Konstantin-Dudersky/plc-modules/PM-DI16-front-DC24/doc/PM-DI16-front-DC24_view_x90.png

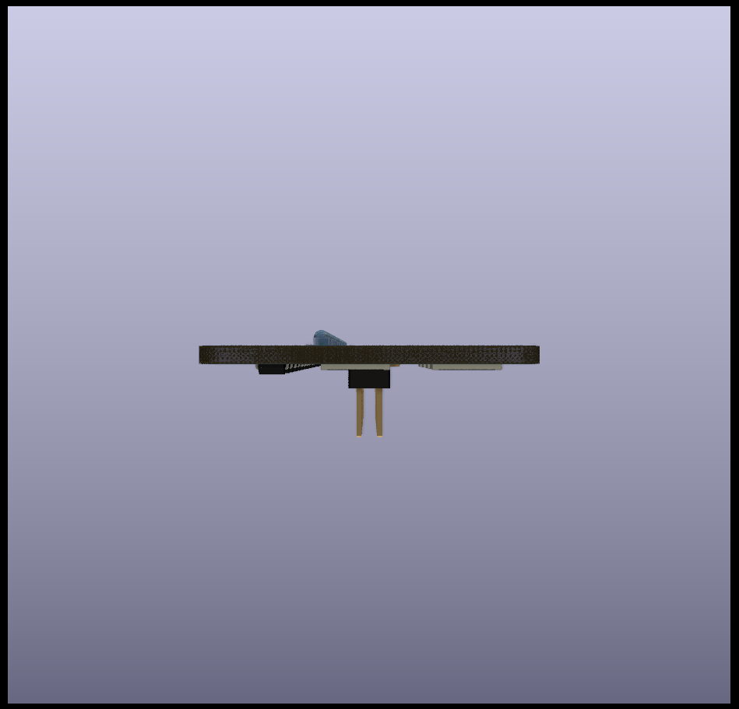
PM-DI16-front-DC24/doc/PM-DI16-front-DC24_view_x90.png
