Konstantin-Dudersky/plc-modules/pcb/PMCNV-AI8T-v0.1.0/doc/CN0209 - Fully Programmable Universal Analog Front End for Process Control Applications/CN0209-hw-1024.jpg

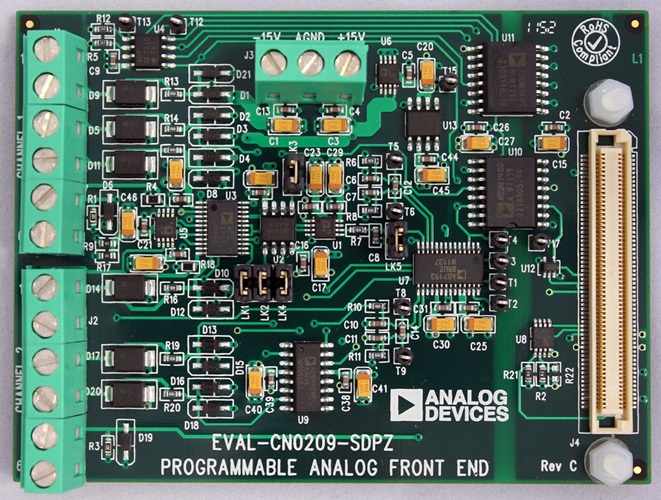
pcb/PMCNV-AI8T-v0.1.0/doc/CN0209 - Fully Programmable Universal Analog Front End for Process Control Applications/CN0209-hw-1024.jpg
