Konstantin-Dudersky/plc-modules/README.md

Схемы простейших модулей для подключения к контроллеру по шине I2C.

Схемы разработаны в KiCad.

Документация - см. [docs/plc-modules.pdf]
