Konstantin-Dudersky/plc-modules/docs/output/plc-modules.pdf

## Описание системы управления

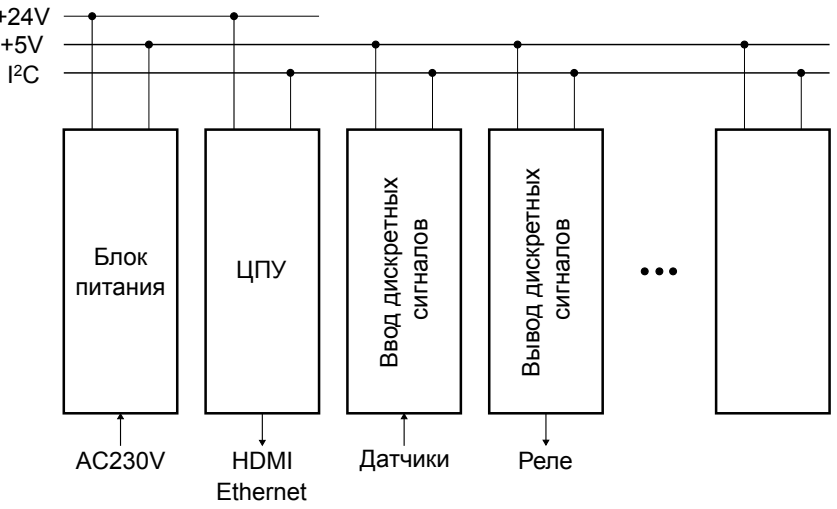
[picture p3: figure]
HDM; Реле; Бло а; ЦПУ; Ввод дискретных; сигналов; Вывод дискретных

Рис. 1. Концепция модульной системы Система управления состоит из набора совместимых по подключению и внешним га# баритам модулей.
Отдельные модули связаны между собой общей шиной. Шина выполнена в виде стандратного кабеля с двумя витыми парами, обжатого двумя разъемами RJ11. Модули необходимо располагать так, чтобы суммарная длина шины была минимальной. По шине передаётся питание (GND, +5V) и сигналы интерфейса I²C (SDA, SCL).
Каждый модуль на шине имеет свой адрес, который задается DIP#переключателями на каждом модуле. Возможно использование до 8 модулей одного типа.
На данный момент реализованы модули:
Можно дополнительно реализовать:
- Модули аналоговых входов:
- Тензодатчики
- Ток 4#20мА
- Напряжение 0#10В
- Термосопротивление
- Термопары
- Модули аналоговых выходов:
- Ток 4#20мА
- Напряжение 0#10В
- Модуль с аккумуляторными батареями
- Модуль управления RGB светодиодными лентами

## Функциональная схема модуля ввода / вывода

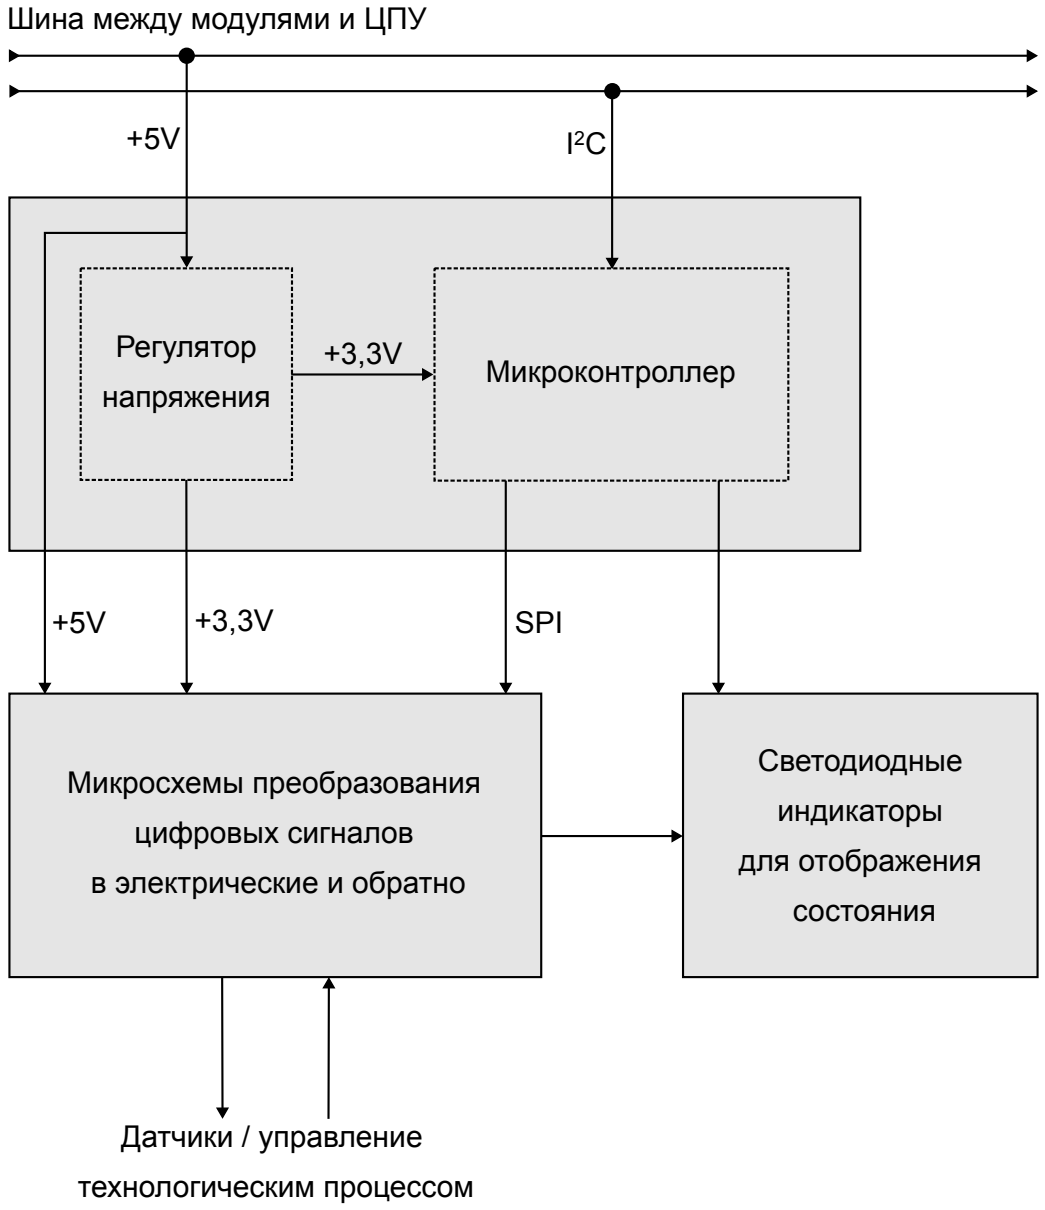
[picture p4: figure]
Микроконтроллер; Микросхемы преобразования; цифровых си налов; в электрические и обратно; Светодиодные; индикаторы; для отображения; состояния; Ре улятор; напряжения; Шина между модулями и ЦПУ; Датчики управление; техноло ическим процессом

Рис. 2. Функциональная cхема модуля ввода / вывода Модуль состоит из трех функциональных частей, выполненных на отдельных платах. Основная плата
Основная плата с микросхемами преобразования цифровых сигналов в электрические и обратно. Для разных модулей ввода / вывода данная плата отличается.
Плата с микроконтроллером

Вспомогательная плата с микроконтроллером и регулятором напряжения. Данная пла# та унифицирована для всех модулей. Микроконтроллер по интерфейсу I²C подключа# ется к ЦПУ и по интерфейсу SPI управляет вспомогательными микросхемами. Поскольку у каждого устройства на шине I²C должен быть уникальный адрес, на плате есть трехпозиционный DIP#переключатель для задания адреса конкретного модуля. Таким образом, можно использовать до 8 модулей одного типа.
В качестве микроконтроллера используется чип ESP32#C3. На чипе есть разъем для подключения внешней антенны, что дает возможность использовать беспроводное подключение.
Микроконтроллер программируется с помощью обычного кабеля Micro#USB. На плате выведены кнопки BOOT и EN, для перевода микроконтроллера в режим загрузки.
На плате есть LDO регулятор напряжения с выходом 3,3В.
Подключение к шине выполняется через разъемы RJ11 и кабель с двумя витыми пара# ми.
Подключение к основной плате модуля и плате светодиодов выполняется через 10#пи# новые кабели FFC.
Плата со светодиодами
Вспомогательная плата со светодиодами для отображения состояния микроконтролле# ра и электрических сигналов. В модуле может использоваться одна или две таких пла# ты. Есть версии на 8 и на 16 светодиодов.

## Описание модулей и вспомогательных плат

### PM_CNV-AI4_W - плата аналогового ввода сигналов тензодатчиков

Плата аналогового ввода для опроса сигналов тензодатчиков. Можно подключить до 4 тензодатчиков.
Опрос датчиков построен на базе АЦП AD7193 компании Analog Devices. Основные ха# рактеристики АЦП:
- Тип АЦП # 24#разрядный сигма#дельта (Σ # Δ).
- Встроенный усилитель с программируемым коэффициентом усиления 1 .. 128. Поз# воляет измерять напряжения в диапазоне 40 мВ .. 5 В.
- Низкий уровень шумов. До 22 разрядов при низкой частоте дискретизации.
- 4 дифференциальных канала измерения. Автоматический мультиплексор.
- Подключается к микроконтроллеру по интерфейсу SPI.

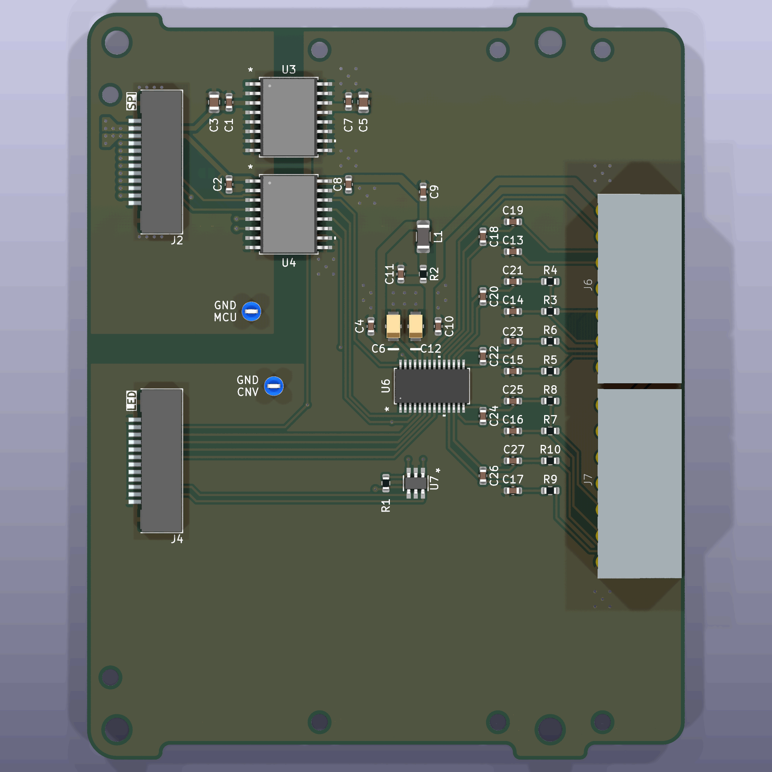
[picture p5: figure]

Рис. 3. Внешний вид платы PM_CNV#AI4_W

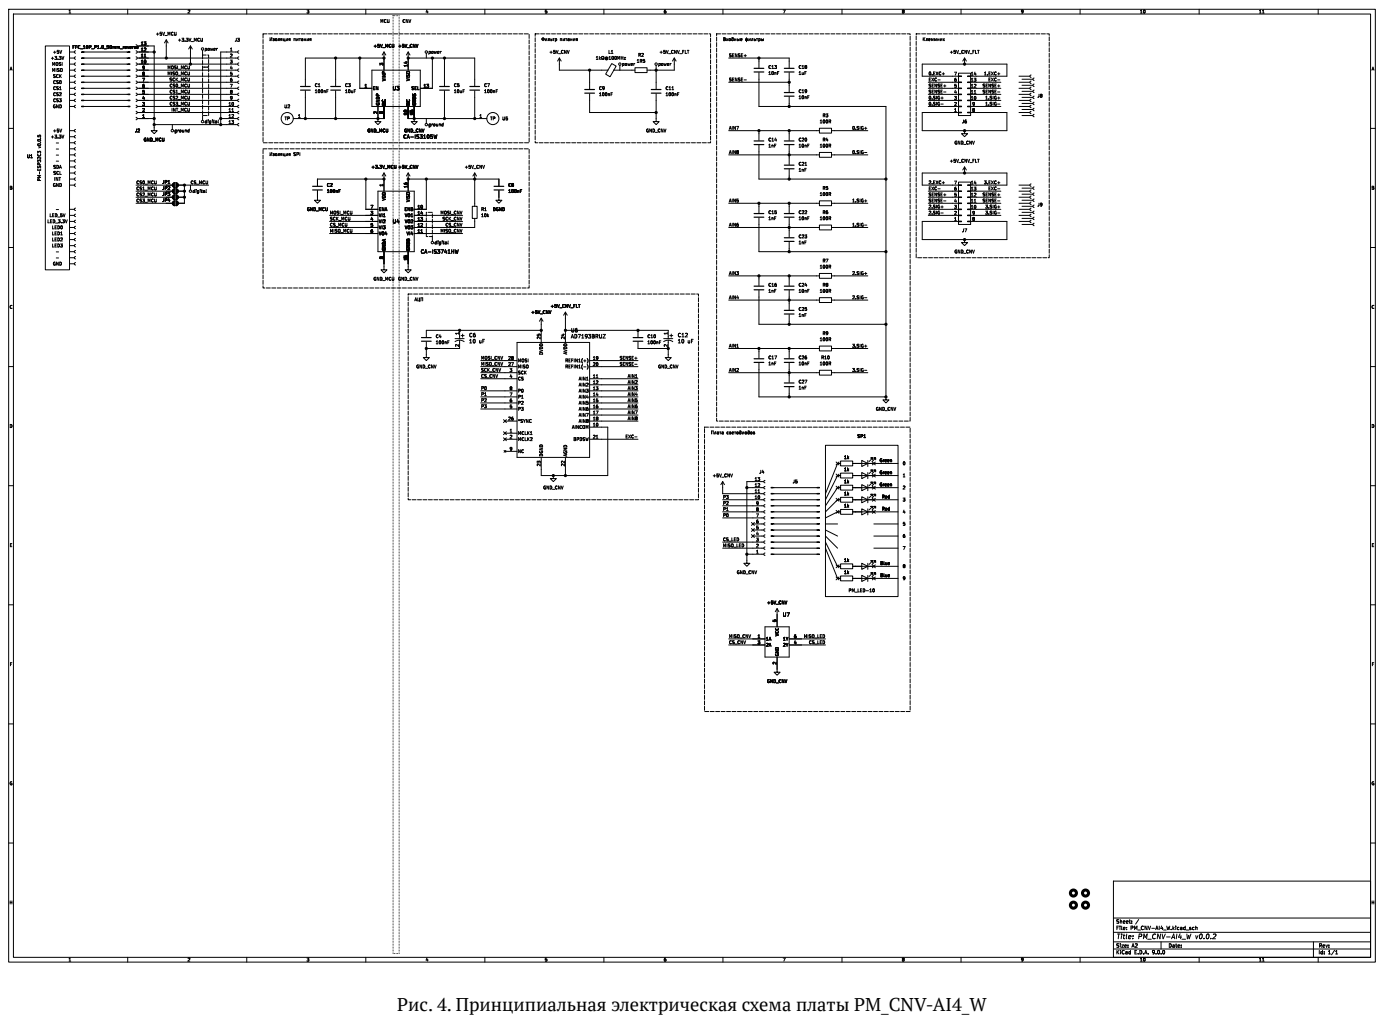
[picture p6: page 6]

GNDS 15 GNDS 16 GNDS 9 SEL 13 U3

GNDS 15 GNDS 16 GNDS 9 SEL 13

VISO 16 GNDB 15 GNDB 9 ENB 10

Рис. 4. Принципиальная электрическая схема платы PM_CNV#AI4_W

Обозначение | Количество | part_ipn | Комментарий | Опционально
reference | quantity | part_ipn | note | optional
C1,C2,C4,C7,C8,C9,C10,C11 | 8 | C_100nF_16V_0603_MLCC#X7R | Unpolarized capacitor
C3,C5 | 2 | C_10uF_16V_0805_MLCC#X7R | Unpolarized capacitor
C6,C12 | 2 | TAJA106M016RNJ | 10uF 16V 3Ω@100kHz ±20% CASE#A#3216#18(mm) Tantalum Capacitors
C13,C19,C20,C22,C24,C26 | 6 | C_10nF_16V_0603_MLCC#X7R | Unpolarized capacitor
C14,C15,C16,C17,C21,C23,C25,C27 | 8 | C_1nF_16V_0603_MLCC#X7R | Unpolarized capacitor
C18 | 1 | C_1uF_16V_0603_MLCC#X7R | Unpolarized capacitor
D1,D2,D3 | 3 | XL#1606SYGC | Green
D4,D5 | 2 | XL#1606SURC | Red
D6,D7 | 2 | XL#1606UBC | Blue
J1 | 1 | FFC_10P_P1.0_50mm_reverse
J2,J3,J4 | 3 | AFA07#S12FCC#00 | Generic connector, single row, 01x10, script generated
J5 | 1 | FFC_12P_P1.0_100mm_straight | FFC 12pin 100mm
J6,J7 | 2 | 15EDGRHC#THR#3.5#14P | Generic connector, double row, 02x05, odd/even pin numbering scheme (row 1 odd numbers, row 2 even numbers), script generated (kicad#library#utils/schlib/autogen/connector/)
J8,J9 | 2 | 15EDGKNH#3.5#14P | Generic connector, single row, 01x05, script generated
L1 | 1 | FB_300mΩ_1kΩ@100MHz_1206 | Ferrite bead
R1 | 1 | R_10k_0603_1% | Resistor
R2 | 1 | R_1R5_0603_1% | Resistor
R3,R4,R5,R6,R7,R8,R9,R10 | 8 | R_100R_0603_1% | Resistor
R11,R12,R13,R14,R15,R16,R17 | 7 | R_1k_0603_1% | Resistor
SP1 | 1 | PM_LED#10#v0.0.1
U2,U5 | 2 | Keystone_5117 | KEYSTONE # 5117 # TEST POINT, PCB, BLUE, THROUGH HOLE
U3 | 1 | CA#IS3105W
U4 | 1 | CA#IS3741HW
U6 | 1 | AD7193BRUZ
U7 | 1 | SN74LVC2G14DBVR
Таблица 1. Перечень элементов платы PM_CNV#AI4_W
