Konstantin-Dudersky/plc-modules/pcb/PMCNV-AI8T-v0.1.0/README.md

Создать файл с габаритными разделами:

- Файл -> Чертить
- Формат чертения - SVG
- Включить слои: User 2
- Чертить на всех слоях: Edge.Cuts

После открыть файл в Inkscape и изменить размер страницы
