Konstantin-Dudersky/plc-modules/docs/pcb/PMCNV-AI8T/render_x0y180z0.png

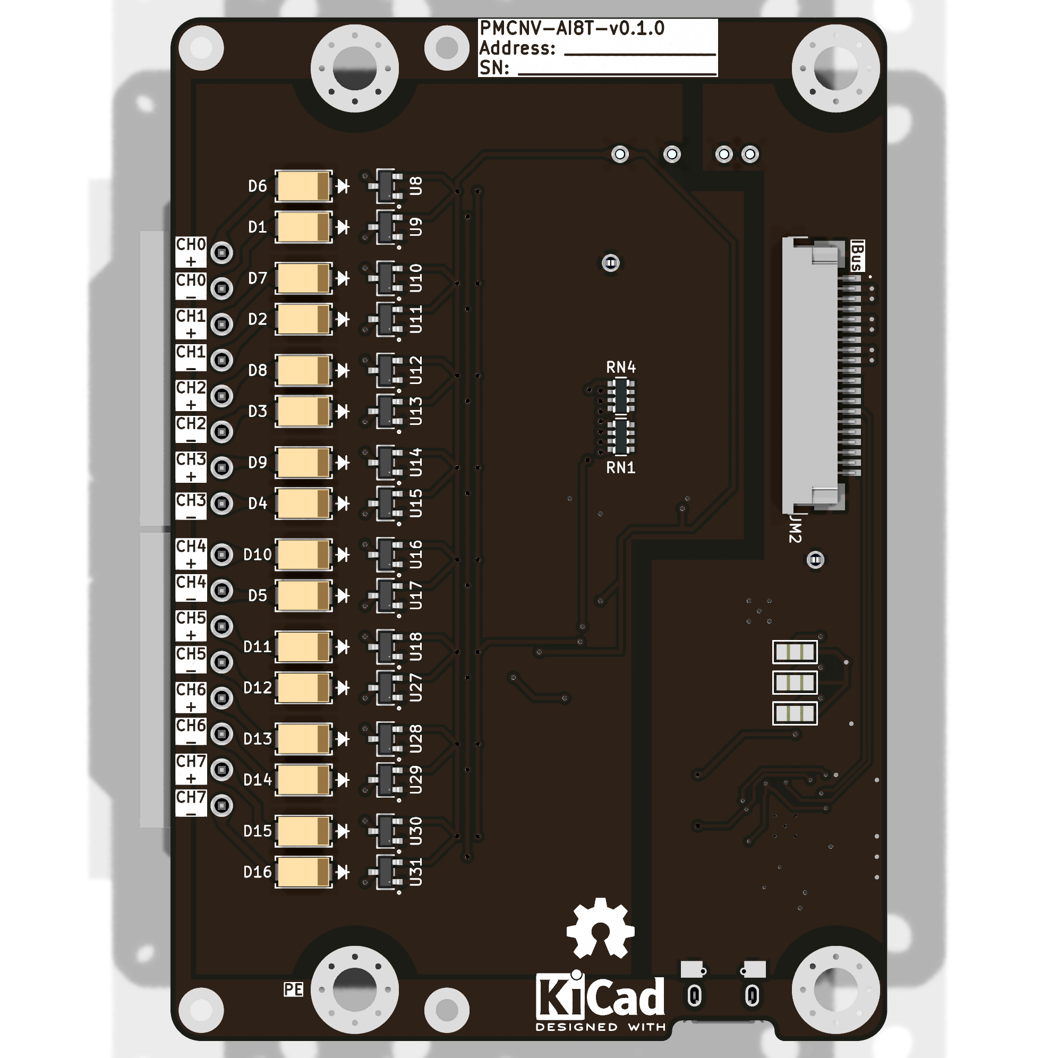
docs/pcb/PMCNV-AI8T/render_x0y180z0.png
