Konstantin-Dudersky/plc-modules/docs/pcb/PMCPU-ESP32C3/render_x0y180z0.png

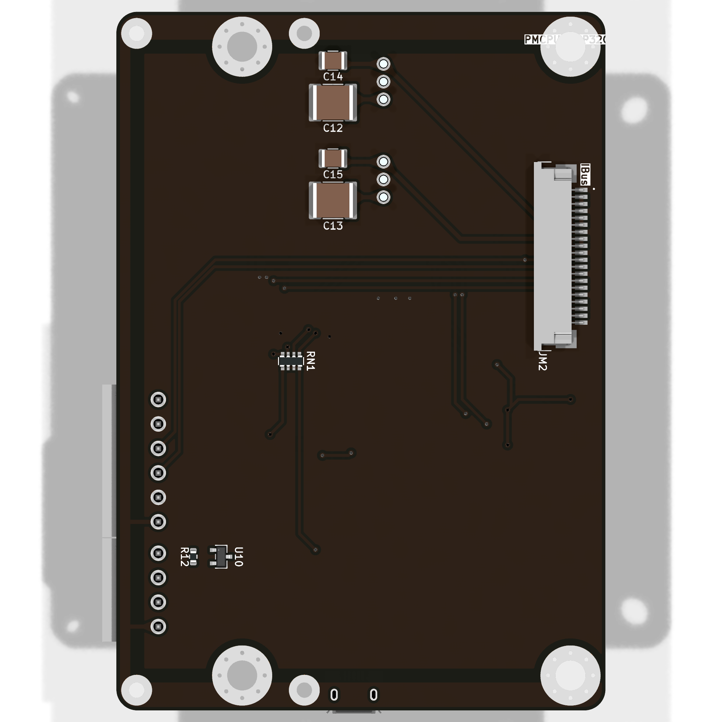
docs/pcb/PMCPU-ESP32C3/render_x0y180z0.png
