Konstantin-Dudersky/plc-modules/pcb/doc/images/AD7193.png

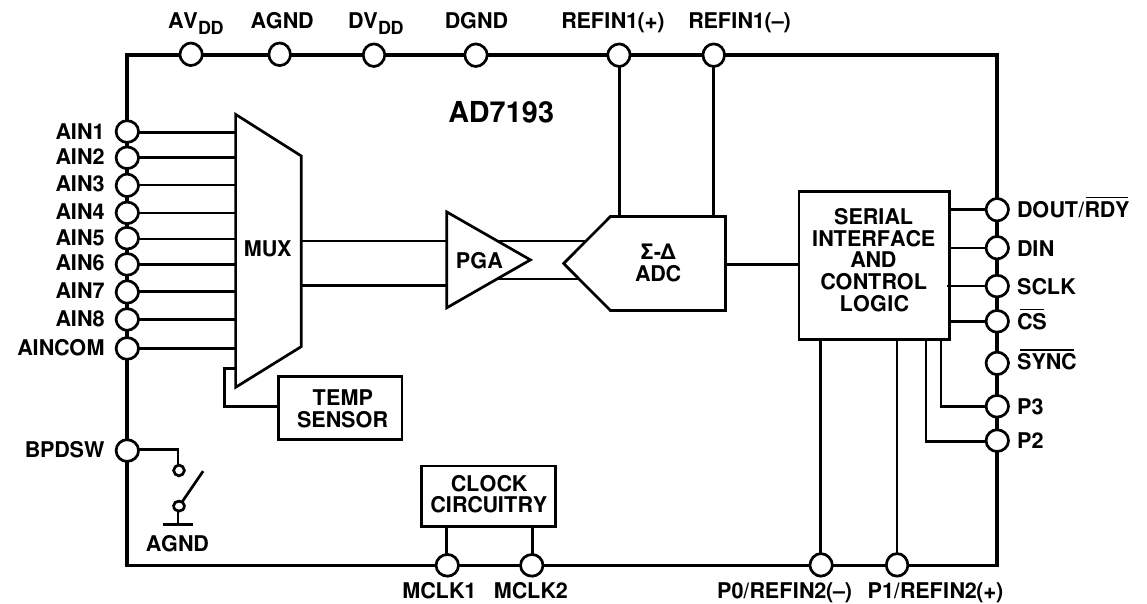
pcb/doc/images/AD7193.png
