Konstantin-Dudersky/plc-modules/pcb/doc/images/CA-IS3098W.png

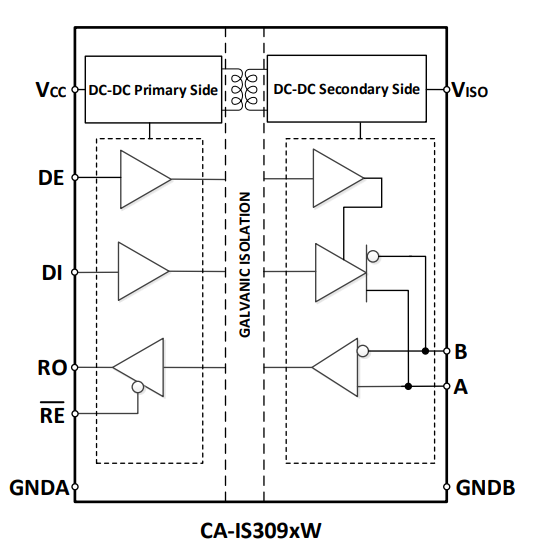
pcb/doc/images/CA-IS3098W.png
