Konstantin-Dudersky/plc-modules/pcb/doc/images/CA-IS3980P.png

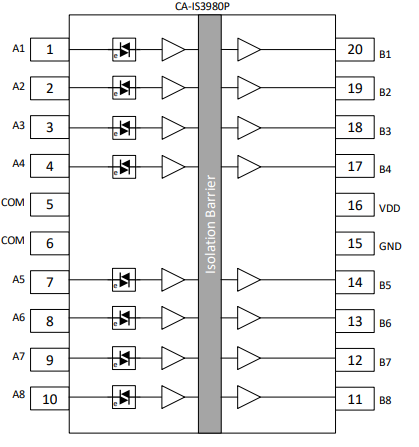
pcb/doc/images/CA-IS3980P.png
