Konstantin-Dudersky/plc-modules/pcb/doc/images/CA-IS3980P_channel.png

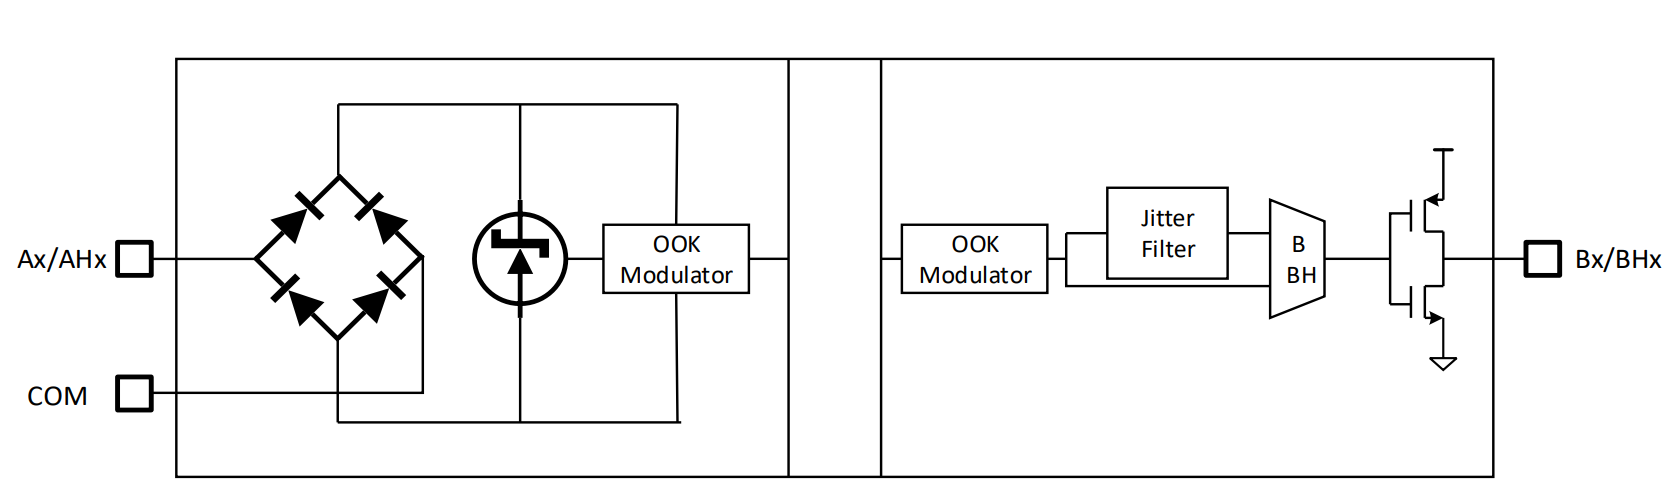
pcb/doc/images/CA-IS3980P_channel.png
