Konstantin-Dudersky/plc-modules/pcb/doc/images/CA-IS3980P_channel_circuit.png

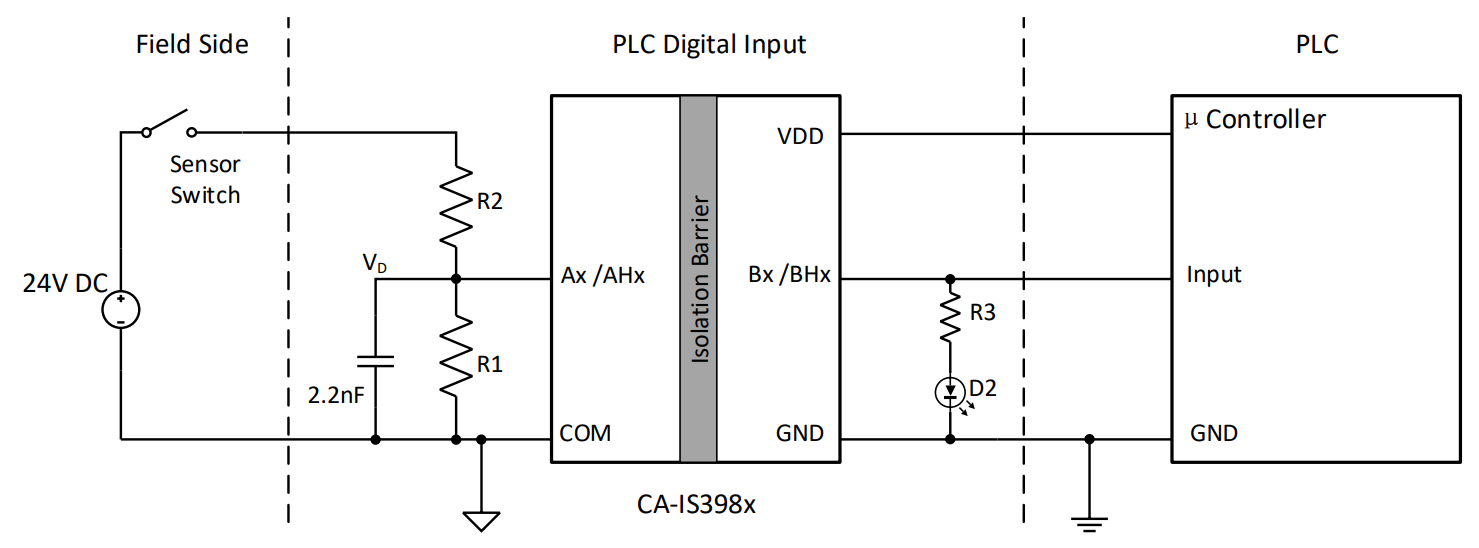
pcb/doc/images/CA-IS3980P_channel_circuit.png
