Konstantin-Dudersky/plc-modules/pcb/doc/images/cold_junction.png

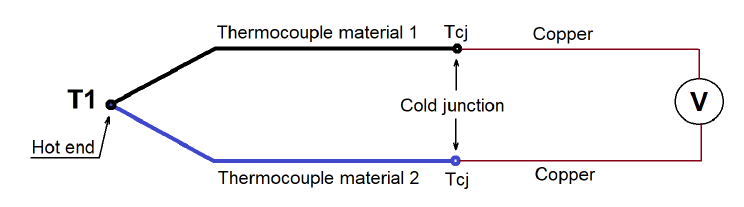
pcb/doc/images/cold_junction.png
