Konstantin-Dudersky/plc-modules/pcb/doc/images/MCP23S17.png

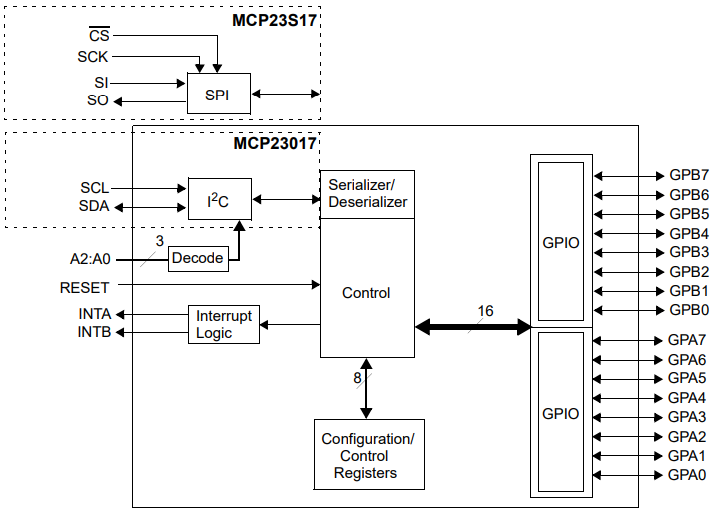
pcb/doc/images/MCP23S17.png
