Konstantin-Dudersky/plc-modules/pcb/doc/images/PMCNV-AI4T_bias_generator.png

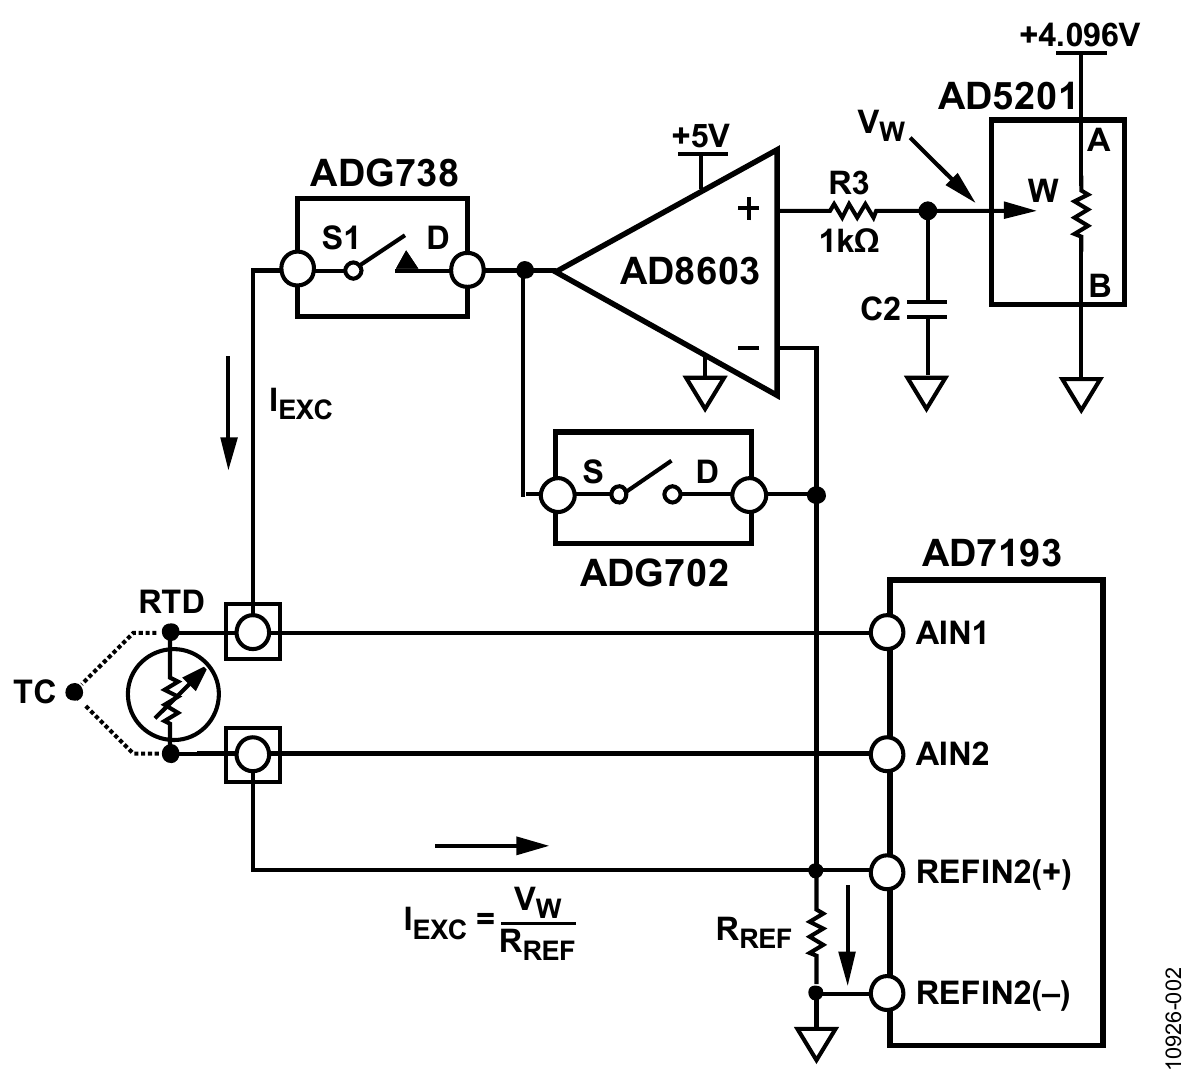
pcb/doc/images/PMCNV-AI4T_bias_generator.png
