Konstantin-Dudersky/plc-modules/pcb/doc/images/PMCNV-AI4T_protection_circuit.png

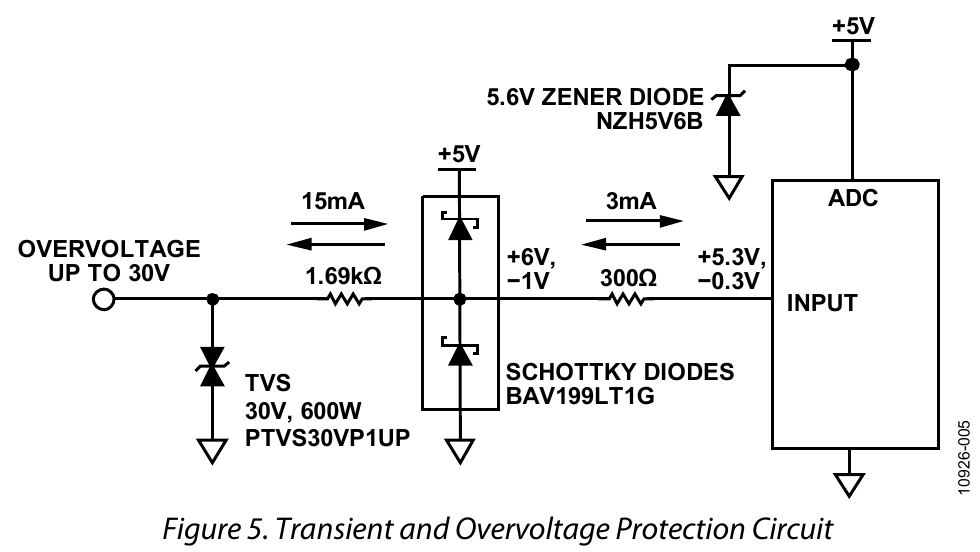
pcb/doc/images/PMCNV-AI4T_protection_circuit.png
