Konstantin-Dudersky/plc-modules/pcb/doc/images/rpi_uart_rts_long.png

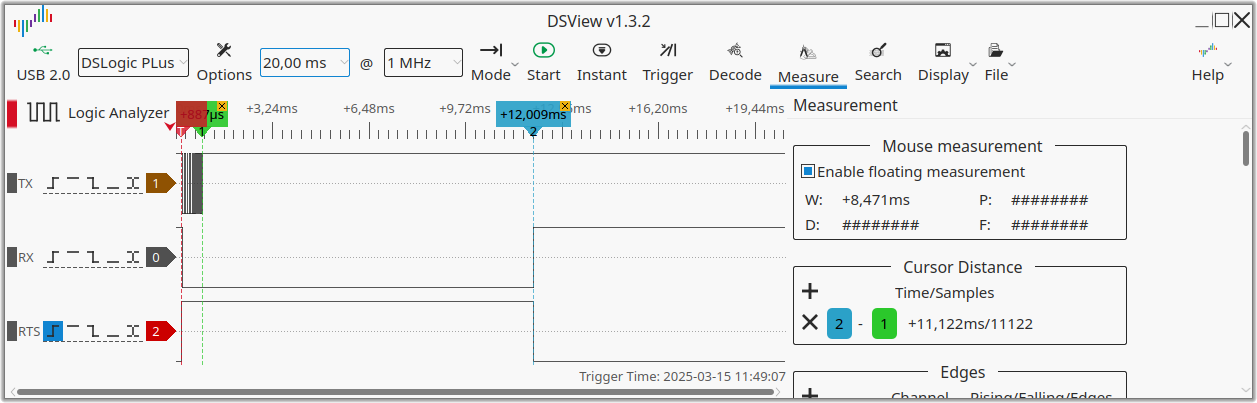
pcb/doc/images/rpi_uart_rts_long.png
