Konstantin-Dudersky/plc-modules/pcb/doc/images/rpi_uart_rts_short.png

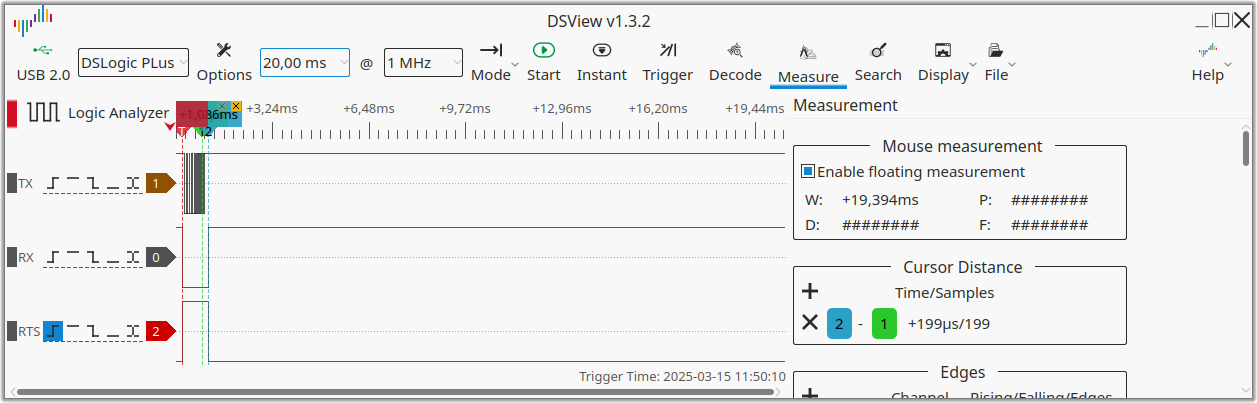
pcb/doc/images/rpi_uart_rts_short.png
