Konstantin-Dudersky/plc-modules/pcb/doc/images/speed_115200.png

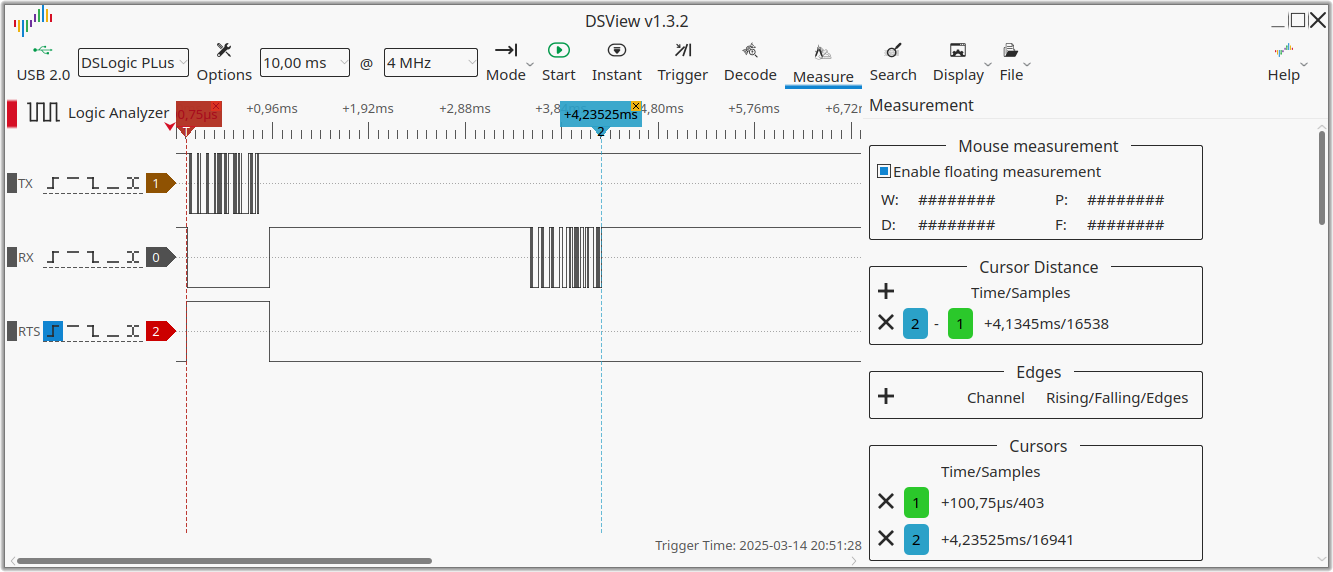
pcb/doc/images/speed_115200.png
