Konstantin-Dudersky/plc-modules/pcb/doc/images/speed_1200000.png

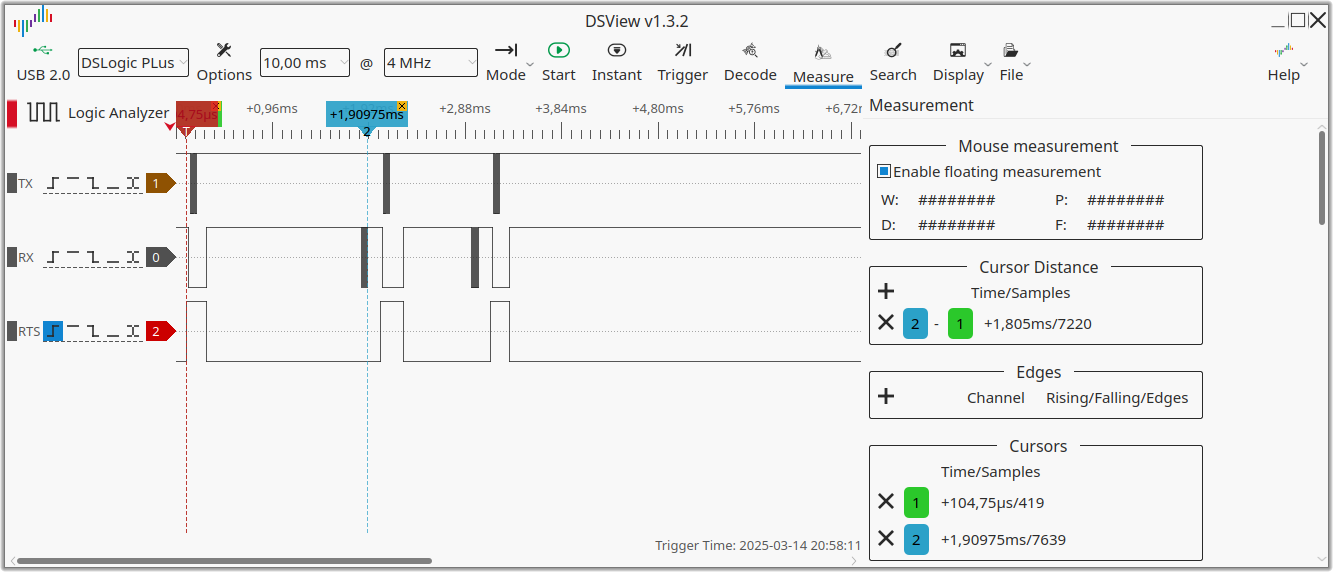
pcb/doc/images/speed_1200000.png
