Konstantin-Dudersky/plc-modules/pcb/doc/images/TBD62783AFG.png

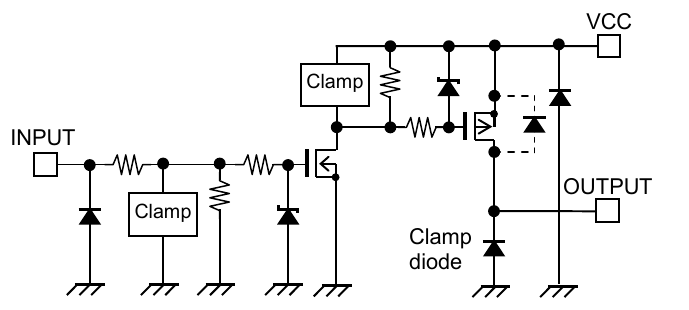
pcb/doc/images/TBD62783AFG.png
