Konstantin-Dudersky/plc-modules/pcb/doc/pcb/PM_CPU-RP/render_x0y180z0.png

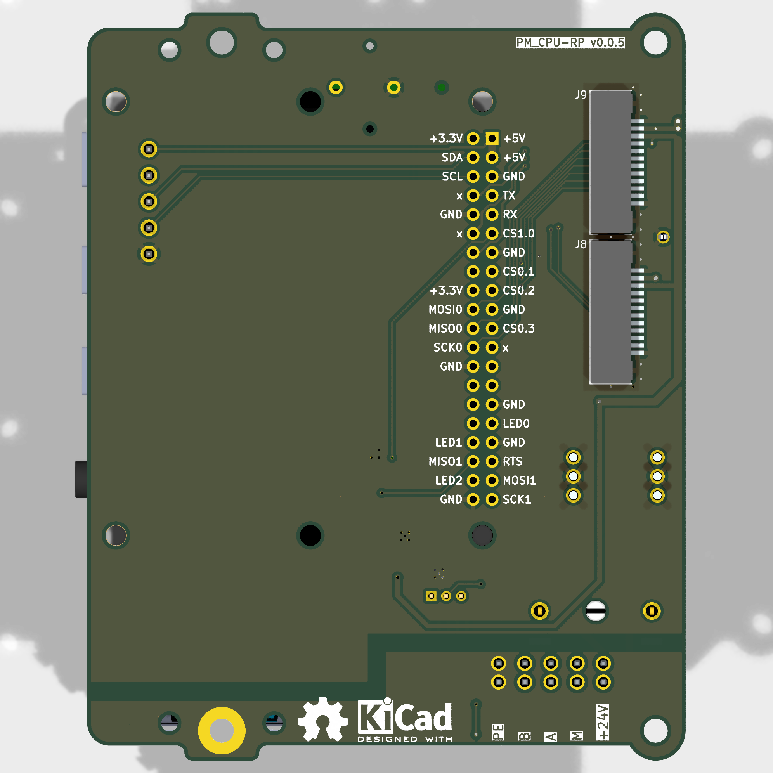
pcb/doc/pcb/PM_CPU-RP/render_x0y180z0.png
