Konstantin-Dudersky/plc-modules/pcb/doc/pcb/PM_HMI-Keyboard/render_x0y0z0.png

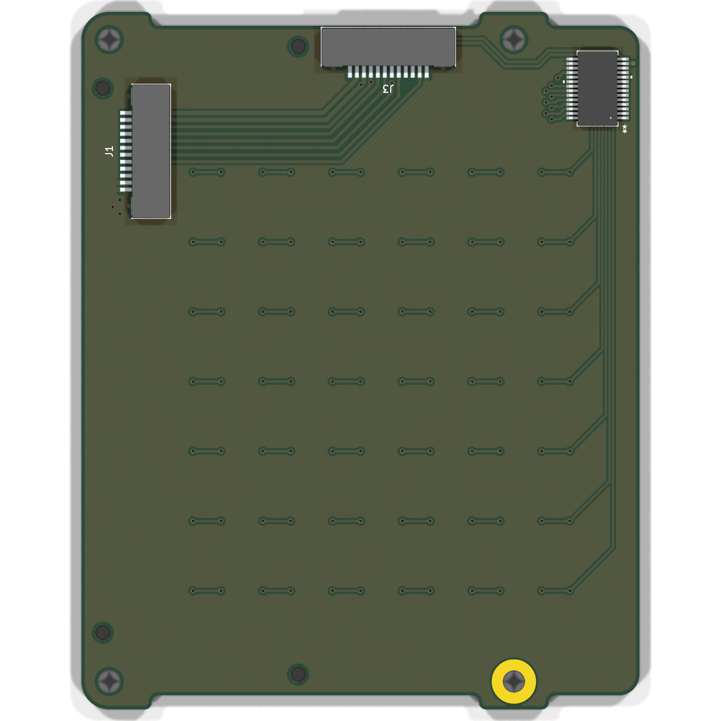
pcb/doc/pcb/PM_HMI-Keyboard/render_x0y0z0.png
