Konstantin-Dudersky/plc-modules/pcb/doc/pcb/PM_HMI-Touch/render_x0y0z0.png

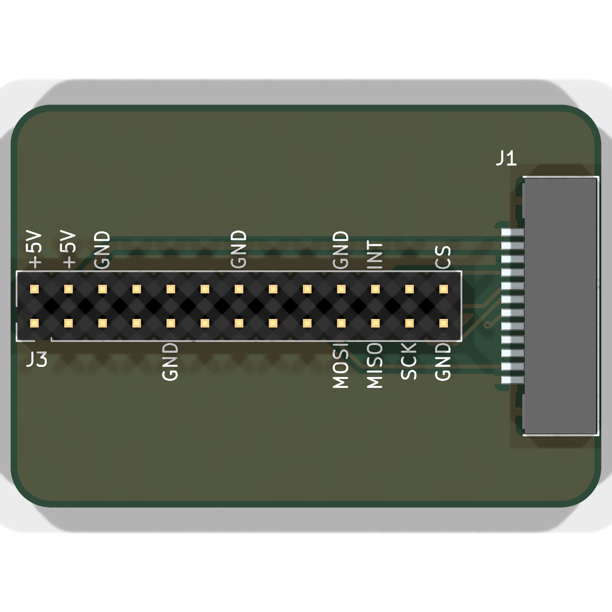
pcb/doc/pcb/PM_HMI-Touch/render_x0y0z0.png
