Konstantin-Dudersky/plc-modules/pcb/doc/pcb/PMCNV-AI4W/render_x0y0z0.png

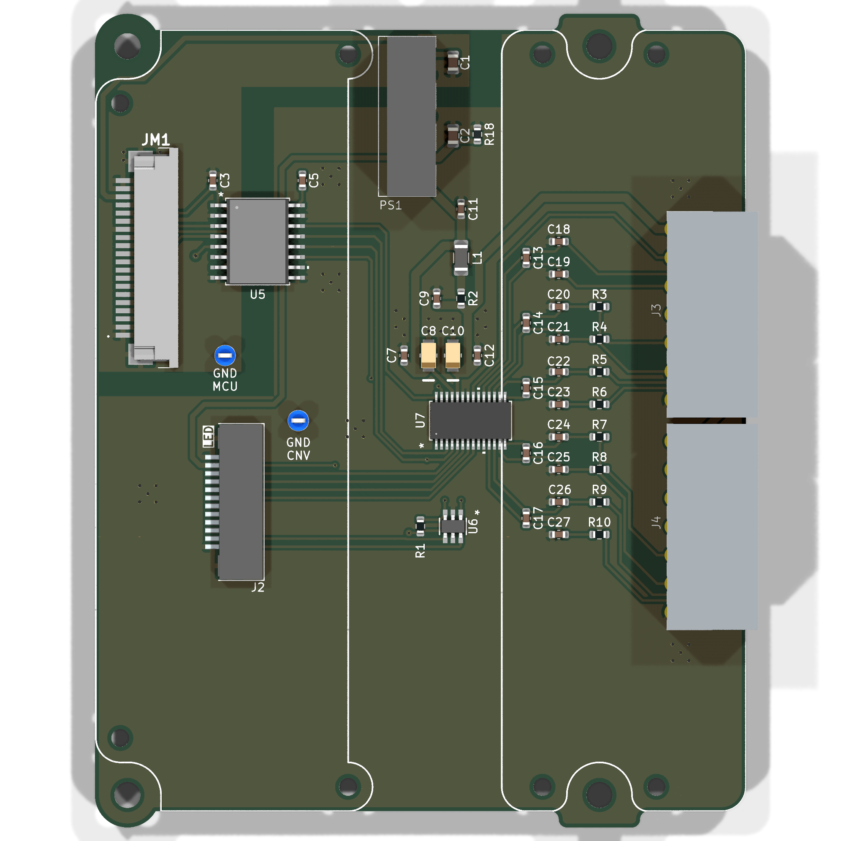
pcb/doc/pcb/PMCNV-AI4W/render_x0y0z0.png
