Konstantin-Dudersky/plc-modules/pcb/doc/pcb/PMCNV-AI4W/render_x0y180z0.png

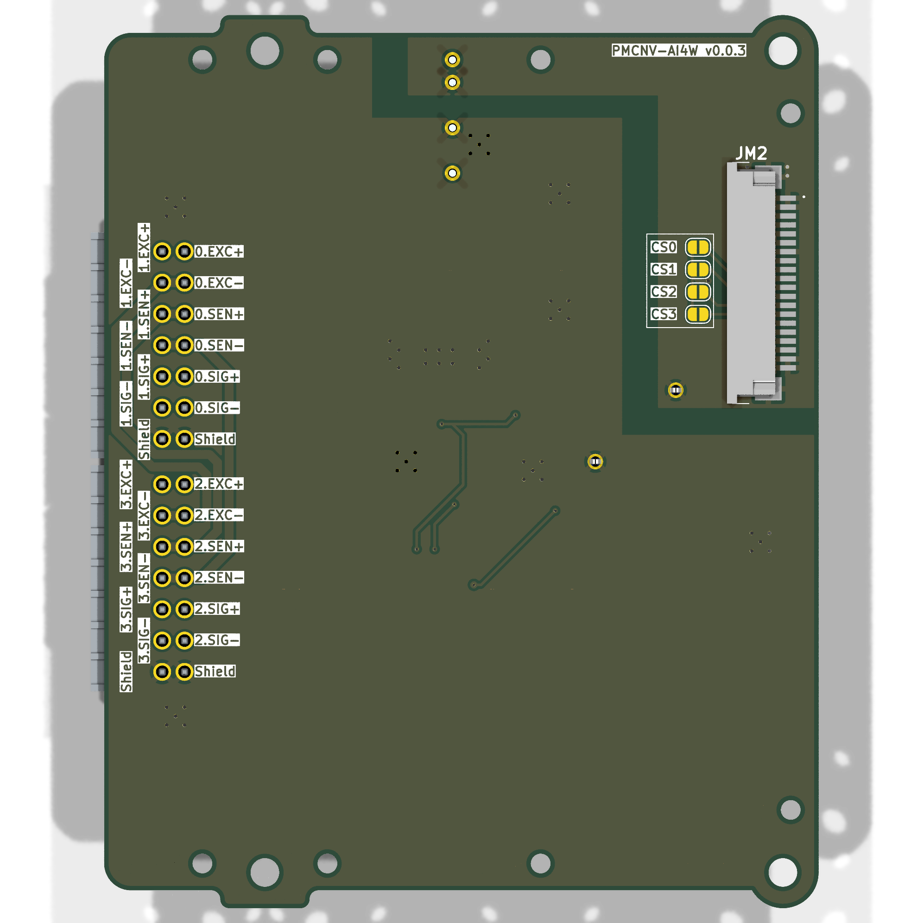
pcb/doc/pcb/PMCNV-AI4W/render_x0y180z0.png
