Konstantin-Dudersky/plc-modules/pcb/doc/pcb/PMCNV-AI8IU/render_x0y0z0.png

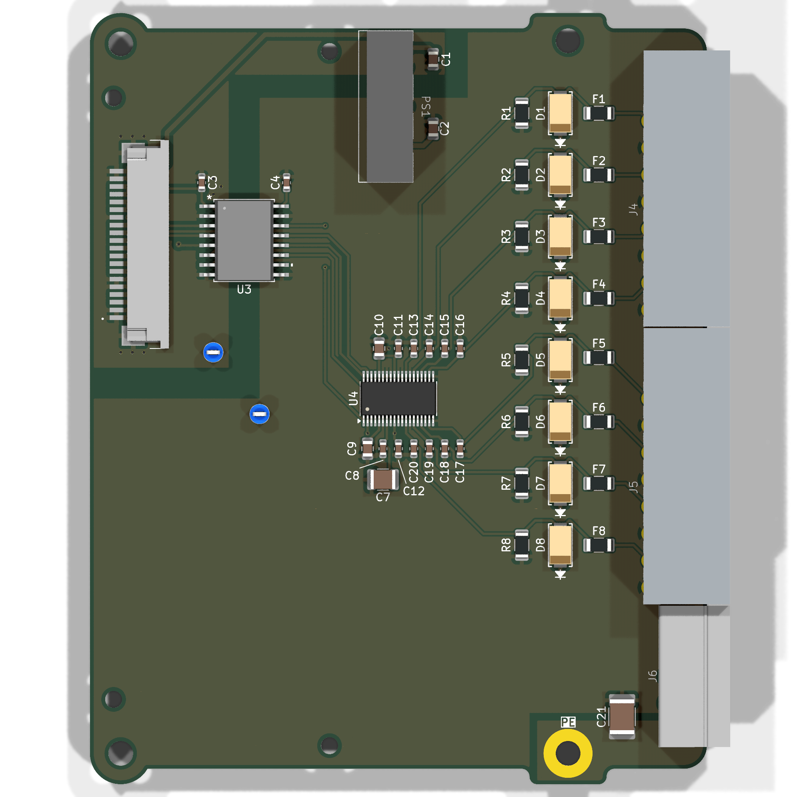
pcb/doc/pcb/PMCNV-AI8IU/render_x0y0z0.png
