Konstantin-Dudersky/plc-modules/pcb/doc/pcb/PMCNV-AI8IU/render_x0y180z0.png

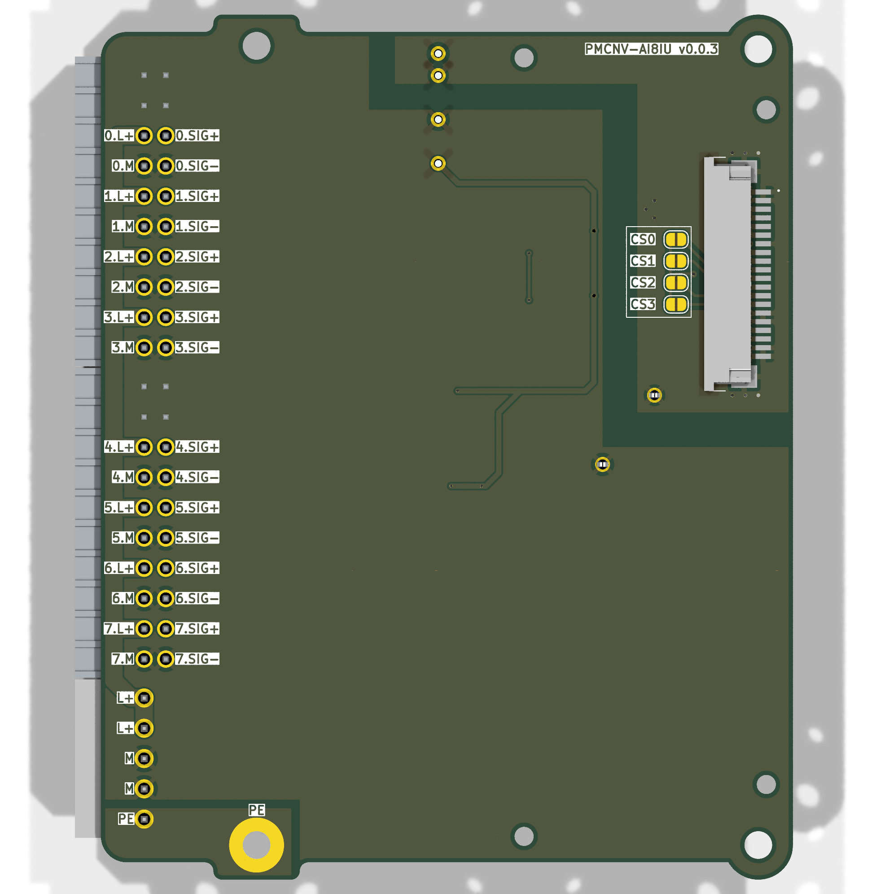
pcb/doc/pcb/PMCNV-AI8IU/render_x0y180z0.png
