Konstantin-Dudersky/plc-modules/pcb/doc/pcb/PMCNV-AIWx4/render_x0y180z0.png

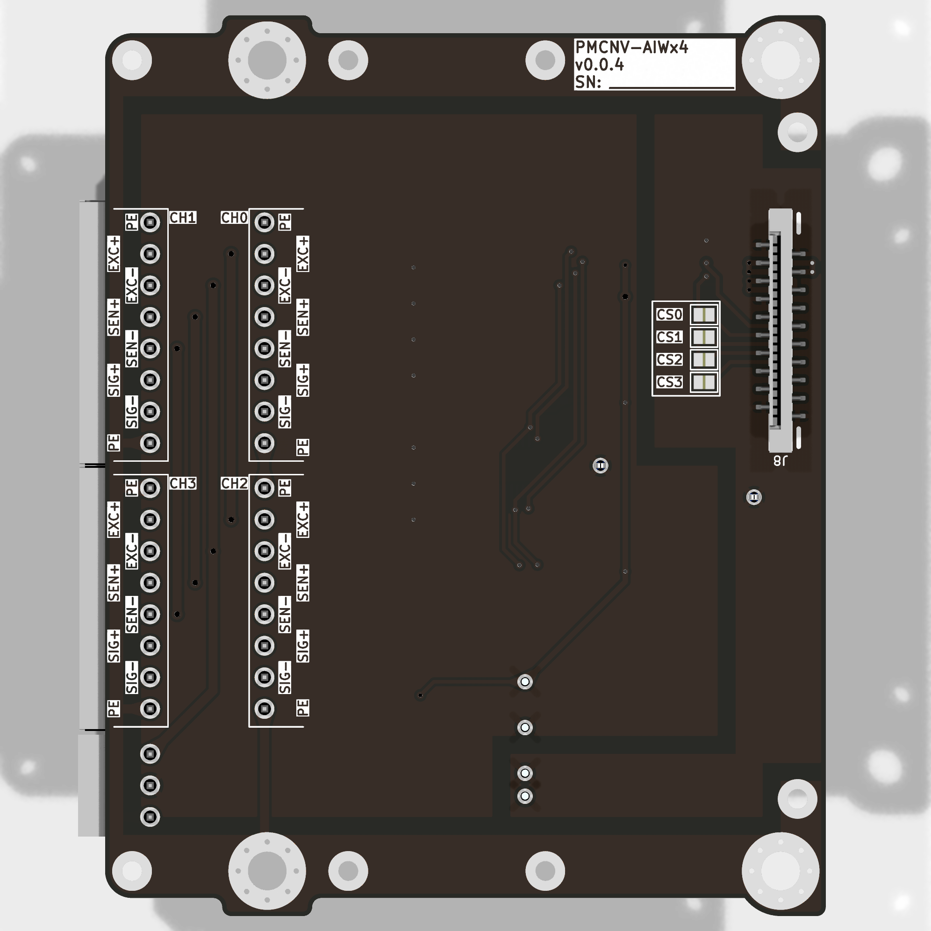
pcb/doc/pcb/PMCNV-AIWx4/render_x0y180z0.png
