Konstantin-Dudersky/plc-modules/pcb/doc/pcb/PMCNV-Count6/render_x0y0z0.png

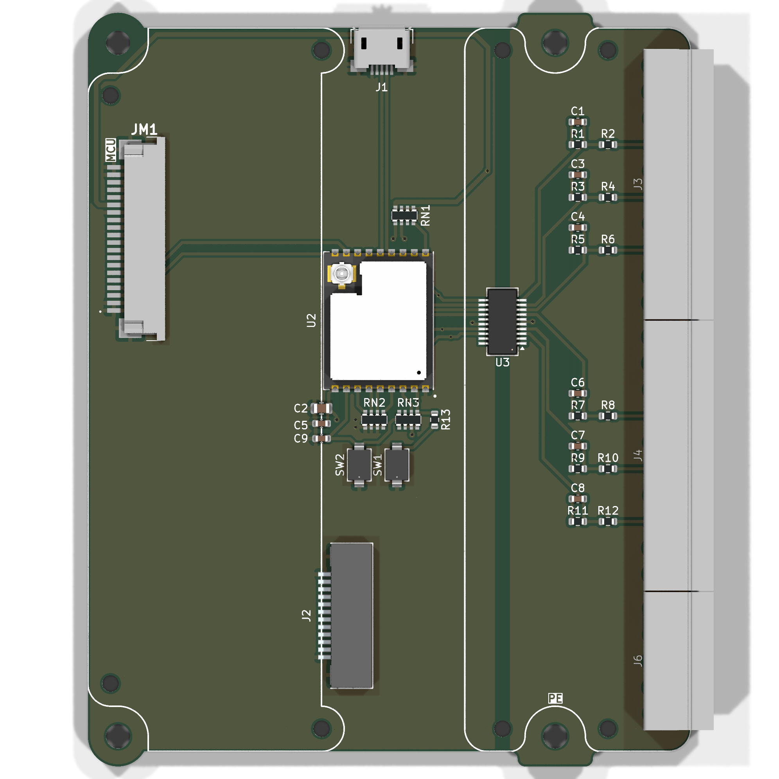
pcb/doc/pcb/PMCNV-Count6/render_x0y0z0.png
