Konstantin-Dudersky/plc-modules/pcb/doc/pcb/PMCNV-PWMx16/render_x0y0z0.png

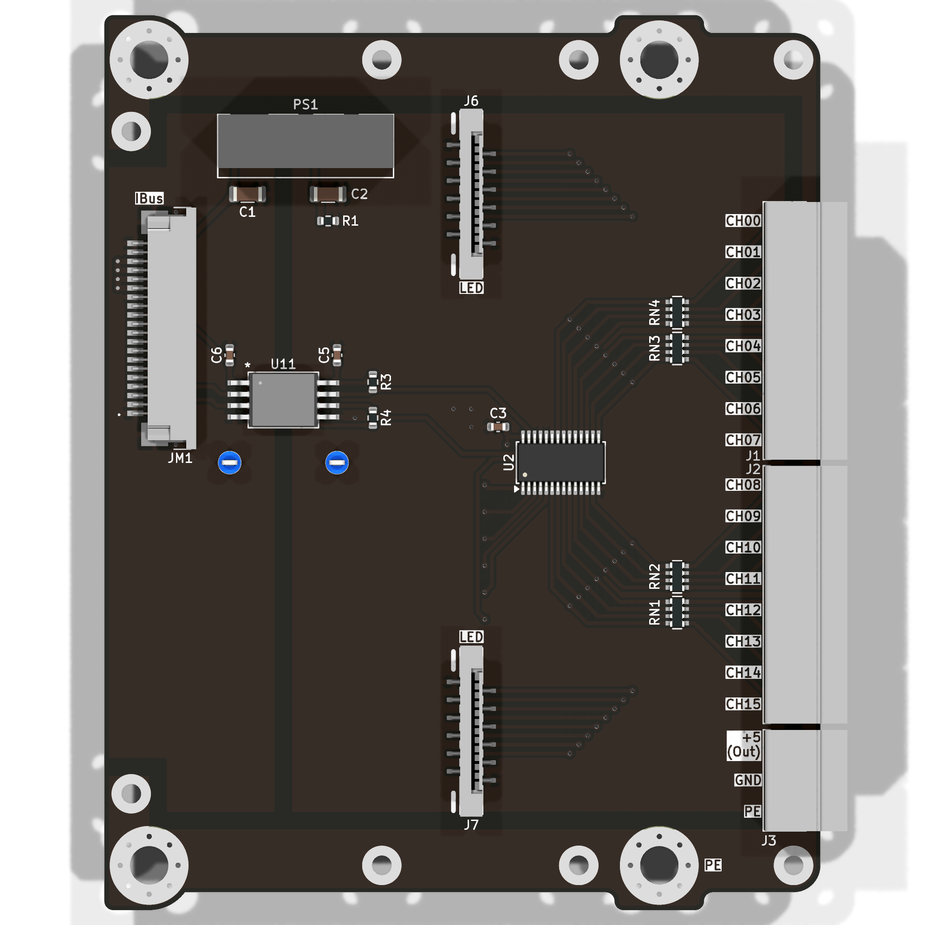
pcb/doc/pcb/PMCNV-PWMx16/render_x0y0z0.png
