Konstantin-Dudersky/plc-modules/pcb/doc/pcb/PMCPU-LLU/render_x0y180z0.png

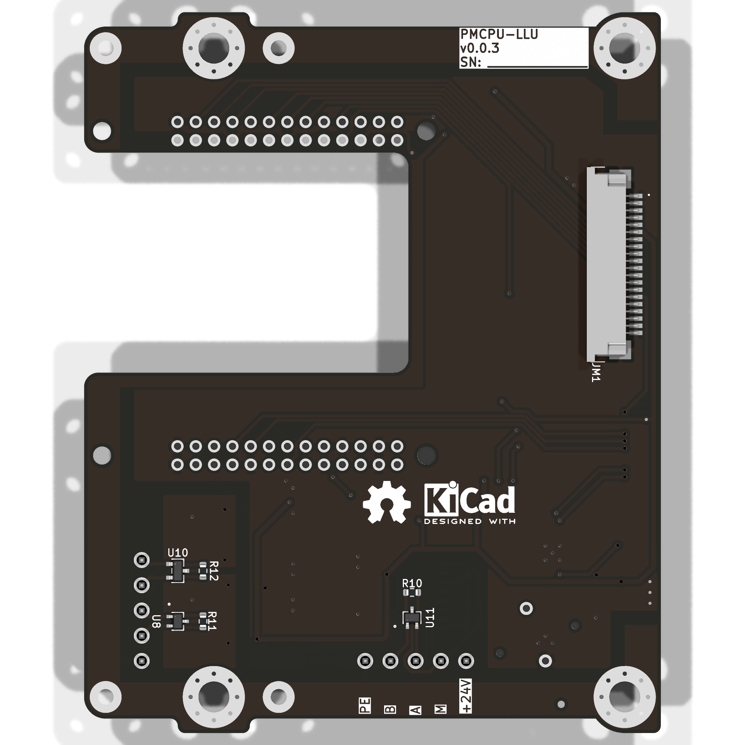
pcb/doc/pcb/PMCPU-LLU/render_x0y180z0.png
