Konstantin-Dudersky/plc-modules/pcb/doc/pcb/PMDBG-FFC20/render_x0y180z0.png

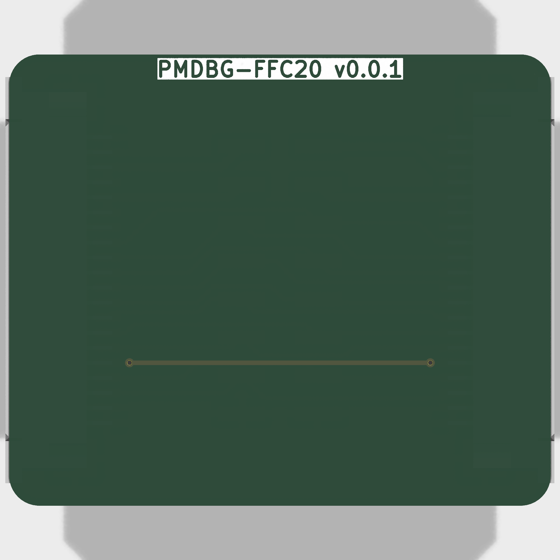
pcb/doc/pcb/PMDBG-FFC20/render_x0y180z0.png
