Konstantin-Dudersky/plc-modules/pcb/doc/pcb/PMHMI-Bx12Lx8/render_x0y0z0.png

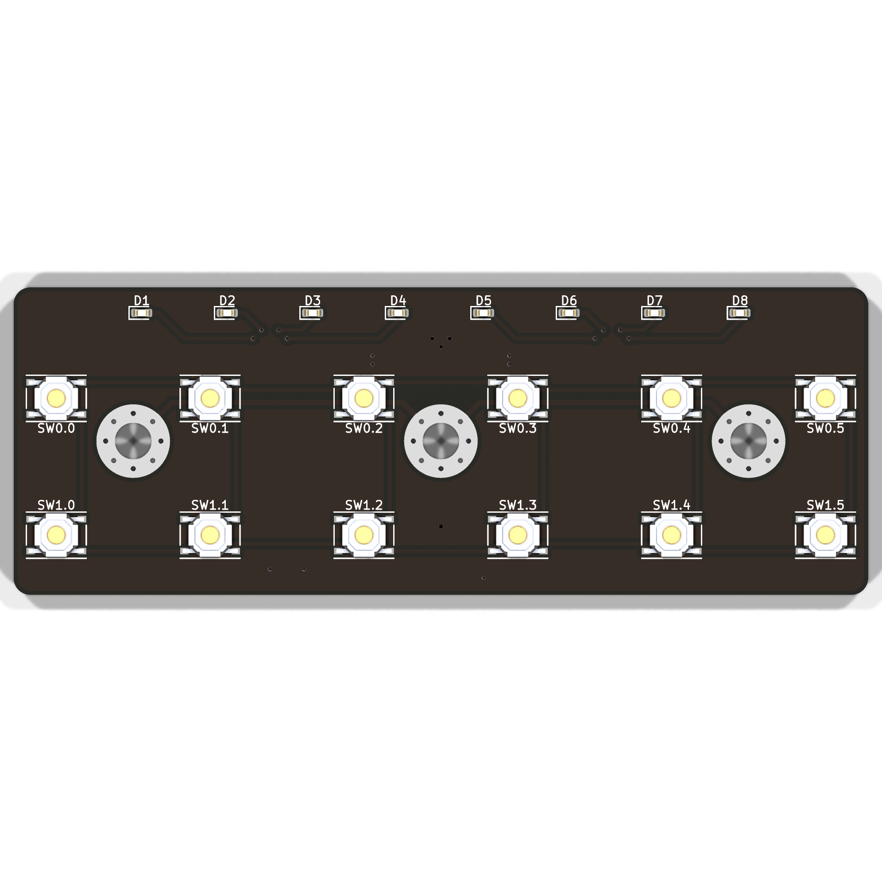
pcb/doc/pcb/PMHMI-Bx12Lx8/render_x0y0z0.png
