Konstantin-Dudersky/plc-modules/pcb/doc/pcb/PMIFC-1Wire/render_x0y0z0.png

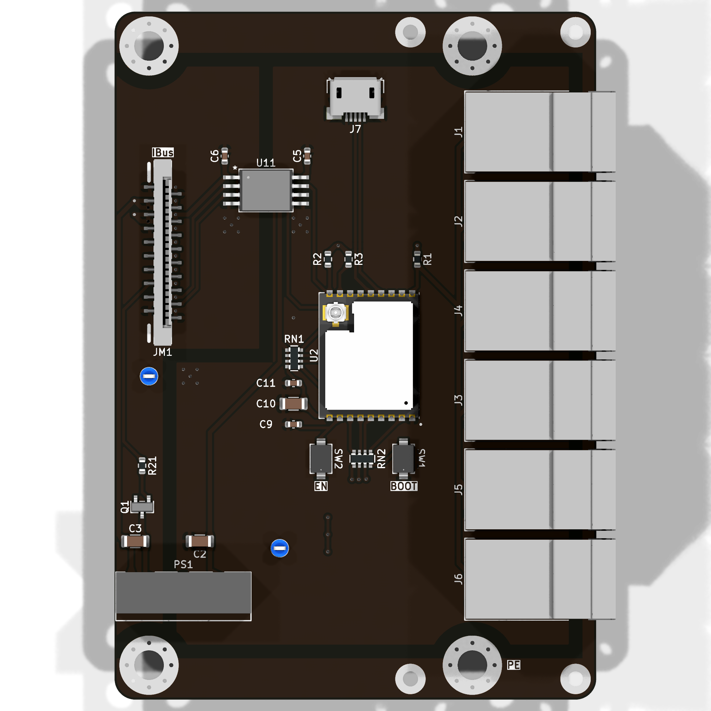
pcb/doc/pcb/PMIFC-1Wire/render_x0y0z0.png
