Konstantin-Dudersky/plc-modules/pcb/doc/pcb/PMIFC-1Wx12/render_x0y180z0.png

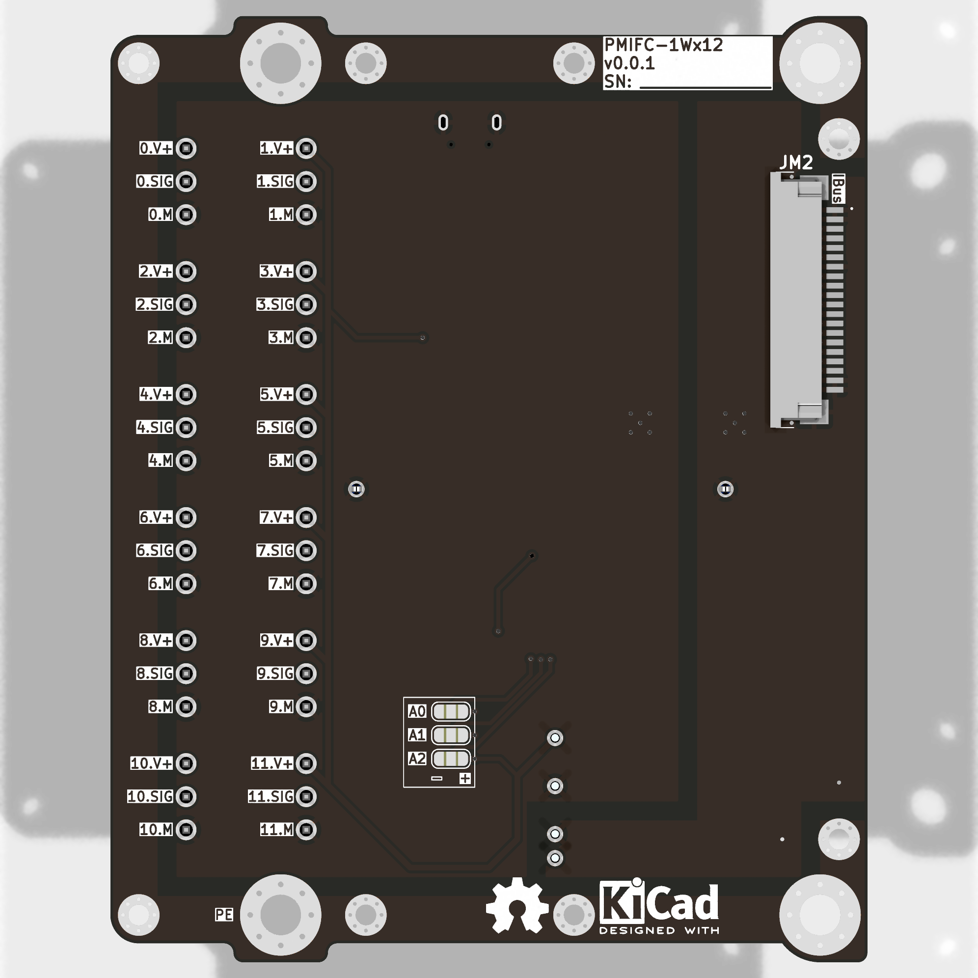
pcb/doc/pcb/PMIFC-1Wx12/render_x0y180z0.png
