Konstantin-Dudersky/plc-modules/pcb/doc/pcb/PMIFC-I2Cx8/render_x0y0z0.png

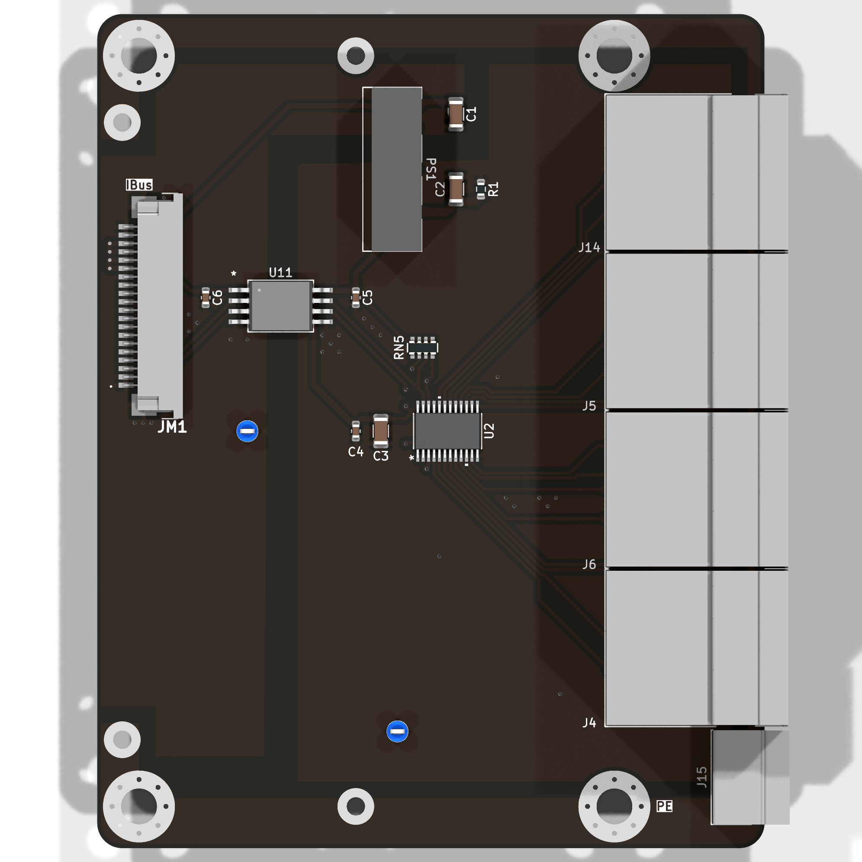
pcb/doc/pcb/PMIFC-I2Cx8/render_x0y0z0.png
