Konstantin-Dudersky/plc-modules/pcb/doc/pcb/PMLED-18/render_x0y180z0.png

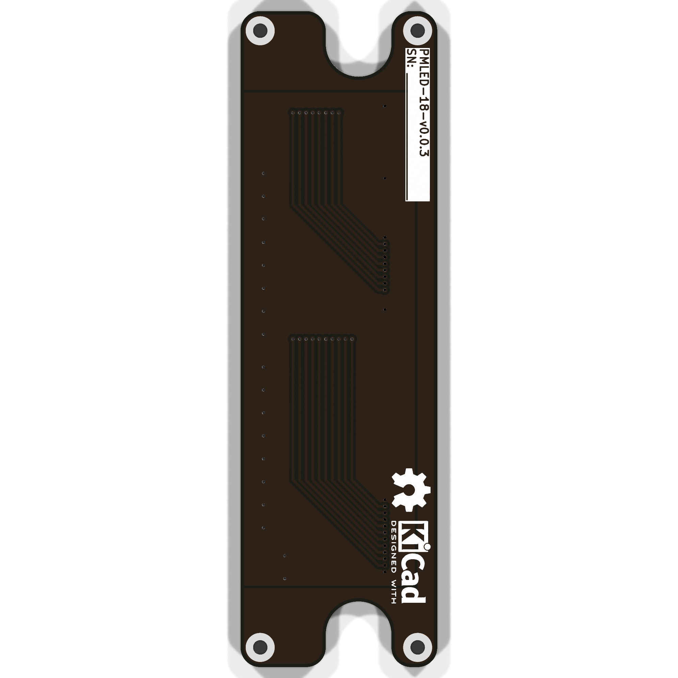
pcb/doc/pcb/PMLED-18/render_x0y180z0.png
