Konstantin-Dudersky/plc-modules/pcb/doc/pcb/PMMCU-ESP32C3/render_x0y0z0.png

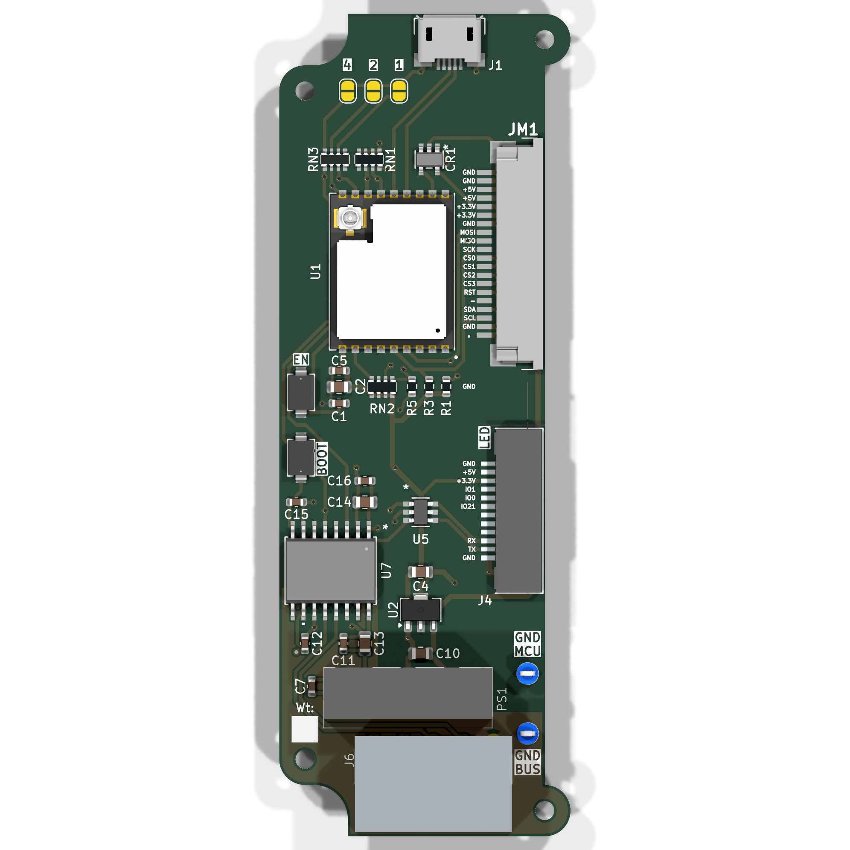
pcb/doc/pcb/PMMCU-ESP32C3/render_x0y0z0.png
