Konstantin-Dudersky/plc-modules/pcb/PMCNV-AI8T-v0.1.0/export/v0.1.0/render_x0y180z0.png

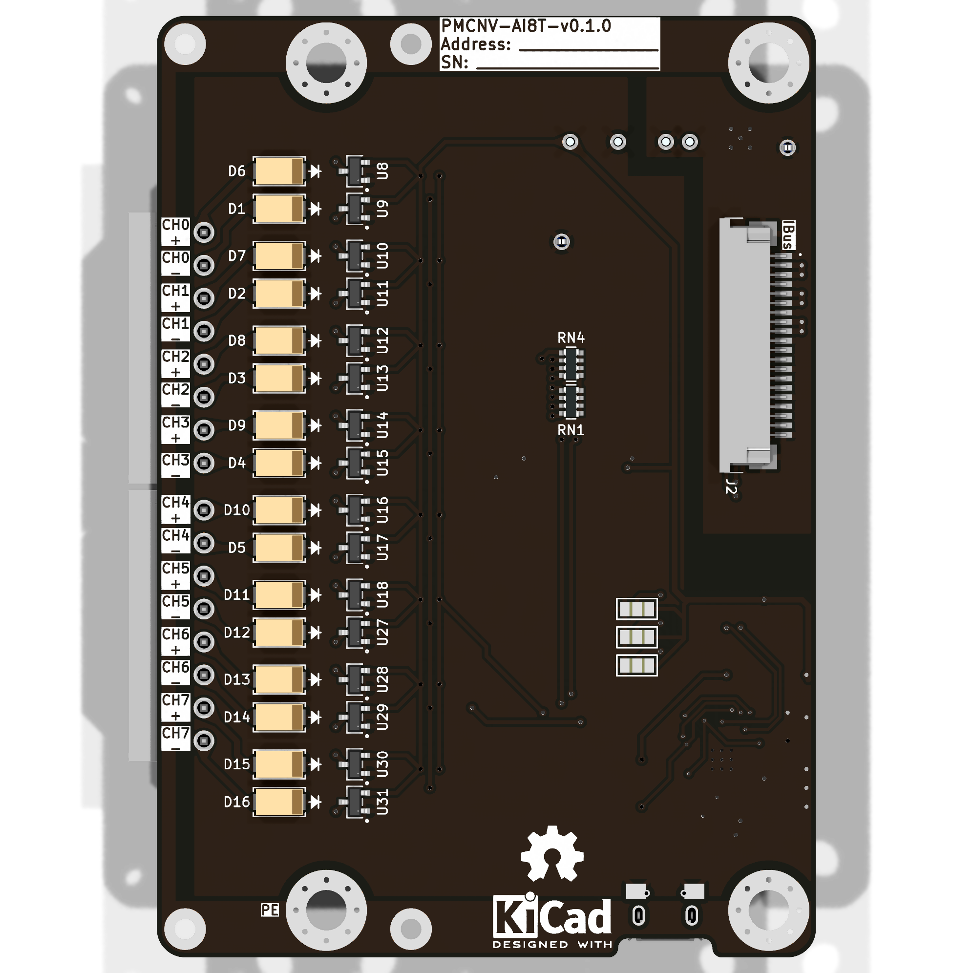
pcb/PMCNV-AI8T-v0.1.0/export/v0.1.0/render_x0y180z0.png
