Konstantin-Dudersky/plc-modules/pcb/PMCNV-RQx8-v0.1.0/export/v0.1.0/render_x0y0z0.png

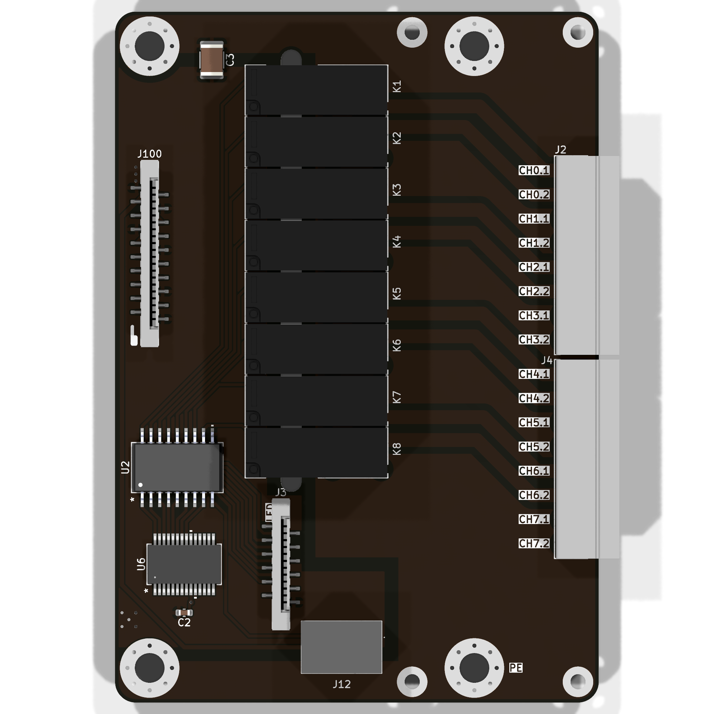
pcb/PMCNV-RQx8-v0.1.0/export/v0.1.0/render_x0y0z0.png
