Konstantin-Dudersky/plc-modules/pcb/PMCPU-ESP32C3-v0.1.0/doc/PM-CPU-ESP_view_y90.png

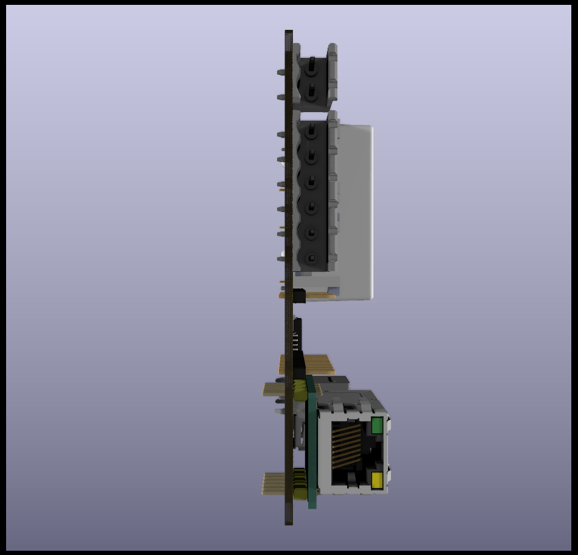
pcb/PMCPU-ESP32C3-v0.1.0/doc/PM-CPU-ESP_view_y90.png
