Konstantin-Dudersky/plc-modules/pcb/PMCPU-LLP-v0.1.0/export/v0.1.0/render_x0y0z0.png

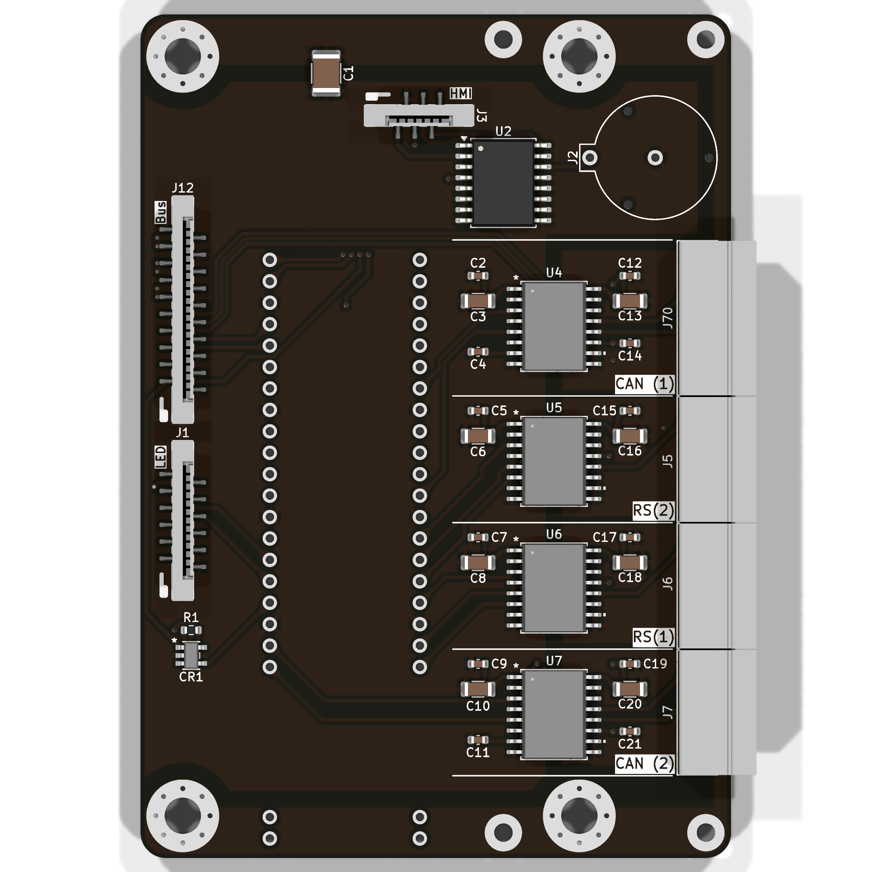
pcb/PMCPU-LLP-v0.1.0/export/v0.1.0/render_x0y0z0.png
