Konstantin-Dudersky/plc-modules/pcb/PMPS-20W-v0.1.0/doc/PM-PS.png

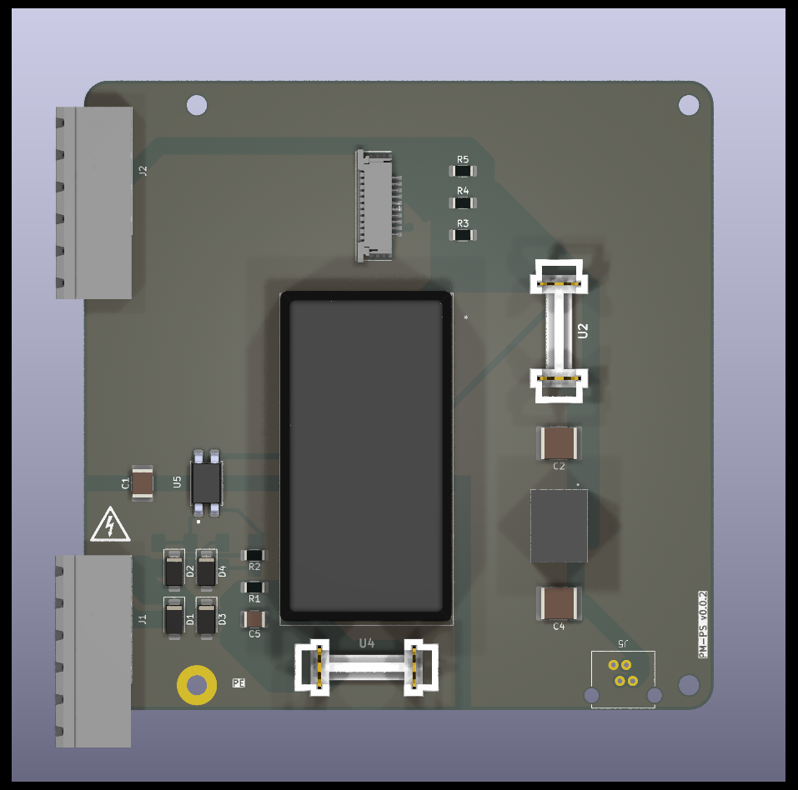
pcb/PMPS-20W-v0.1.0/doc/PM-PS.png
