Konstantin-Dudersky/plc-modules/pcb/PMPS-20W-v0.1.0/export/v0.1.0/render_x0y0z0.png

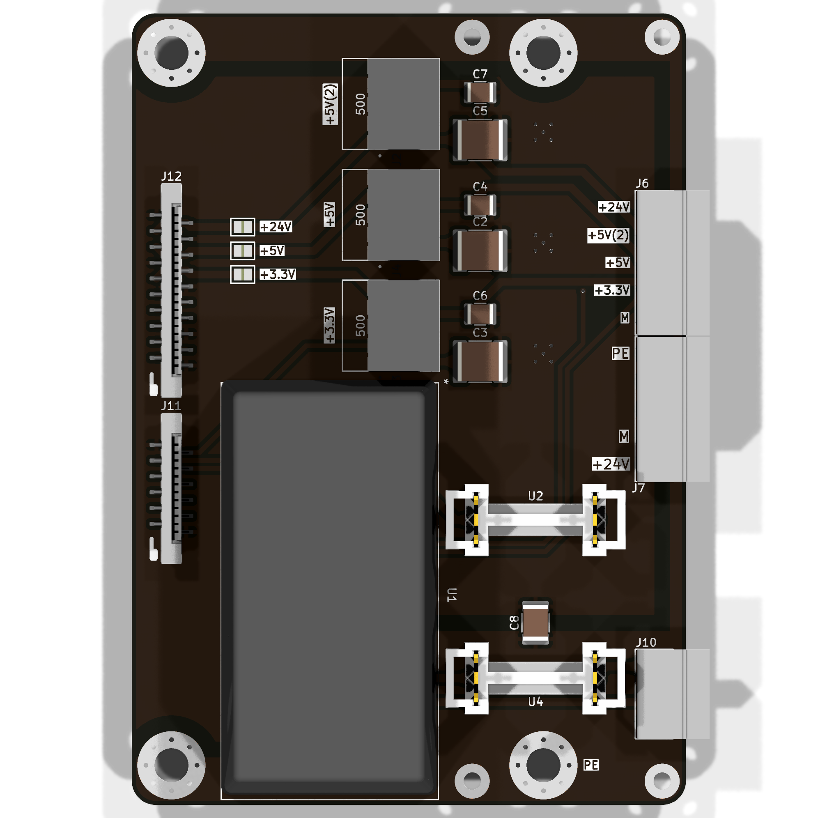
pcb/PMPS-20W-v0.1.0/export/v0.1.0/render_x0y0z0.png
