Konstantin-Dudersky/plc-modules/PM-AI8-IU-front-5V/doc/PM-AI8-IU-front-5V_view_x90.png

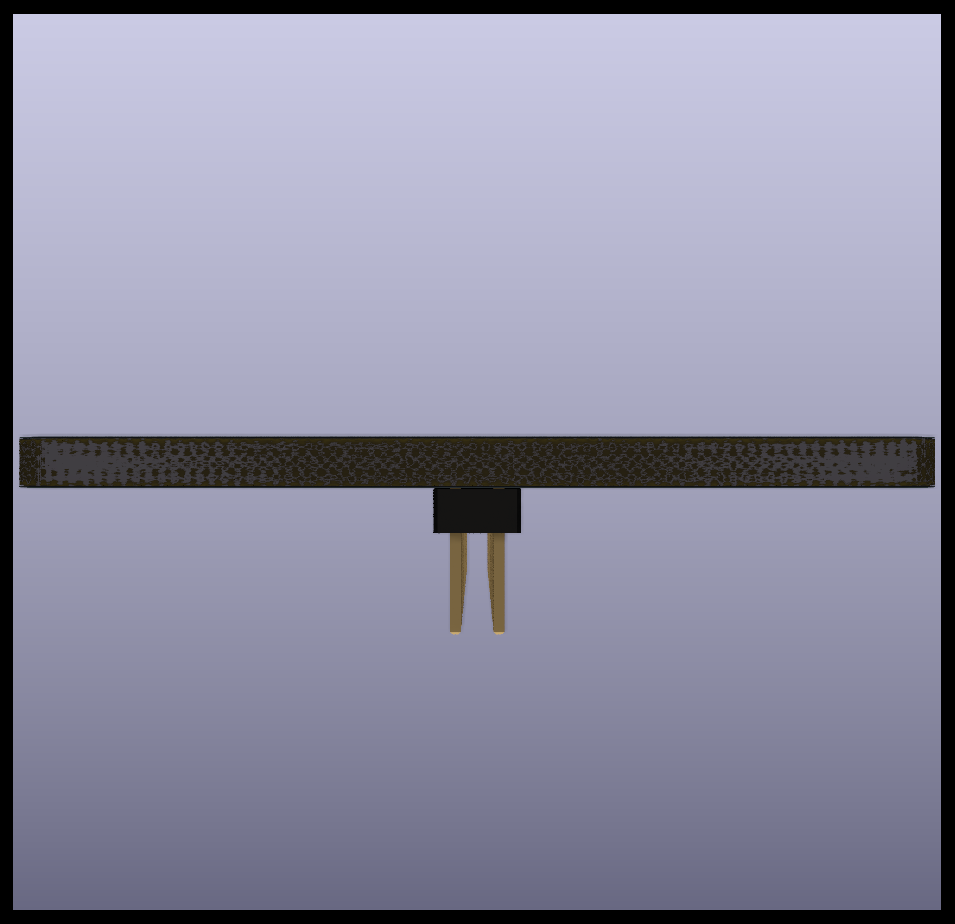
PM-AI8-IU-front-5V/doc/PM-AI8-IU-front-5V_view_x90.png
