Konstantin-Dudersky/plc-modules/PM-AI8-IU/doc/PM-AI8-IU_view_0.png

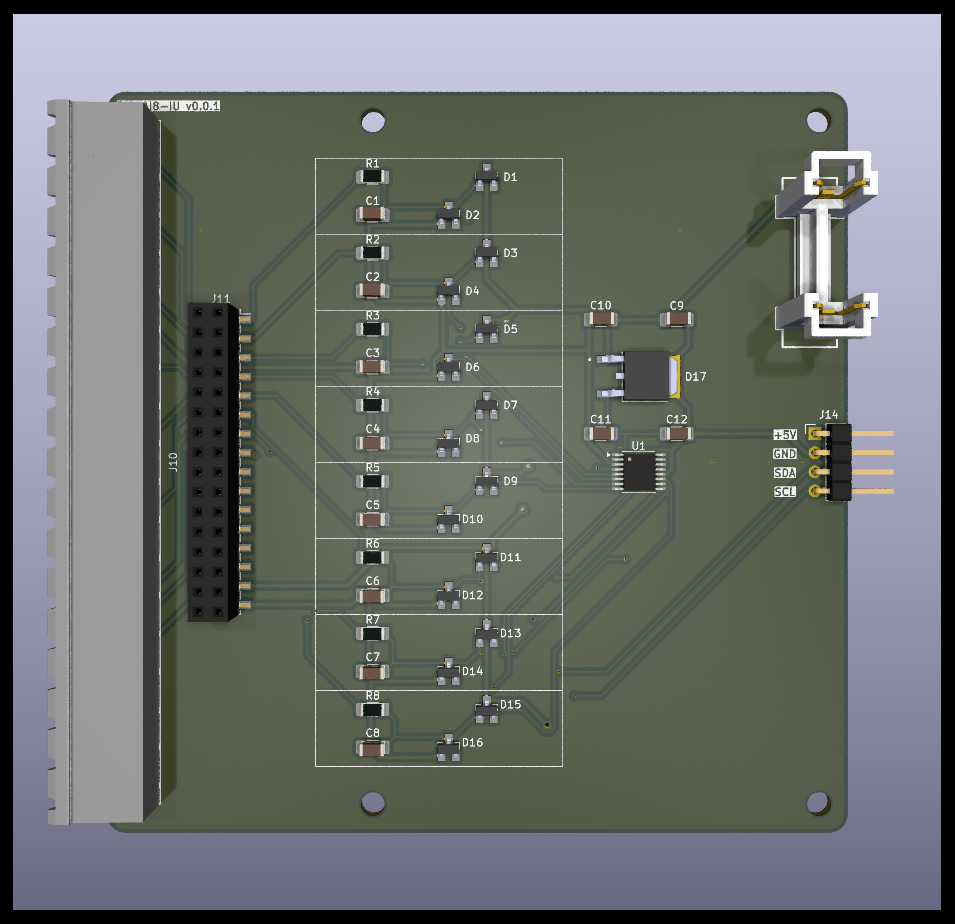
PM-AI8-IU/doc/PM-AI8-IU_view_0.png
