Konstantin-Dudersky/plc-modules/PM-AI8-IU/doc/PM-AI8-IU_view_x90.png

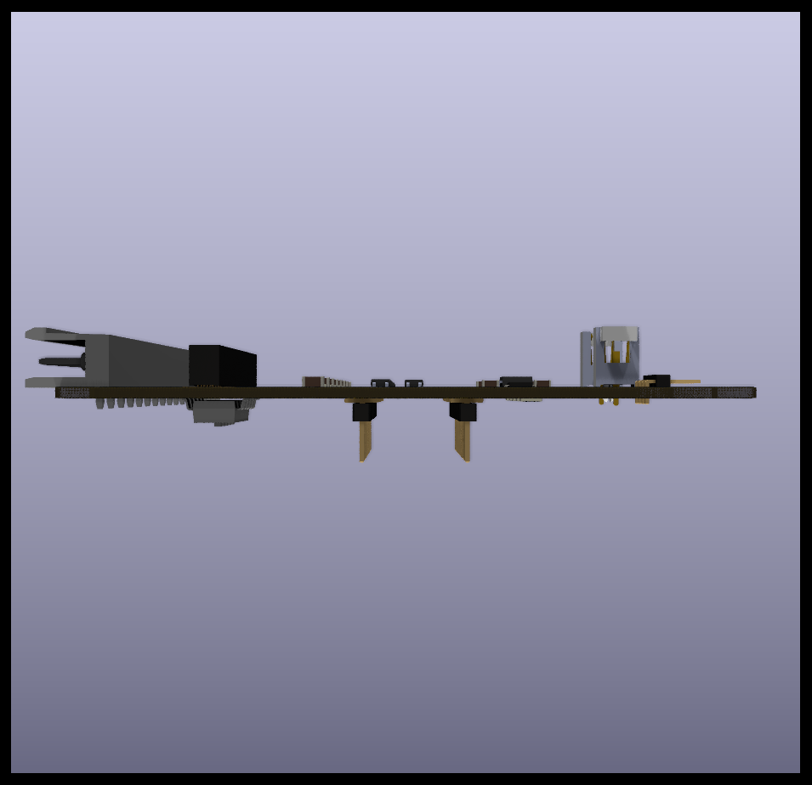
PM-AI8-IU/doc/PM-AI8-IU_view_x90.png
