Konstantin-Dudersky/plc-modules/PM-AI8-IU/doc/PM-AI8-IU_view_y180.png

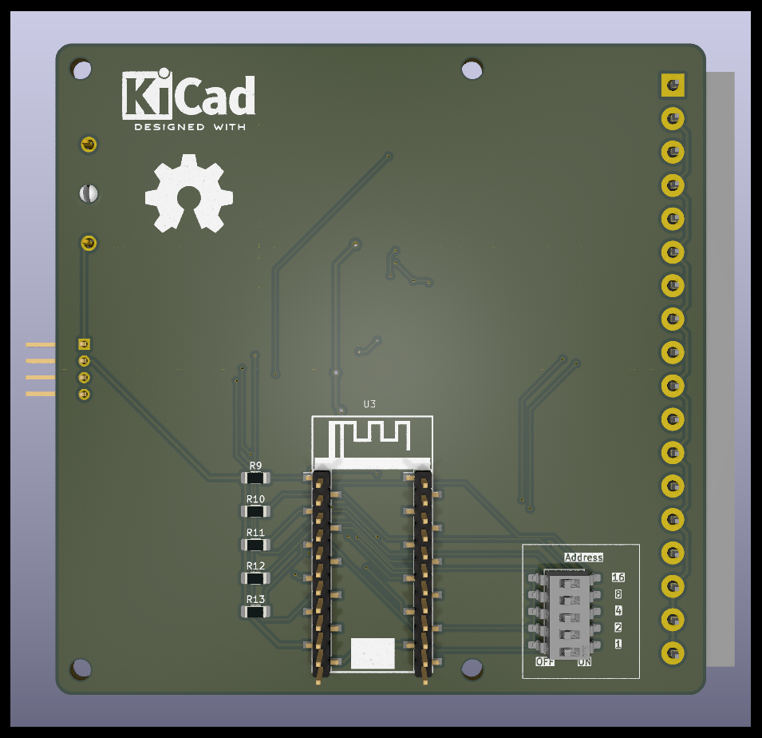
PM-AI8-IU/doc/PM-AI8-IU_view_y180.png
