Konstantin-Dudersky/plc-modules/PM-DI16-DC24sink_v0.0.3/doc/PM-DI16-DC24sink.png

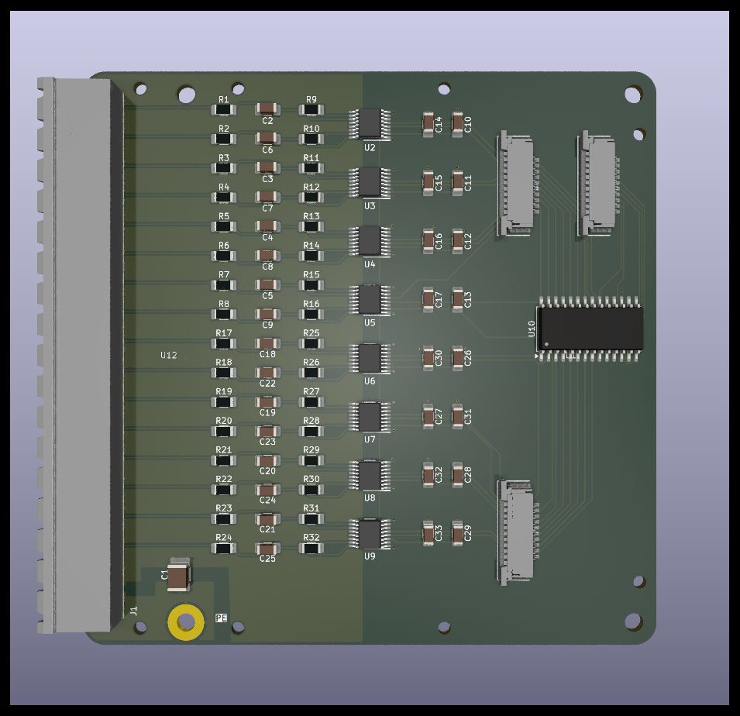
PM-DI16-DC24sink_v0.0.3/doc/PM-DI16-DC24sink.png
