Konstantin-Dudersky/plc-modules/PM-DI16/doc/PM-DI16-base_view.png

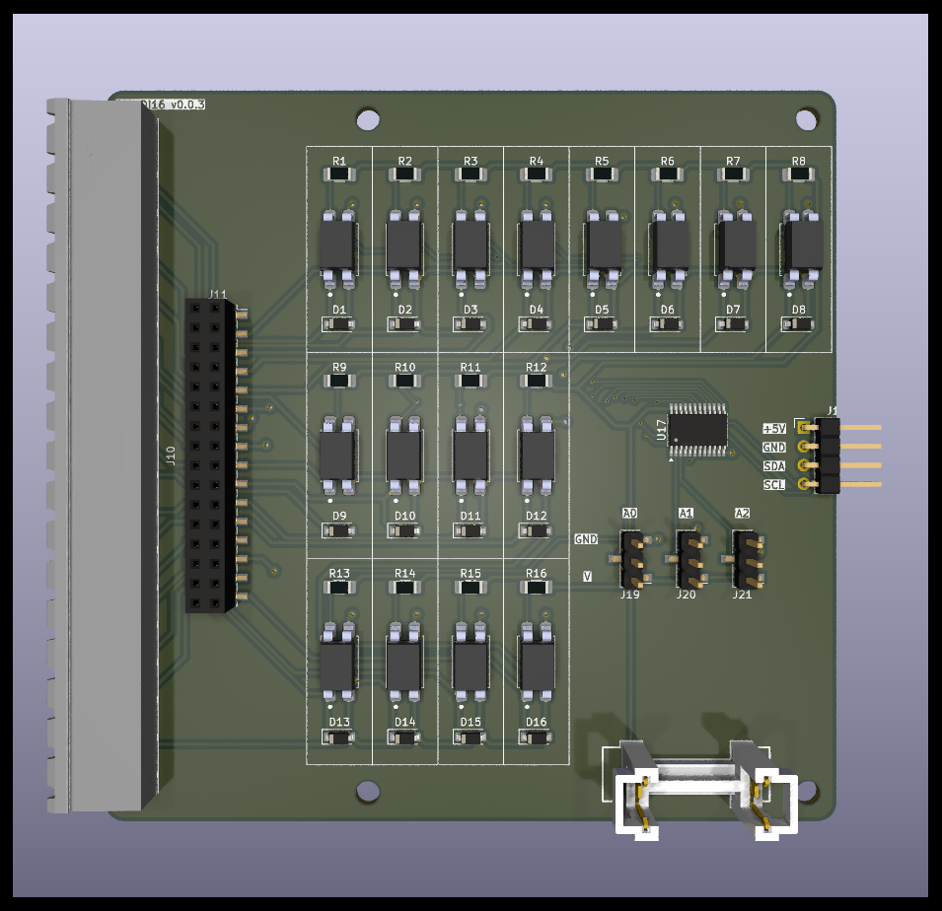
PM-DI16/doc/PM-DI16-base_view.png
