Konstantin-Dudersky/plc-modules/pcb/doc/pcb/PMLED-10/PMLED-10.BOM.csv

reference | quantity | part_ipn | note | Datasheet | optional
J1 | 1 | AFA07-S12FCC-00 | Generic connector, single row, 01x10, script generated
