Konstantin-Dudersky/plc-modules/pcb/doc/pcb/PMDBG-FFC20/PMDBG-FFC20.BOM.csv

reference | quantity | part_ipn | note | optional
J1 | 1 |  | Generic connector, double row, 02x08, odd/even pin numbering scheme (row 1 odd numbers, row 2 even numbers), script generated (kicad-library-utils/schlib/autogen/connector/)
J4,J5 | 2 | Shunt 2.54 Open Top
JM1,JM2 | 2 | AFA07-S20FCC-00 | Slide Lock 20P Bottom Contact Surface Mount, Right Angle 1mm SMD,P=1mm,Surface Mount，Right Angle FFC, FPC (Flat Flexible) Connector Assemblies ROHS
