Konstantin-Dudersky/plc-modules/docs/bom_sum/README.md

```sh
cargo build --release; cp target/release/bom_sum ./bin
```

Запустить

```sh
./bin/bom_sum 
```
