Konstantin-Dudersky/plc-modules/3d_step/PMLED-18_lite.step

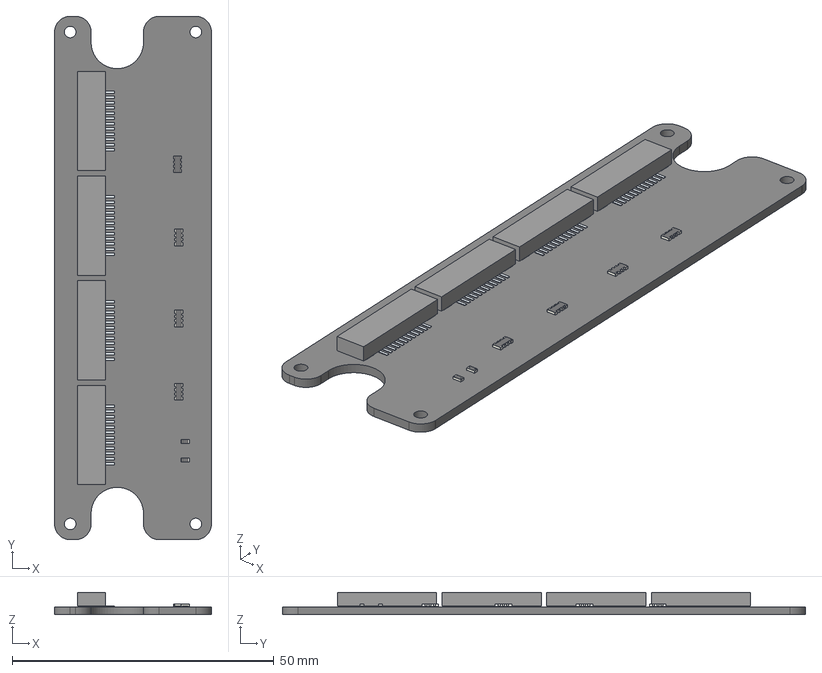
[picture p86: CAD file, 2026-05-19]
3d_step/PMLED-18_lite.step
30.0 x 100.0 x 4.29 mm
R_Array_Convex_4x0603 x 4
Pins x 4
R_0603_1608Metric x 2
PMLED-18_PCB
