Konstantin-Dudersky/plc-modules/PM-DI16-front-DC24/doc/PM-DI16-front-DC24.step

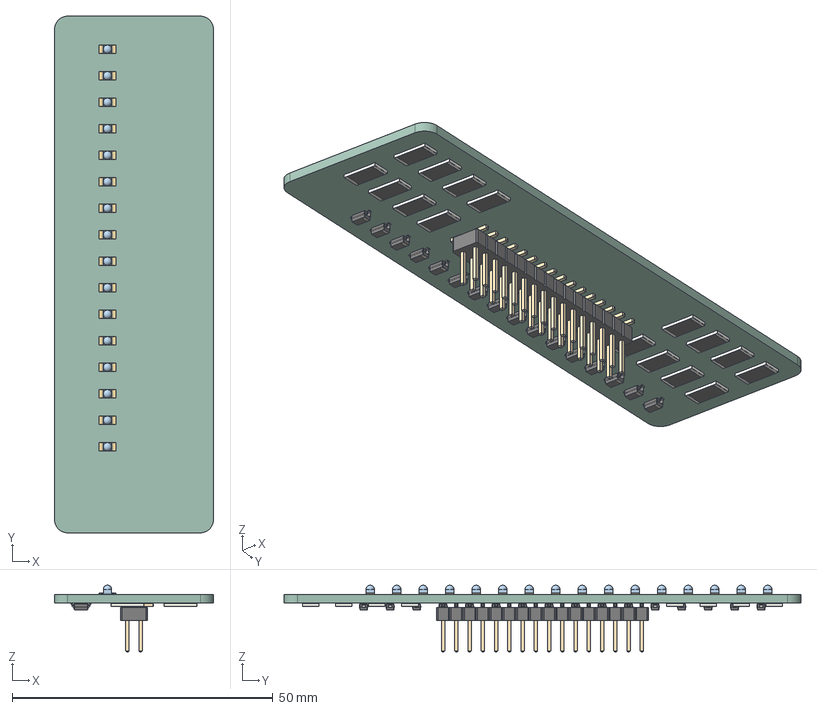
[picture p87: CAD file, 2024-06-25]
PM-DI16-front-DC24/doc/PM-DI16-front-DC24.step
30.5 x 99.1 x 12.8 mm
KPTD-3216CGCK-01 x 16
D_SOD_123 x 16
R_2512_6332Metric x 16
PinHeader_2x16_P254mm_Vertical_SMD
PM-DI16-front-DC24_PCB
