Konstantin-Dudersky/plc-modules/PM-OC8/doc/PM-OC8.step

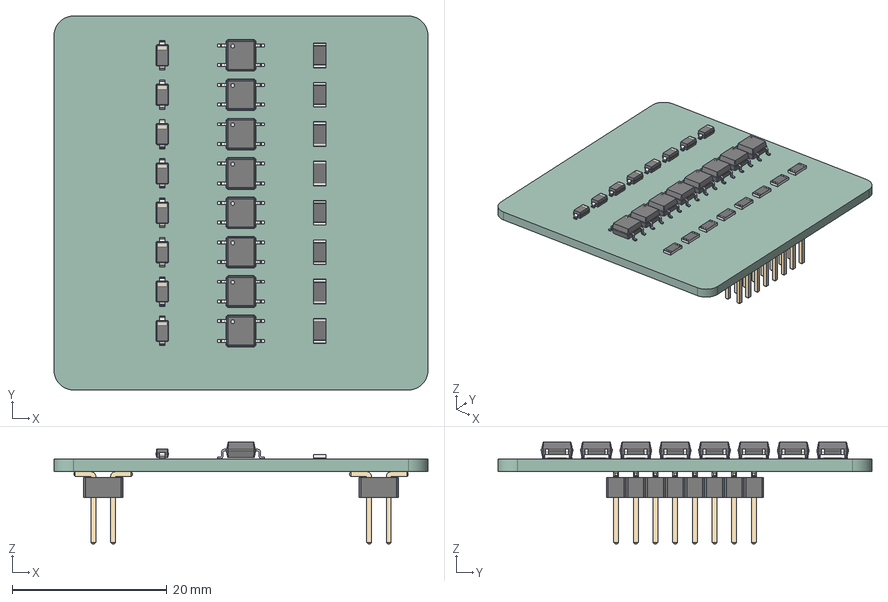
[picture p88: CAD file, 2024-05-15]
PM-OC8/doc/PM-OC8.step
48.3 x 48.3 x 13.1 mm
D_SOD_123 x 8
SOP_4_38x41mm_P254mm x 8
R_1206_3216Metric x 8
PinHeader_2x08_P254mm_Vertical_SMD x 2
PM-OC8_PCB
