Konstantin-Dudersky/plc-modules/PM-RQ8-front_v0.0.4/doc/PM-RQ8-front.step

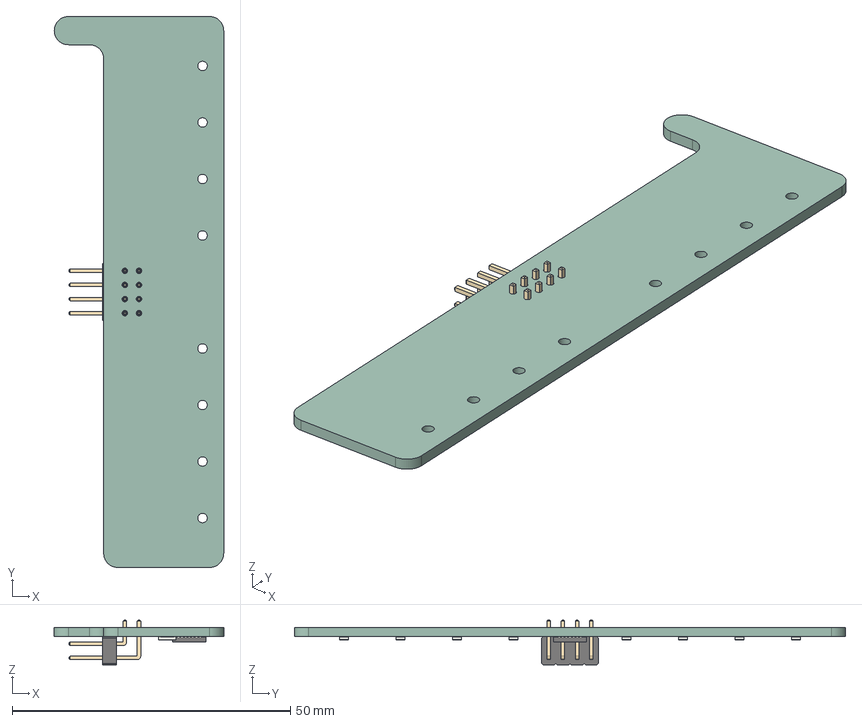
[picture p89: CAD file, 2024-08-27]
PM-RQ8-front_v0.0.4/doc/PM-RQ8-front.step
30.5 x 99.1 x 8.08 mm
R_1206_3216Metric x 8
QFN-28-1EP_6x6mm_Pitch0.65mm
PinHeader_2x04_P254mm_Horizontal
PM-RQ8-front_PCB
