Konstantin-Dudersky/plc-modules/PM-RQ8_v0.0.4/doc/PM-RQ8-base.step

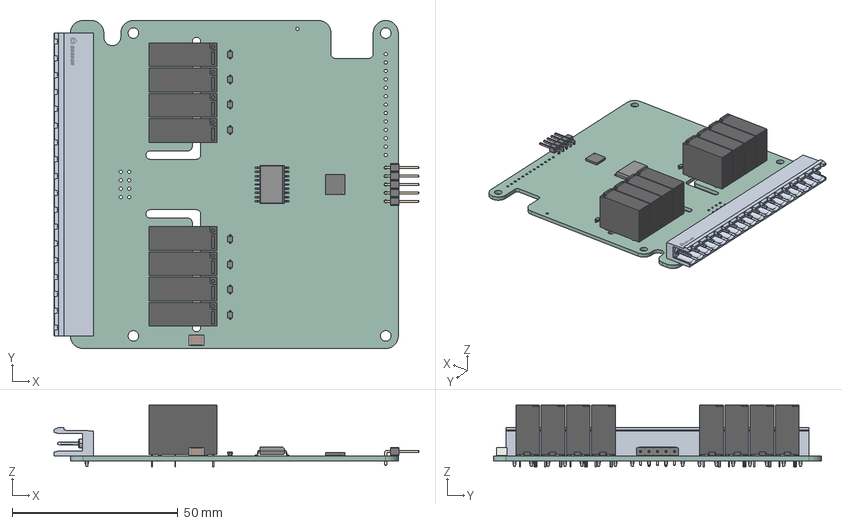
[picture p90: CAD file, 2024-08-27]
PM-RQ8_v0.0.4/doc/PM-RQ8-base.step
110.2 x 99.1 x 18.7 mm
G5NB_1A_E x 8
QFN-28-1EP_6x6mm_Pitch0.65mm
DW18
2EDGR-5.08-18P-14-100A(H)
C_1812_4532Metric
PinHeader_1x05_P254mm_Horizontal
PM-RQ8_PCB
