Konstantin-Dudersky/plc-modules/3d_step/PMCNV-INA226x4_lite.step

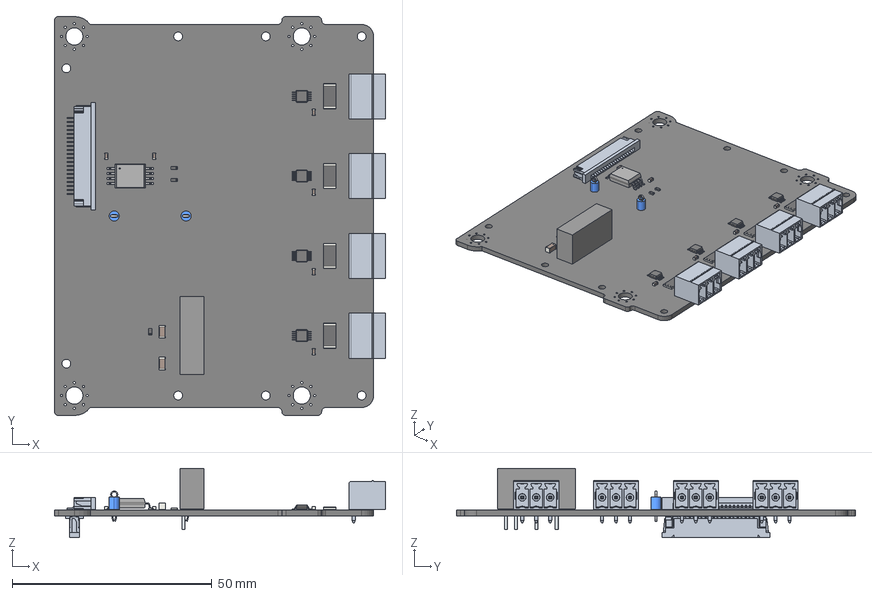
[picture p91: CAD file, 2026-04-01]
3d_step/PMCNV-INA226x4_lite.step
83.0 x 100.0 x 17.4 mm
VSSOP-10_3x3mm_P0.5mm x 4
R_2512_6332Metric x 4
C_0603_1608Metric x 6
R_0603_1608Metric x 3
Leads
15EDGRC-3.5-03P-1Y-00A&Z(H) x 4
C_1206_3216Metric x 2
SOICW8_CLG
Geh㴳e
Verschluss
Pin1 x 20
Pin_rechts
Pin_rechts_mir5
X10C2520XZ
PMCNV-INA226x4_PCB
