Konstantin-Dudersky/plc-modules/3d_step/PMCNV-INA226.step

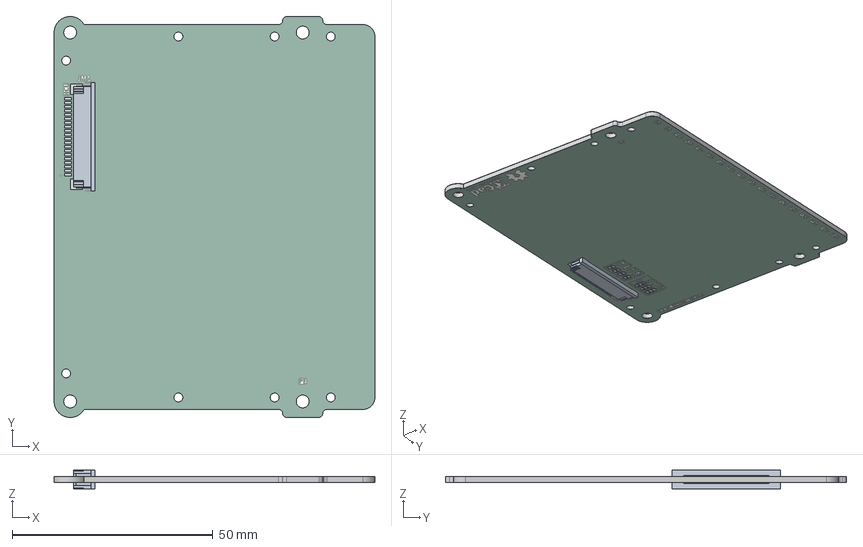
[picture p92: CAD file, 2025-12-06]
3d_step/PMCNV-INA226.step
80.0 x 100.0 x 4.68 mm
Geh㴳e x 2
Verschluss x 2
Pin1 x 40
Pin_rechts x 2
Pin_rechts_mir5 x 2
PMCNV-INA226_pad
PMCNV-INA226_silkscreen x 2
PMCNV-INA226_soldermask x 2
PMCNV-INA226_PCB
