Konstantin-Dudersky/plc-modules/3d_step/PMDBG-FFC20.step

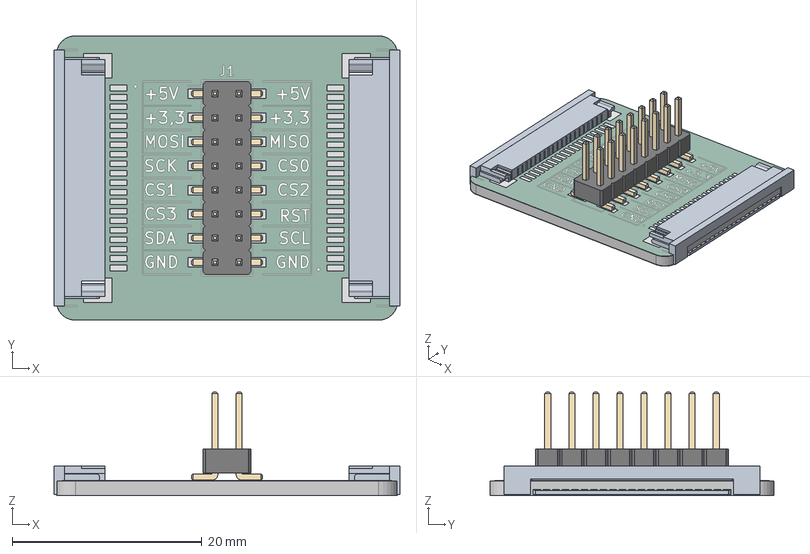
[picture p93: CAD file, 2025-10-31]
3d_step/PMDBG-FFC20.step
36.5 x 30.0 x 11.0 mm
PinHeader_2x08_P2.54mm_Vertical_SMD
Geh㴳e x 2
Verschluss x 2
Pin1 x 40
Pin_rechts x 2
Pin_rechts_mir5 x 2
PMDBG-FFC20_copper
PMDBG-FFC20_pad
PMDBG-FFC20_via
PMDBG-FFC20_silkscreen
PMDBG-FFC20_soldermask
PMDBG-FFC20_PCB
