Konstantin-Dudersky/plc-modules/template/main_v4/main.step

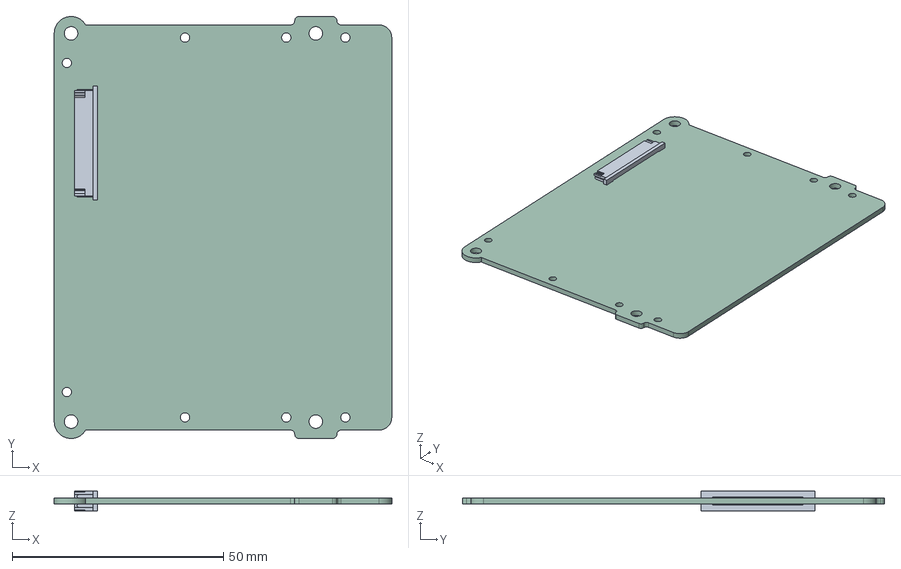
[picture p94: CAD file, 2025-08-02, an earlier design]
template/main_v4/main.step
80.0 x 100.0 x 4.68 mm
Geh㴳e x 2
Verschluss x 2
Pin1 x 40
Pin_rechts x 2
Pin_rechts_mir5 x 2
main_PCB
