Konstantin-Dudersky/plc-modules/pcb/PMPS-20W-v0.1.0/export/v0.0.6/PMPS-20W_lite.step

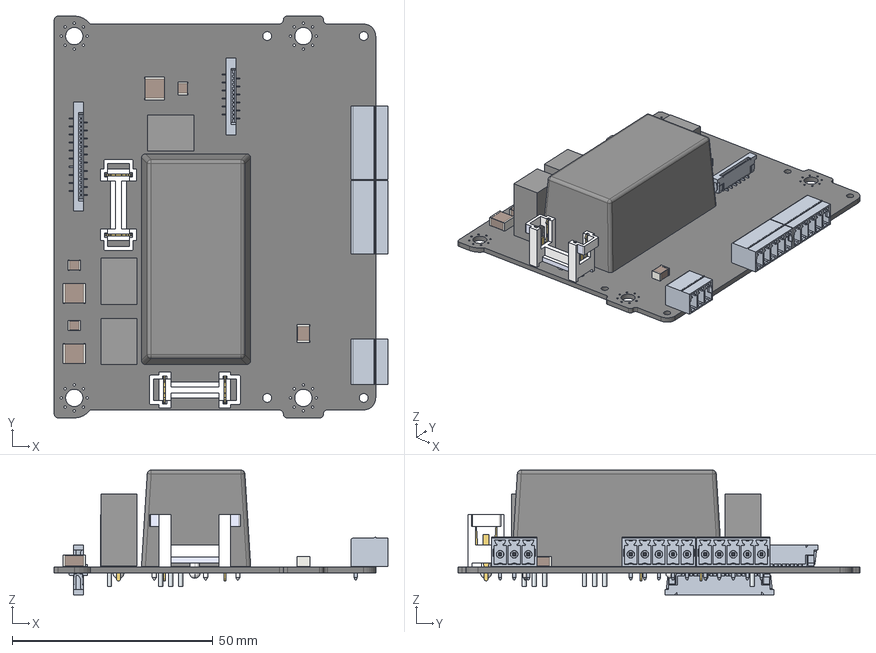
[picture p95: CAD file, 2026-04-01, an earlier design]
pcb/PMPS-20W-v0.1.0/export/v0.0.6/PMPS-20W_lite.step
83.0 x 100.0 x 31.1 mm
C_2220_5750Metric x 3
C_1210_3225Metric x 3
Leads x 9
IRM-20-24_MWU
15EDGRC-3.5-03P-1Y-00A&Z(H)
15EDGRC-3.5-05P-1Y-00A&Z(H) x 2
X10C2520XZ x 2
X10C2512XZ
C_1812_4532Metric
PMPS-20W_PCB
