Konstantin-Dudersky/plc-modules/TODO.md

PM_CPU:
- Крепление шины кривое
- Питание и PE также через нижний клеммник, убрать передний

PM_MCU:
- пересмотреть распиновку микроконтроллера:
    - 7 пинов SPI / I2C. Объединить: CS3 + INT; SCK + SCL; MOSI + SDA
    - 2 пина USB
    - 3 пина UART
    - 3 пина. При запуске адрес, после на светодиоды
- MicroUSB - удлинить немного площадки под пайку

DAC:
- MS5614
- XTR117 4-20mA Current-Loop Transmitter
