Konstantin-Dudersky/plc-modules/PM-DI16-front-DC24/doc/PM-DI16-front-DC24.pdf

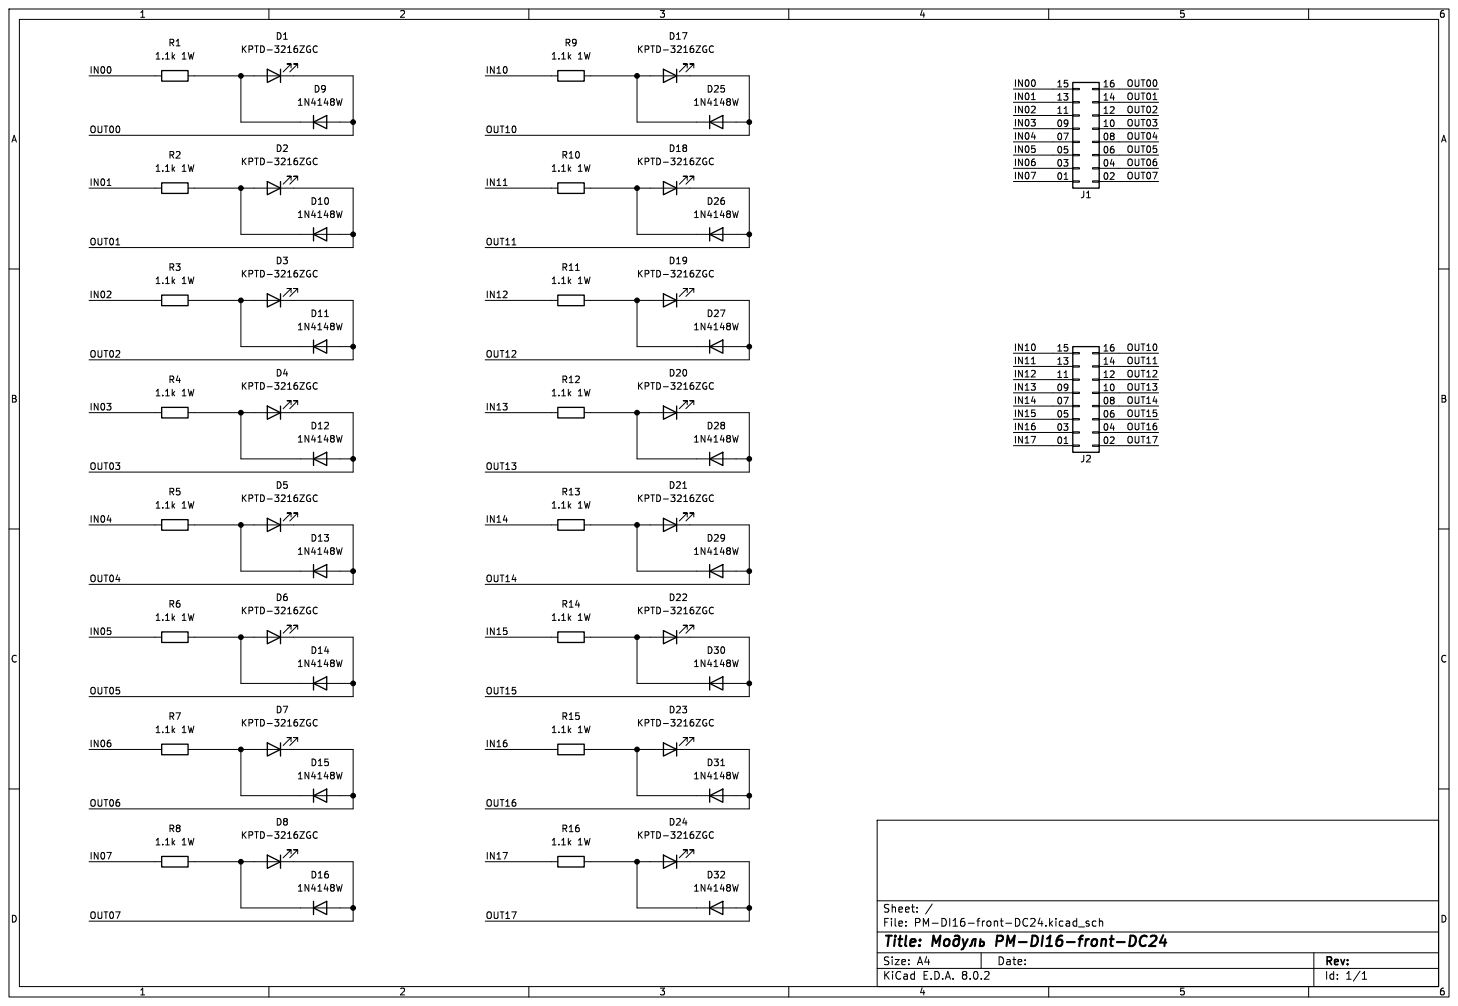
[picture p96: page 1]

File: PM-DI16-front-DC24.kicad_sch Sheet: / R14

Id: 1/1 Title: þÿ>4C;LPM-DI16-front-DC24
