Konstantin-Dudersky/plc-modules/PM-RQ8-front_v0.0.4/doc/PM-RQ8-front.pdf

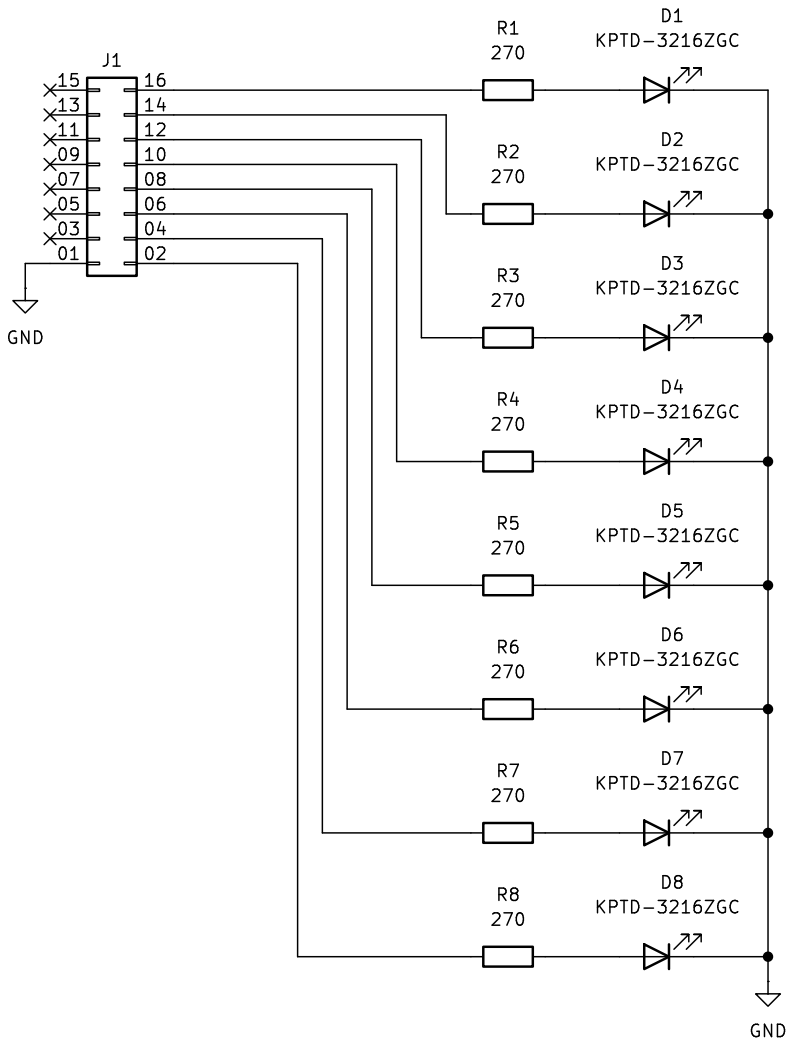
[picture p97: page 1]

Id: 1/1 Title: þÿ>4C;LPM-RQ8-front File: PM-RQ8-front.kicad_sch Sheet: / R8
