Konstantin-Dudersky/plc-modules/pcb/PMPS-20W-v0.1.0/doc/PM-PS.pdf

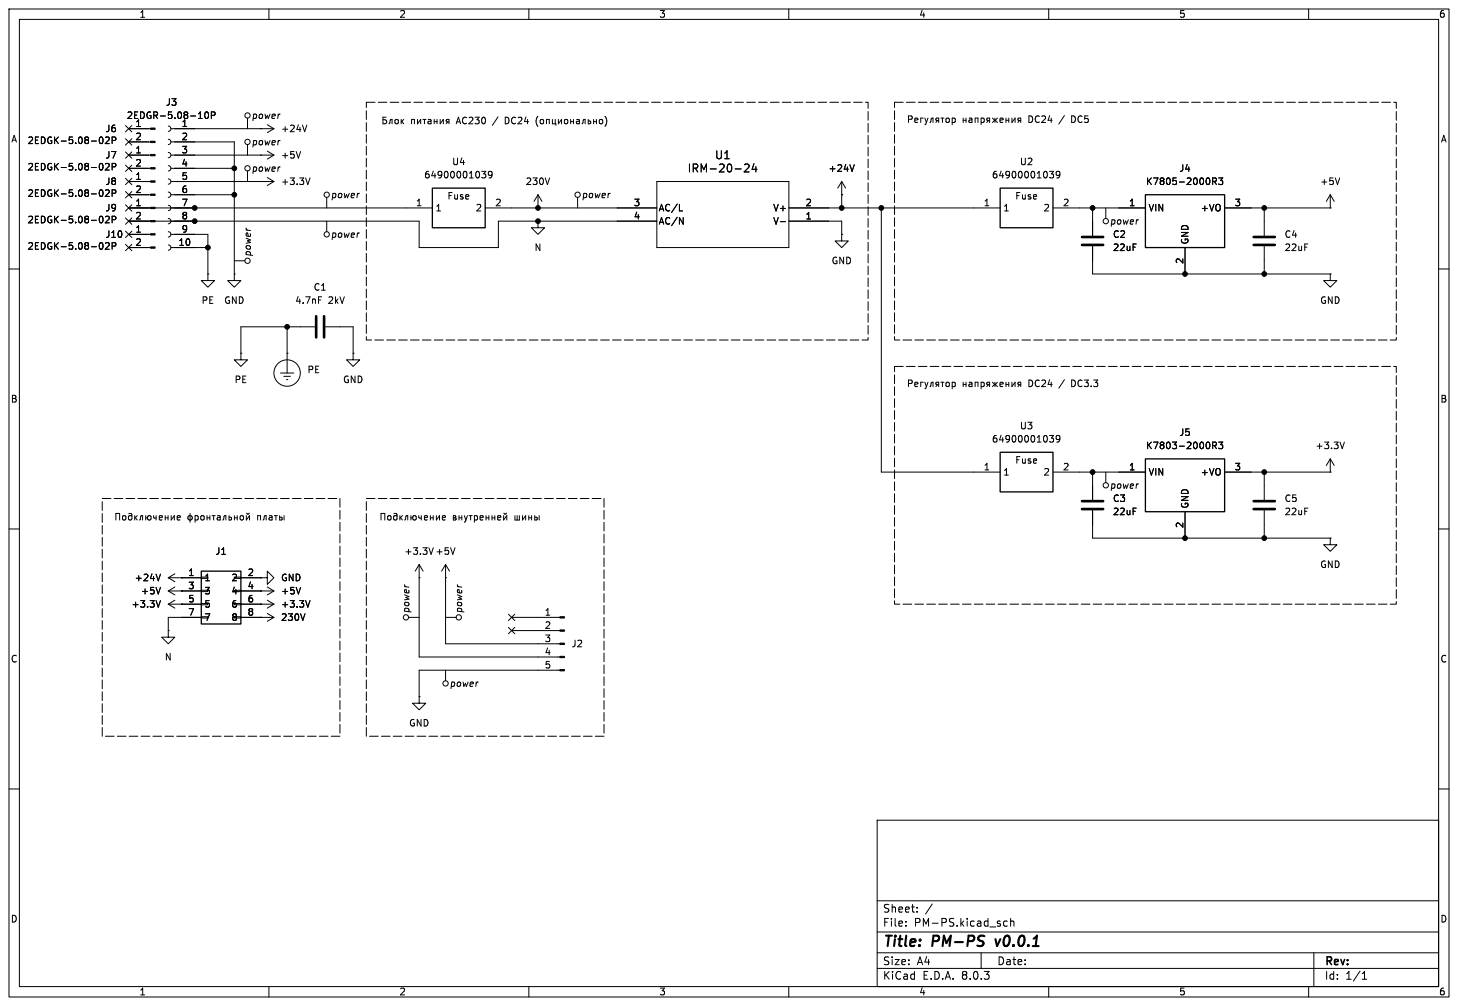
[picture p98: page 1]

File: PM-PS.kicad_sch Sheet: /
