Konstantin-Dudersky/plc-modules/pcb/PMPS-20W-v0.1.0/export/v0.1.0/PMCPU-ESP32C3.pdf

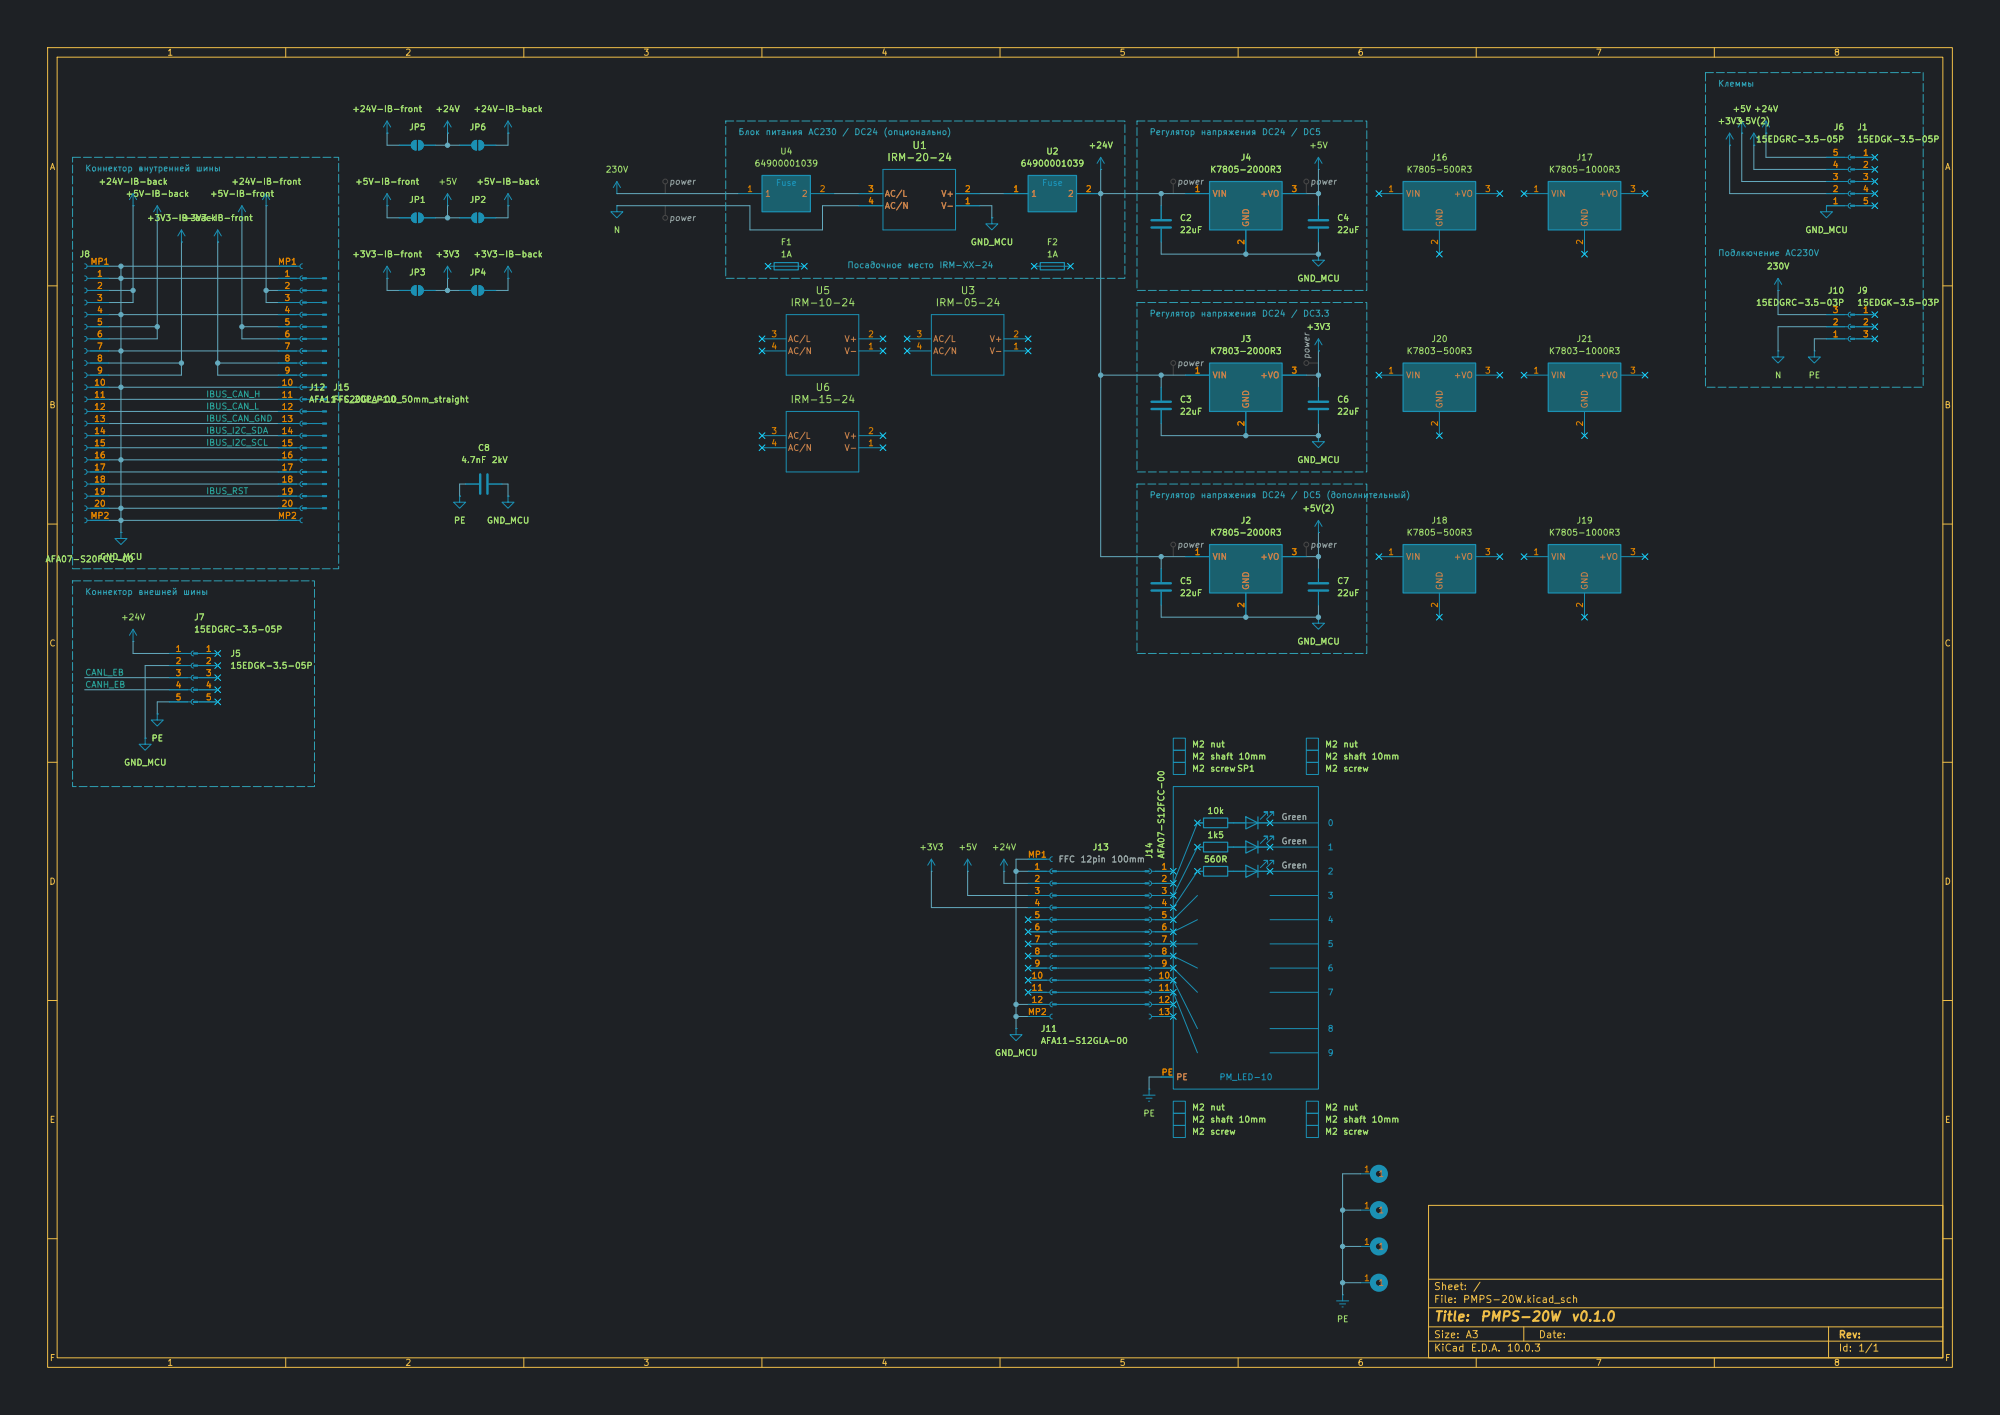
[picture p99: page 1]

Регулятор напряжения DC24 / DC3.3 Блок питания AC230 / DC24 (опционально)

+3V3-IB-front +5V-IB-front +3V3-IB-back +5V-IB-back GND_MCU

Size: A3 | Rev:
KiCad E.D.A. 10.0.3 | Id: 1/1 | F Date:
