Konstantin-Dudersky/plc-modules/pcb/PMCNV-RQx8-v0.1.0/export/v0.1.0/PMCPU-ESP32C3.pdf

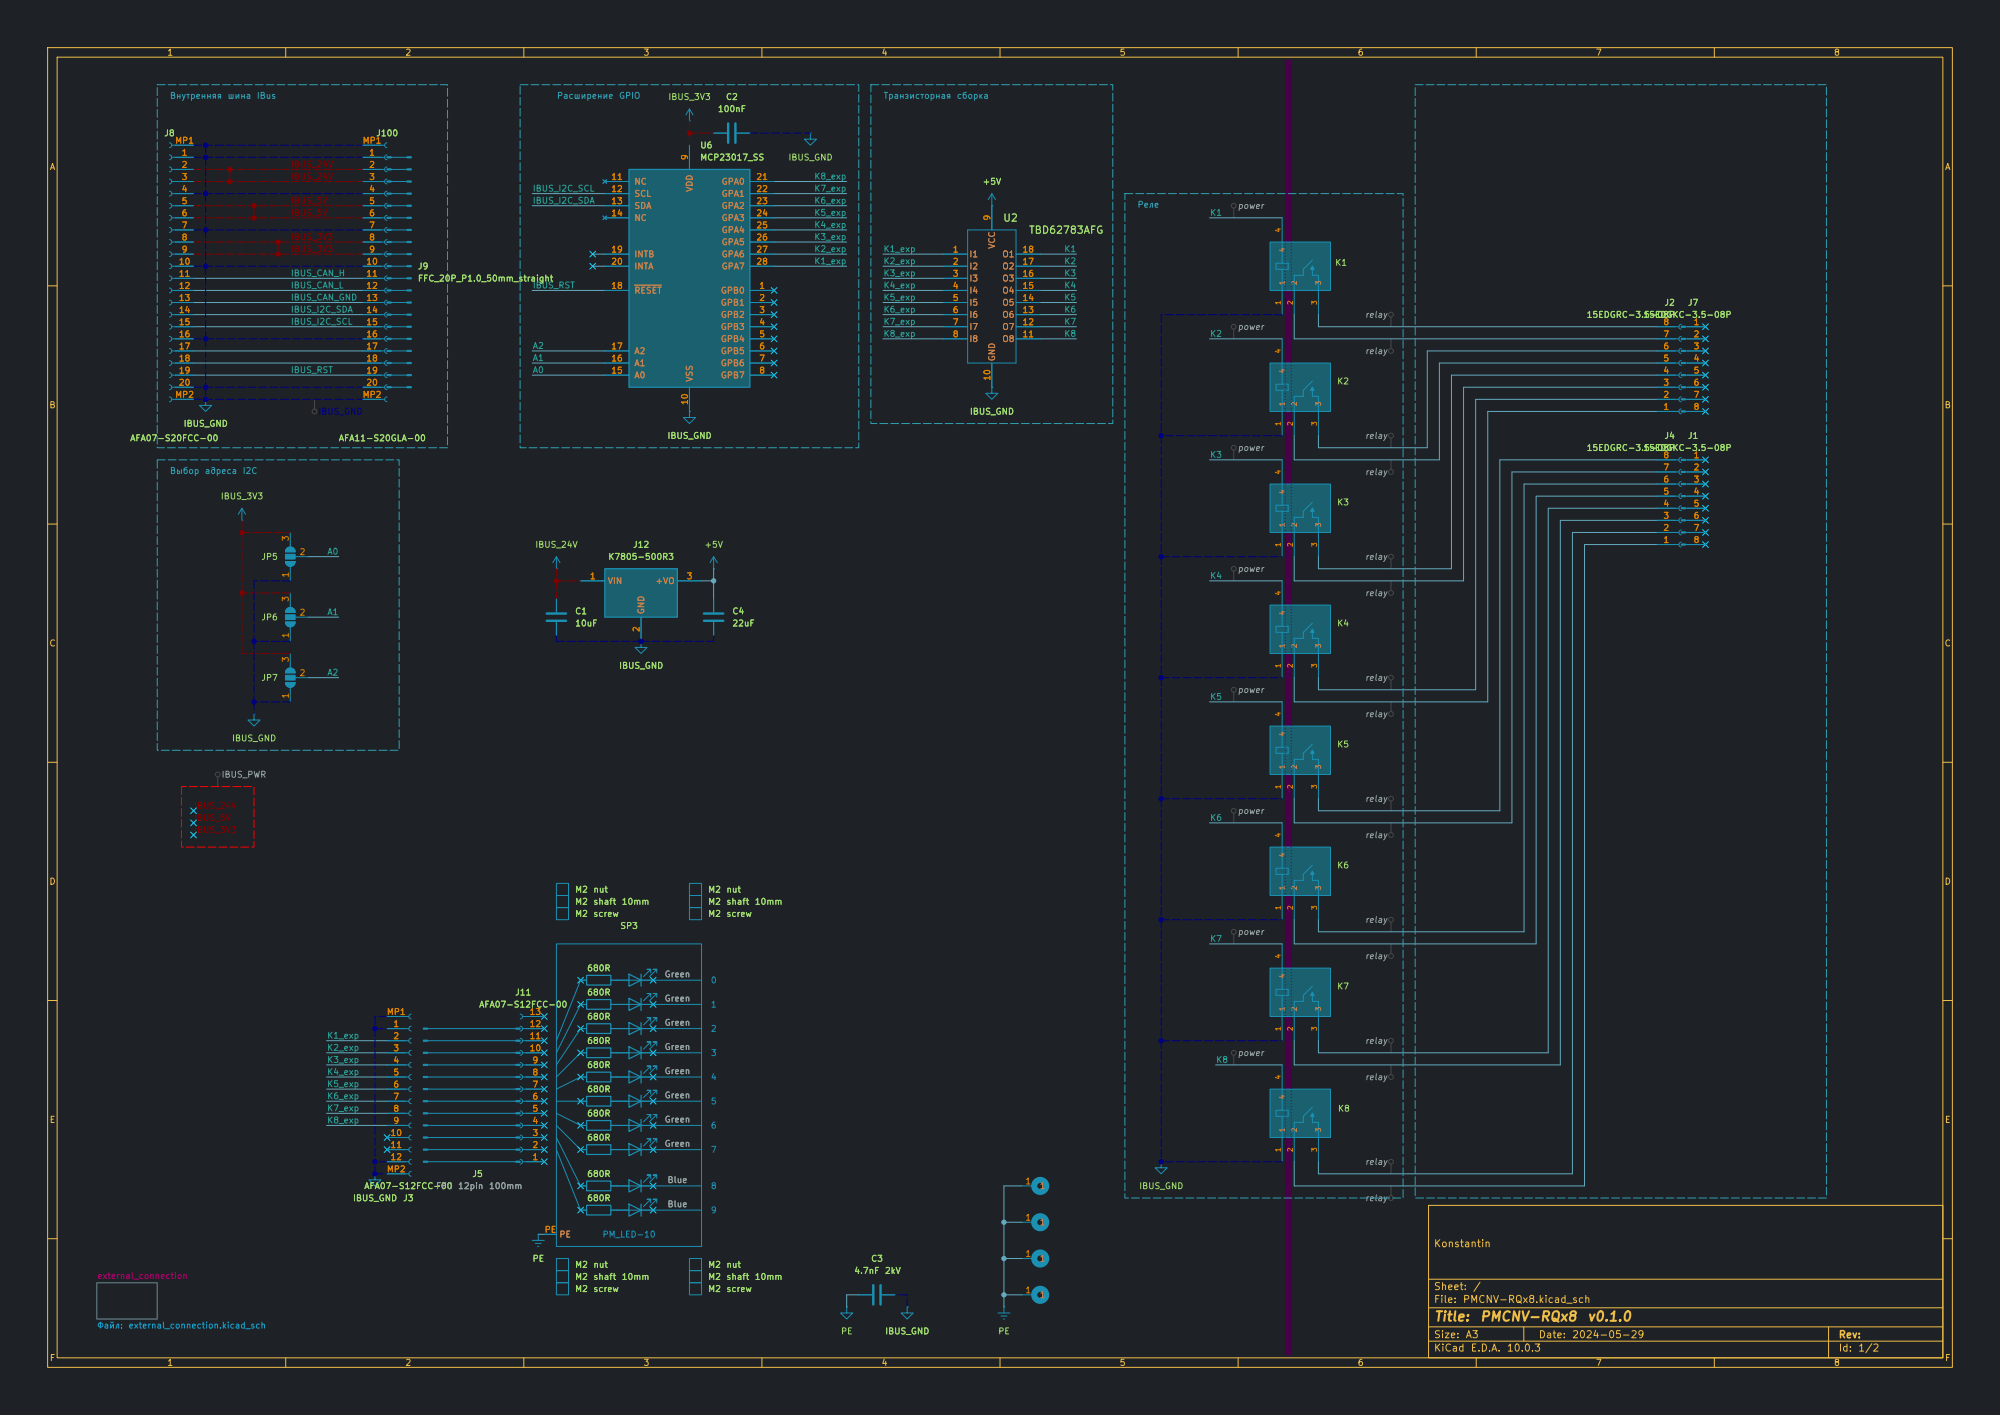
[picture p100: page 1]

Green Green Green M2 shaft 10mm
M2 screw

PE M2 nut Green Green PE

Size: A3 | Rev:
KiCad E.D.A. 10.0.3 | Id: 1/2

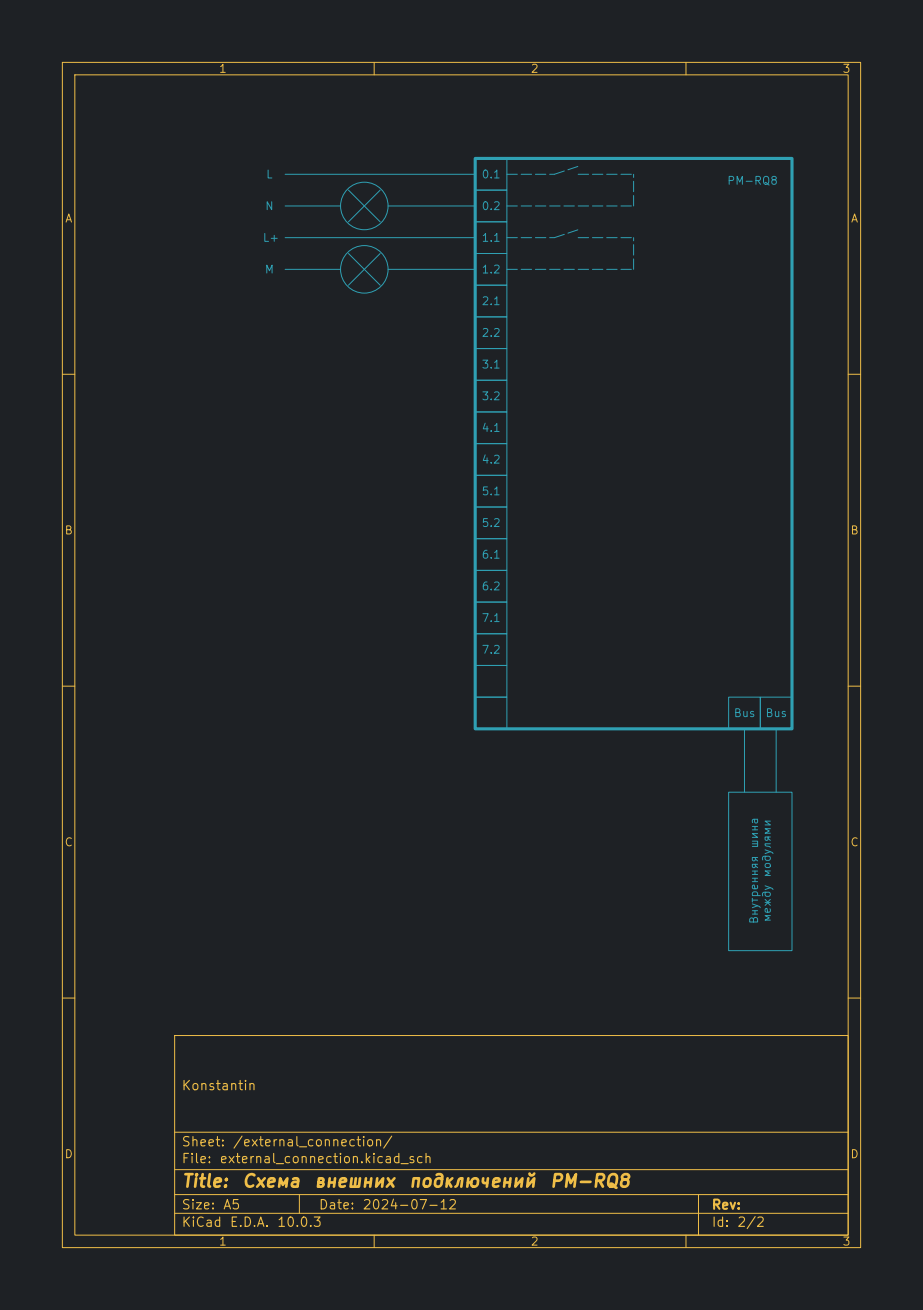
[picture p101: page 2]

Sheet: /external_connection/
File: external_connection.kicad_sch
Title: Схема внешних подключений PM-RQ8

Size: A5 | Rev:
KiCad E.D.A. 10.0.3 | Id: 2/2
