Konstantin-Dudersky/plc-modules/pcb/PMCNV-DQx16-v0.1.0/export/v0.1.0/PMCPU-ESP32C3.pdf

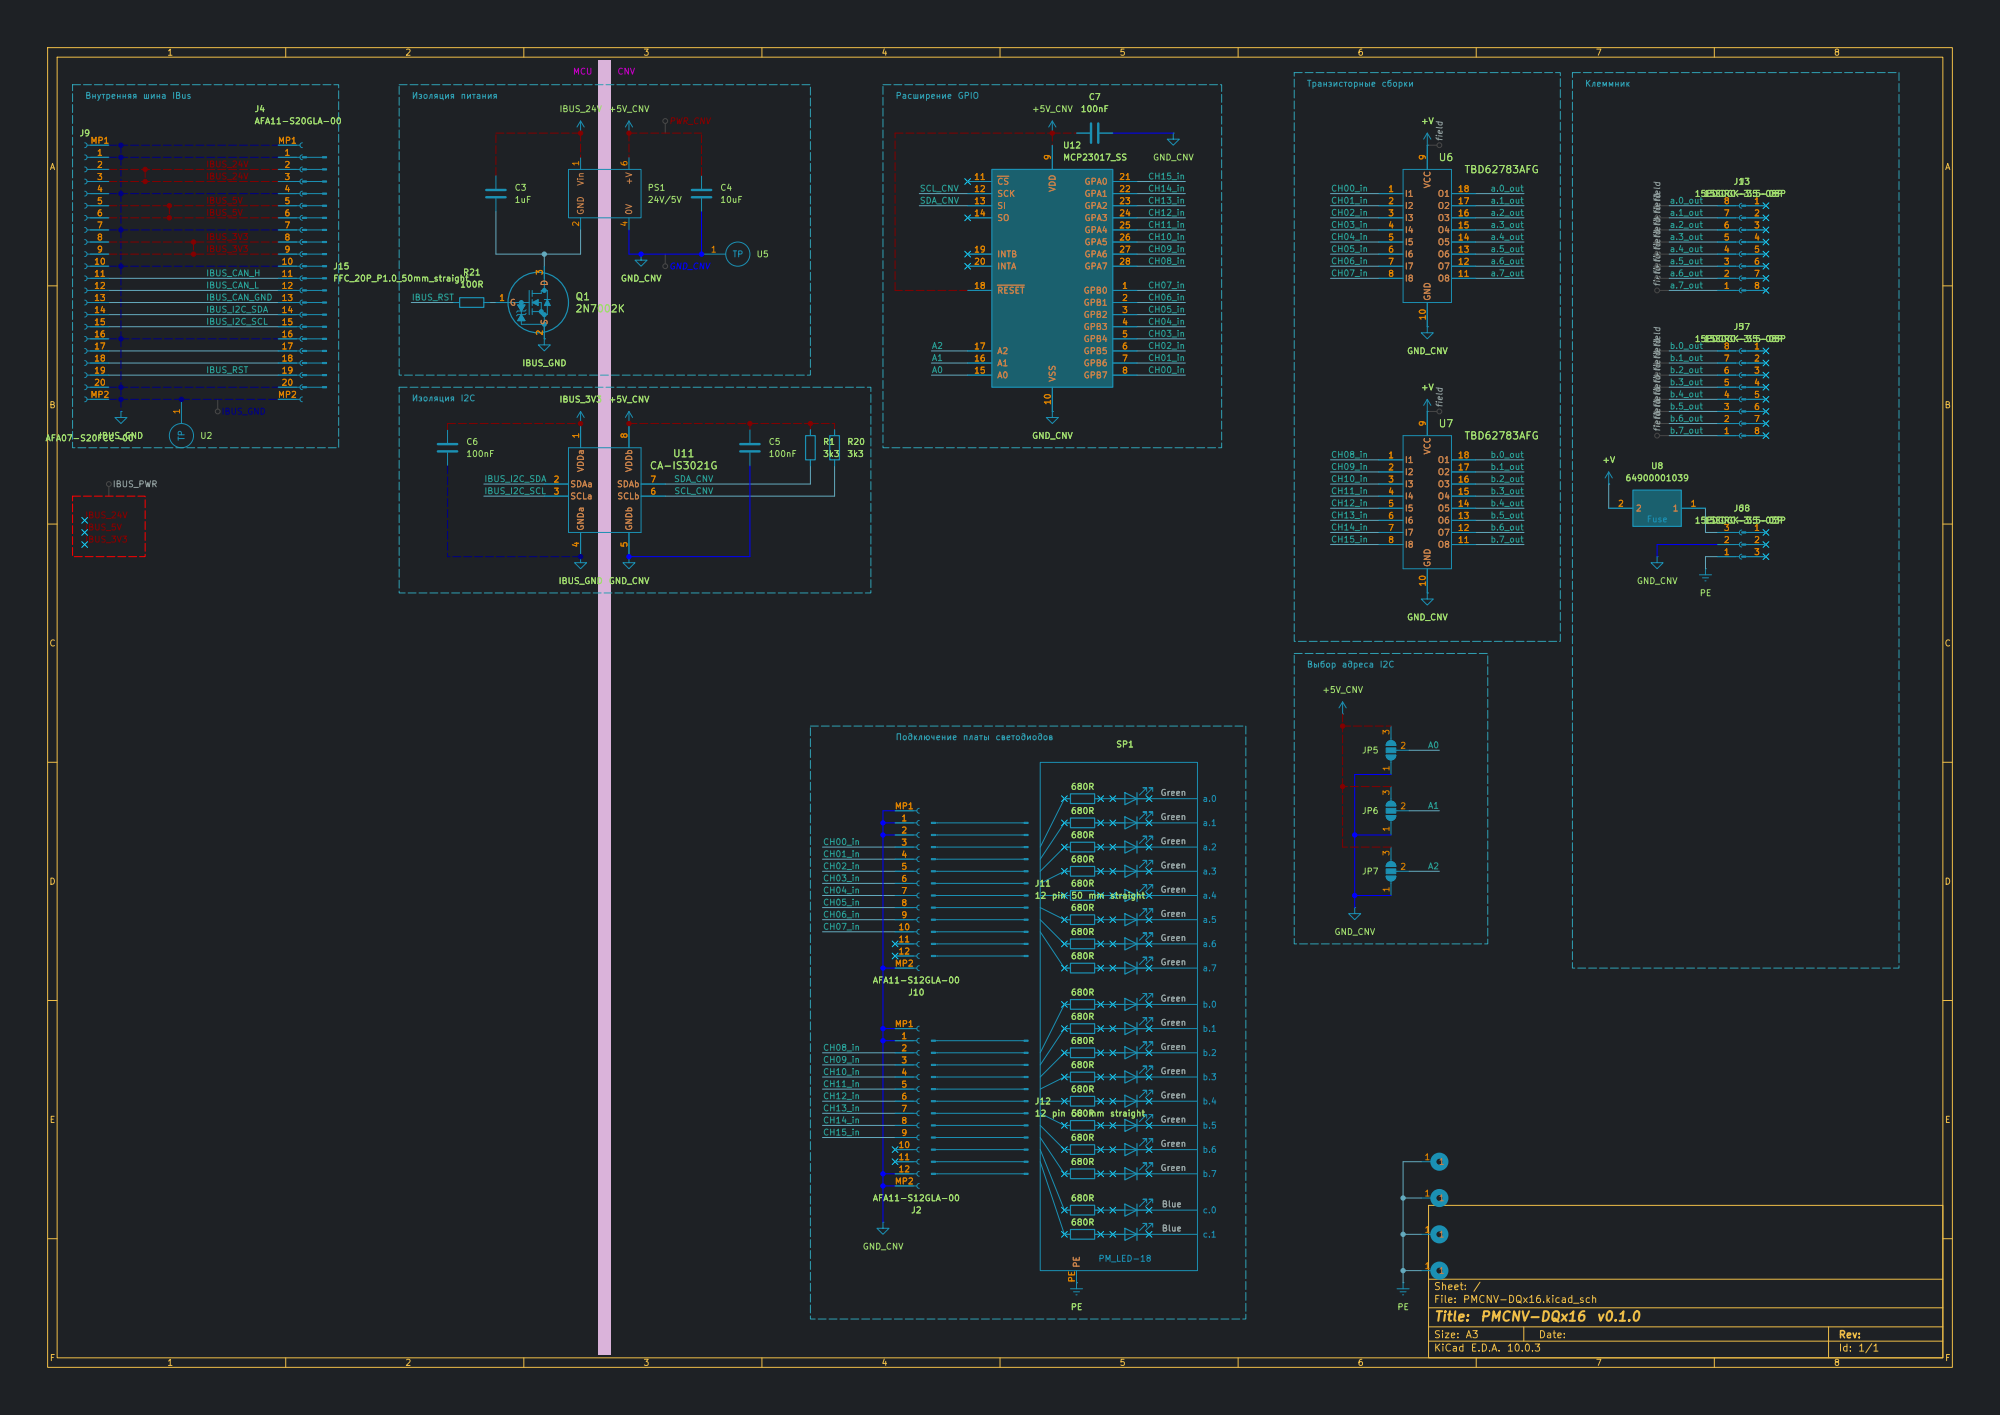
[picture p102: page 1]

9 GND 10 O8 11 O7 12 O6 13 O5 14 O4 15 O3 16 O2 17 O1 18 Green Green Green 680R

Size: A3 | Rev: | F Date:
KiCad E.D.A. 10.0.3 | Id: 1/1
