Konstantin-Dudersky/plc-modules/pcb/PMCNV-DIx32-v0.1.0/export/v0.1.0/PMCPU-ESP32C3.pdf

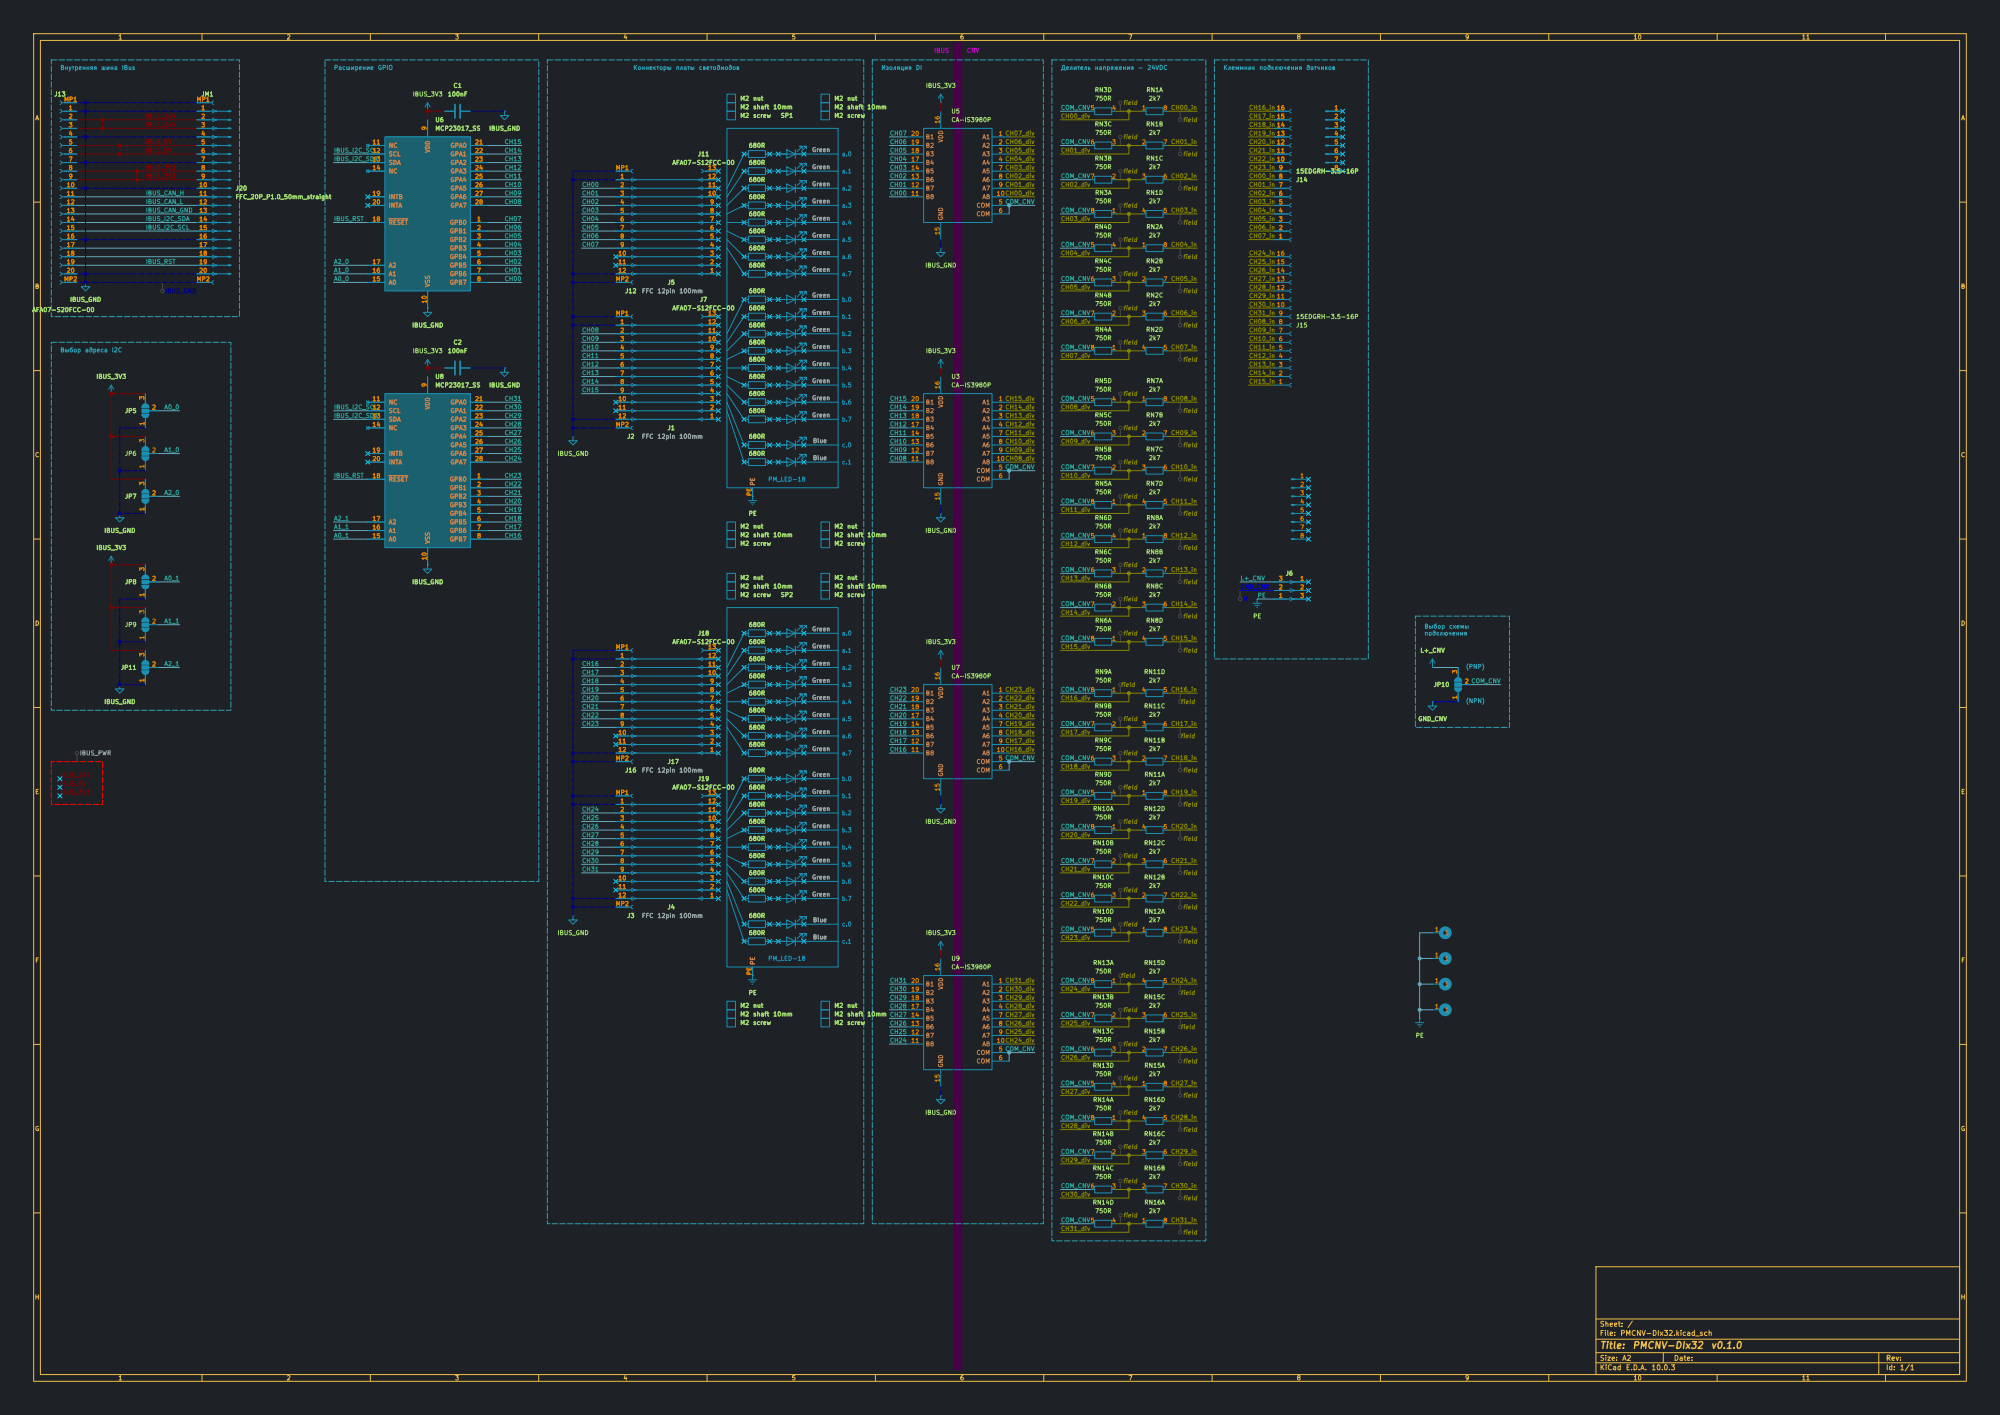
[picture p103: page 1]

Green Green Green M2 screw

Green Green Green Green Green Green Green Green Green 680R

Green Blue Green Blue 680R

Size: A2 | Rev:
KiCad E.D.A. 10.0.3 | Id: 1/1
