Konstantin-Dudersky/plc-modules/pcb/PMCNV-AI8T-v0.1.0/export/v0.1.0/PMCNV-AI8T.pdf

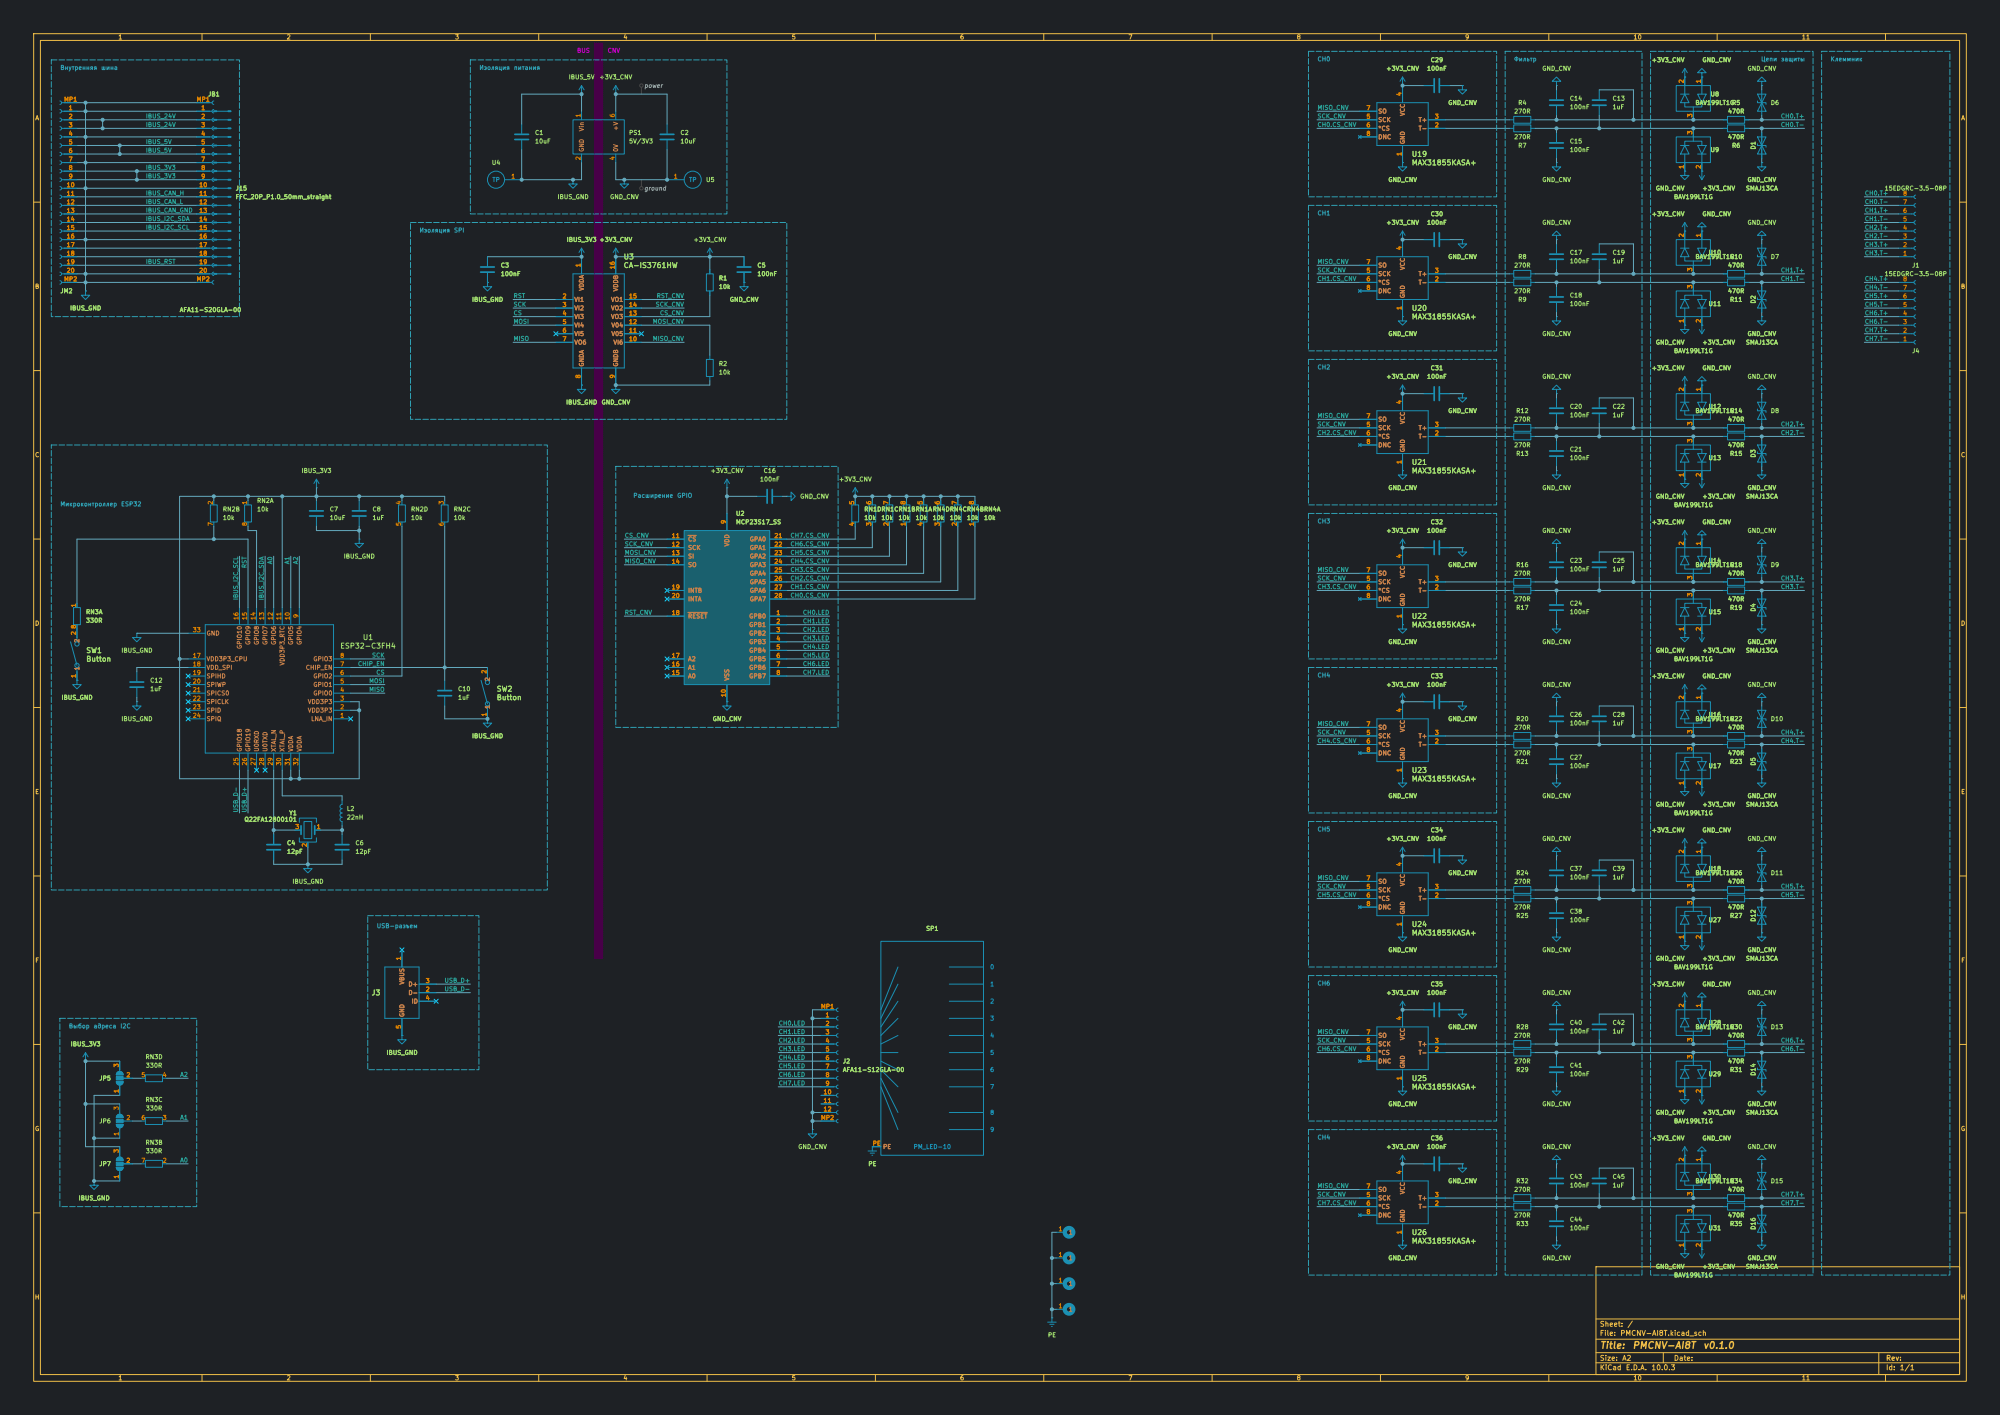
[picture p112: page 1]

Size: A2 | Rev:
KiCad E.D.A. 10.0.3 | Id: 1/1
