Konstantin-Dudersky/plc-modules/pcb/PMCNV-AI8T-v0.1.0/export/v0.1.0/PMCPU-ESP32C3.pdf

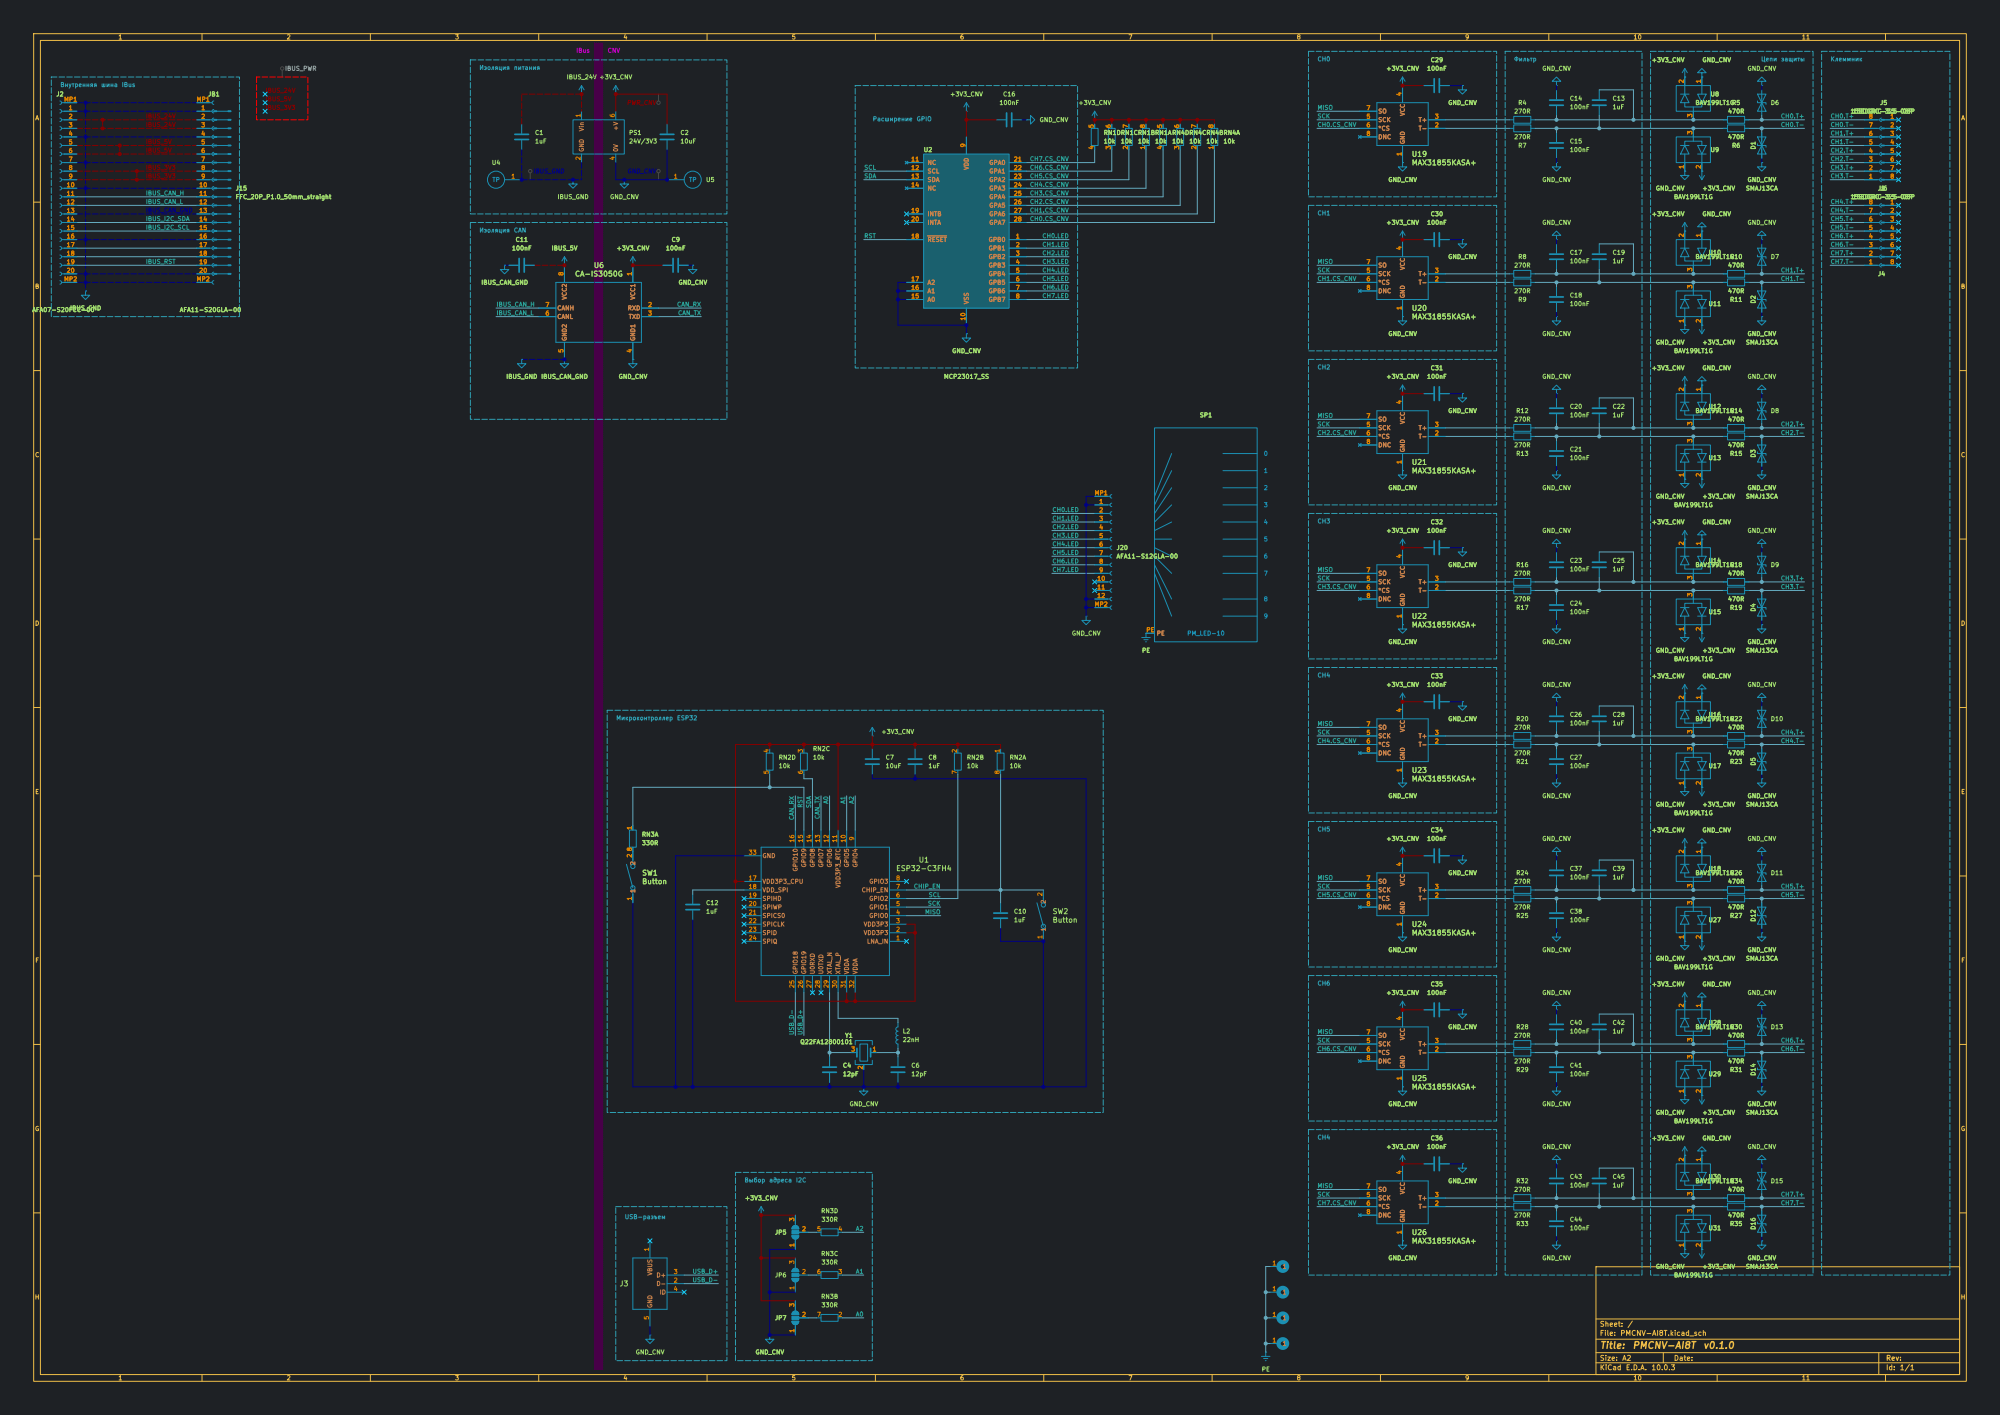
[picture p113: page 1]

Микроконтроллер ESP32

VDD3P3_CPU 17

Size: A2 | Rev:
KiCad E.D.A. 10.0.3 | Id: 1/1
