Konstantin-Dudersky/plc-modules/pcb/PMCPU-ESP32C3-v0.1.0/export/v0.1.0/PMCPU-ESP32C3.pdf

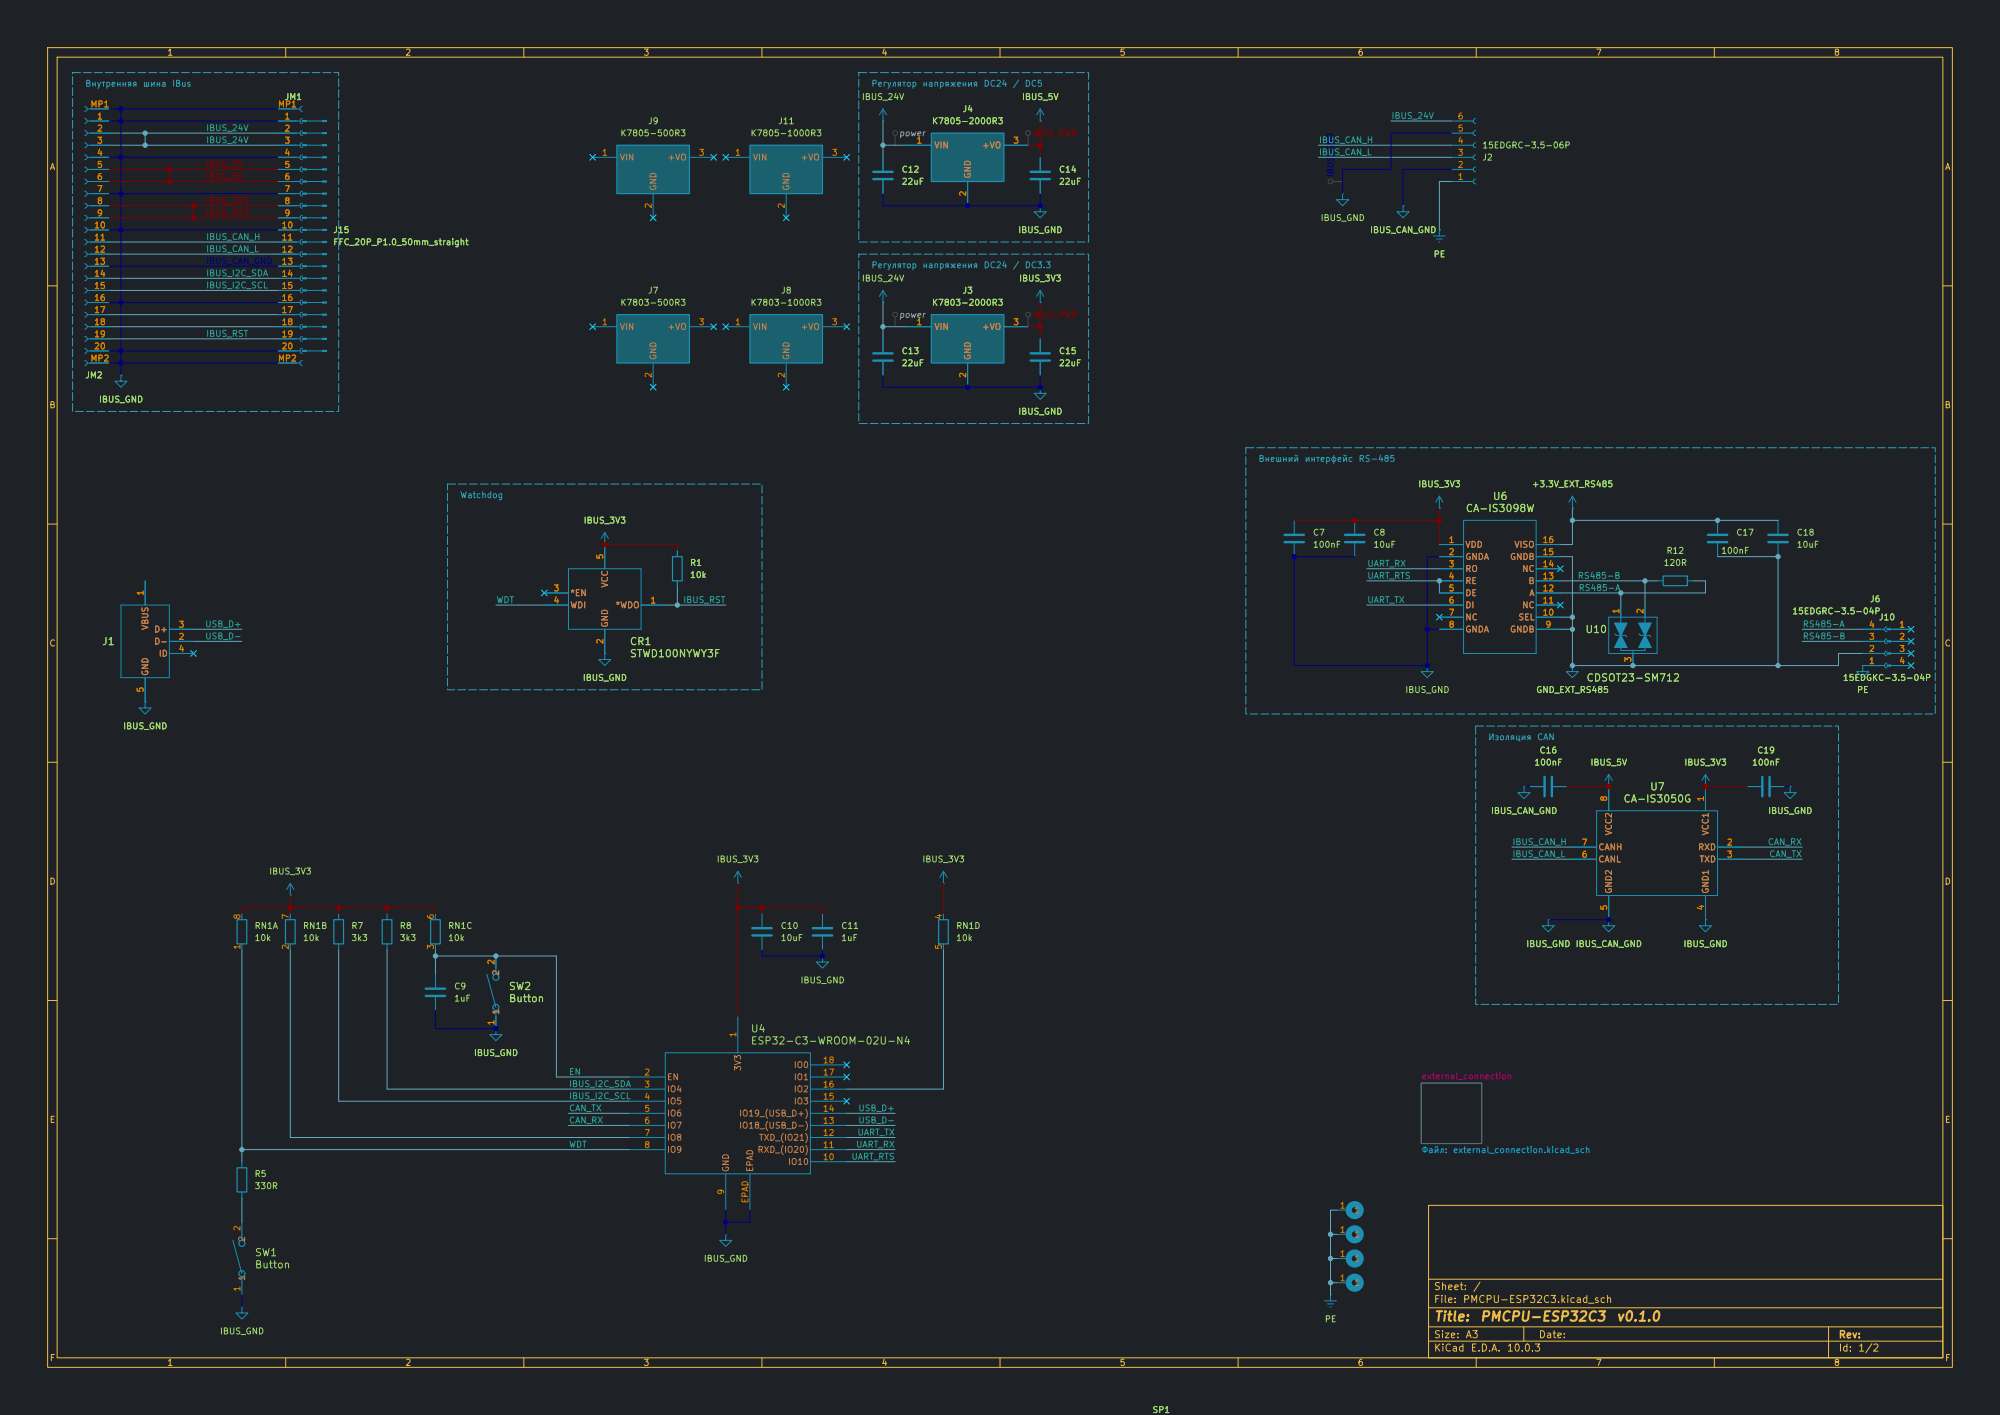
[picture p114: page 1]

Size: A3 | Rev: | F Date:
KiCad E.D.A. 10.0.3 | Id: 1/2

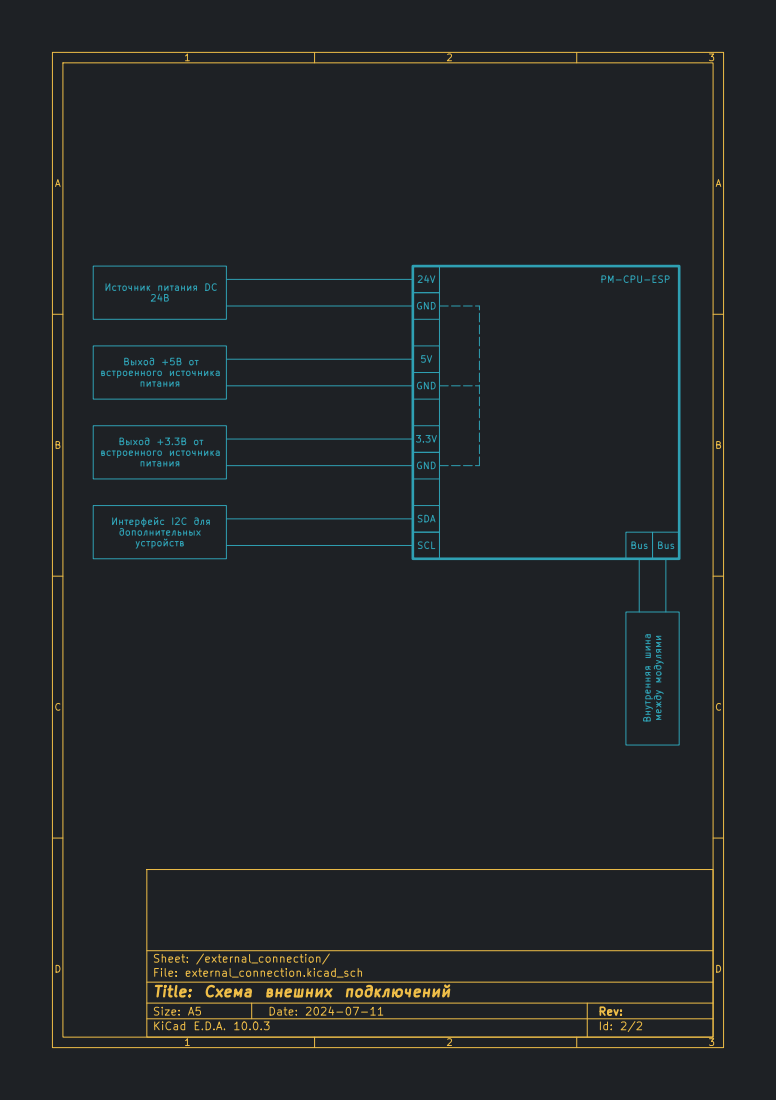
[picture p115: page 2]

Выход +5В от встроенного источника

питания Выход +3.3В от встроенного источника

питания Интерфейс I2C для дополнительных

Sheet: /external_connection/
File: external_connection.kicad_sch
Title: Схема внешних подключений

Size: A5 | Rev:
KiCad E.D.A. 10.0.3 | Id: 2/2
