Konstantin-Dudersky/plc-modules/pcb/PMCPU-LLP-v0.1.0/export/v0.1.0/PMCPU-ESP32C3.pdf

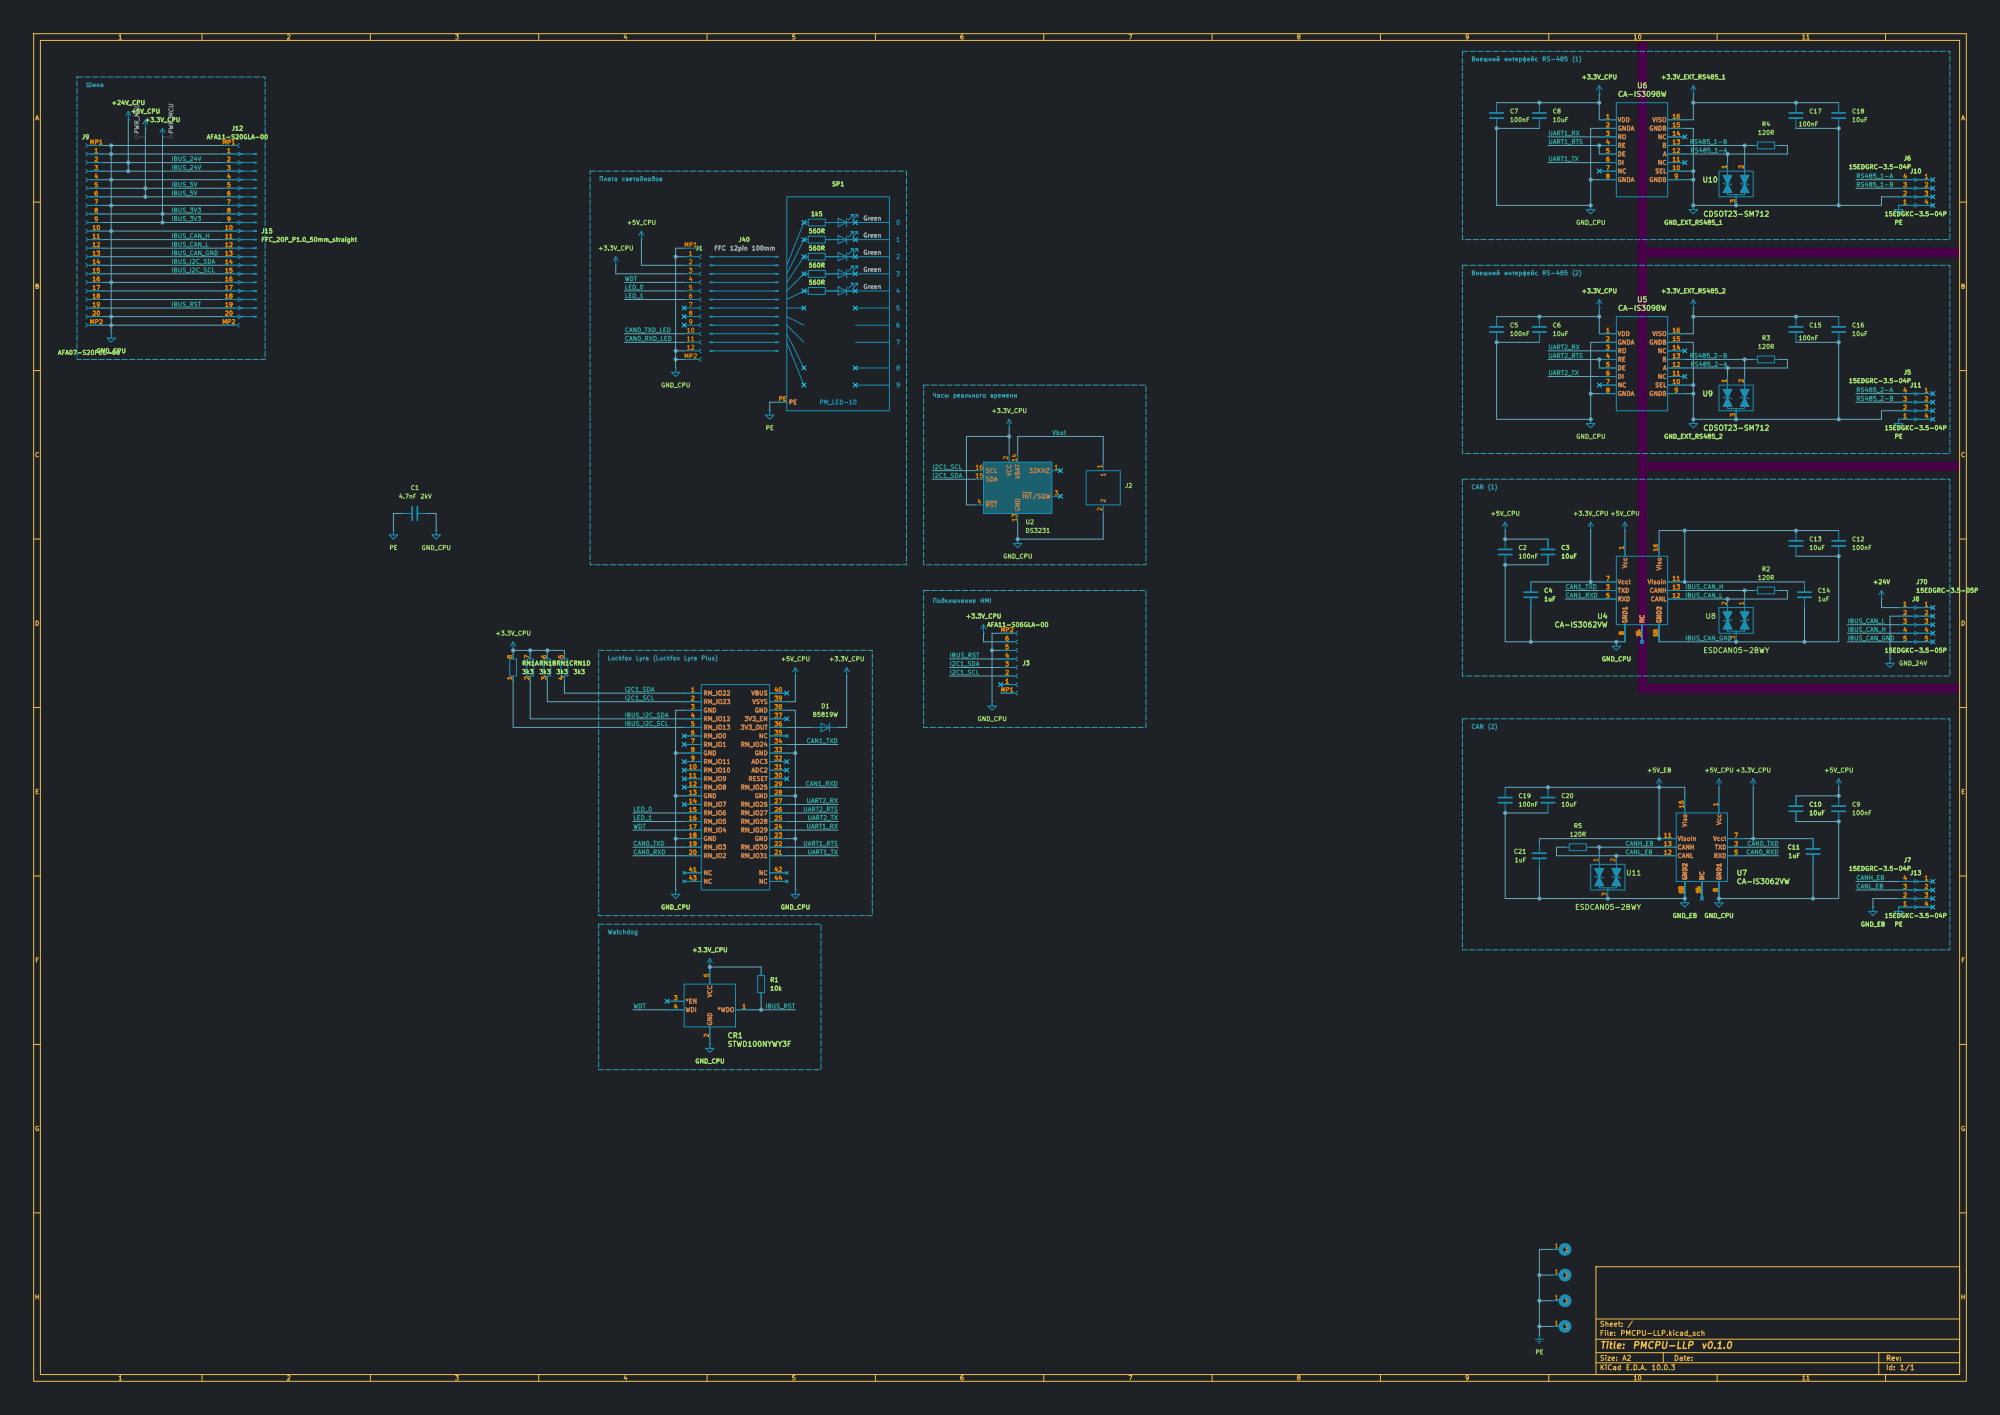
[picture p116: page 1]

CAN (2) Luckfox Lyra (Luckfox Lyra Plus)

Size: A2 | Rev:
KiCad E.D.A. 10.0.3 | Id: 1/1
