Konstantin-Dudersky/plc-modules/pcb/PMCPU-LLP-v0.1.0/export/v0.1.0/PMCPU-LLP.pdf

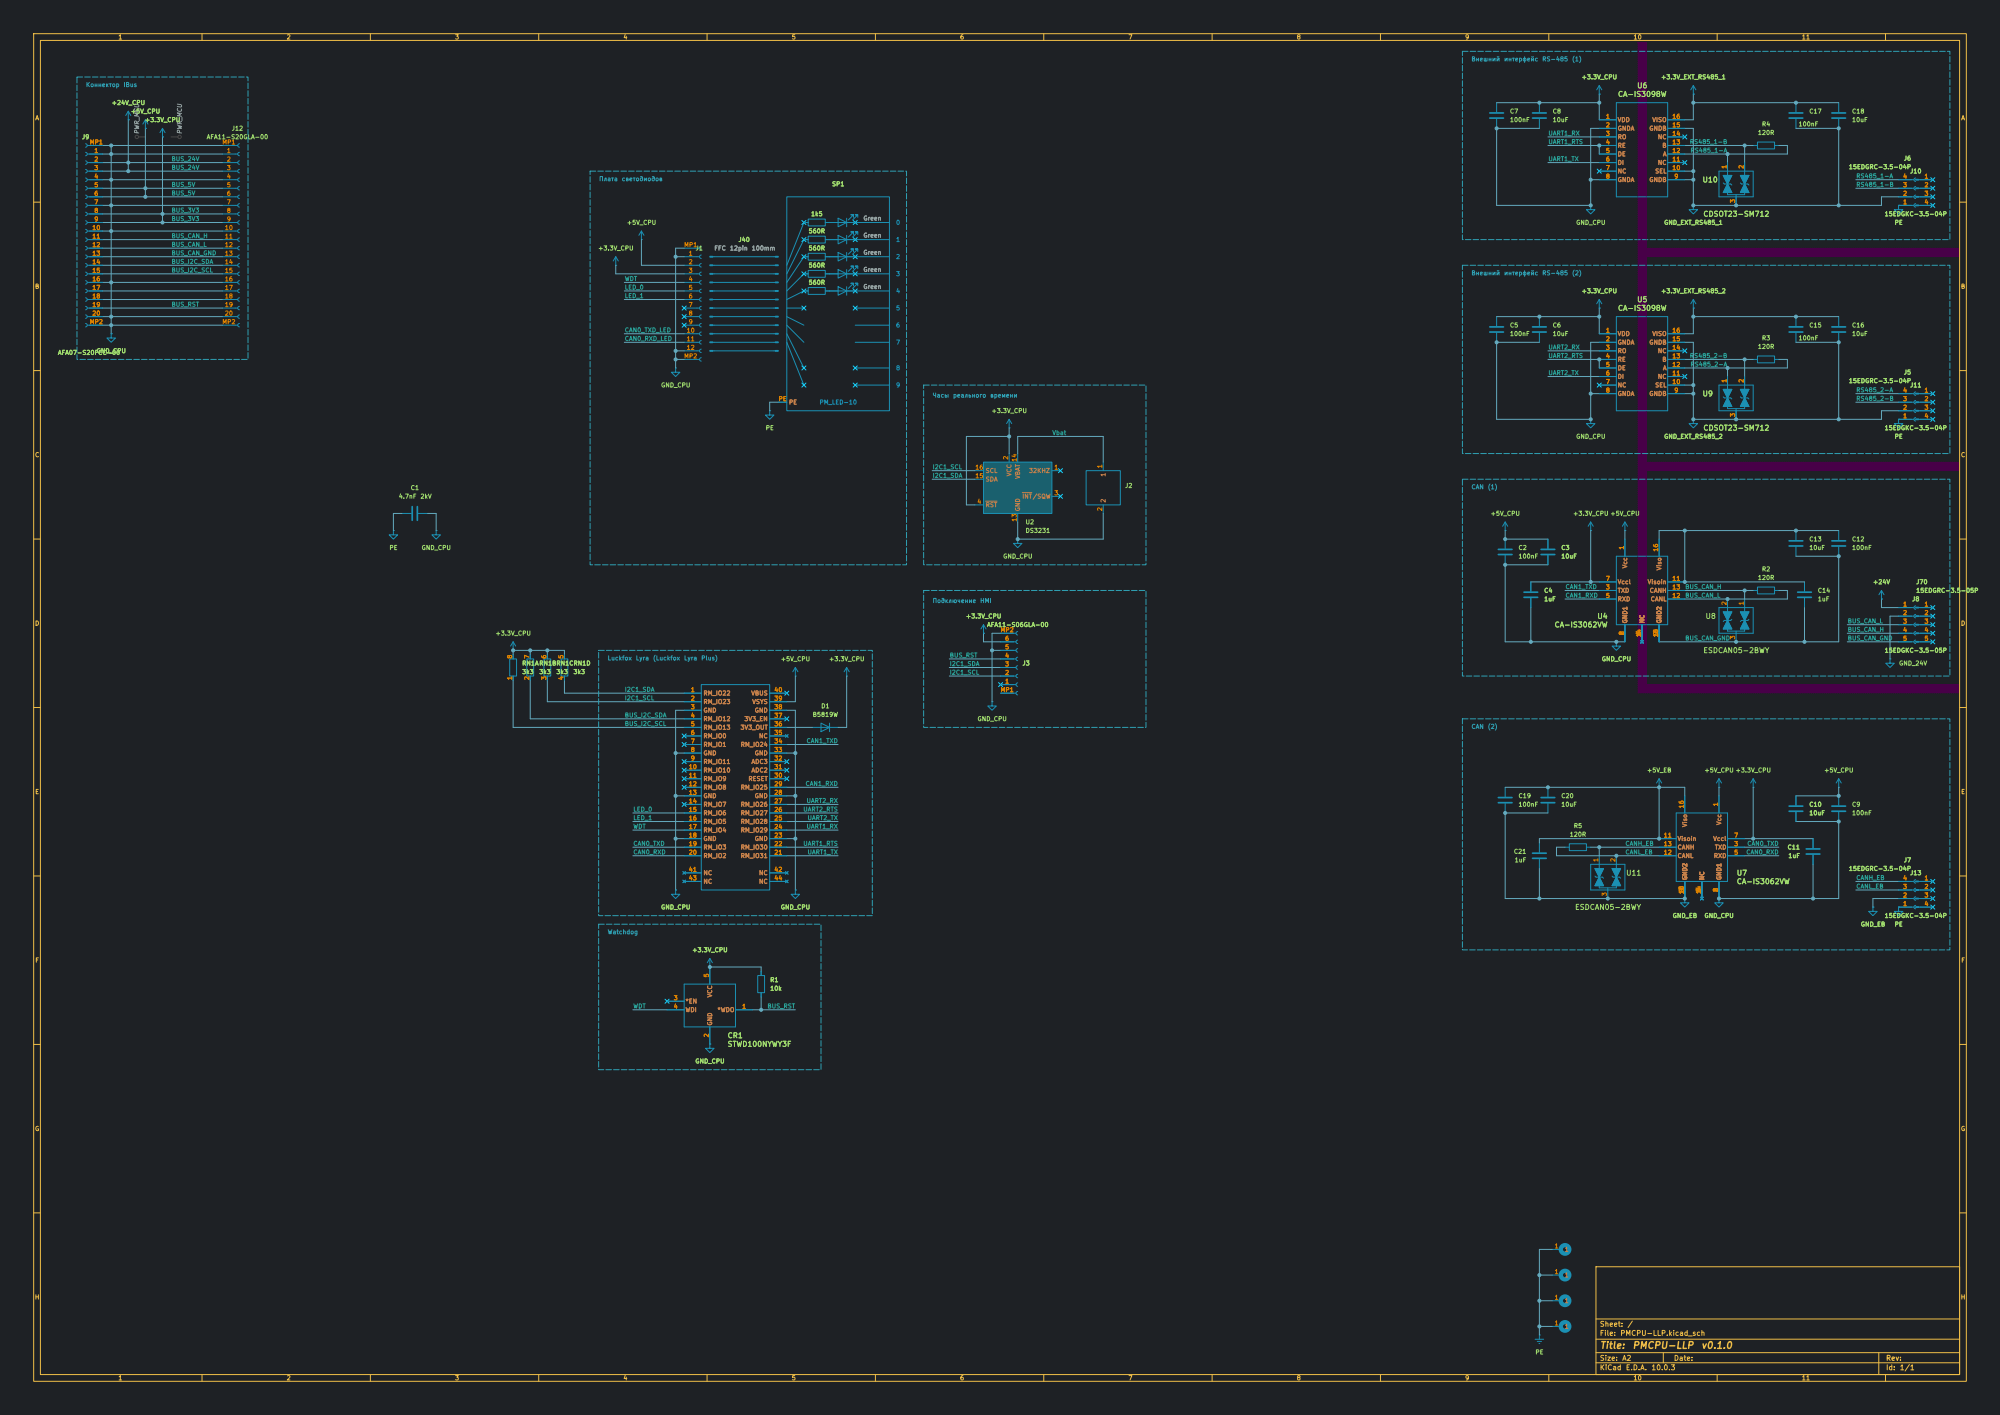
[picture p117: page 1]

Внешний интерфейс RS-485 (1) Часы реального времени Подключение HMI

Коннектор IBus 20 MP1 MP2GND_CPU +24V_CPU

Size: A2 | Rev:
KiCad E.D.A. 10.0.3 | Id: 1/1
