Konstantin-Dudersky/plc-modules/pcb/PMPS-20W-v0.1.0/export/v0.1.0/PMPS-20W.pdf

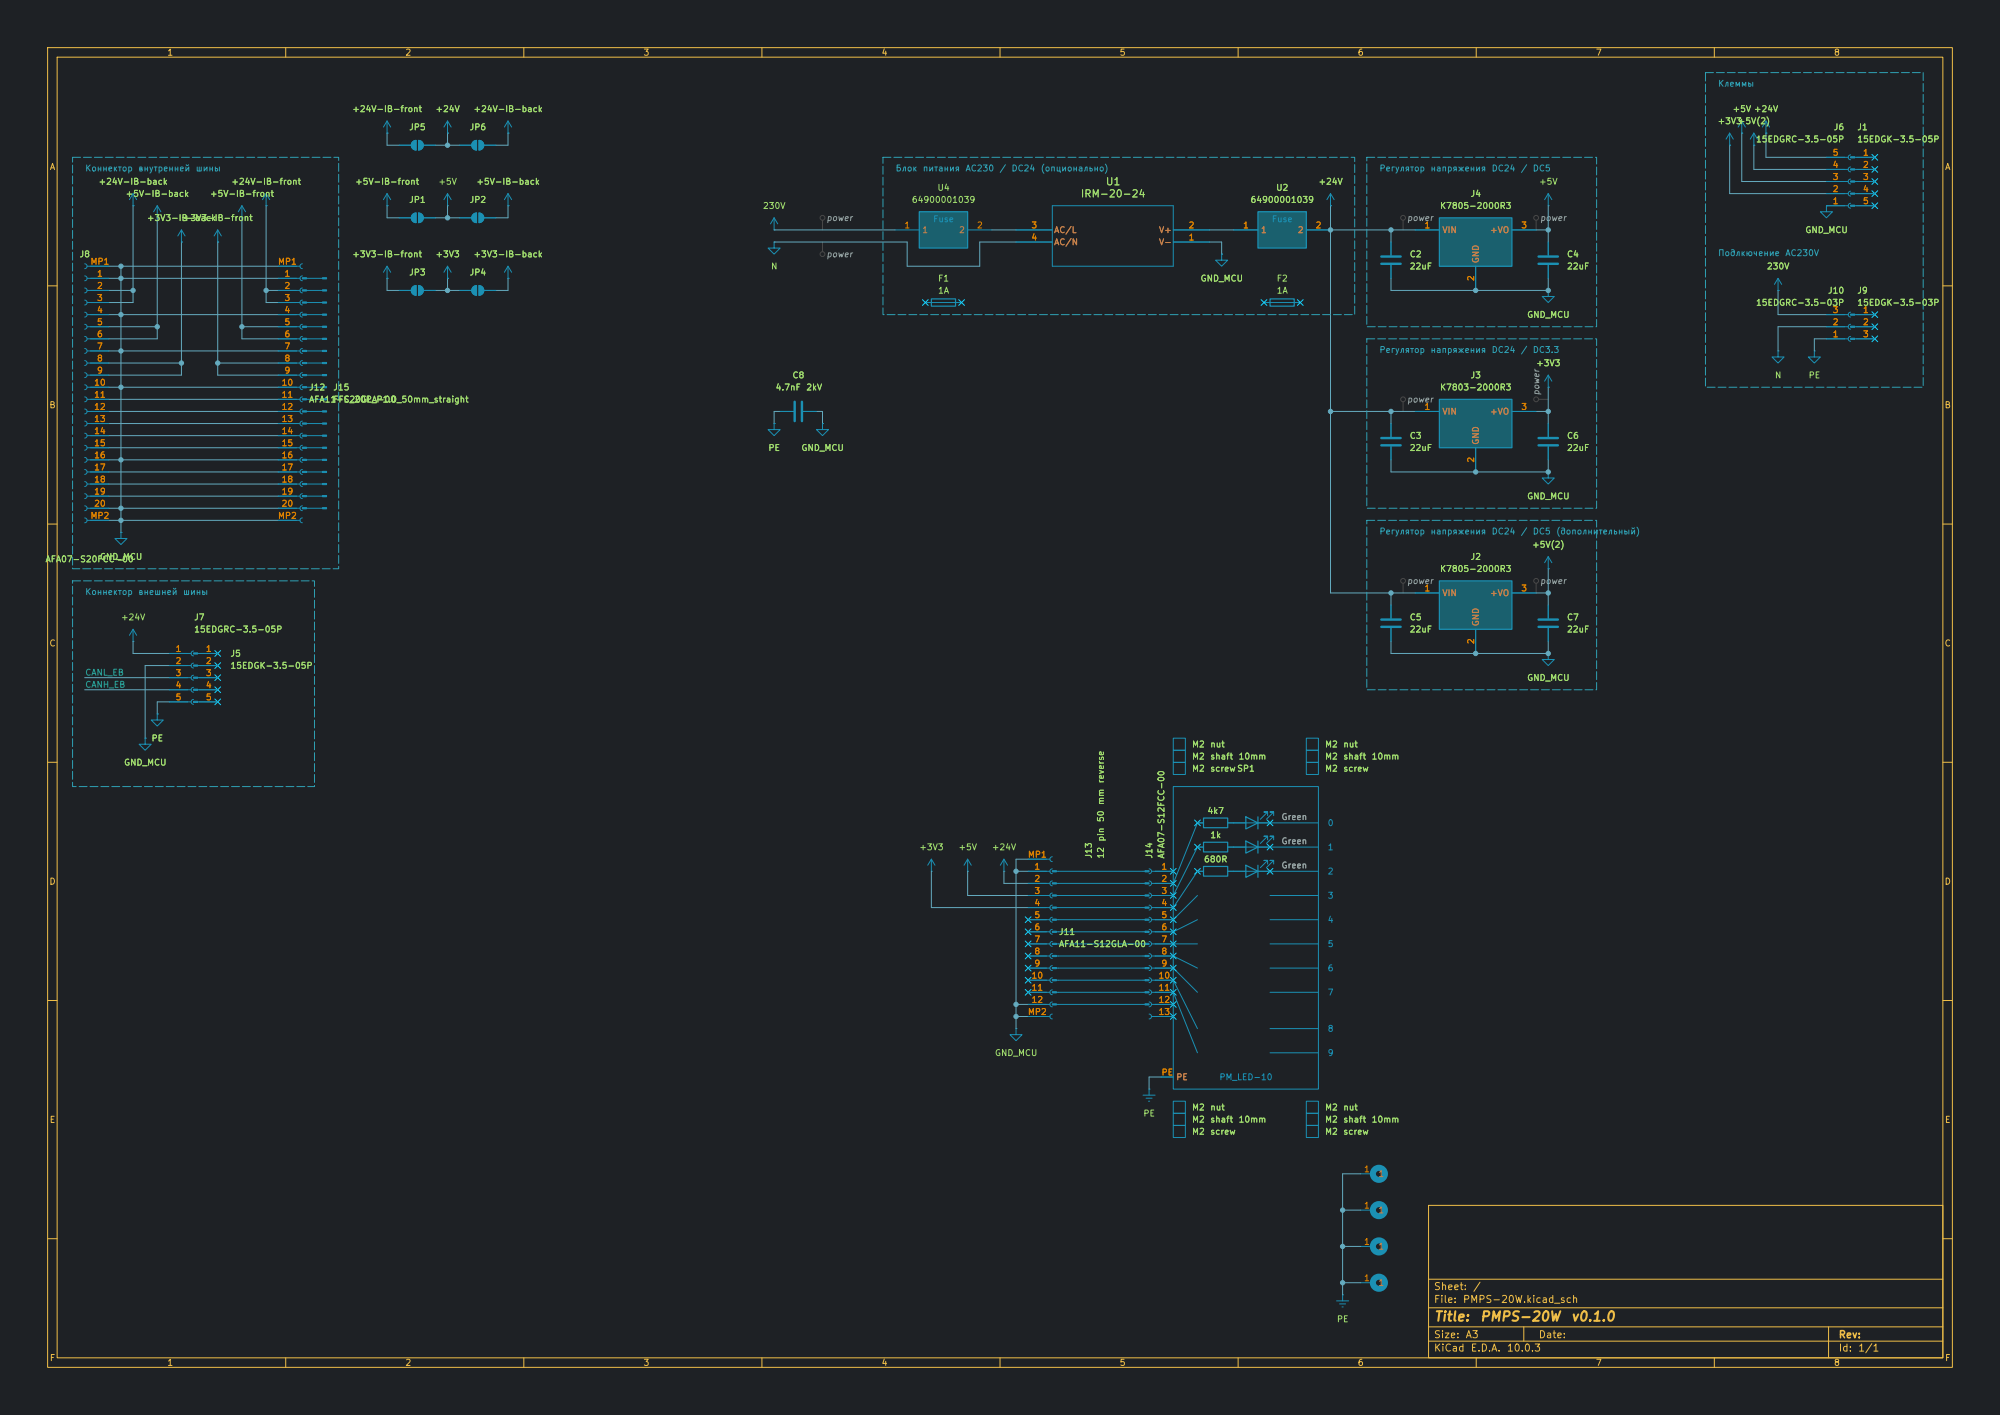
[picture p118: page 1]

JP2+24V-IB-back +3V3-IB-front +5V-IB-front JP1

Регулятор напряжения DC24 / DC3.3 Коннектор внутренней шины

Регулятор напряжения DC24 / DC5 Регулятор напряжения DC24 / DC5 (дополнительный)

M2 nut 4k7 M2 screw M2 nut M2 shaft 10mm
M2 shaft 10mm

Size: A3 | Rev:
KiCad E.D.A. 10.0.3 | Id: 1/1 | F Date:
