Konstantin-Dudersky/plc-modules/pcb/PMCPU-RP-v0.0.6/export/v0.0.5/PCB schematic/PM_CPU-RP.pdf

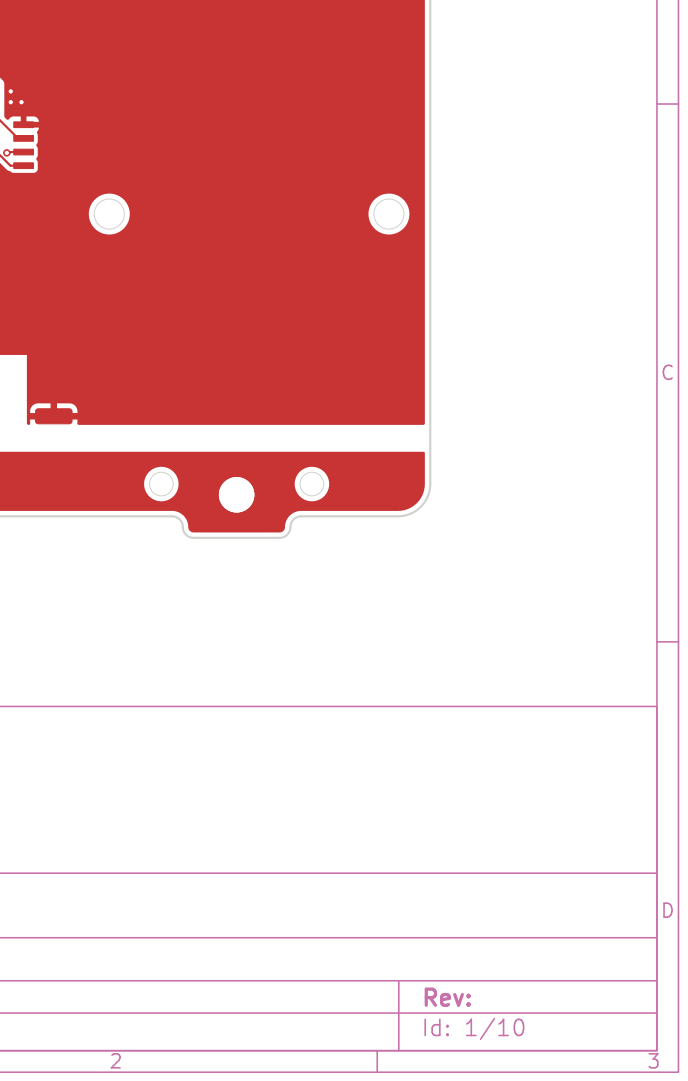
[picture p119: page 1]

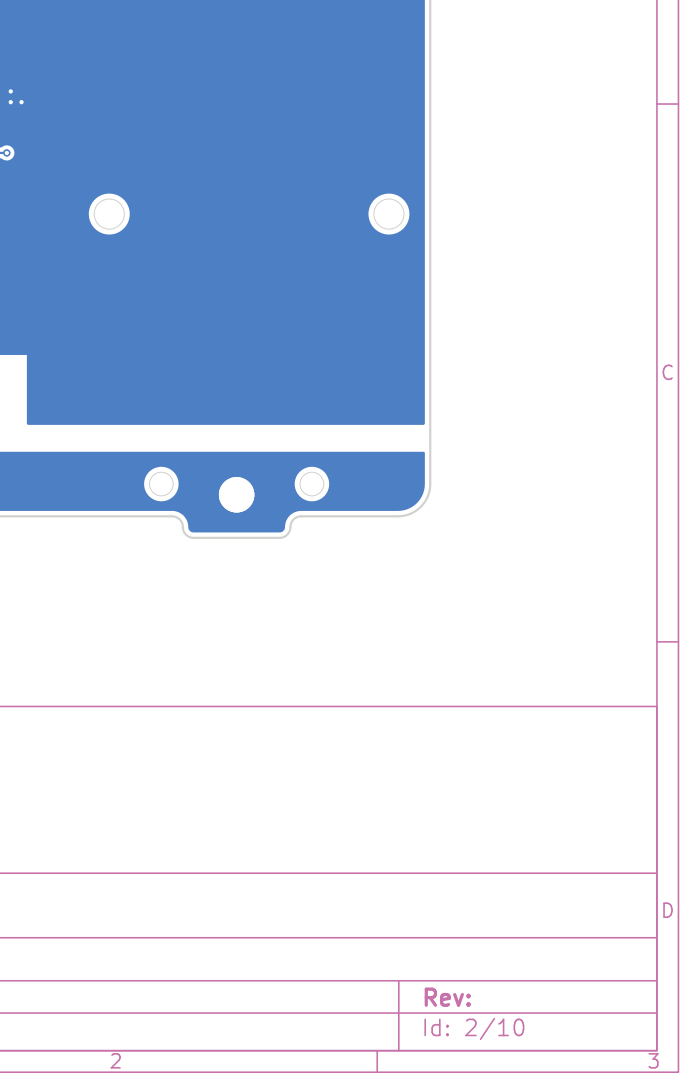
[picture p120: page 2]

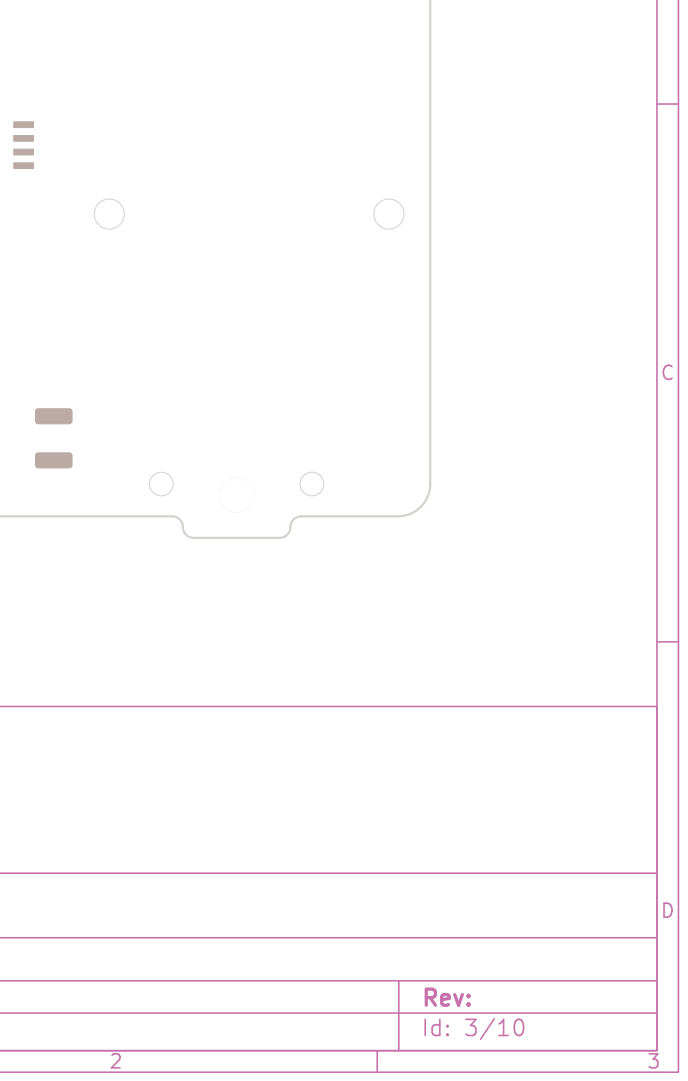
[picture p121: page 3]

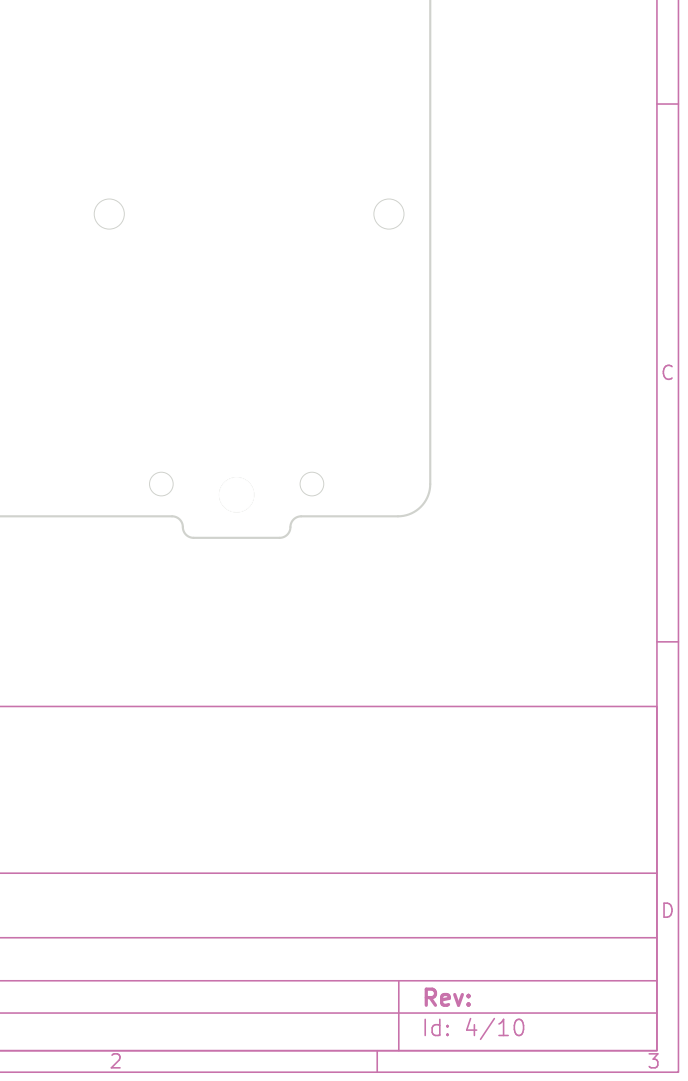
[picture p122: page 4]

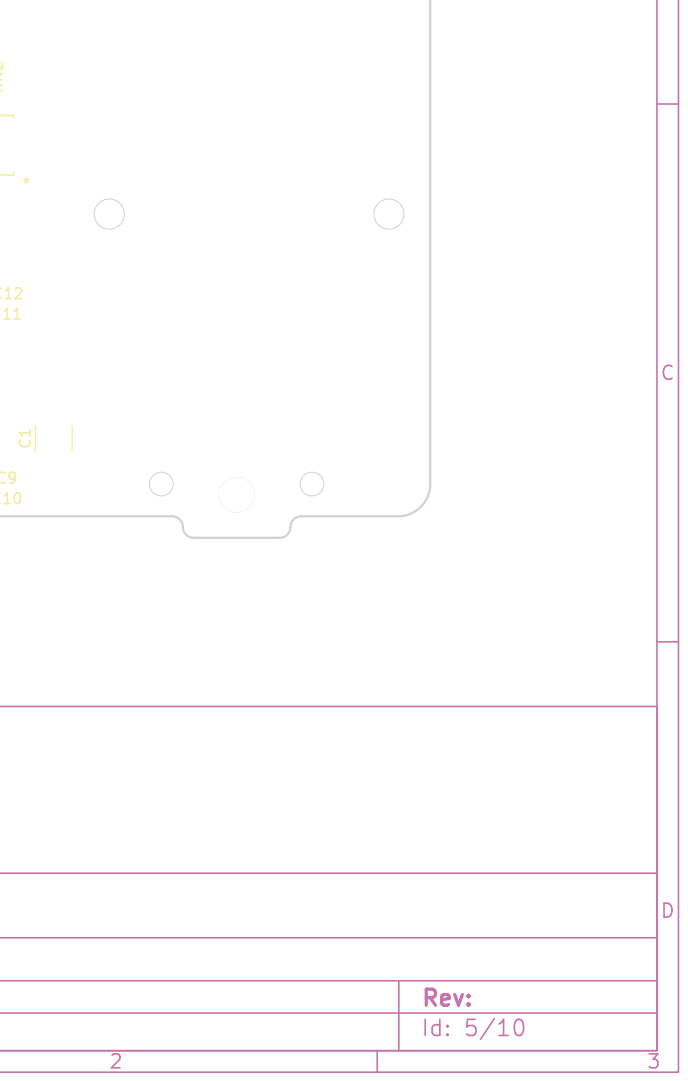
[picture p123: page 5]

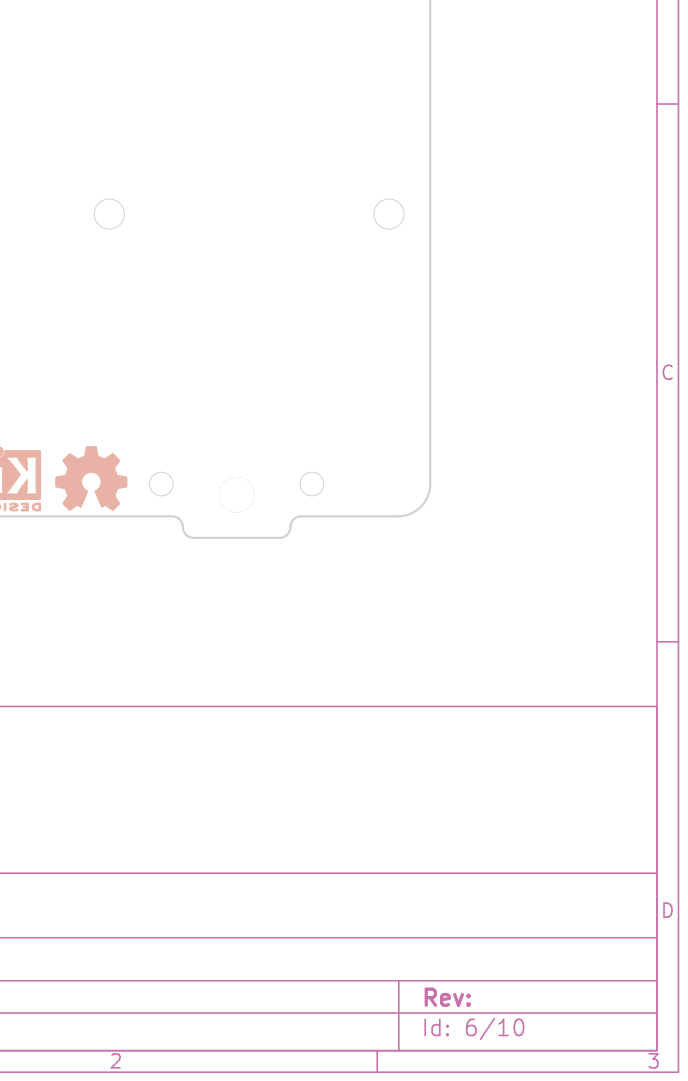
[picture p124: page 6]

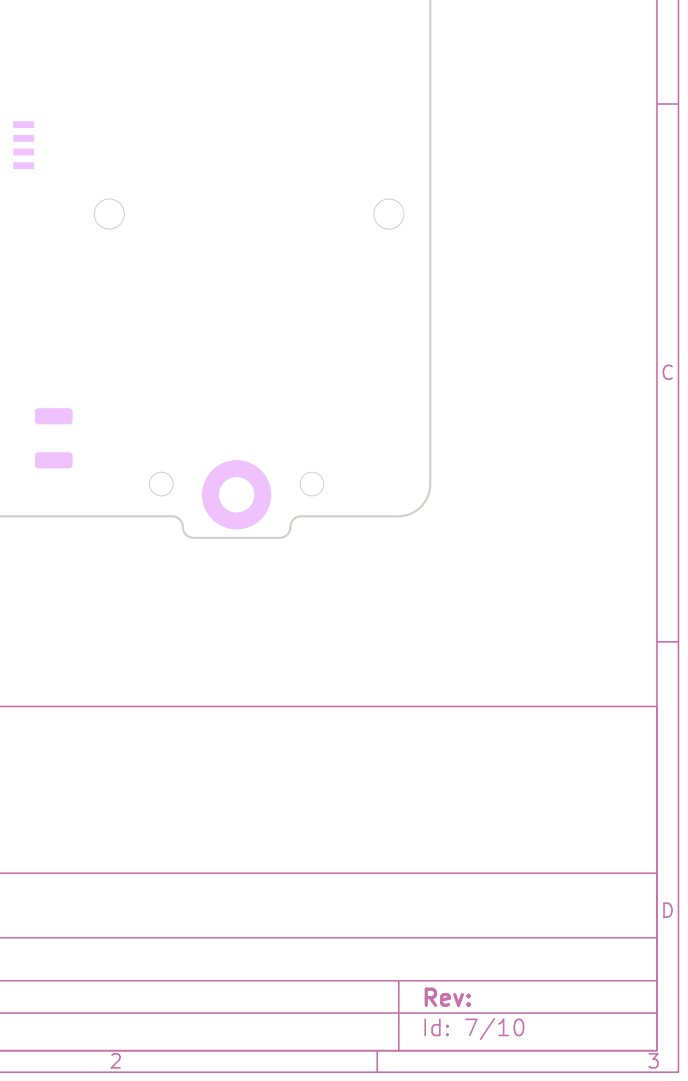
[picture p125: page 7]

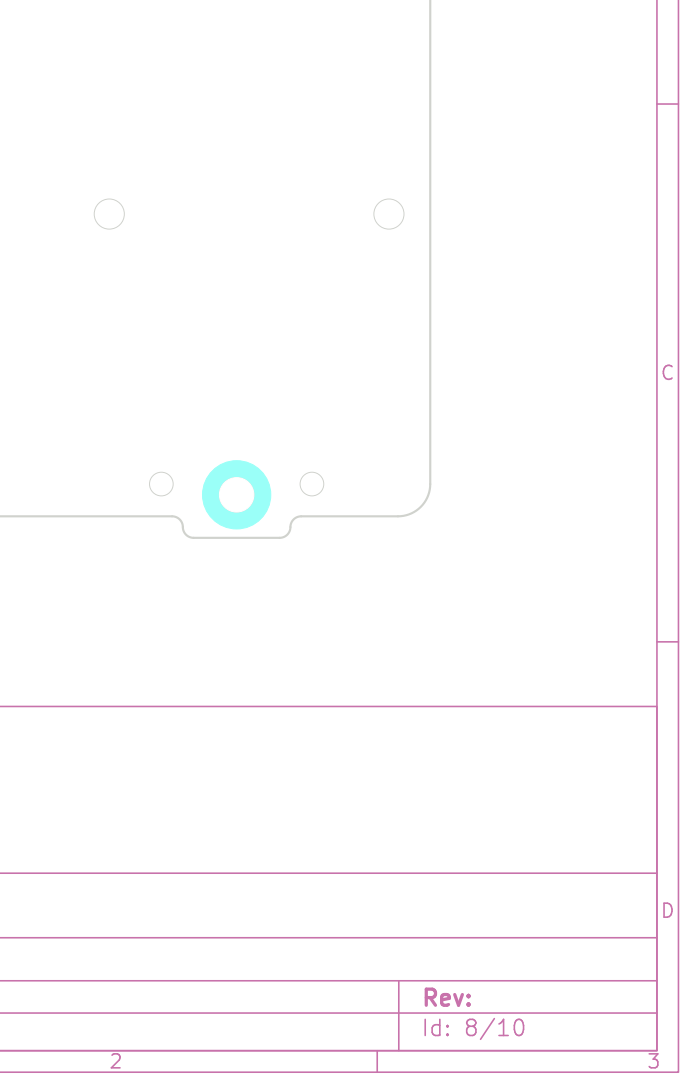
[picture p126: page 8]

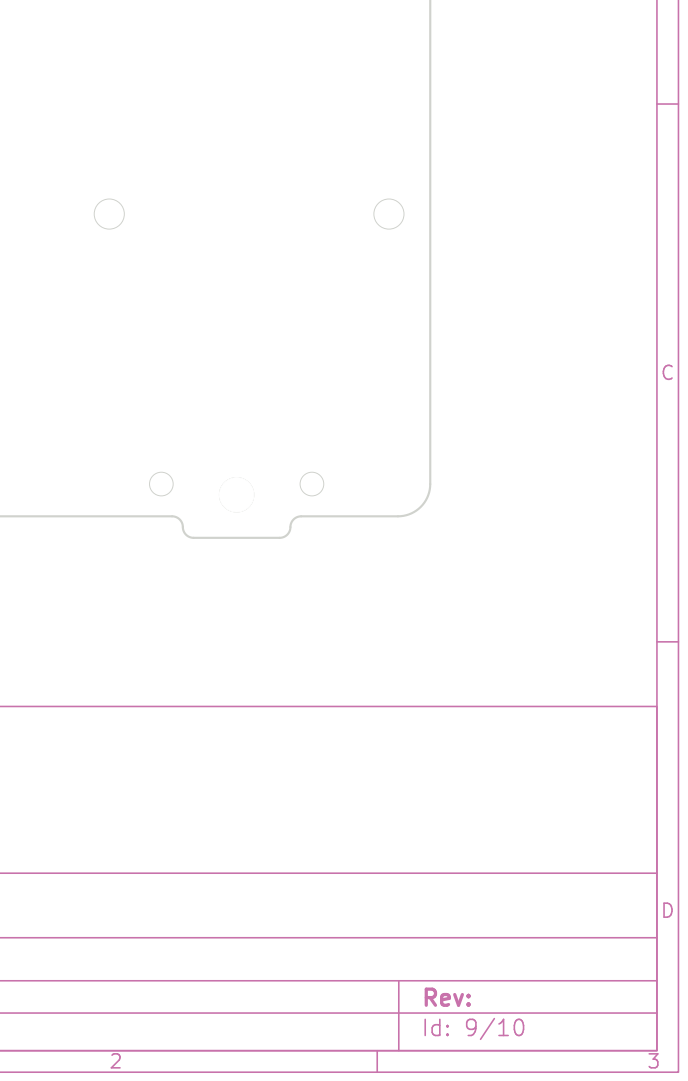
[picture p127: page 9]

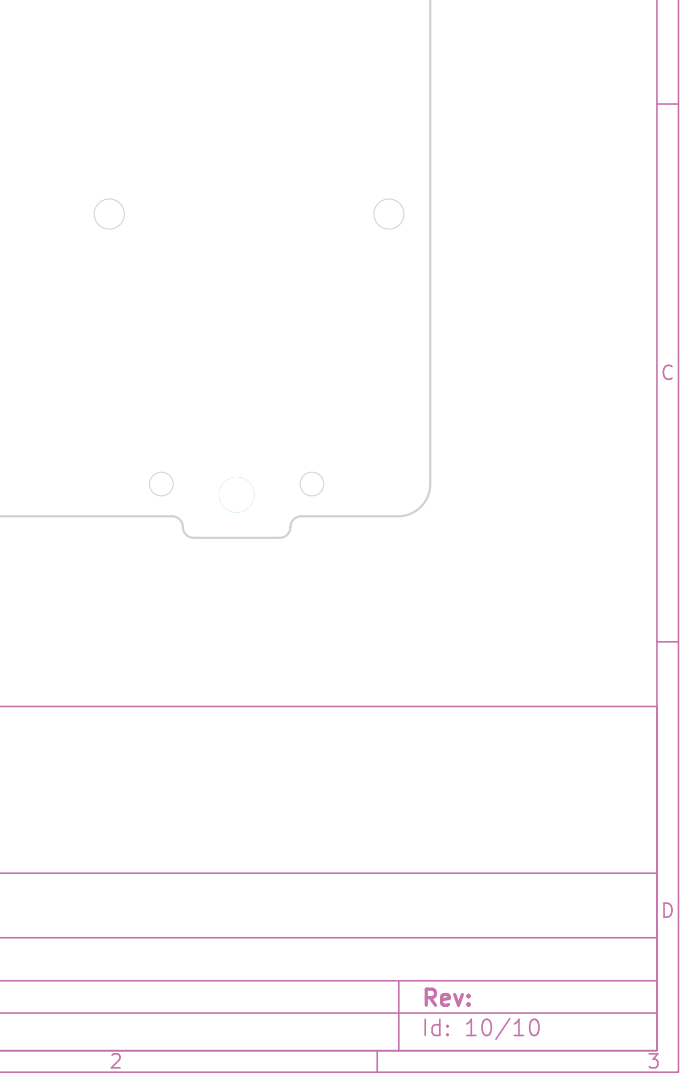
[picture p128: page 10]
