Konstantin-Dudersky/plc-modules/PM-DI16/doc/PM-DI16-base.pdf

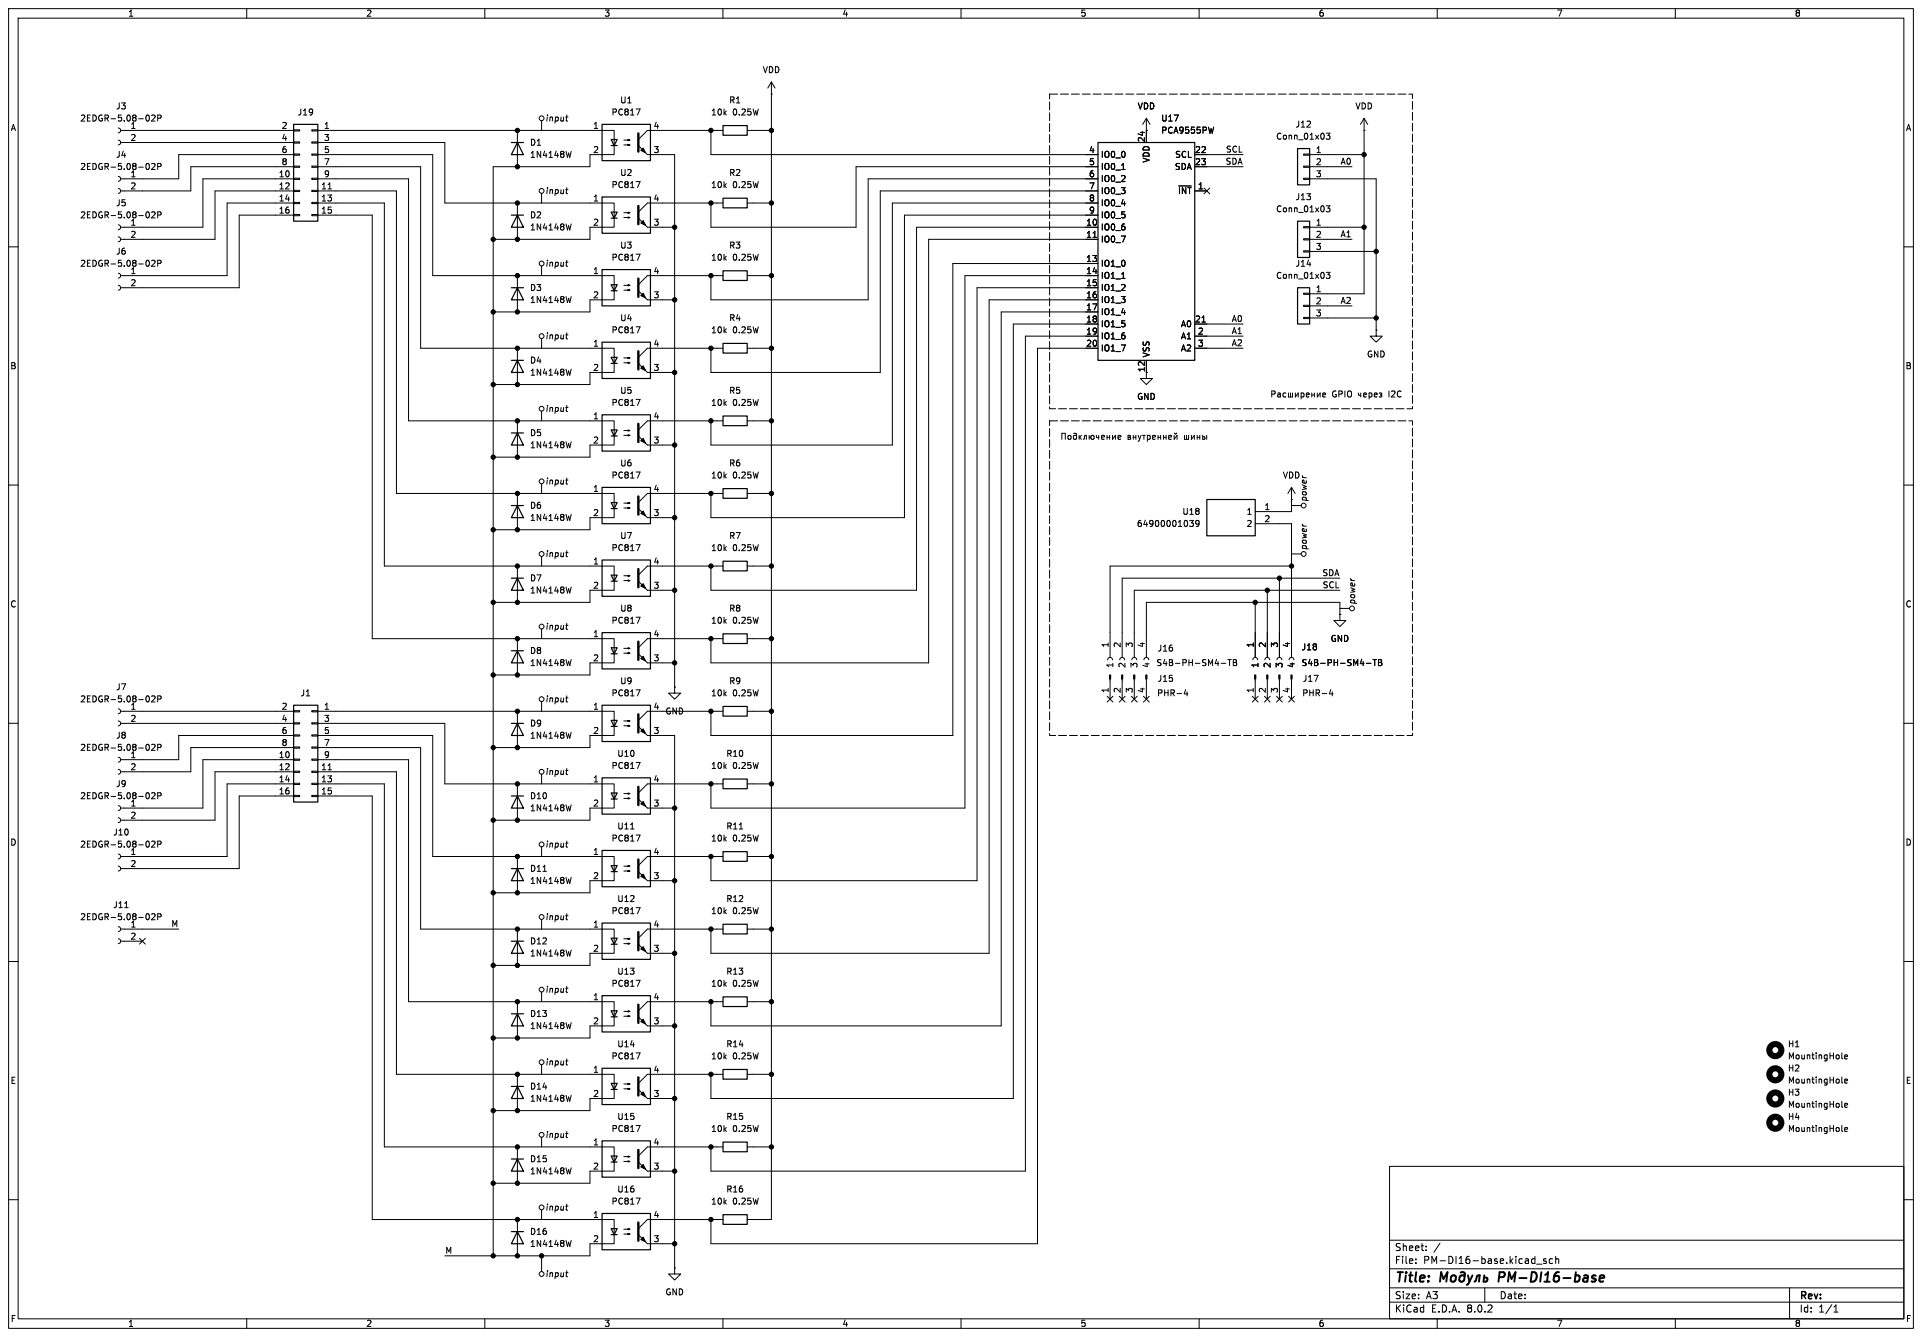
[picture p129: page 1]

Id: 1/1 Title: þÿ>4C;LPM-DI16-base
