Konstantin-Dudersky/plc-modules/pcb/PMCPU-ESP32C3-v0.1.0/doc/PM-CPU-ESP.pdf

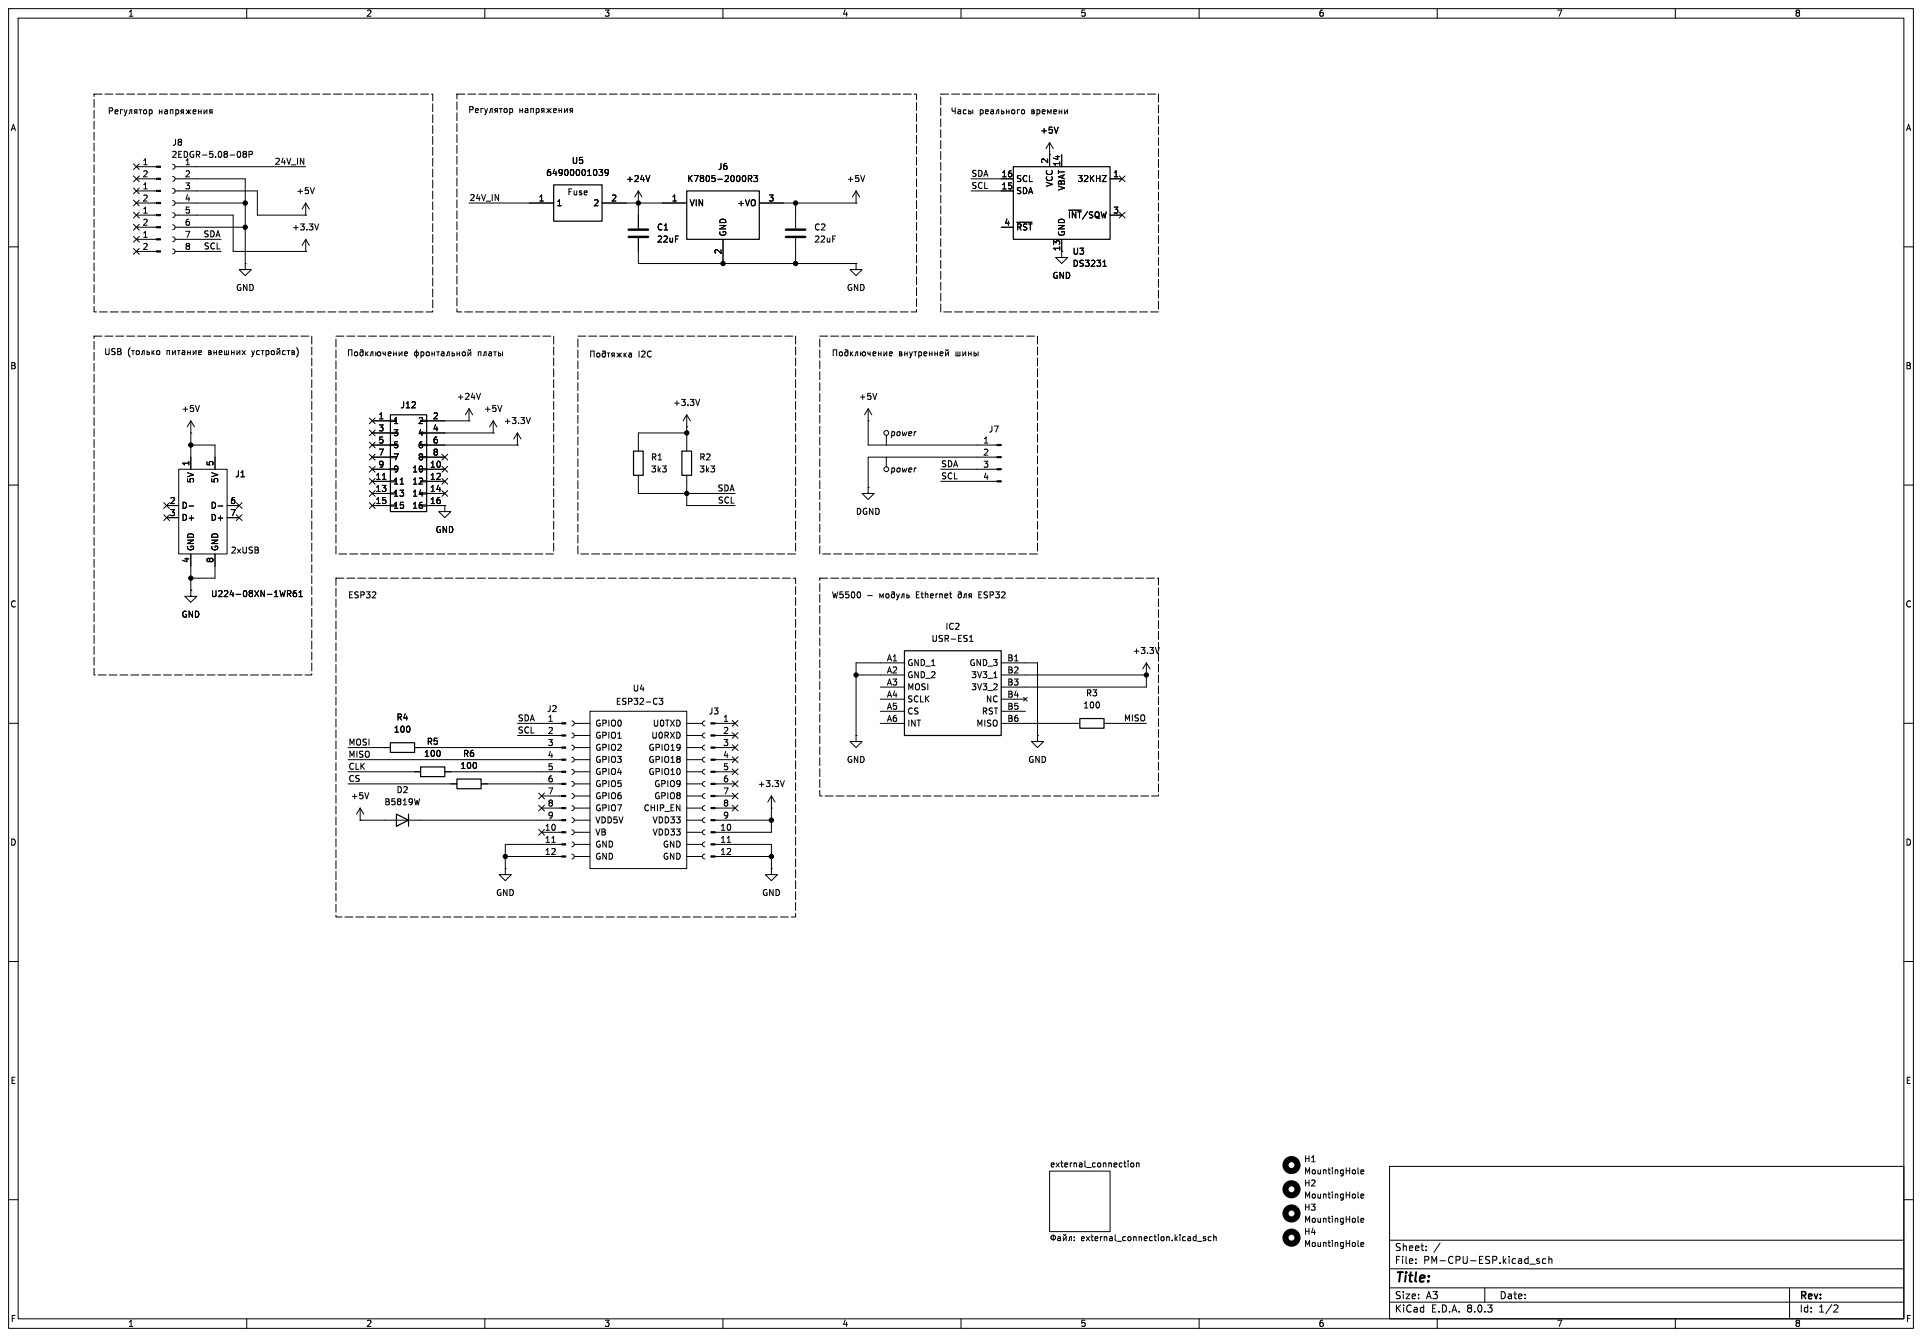
[picture p130: page 1]
