Konstantin-Dudersky/plc-modules/pcb/PMCNV-RQx8-v0.1.0/export/v0.0.8/PMCNV-RQx8.pdf

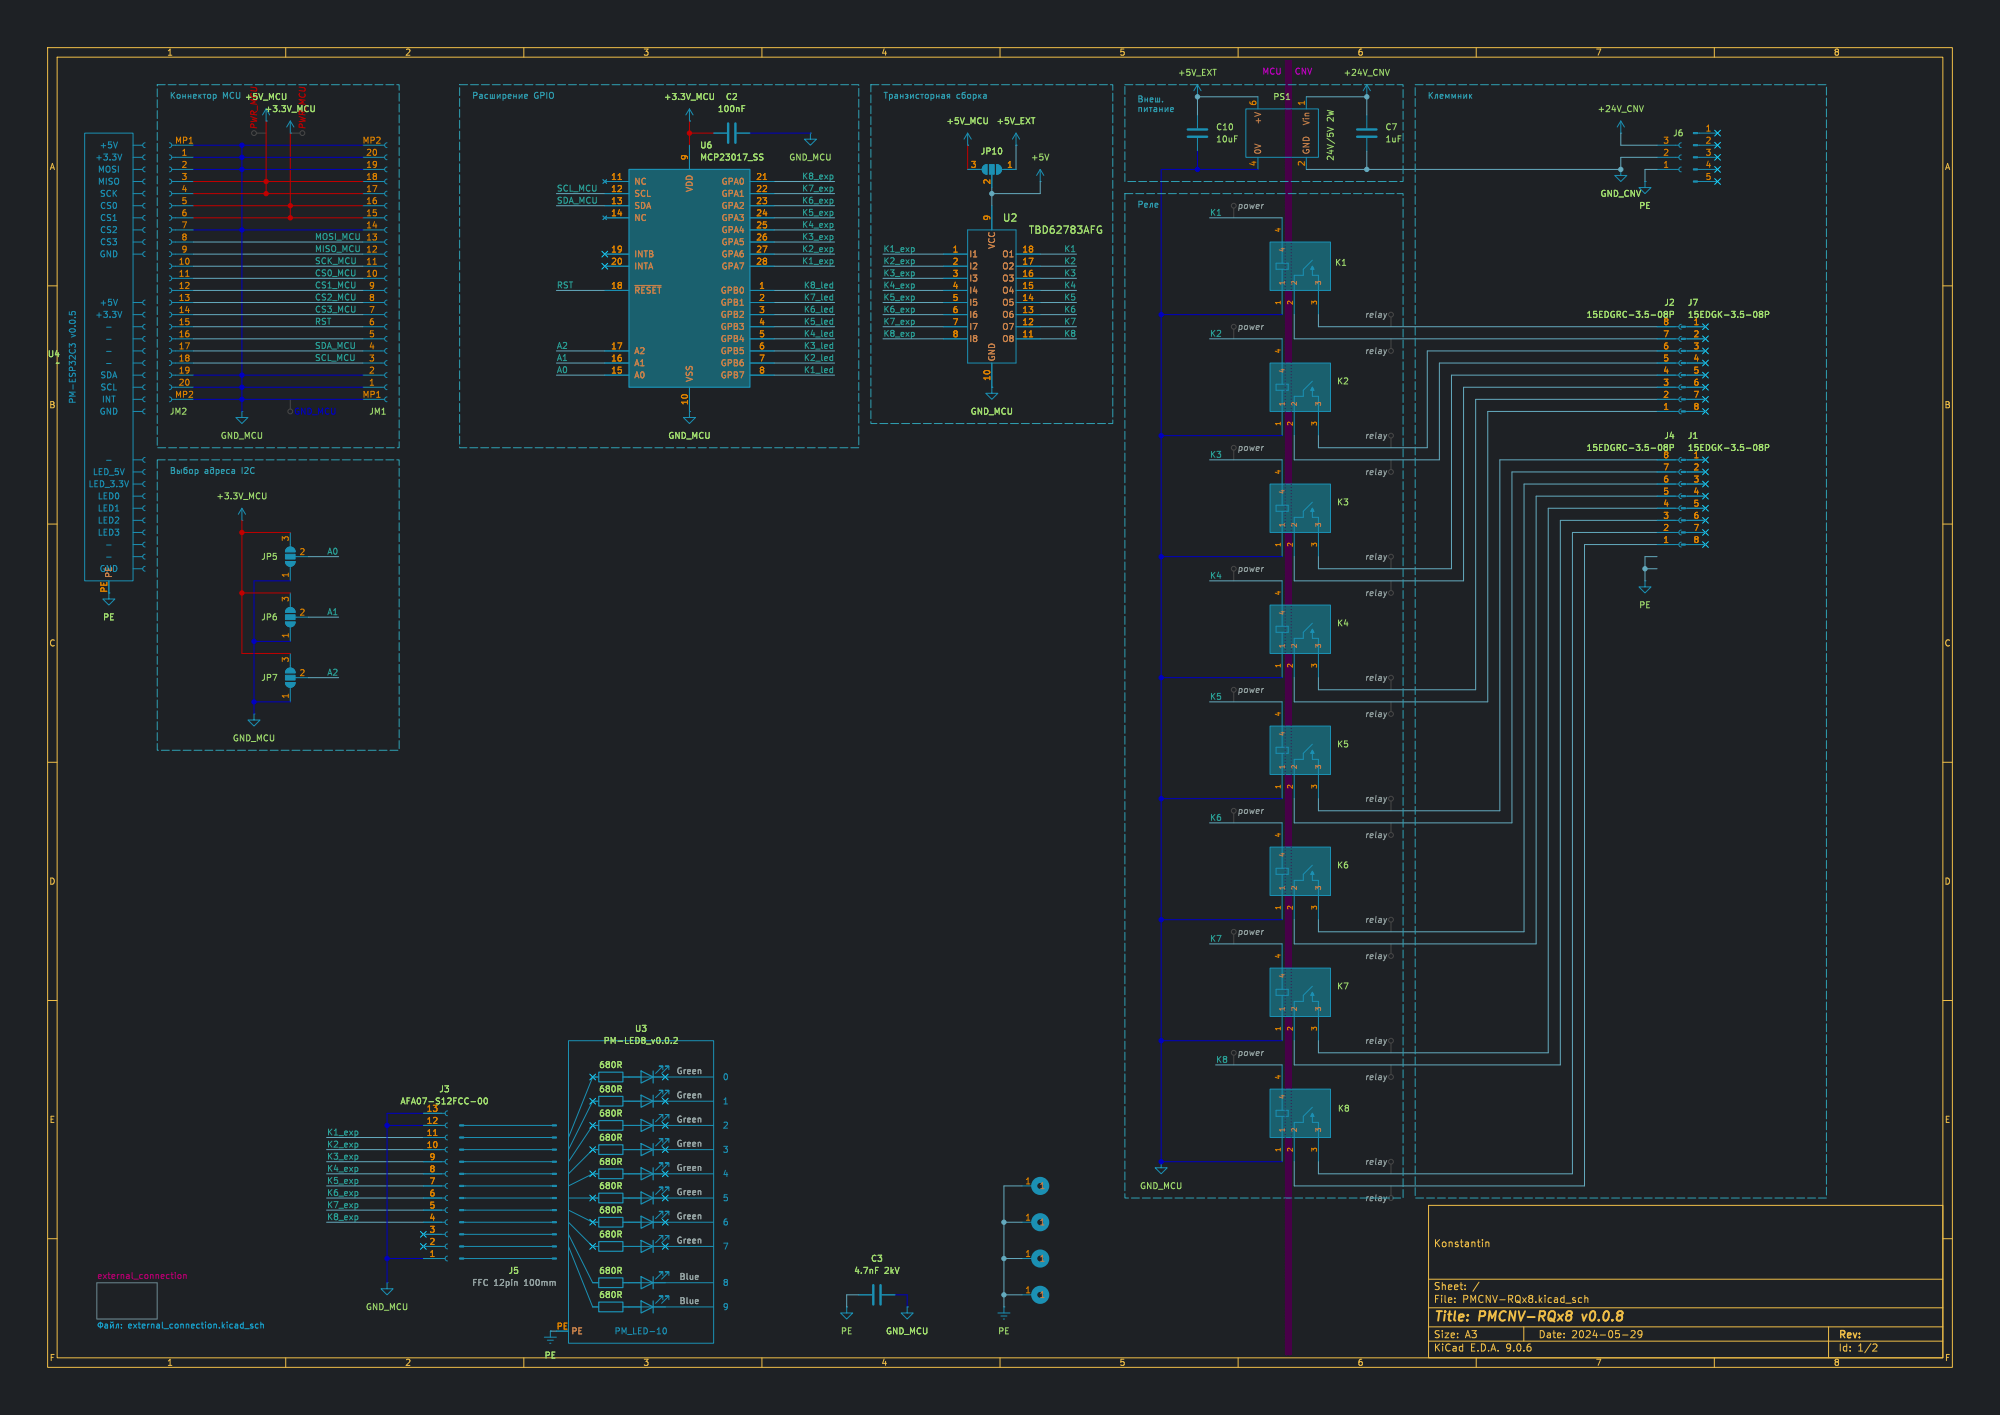
[picture p131: page 1]

power power

4.7nF 2kV Green Green Green Green Green Green Blue

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

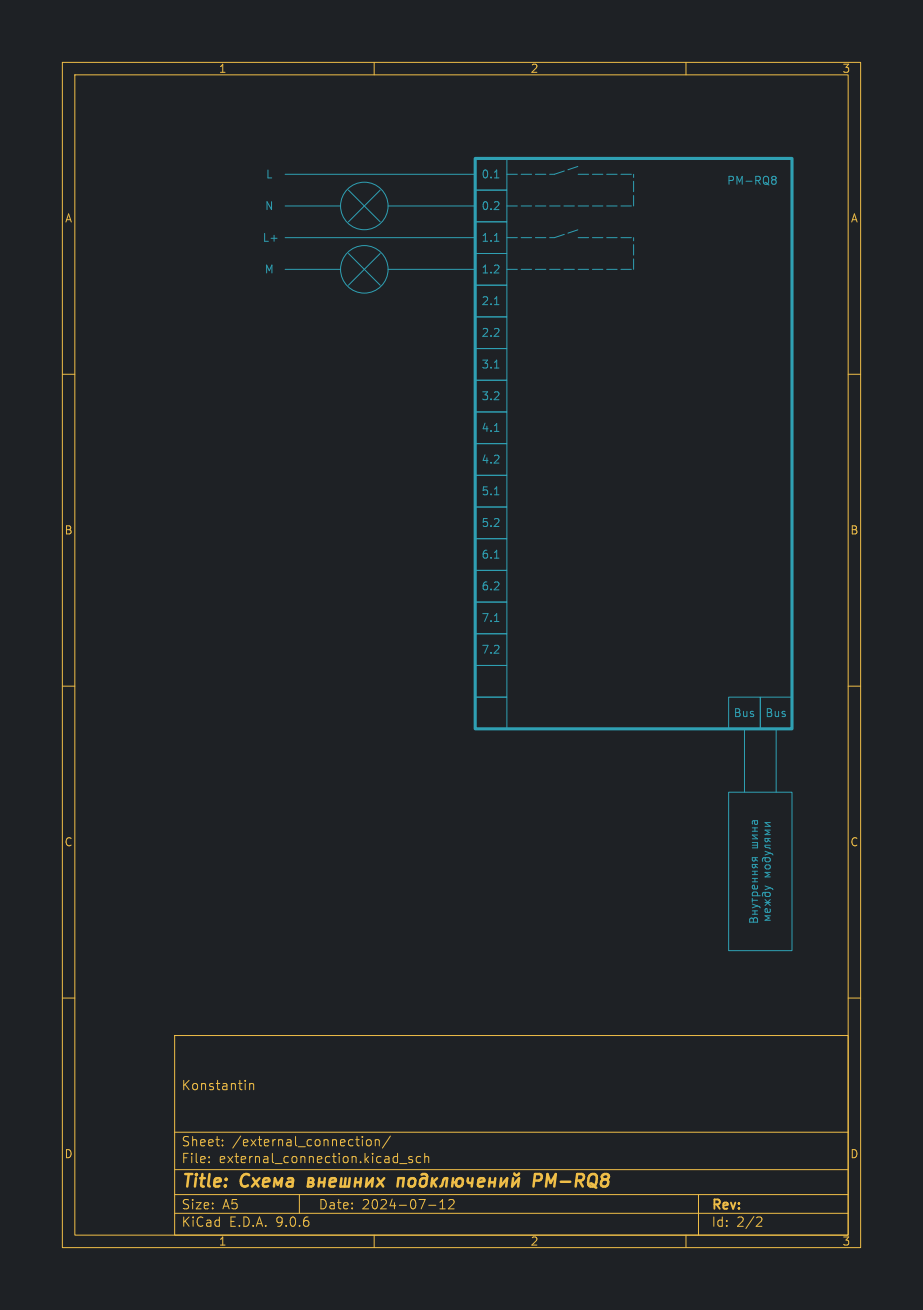
[picture p132: page 2]
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
