Konstantin-Dudersky/plc-modules/pcb/PMCNV-RQx8-v0.1.0/export/v0.0.9/PMCNV-RQx8.pdf

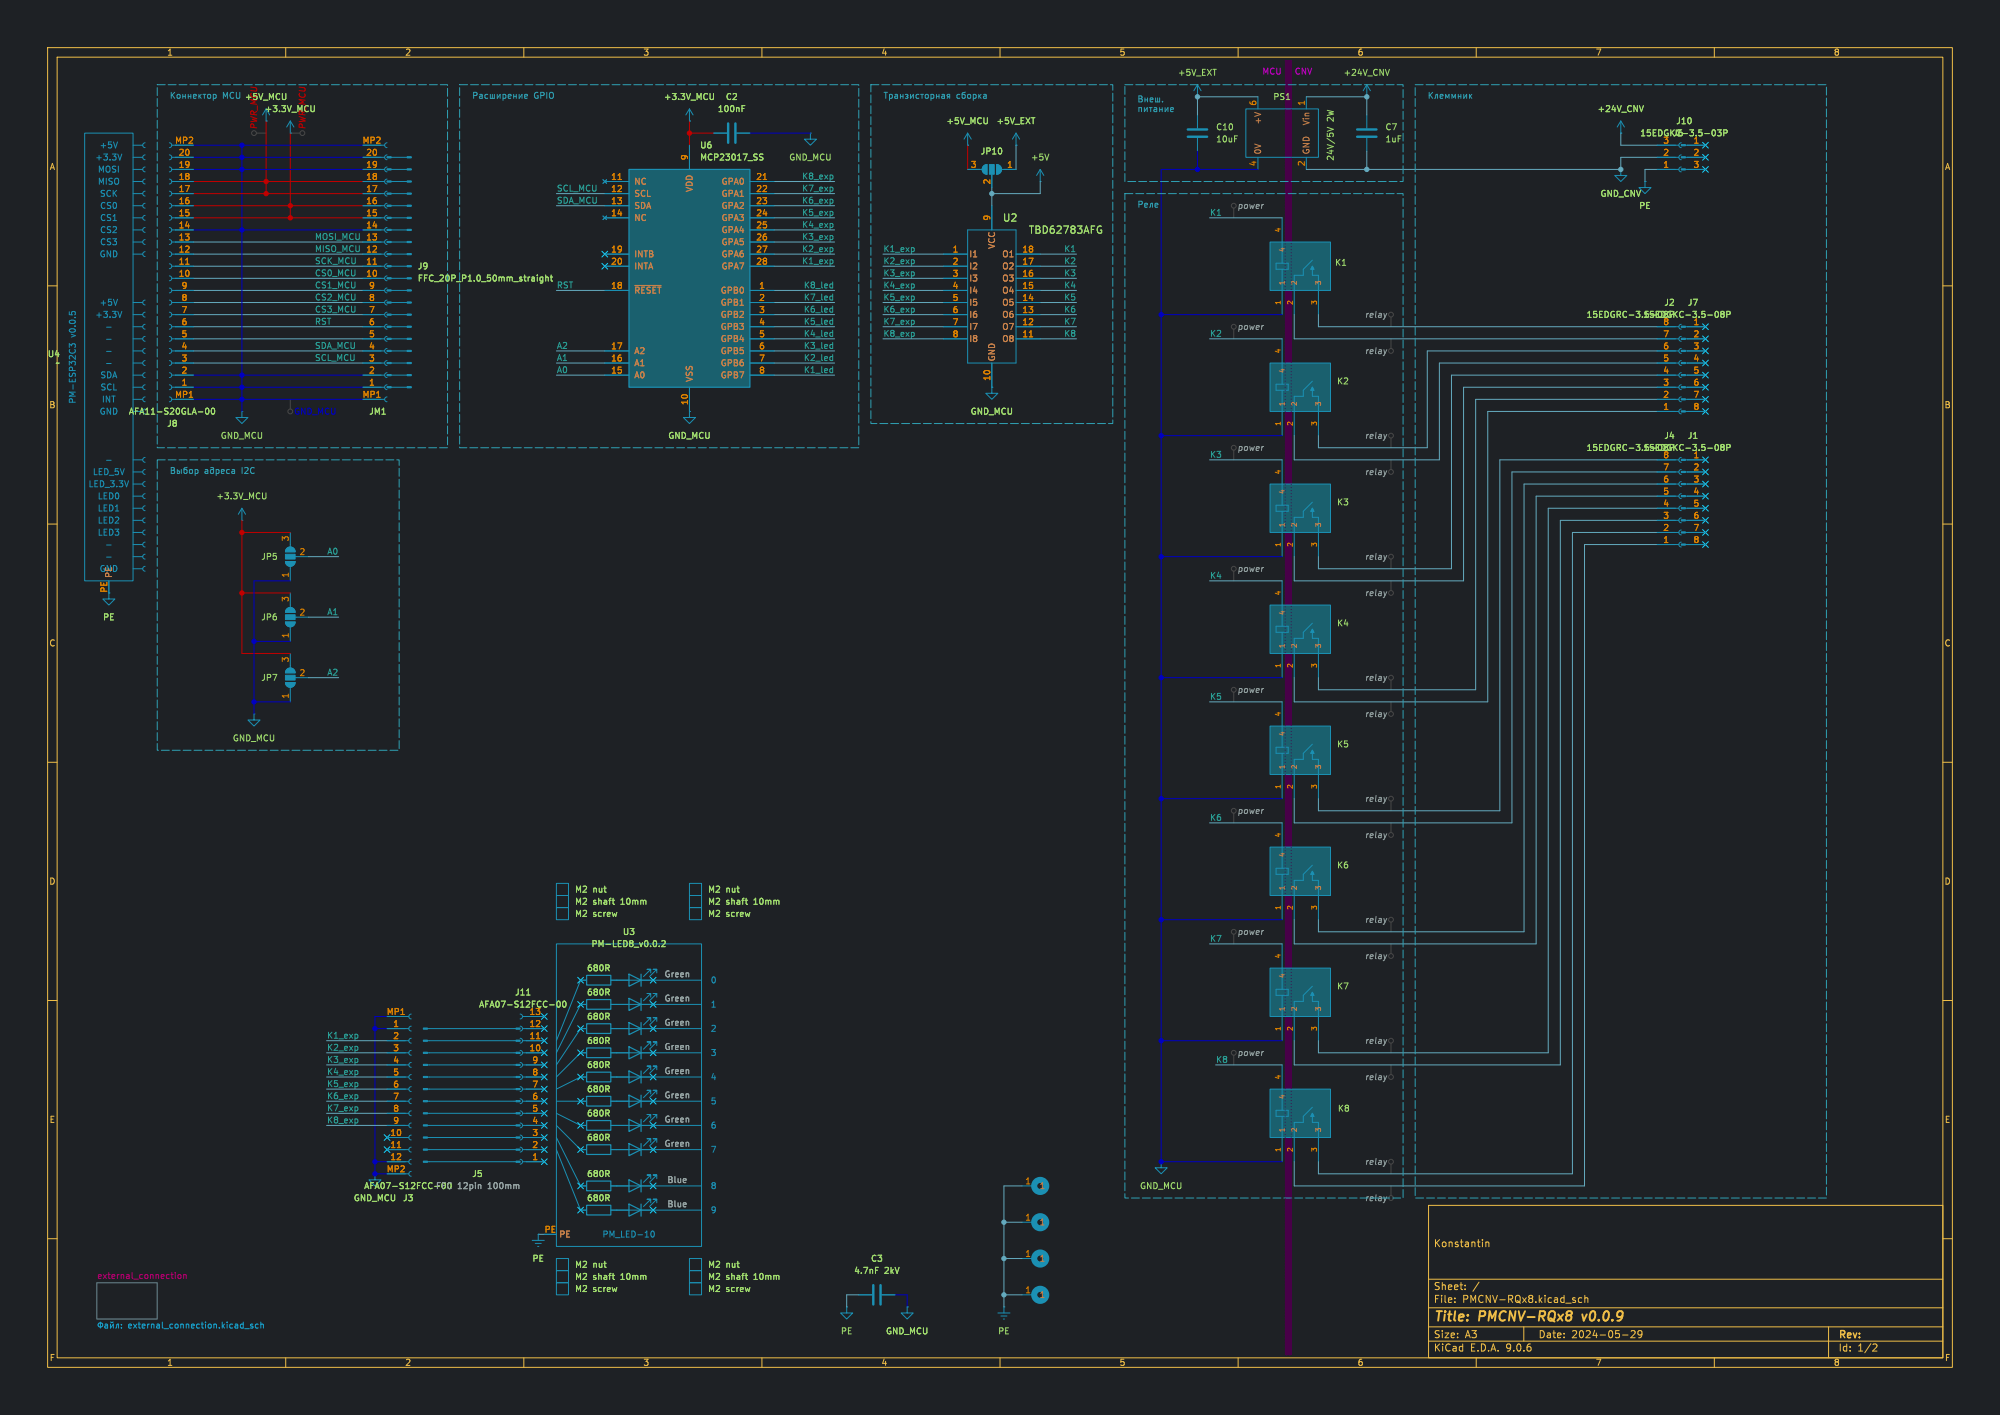
[picture p133: page 1]

M2 nut M2 screw Green Green Blue Green Blue M2 nut M2 screw M2 shaft 10mm

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
