Konstantin-Dudersky/plc-modules/pcb/PMCNV-DQx16-v0.1.0/export/v0.0.6/PMCNV-DQx16.pdf

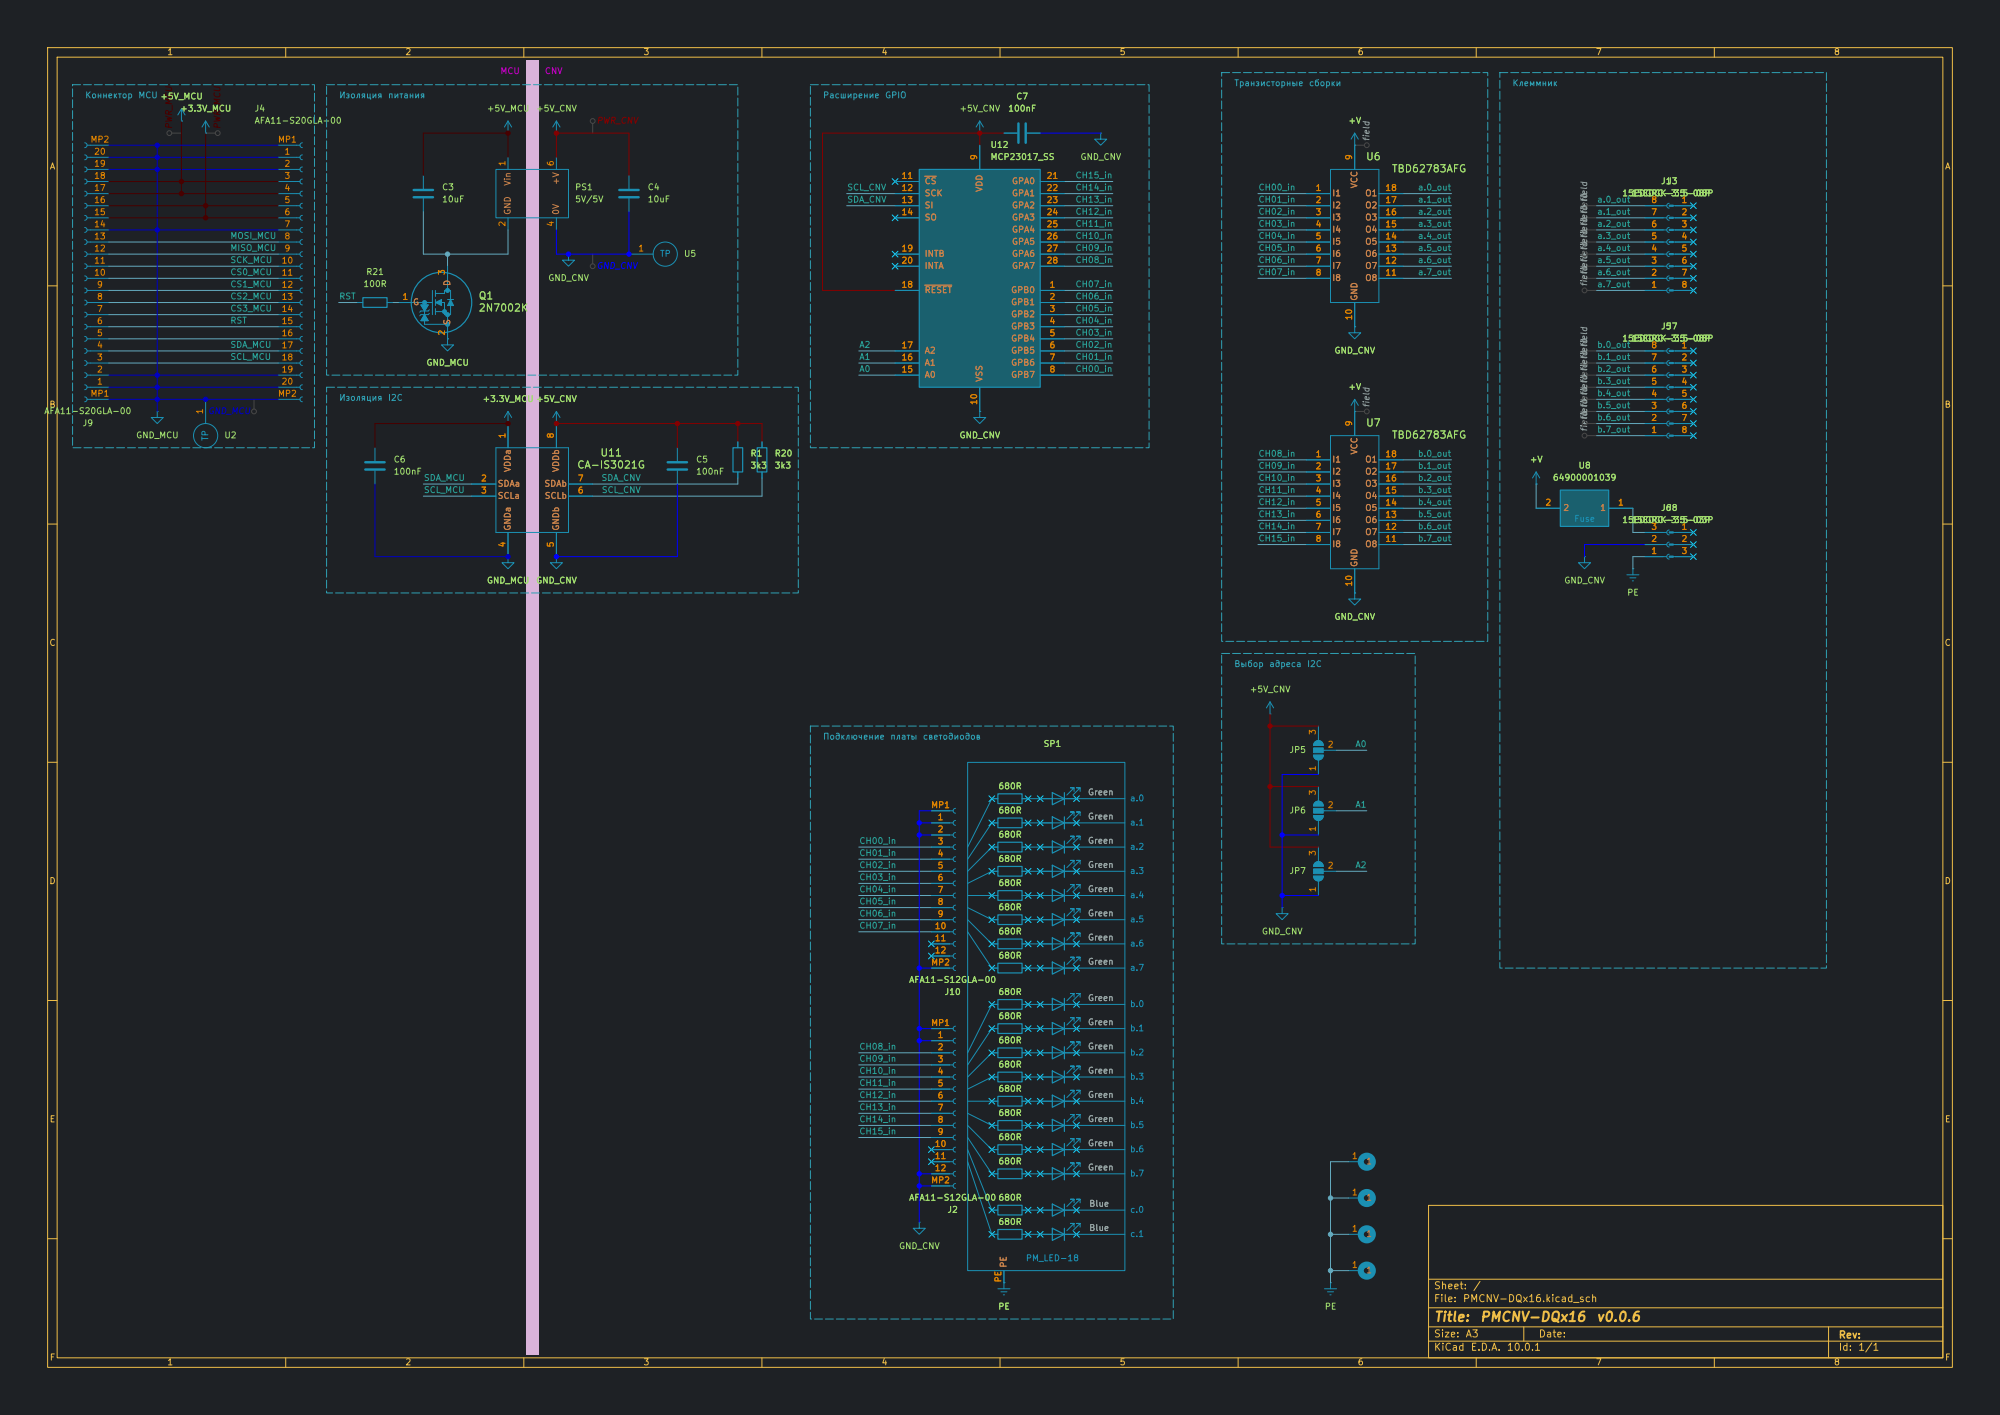
[picture p134: page 1]

PE Blue Green Green
JP6 GND_CNV 1
Green Green Green Green Green Green Green 680R

Blue Blue Green Green Green Green Green

Size: A3 | Rev: | F Date:
KiCad E.D.A. 10.0.1 | Id: 1/1
