Konstantin-Dudersky/plc-modules/pcb/PMCNV-DIx32-v0.1.0/export/v0.0.11/PMCNV-DIx32.pdf

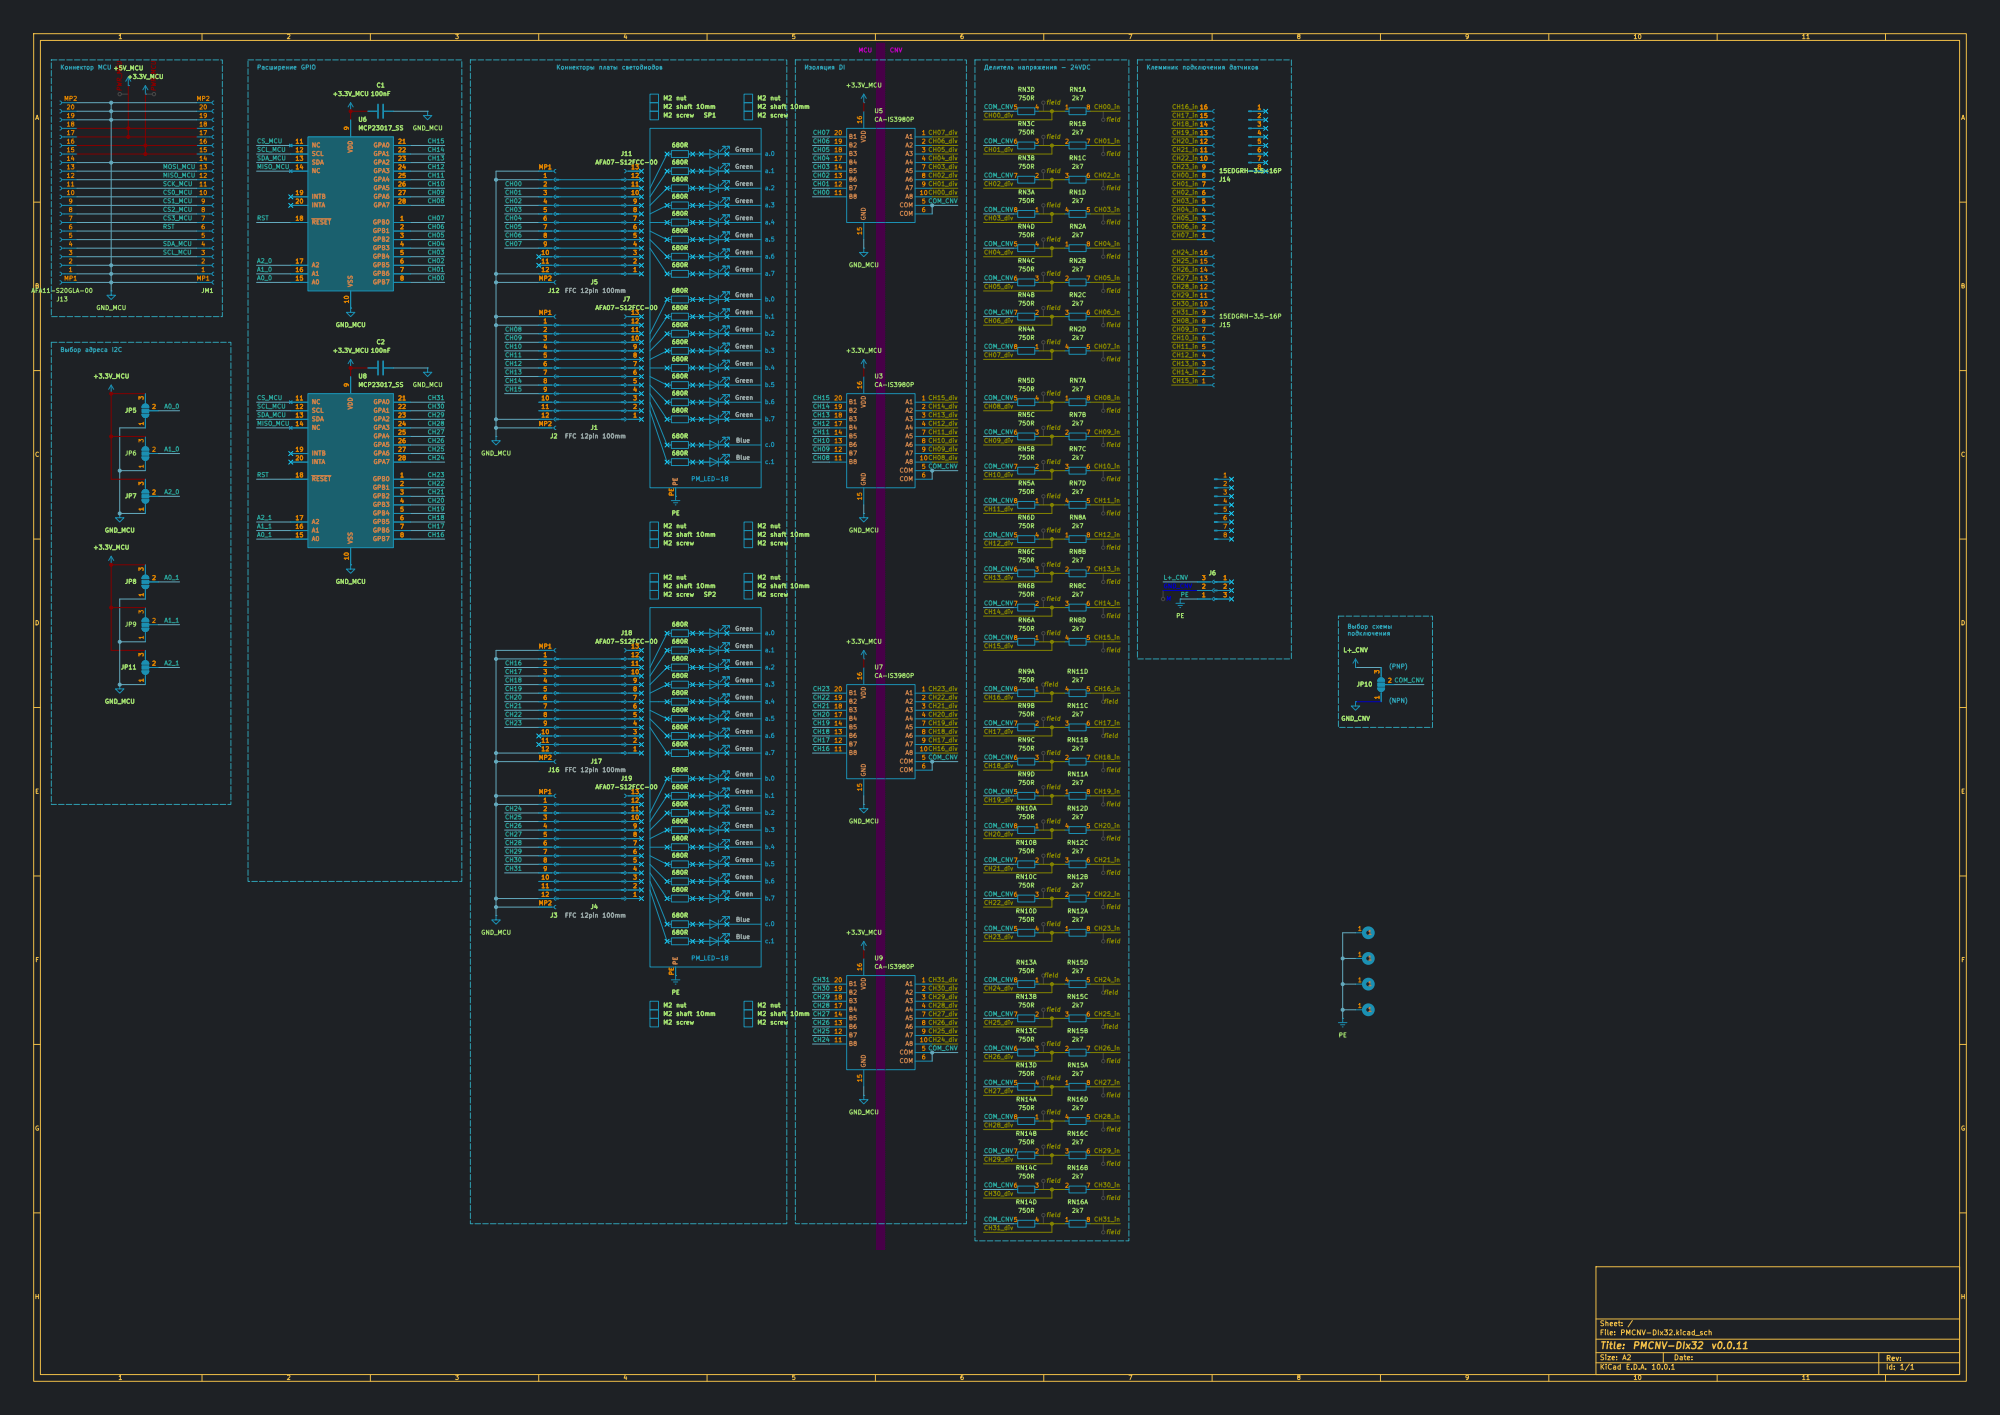
[picture p135: page 1]

680R M2 nut 680R M2 shaft 10mm
Green Green Green Green Green Green Green Green Green Green Green 680R

(NPN) 680R M2 nut M2 screw M2 shaft 10mm

Green Green Green Green 680R

Green Green Green Green Green 680R

Size: A2 | Rev:
KiCad E.D.A. 10.0.1 | Id: 1/1
