Konstantin-Dudersky/plc-modules/pcb/PMCPU-LLP-v0.1.0/export/v0.0.4/PMCPU-LLP.pdf

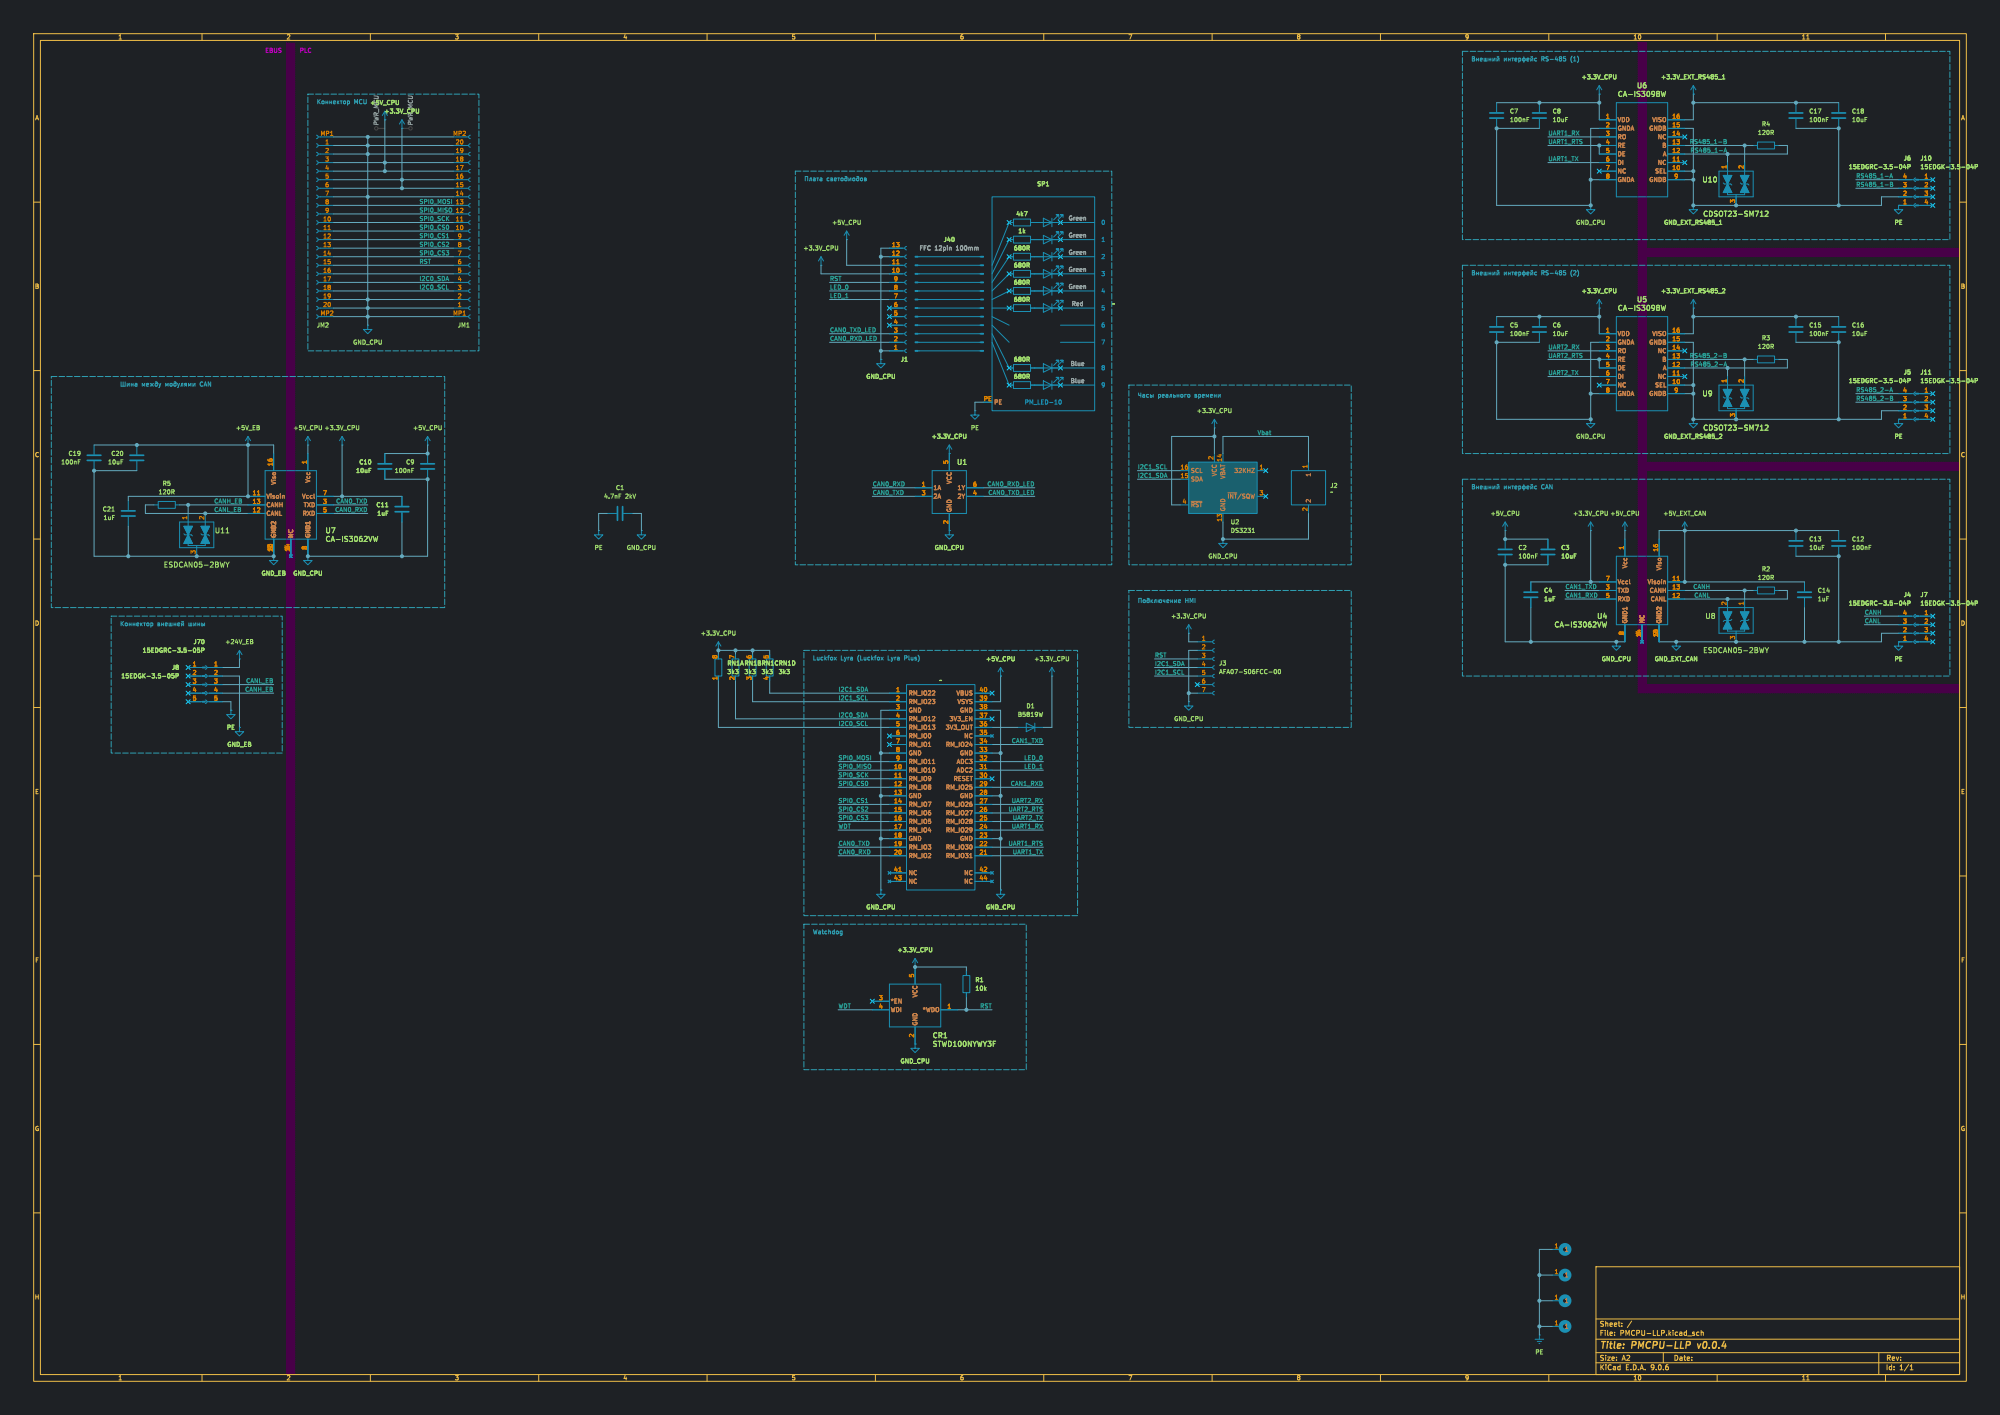
[picture p136: page 1]

28 NC 1446 Viso 16 GND2 1059 Visoin 11 CANH 13 CANL 12 U7 CA-IS3062VW

28 NC 1446 Viso 16 GND2 1059 Visoin 11 CANH 13 CANL 12 GND_EB GND_CPU GND_CPU GND_CPU CR1

3V3_OUT 36 NC 35 RM_IO24 34 GND 33 ADC3 32 ADC2 31 RESET 30 RM_IO25 29 GND 28 RM_IO26 27 RM_IO27 26 RM_IO28 25 RM_IO29 24 GND 23 RM_IO30 22 RM_IO31 21 NC 42 NC 44 ~
I2C0_SCL SPI0_SCK

File: PMCPU-LLP.kicad_sch Sheet: / GND_CPU
