Konstantin-Dudersky/plc-modules/pcb/PMPS-20W-v0.1.0/export/v0.0.6/PMPS-20W.pdf

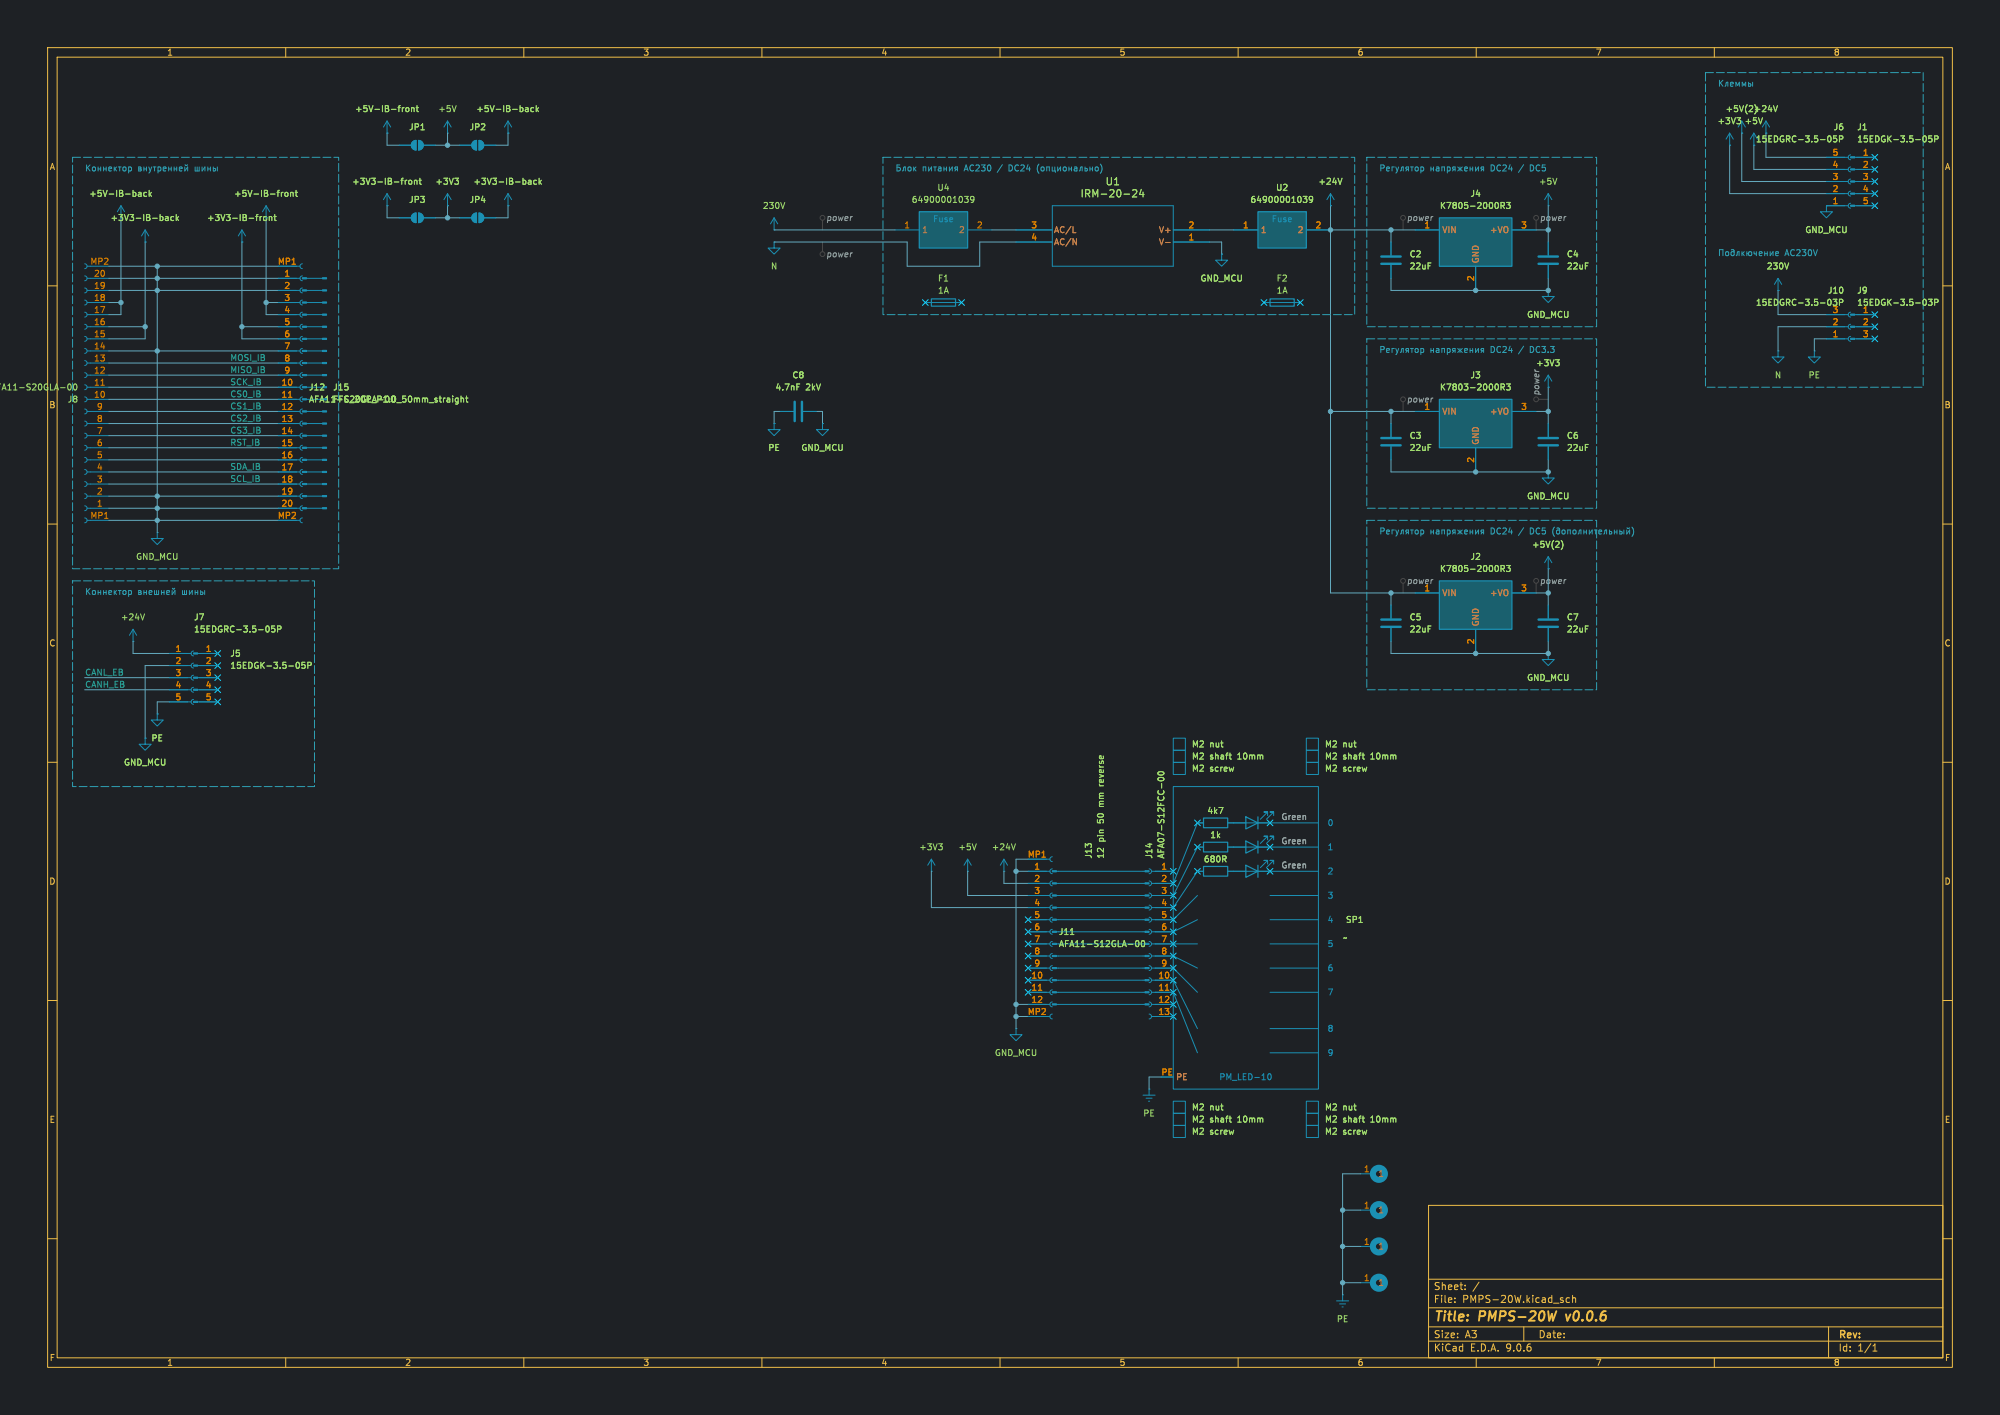
[picture p137: page 1]

JP4 +3V3-IB-back +5V-IB-back
