Konstantin-Dudersky/plc-modules/pcb/PMCNV-RQx8-v0.1.0/export/v0.0.7/PMCNV-RQ8.pdf

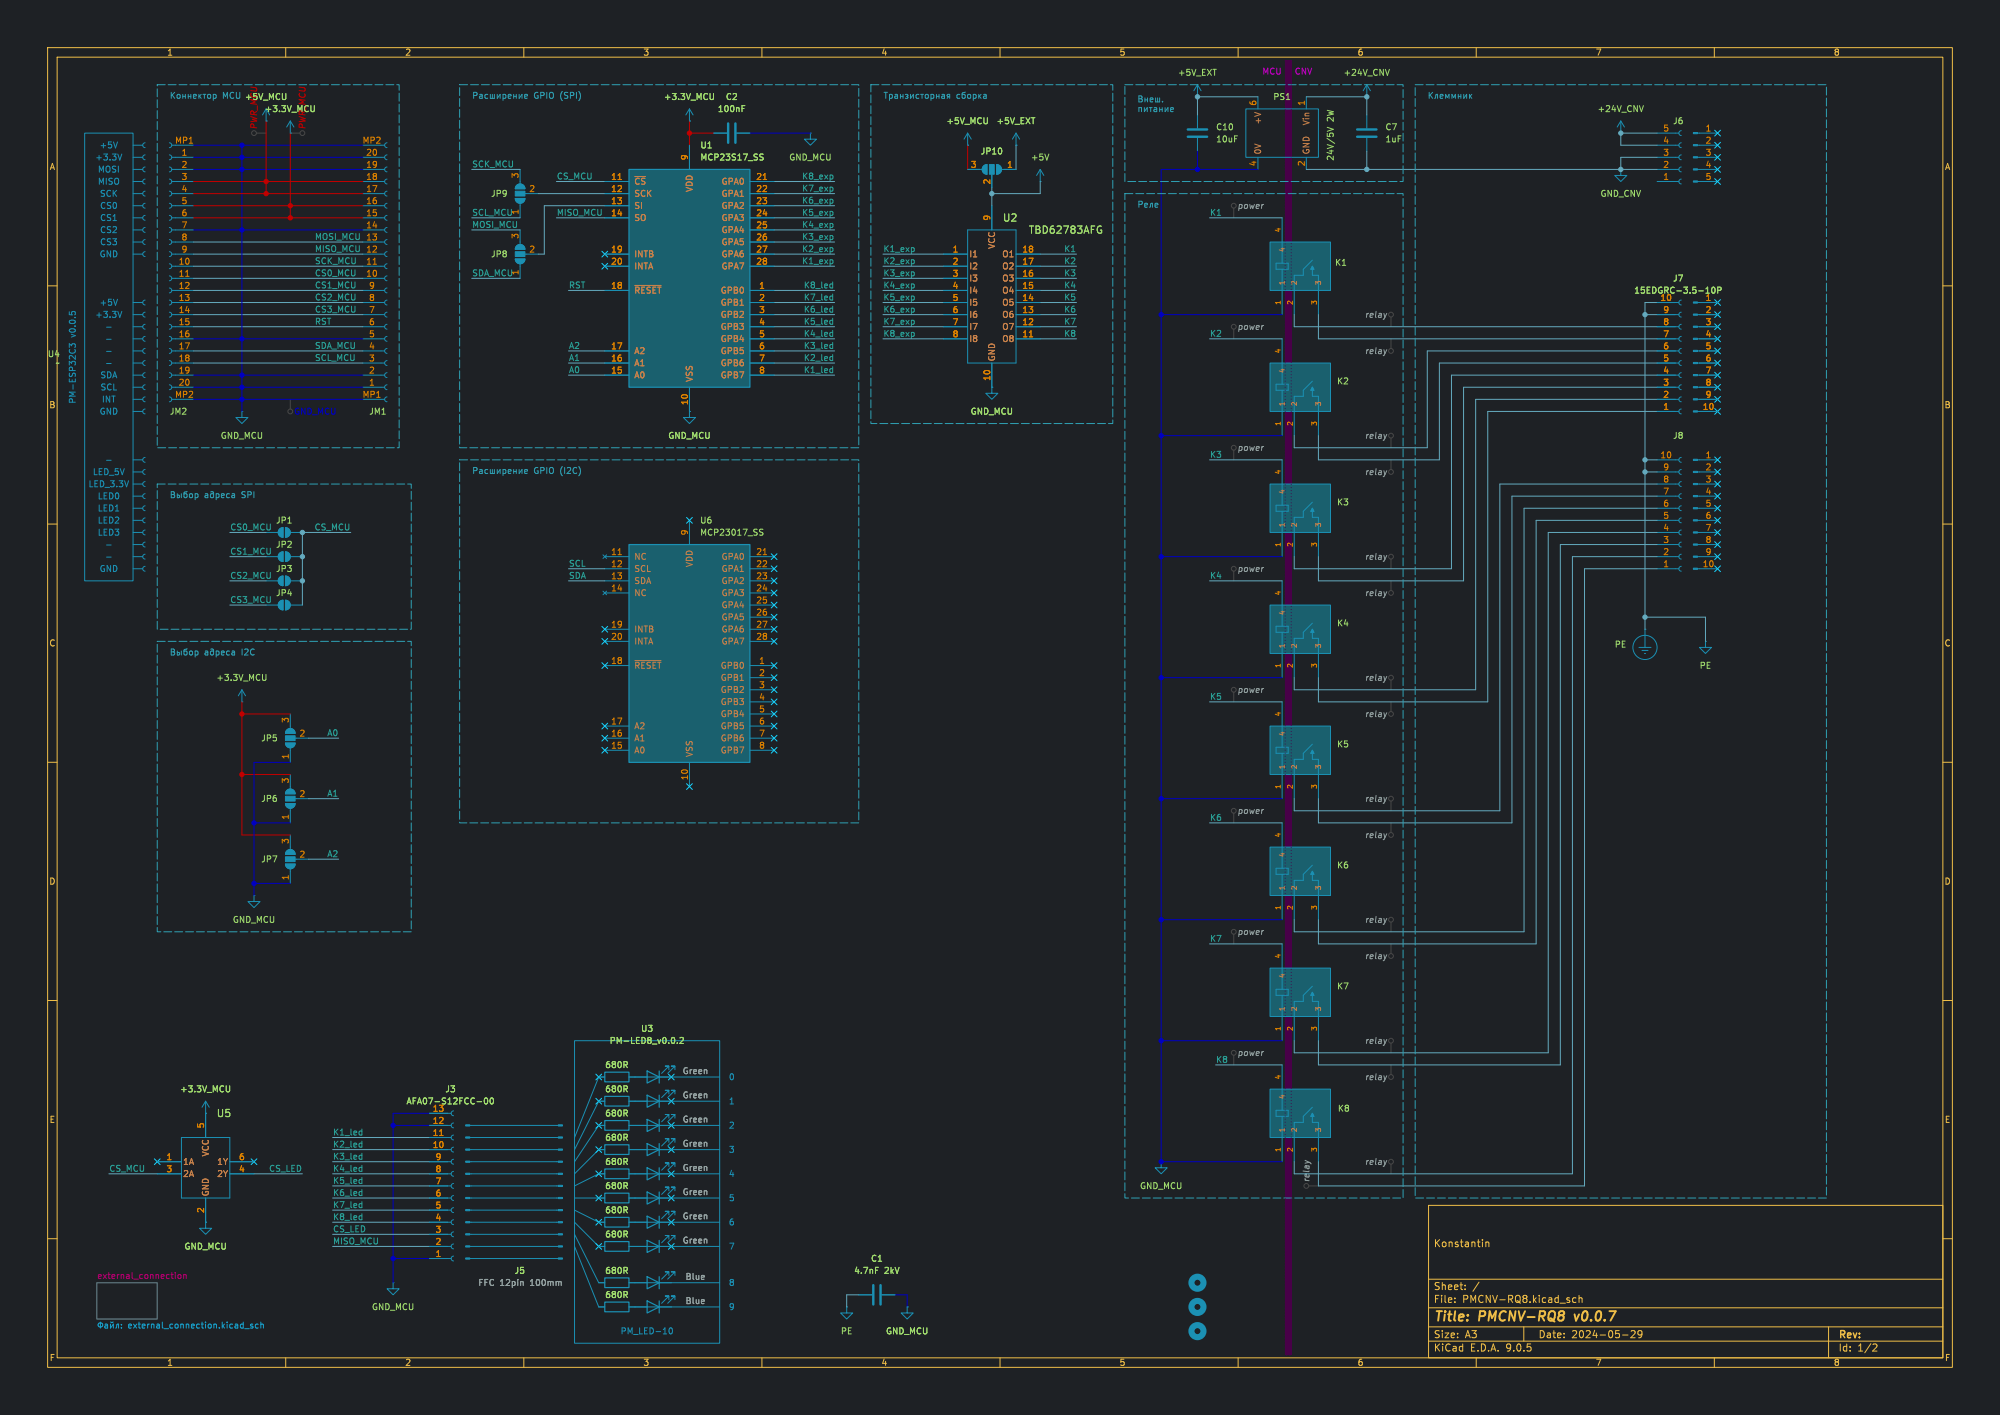
[picture p138: page 1]

4 K6 Green Green Green 680R Green GND_MCU

U3 PM-LED8_v0.0.2 Green Green Green Green 680R

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

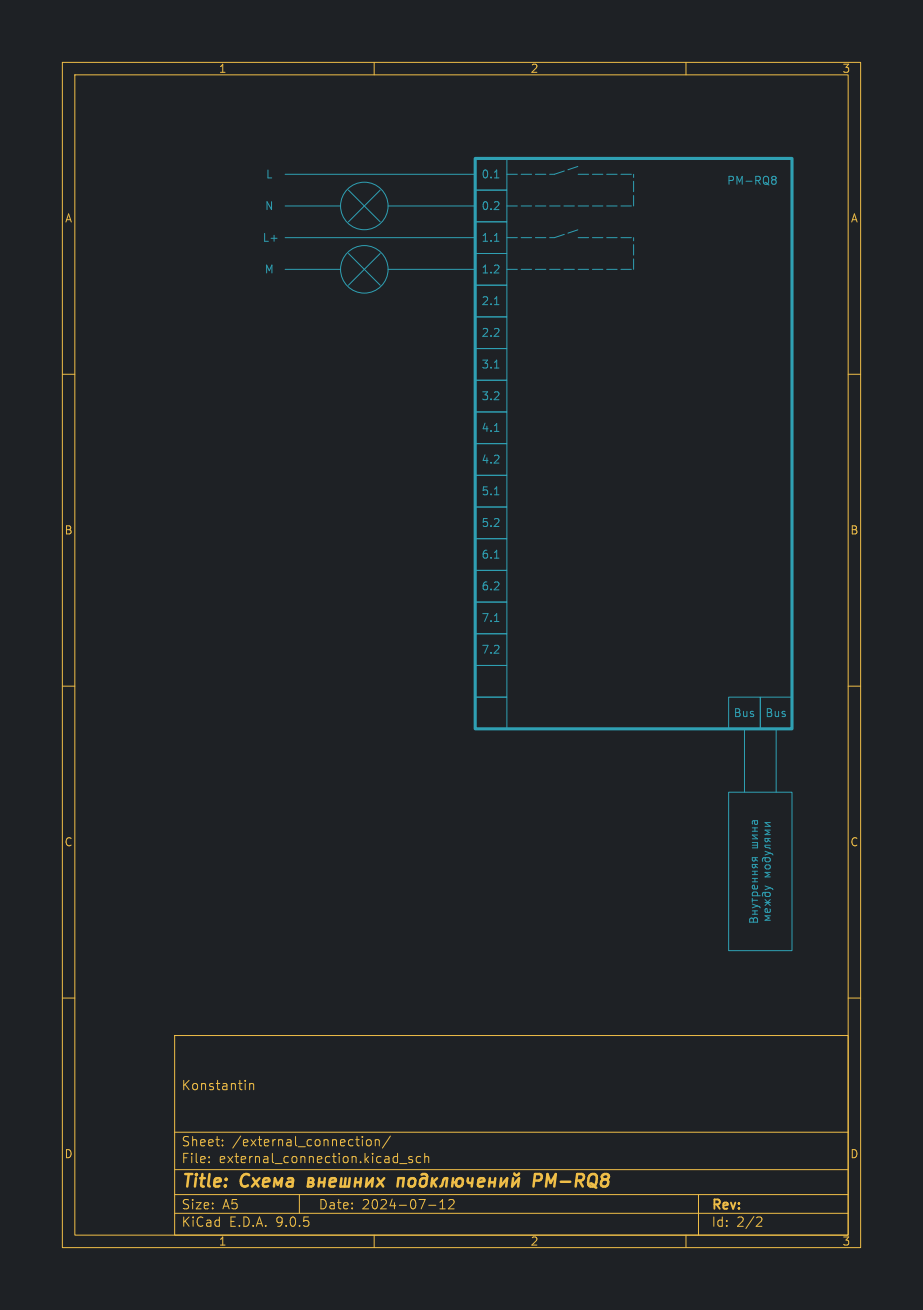
[picture p139: page 2]
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
