Konstantin-Dudersky/plc-modules/pcb/PMCPU-LLP-v0.1.0/export/v0.0.1/PMCPU-LLP.pdf

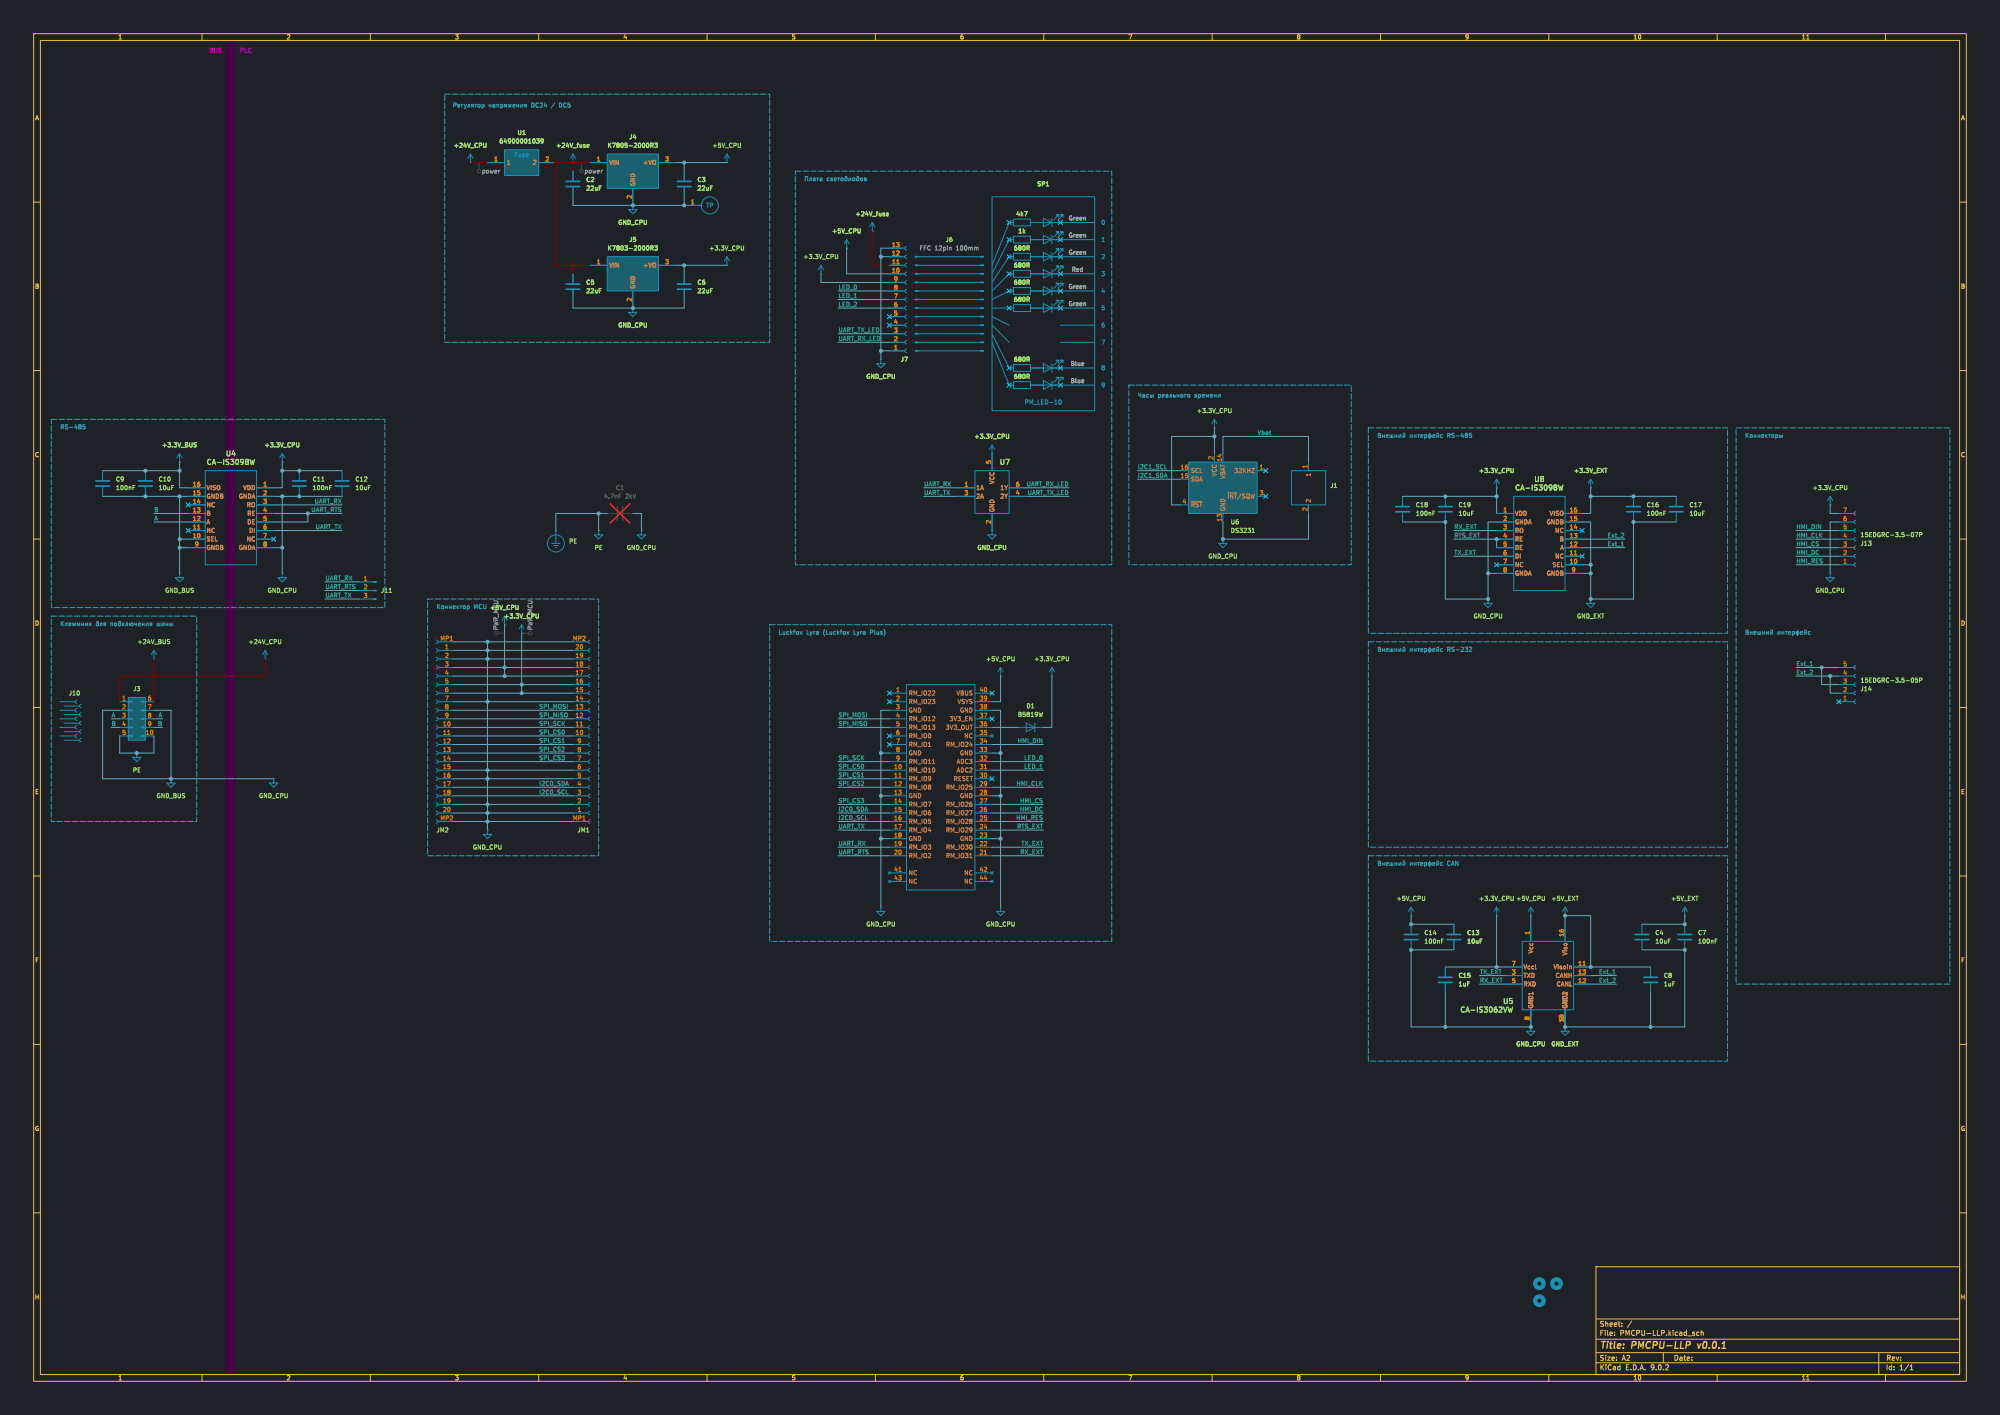
[picture p140: page 1]

þÿ;5<<=8: þÿ4;Oþÿ?>4:;NG5=8O þÿH8=K

File: PMCPU-LLP.kicad_sch Sheet: /
