Konstantin-Dudersky/plc-modules/pcb/PMCNV-DQx16-v0.1.0/export/v0.0.4/PMCNV-DQ16src.pdf

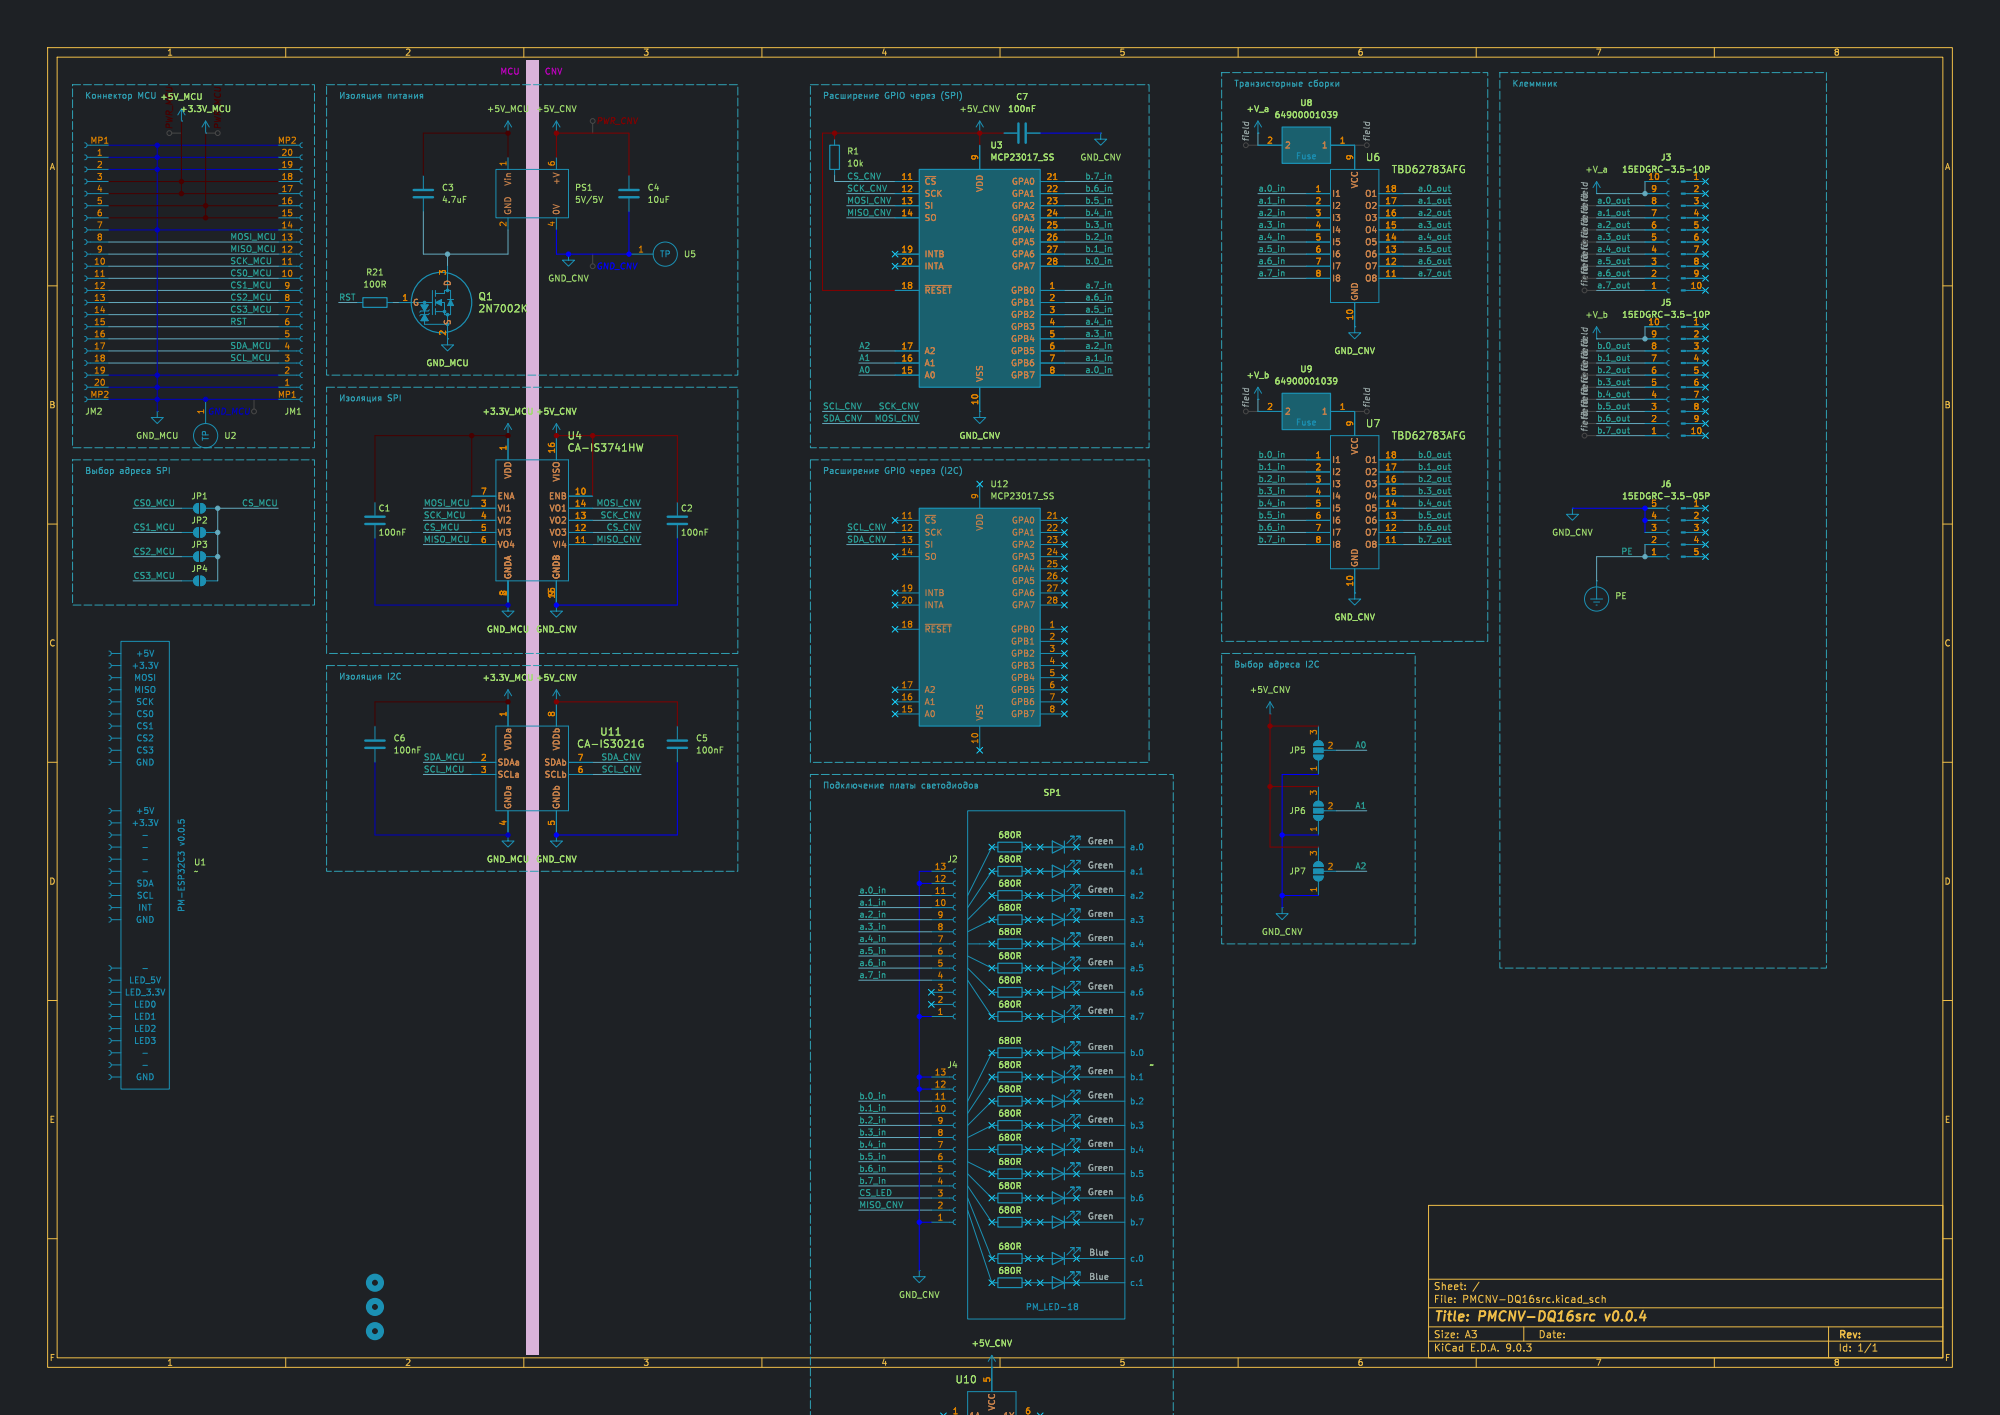
[picture p142: page 1]

þÿ 0AH8@5=85 GPIO þÿG5@57 (SPI)

Green Green Green
