Konstantin-Dudersky/plc-modules/pcb/PMCNV-RQx8-v0.1.0/export/v0.0.6/PMCNV-RQ8.pdf

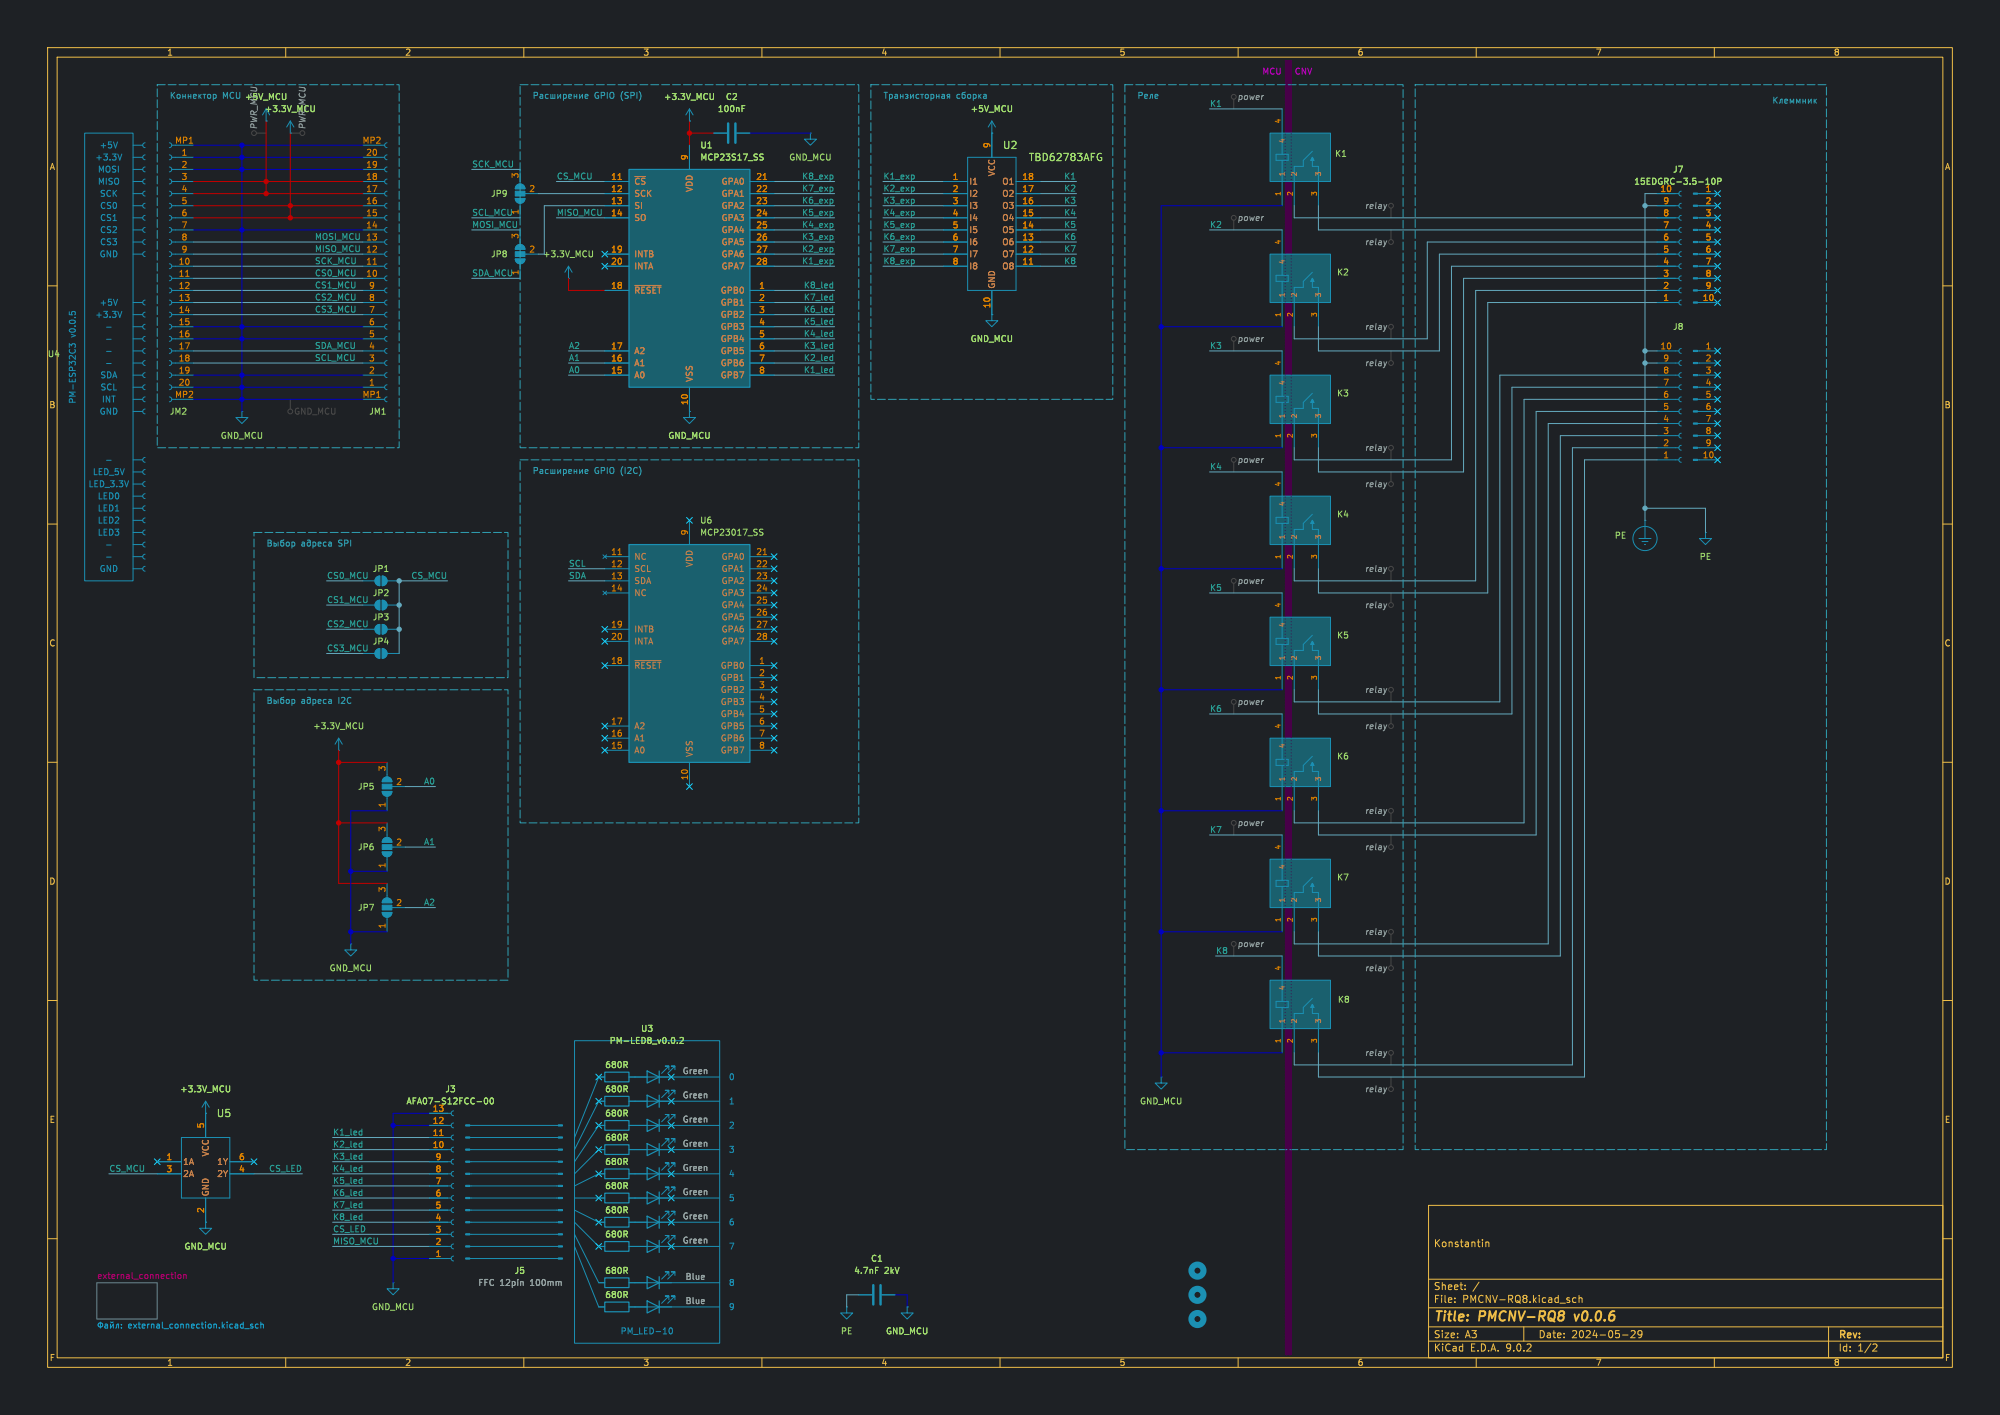
[picture p144: page 1]

þÿK1>@þÿ04@5A0 SPI þÿK1>@þÿ04@5A0 I2C

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

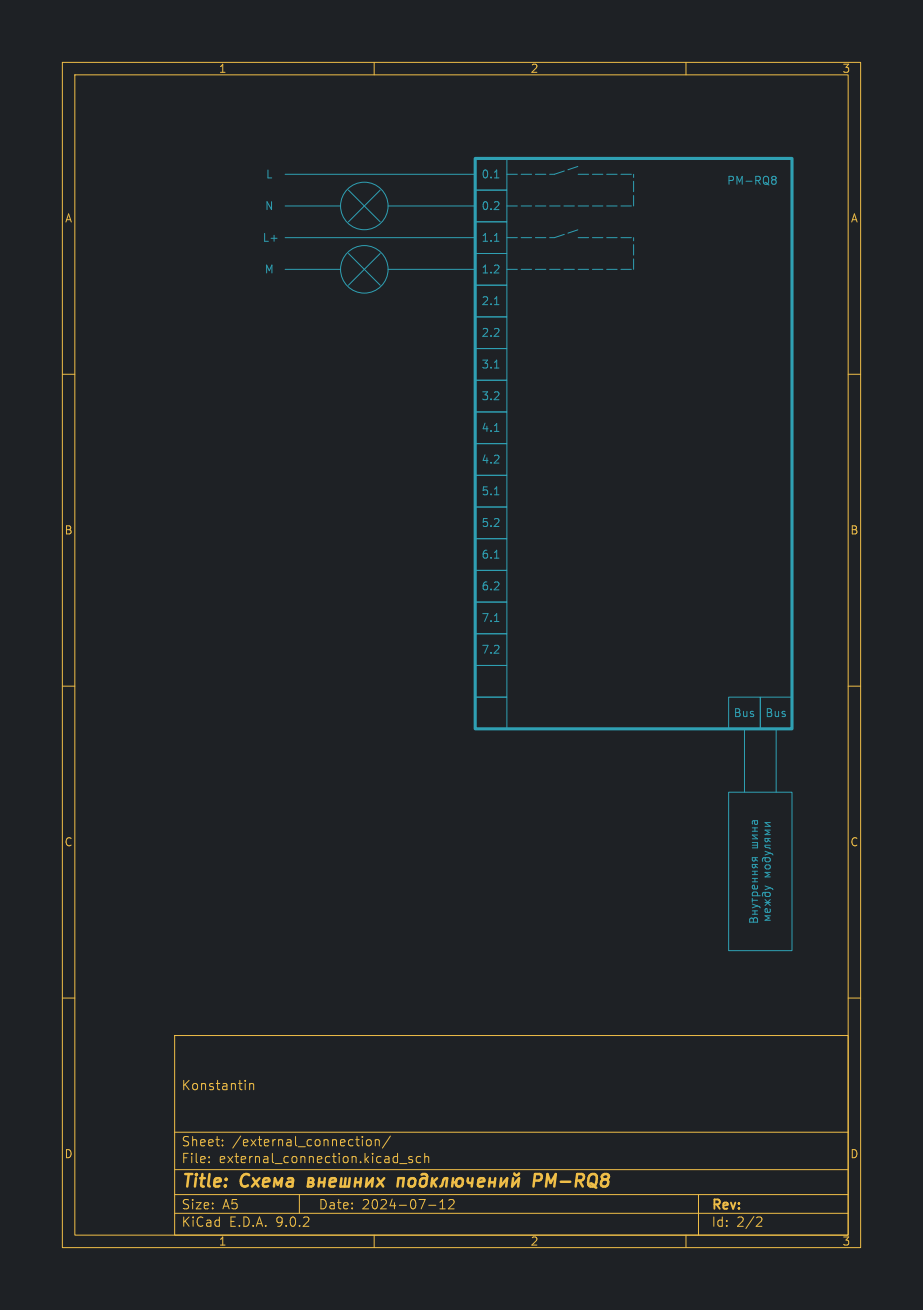
[picture p145: page 2]
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
