Konstantin-Dudersky/plc-modules/pcb/PMCNV-DQx16-v0.1.0/export/v0.0.2/PM_CNV-DQ16_src.pdf

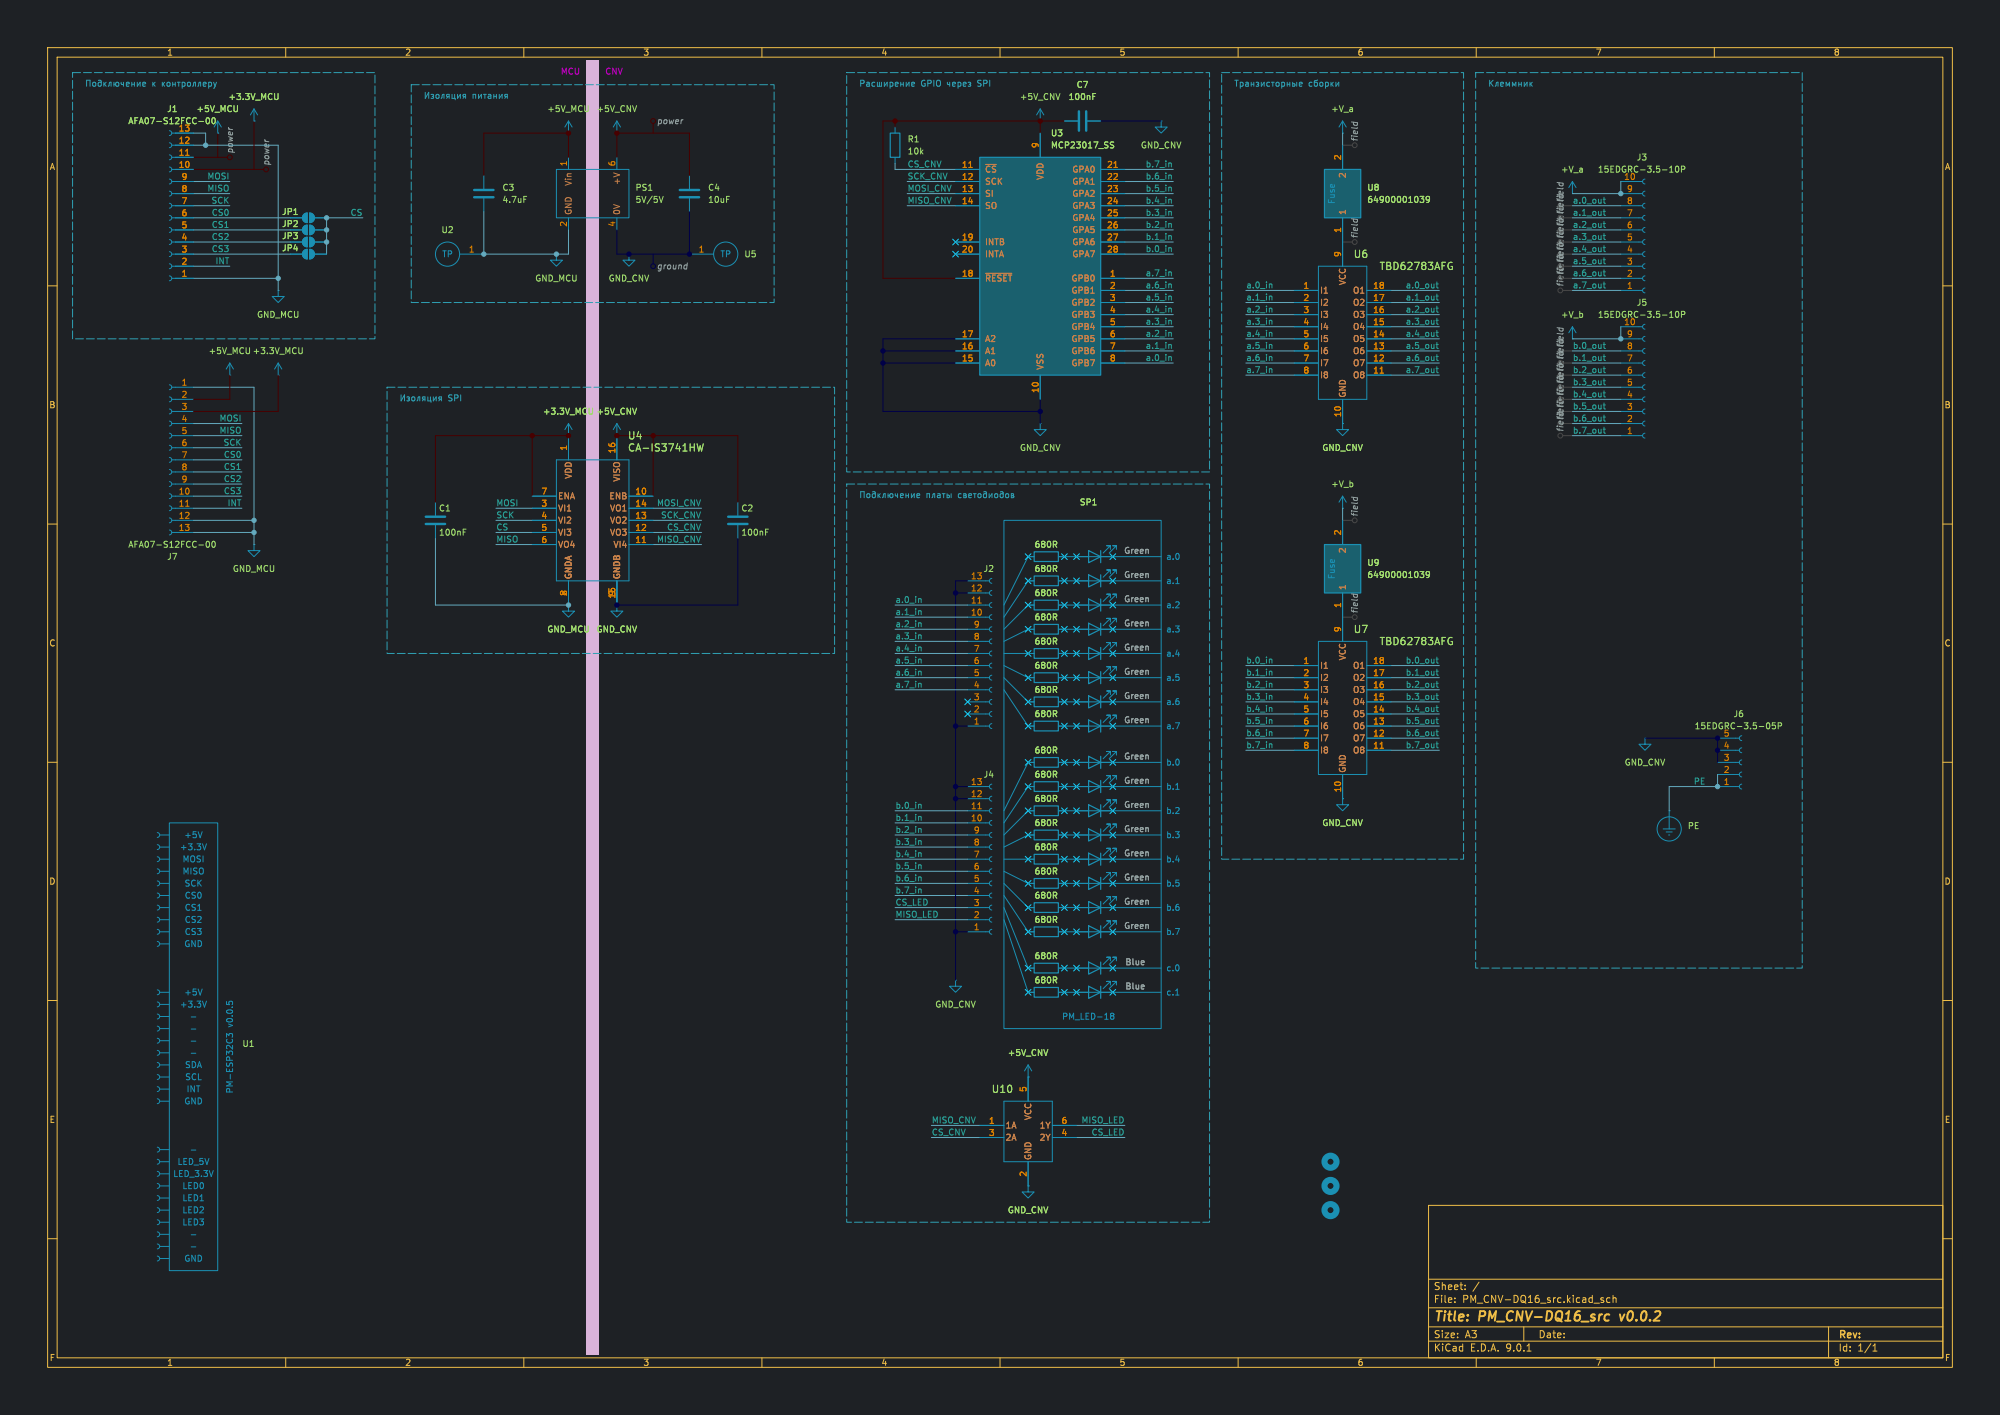
[picture p146: page 1]

þÿ 0AH8@5=85 GPIO þÿG5@57 SPI þÿ7>;OF8O þÿ?8B0=8O
