Konstantin-Dudersky/plc-modules/pcb/PMCNV-DQx16-v0.1.0/export/v0.0.2/PM_CNV-DQ16_src-v0.0.2 (schematic).pdf

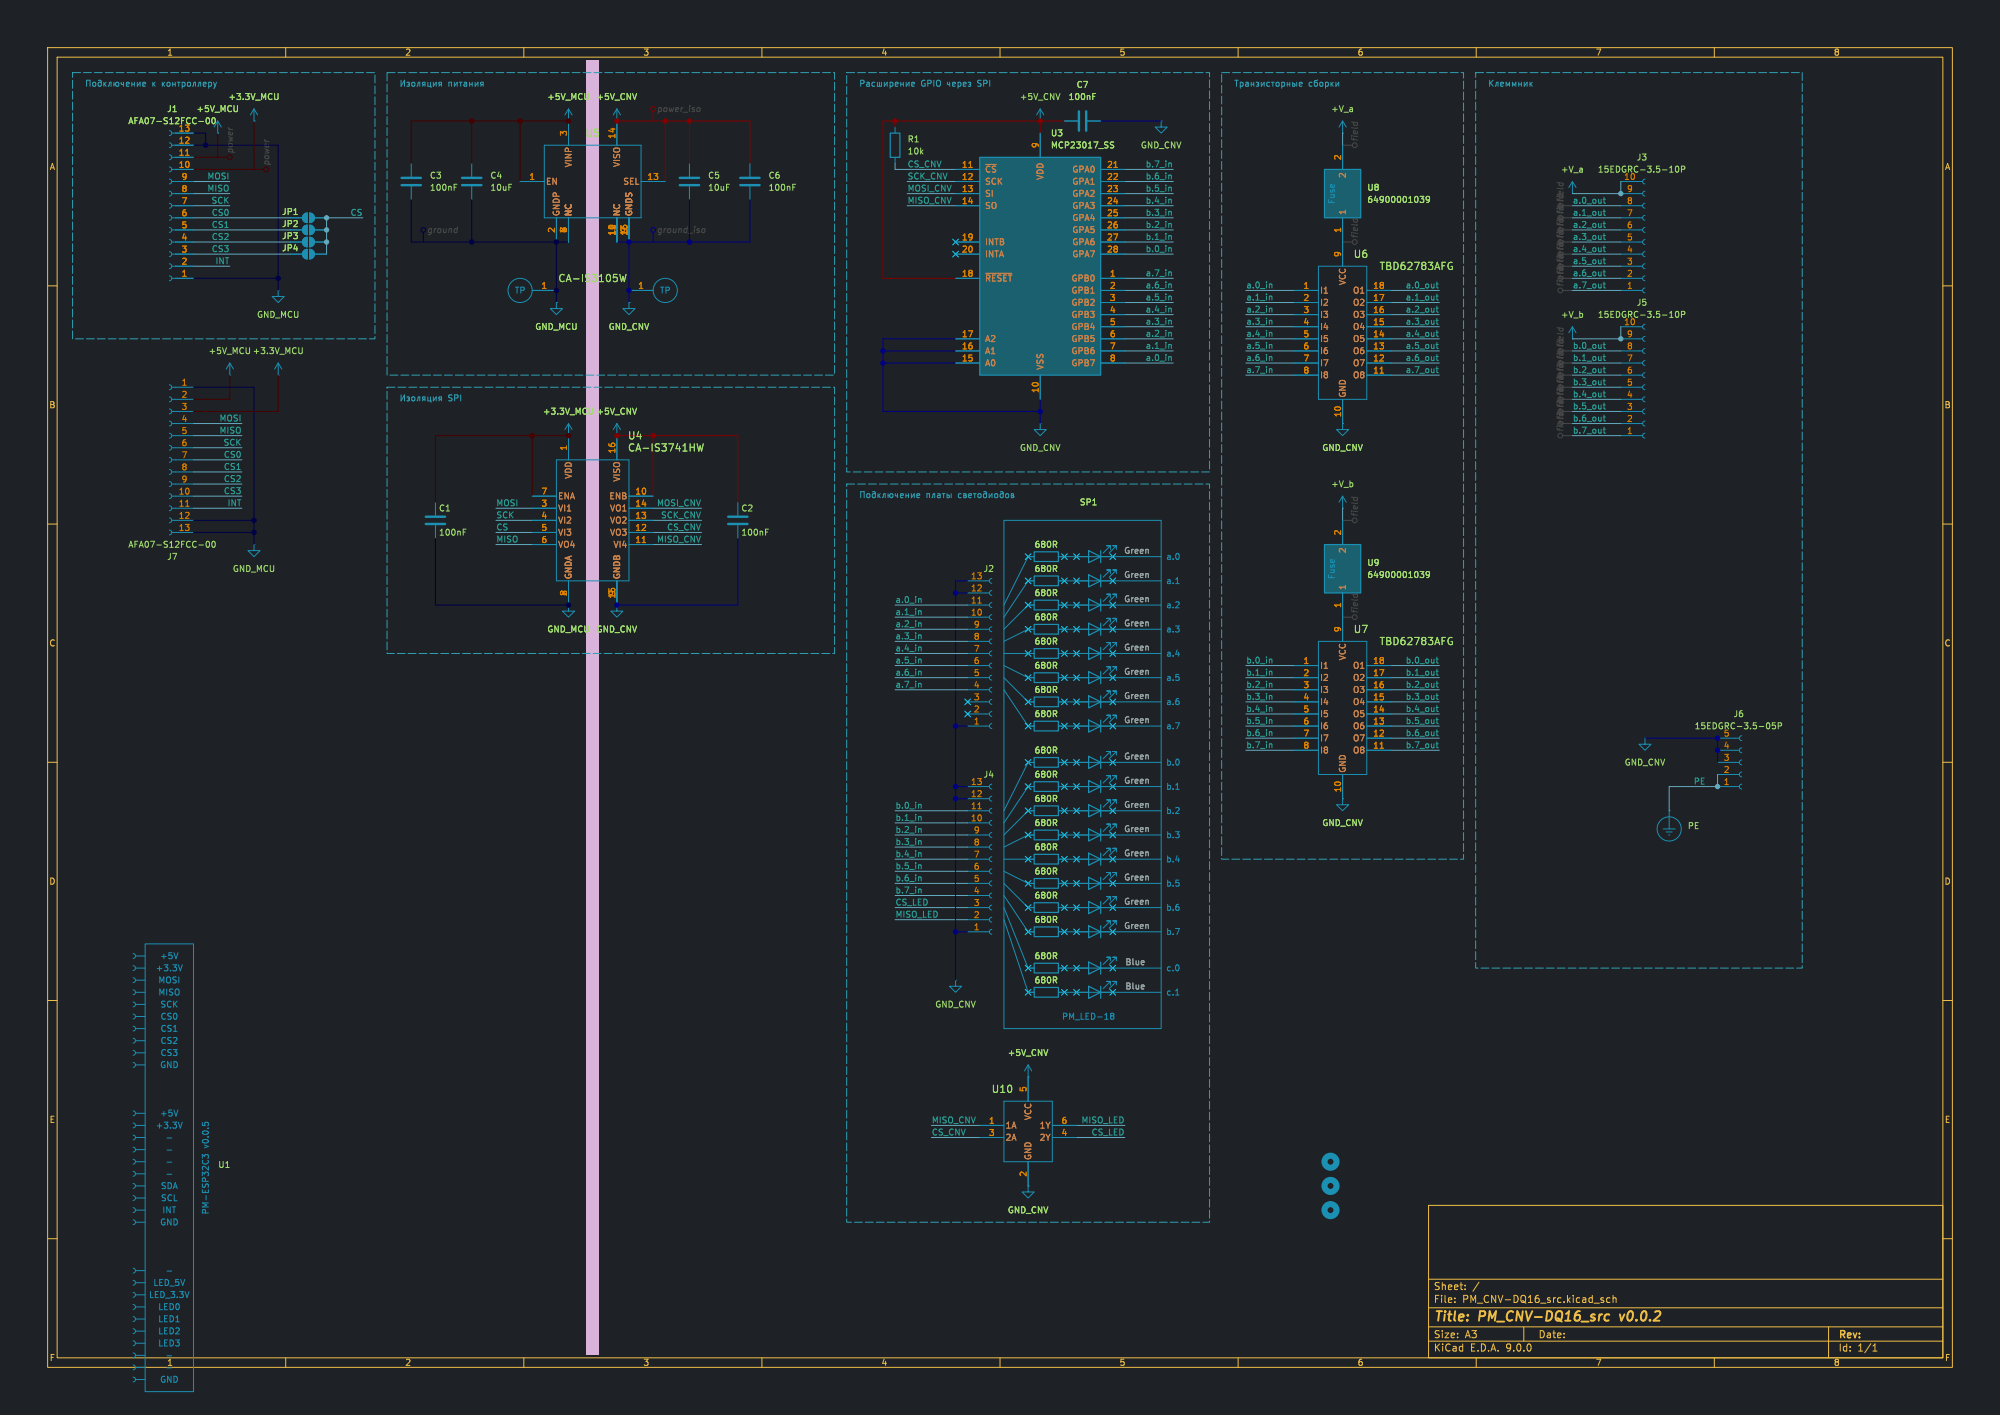
[picture p147: page 1]
