Konstantin-Dudersky/plc-modules/pcb/PMCNV-RQx8-v0.1.0/export/v0.0.8/PCB schematic/PMCNV-RQx8.pdf

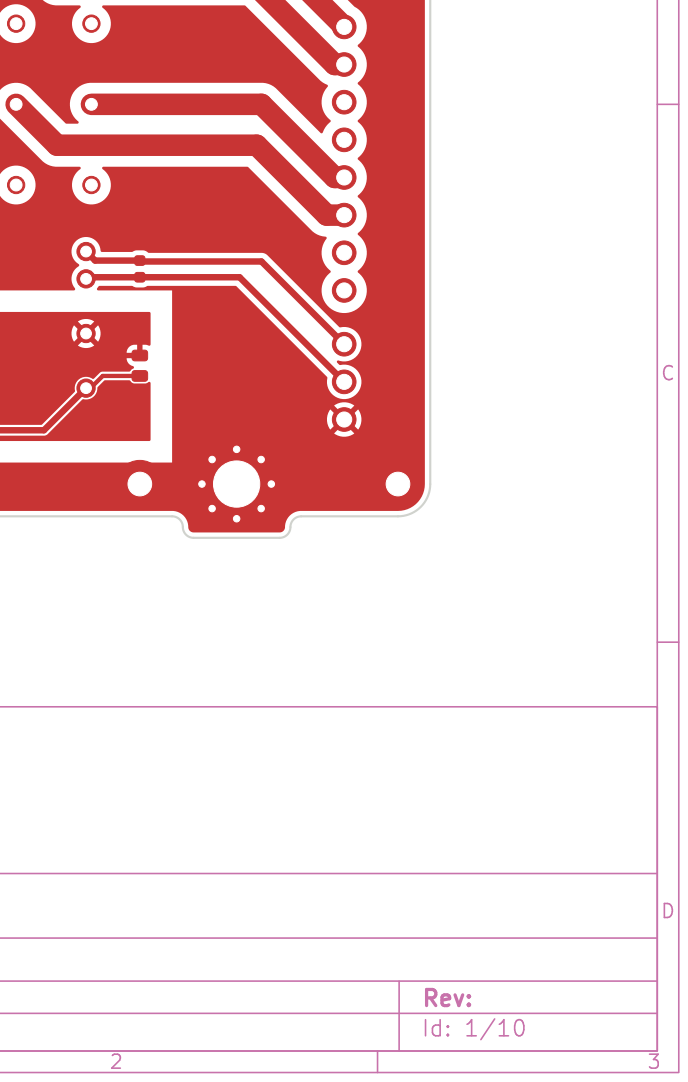
[picture p148: page 1]

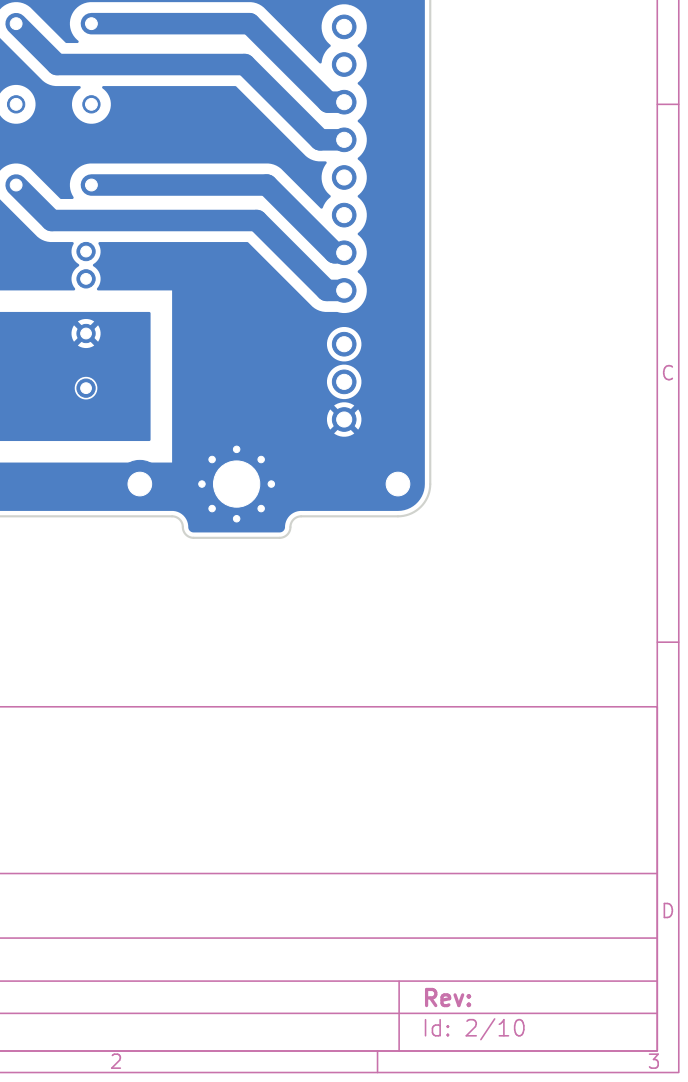
[picture p149: page 2]

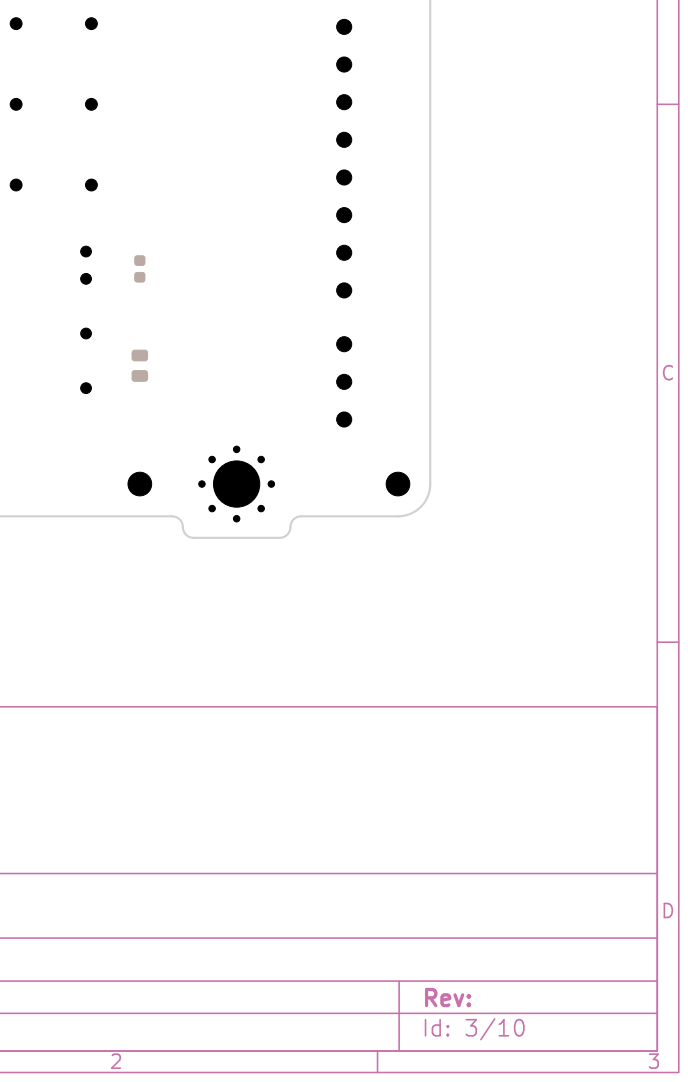
[picture p150: page 3]

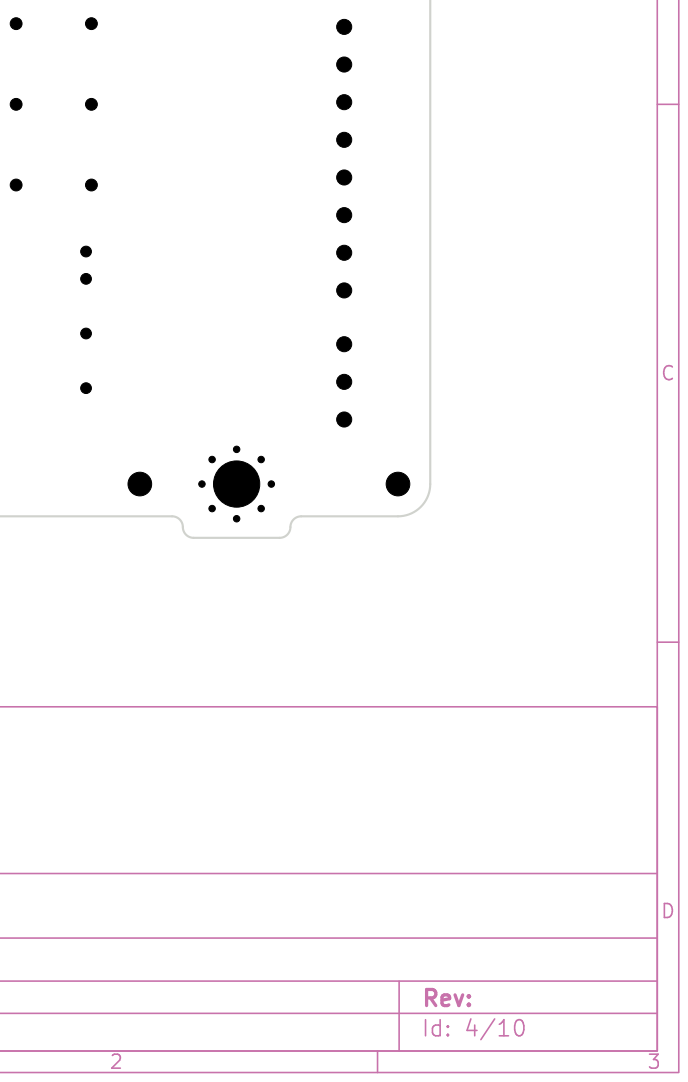
[picture p151: page 4]

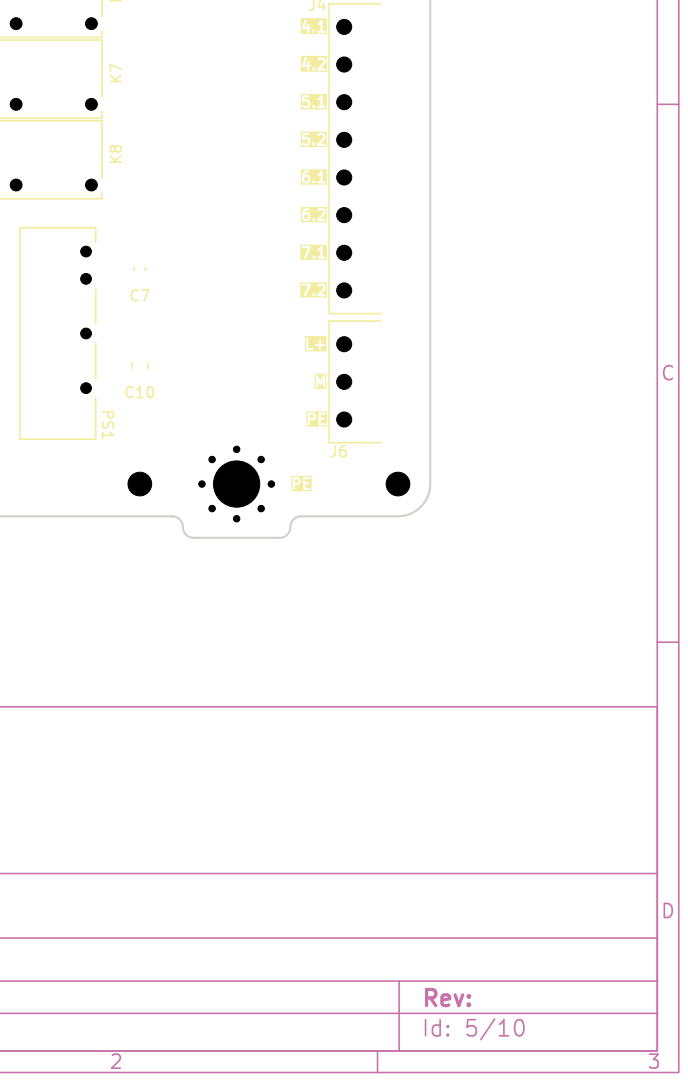
[picture p152: page 5]

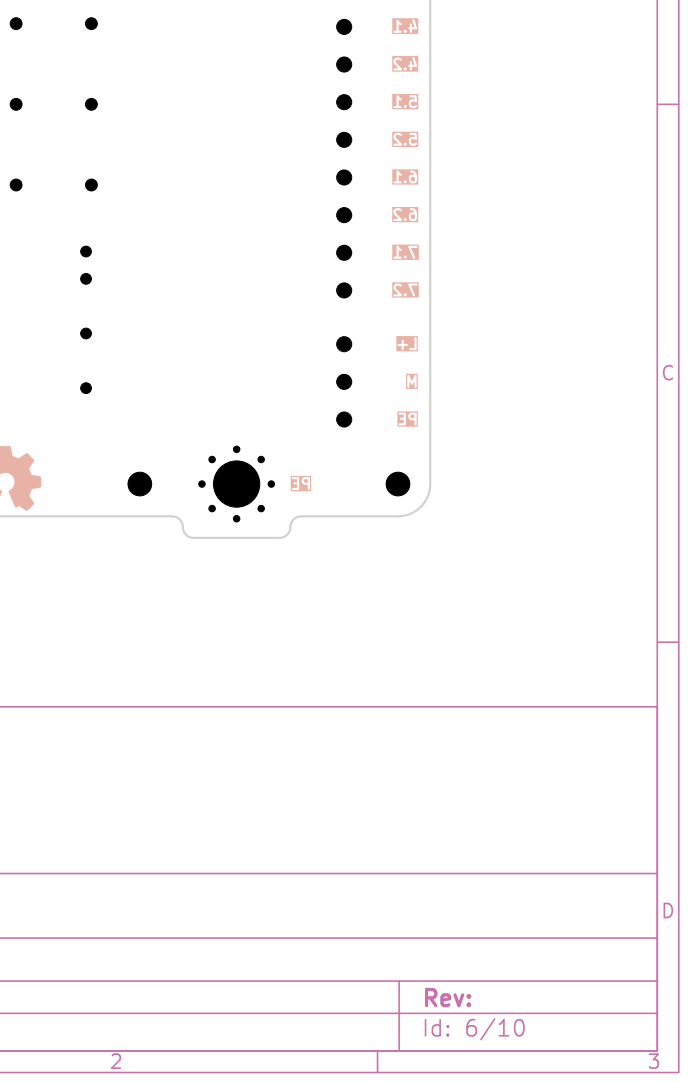
[picture p153: page 6]

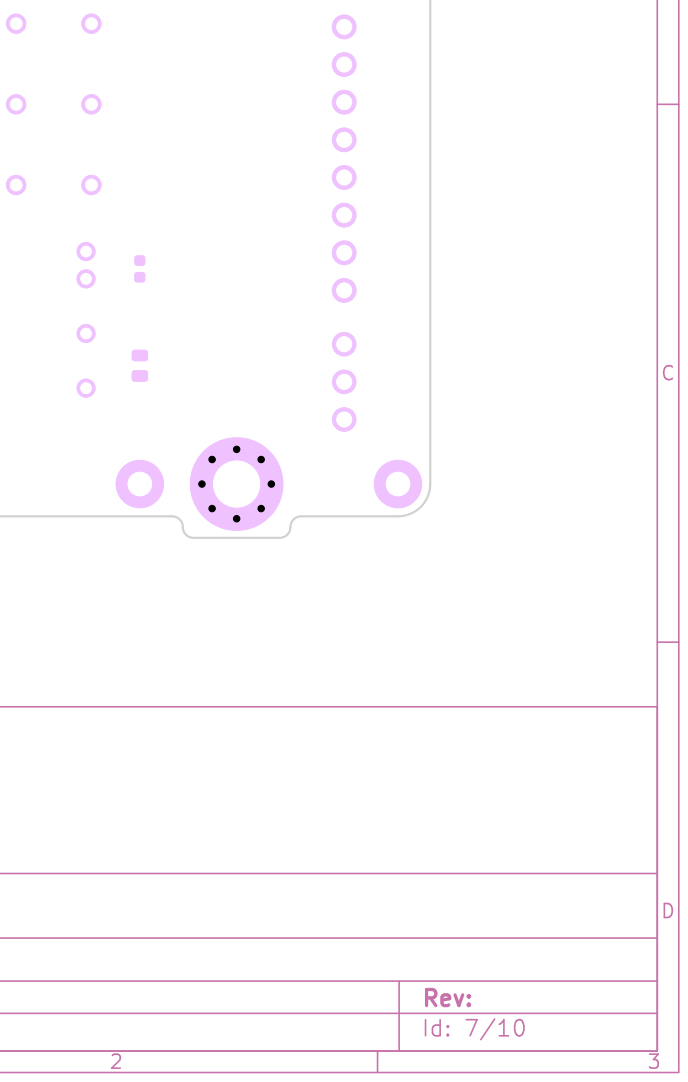
[picture p154: page 7]

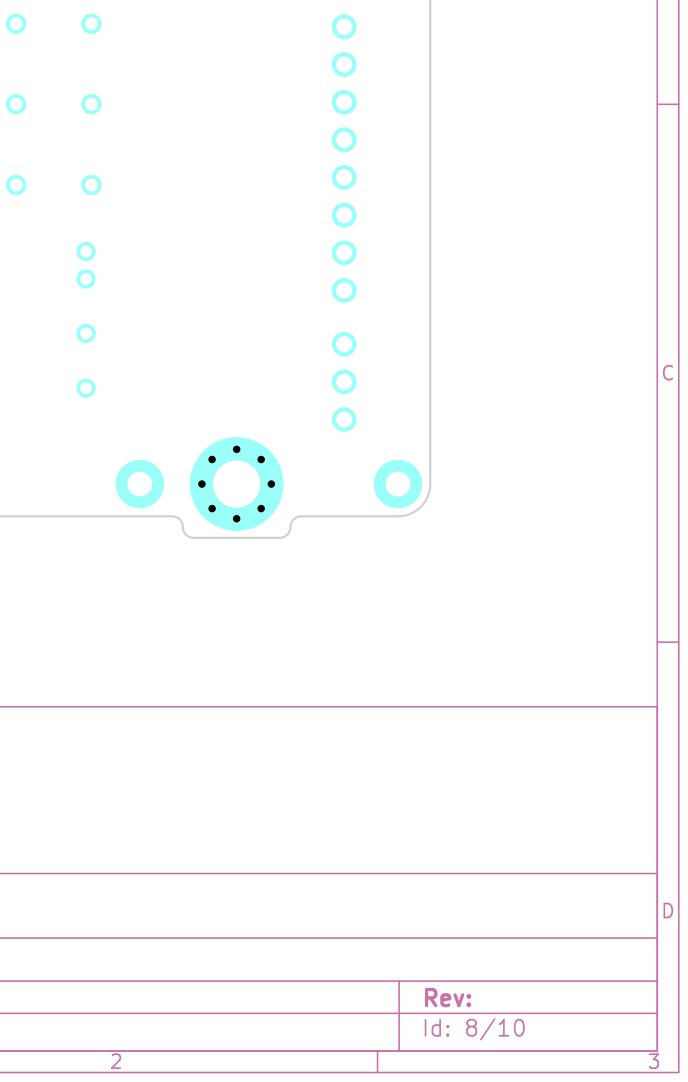
[picture p155: page 8]

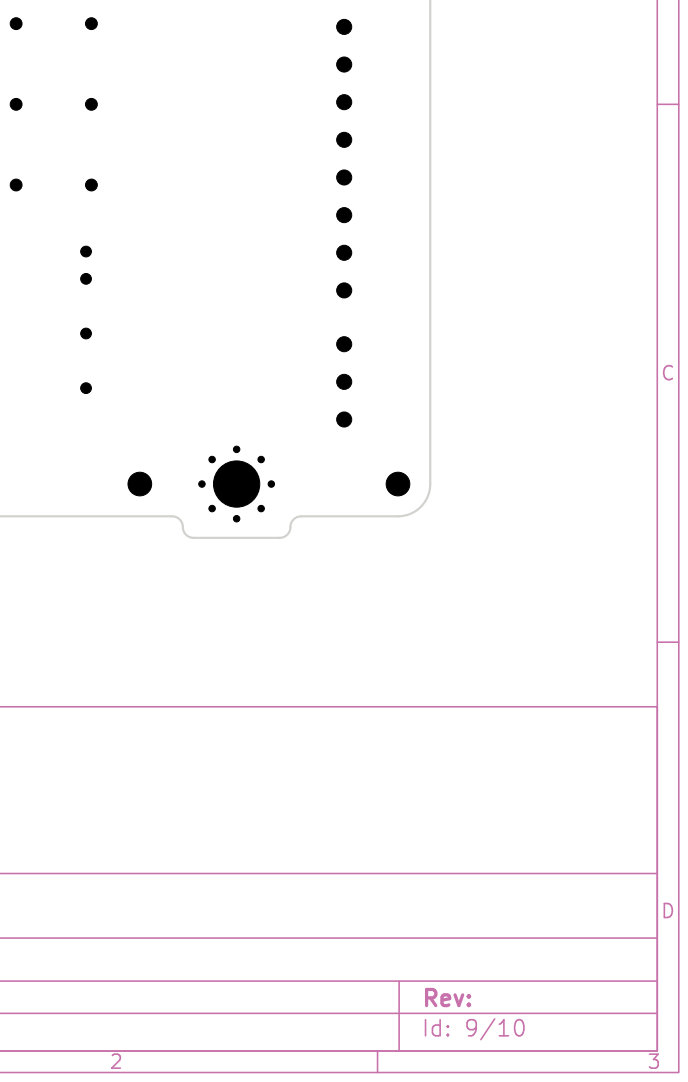
[picture p156: page 9]

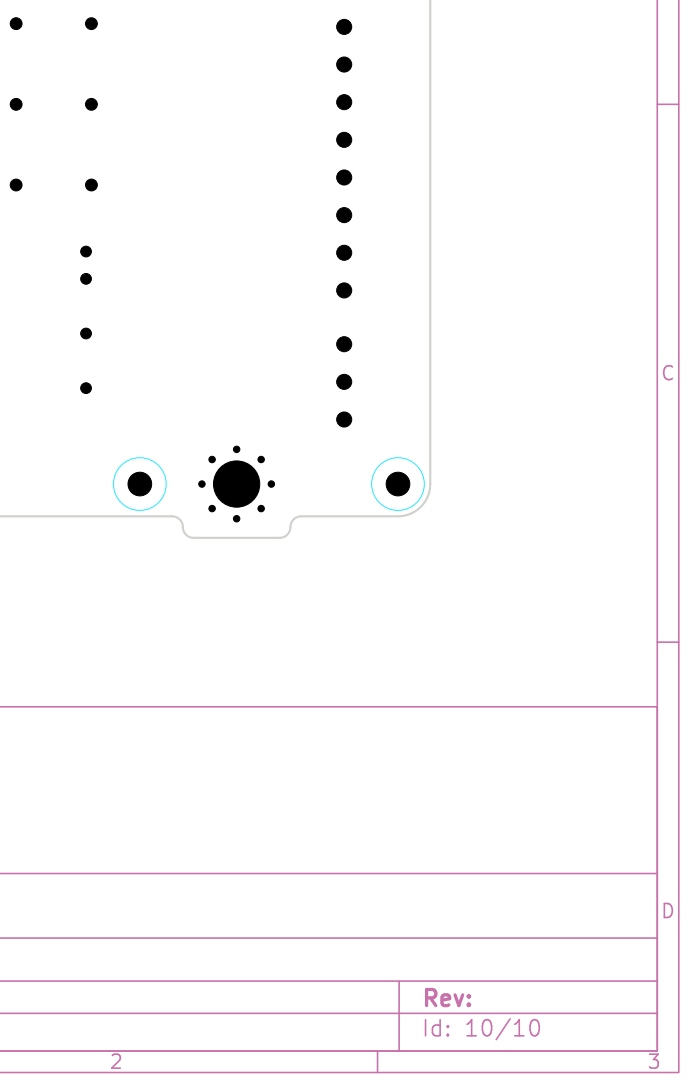
[picture p157: page 10]
