Konstantin-Dudersky/plc-modules/pcb/PMCNV-RQx8-v0.1.0/export/v0.0.9/PCB schematic/PMCNV-RQx8.pdf

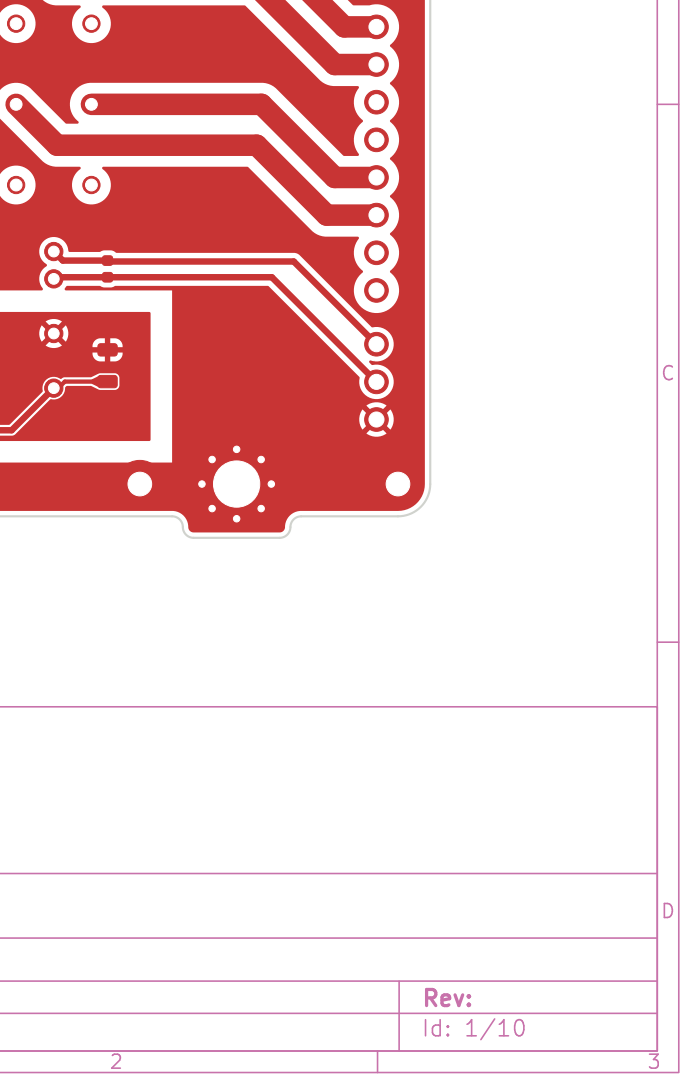
[picture p158: page 1]

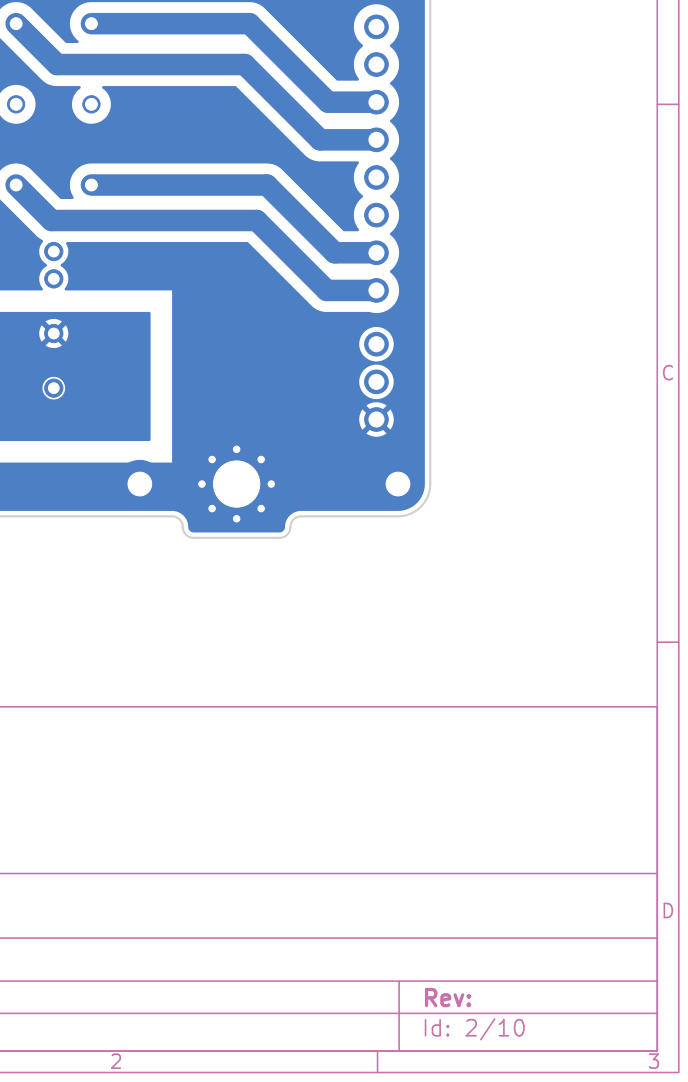
[picture p159: page 2]

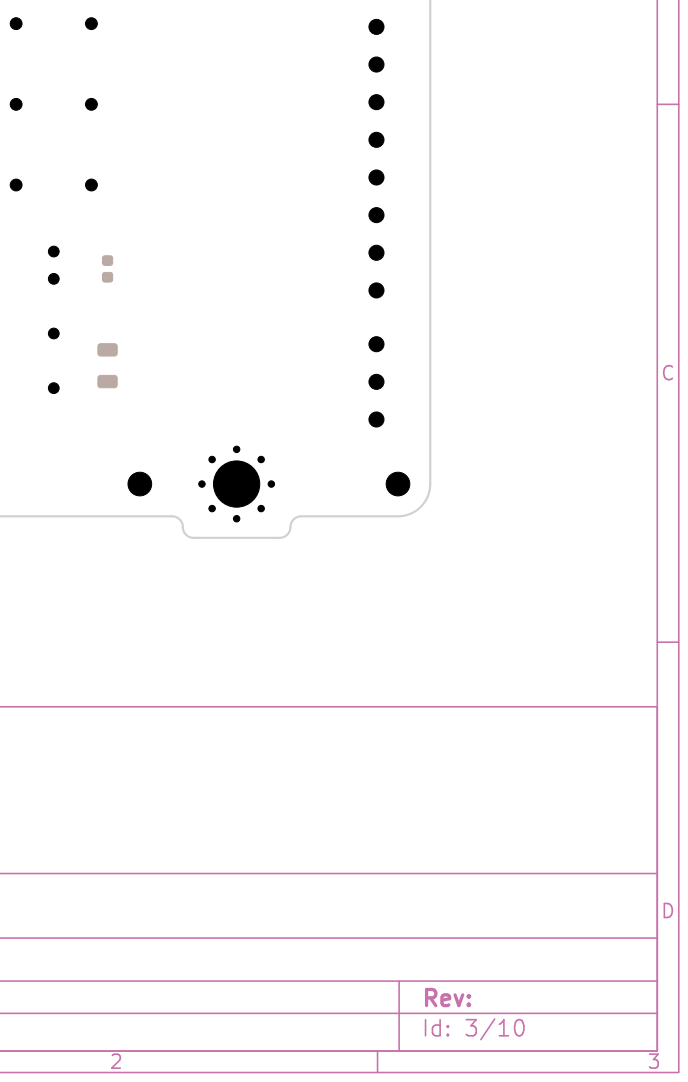
[picture p160: page 3]

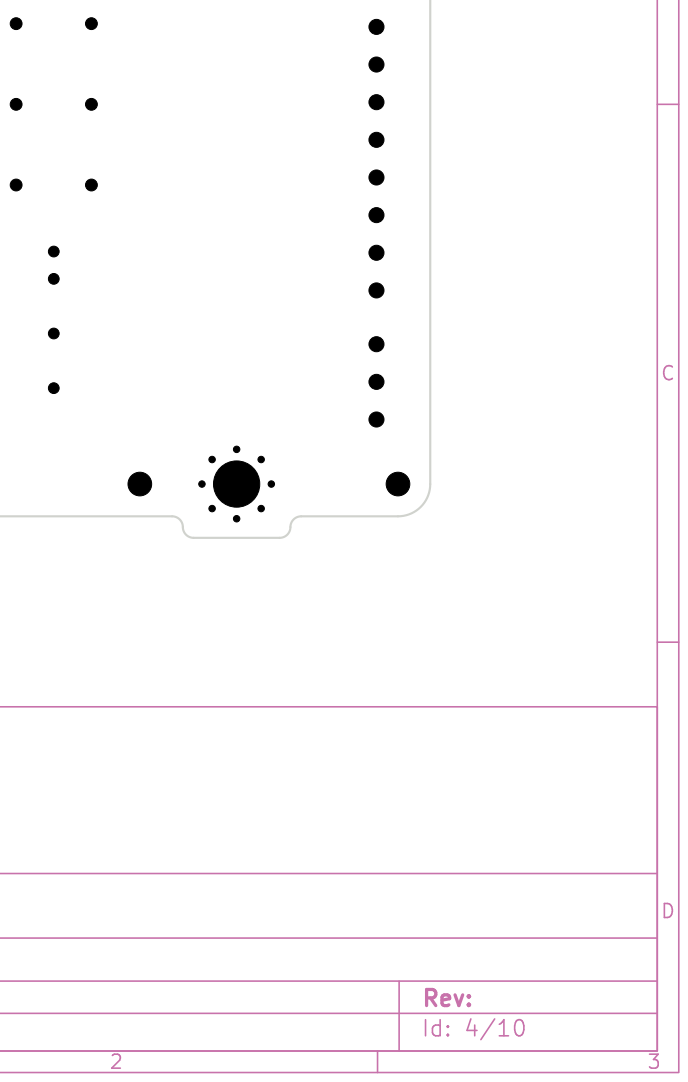
[picture p161: page 4]

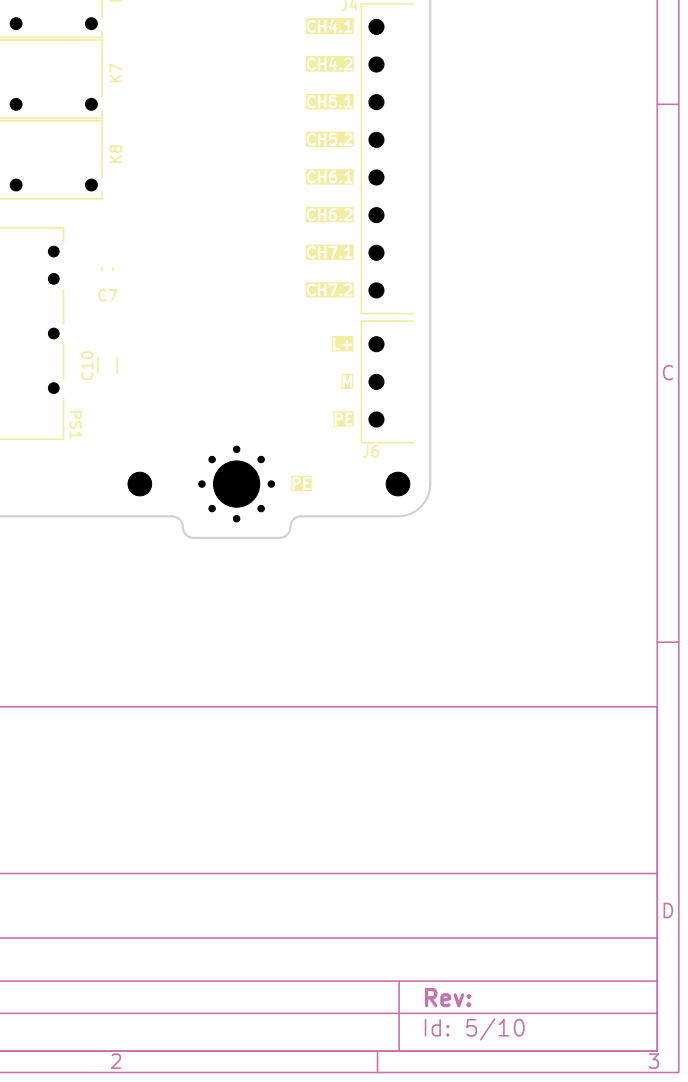
[picture p162: page 5]

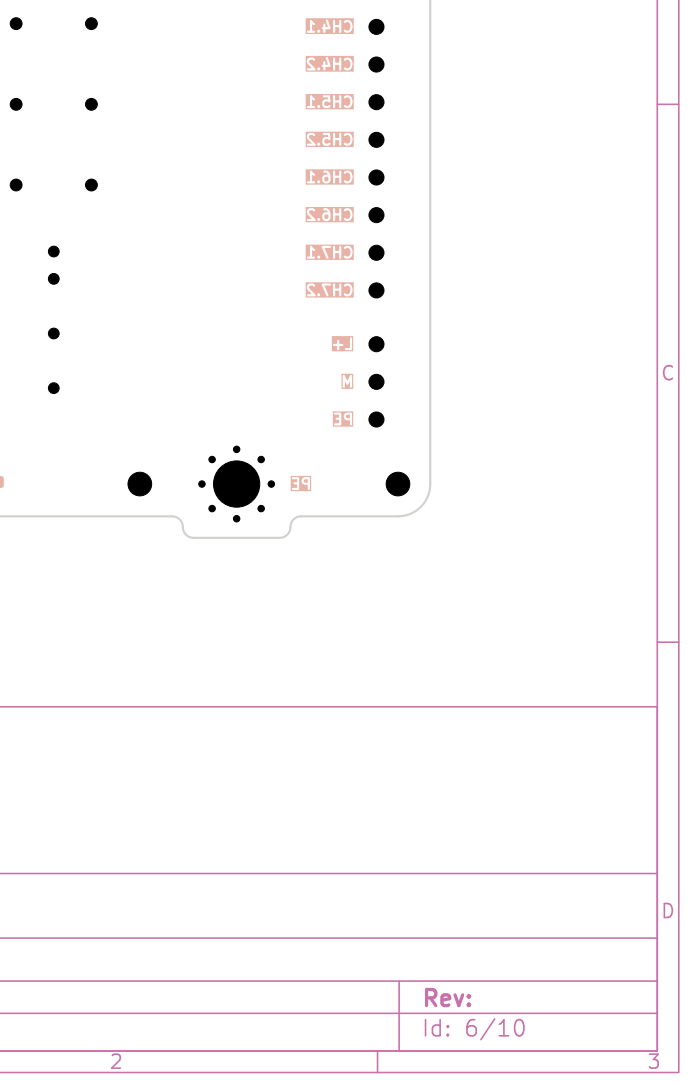
[picture p163: page 6]

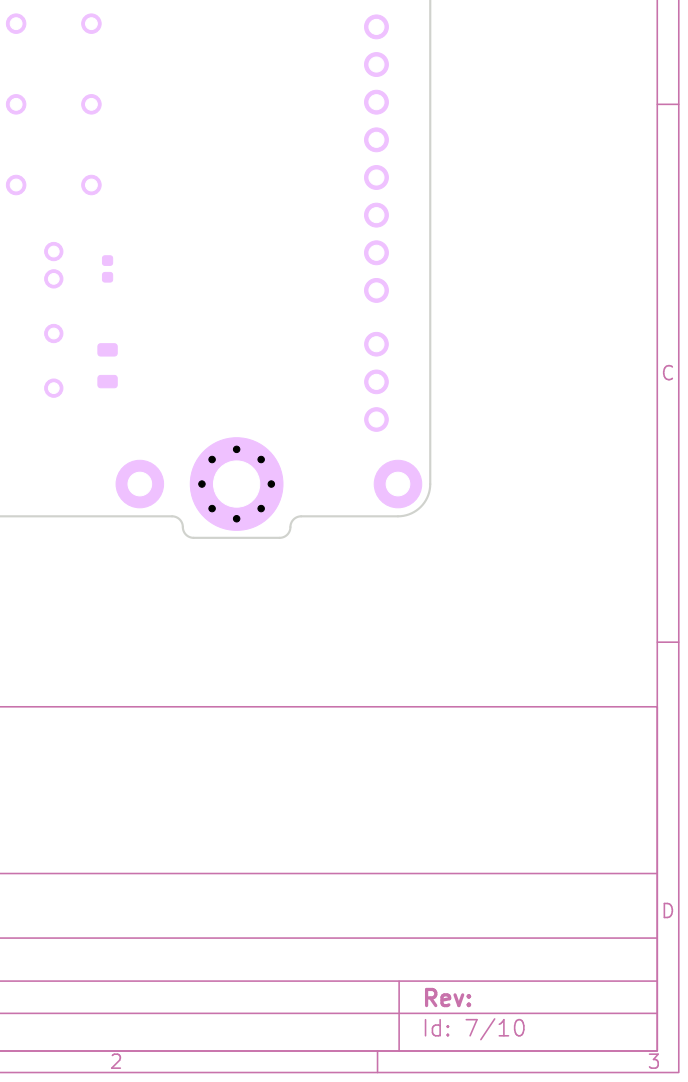
[picture p164: page 7]

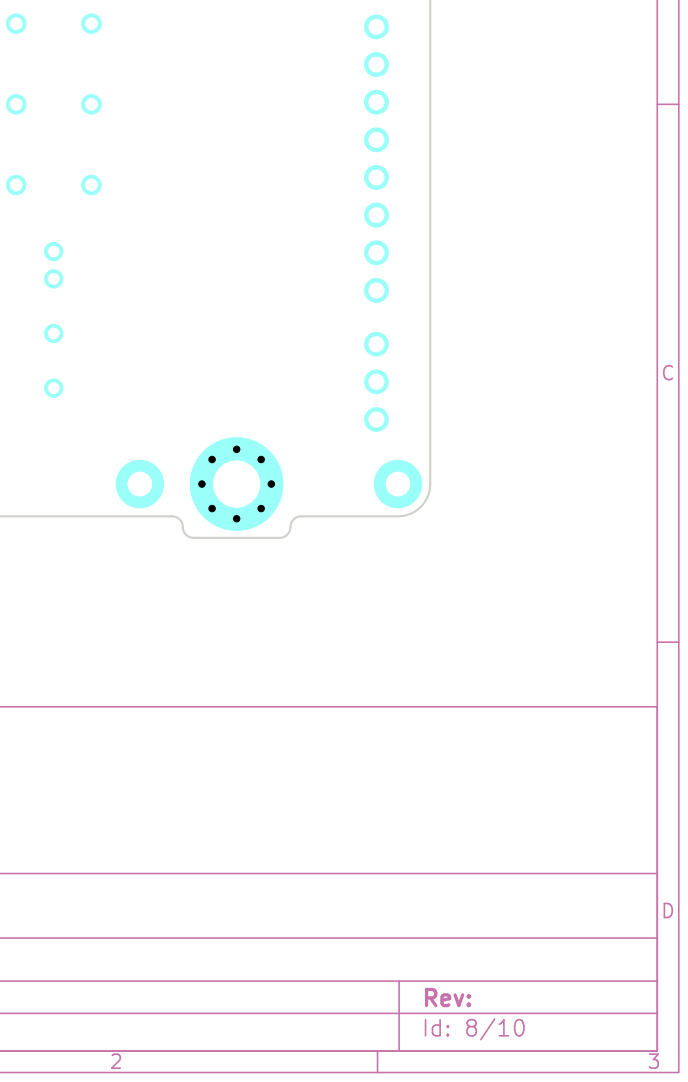
[picture p165: page 8]

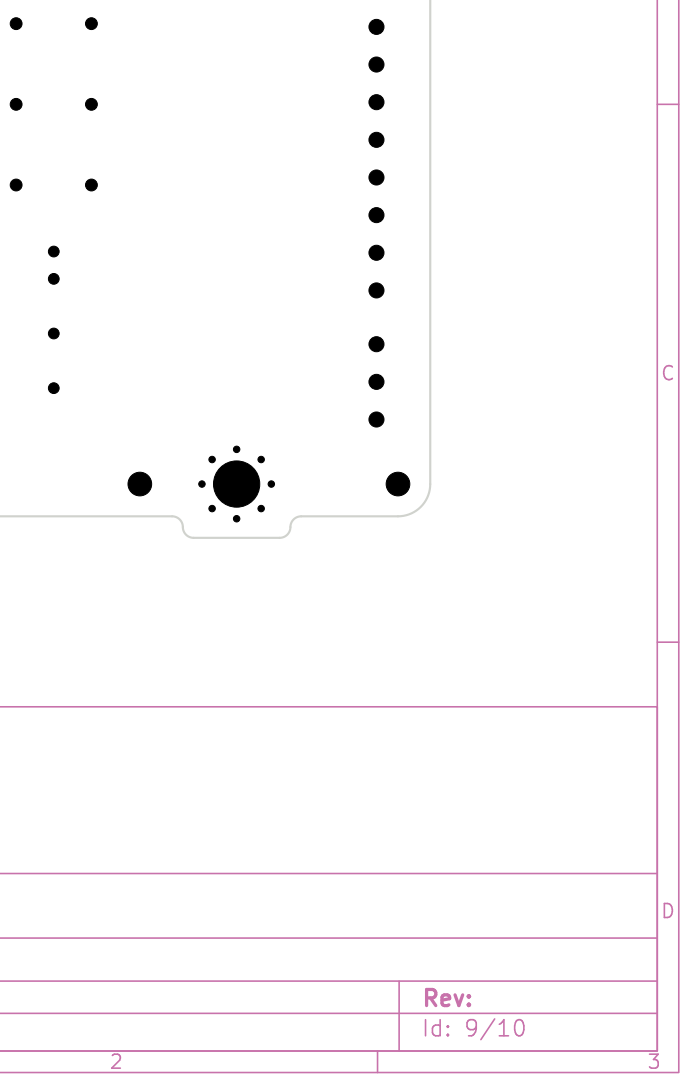
[picture p166: page 9]

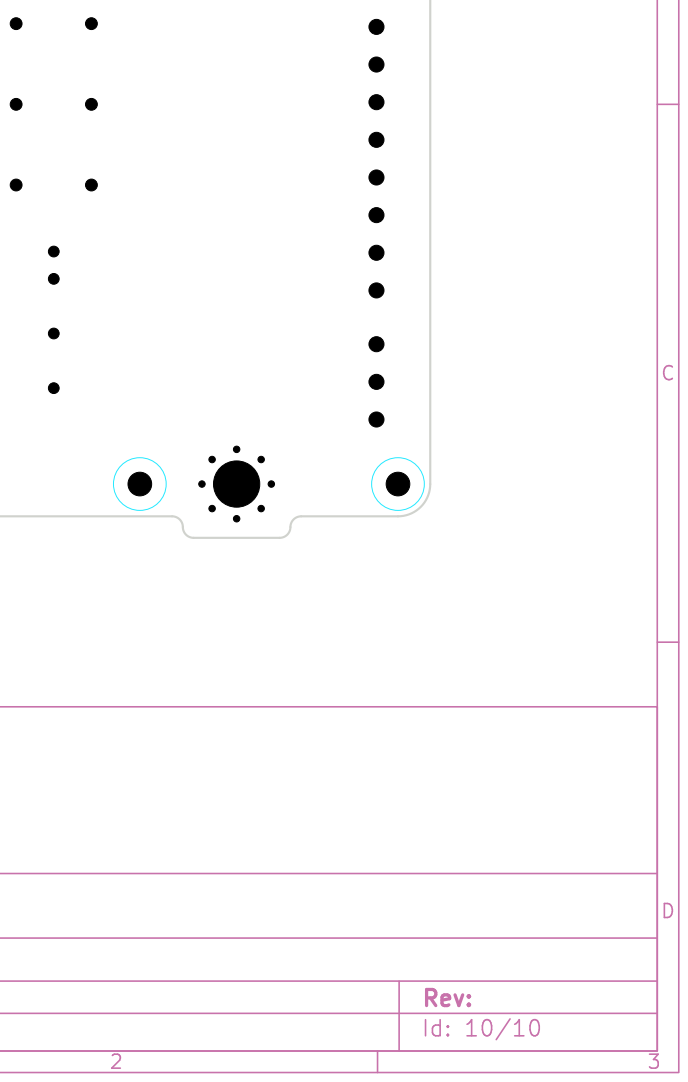
[picture p167: page 10]
