Konstantin-Dudersky/plc-modules/pcb/PMCPU-LLP-v0.1.0/export/v0.0.4/PCB schematic/PMCPU-LLP.pdf

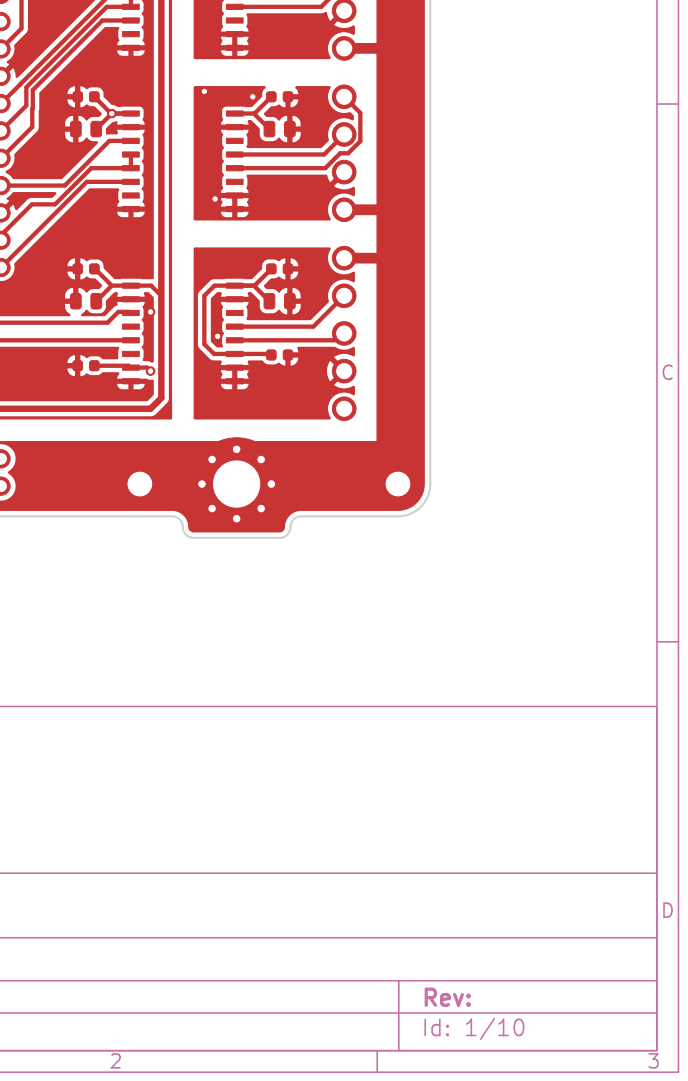
[picture p168: page 1]

Id: 1/10 Title: PMCPU-LLP v0.0.4

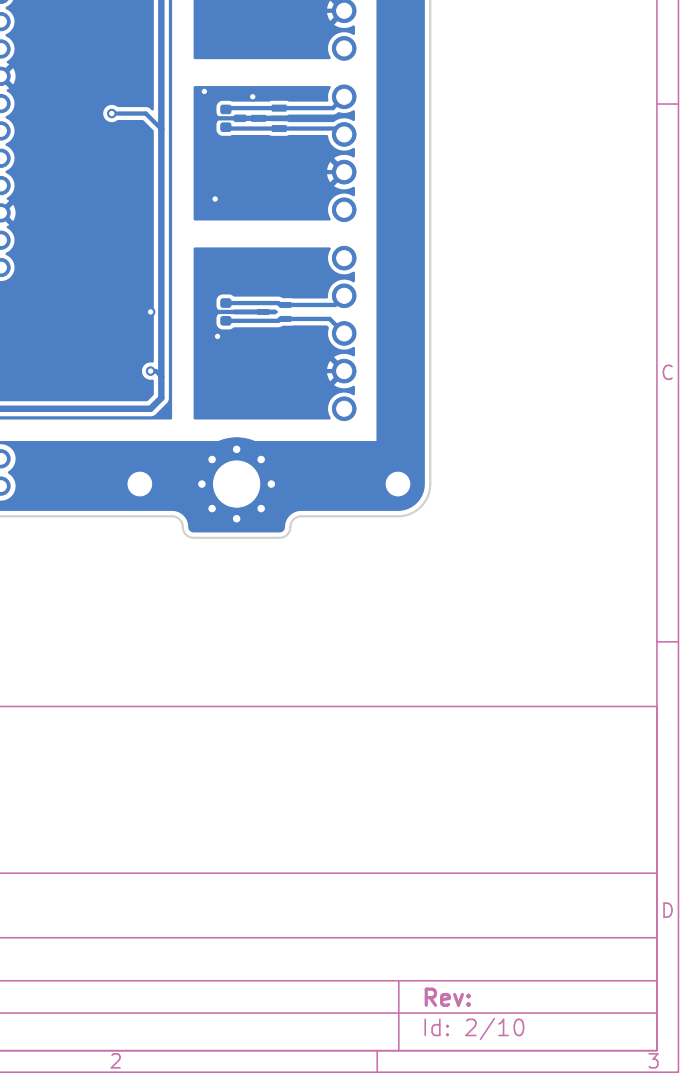
[picture p169: page 2]

Id: 2/10 Title: PMCPU-LLP v0.0.4

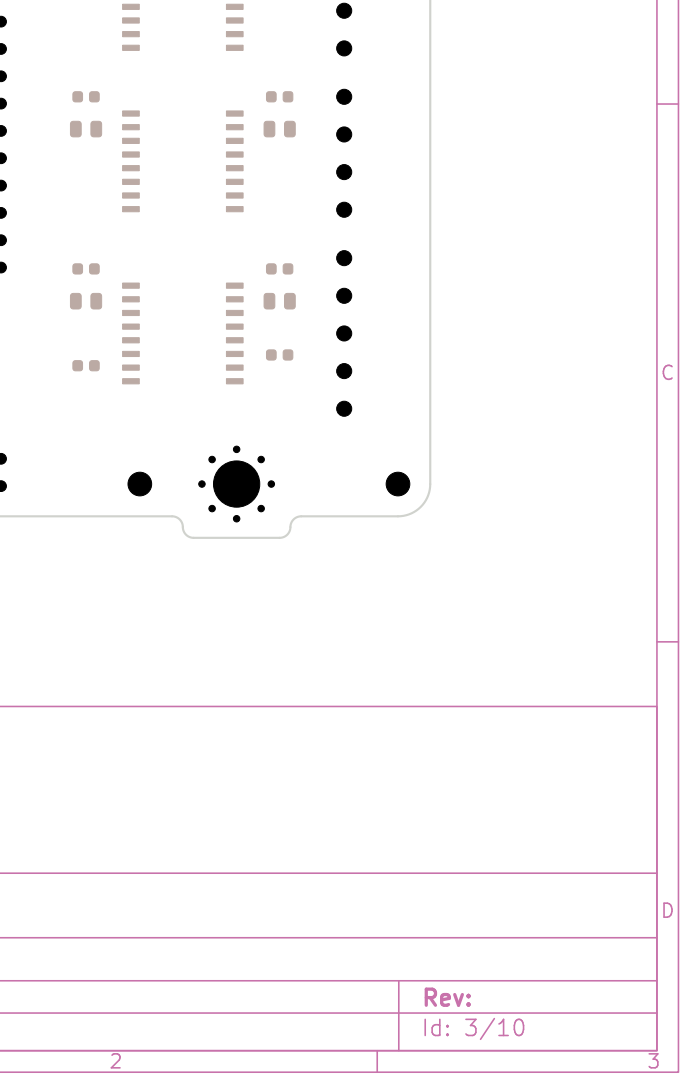
[picture p170: page 3]

Id: 3/10 Title: PMCPU-LLP v0.0.4

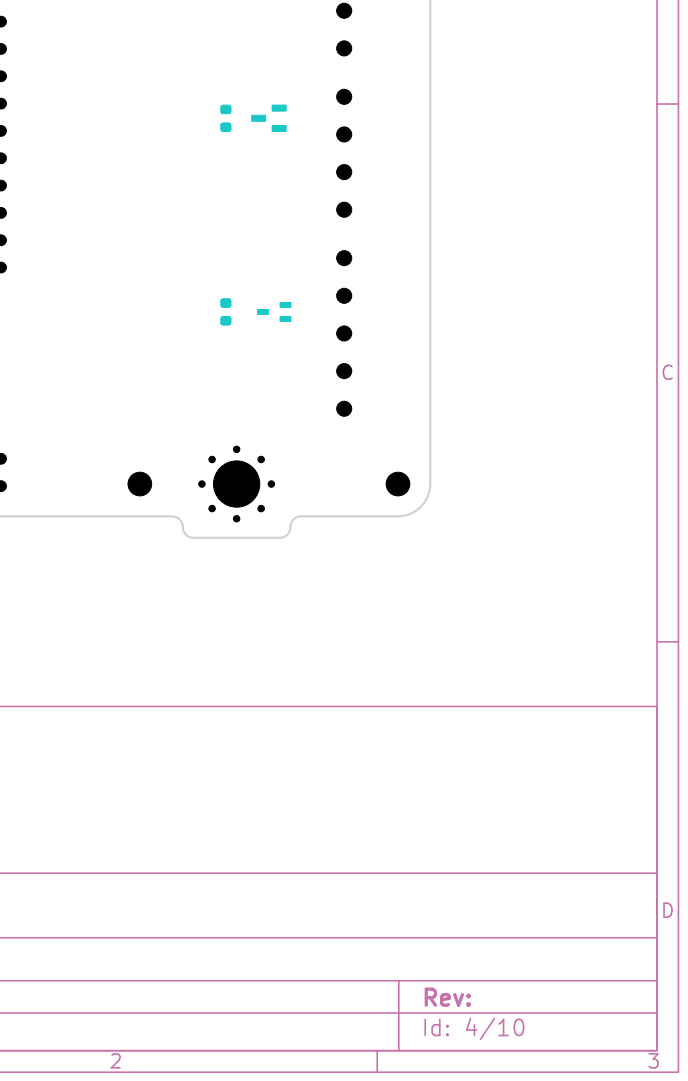
[picture p171: page 4]

Id: 4/10 Title: PMCPU-LLP v0.0.4

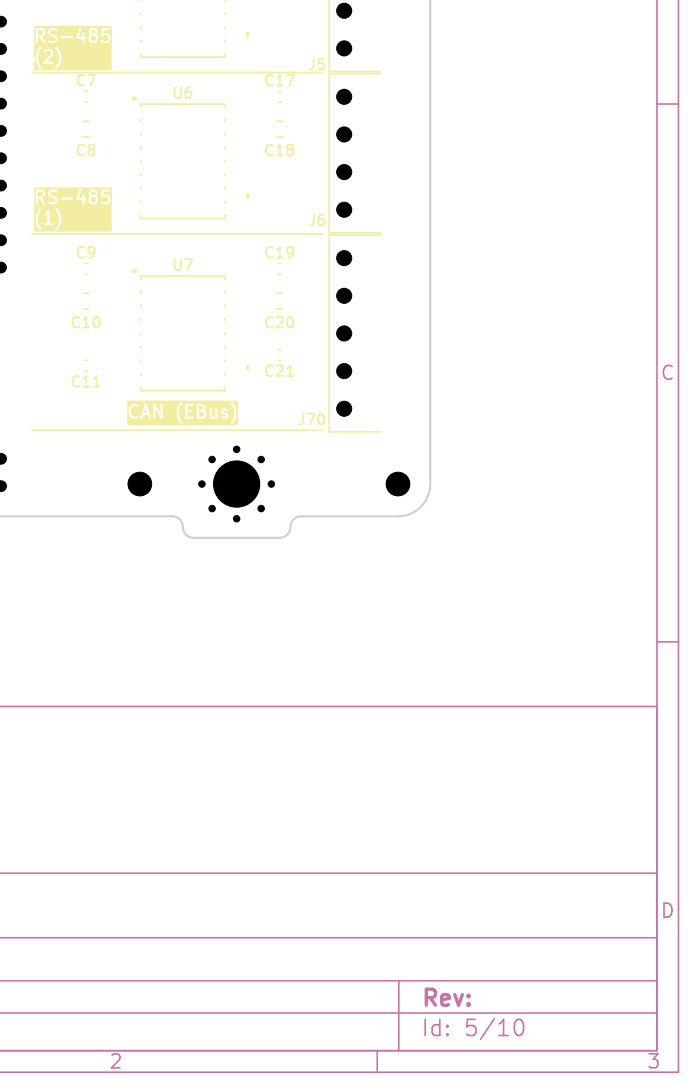
[picture p172: page 5]

Id: 5/10 Title: PMCPU-LLP v0.0.4

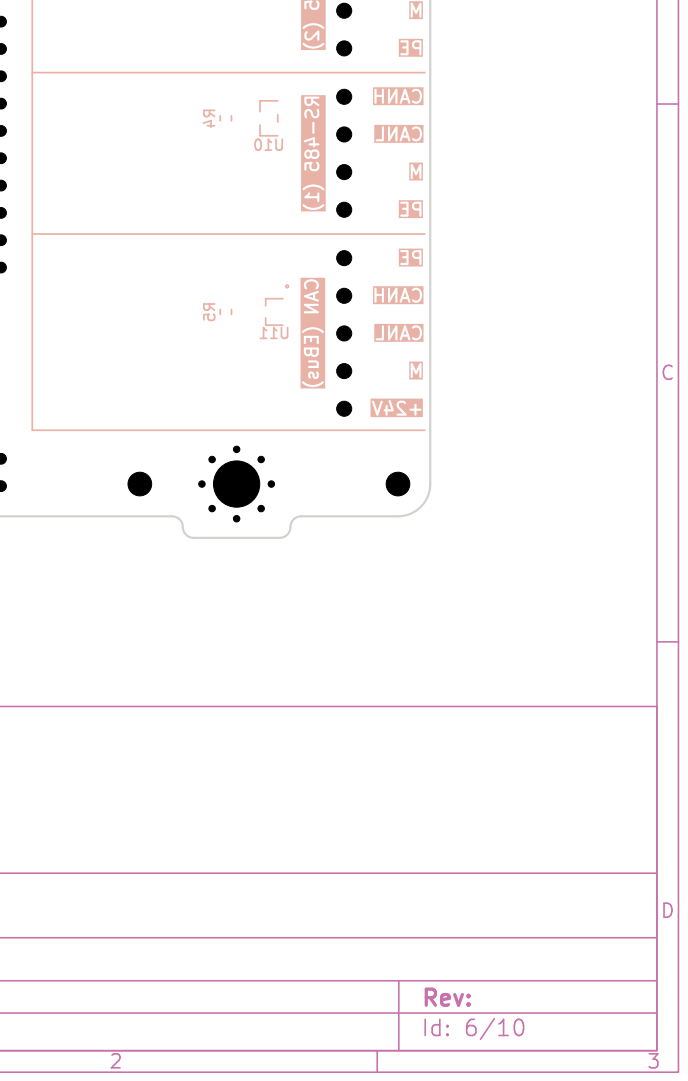
[picture p173: page 6]

Id: 6/10 Title: PMCPU-LLP v0.0.4

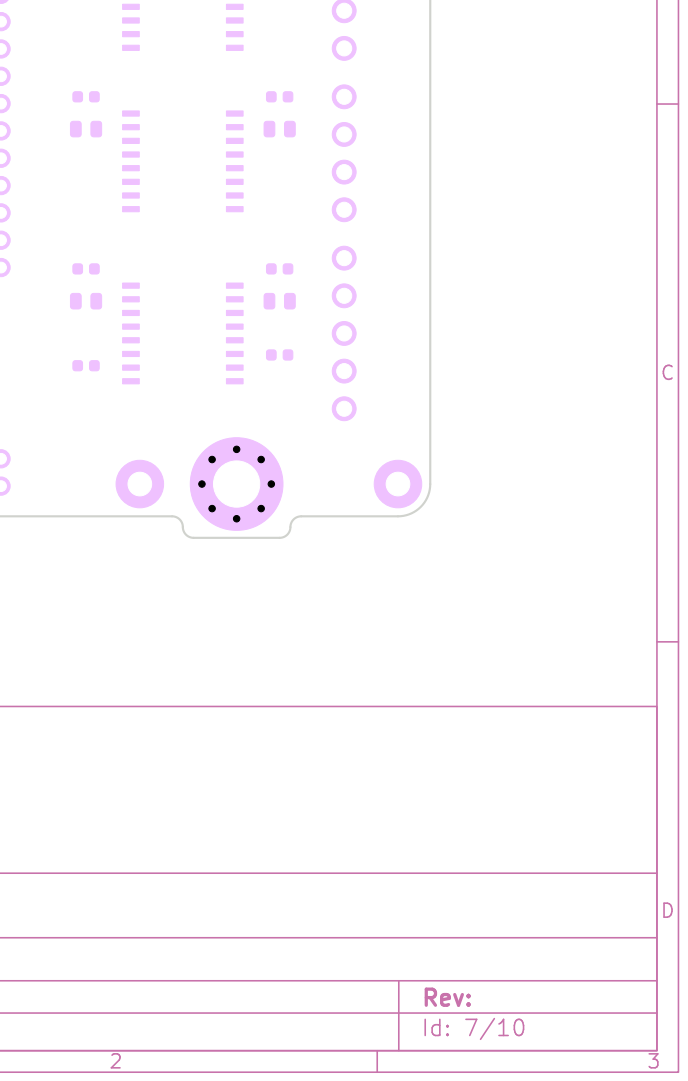
[picture p174: page 7]

Id: 7/10 Title: PMCPU-LLP v0.0.4

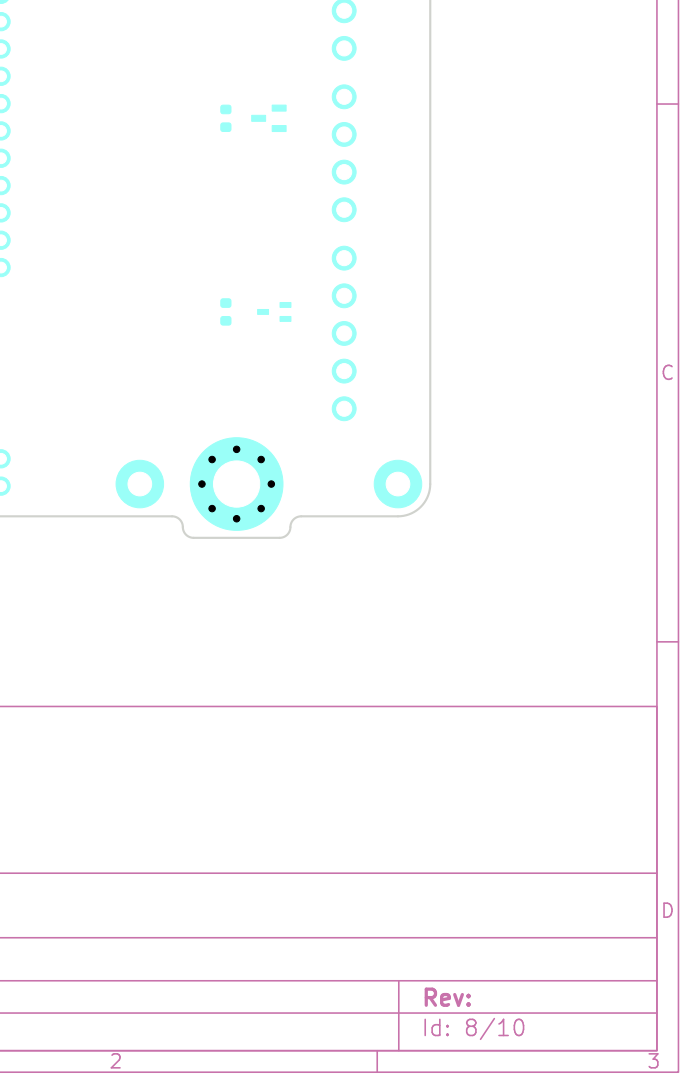
[picture p175: page 8]

Id: 8/10 Title: PMCPU-LLP v0.0.4

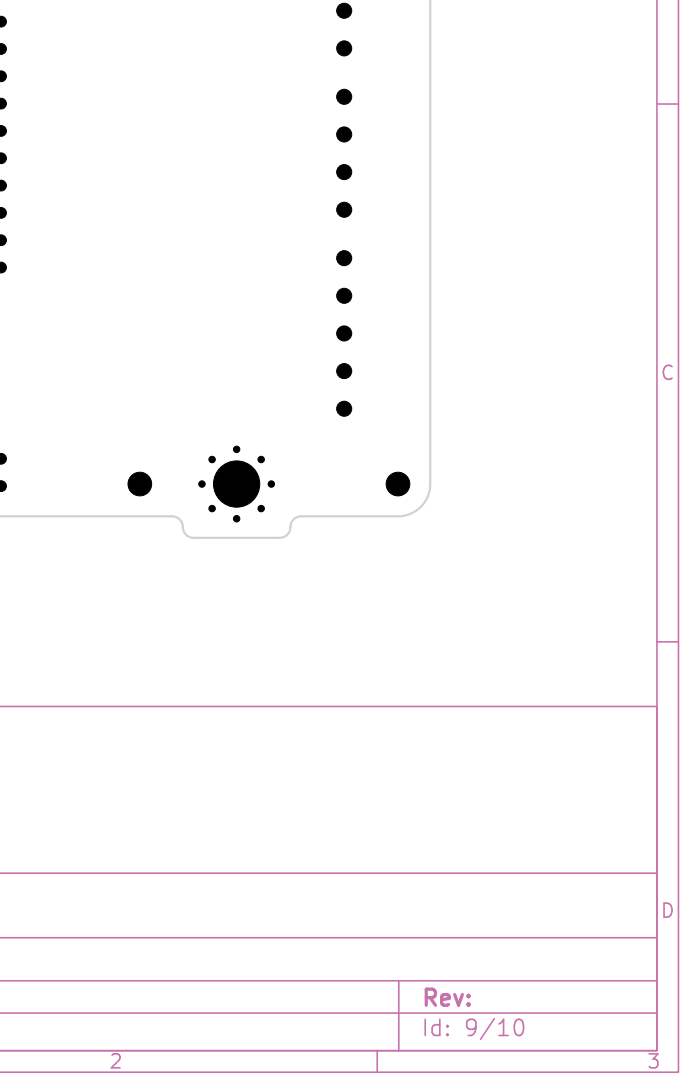
[picture p176: page 9]

Id: 9/10 Title: PMCPU-LLP v0.0.4

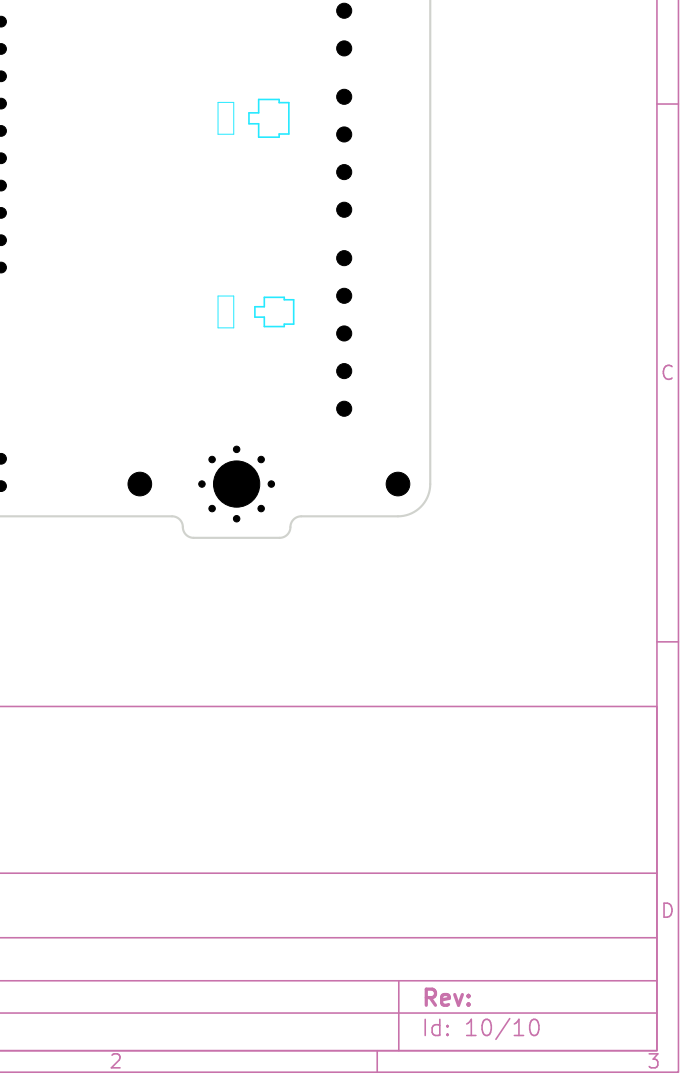
[picture p177: page 10]

Id: 10/10 Title: PMCPU-LLP v0.0.4
