Konstantin-Dudersky/plc-modules/pcb/PMCPU-LLP-v0.1.0/export/v0.0.5/PCB schematic/PMCPU-LLP.pdf

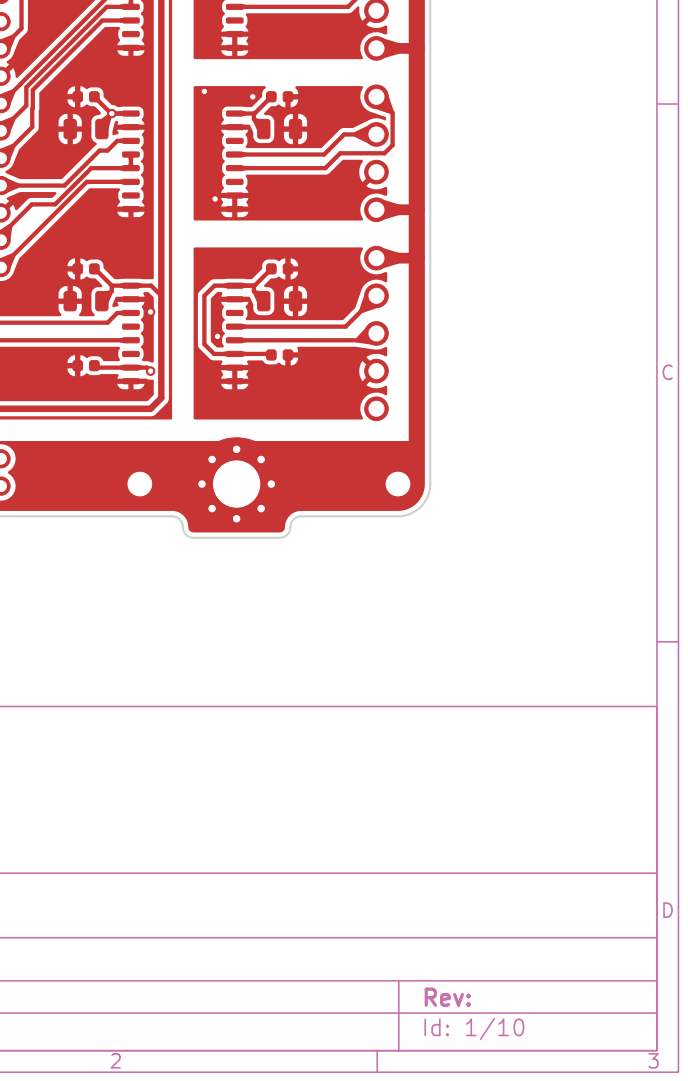
[picture p178: page 1]

Id: 1/10 Title: PMCPU-LLP v0.0.5

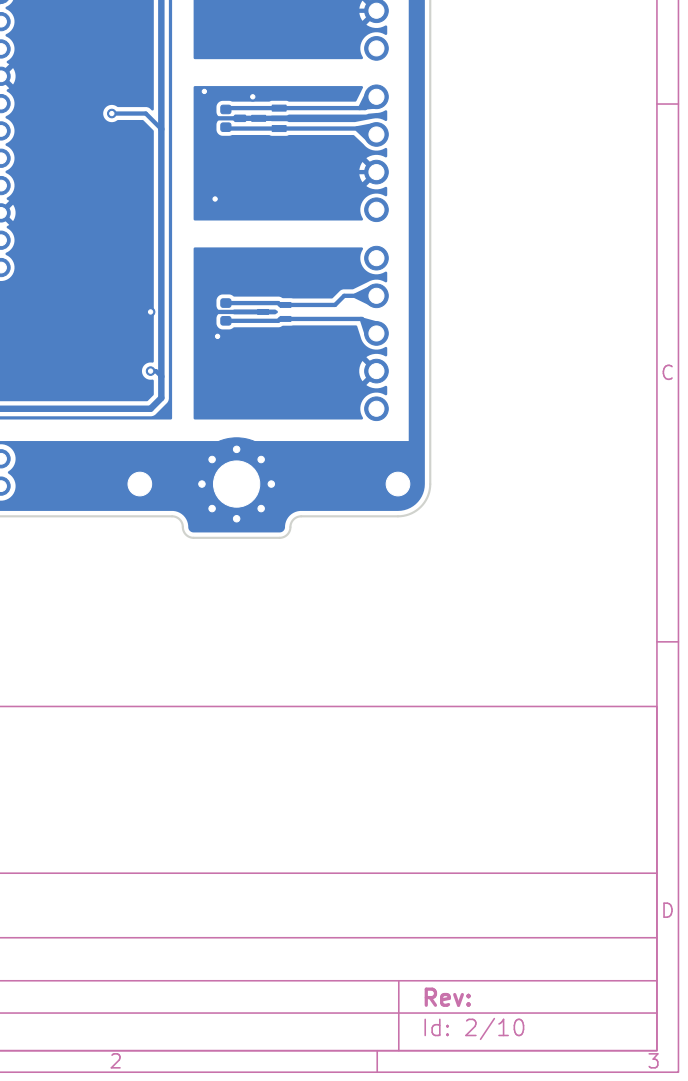
[picture p179: page 2]

Id: 2/10 Title: PMCPU-LLP v0.0.5

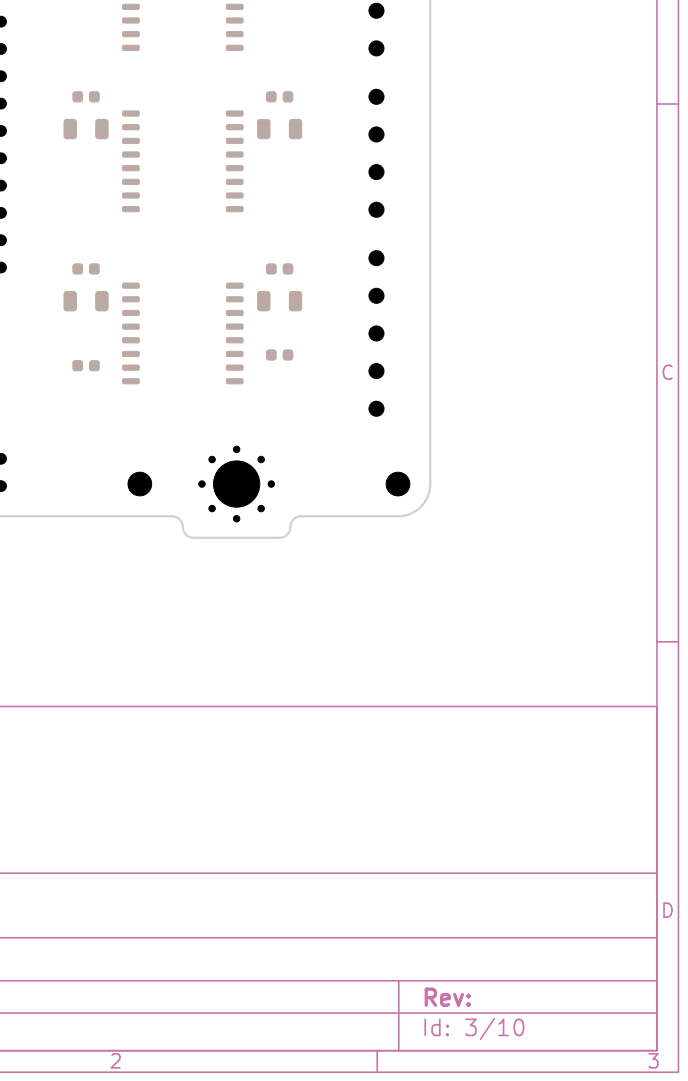
[picture p180: page 3]

Id: 3/10 Title: PMCPU-LLP v0.0.5

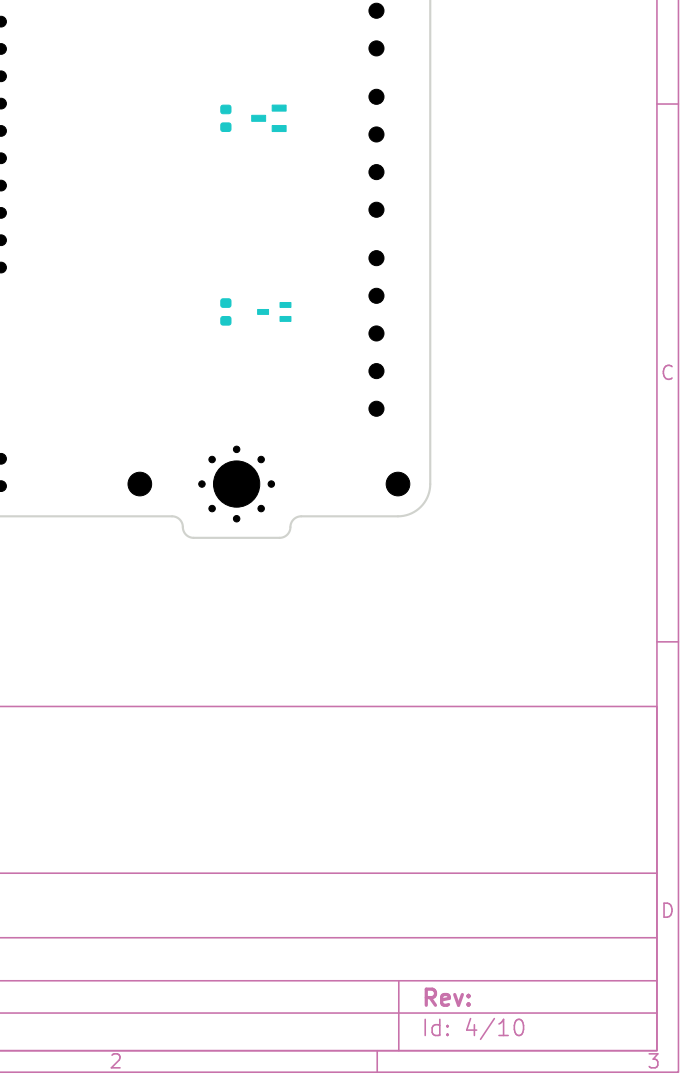
[picture p181: page 4]

Id: 4/10 Title: PMCPU-LLP v0.0.5

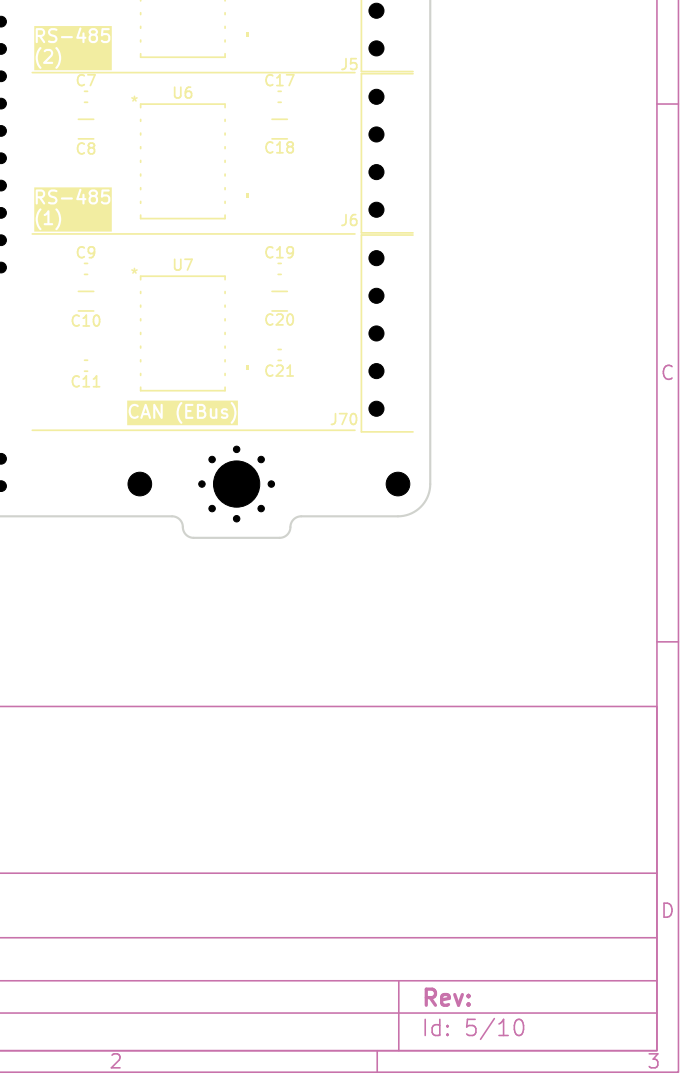
[picture p182: page 5]

Id: 5/10 Title: PMCPU-LLP v0.0.5

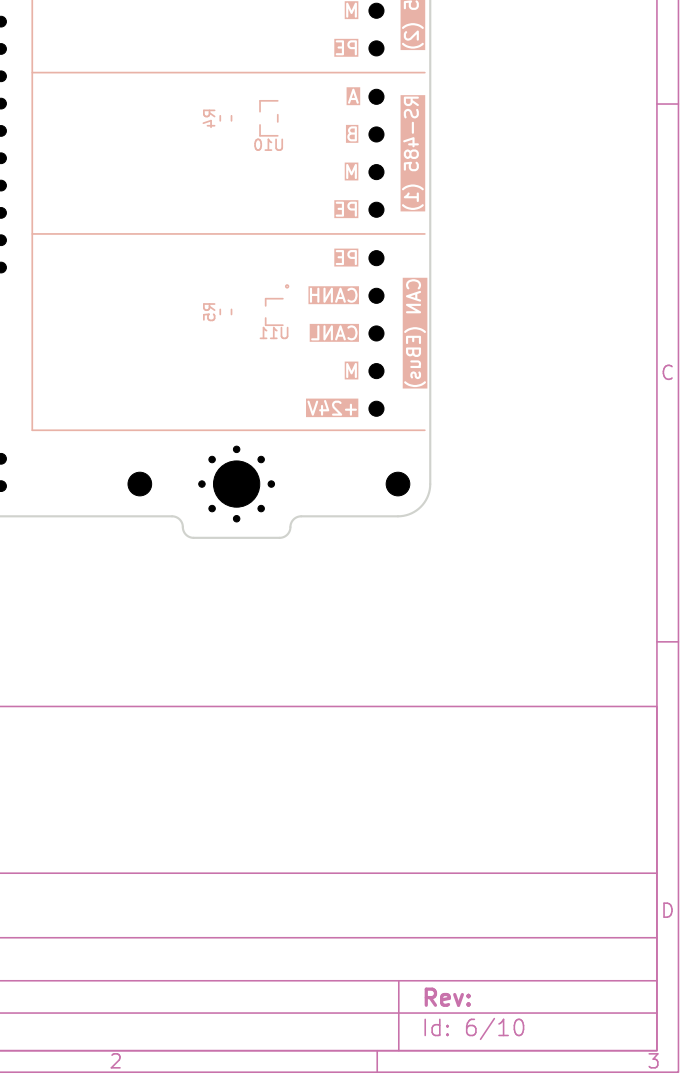
[picture p183: page 6]

Id: 6/10 Title: PMCPU-LLP v0.0.5

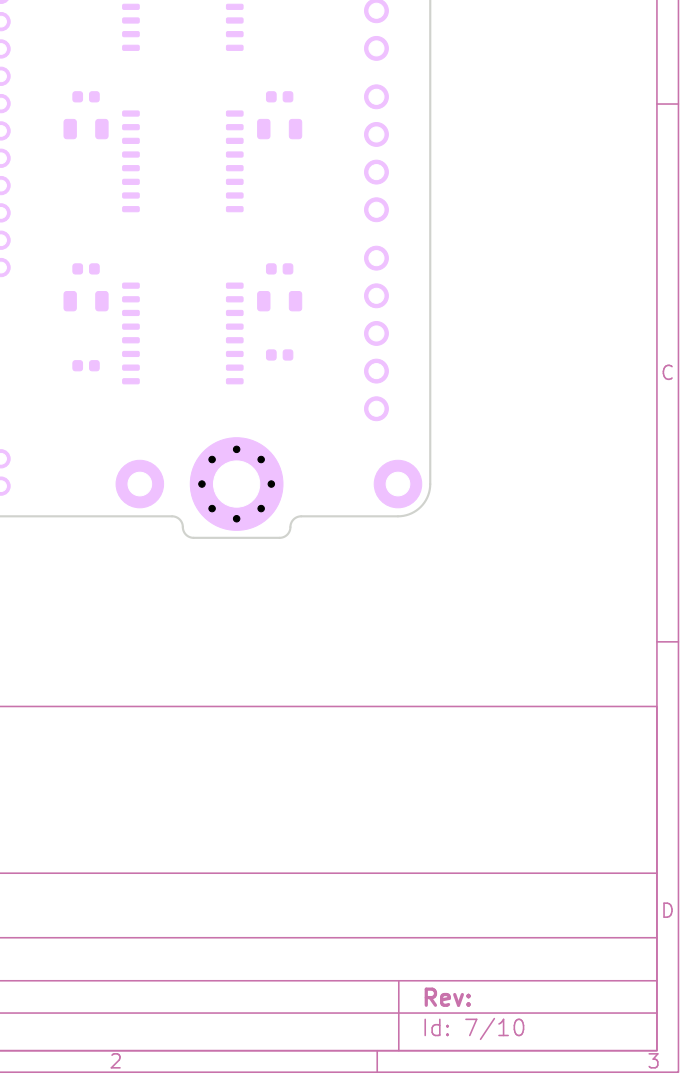
[picture p184: page 7]

Id: 7/10 Title: PMCPU-LLP v0.0.5

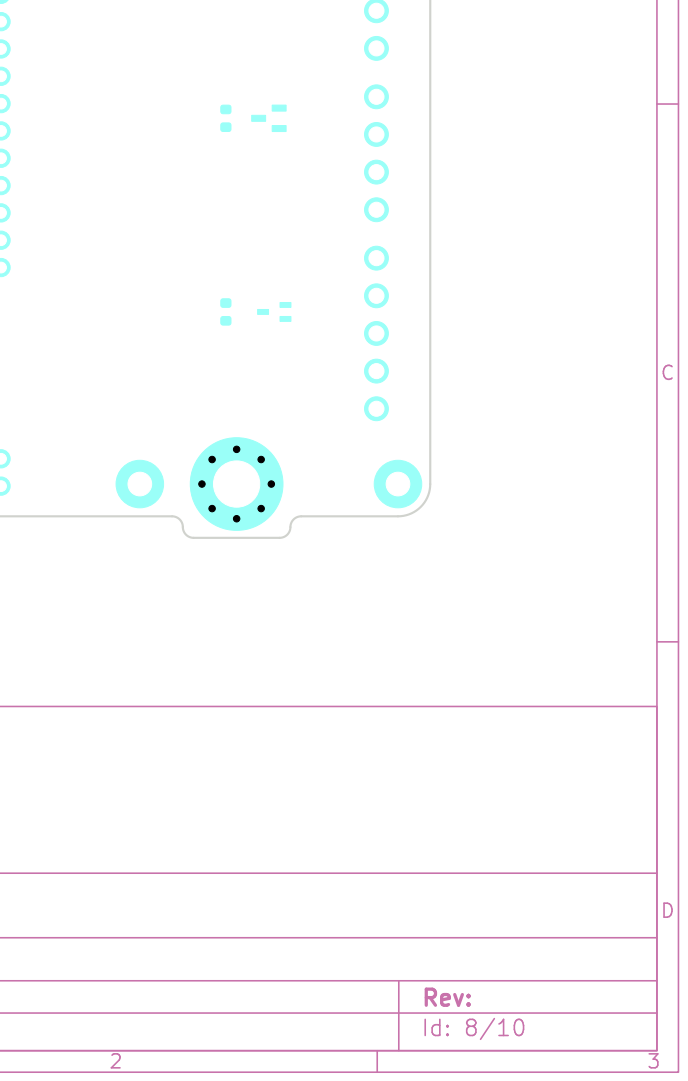
[picture p185: page 8]

Id: 8/10 Title: PMCPU-LLP v0.0.5

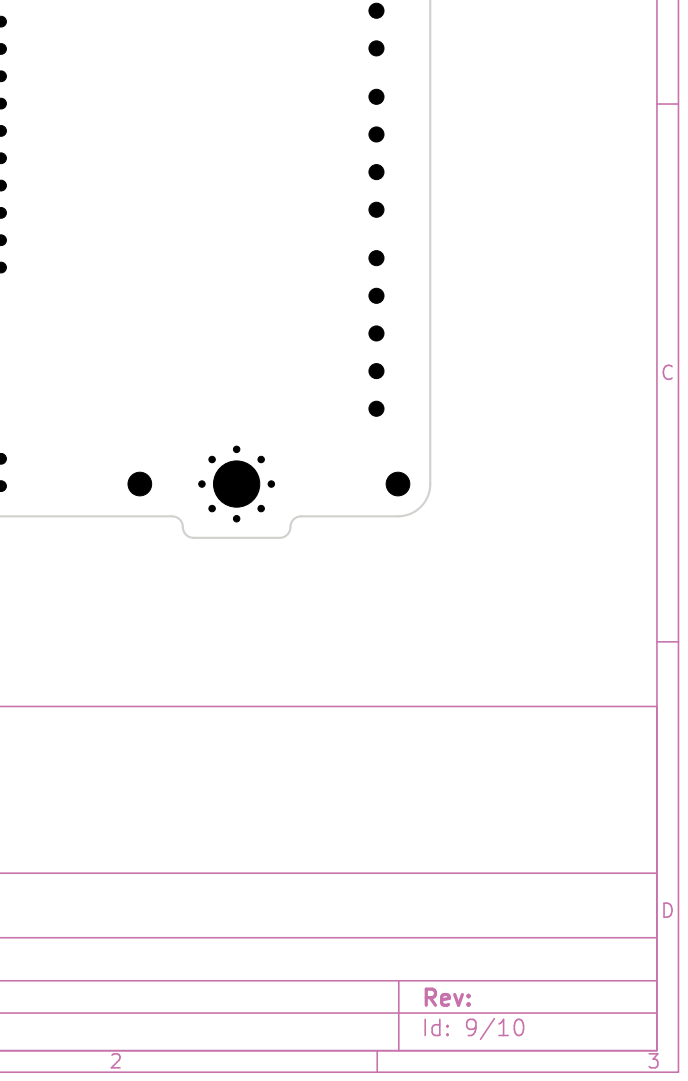
[picture p186: page 9]

Id: 9/10 Title: PMCPU-LLP v0.0.5

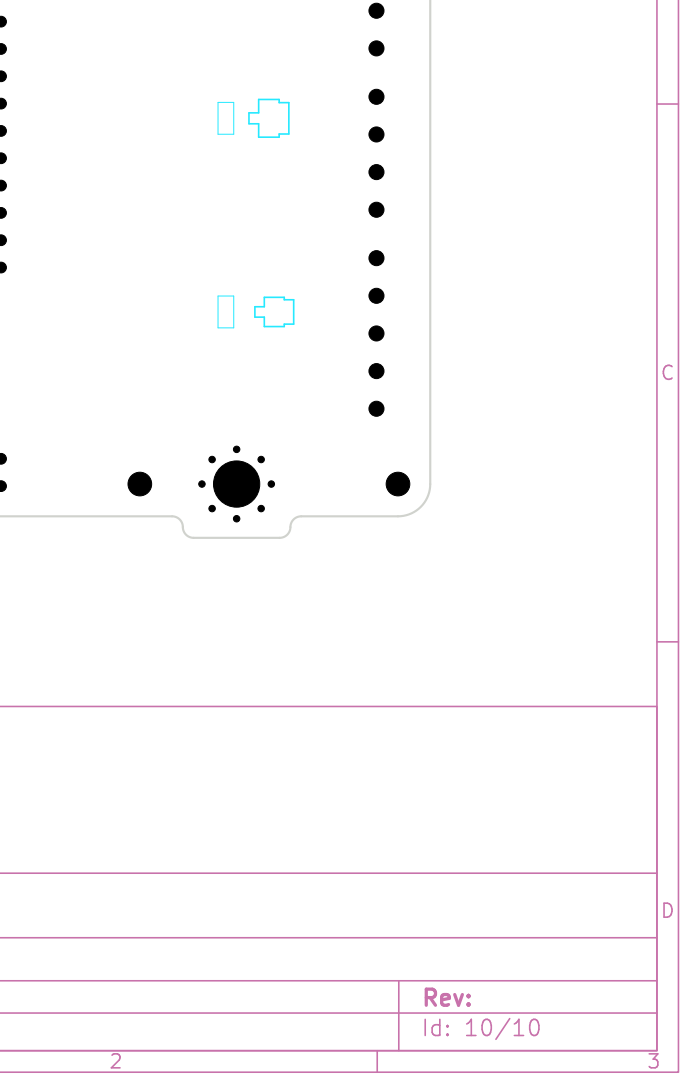
[picture p187: page 10]

Id: 10/10 Title: PMCPU-LLP v0.0.5
