Konstantin-Dudersky/plc-modules/pcb/PMPS-20W-v0.1.0/export/v0.0.5/PCB schematic/PMPS-20W.pdf

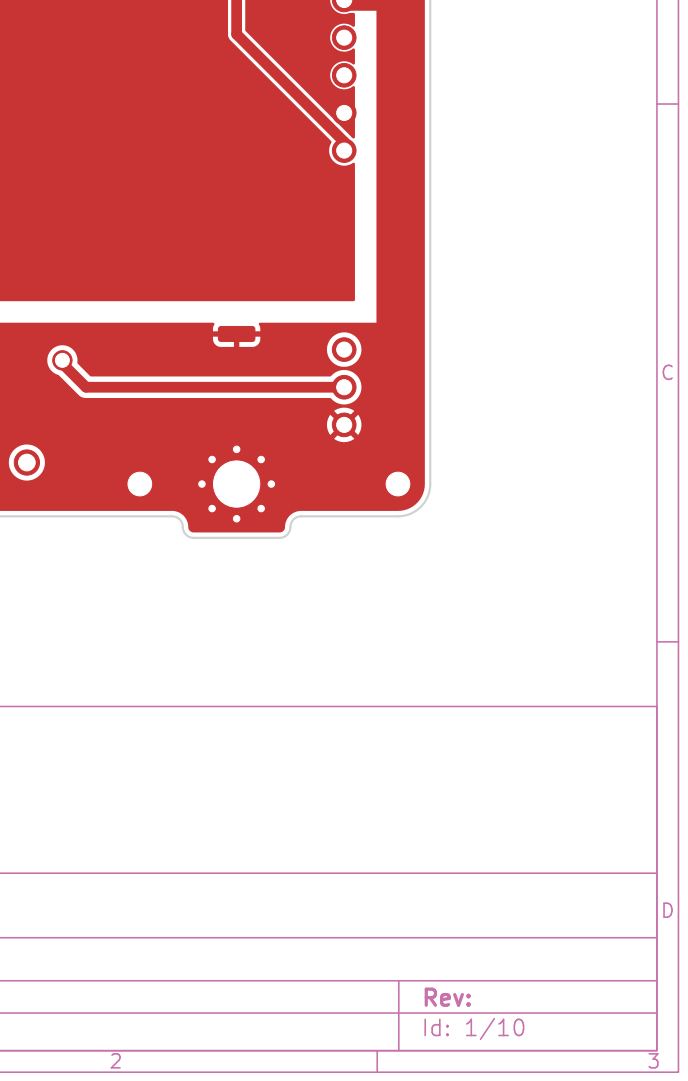
[picture p188: page 1]

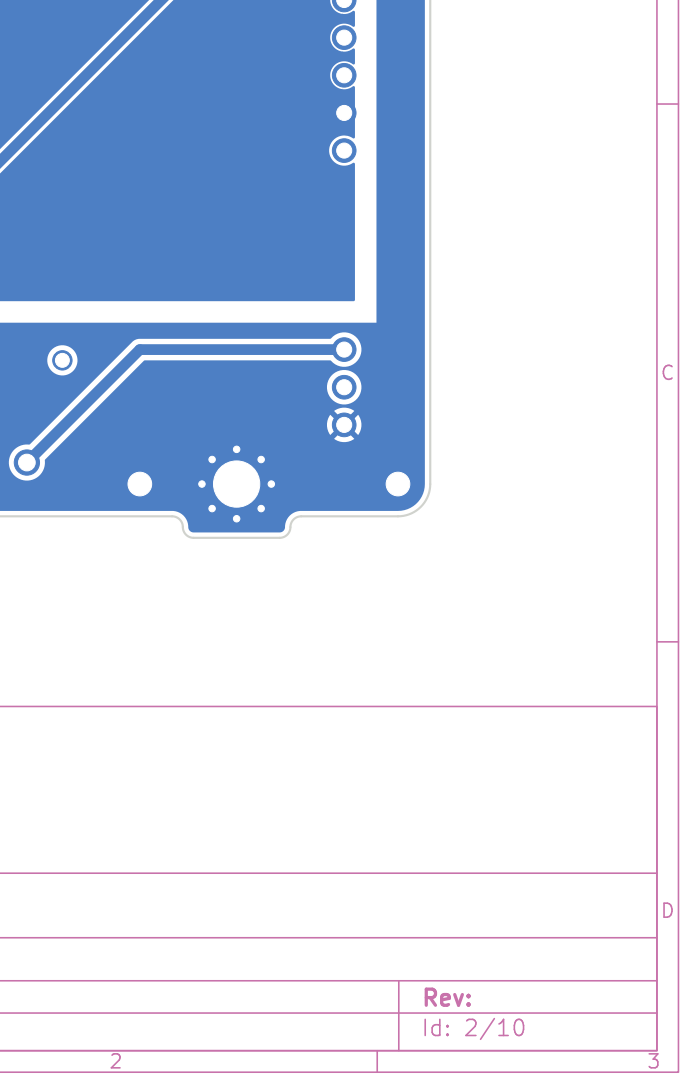
[picture p189: page 2]

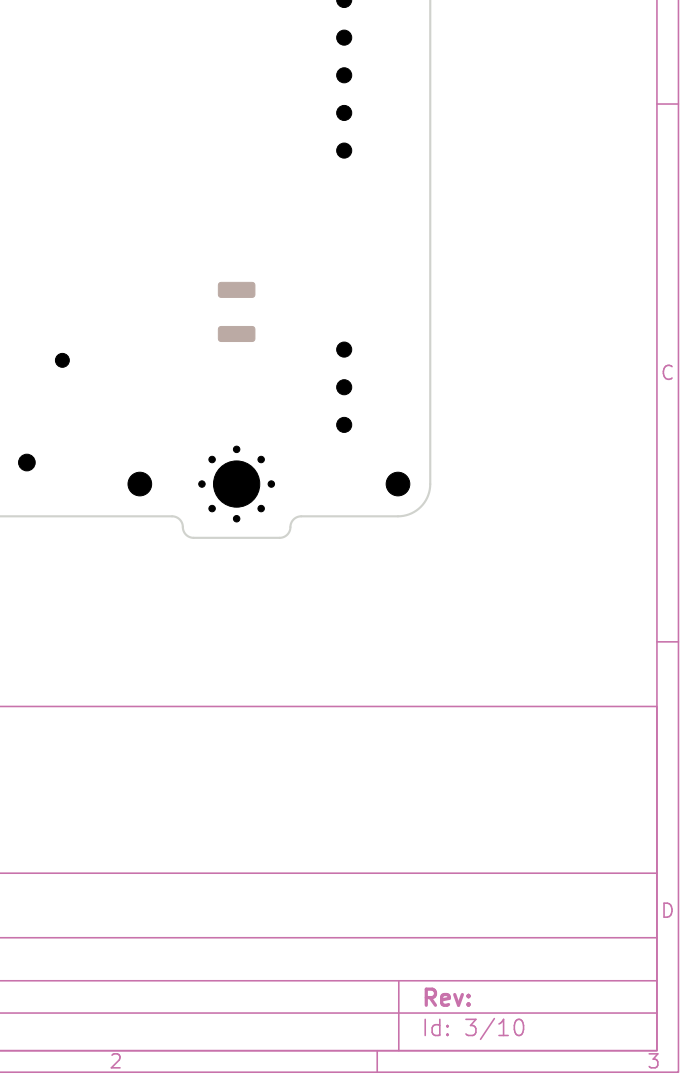
[picture p190: page 3]

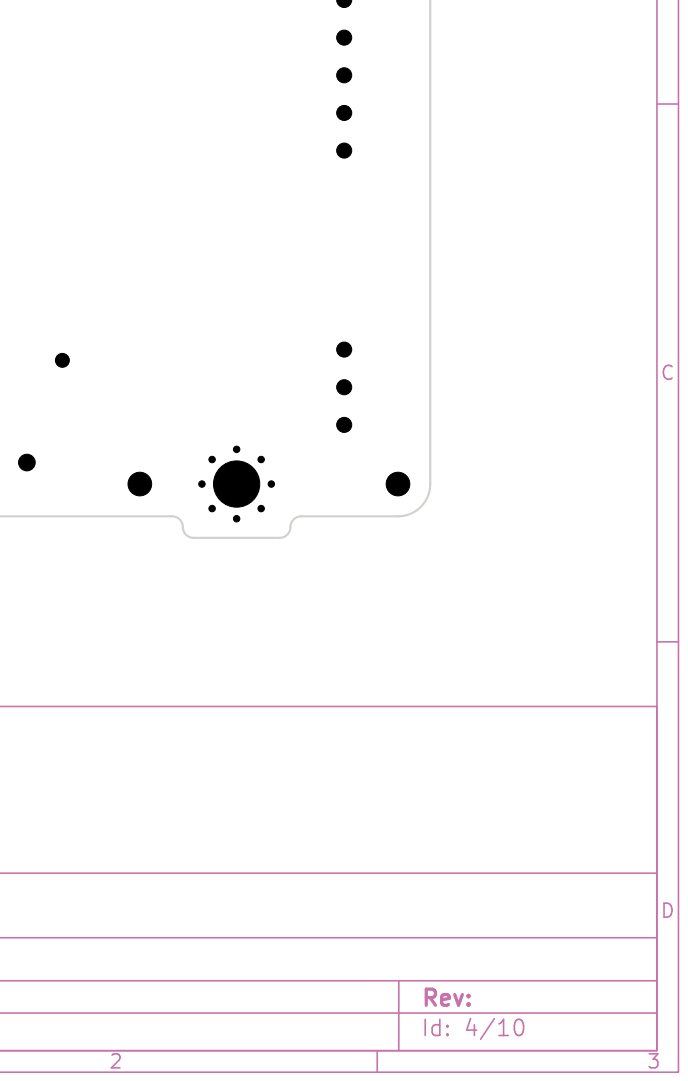
[picture p191: page 4]

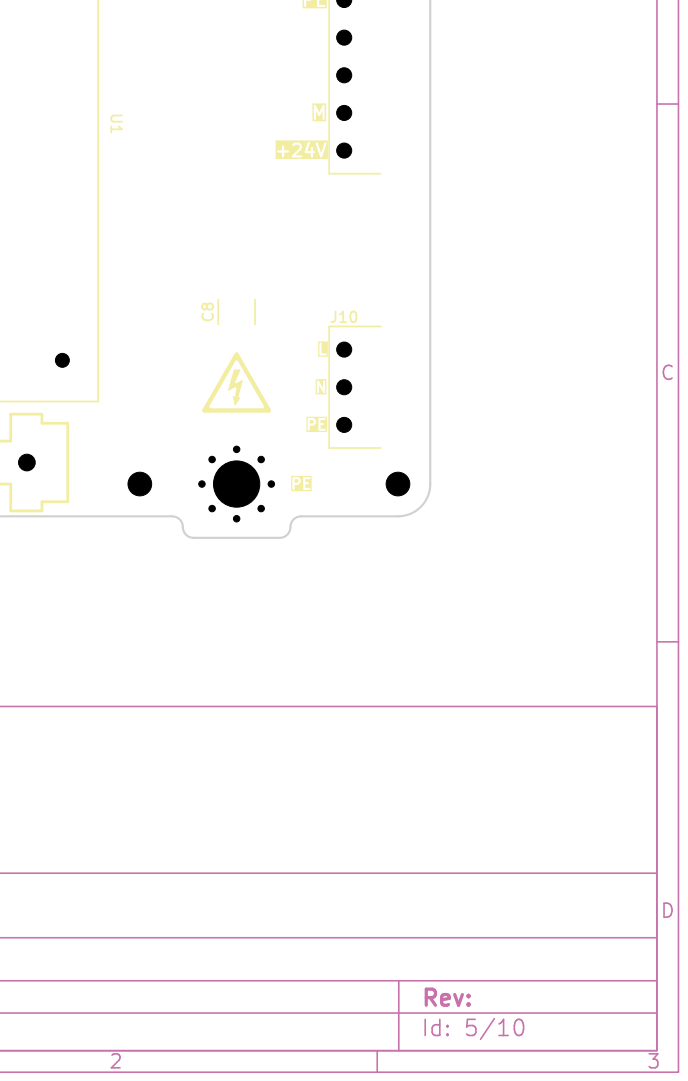
[picture p192: page 5]

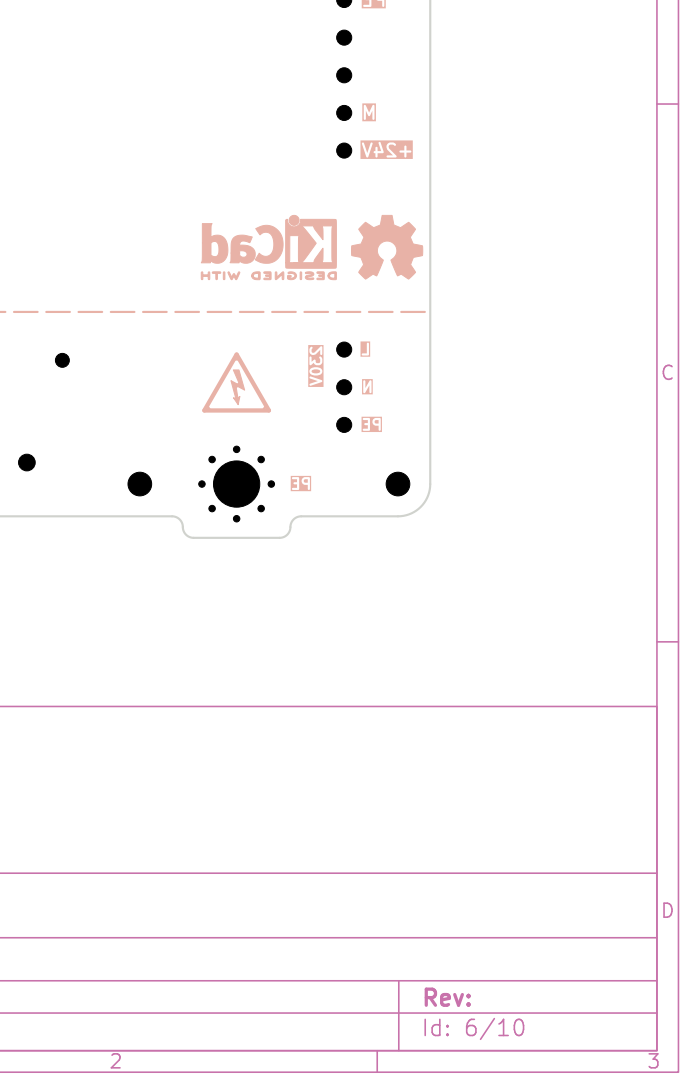
[picture p193: page 6]

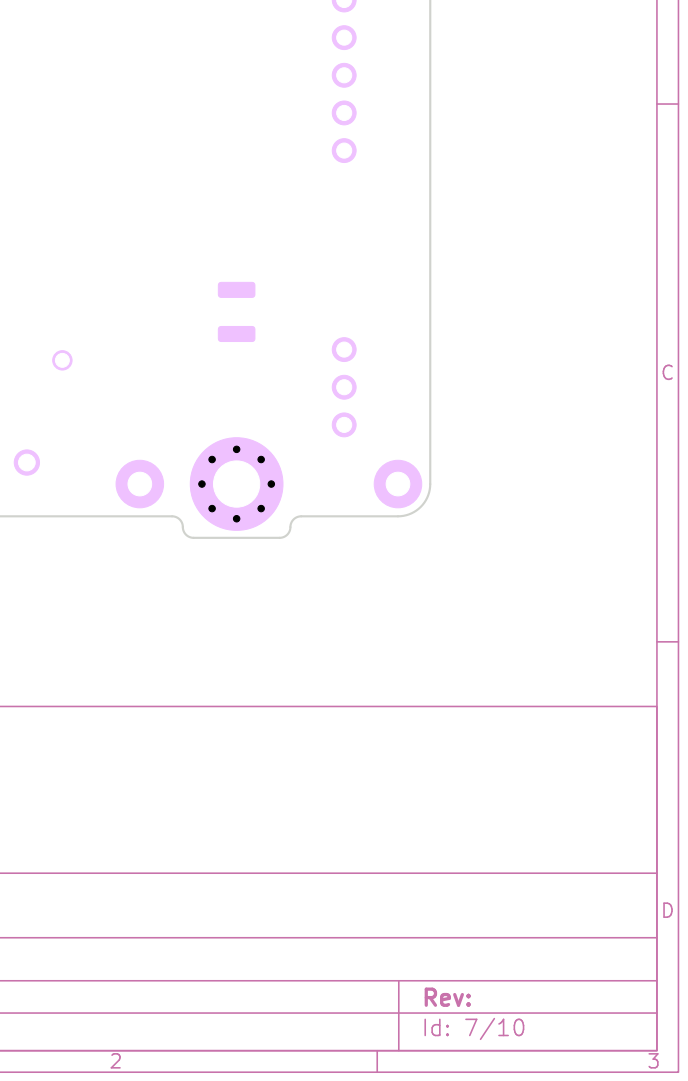
[picture p194: page 7]

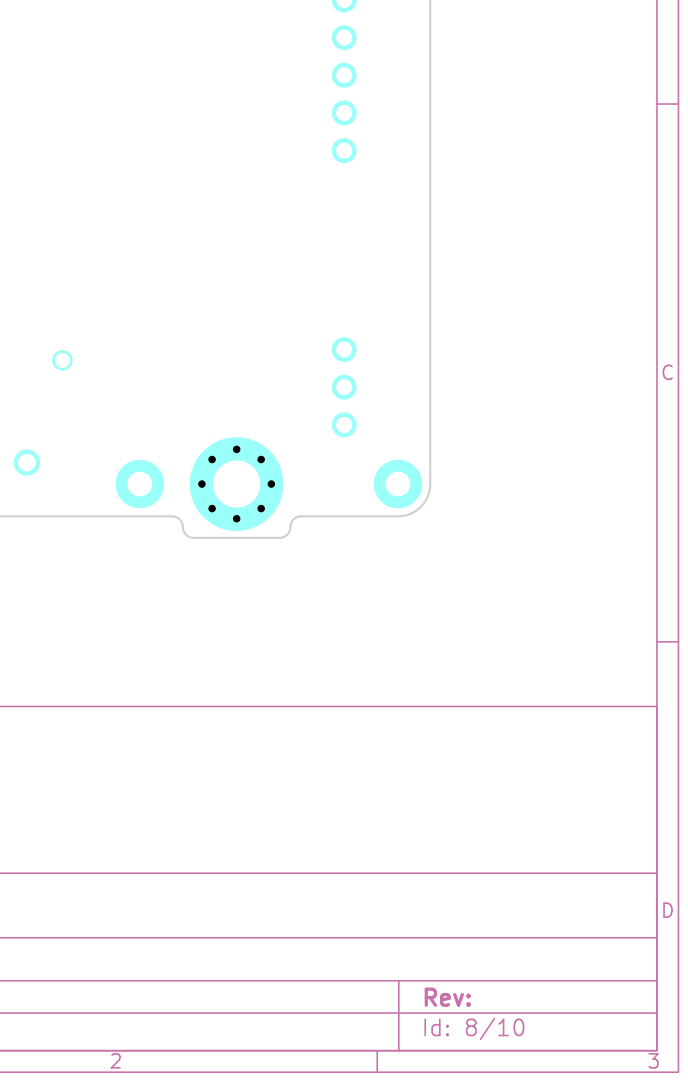
[picture p195: page 8]

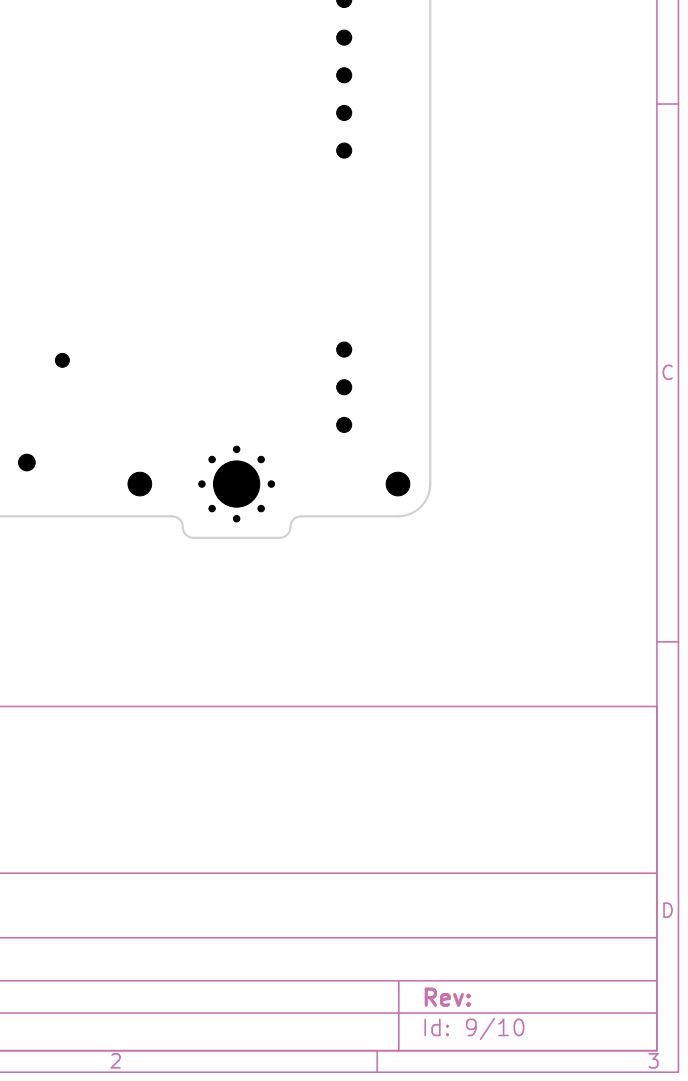
[picture p196: page 9]

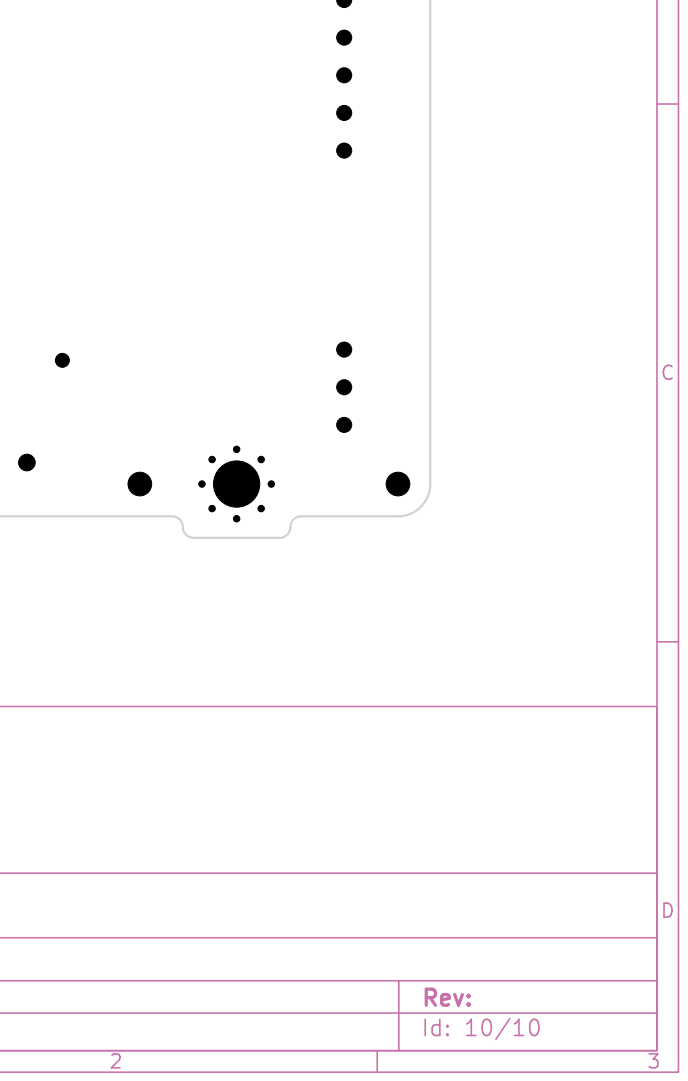
[picture p197: page 10]
