Konstantin-Dudersky/plc-modules/pcb/PMPS-20W-v0.1.0/export/v0.0.6/PCB schematic/PMPS-20W.pdf

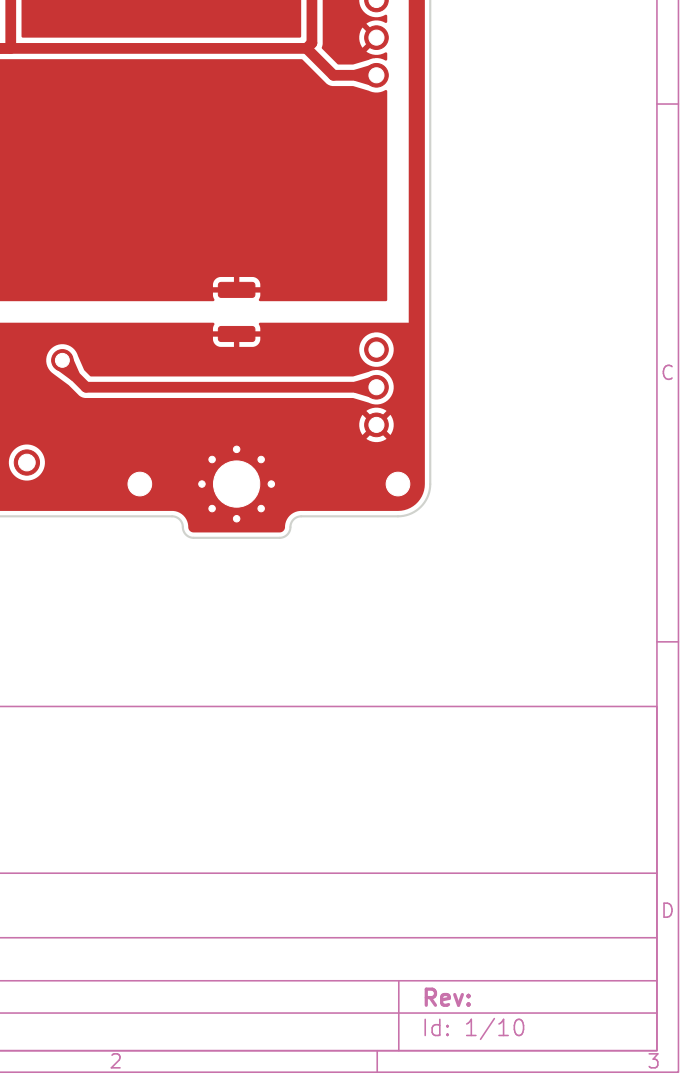
[picture p198: page 1]

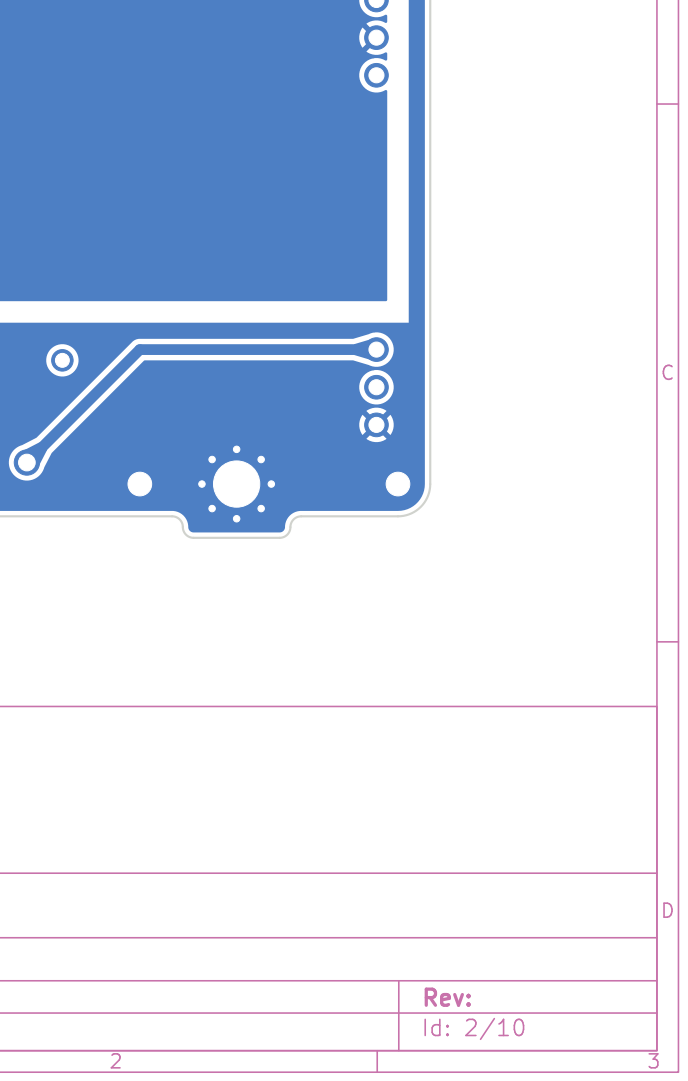
[picture p199: page 2]

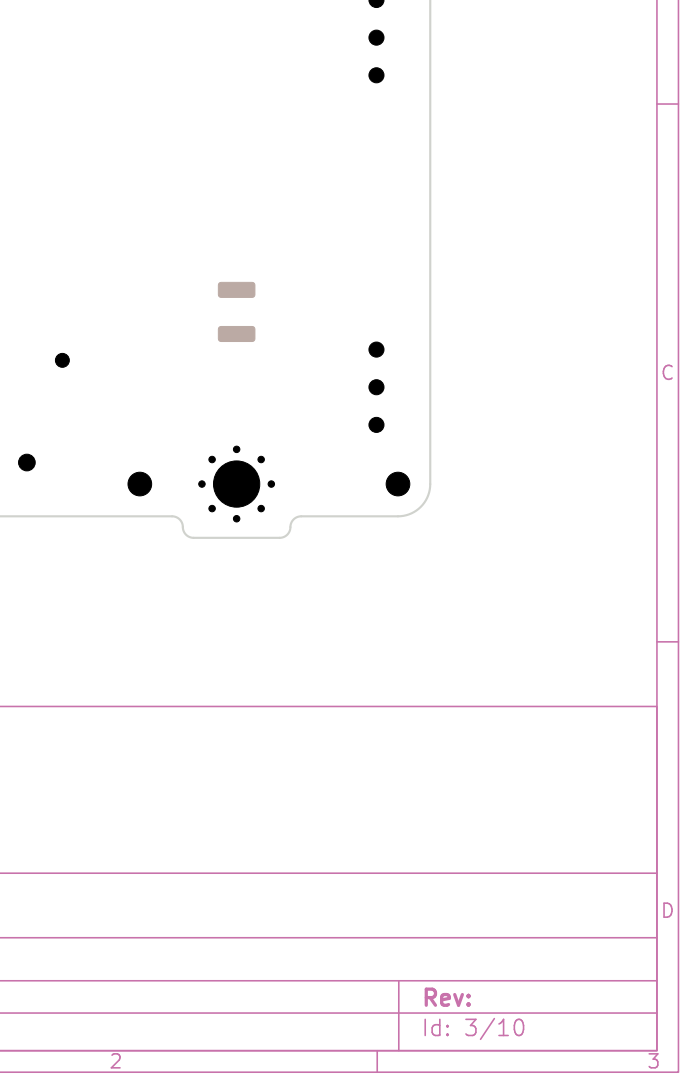
[picture p200: page 3]

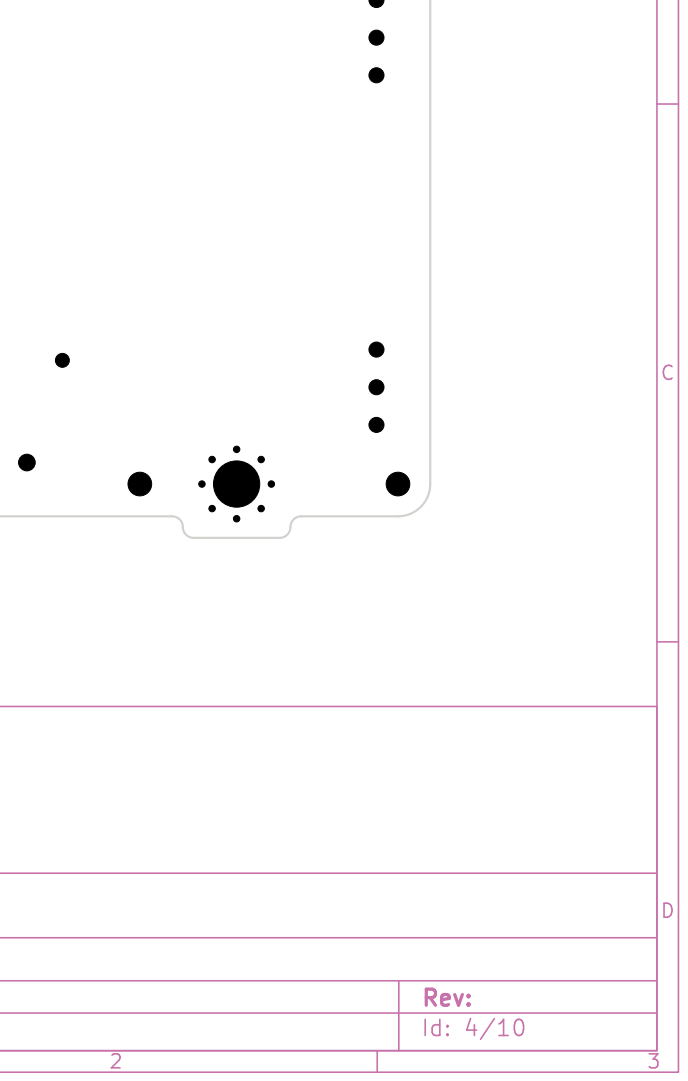
[picture p201: page 4]

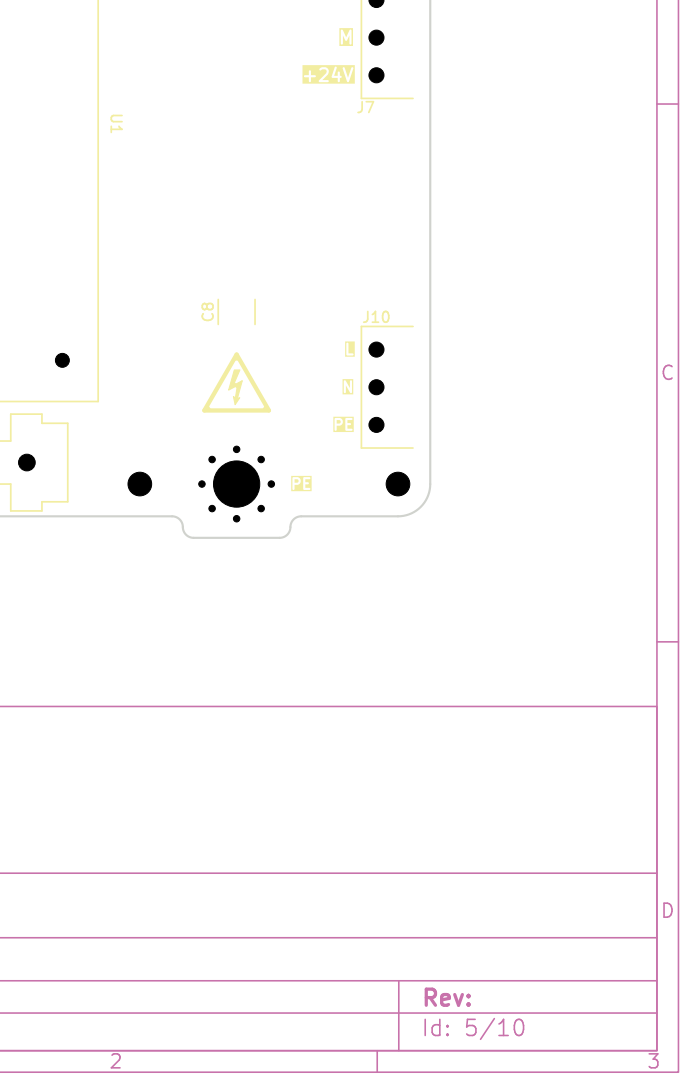
[picture p202: page 5]

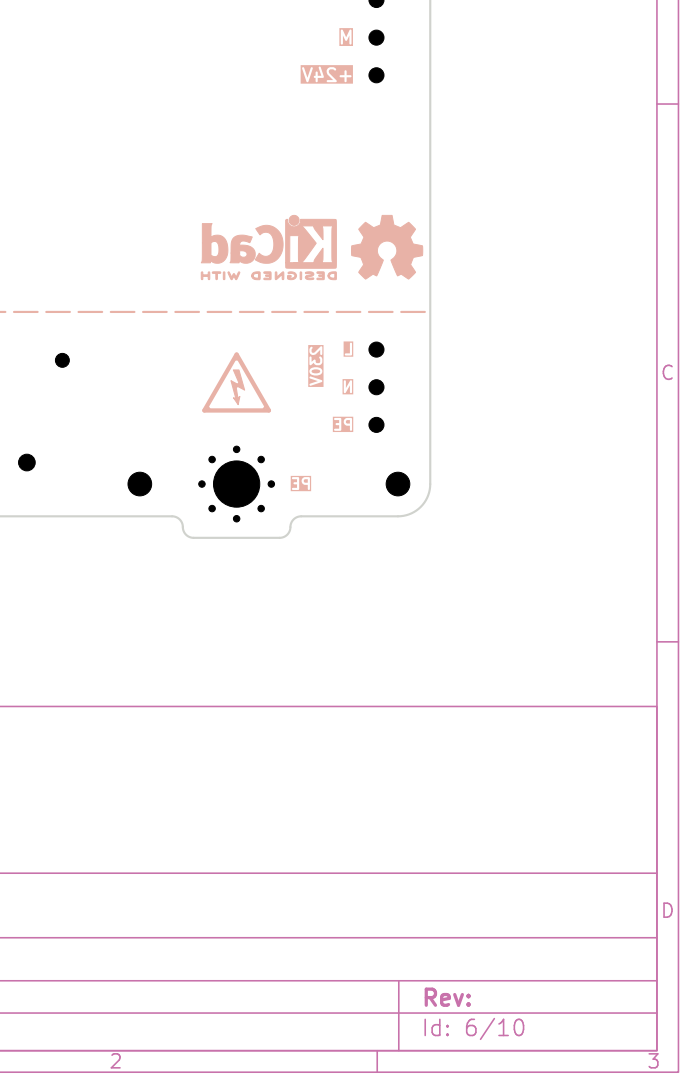
[picture p203: page 6]

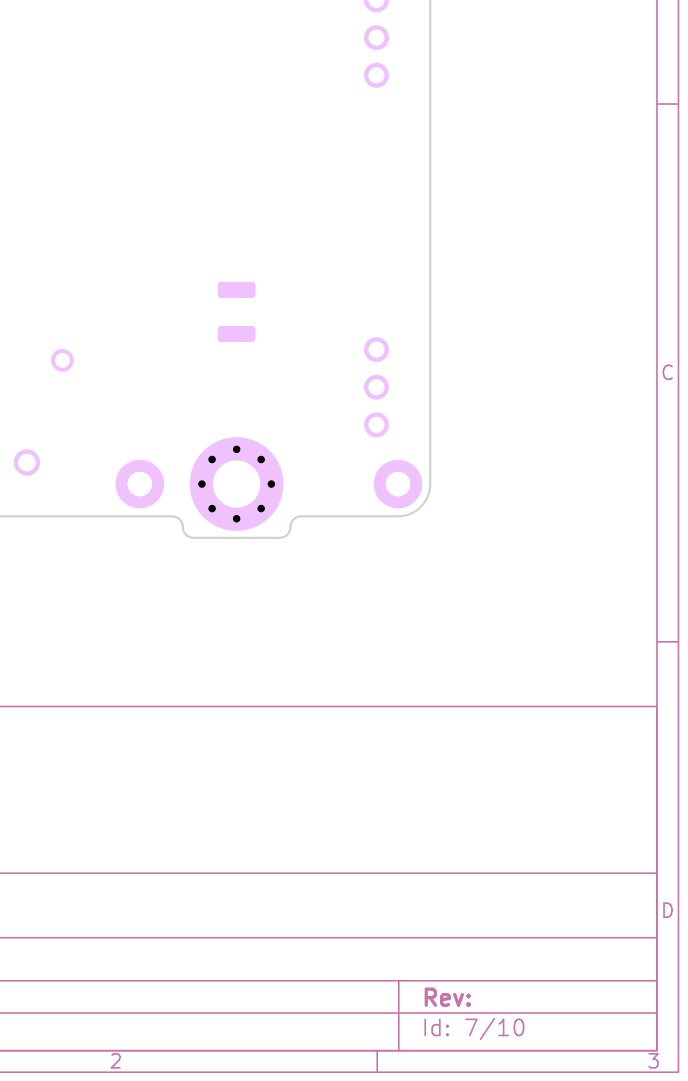
[picture p204: page 7]

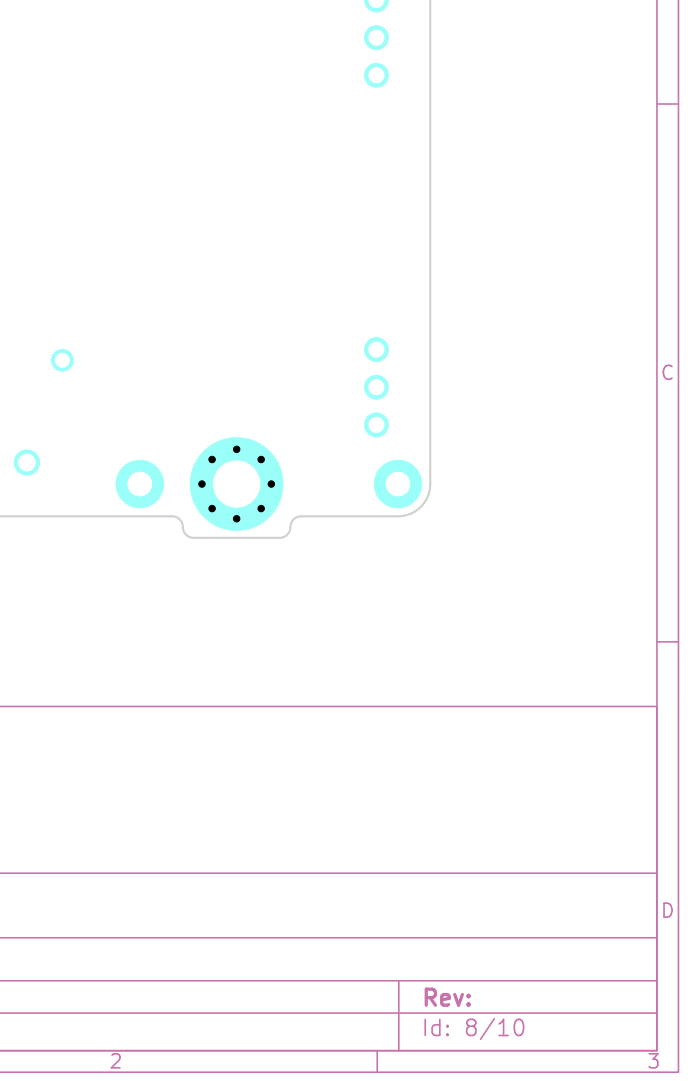
[picture p205: page 8]

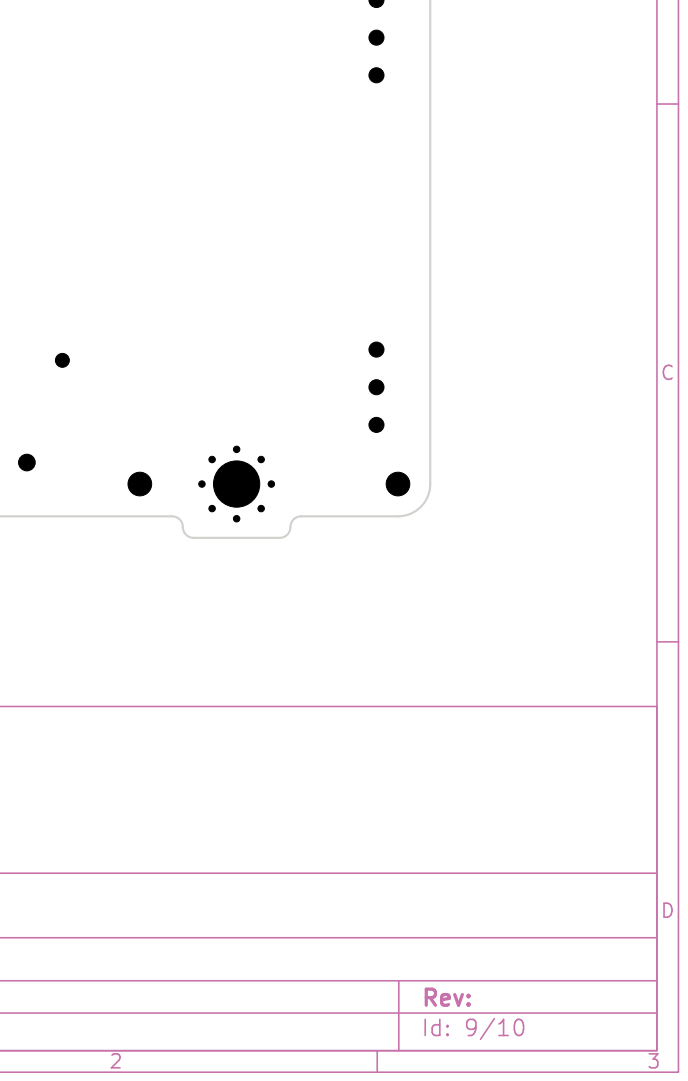
[picture p206: page 9]

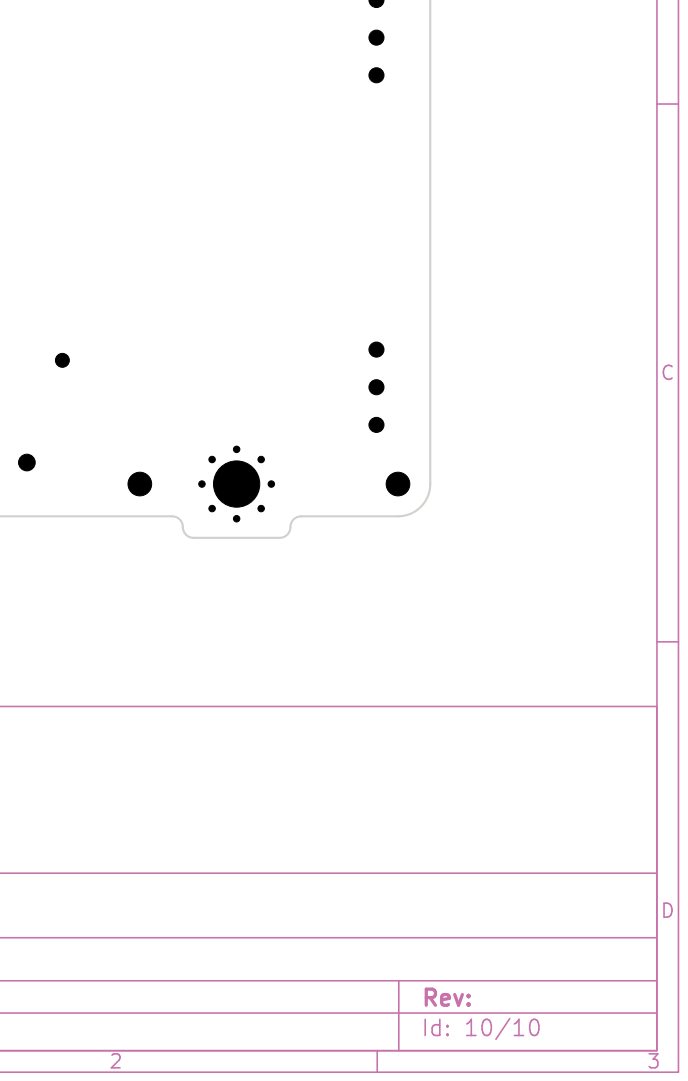
[picture p207: page 10]
