Konstantin-Dudersky/plc-modules/pcb/PMCNV-DQx16-v0.1.0/export/v0.0.5/PCB schematic/PMCNV-DQx16.pdf

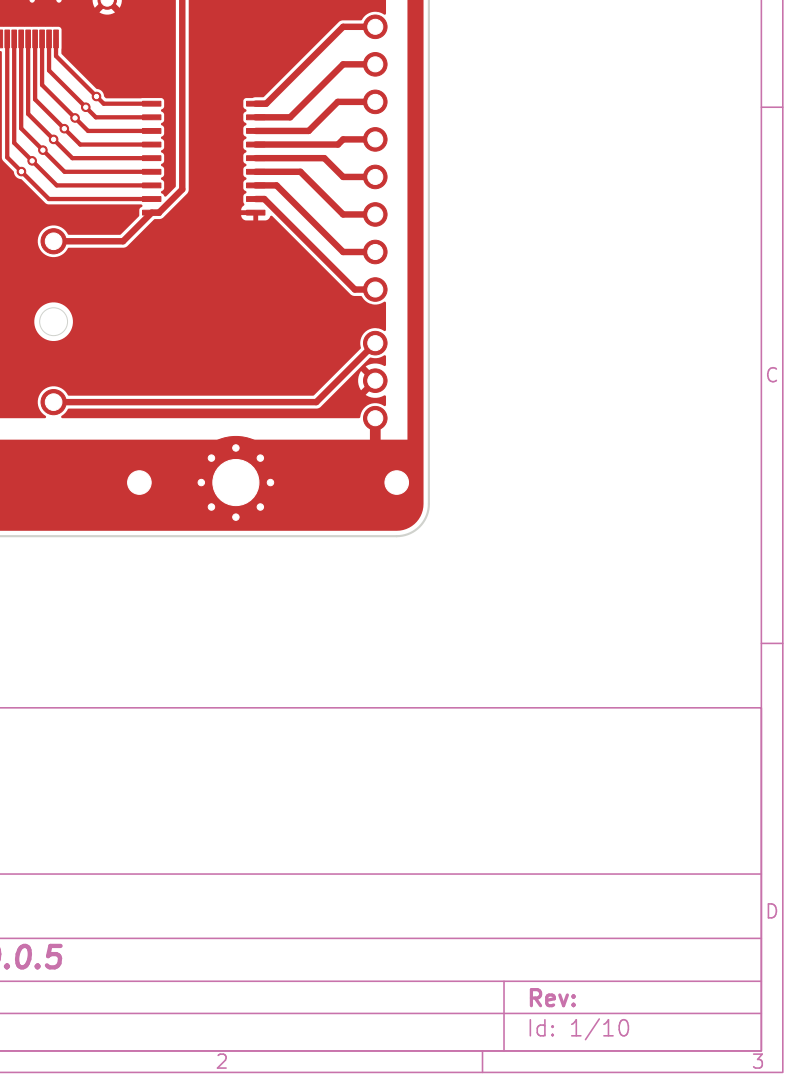
[picture p208: page 1]

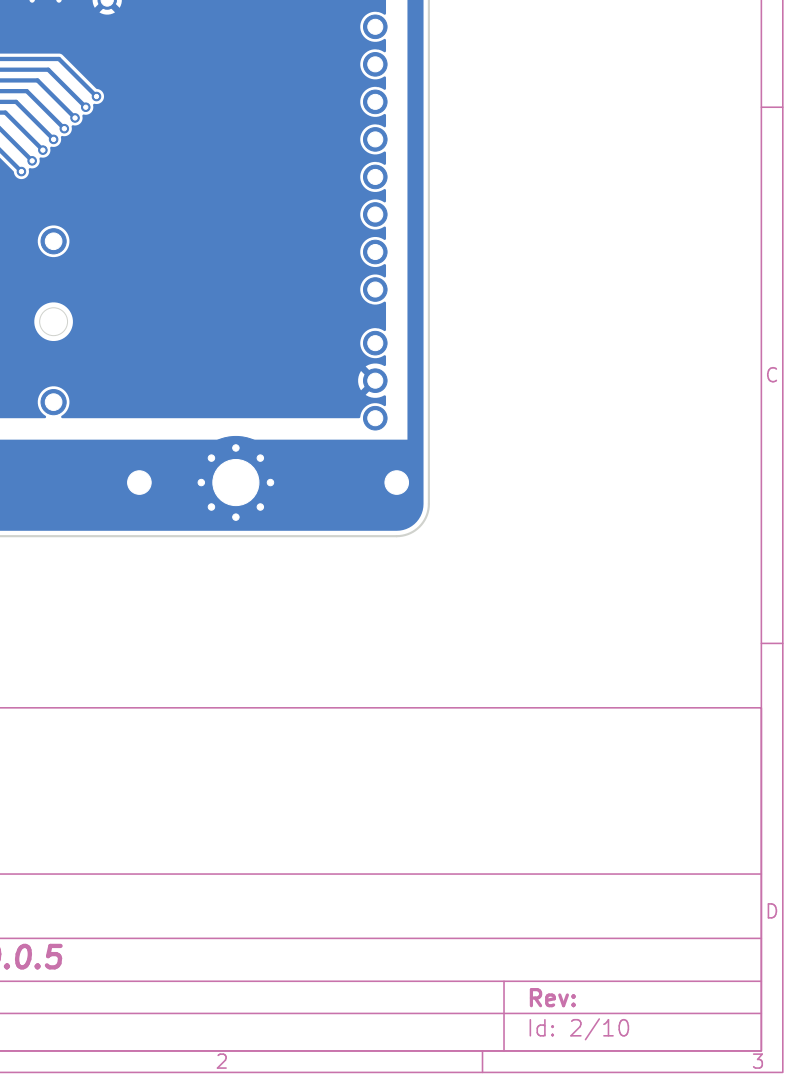
[picture p209: page 2]

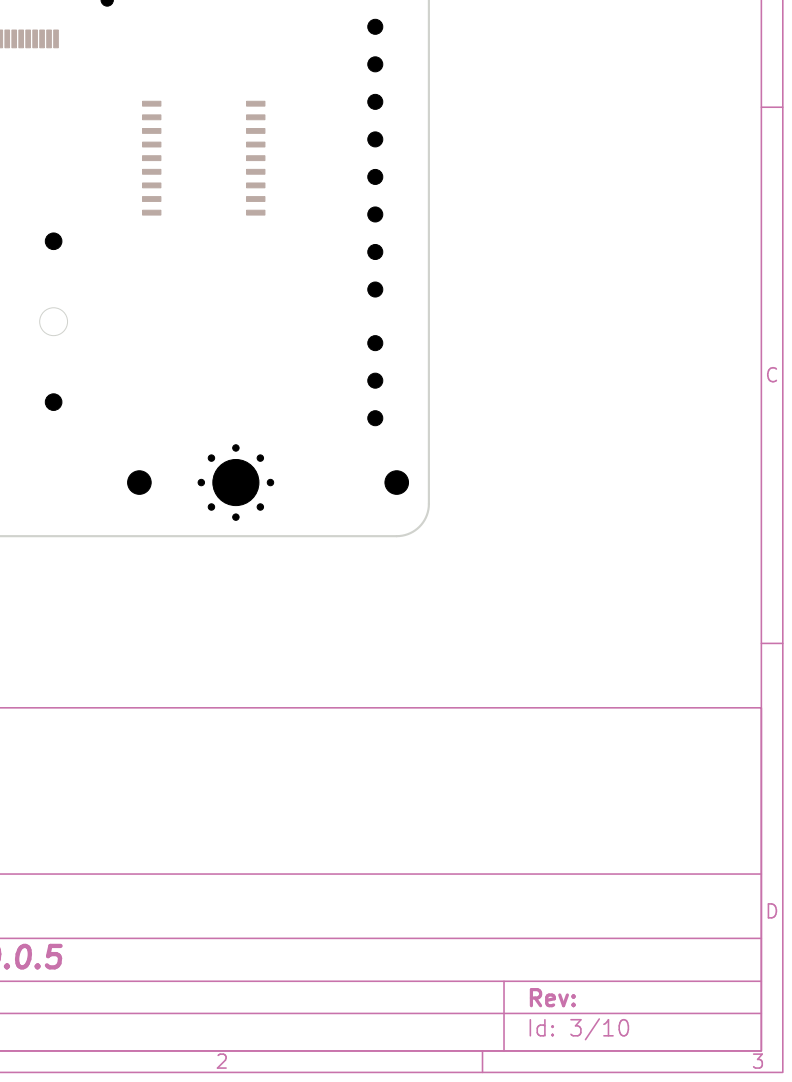
[picture p210: page 3]

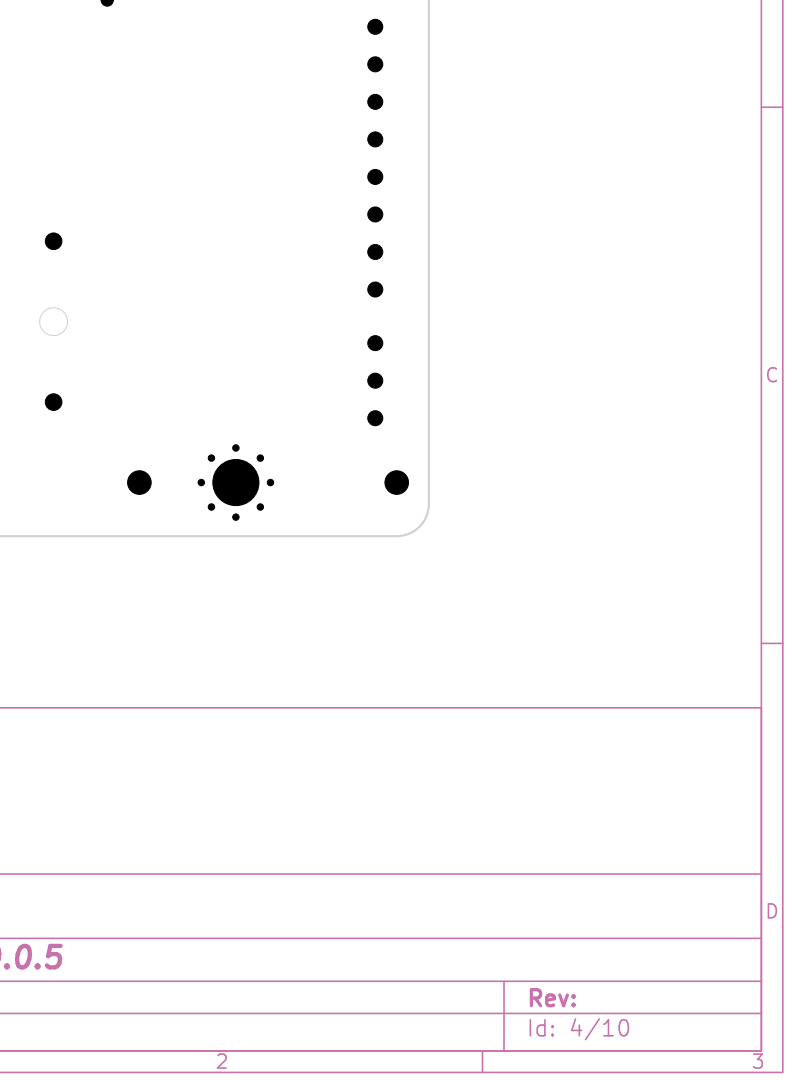
[picture p211: page 4]

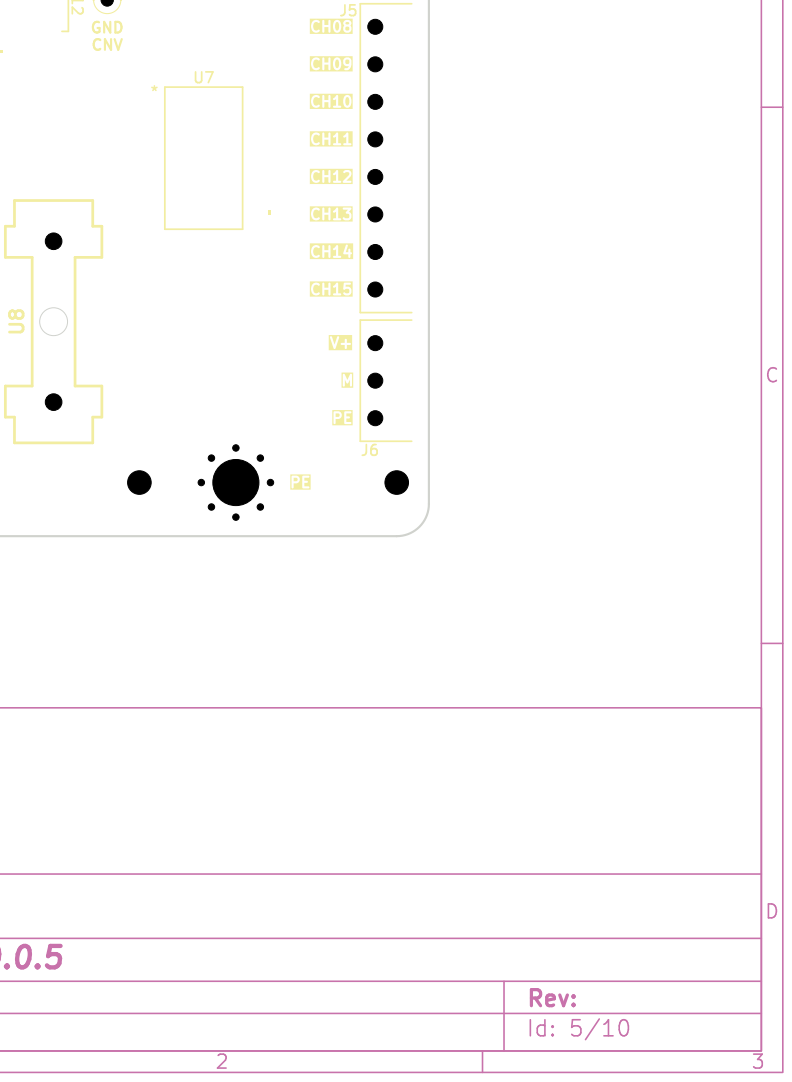
[picture p212: page 5]

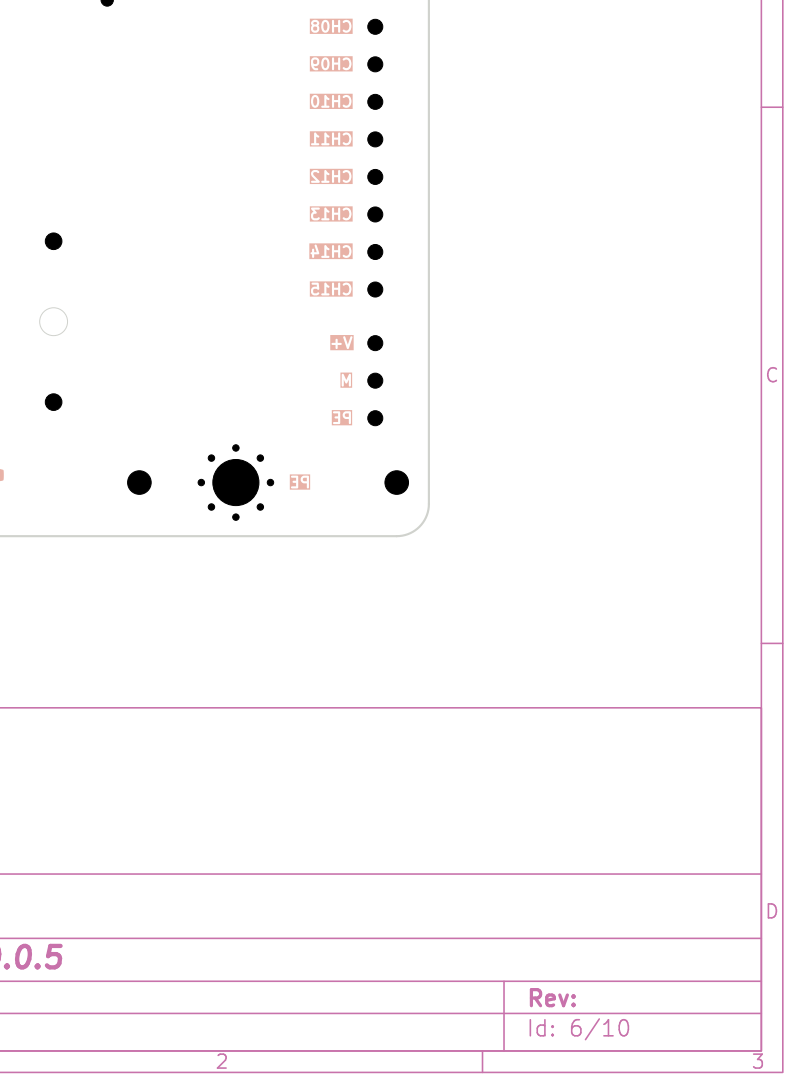
[picture p213: page 6]

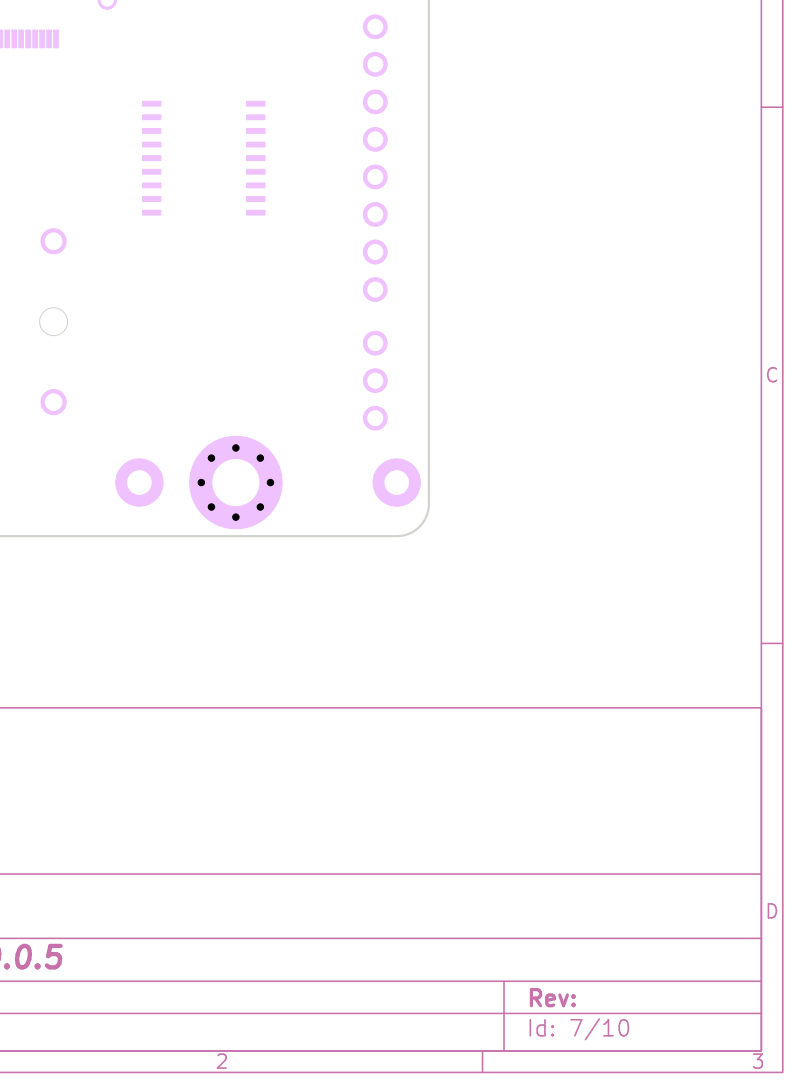
[picture p214: page 7]

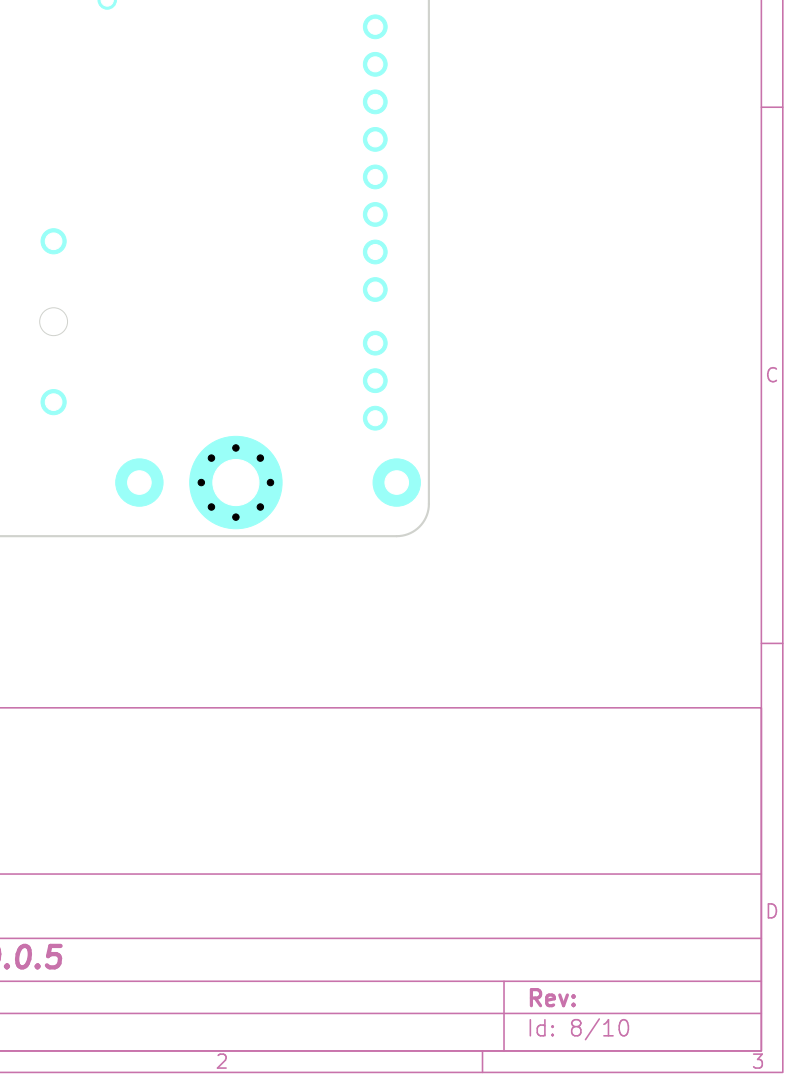
[picture p215: page 8]

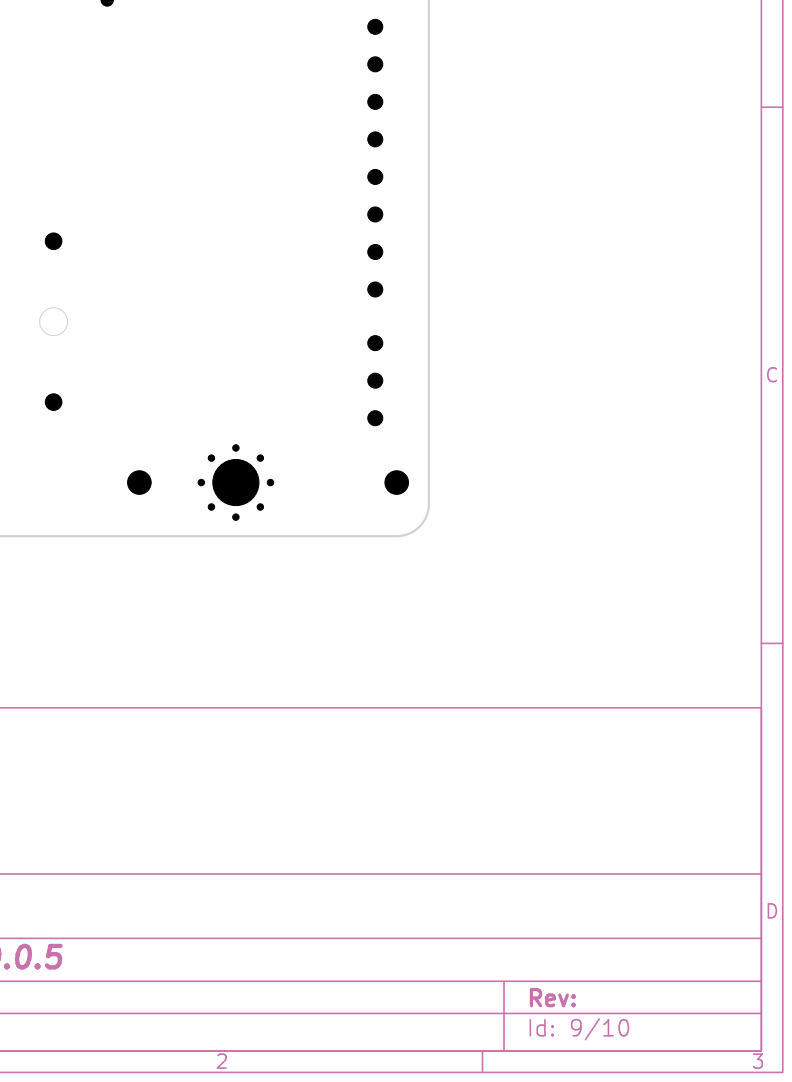
[picture p216: page 9]

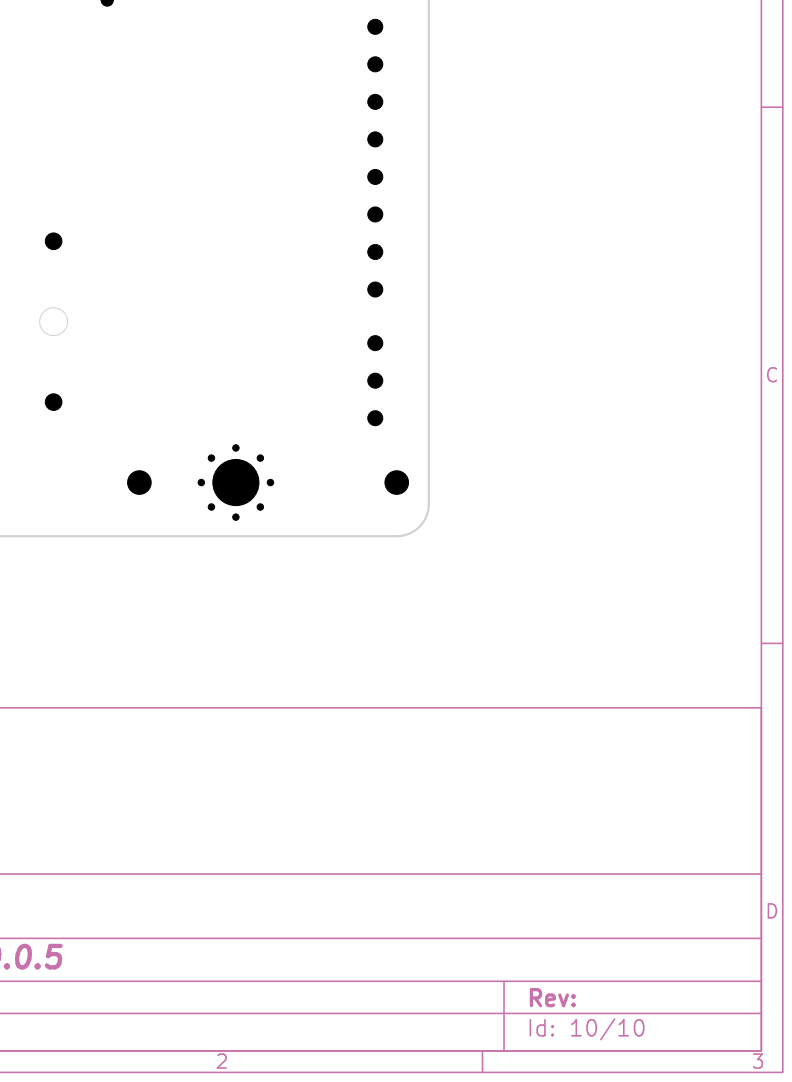
[picture p217: page 10]
