Konstantin-Dudersky/plc-modules/pcb/PMCNV-RQx8-v0.1.0/export/v0.0.7/PCB schematic/PMCNV-RQ8.pdf

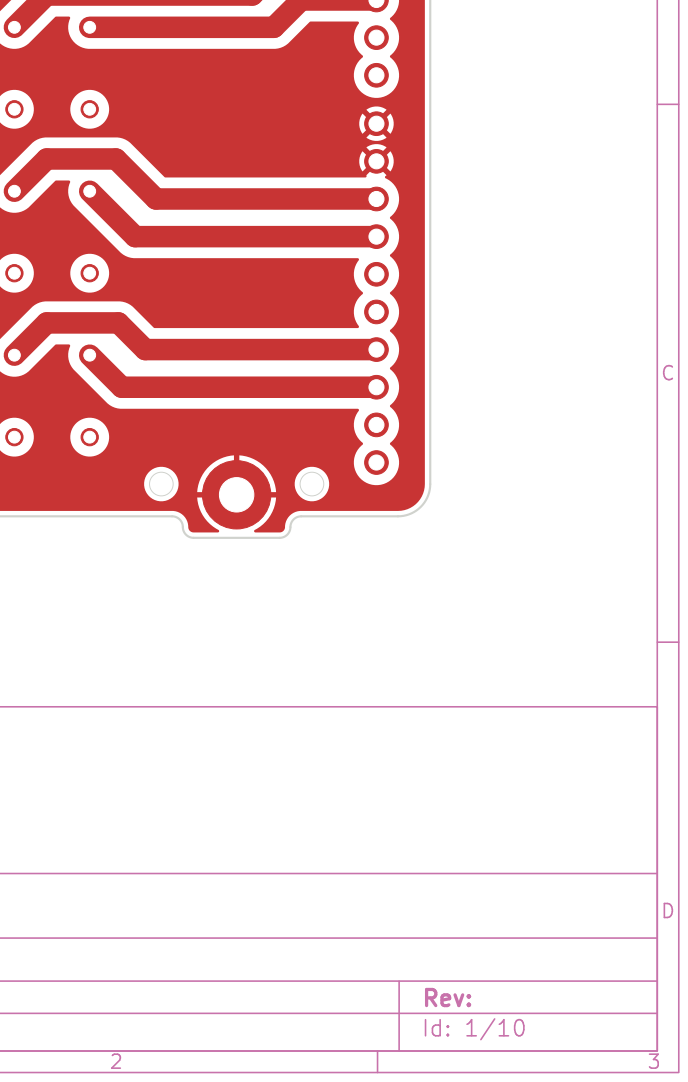
[picture p218: page 1]

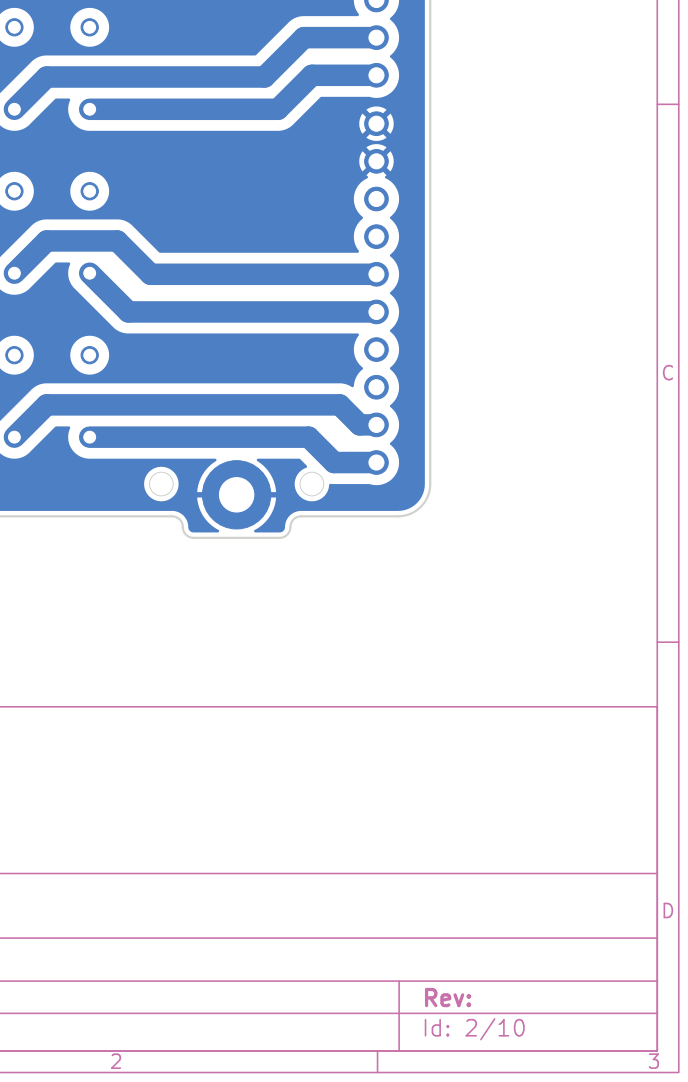
[picture p219: page 2]

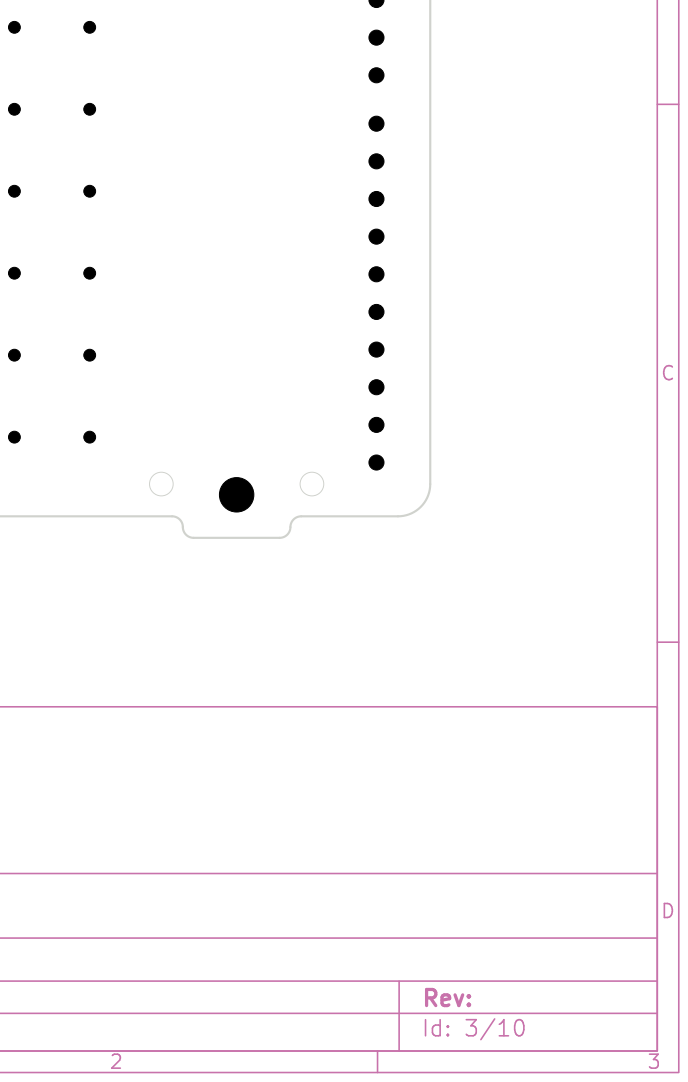
[picture p220: page 3]

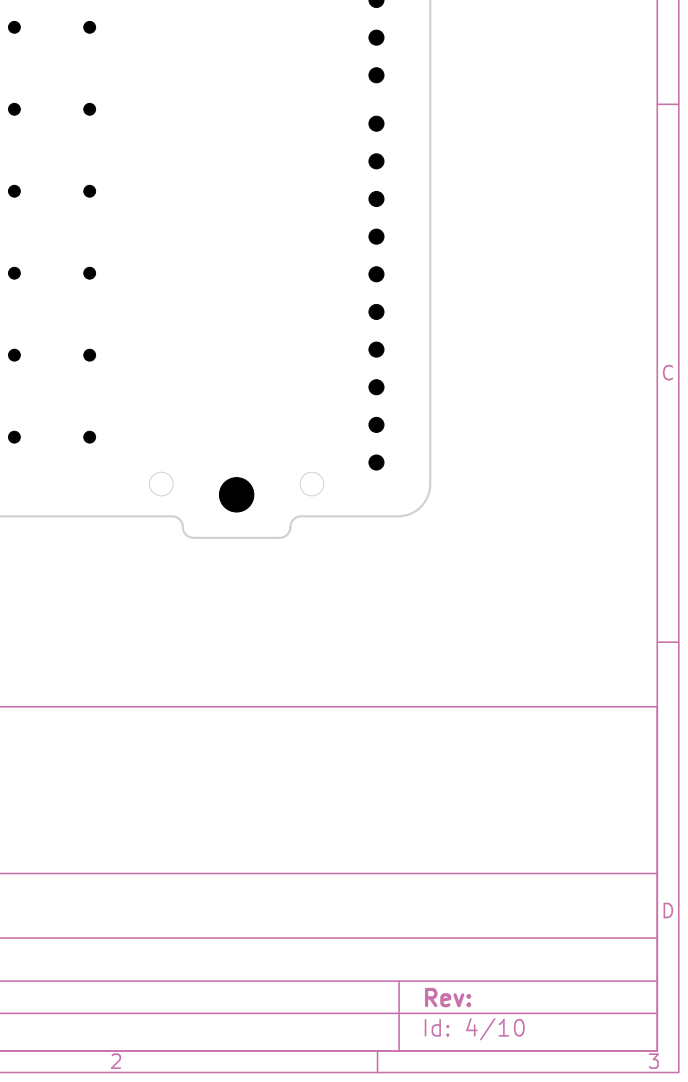
[picture p221: page 4]

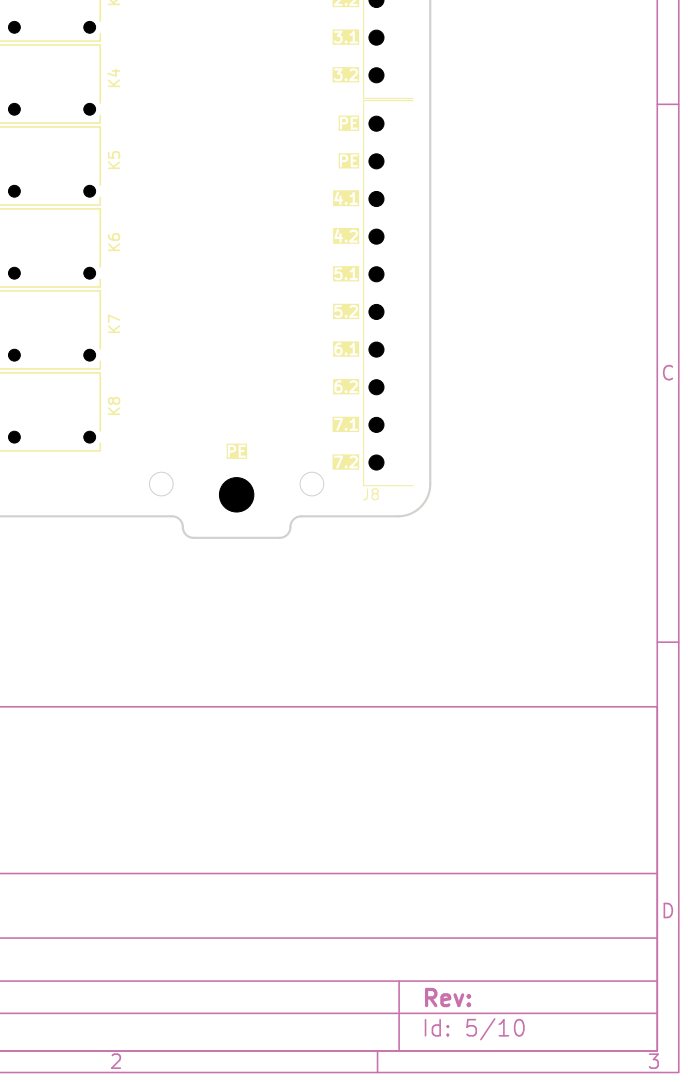
[picture p222: page 5]

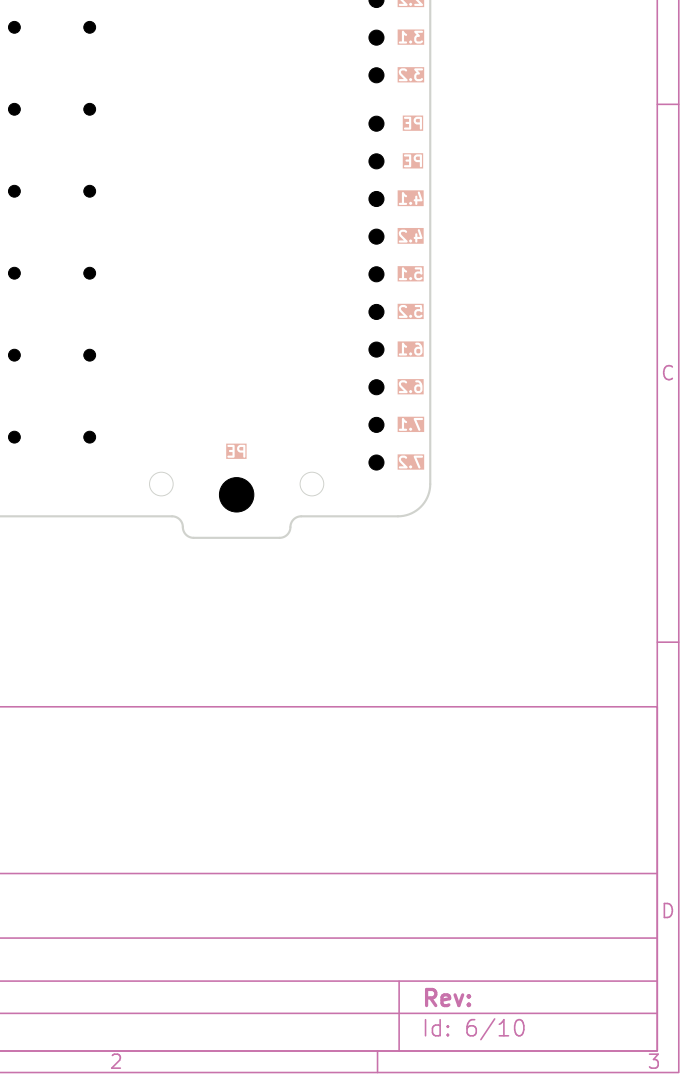
[picture p223: page 6]

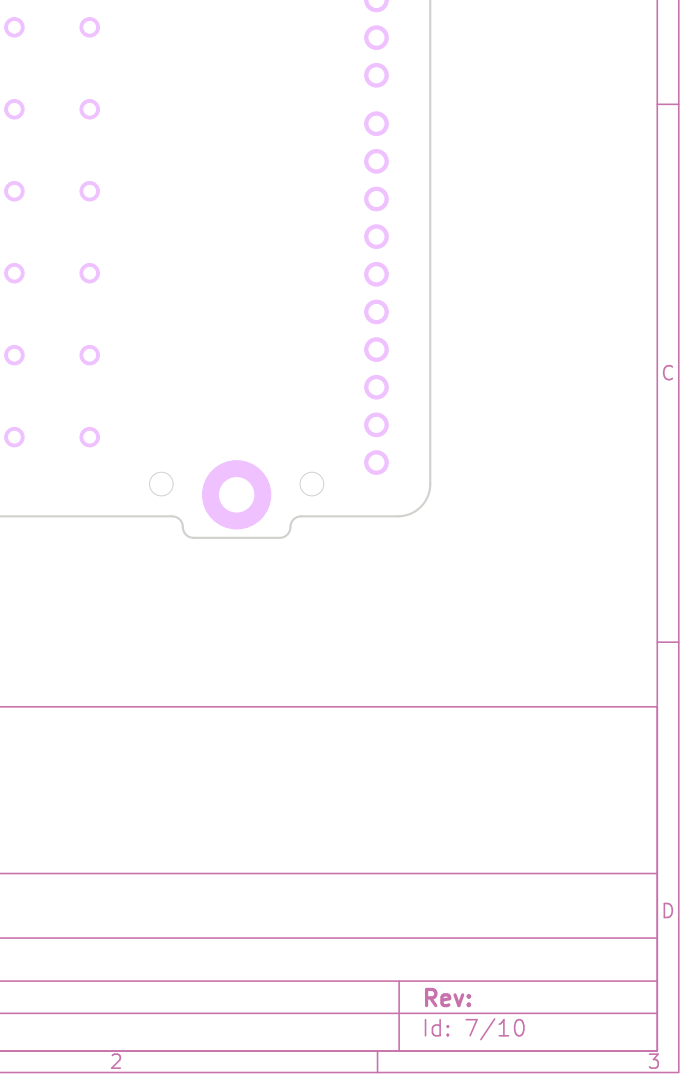
[picture p224: page 7]

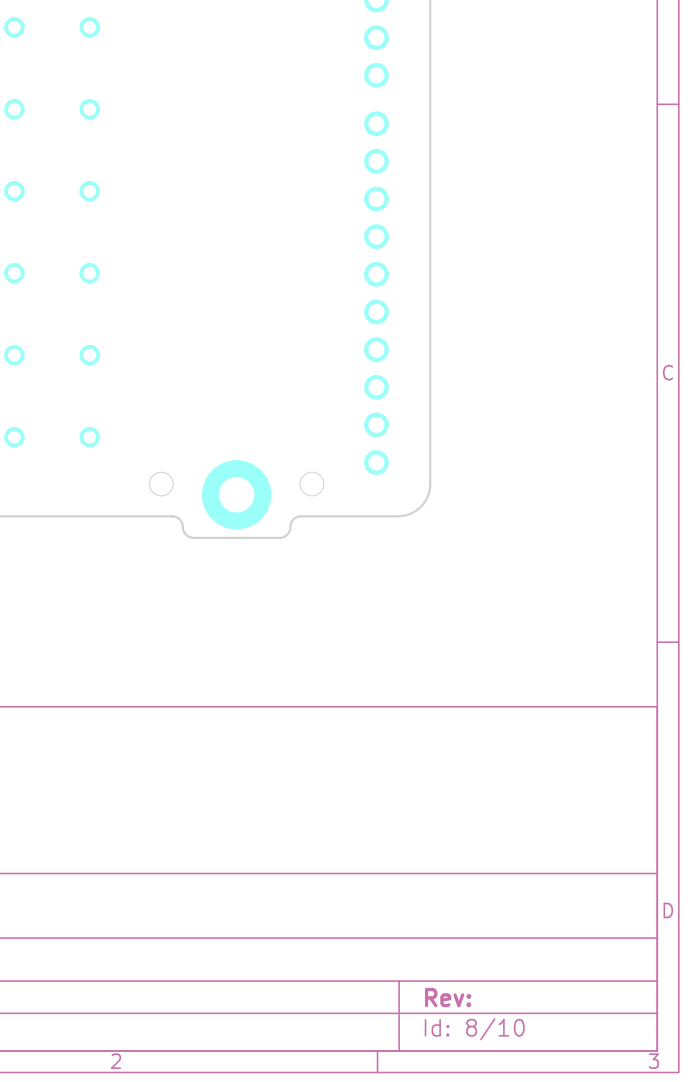
[picture p225: page 8]

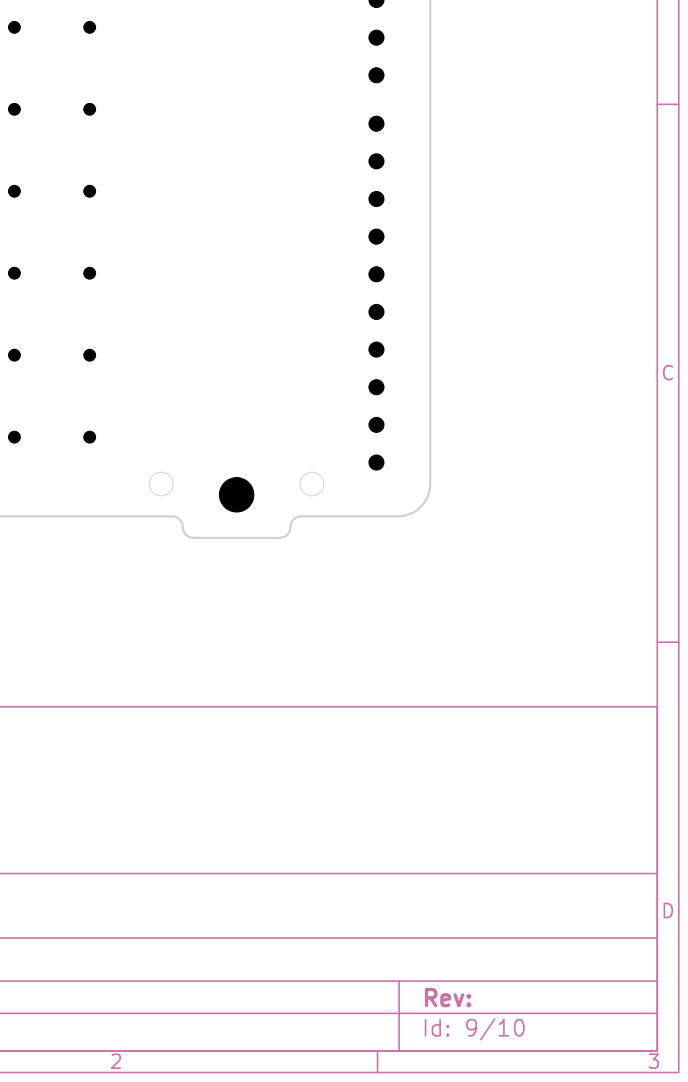
[picture p226: page 9]

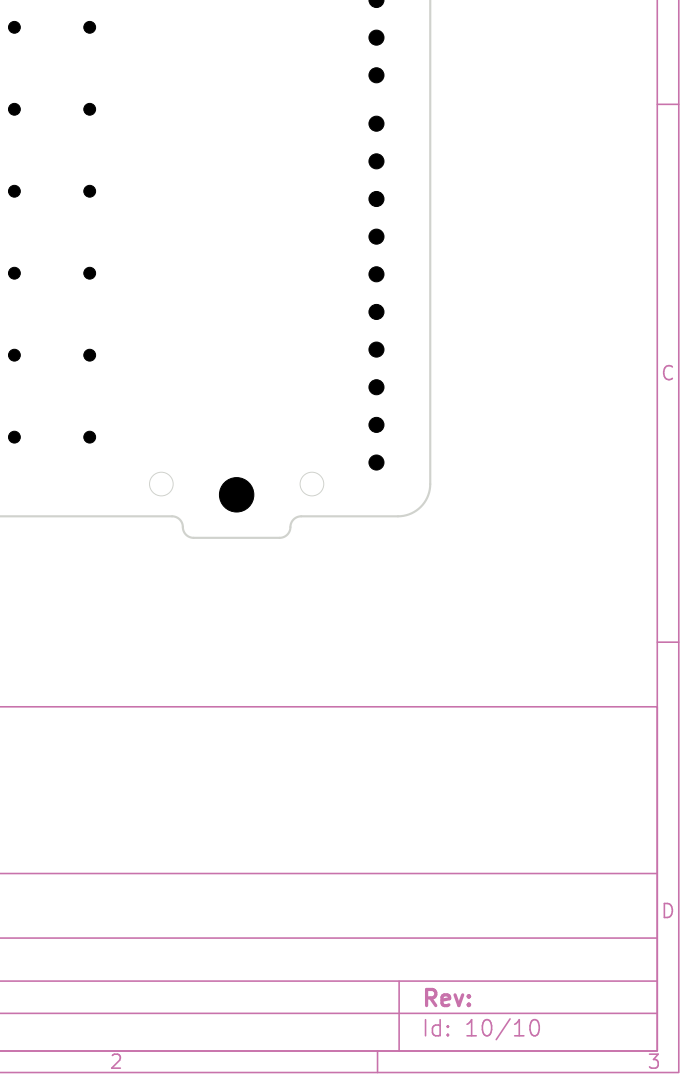
[picture p227: page 10]
