Konstantin-Dudersky/plc-modules/pcb/PMCPU-LLP-v0.1.0/export/v0.0.1/PCB schematic/PMCPU-LLP.pdf

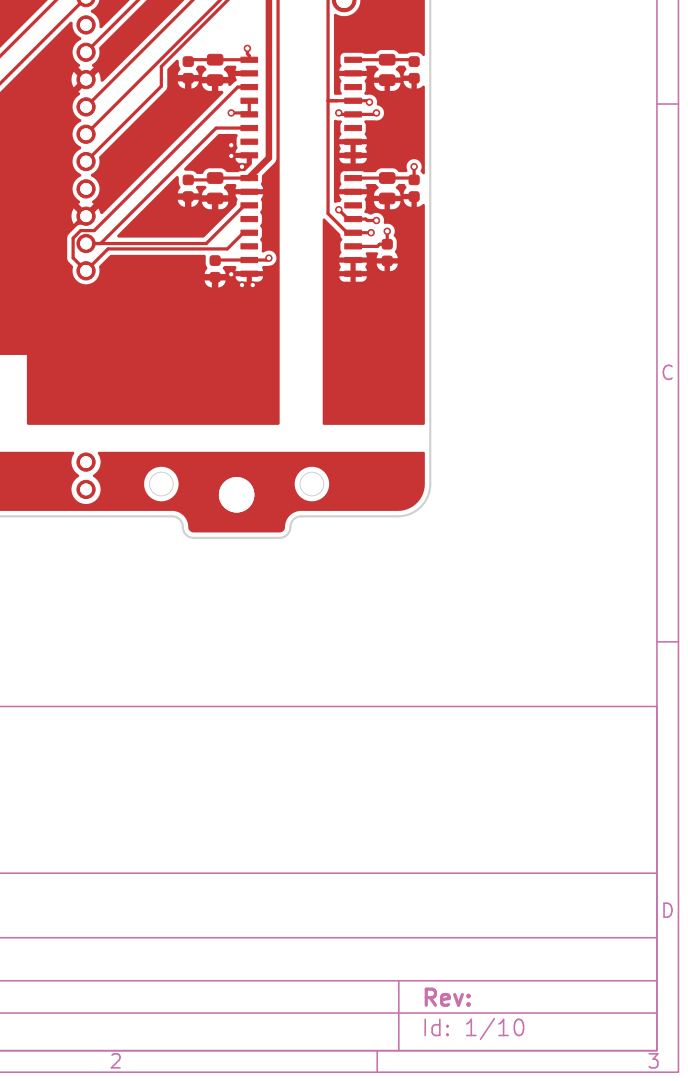
[picture p228: page 1]

Id: 1/10 Title: PMCPU-LLP v0.0.1

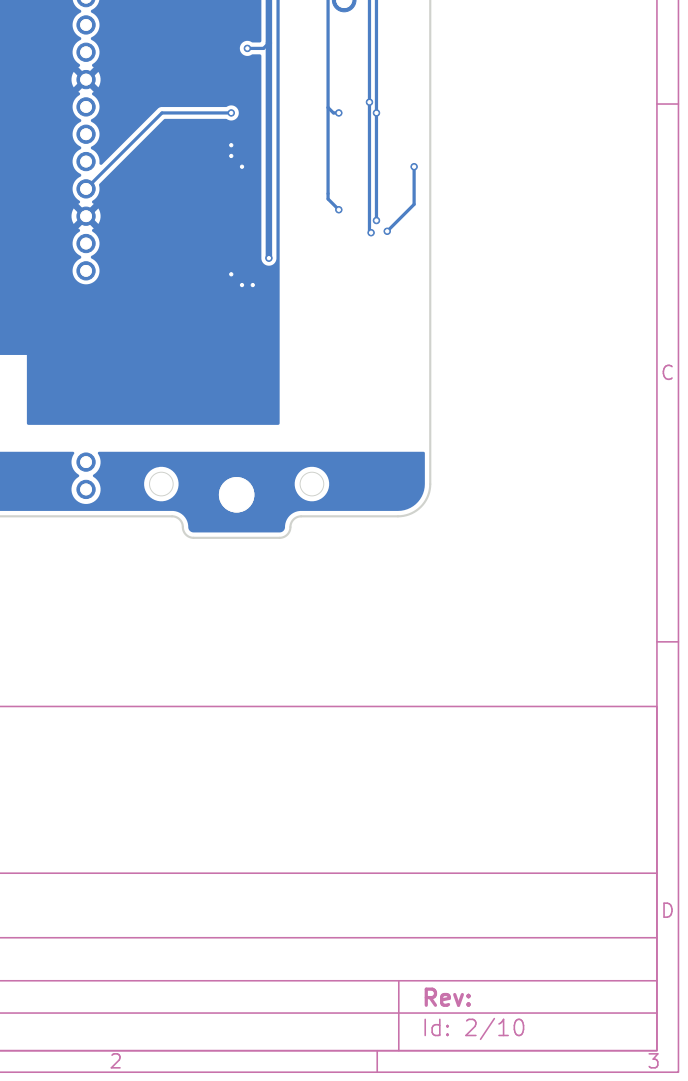
[picture p229: page 2]

Id: 2/10 Title: PMCPU-LLP v0.0.1

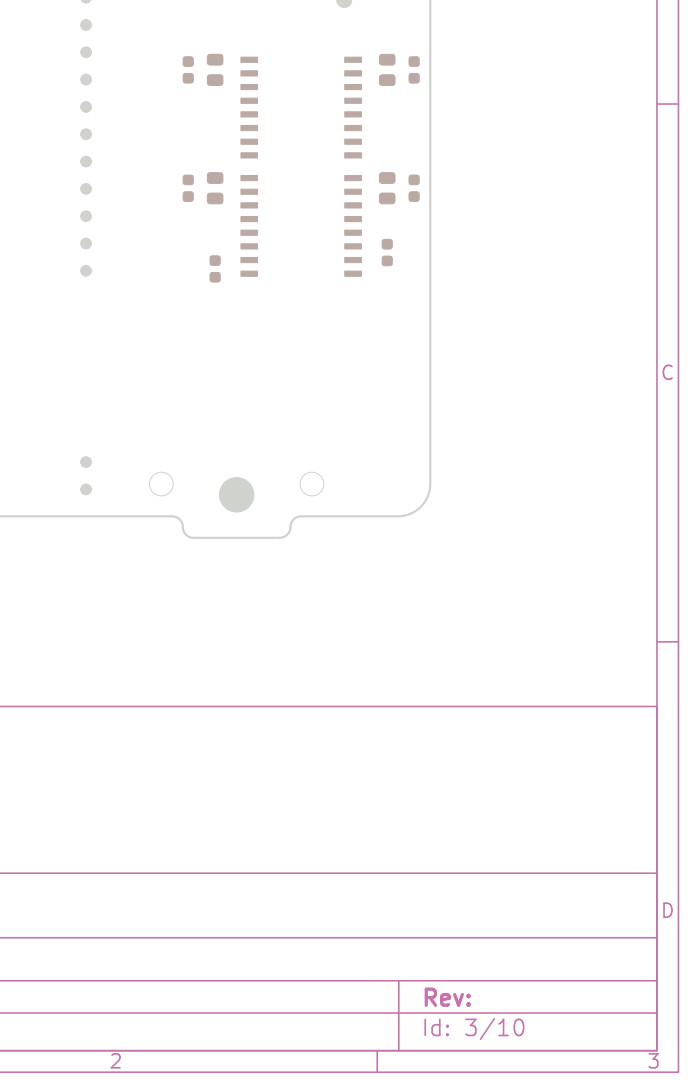
[picture p230: page 3]

Id: 3/10 Title: PMCPU-LLP v0.0.1

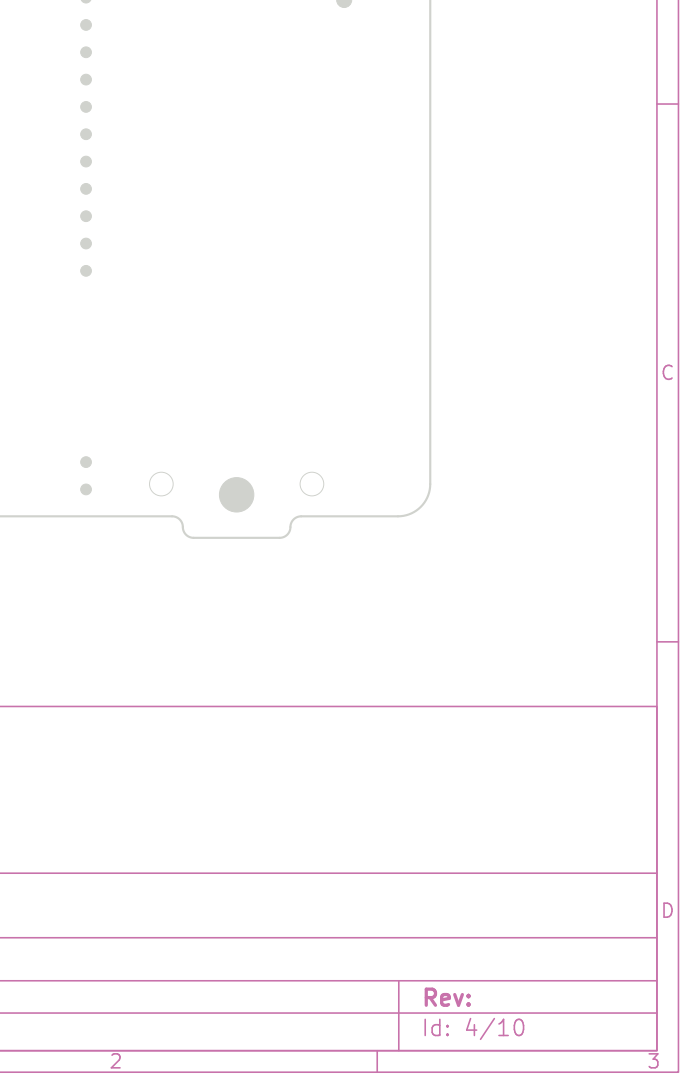
[picture p231: page 4]

Id: 4/10 Title: PMCPU-LLP v0.0.1

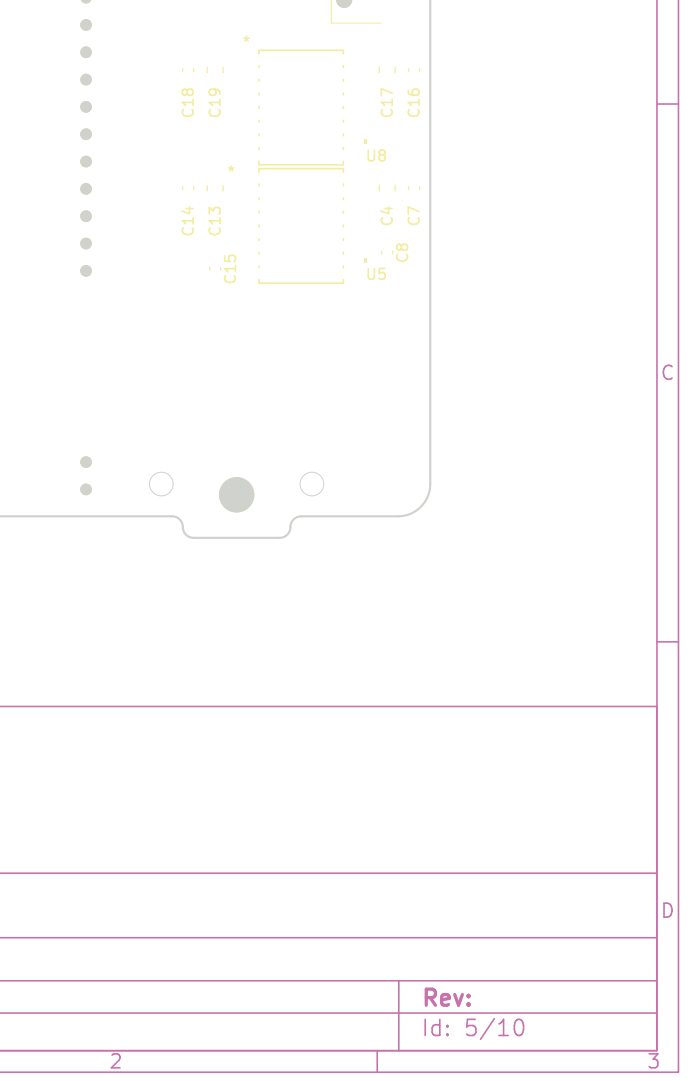
[picture p232: page 5]

Id: 5/10 Title: PMCPU-LLP v0.0.1

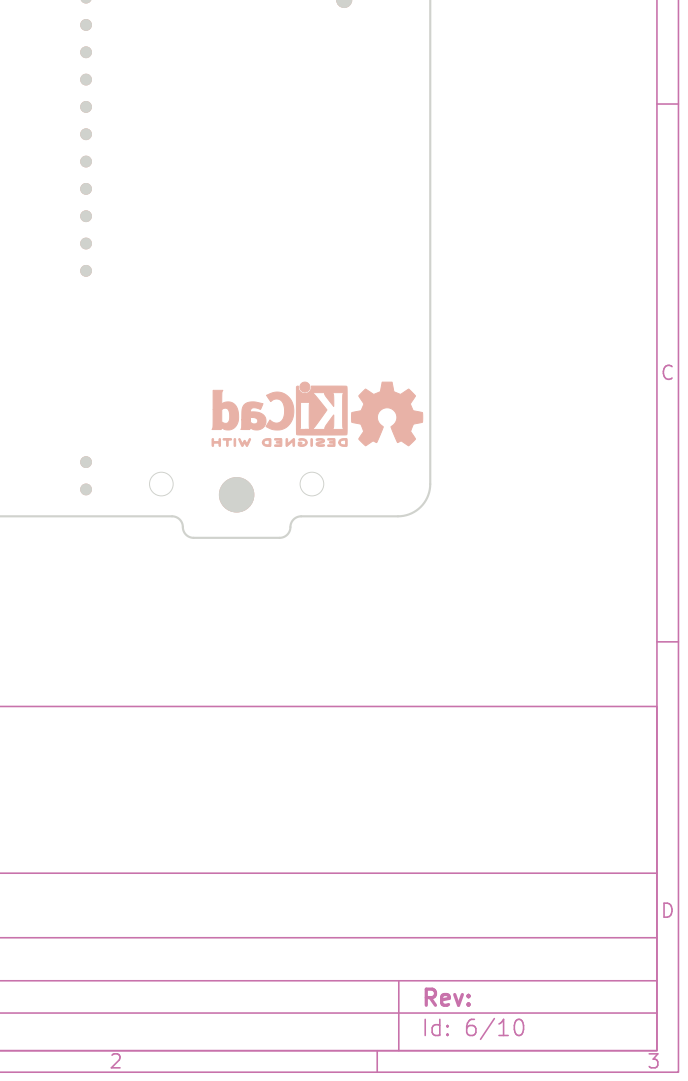
[picture p233: page 6]

Id: 6/10 Title: PMCPU-LLP v0.0.1

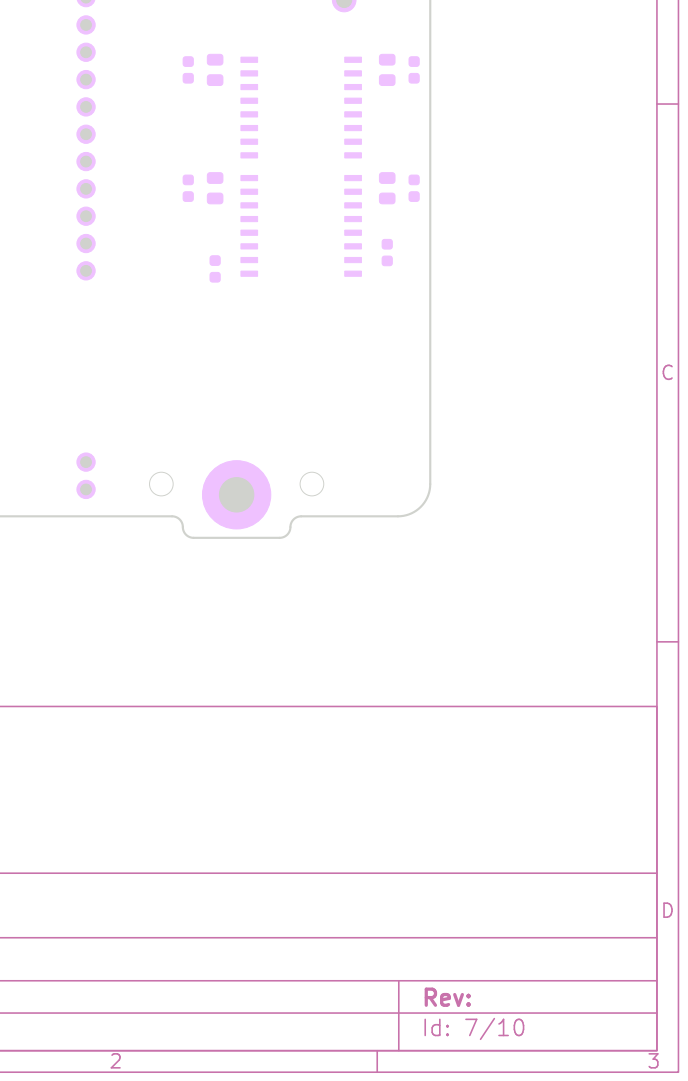
[picture p234: page 7]

Id: 7/10 Title: PMCPU-LLP v0.0.1

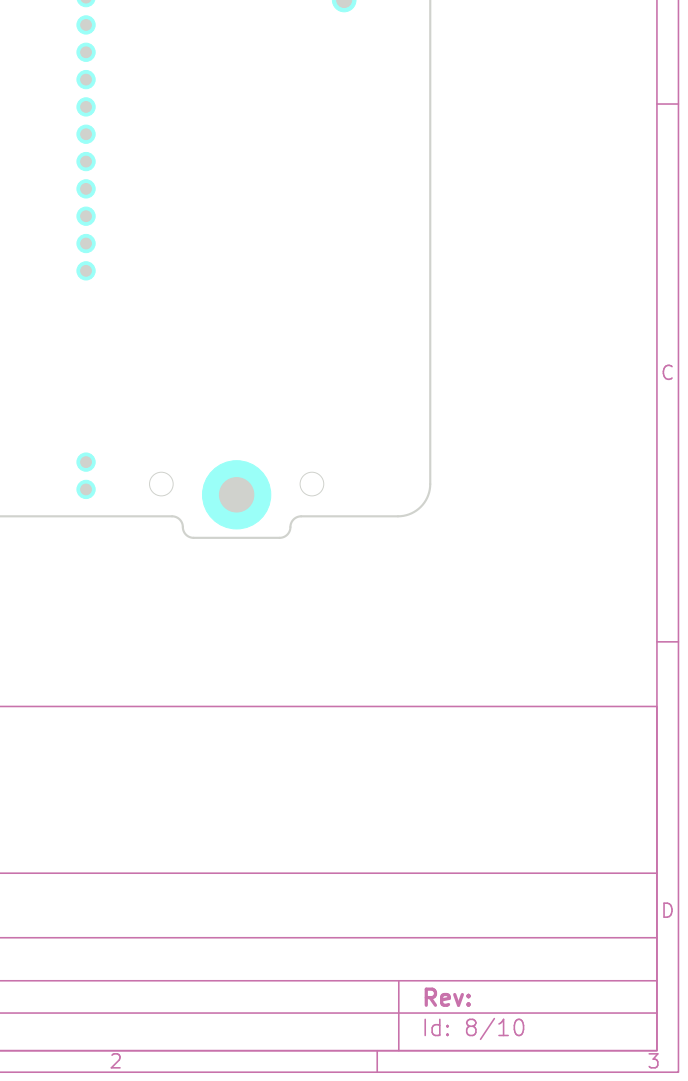
[picture p235: page 8]

Id: 8/10 Title: PMCPU-LLP v0.0.1

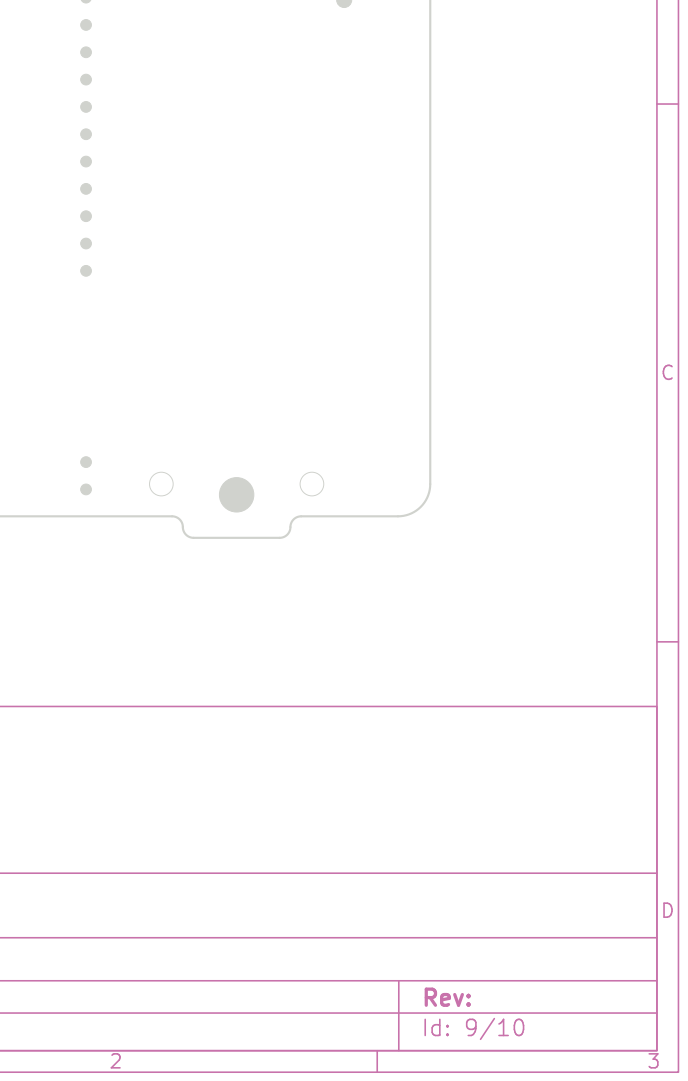
[picture p236: page 9]

Id: 9/10 Title: PMCPU-LLP v0.0.1

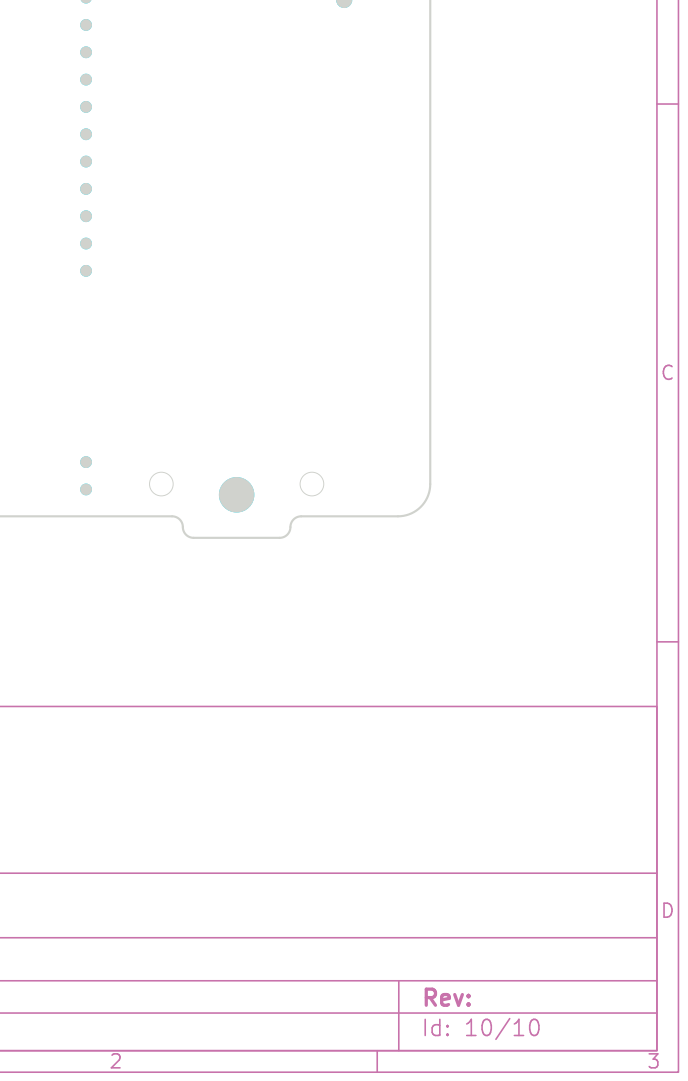
[picture p237: page 10]

Id: 10/10 Title: PMCPU-LLP v0.0.1
