Konstantin-Dudersky/plc-modules/pcb/PMCPU-LLP-v0.1.0/export/v0.0.2/PCB schematic/PMCPU-LLP.pdf

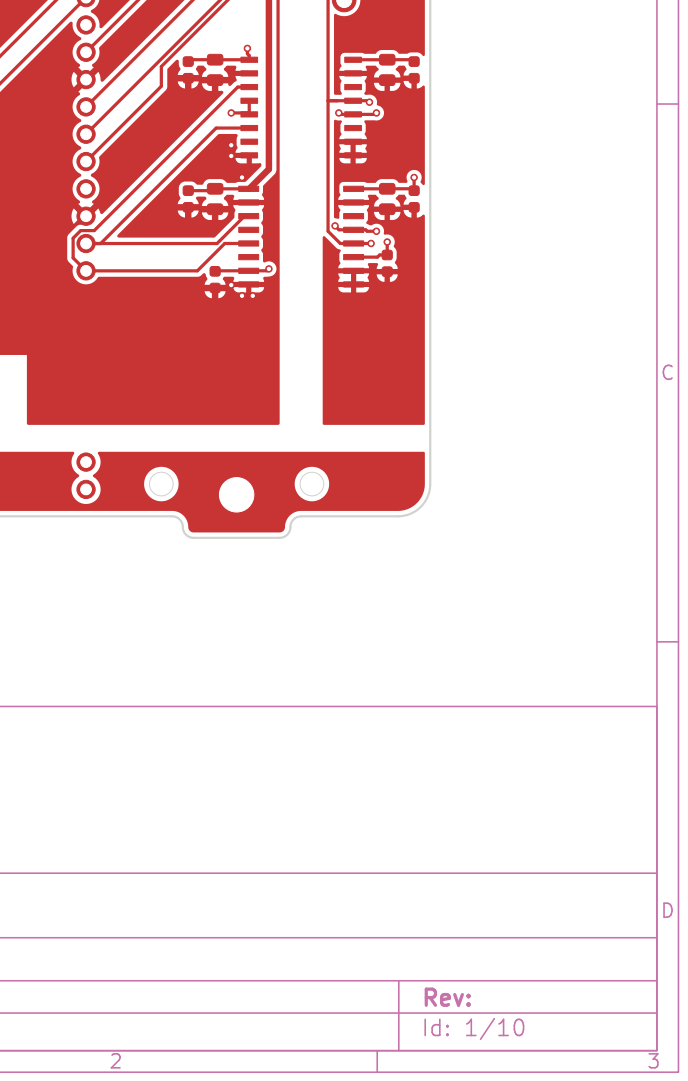
[picture p238: page 1]

Id: 1/10 Title: PMCPU-LLP v0.0.2

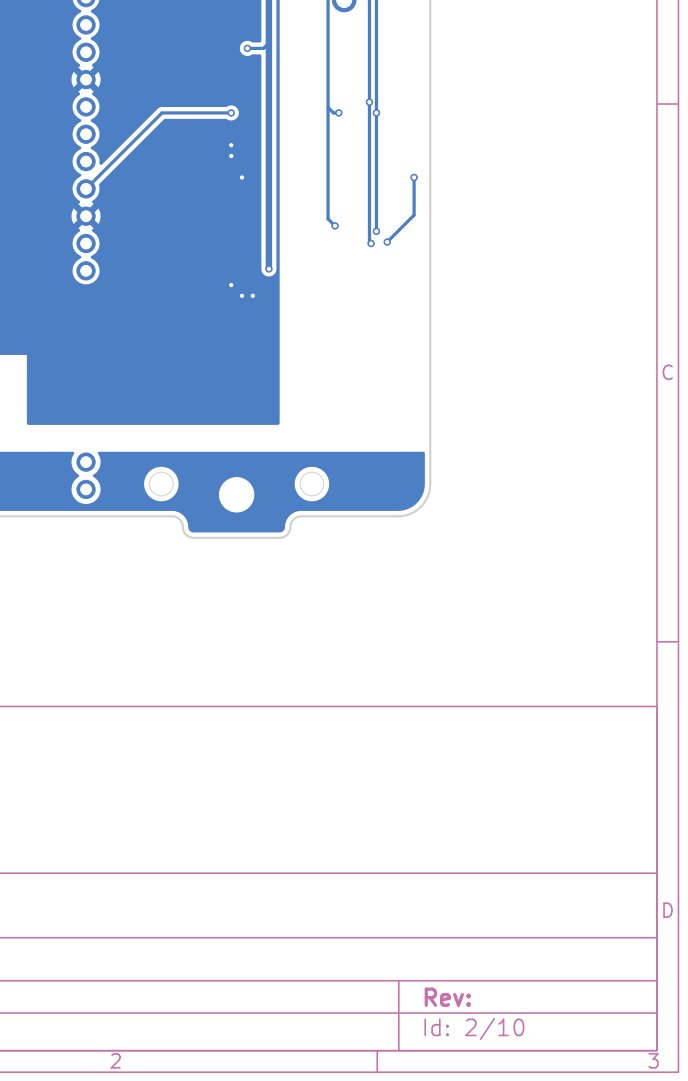
[picture p239: page 2]

Id: 2/10 Title: PMCPU-LLP v0.0.2

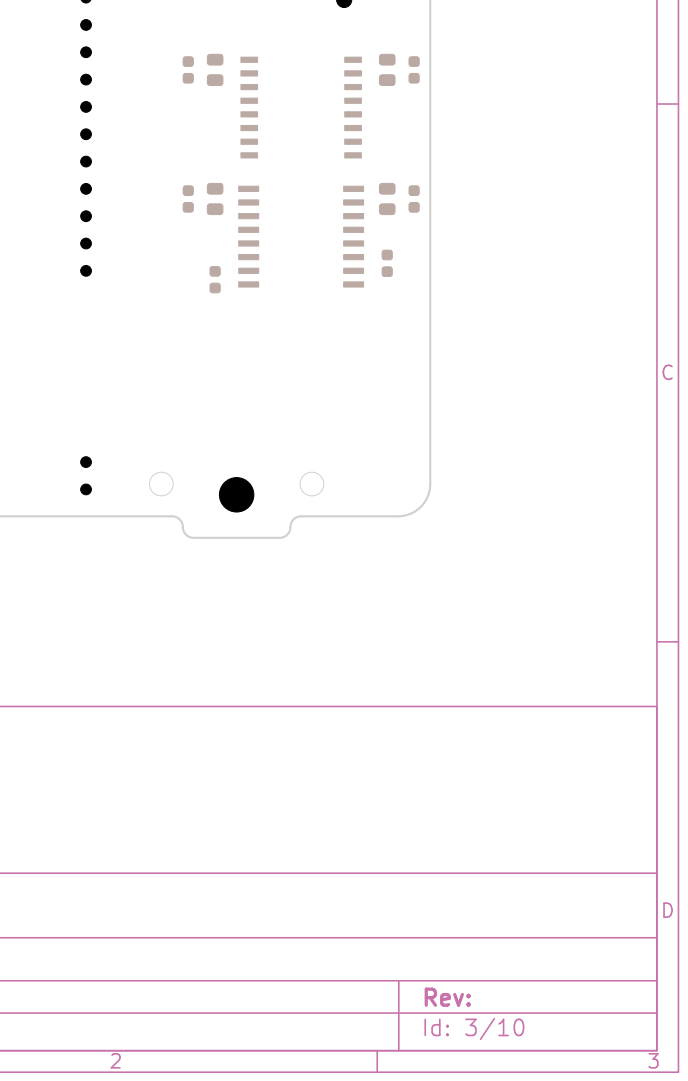
[picture p240: page 3]

Id: 3/10 Title: PMCPU-LLP v0.0.2

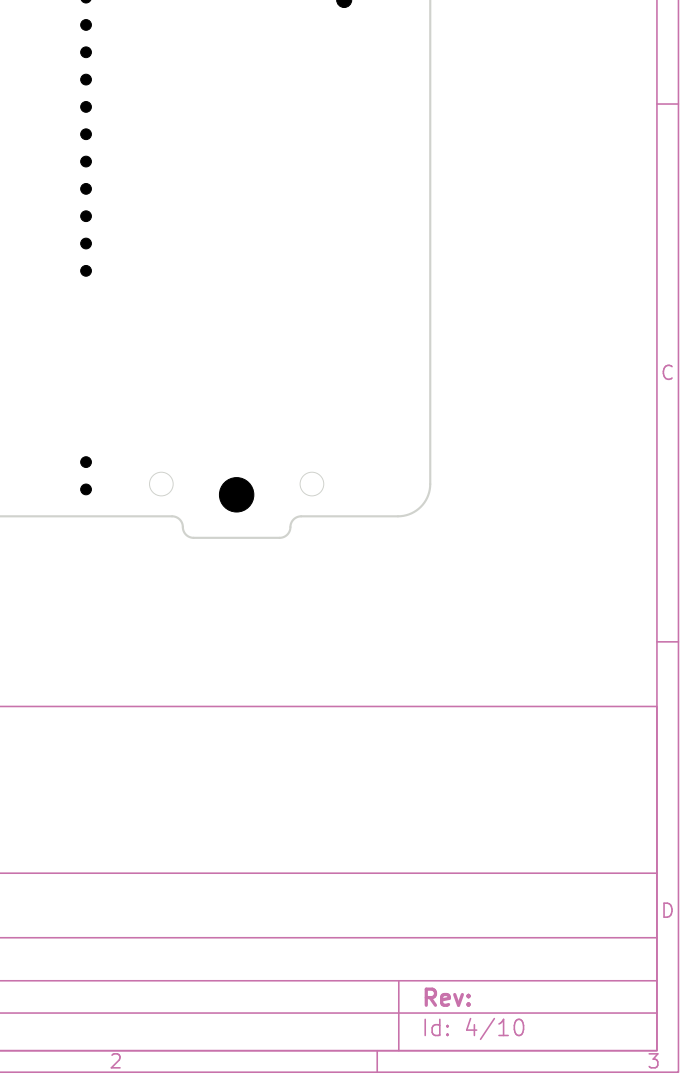
[picture p241: page 4]

Id: 4/10 Title: PMCPU-LLP v0.0.2

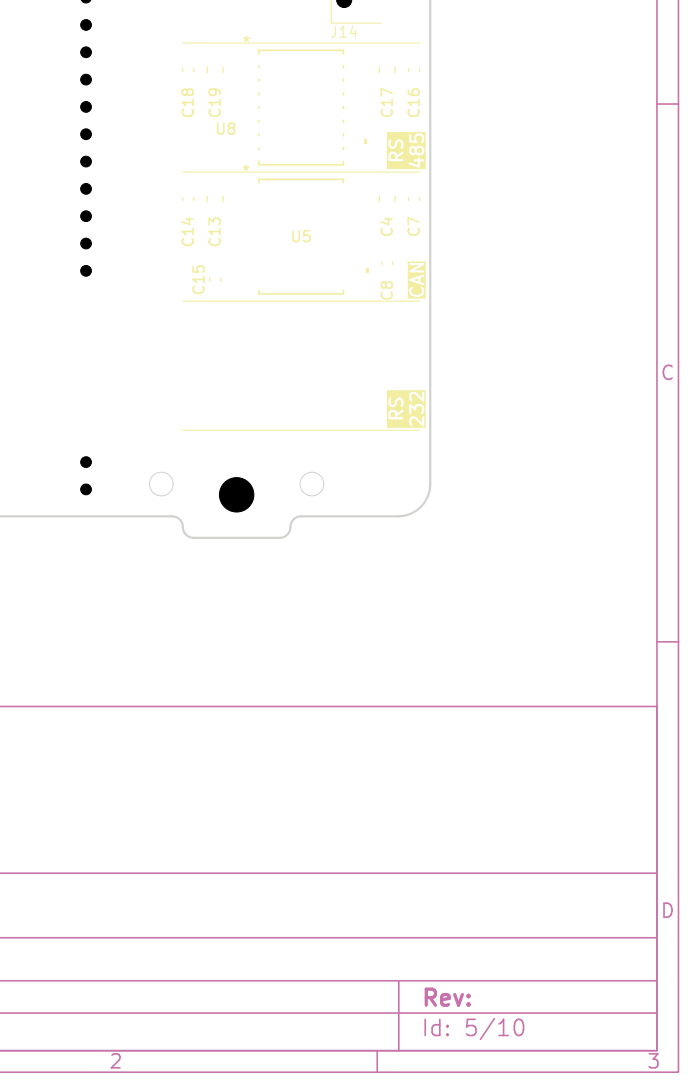
[picture p242: page 5]

Id: 5/10 Title: PMCPU-LLP v0.0.2

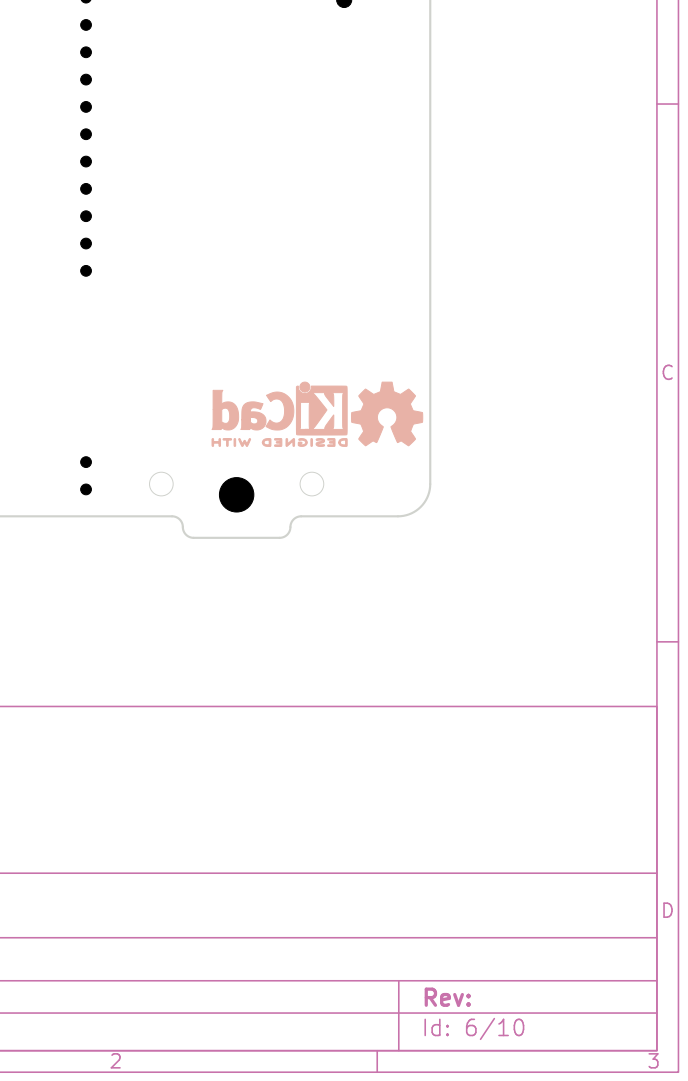
[picture p243: page 6]

Id: 6/10 Title: PMCPU-LLP v0.0.2

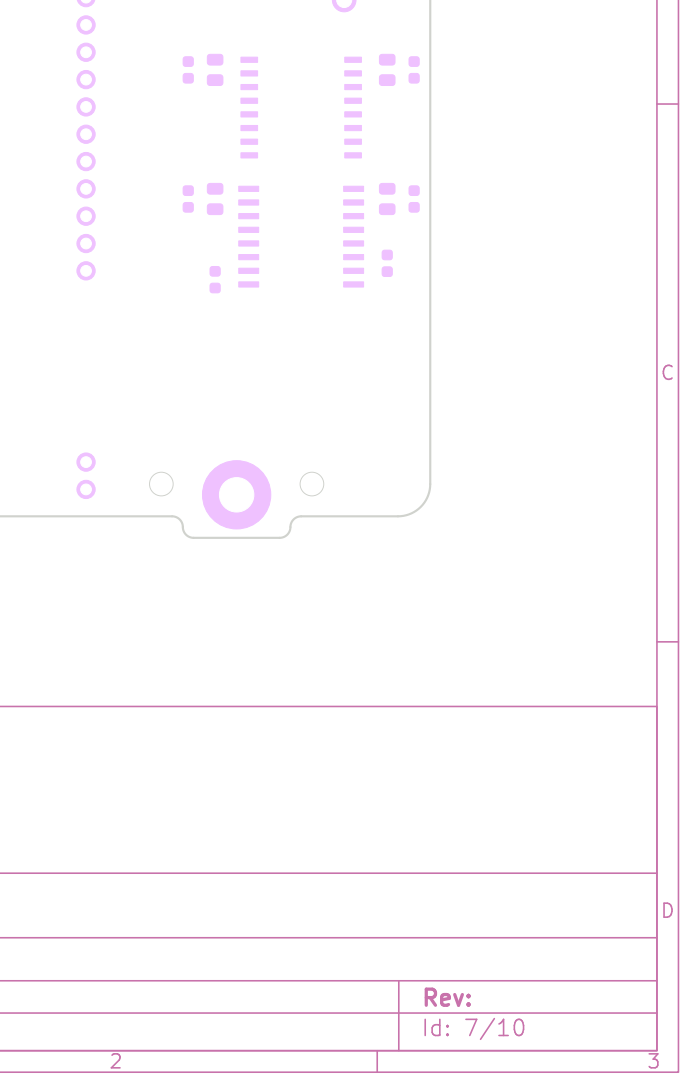
[picture p244: page 7]

Id: 7/10 Title: PMCPU-LLP v0.0.2

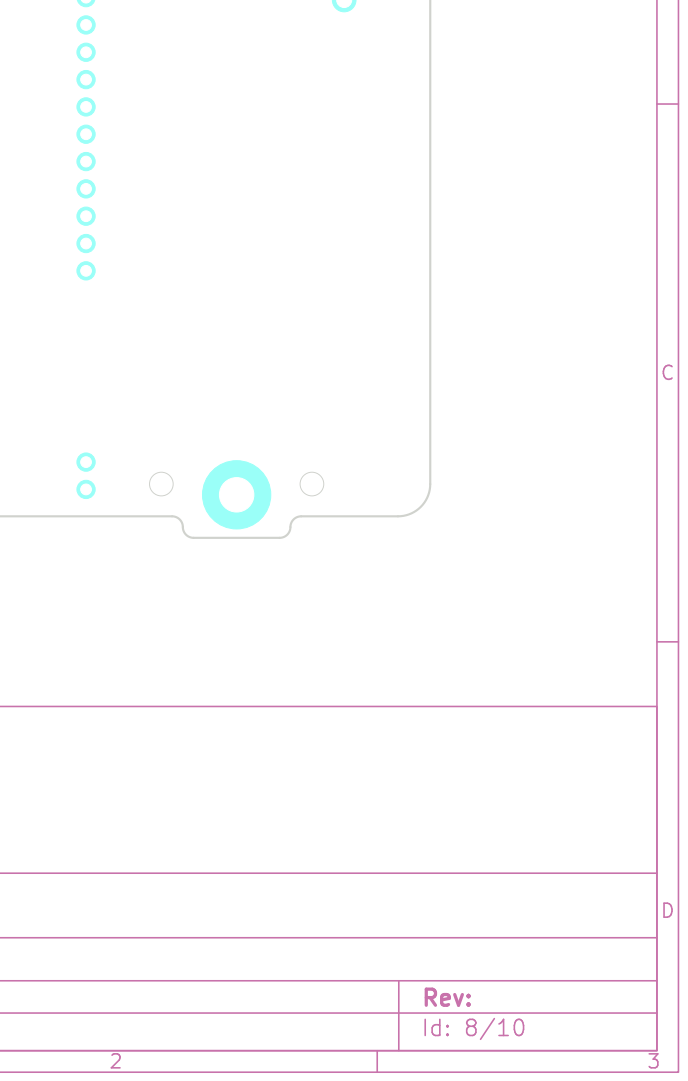
[picture p245: page 8]

Id: 8/10 Title: PMCPU-LLP v0.0.2

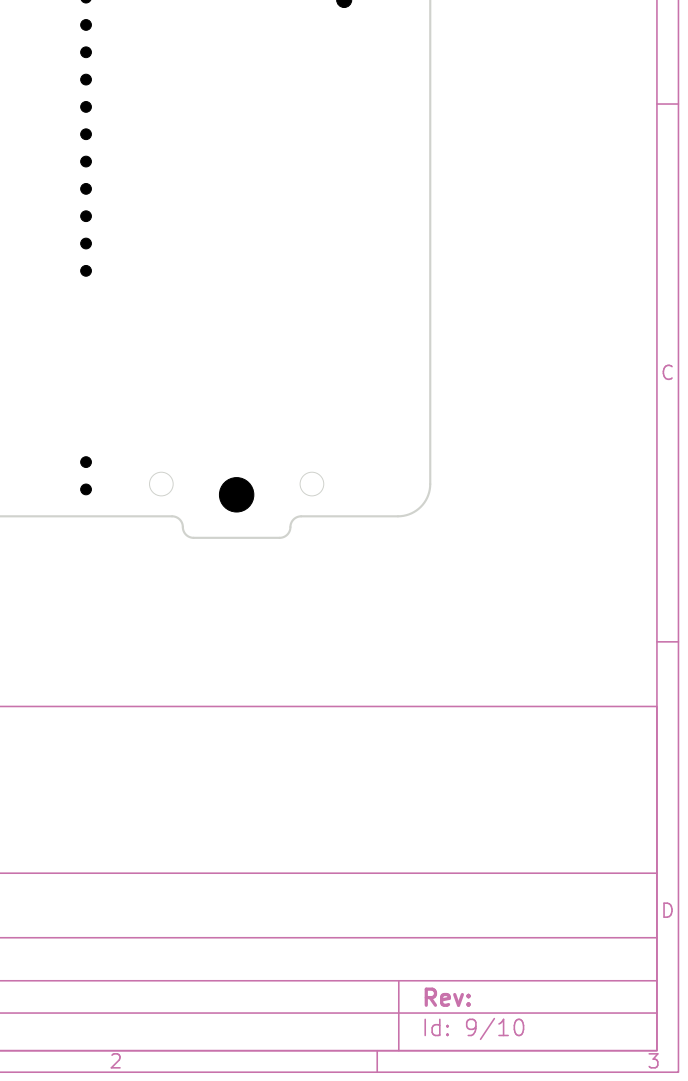
[picture p246: page 9]

Id: 9/10 Title: PMCPU-LLP v0.0.2

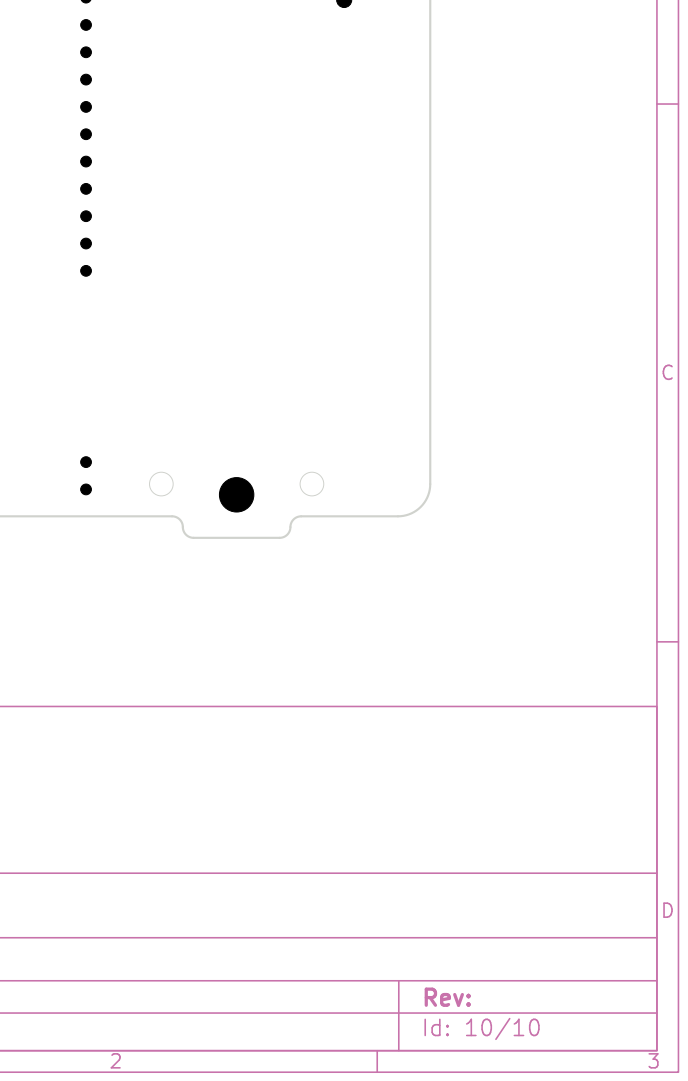
[picture p247: page 10]

Id: 10/10 Title: PMCPU-LLP v0.0.2
