Konstantin-Dudersky/plc-modules/pcb/PMCPU-LLP-v0.1.0/export/v0.0.3/PCB schematic/PMCPU-LLP.pdf

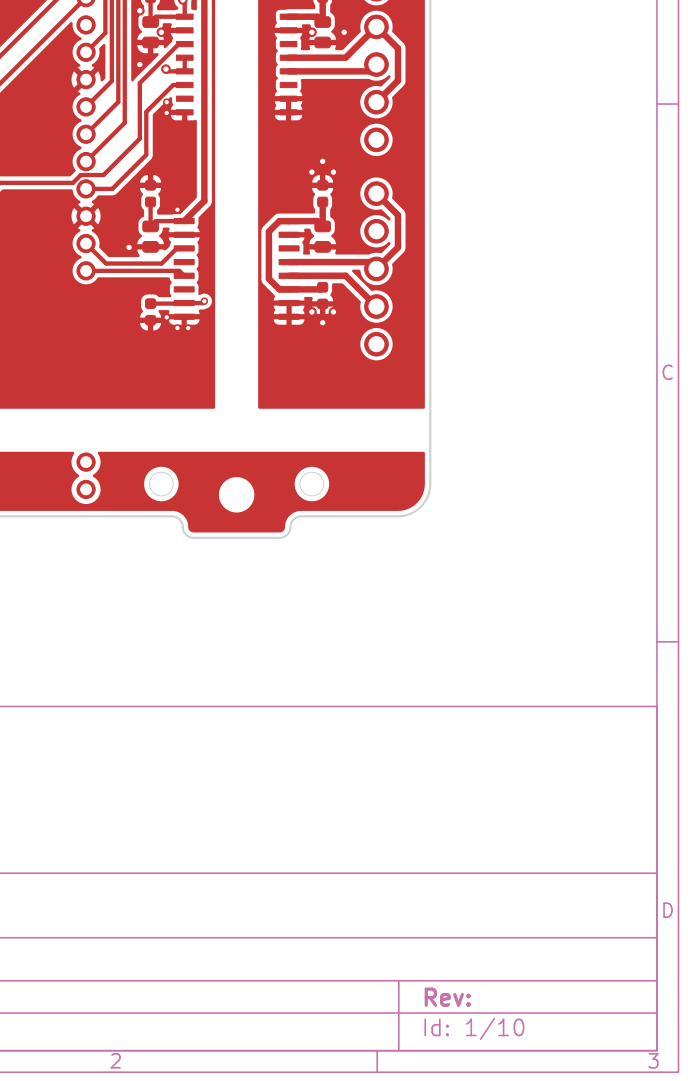
[picture p248: page 1]

Id: 1/10 Title: PMCPU-LLP v0.0.3

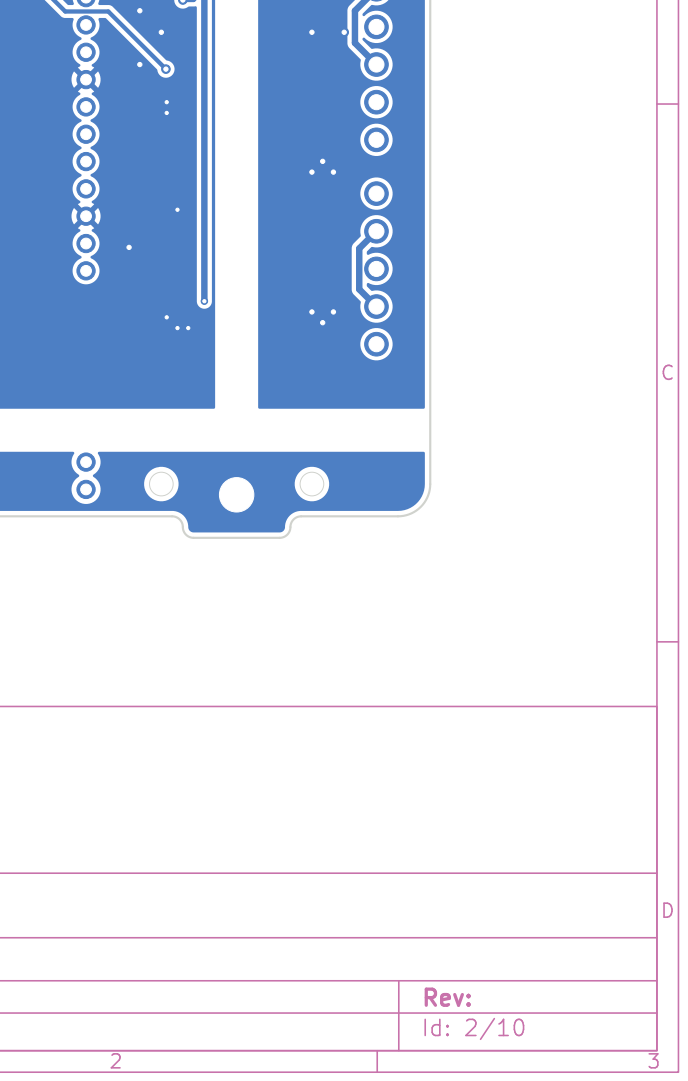
[picture p249: page 2]

Id: 2/10 Title: PMCPU-LLP v0.0.3

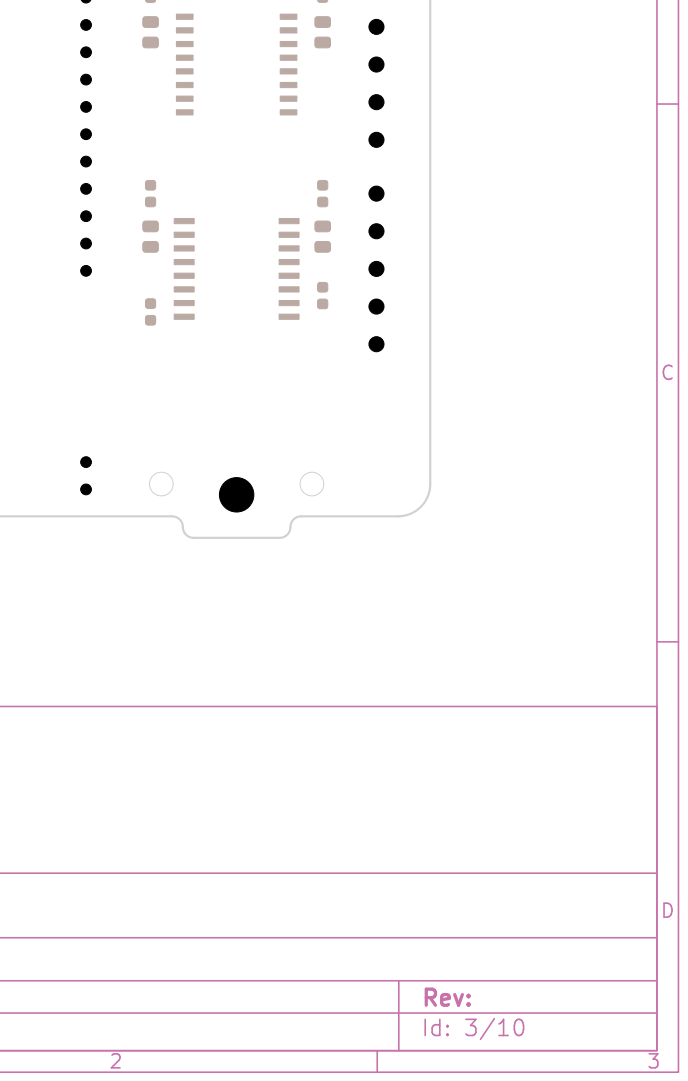
[picture p250: page 3]

Id: 3/10 Title: PMCPU-LLP v0.0.3

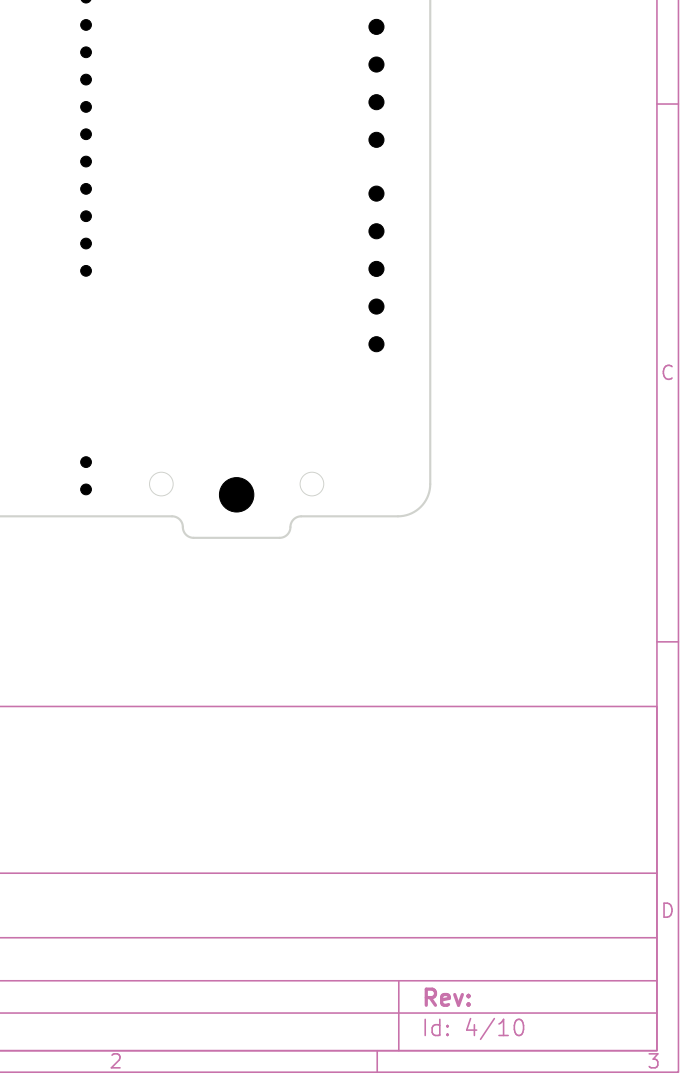
[picture p251: page 4]

Id: 4/10 Title: PMCPU-LLP v0.0.3

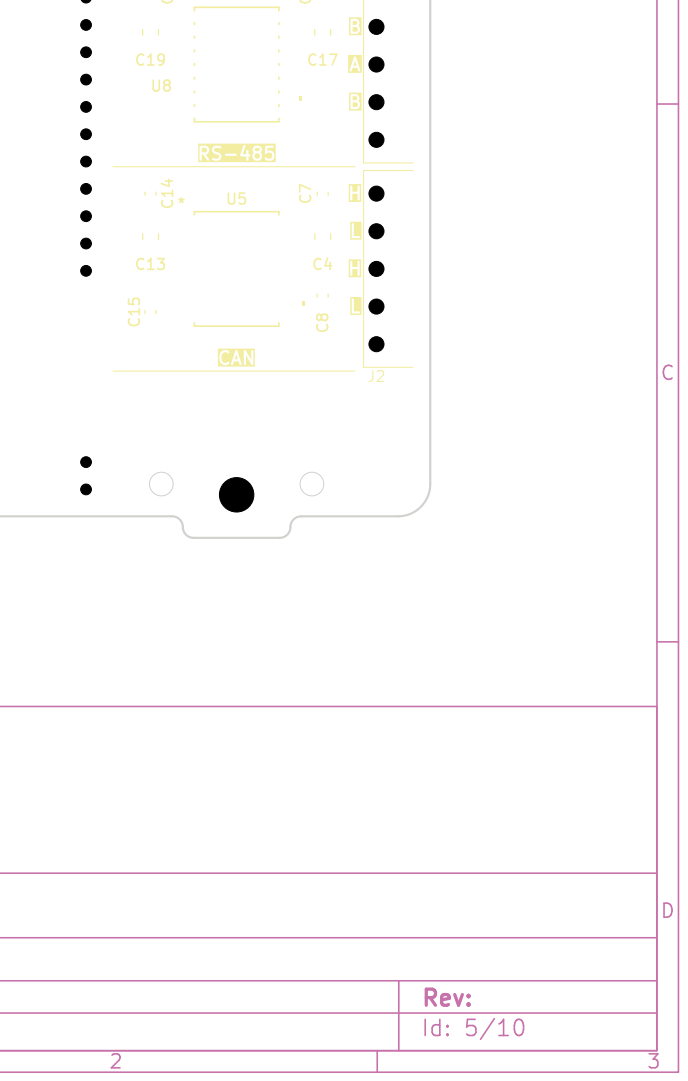
[picture p252: page 5]

Id: 5/10 Title: PMCPU-LLP v0.0.3

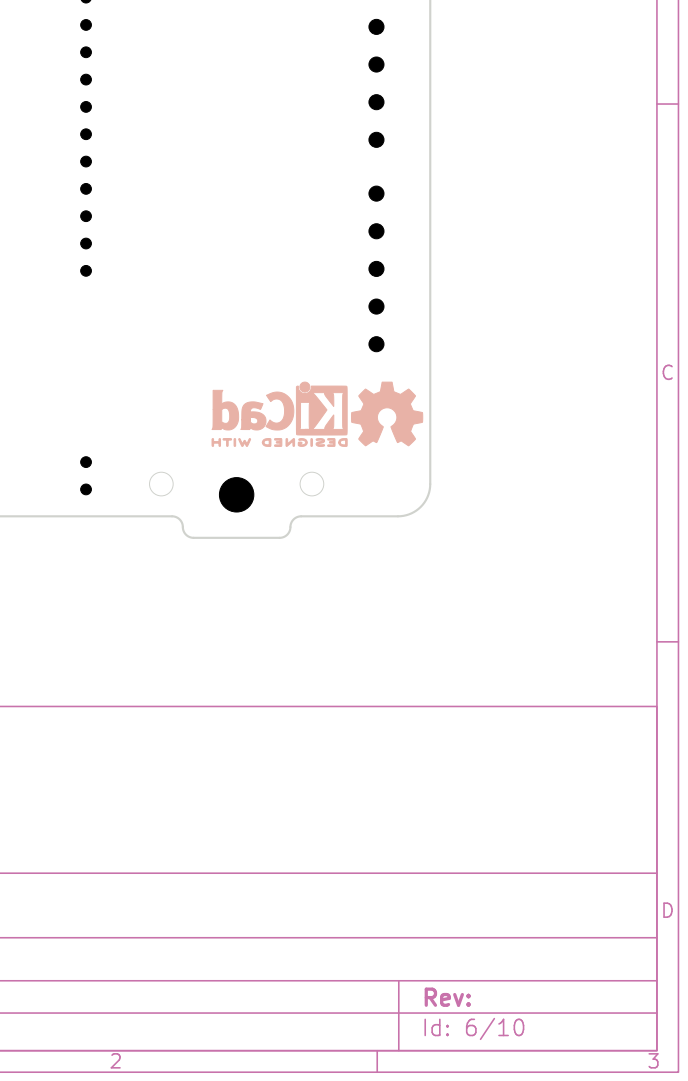
[picture p253: page 6]

Id: 6/10 Title: PMCPU-LLP v0.0.3

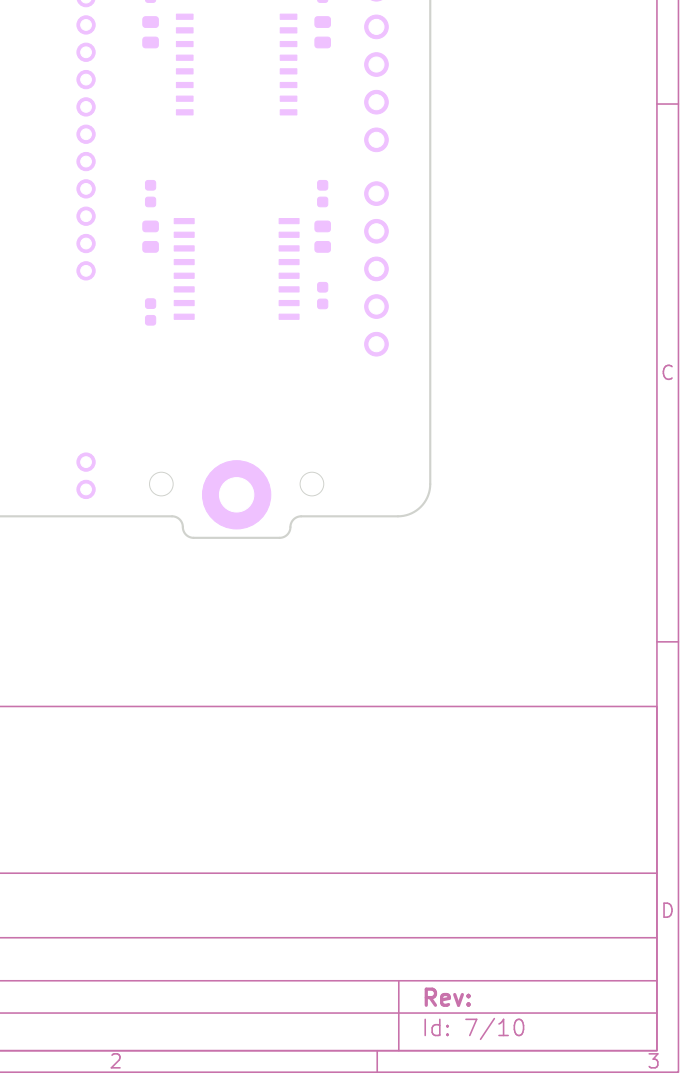
[picture p254: page 7]

Id: 7/10 Title: PMCPU-LLP v0.0.3

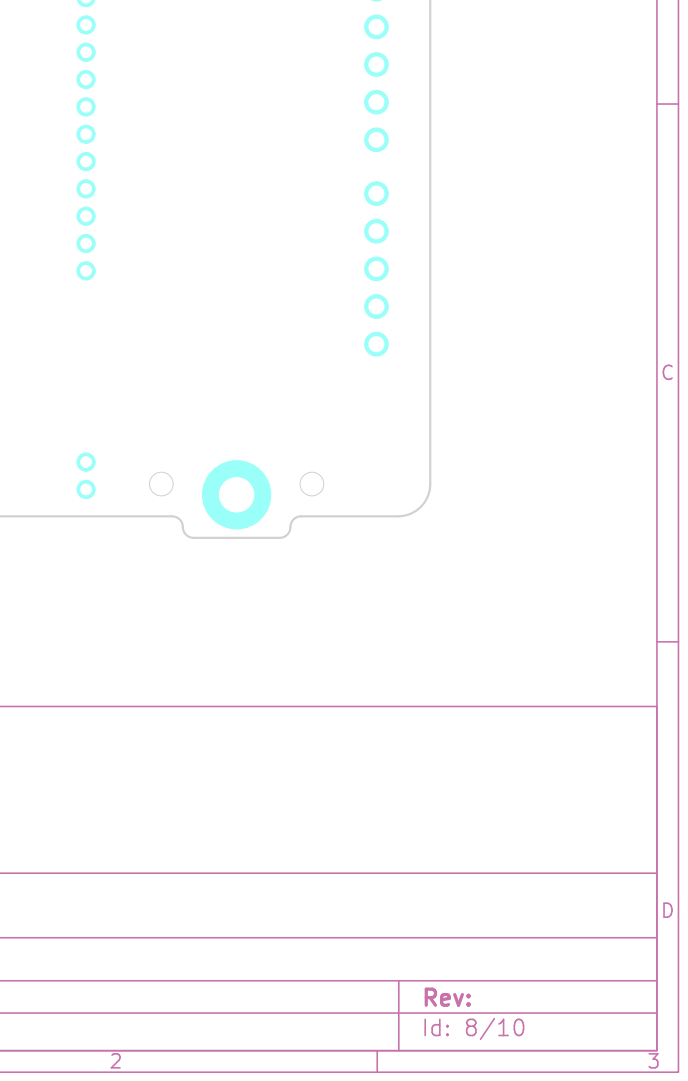
[picture p255: page 8]

Id: 8/10 Title: PMCPU-LLP v0.0.3

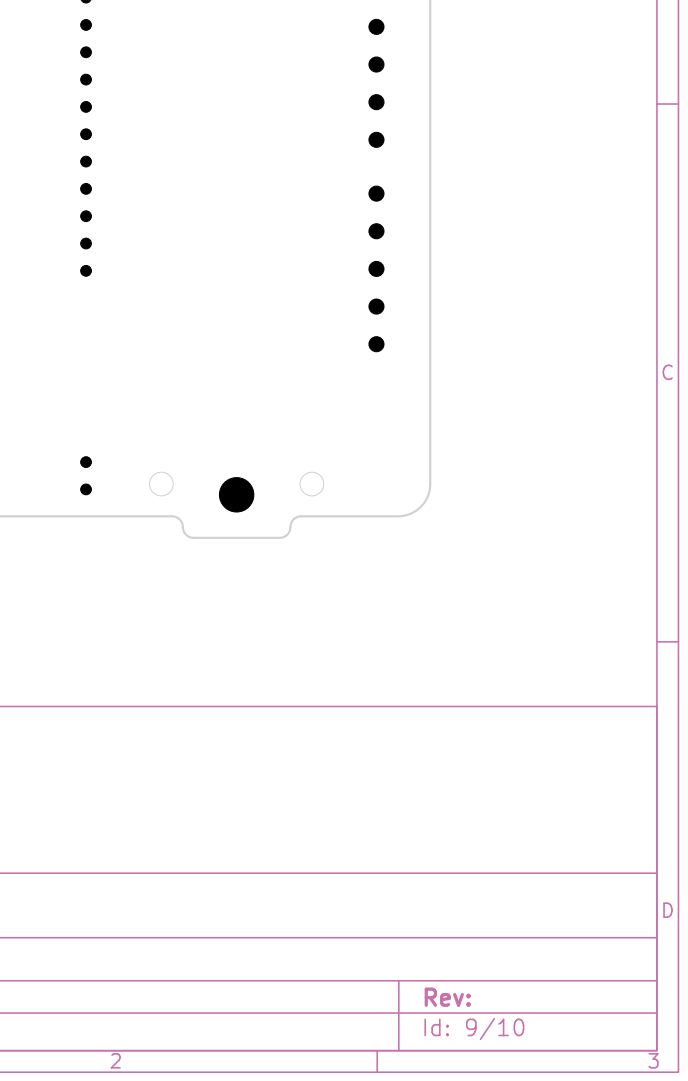
[picture p256: page 9]

Id: 9/10 Title: PMCPU-LLP v0.0.3

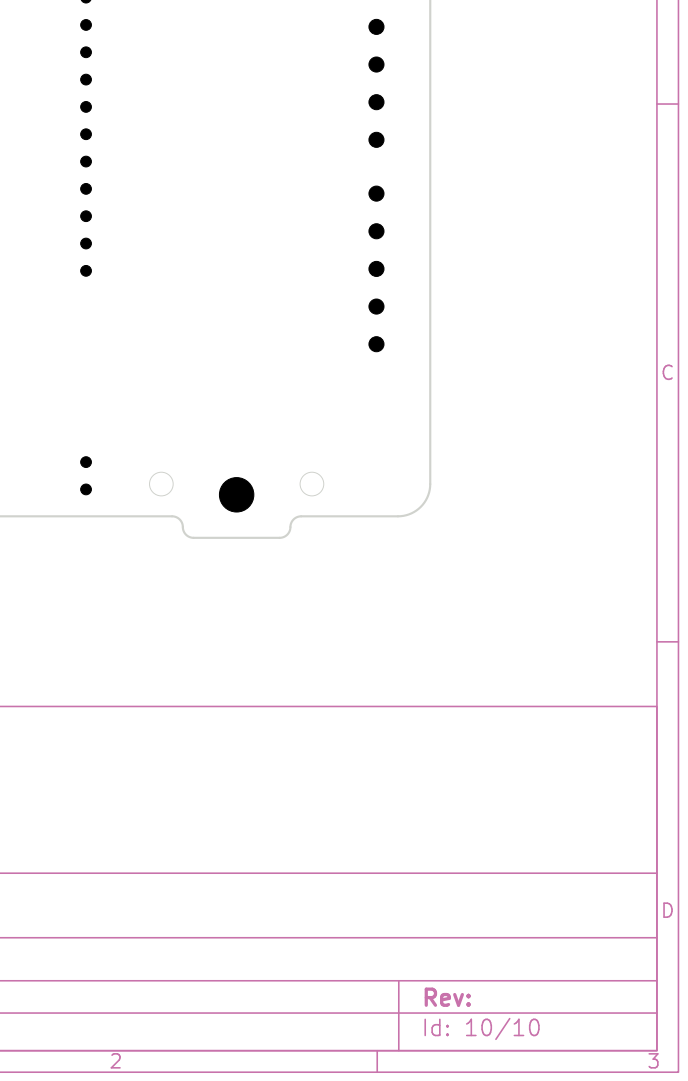
[picture p257: page 10]

Id: 10/10 Title: PMCPU-LLP v0.0.3
