Konstantin-Dudersky/plc-modules/pcb/PMPS-20W-v0.1.0/export/v0.0.4/PCB schematic/PMPS-20W.pdf

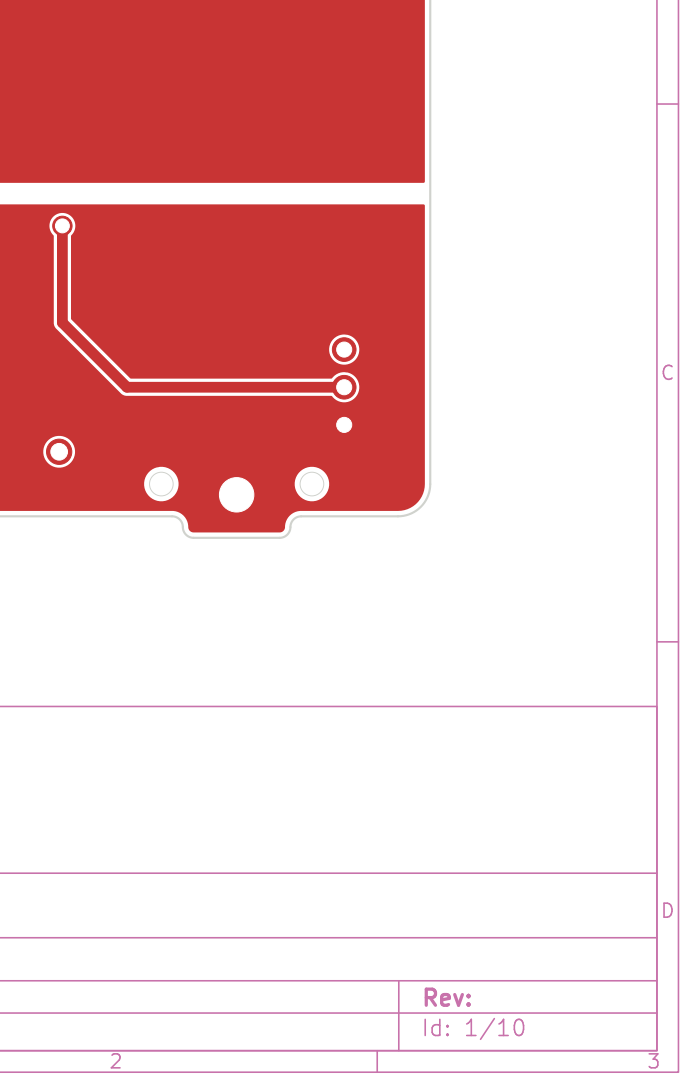
[picture p258: page 1]

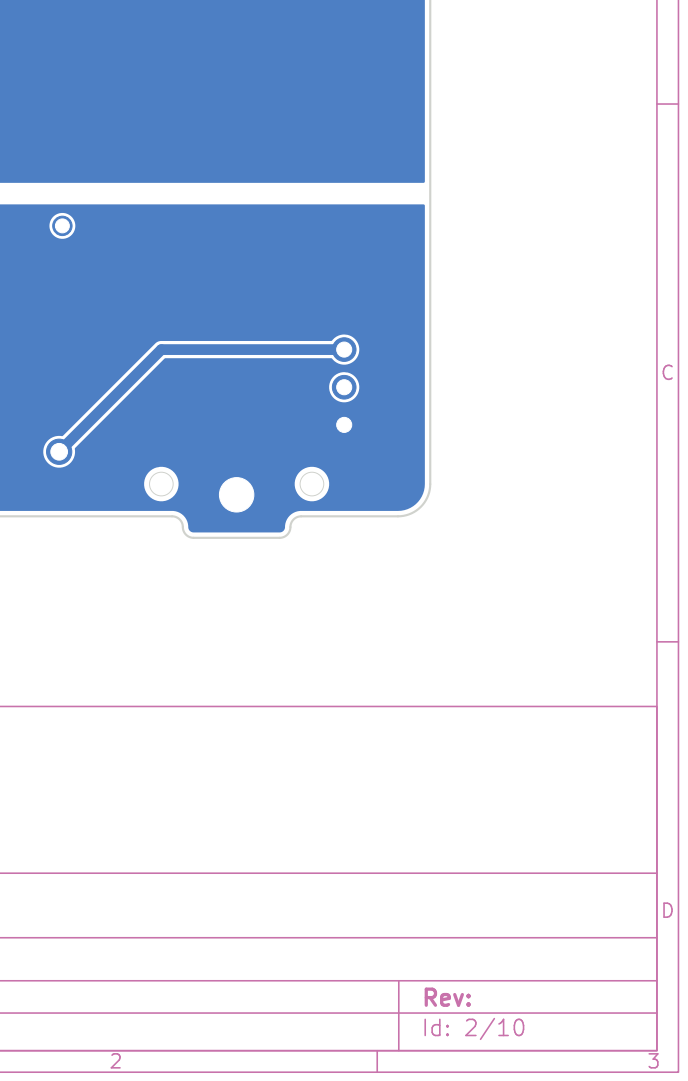
[picture p259: page 2]

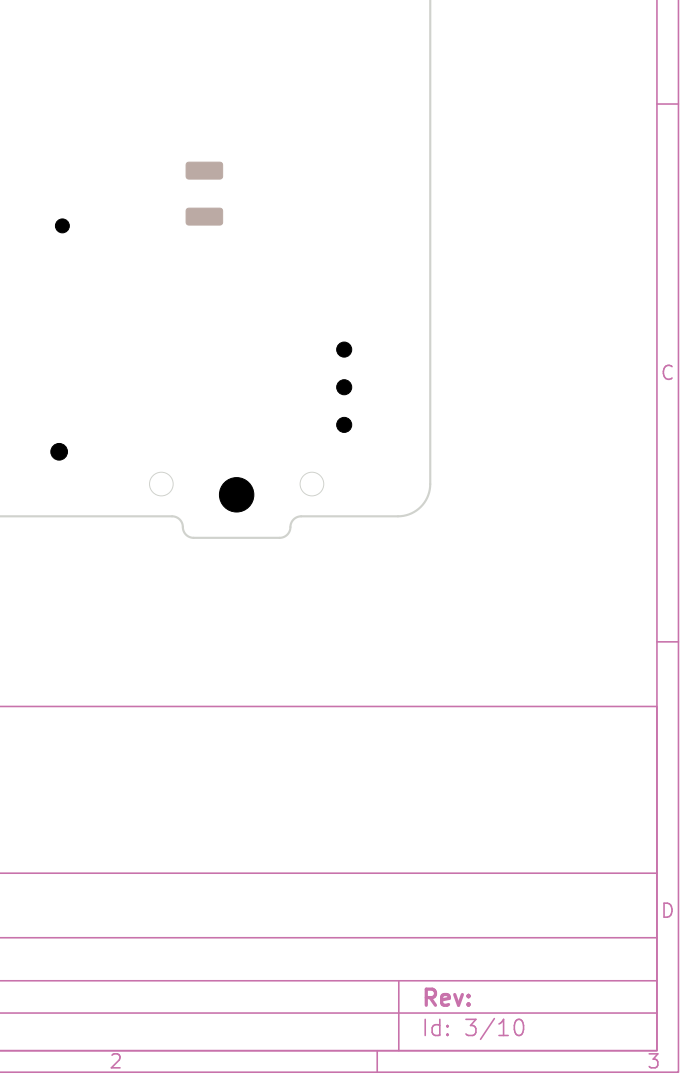
[picture p260: page 3]

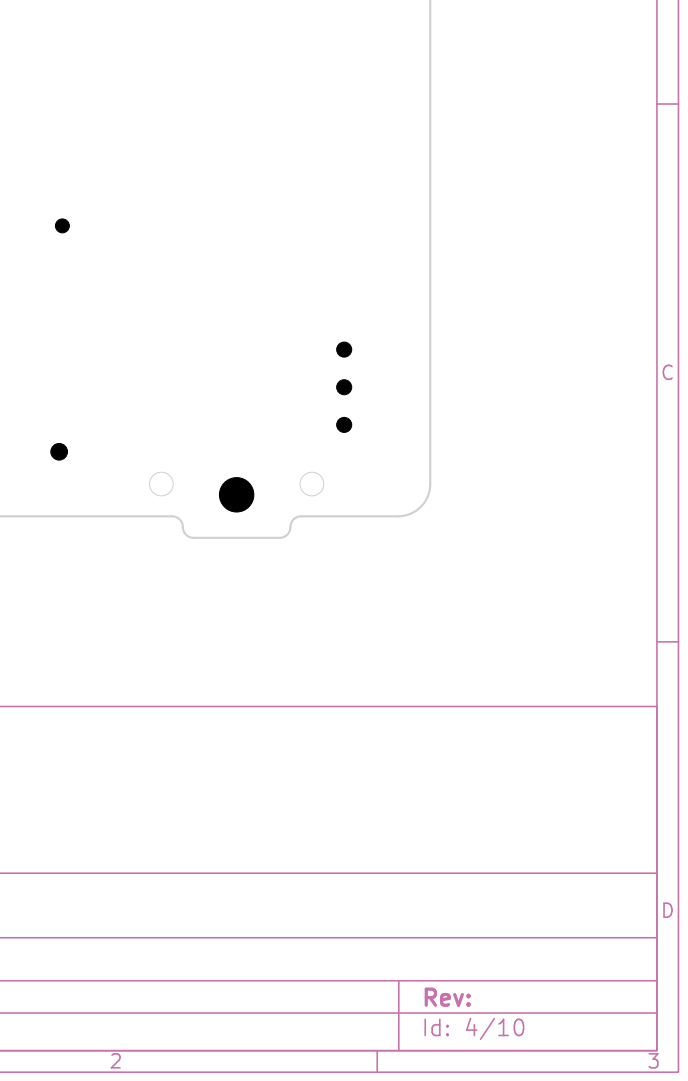
[picture p261: page 4]

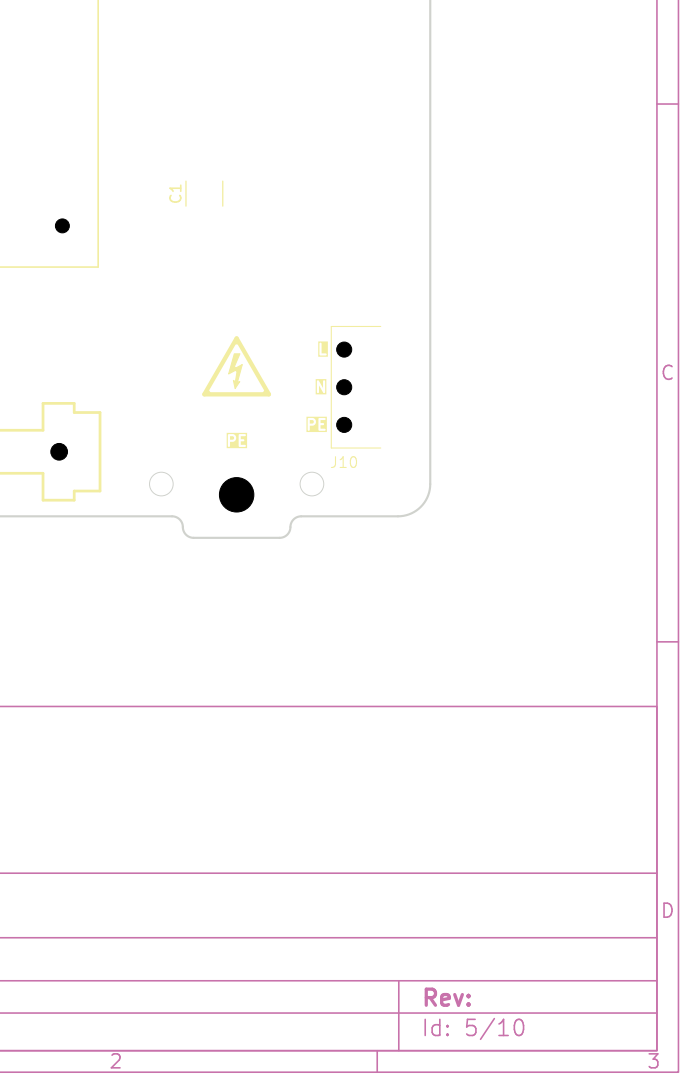
[picture p262: page 5]

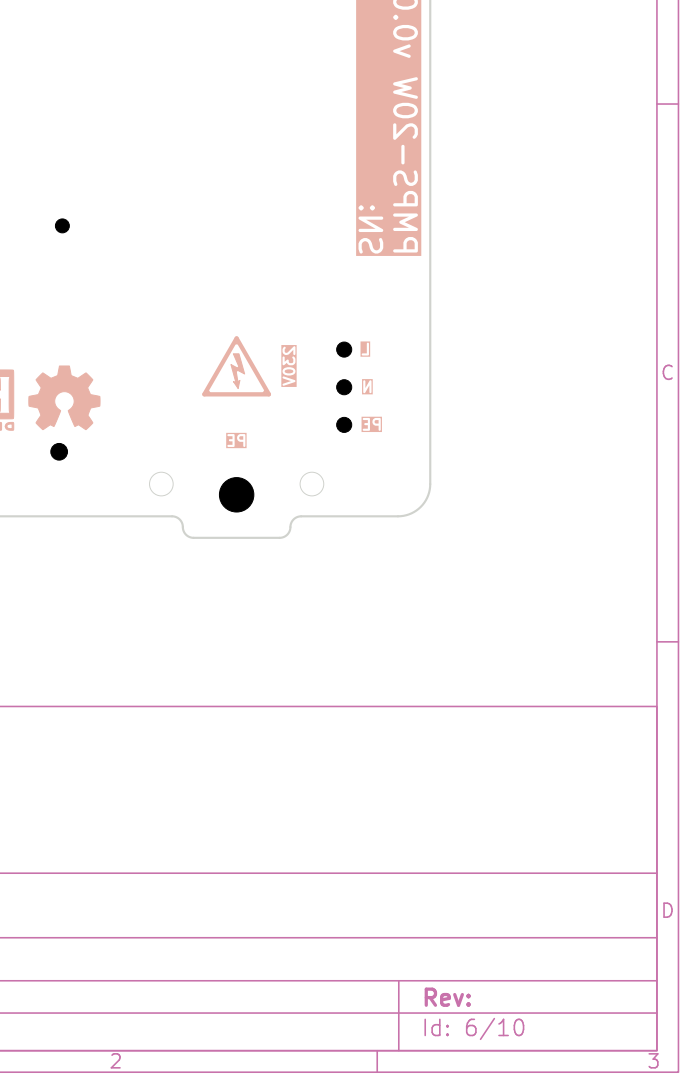
[picture p263: page 6]

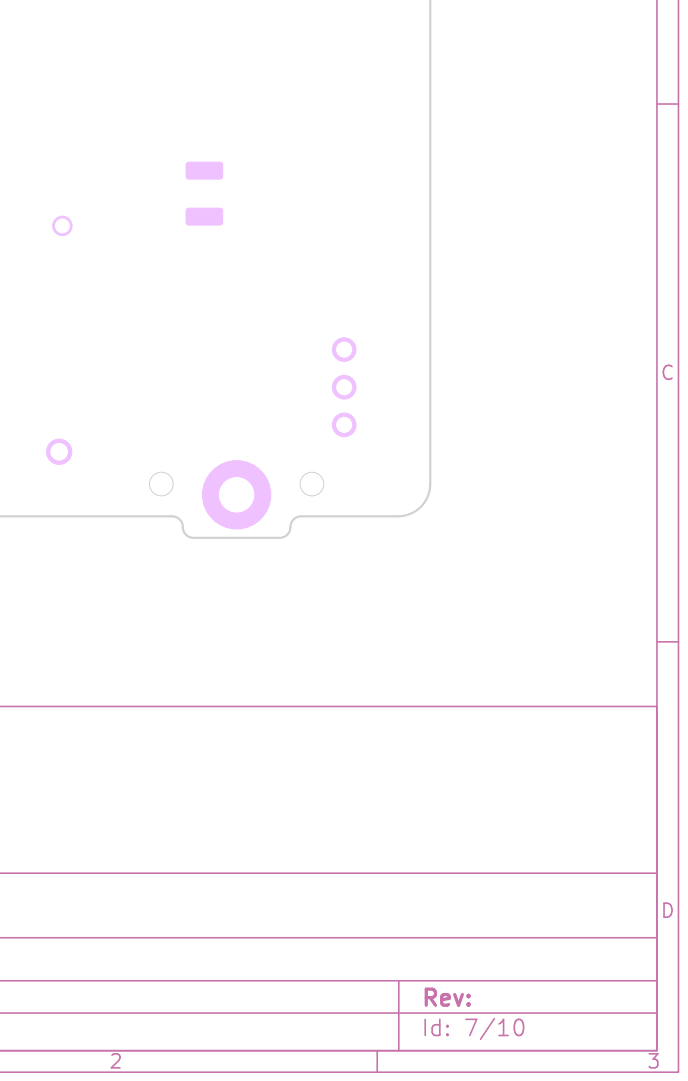
[picture p264: page 7]

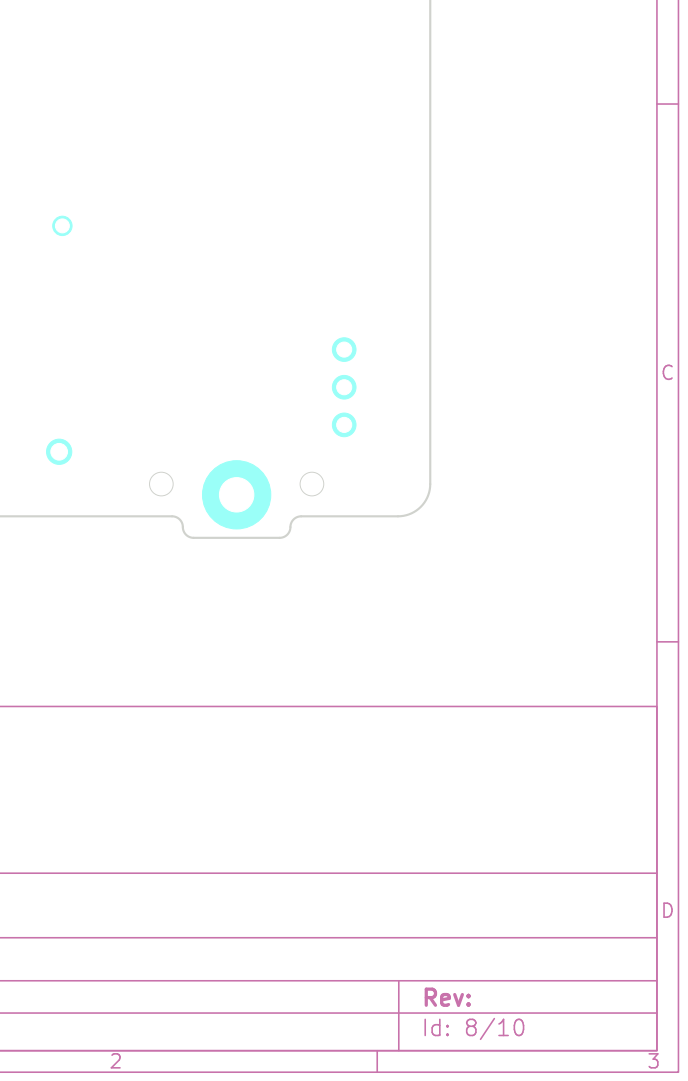
[picture p265: page 8]

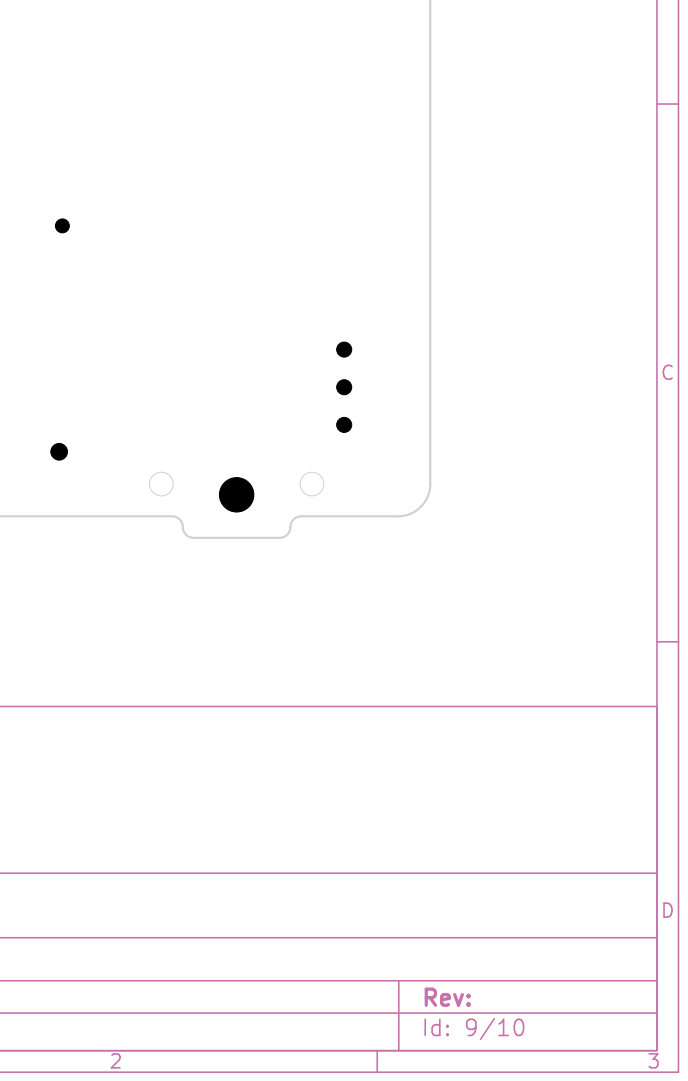
[picture p266: page 9]

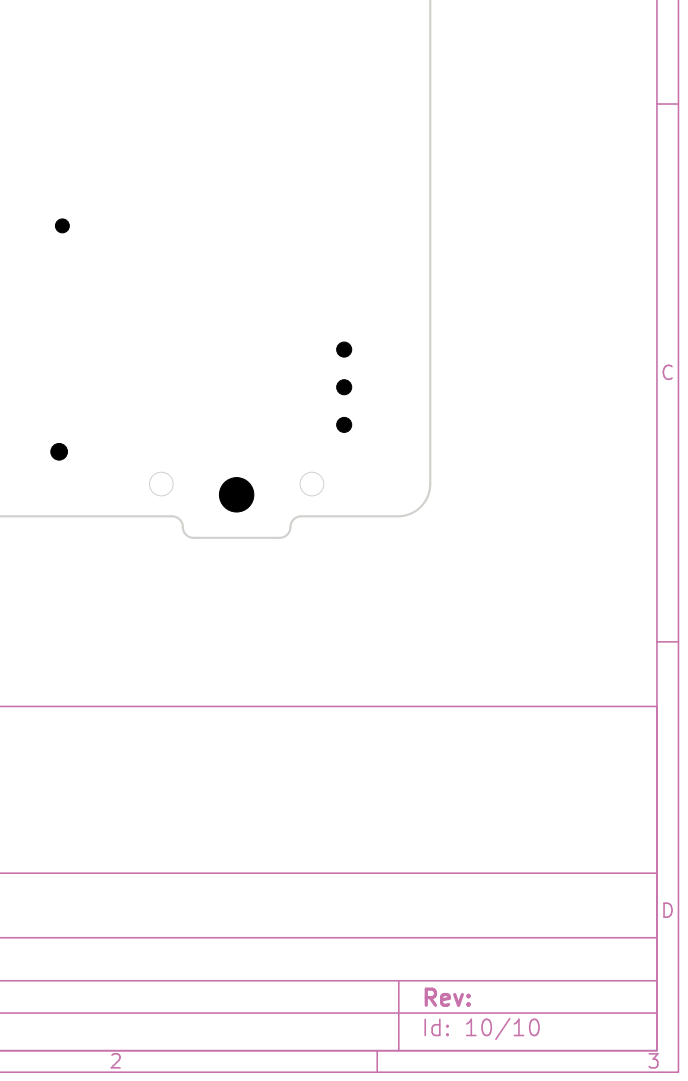
[picture p267: page 10]
