Konstantin-Dudersky/plc-modules/pcb/PMCNV-DQx16-v0.1.0/export/v0.0.4/PCB schematic/PMCNV-DQ16src.pdf

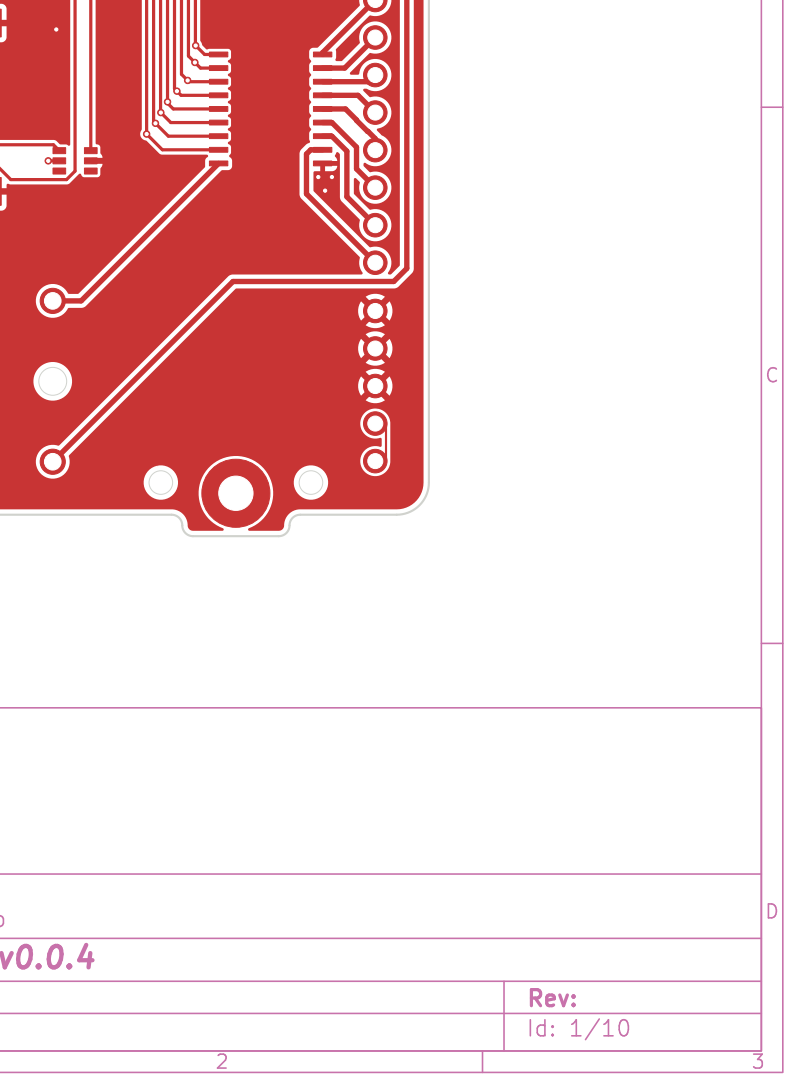
[picture p268: page 1]

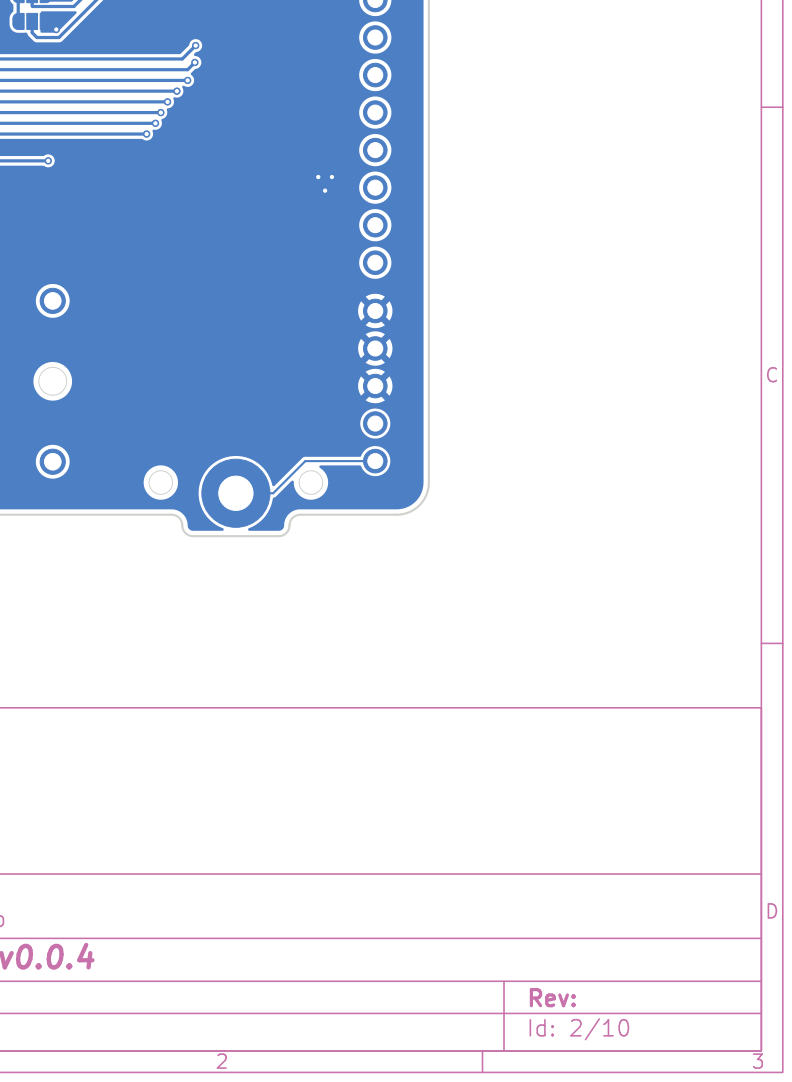
[picture p269: page 2]

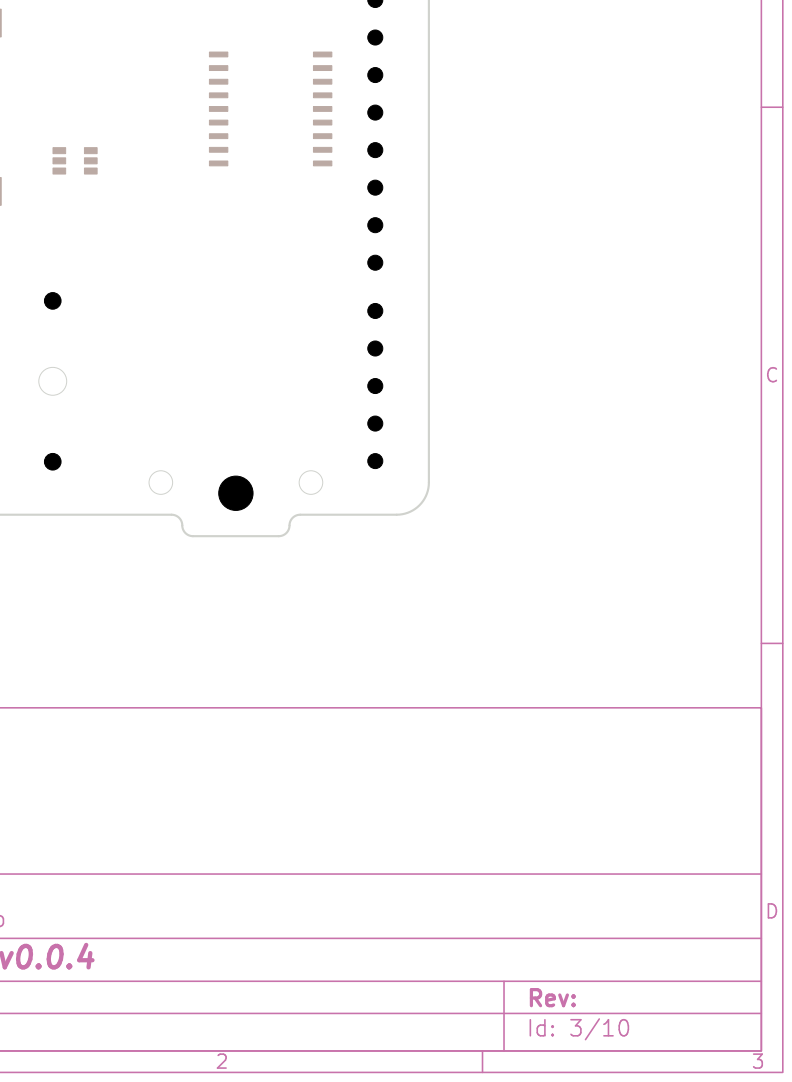
[picture p270: page 3]

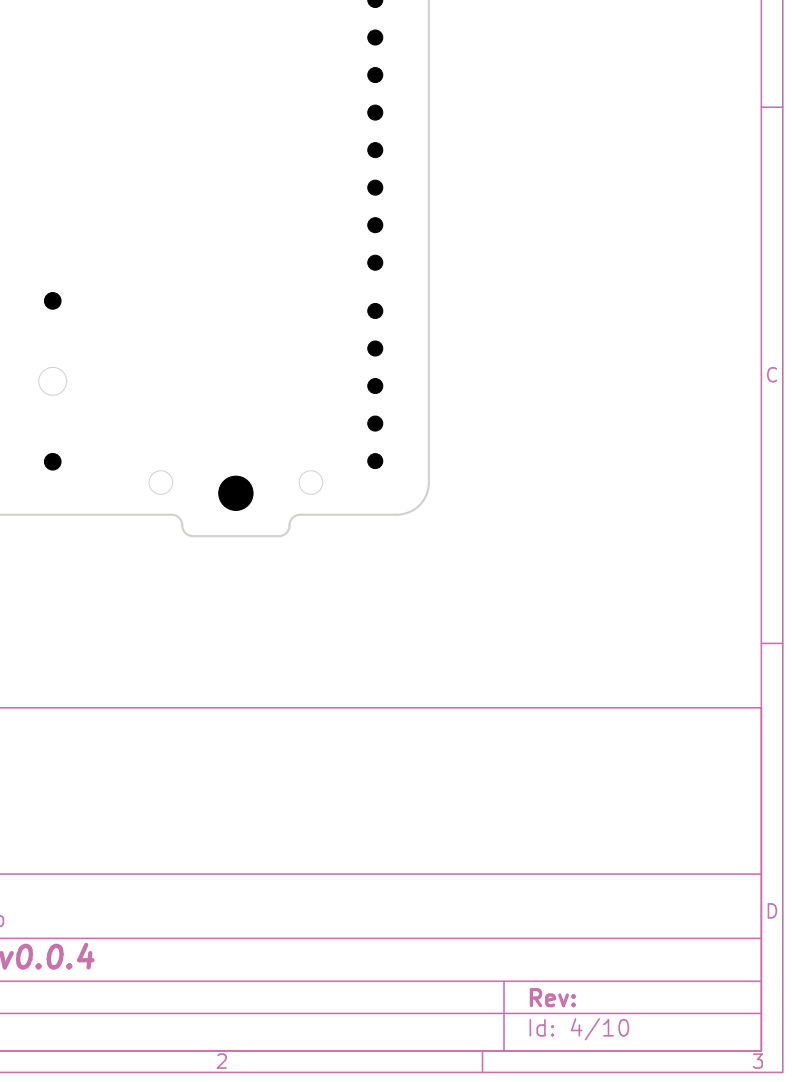
[picture p271: page 4]

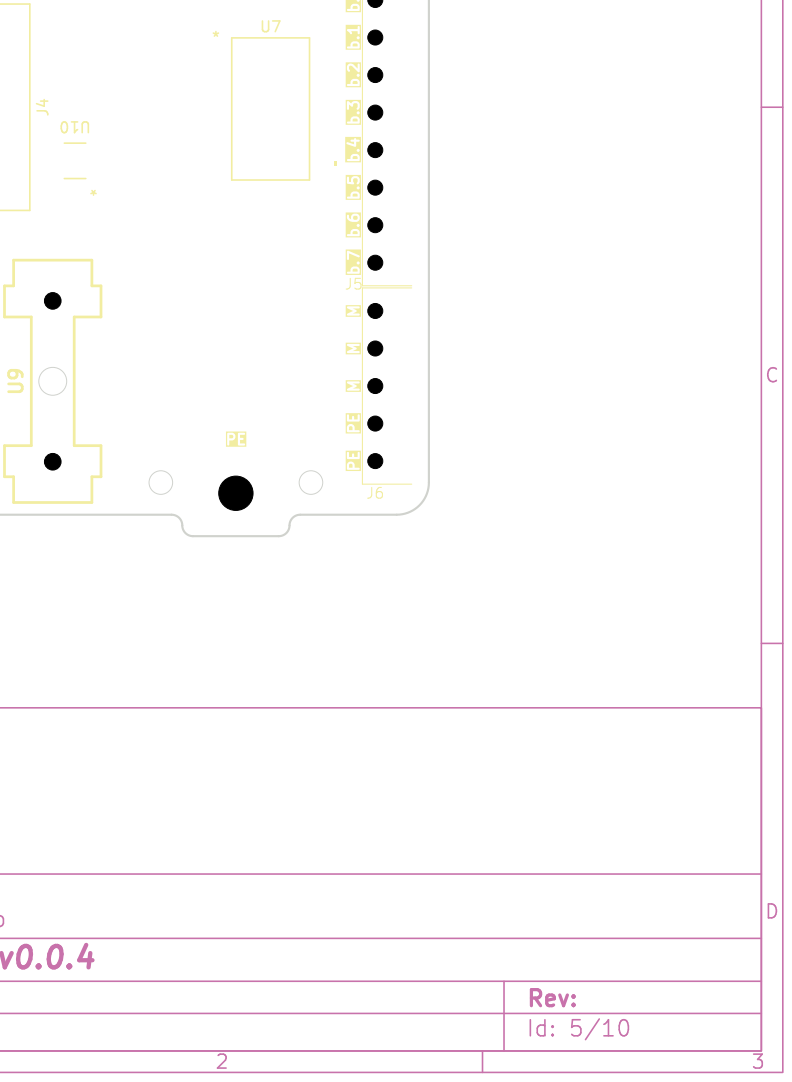
[picture p272: page 5]

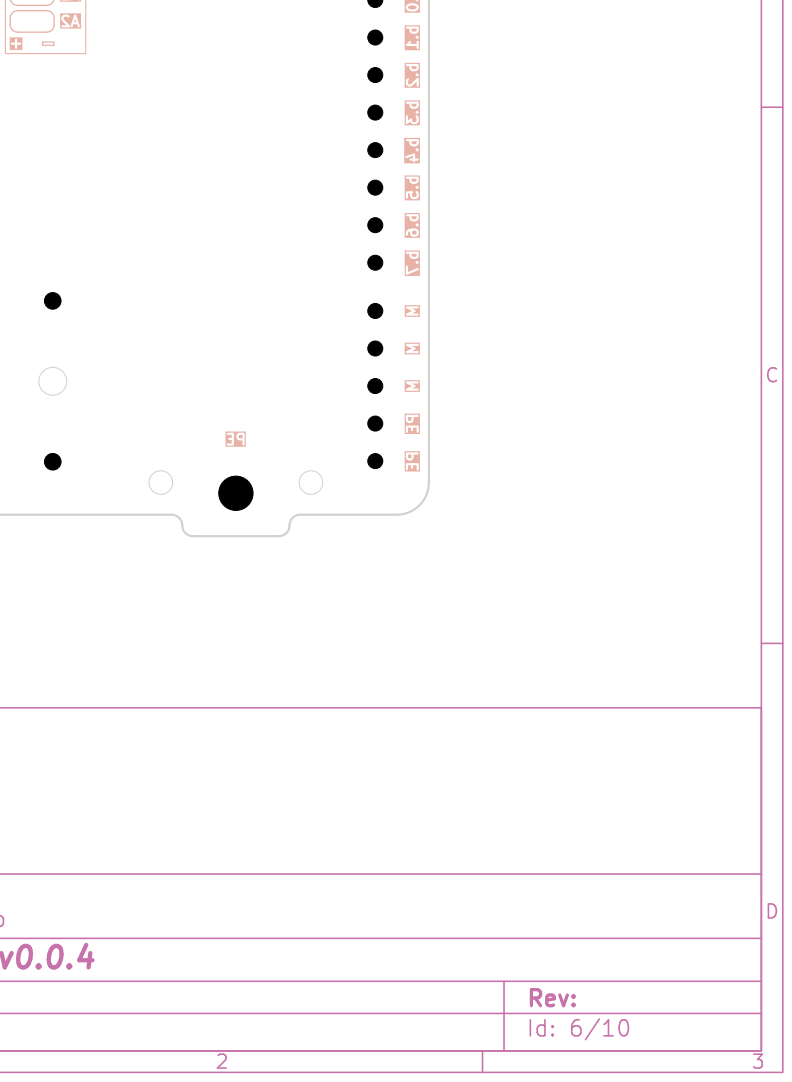
[picture p273: page 6]

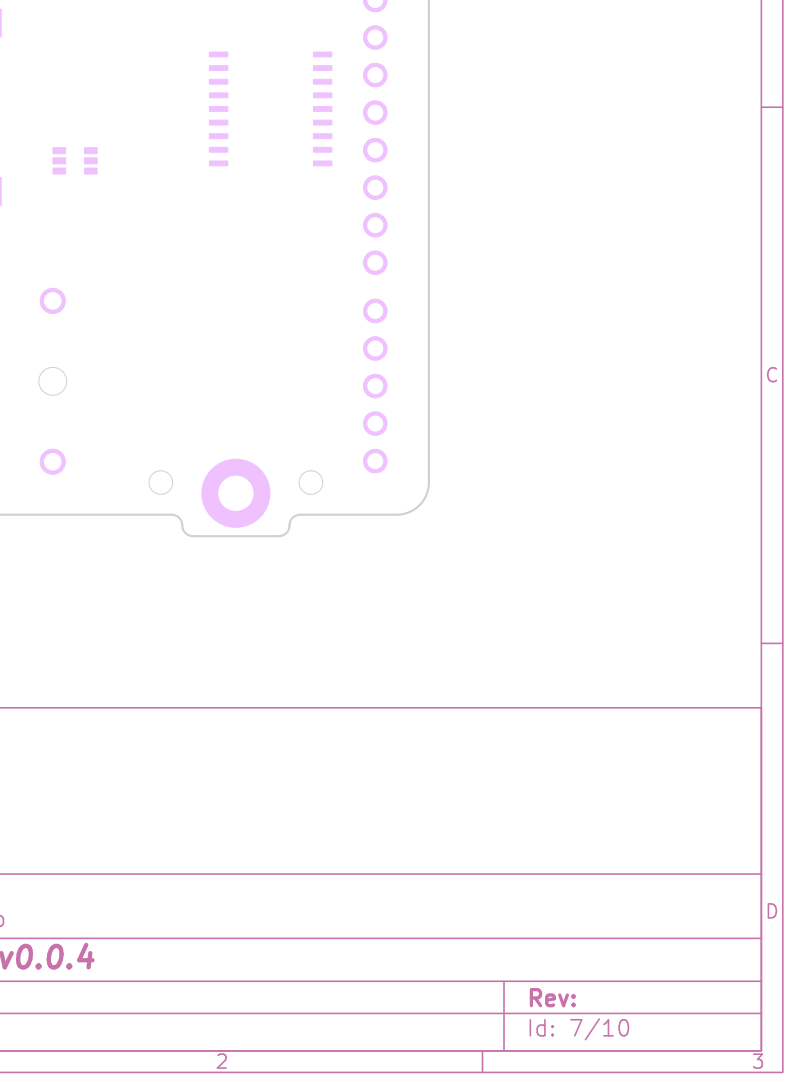
[picture p274: page 7]

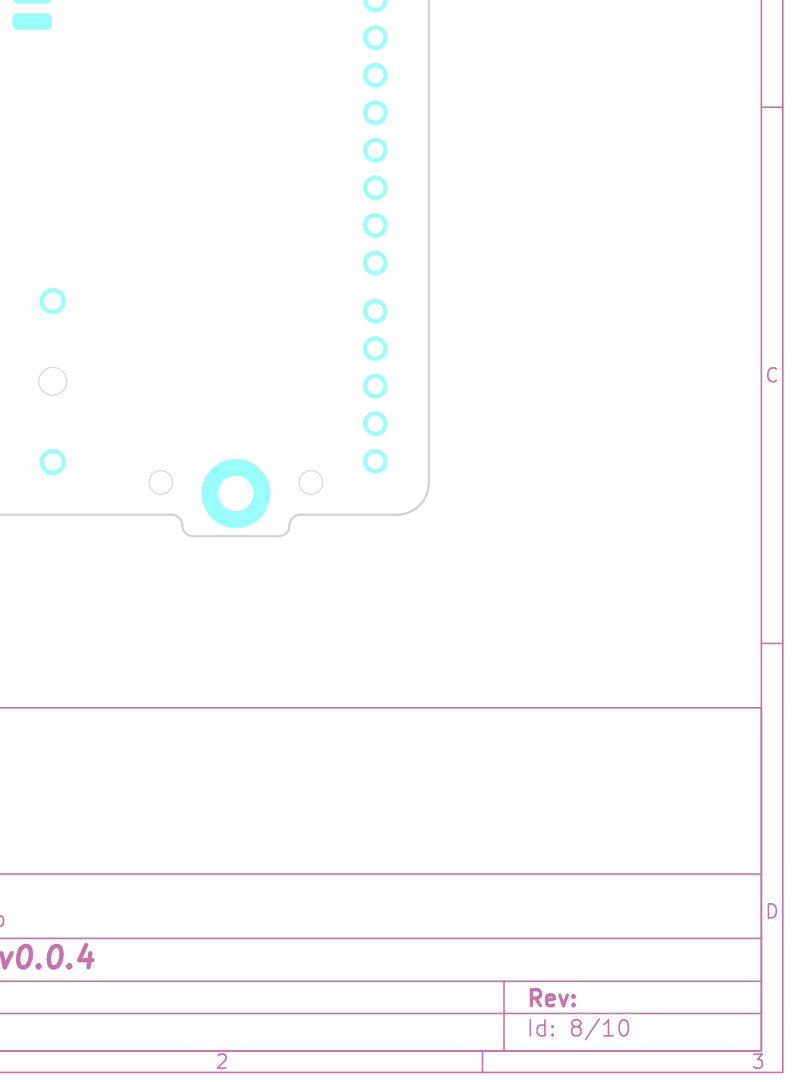
[picture p275: page 8]

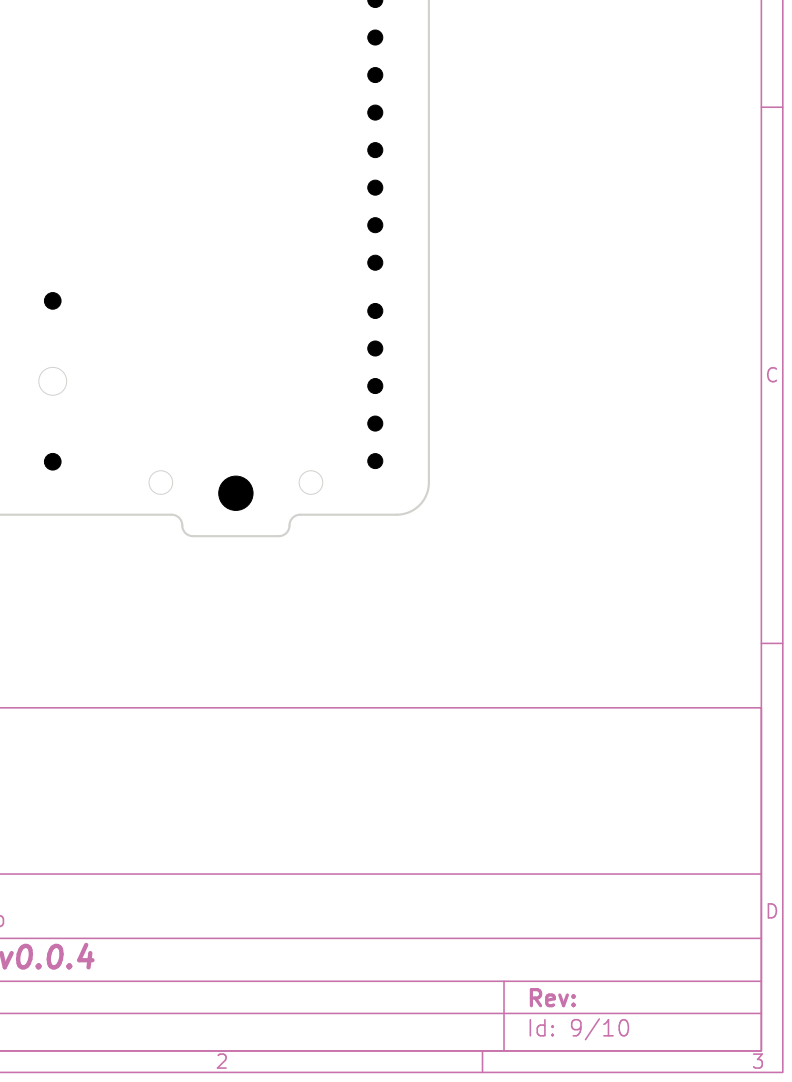
[picture p276: page 9]

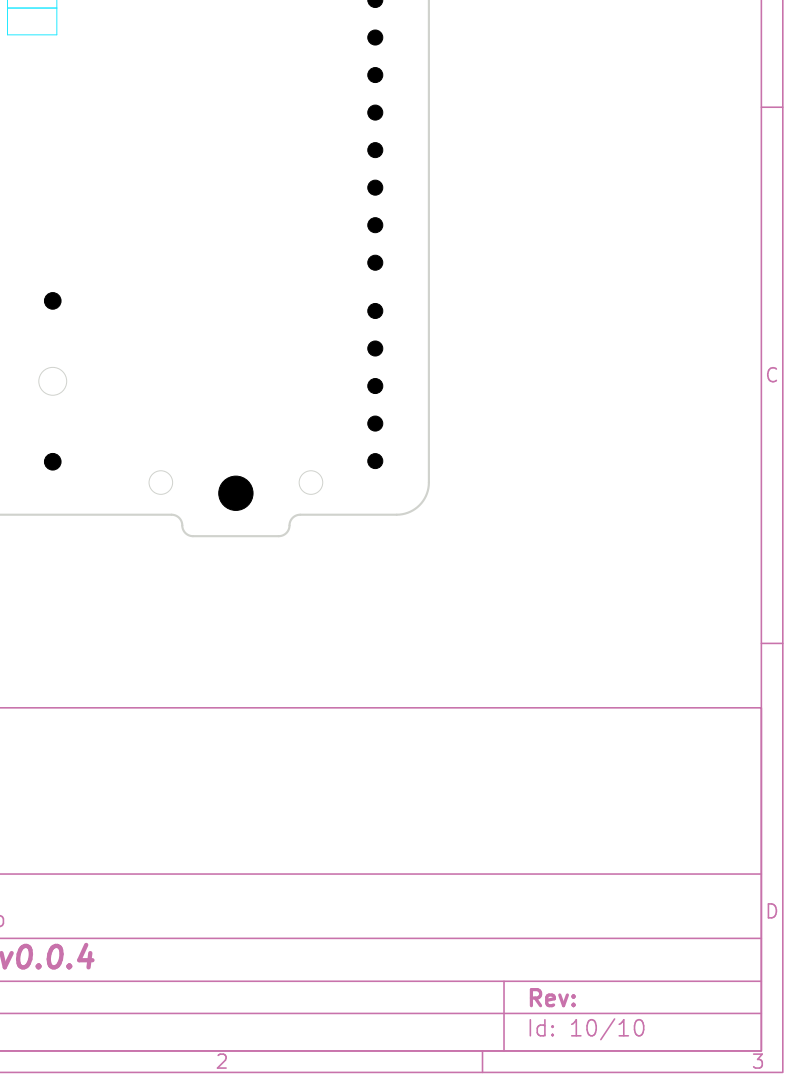
[picture p277: page 10]
