Konstantin-Dudersky/plc-modules/pcb/PMCNV-AI8T-v0.1.0/export/v0.0.1/PCB schematic/PMCNV-AI4T.pdf

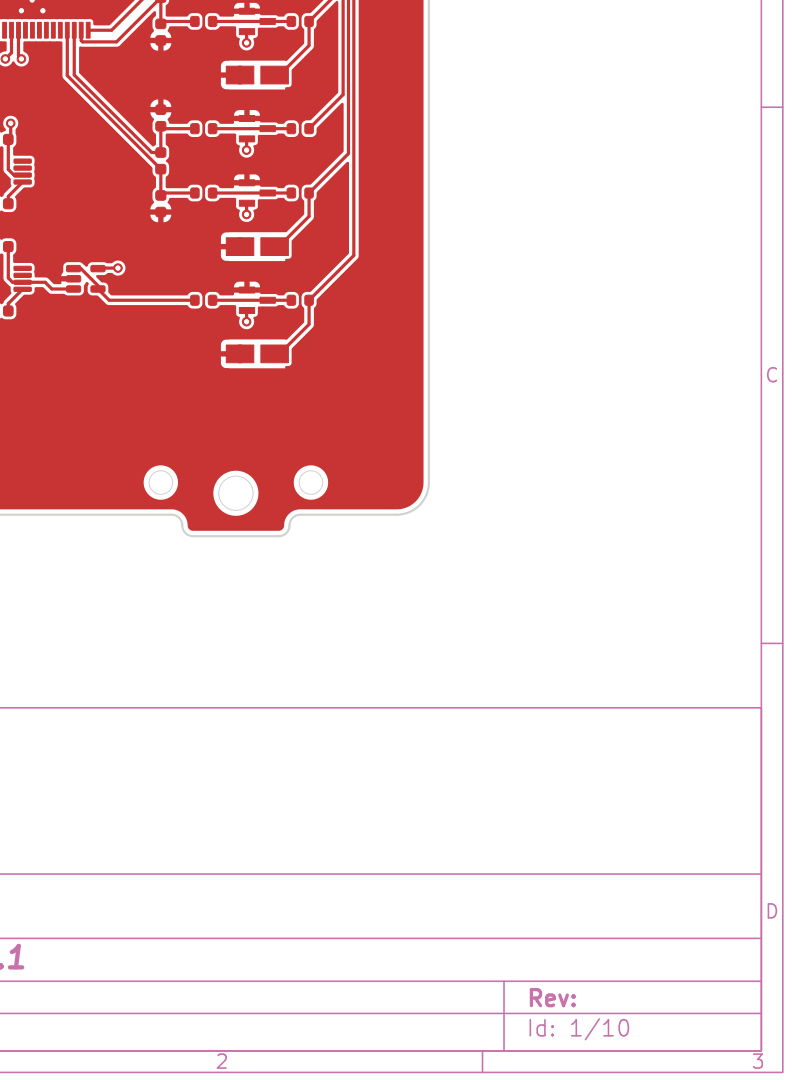
[picture p278: page 1]

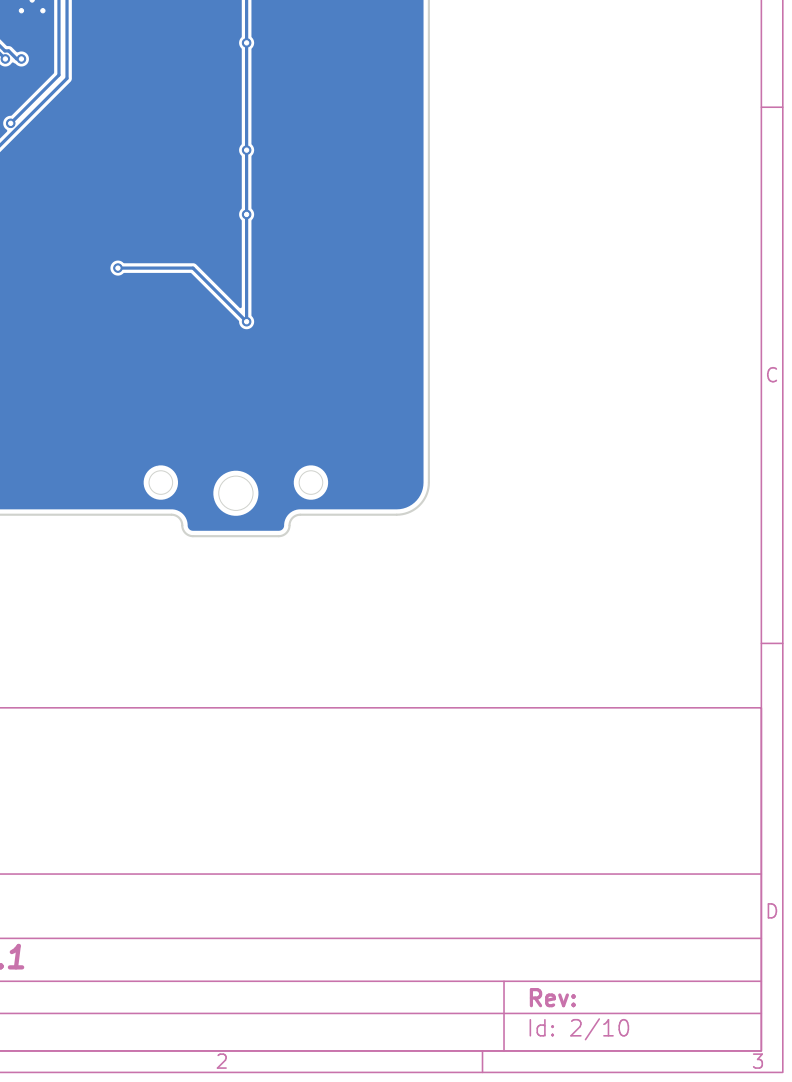
[picture p279: page 2]

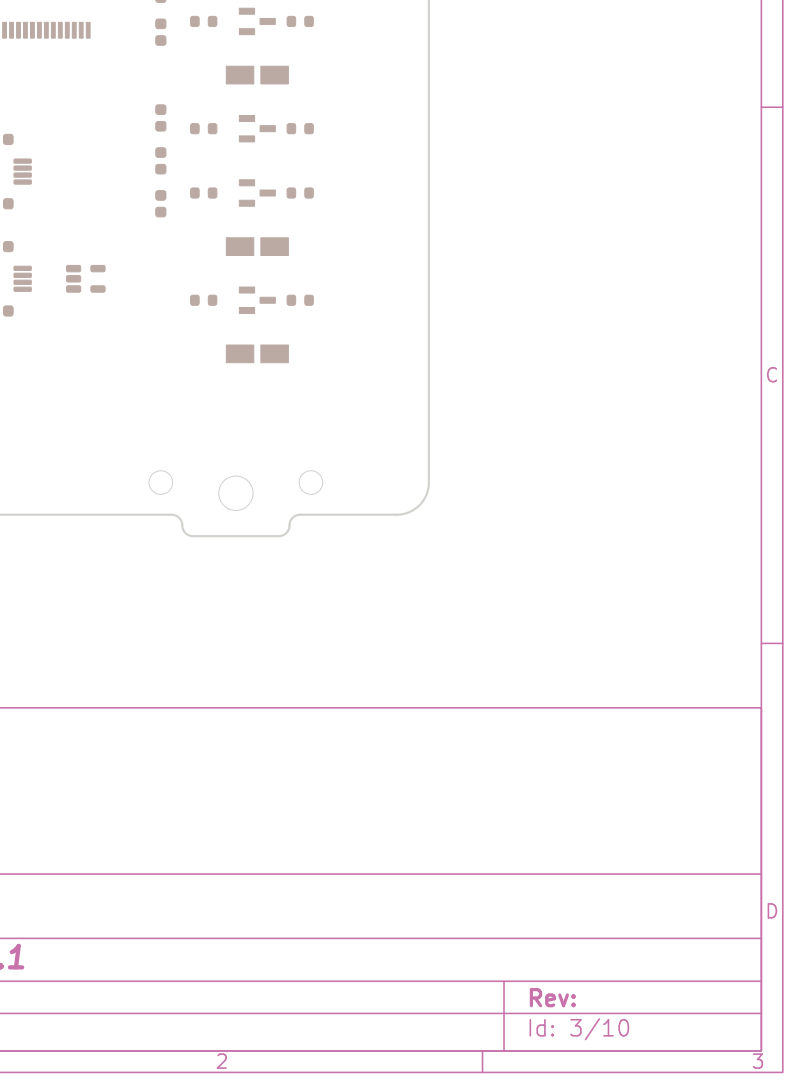
[picture p280: page 3]

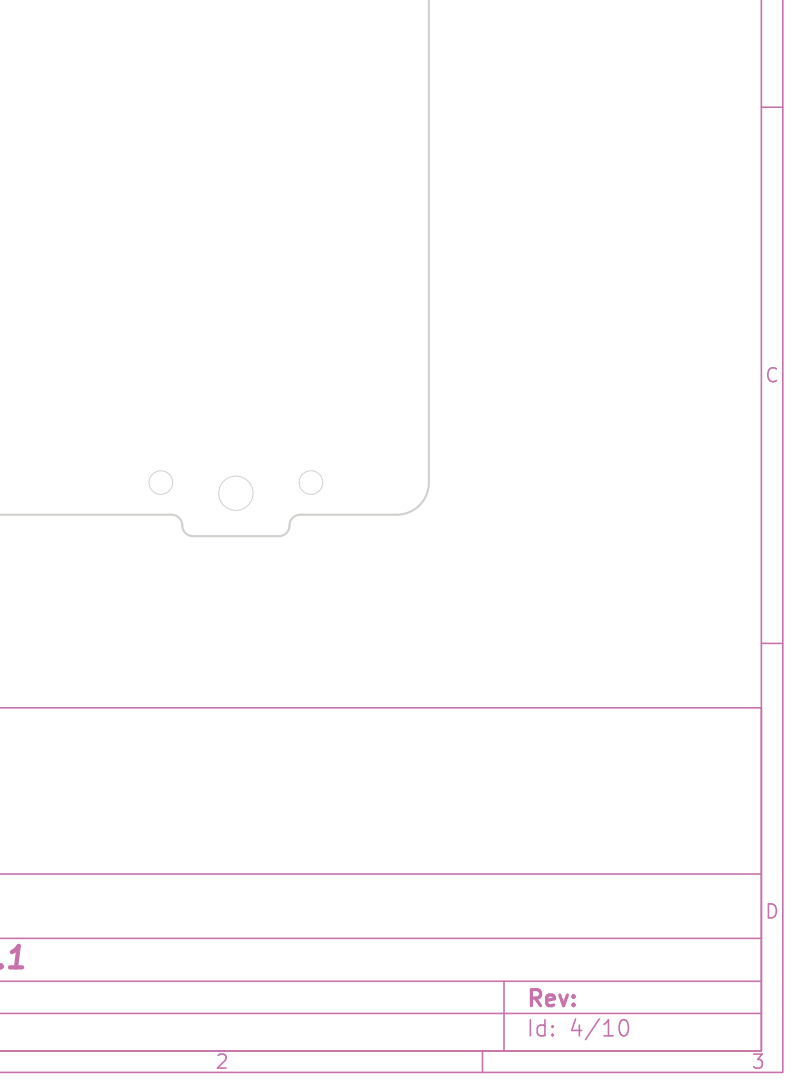
[picture p281: page 4]

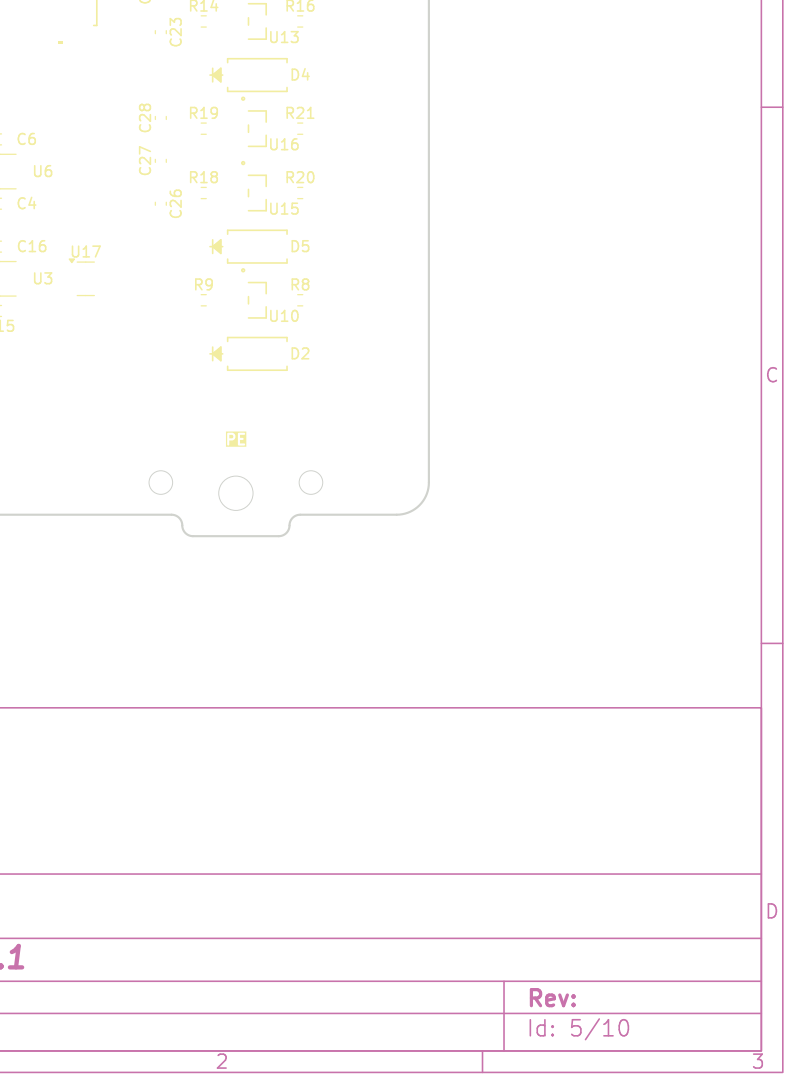
[picture p282: page 5]

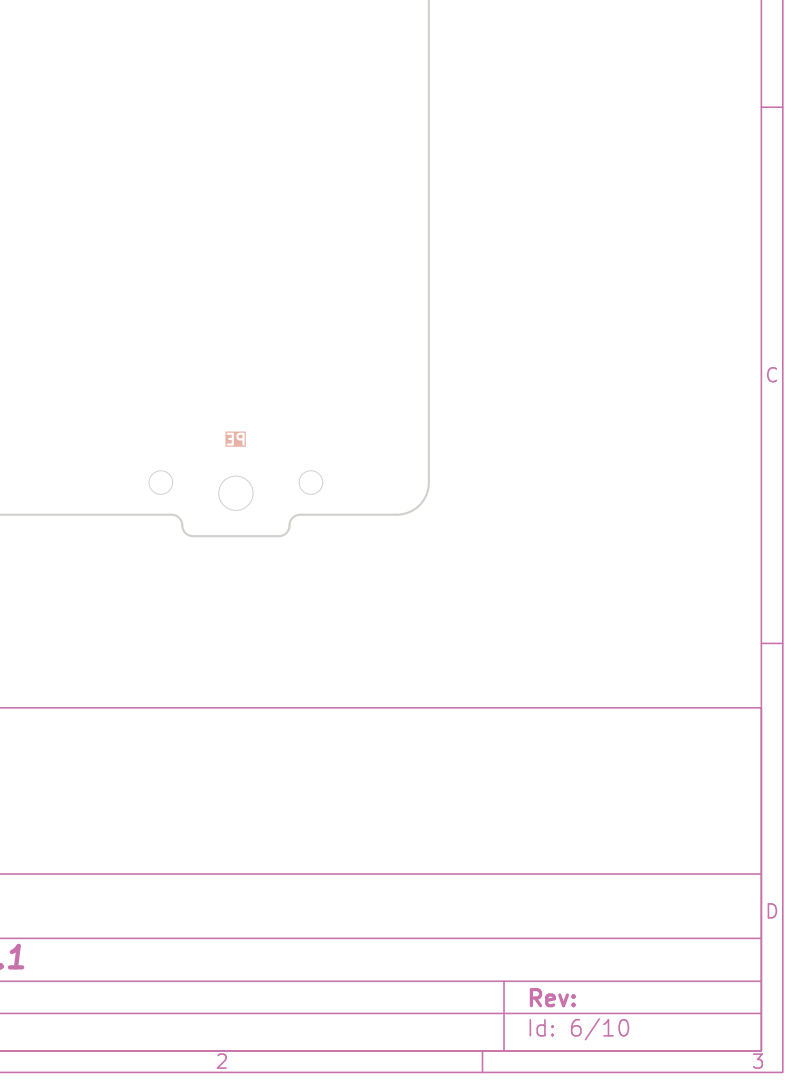
[picture p283: page 6]

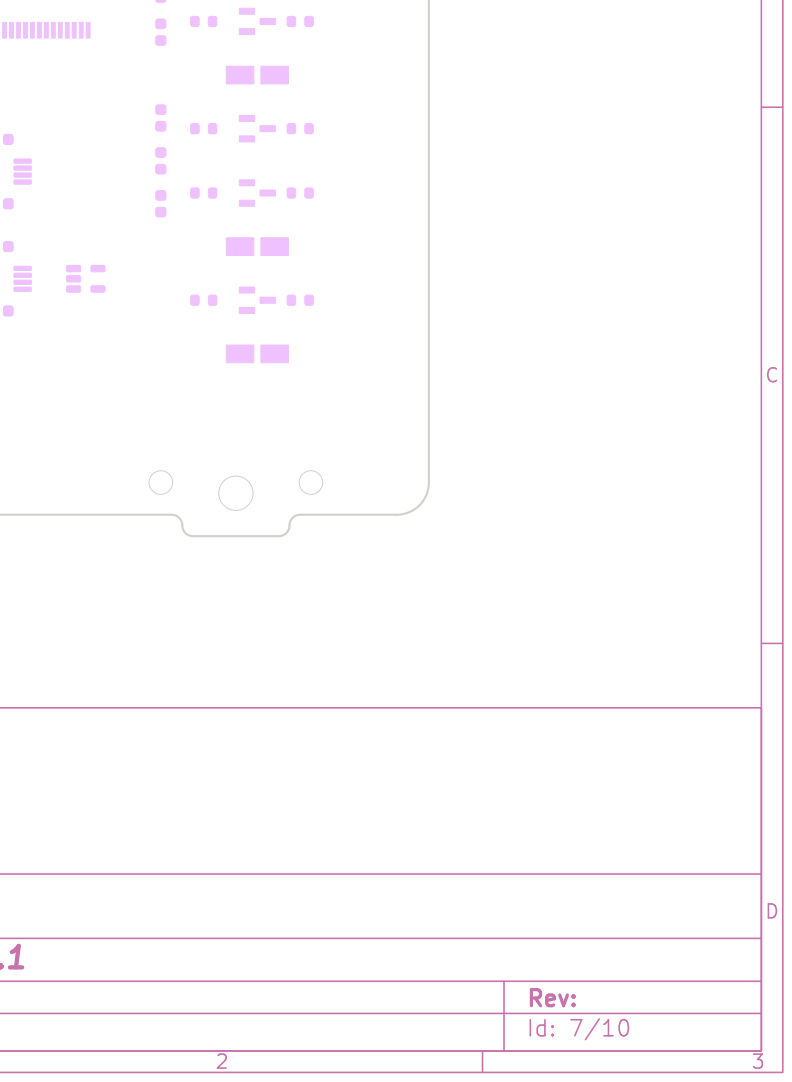
[picture p284: page 7]

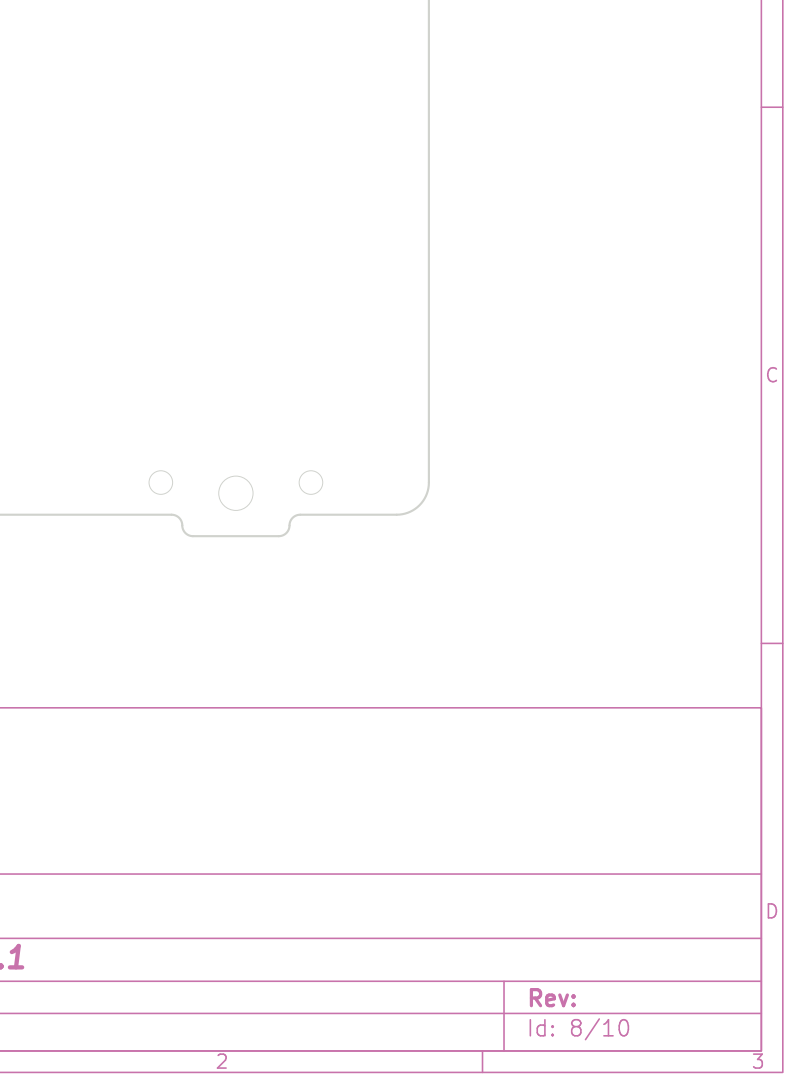
[picture p285: page 8]

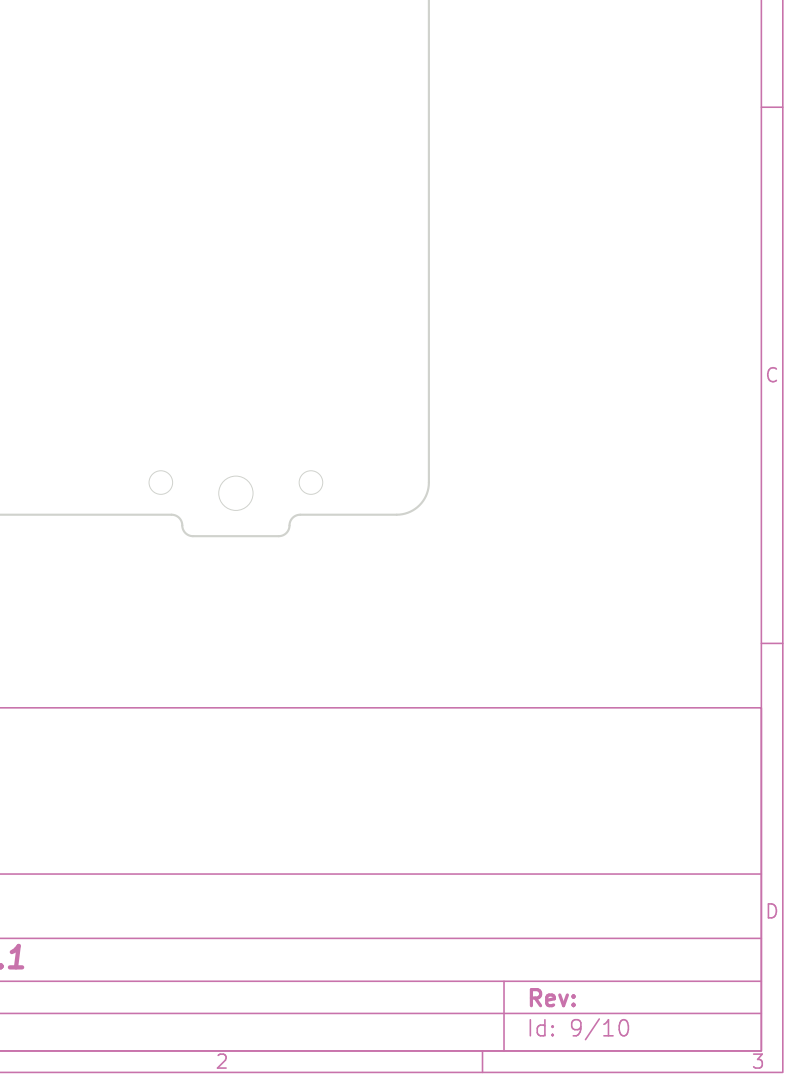
[picture p286: page 9]

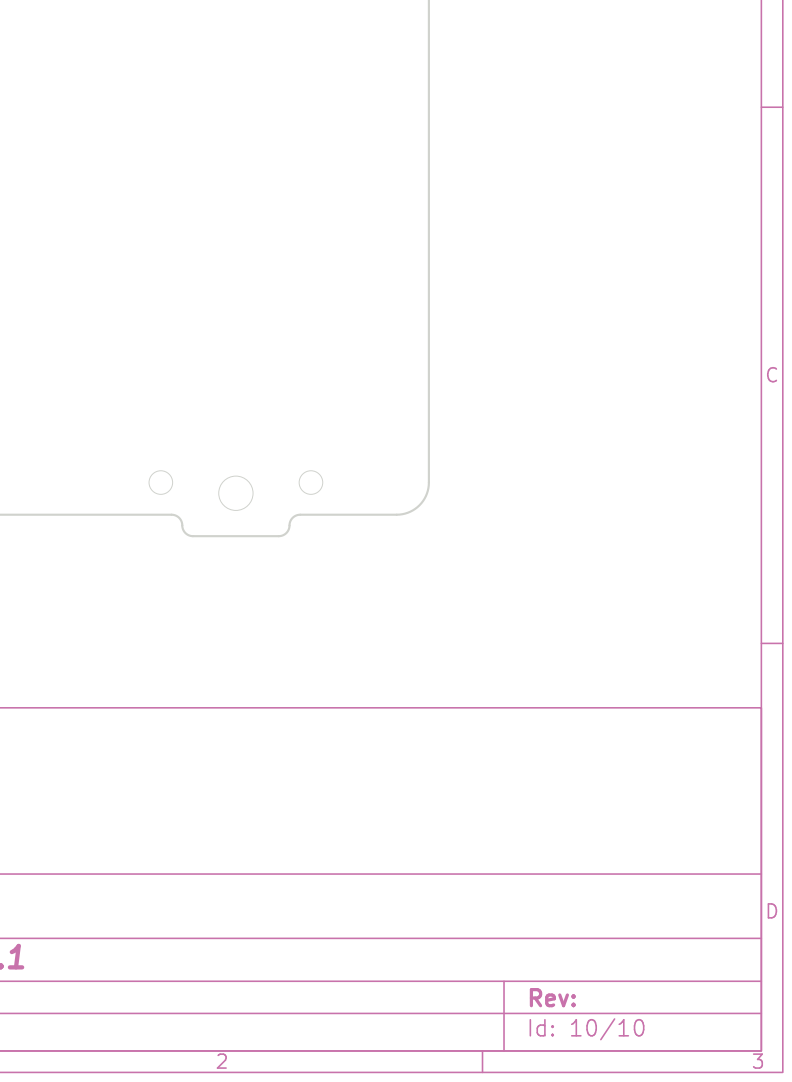
[picture p287: page 10]
