Konstantin-Dudersky/plc-modules/pcb/PMCNV-AI8T-v0.1.0/export/v0.0.2/PCB schematic/PMCNV-AI4T.pdf

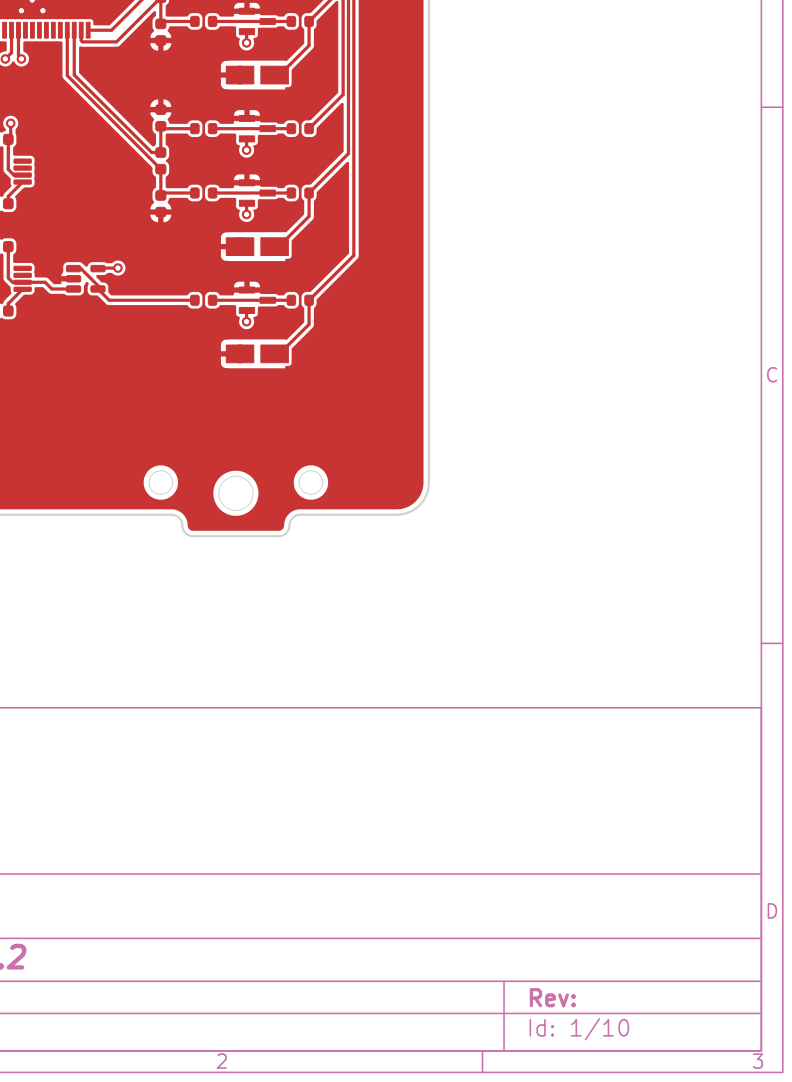
[picture p288: page 1]

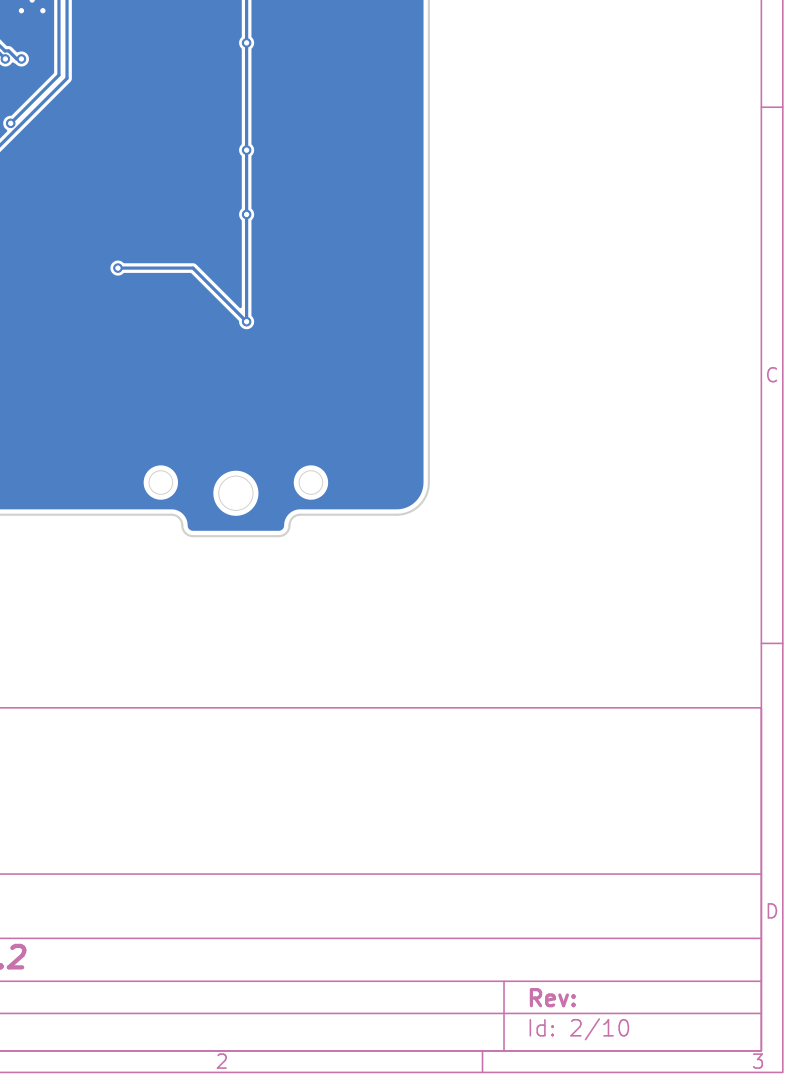
[picture p289: page 2]

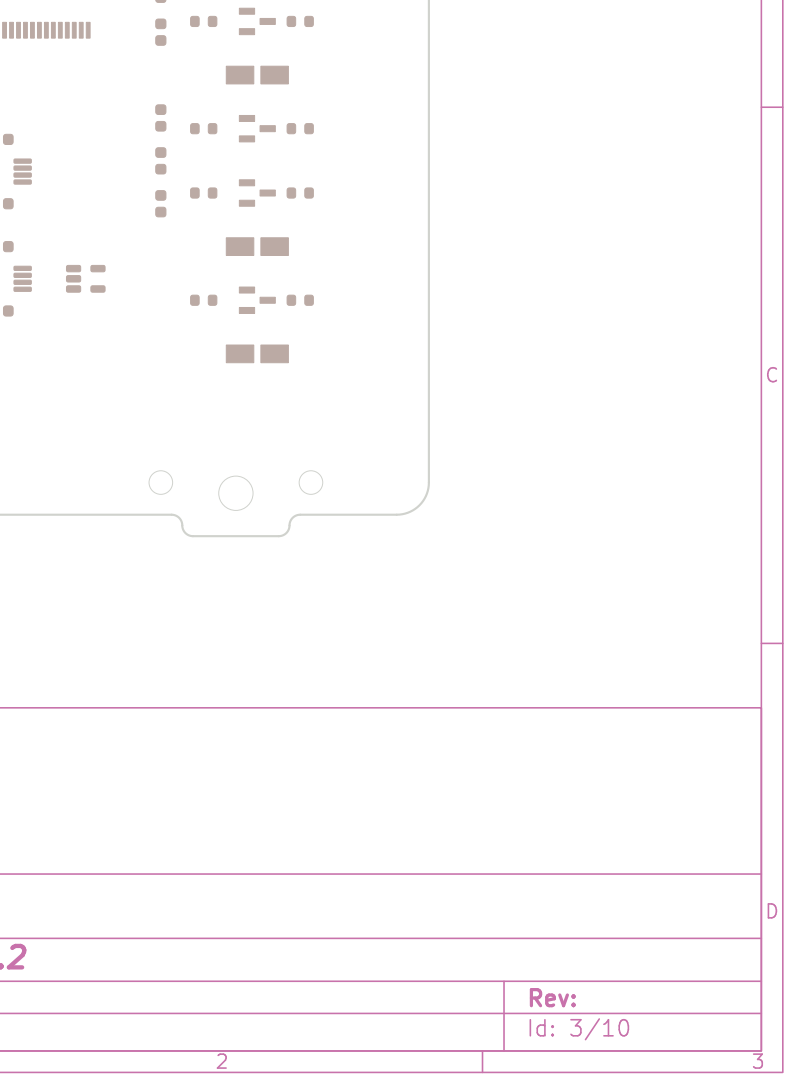
[picture p290: page 3]

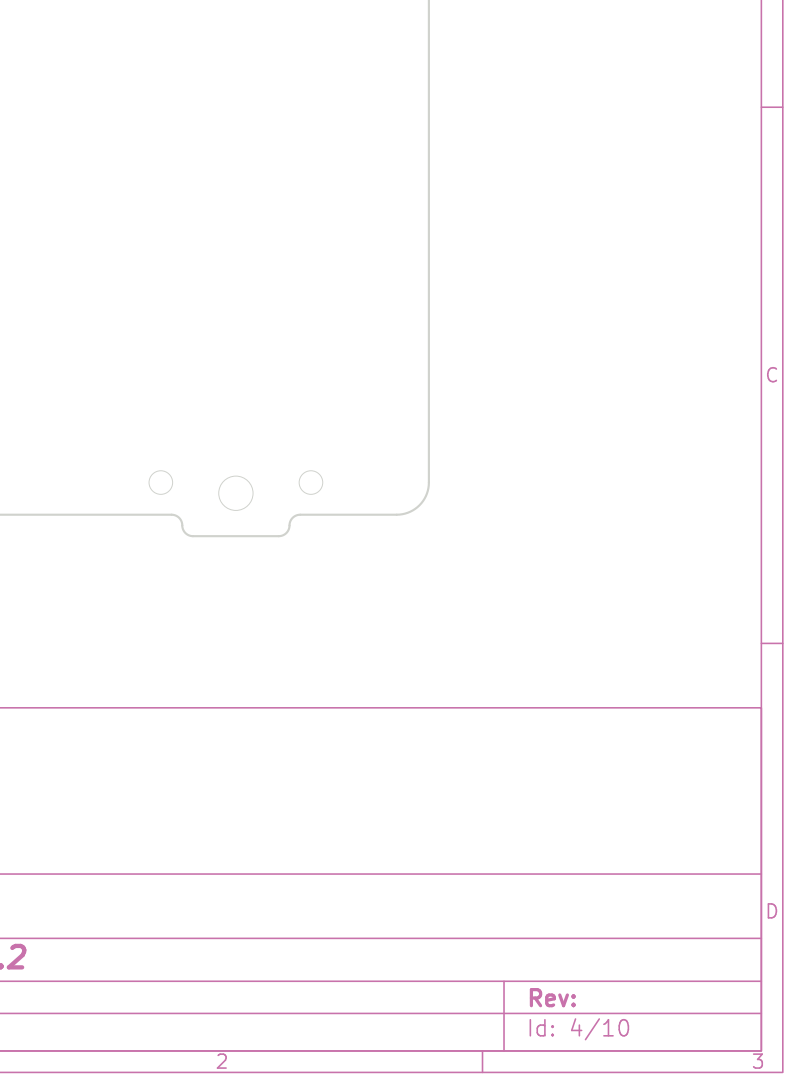
[picture p291: page 4]

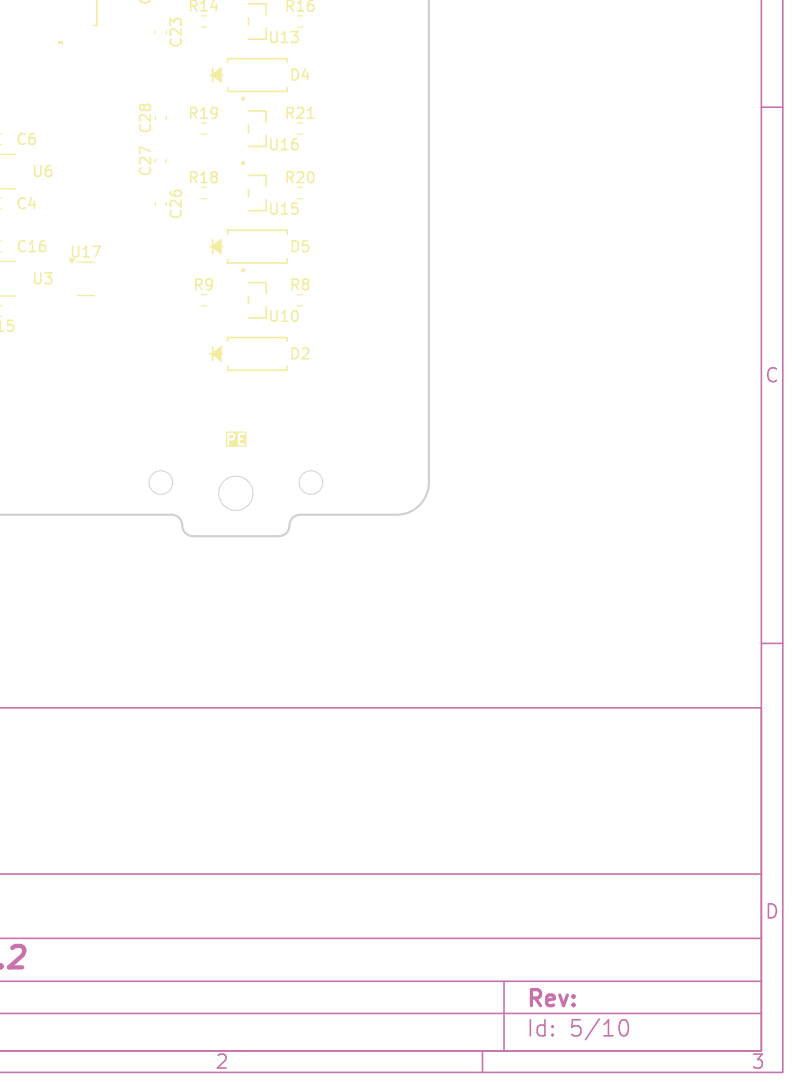
[picture p292: page 5]

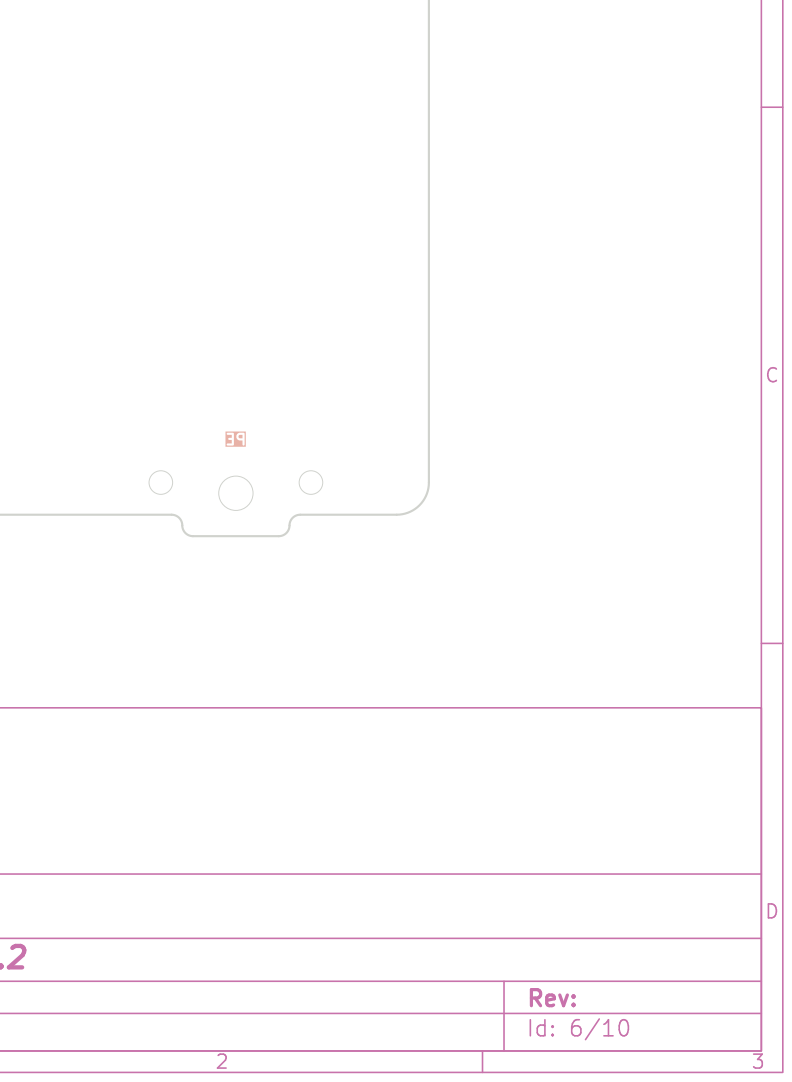
[picture p293: page 6]

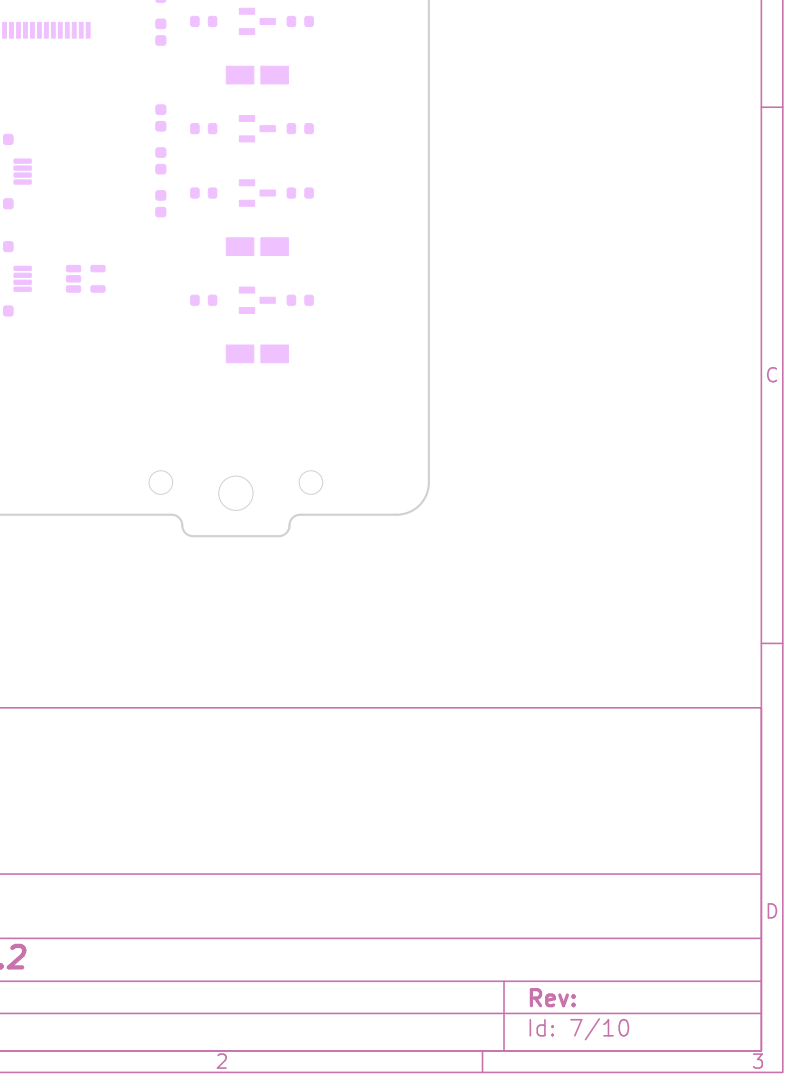
[picture p294: page 7]

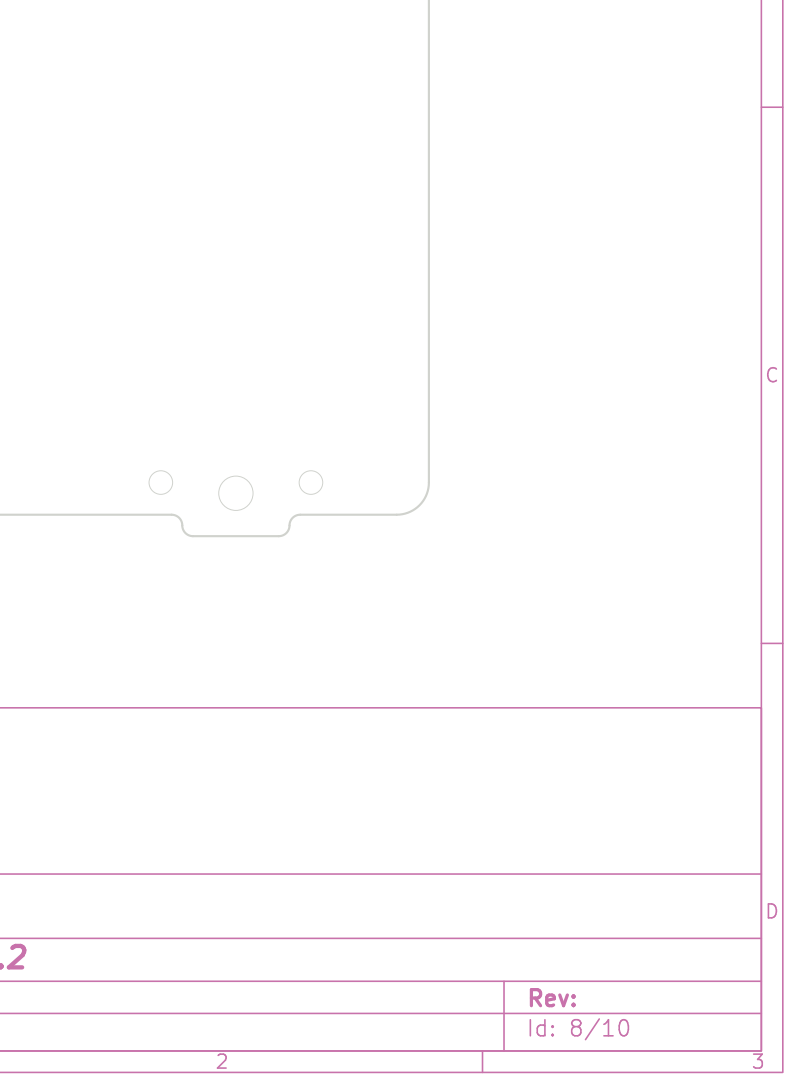
[picture p295: page 8]
