Konstantin-Dudersky/plc-modules/pcb/PMCNV-DQx16-v0.1.0/export/v0.0.5/PMCNV-DQx16.pdf

Green Green Green Green Green Green Green Green Green Green Green Green Green Green Blue Blue
