Konstantin-Dudersky/plc-modules/pcb/PMCNV-AI8T-v0.1.0/export/v0.0.2/PMCNV-AI4T.pdf

þÿ?>@=>5 þÿ=0?@O65=85 þÿ4.096 MCU
