Konstantin-Dudersky/plc-modules/pcb/PMPS-20W-v0.1.0/PMPS-20W.kicad_pcb

## KiCad design pcb/PMPS-20W-v0.1.0/PMPS-20W.kicad_pcb (2026-06-11)

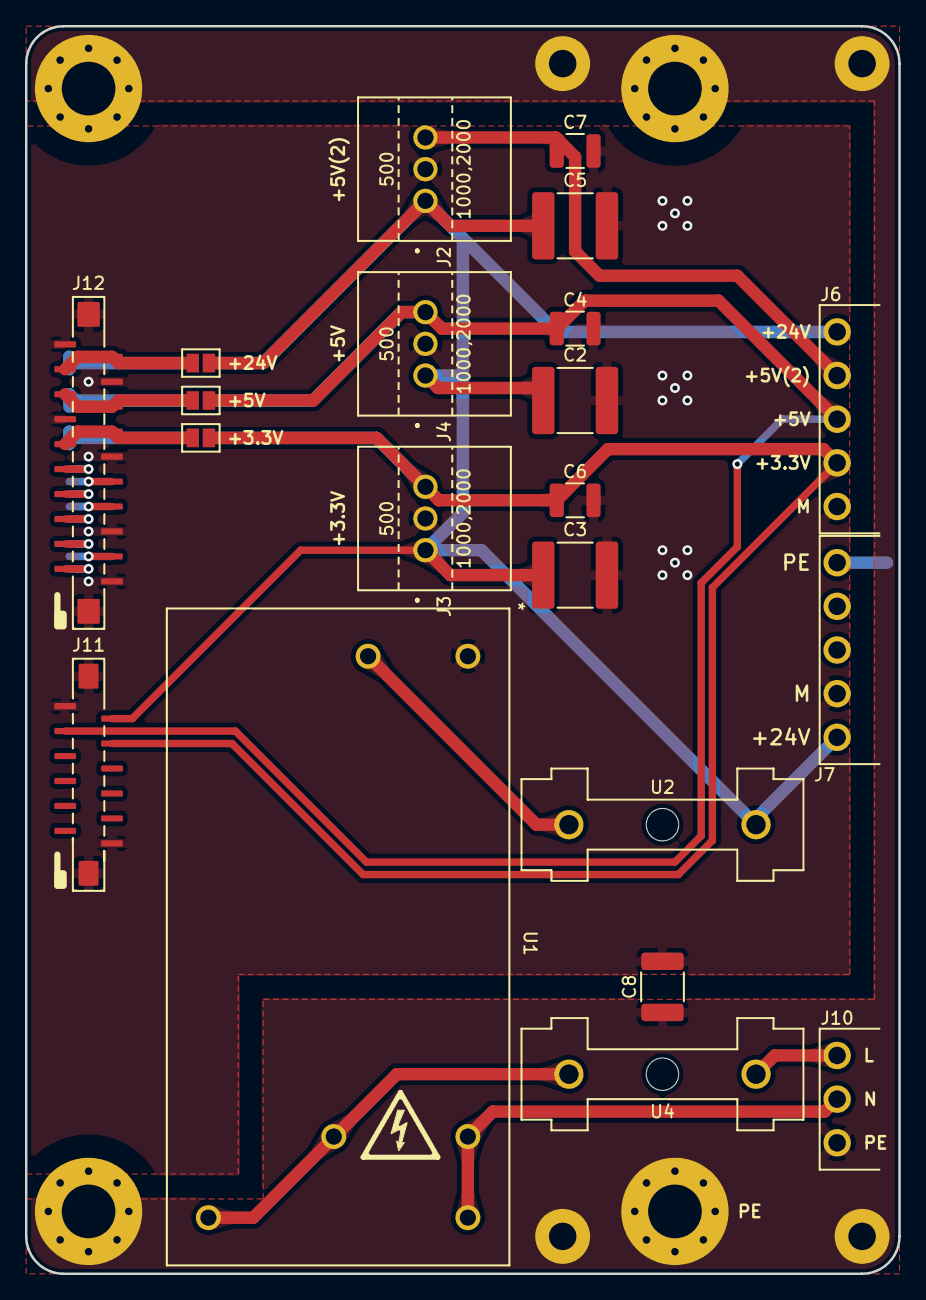
[picture p296: board PMPS-20W.kicad_pcb from above]

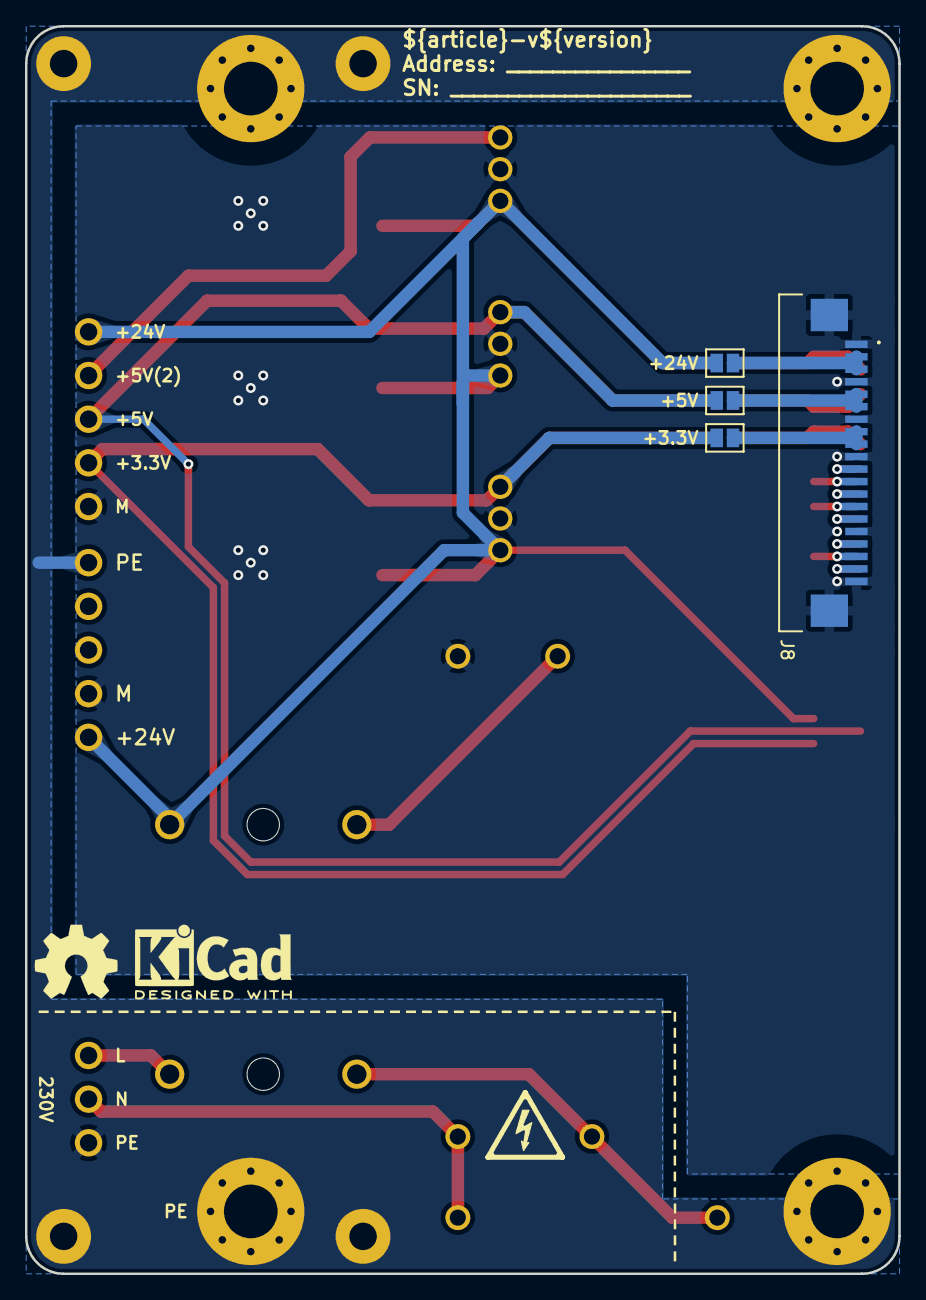
[picture p297: board PMPS-20W.kicad_pcb from below]

Board: 2 copper layers, 70.0 x 100.0 mm, 32 parts (6 on the bottom side), 24 nets.

Parts:
C2, C3, C5: 22uF; C_2220_5750Metric
C4, C6, C7: 22uF; C_1210_3225Metric
C8: 4.7nF 2kV; C_1812_4532Metric
H1, H2, H3, H4: M4; MountingHole_4.3mm_M4_Pad_Via
J2, J4: K7805-2000R3
J3: K7803-2000R3; K7805-2000R3
J6, J7: 15EDGRC-3.5-05P
J8: AFA07-S20FCC-00; AFA07S20FCA00
J10: 15EDGRC-3.5-03P
J11: AFA11-S12GLA-00
J12: AFA11-S20GLA-00
JP1, JP2, JP3, JP4, JP5, JP6: SolderJumper_2_Open; SolderJumper-2_P1.3mm_Open_Pad1.0x1.5mm
SP1: PMLED-xx-v0.0.3
U1: IRM-20-24; IRM-XX-24
U2, U4: 64900001039; 649-Series-Holder
kicad_logo: KiCad-Logo2_5mm_SilkScreen
oshw_logo: OSHW-Symbol_6.7x6mm_SilkScreen

Connections:
230V: J10.3, U4.1
+3V3: C6.1, J3.3 (+VO), J6.2, J11.4, JP3.2 (B), JP4.1 (A)
+3V3-IB-back: J8.8, J8.9, JP4.2 (B)
+3V3-IB-front: J12.8, J12.9, JP3.1 (A)
+5V: C4.1, J4.3 (+VO), J6.3, J11.3, JP1.2 (B), JP2.1 (A)
+5V(2): C7.1, J2.3 (+VO), J6.4
+5V-IB-back: J8.5, J8.6, JP2.2 (B)
+5V-IB-front: J12.5, J12.6, JP1.1 (A)
+24V: C2.1, C3.1, C5.1, J2.1 (VIN), J3.1 (VIN), J4.1 (VIN), J6.5, J7.1, J11.2, JP5.2 (B), JP6.1 (A), U2.2
+24V-IB-back: J8.2, J8.3, JP6.2 (B)
+24V-IB-front: J12.2, J12.3, JP5.1 (A)
/IBUS_CAN_GND: J8.13 (Pin_11), J12.13 (Pin_11)
/IBUS_CAN_H: J8.11, J12.11
/IBUS_CAN_L: J8.12 (Pin_11), J12.12 (Pin_11)
/IBUS_I2C_SCL: J8.15 (Pin_11), J12.15 (Pin_11)
/IBUS_I2C_SDA: J8.14 (Pin_11), J12.14 (Pin_11)
/IBUS_RST: J8.19 (Pin_11), J12.19 (Pin_11)
GND_MCU: C2.2, C3.2, C4.2, C5.2, C6.2, C7.2, C8.2, J2.2 (GND), J3.2 (GND), J4.2 (GND), J6.1, J7.2, J8.1, J8.4, J8.7, J8.10, J8.16 (Pin_11), J8.20 (Pin_11), J8.MP1 (Pin_11), J8.MP2 (Pin_11), J11.1, J11.12 (Pin_11), J11.MP1 (Pin_11), J11.MP2 (Pin_11), J12.1, J12.4, J12.7, J12.10, J12.16 (Pin_11), J12.20 (Pin_11), J12.MP1 (Pin_11), J12.MP2 (Pin_11), U1.1 (V-)
N: J10.2, U1.4 (AC/N)
unnamed: J8.17 (Pin_11), J12.17 (Pin_11)
unnamed: J8.18 (Pin_11), J12.18 (Pin_11)
unnamed: U1.3 (AC/L), U4.2
unnamed: U1.2 (V+), U2.1
PE: C8.1, H1.1 (1_1), H2.1 (1_1), H3.1 (1_1), H4.1 (1_1), J7.5, J10.1, SP1.PE (PE_PE)
