Konstantin-Dudersky/plc-modules/pcb/PMCNV-RQx8-v0.1.0/PMCNV-RQx8.kicad_pcb

## KiCad design pcb/PMCNV-RQx8-v0.1.0/PMCNV-RQx8.kicad_pcb (2026-06-11)

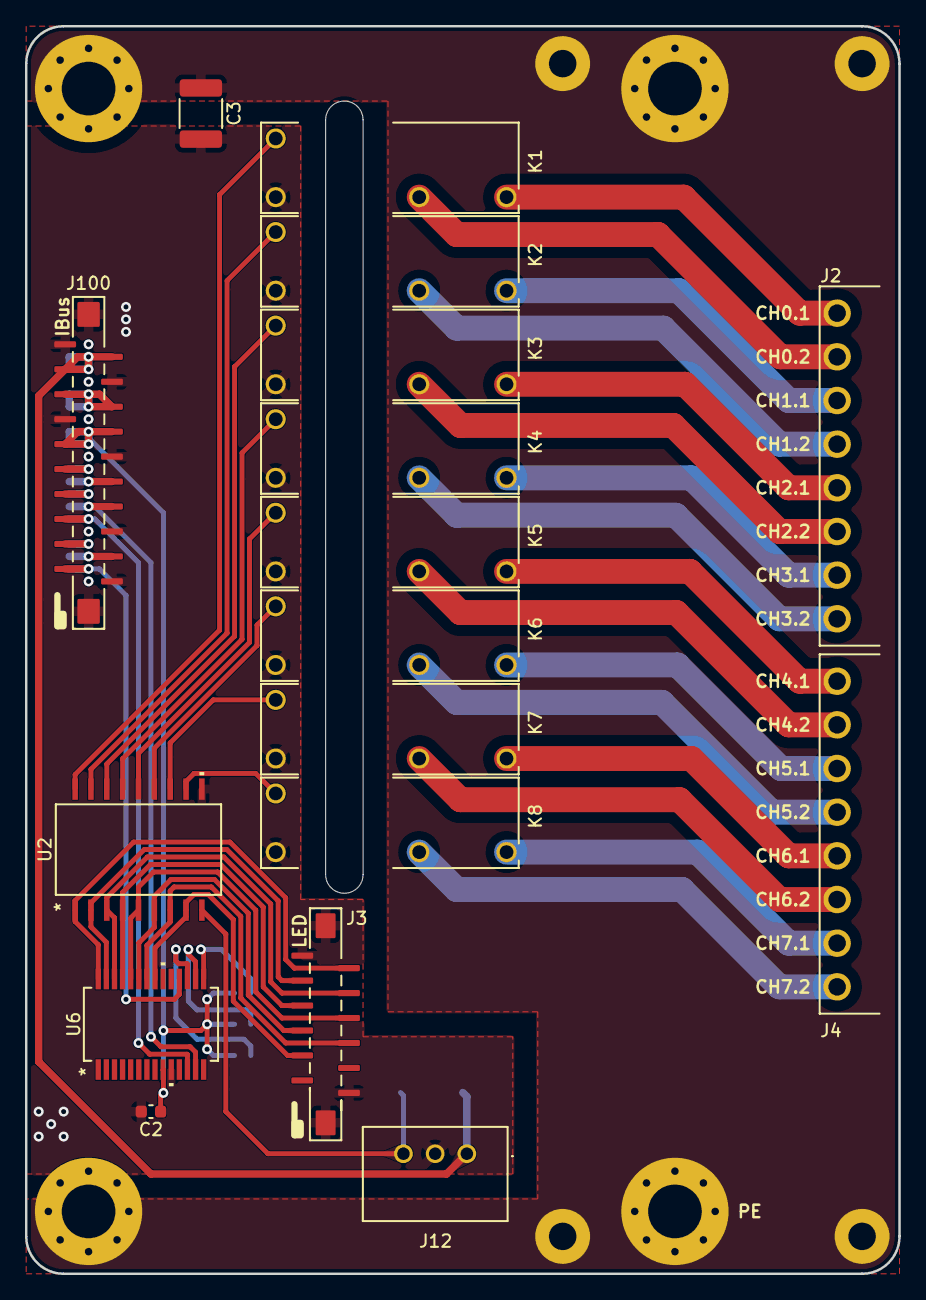
[picture p298: board PMCNV-RQx8.kicad_pcb from above]

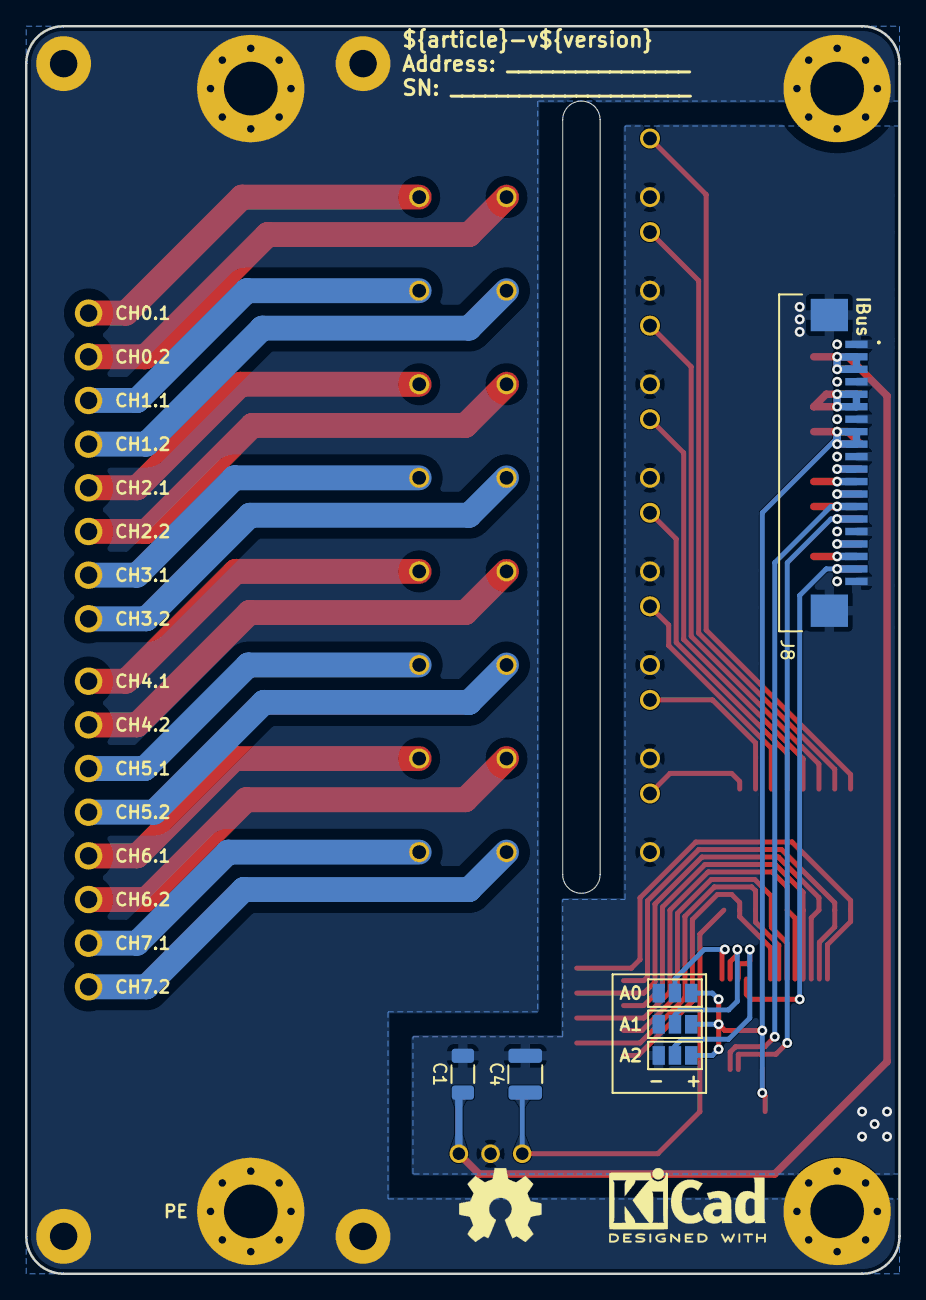
[picture p299: board PMCNV-RQx8.kicad_pcb from below]

Board: 2 copper layers, 70.0 x 100.0 mm, 30 parts (9 on the bottom side), 49 nets.

Parts:
C1: 10uF; C_1206_3216Metric
C2: 100nF; C_0603_1608Metric
C3: 4.7nF 2kV; C_1812_4532Metric
C4: 22uF; C_1210_3225Metric
H1, H2, H3, H4: M4; MountingHole_4.3mm_M4_Pad_Via
J2, J4: 15EDGRC-3.5-08P
J3: AFA07-S12FCC-00; AFA11-S12GLA-00
J8: AFA07-S20FCC-00; AFA07S20FCA00
J12: K7805-500R3; K7805500R3
J100: AFA11-S20GLA-00
JP5, JP6, JP7: SolderJumper_3_Open; SolderJumper-3_P1.3mm_Open_Pad1.0x1.5mm
K1, K2, K3, K4, K5, K6, K7, K8: G5NB-1A-E-DC5; G5NB-1A-E_DC12_RELAY_G5NB-1A_DC5_OMR
SP3: PMLED-xx-v0.0.3
U2: TBD62783AFG; SOP18-P-375-1p27_TOS-M
U6: MCP23017_SS; SSOP28_MC_MCH
kicad_logo: KiCad-Logo2_5mm_SilkScreen
oshw_logo: OSHW-Symbol_6.7x6mm_SilkScreen

Connections:
+5V: C4.1, J12.3 (+VO), U2.9 (VCC)
/A0: JP5.2 (C), U6.15 (A0)
/A1: JP6.2 (C), U6.16 (A1)
/A2: JP7.2 (C), U6.17 (A2)
/IBUS_5V: J8.5, J8.6, J100.5, J100.6
/IBUS_CAN_GND: J8.13 (Pin_11), J100.13 (Pin_11)
/IBUS_CAN_H: J8.11, J100.11
/IBUS_CAN_L: J8.12 (Pin_11), J100.12 (Pin_11)
/IBUS_I2C_SCL: J8.15 (Pin_11), J100.15 (Pin_11), U6.12 (SCL)
/IBUS_I2C_SDA: J8.14 (Pin_11), J100.14 (Pin_11), U6.13 (SDA)
/IBUS_RST: J8.19 (Pin_11), J100.19 (Pin_11), U6.18 (~RESET)
/K1: K1.4, U2.18 (O1)
/K1_exp: J3.2, U2.1 (I1), U6.28 (GPA7)
/K2: K2.4, U2.17 (O2)
/K2_exp: J3.3, U2.2 (I2), U6.27 (GPA6)
/K3: K3.4, U2.16 (O3)
/K3_exp: J3.4, U2.3 (I3), U6.26 (GPA5)
/K4: K4.4, U2.15 (O4)
/K4_exp: J3.5, U2.4 (I4), U6.25 (GPA4)
/K5: K5.4, U2.14 (O5)
/K5_exp: J3.6, U2.5 (I5), U6.24 (GPA3)
/K6: K6.4, U2.13 (O6)
/K6_exp: J3.7, U2.6 (I6), U6.23 (GPA2)
/K7: K7.4, U2.12 (O7)
/K7_exp: J3.8, U2.7 (I7), U6.22 (GPA1)
/K8: K8.4, U2.11 (O8)
/K8_exp: J3.9, U2.8 (I8), U6.21 (GPA0)
IBUS_3V3: C2.1, J8.8, J8.9, J100.8, J100.9, JP5.3 (B), JP6.3 (B), JP7.3 (B), U6.9 (VDD)
IBUS_24V: C1.1, J8.2, J8.3, J12.1 (VIN), J100.2, J100.3
IBUS_GND: C1.2, C2.2, C3.2, C4.2, J3.1, J3.12 (Pin_11), J3.MP1 (Pin_11), J3.MP2 (Pin_11), J8.1, J8.4, J8.7, J8.10, J8.16 (Pin_11), J8.20 (Pin_11), J8.MP1 (Pin_11), J8.MP2 (Pin_11), J12.2 (GND), J100.1, J100.4, J100.7, J100.10, J100.16 (Pin_11), J100.20 (Pin_11), J100.MP1 (Pin_11), J100.MP2 (Pin_11), JP5.1 (A), JP6.1 (A), JP7.1 (A), K1.1, K2.1, K3.1, K4.1, K5.1, K6.1, K7.1, K8.1, U2.10 (GND), U6.10 (VSS)
unnamed: J2.1, K4.2
unnamed: J2.2, K4.3
unnamed: J2.3, K3.2
unnamed: J2.4, K3.3
unnamed: J2.5, K2.2
unnamed: J2.6, K2.3
unnamed: J2.7, K1.2
unnamed: J2.8, K1.3
unnamed: J4.1, K8.2
unnamed: J4.2, K8.3
unnamed: J4.3, K7.2
unnamed: J4.4, K7.3
unnamed: J4.5, K6.2
unnamed: J4.6, K6.3
unnamed: J4.7, K5.2
unnamed: J4.8, K5.3
unnamed: J8.17 (Pin_11), J100.17 (Pin_11)
unnamed: J8.18 (Pin_11), J100.18 (Pin_11)
PE: C3.1, H1.1 (1_1), H2.1 (1_1), H3.1 (1_1), H4.1 (1_1), SP3.PE (PE_PE)
