Konstantin-Dudersky/plc-modules/pcb/PMCNV-DQx16-v0.1.0/PMCNV-DQx16.kicad_pcb

## KiCad design pcb/PMCNV-DQx16-v0.1.0/PMCNV-DQx16.kicad_pcb (2026-06-11)

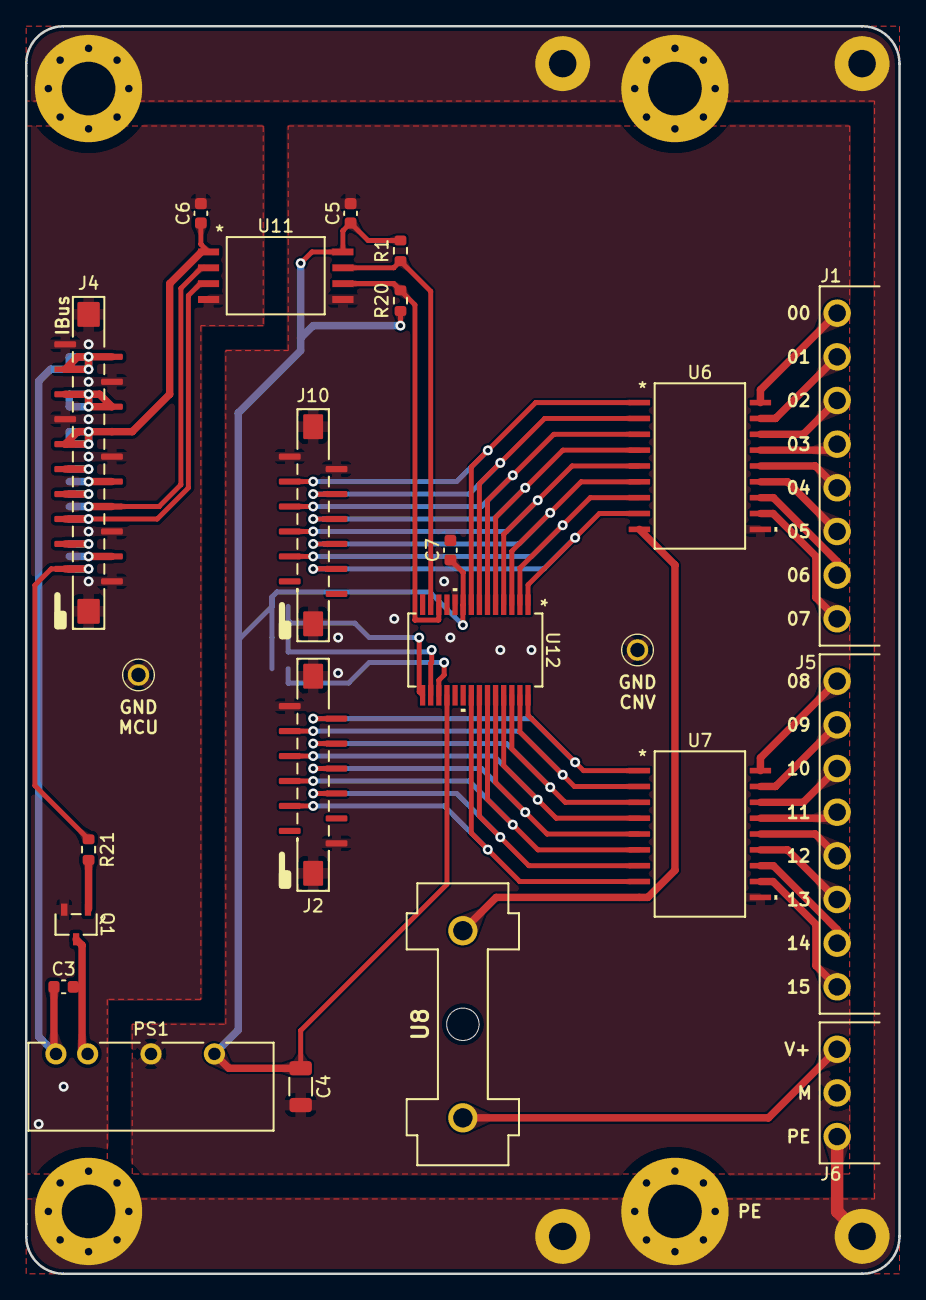
[picture p300: board PMCNV-DQx16.kicad_pcb from above]

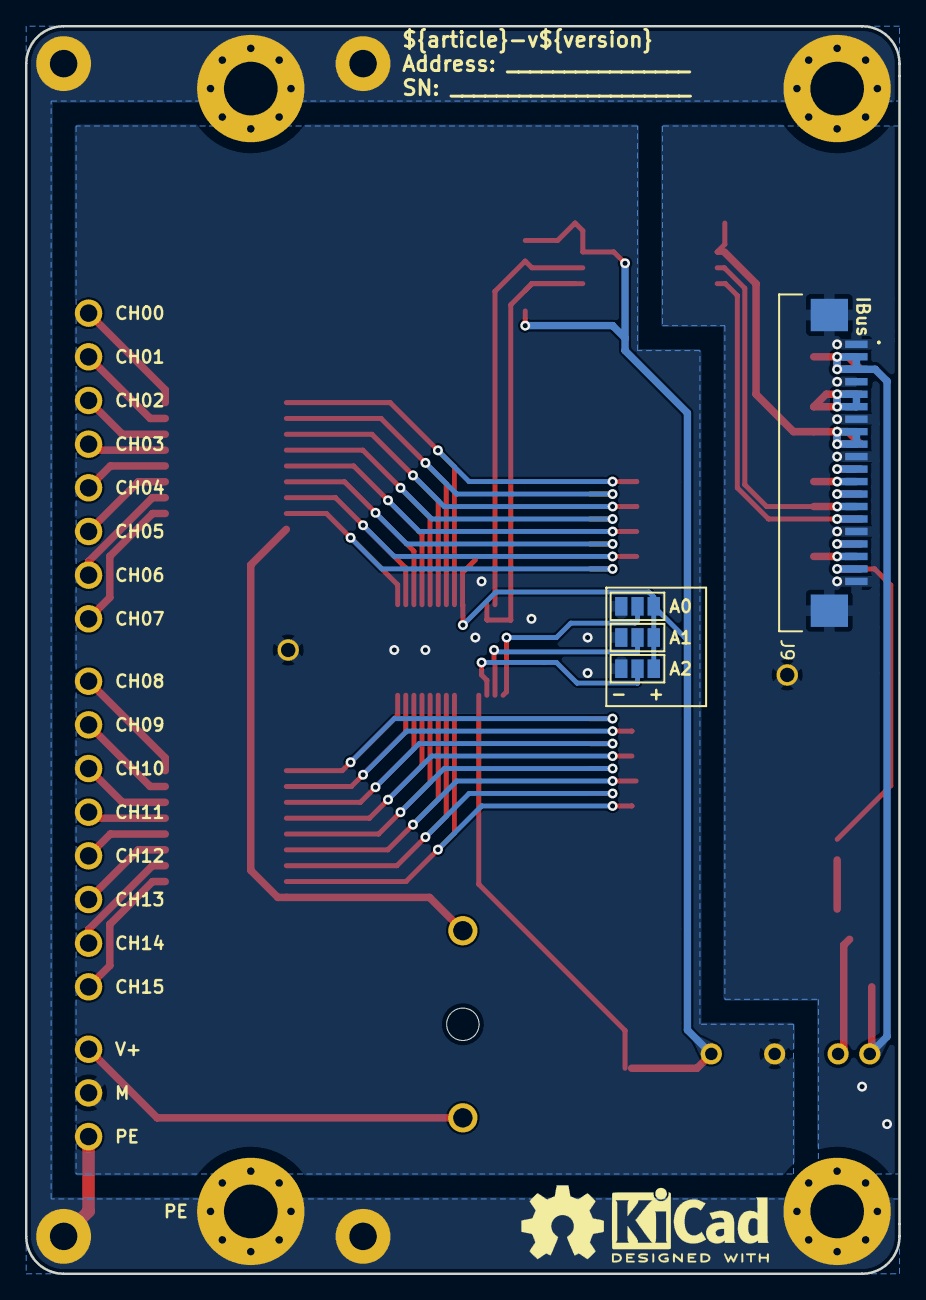
[picture p301: board PMCNV-DQx16.kicad_pcb from below]

Board: 2 copper layers, 70.0 x 100.0 mm, 34 parts (6 on the bottom side), 56 nets.

Parts:
C3: 1uF; C_0603_1608Metric
C4: 10uF; C_1206_3216Metric
C5, C6, C7: 100nF; C_0603_1608Metric
H1, H2, H3, H4: M4; MountingHole_4.3mm_M4_Pad_Via
J1, J5: 15EDGRC-3.5-08P
J2, J10: AFA11-S12GLA-00
J4: AFA11-S20GLA-00
J6: 15EDGRC-3.5-03P
J9: AFA07-S20FCC-00; AFA07S20FCA00
JP5, JP6, JP7: SolderJumper_3_Open; SolderJumper-3_P1.3mm_Open_Pad1.0x1.5mm
PS1: 24V/5V; B2405LS-1WR3
Q1: 2N7002K; 2N7002K_ONS
R1, R20: 3k3; R_0603_1608Metric
R21: 100R; R_0603_1608Metric
SP1: PMLED-xx-v0.0.3
U2, U5: 5117
U6, U7: TBD62783AFG; SOP18-P-375-1p27_TOS-M
U8: 64900001039; 649-Series-Holder
U11: CA-IS3021G; SOICW8_CLG
U12: MCP23017_SS; SSOP28_MC_MCH
kicad_logo: KiCad-Logo2_5mm_SilkScreen
oshw_logo: OSHW-Symbol_6.7x6mm_SilkScreen

Connections:
+5V_CNV: C4.1, C5.1, C7.1, JP5.3 (B), JP6.3 (B), JP7.3 (B), PS1.6 (+V), R1.1, R20.1, U11.8 (VDDb), U12.9 (VDD), U12.18 (~RESET)
+V: U6.9 (VCC), U7.9 (VCC), U8.2
/A0: JP5.2 (C), U12.15 (A0)
/A1: JP6.2 (C), U12.16 (A1)
/A2: JP7.2 (C), U12.17 (A2)
/CH00_in: J10.3, U6.1 (I1), U12.8 (GPB7)
/CH01_in: J10.4, U6.2 (I2), U12.7 (GPB6)
/CH02_in: J10.5, U6.3 (I3), U12.6 (GPB5)
/CH03_in: J10.6, U6.4 (I4), U12.5 (GPB4)
/CH04_in: J10.7, U6.5 (I5), U12.4 (GPB3)
/CH05_in: J10.8, U6.6 (I6), U12.3 (GPB2)
/CH06_in: J10.9, U6.7 (I7), U12.2 (GPB1)
/CH07_in: J10.10, U6.8 (I8), U12.1 (GPB0)
/CH08_in: J2.2, U7.1 (I1), U12.28 (GPA7)
/CH09_in: J2.3, U7.2 (I2), U12.27 (GPA6)
/CH10_in: J2.4, U7.3 (I3), U12.26 (GPA5)
/CH11_in: J2.5, U7.4 (I4), U12.25 (GPA4)
/CH12_in: J2.6, U7.5 (I5), U12.24 (GPA3)
/CH13_in: J2.7, U7.6 (I6), U12.23 (GPA2)
/CH14_in: J2.8, U7.7 (I7), U12.22 (GPA1)
/CH15_in: J2.9, U7.8 (I8), U12.21 (GPA0)
/IBUS_5V: J4.5, J4.6, J9.5, J9.6
/IBUS_CAN_GND: J4.13 (Pin_11), J9.13 (Pin_11)
/IBUS_CAN_H: J4.11, J9.11
/IBUS_CAN_L: J4.12 (Pin_11), J9.12 (Pin_11)
/IBUS_I2C_SCL: J4.15 (Pin_11), J9.15 (Pin_11), U11.3 (SCLa)
/IBUS_I2C_SDA: J4.14 (Pin_11), J9.14 (Pin_11), U11.2 (SDAa)
/IBUS_RST: J4.19 (Pin_11), J9.19 (Pin_11), R21.1
/SCL_CNV: R20.2, U11.6 (SCLb), U12.12 (SCK)
/SDA_CNV: R1.2, U11.7 (SDAb), U12.13 (SI)
/a.0_out: J1.8, U6.18 (O1)
/a.1_out: J1.7, U6.17 (O2)
/a.2_out: J1.6, U6.16 (O3)
/a.3_out: J1.5, U6.15 (O4)
/a.4_out: J1.4, U6.14 (O5)
/a.5_out: J1.3, U6.13 (O6)
/a.6_out: J1.2, U6.12 (O7)
/a.7_out: J1.1, U6.11 (O8)
/b.0_out: J5.8, U7.18 (O1)
/b.1_out: J5.7, U7.17 (O2)
/b.2_out: J5.6, U7.16 (O3)
/b.3_out: J5.5, U7.15 (O4)
/b.4_out: J5.4, U7.14 (O5)
/b.5_out: J5.3, U7.13 (O6)
/b.6_out: J5.2, U7.12 (O7)
/b.7_out: J5.1, U7.11 (O8)
GND_CNV: C4.2, C5.2, C7.2, J2.1, J2.12 (Pin_11), J2.MP1 (Pin_11), J2.MP2 (Pin_11), J6.2, J10.1, J10.2, J10.MP1 (Pin_11), J10.MP2 (Pin_11), JP5.1 (A), JP6.1 (A), JP7.1 (A), PS1.4 (0V), U5.1, U6.10 (GND), U7.10 (GND), U11.5 (GNDb), U12.10 (VSS)
IBUS_3V3: C6.1, J4.8, J4.9, J9.8, J9.9, U11.1 (VDDa)
IBUS_24V: C3.1, J4.2, J4.3, J9.2, J9.3, PS1.1 (Vin)
IBUS_GND: C6.2, J4.1, J4.4, J4.7, J4.10, J4.16 (Pin_11), J4.20 (Pin_11), J4.MP1 (Pin_11), J4.MP2 (Pin_11), J9.1, J9.4, J9.7, J9.10, J9.16 (Pin_11), J9.20 (Pin_11), J9.MP1 (Pin_11), J9.MP2 (Pin_11), Q1.2 (S), U2.1, U11.4 (GNDa)
unnamed: J4.17 (Pin_11), J9.17 (Pin_11)
unnamed: J4.18 (Pin_11), J9.18 (Pin_11)
unnamed: J6.3, U8.1
unnamed: C3.2, PS1.2 (GND), Q1.3 (D)
unnamed: Q1.1 (G), R21.2
PE: H1.1 (1_1), H2.1 (1_1), H3.1 (1_1), H4.1 (1_1), J6.1, SP1.PE (PE_PE)
