Konstantin-Dudersky/plc-modules/pcb/PMCNV-DIx32-v0.1.0/PMCNV-DIx32.kicad_pcb

## KiCad design pcb/PMCNV-DIx32-v0.1.0/PMCNV-DIx32.kicad_pcb (2026-06-11)

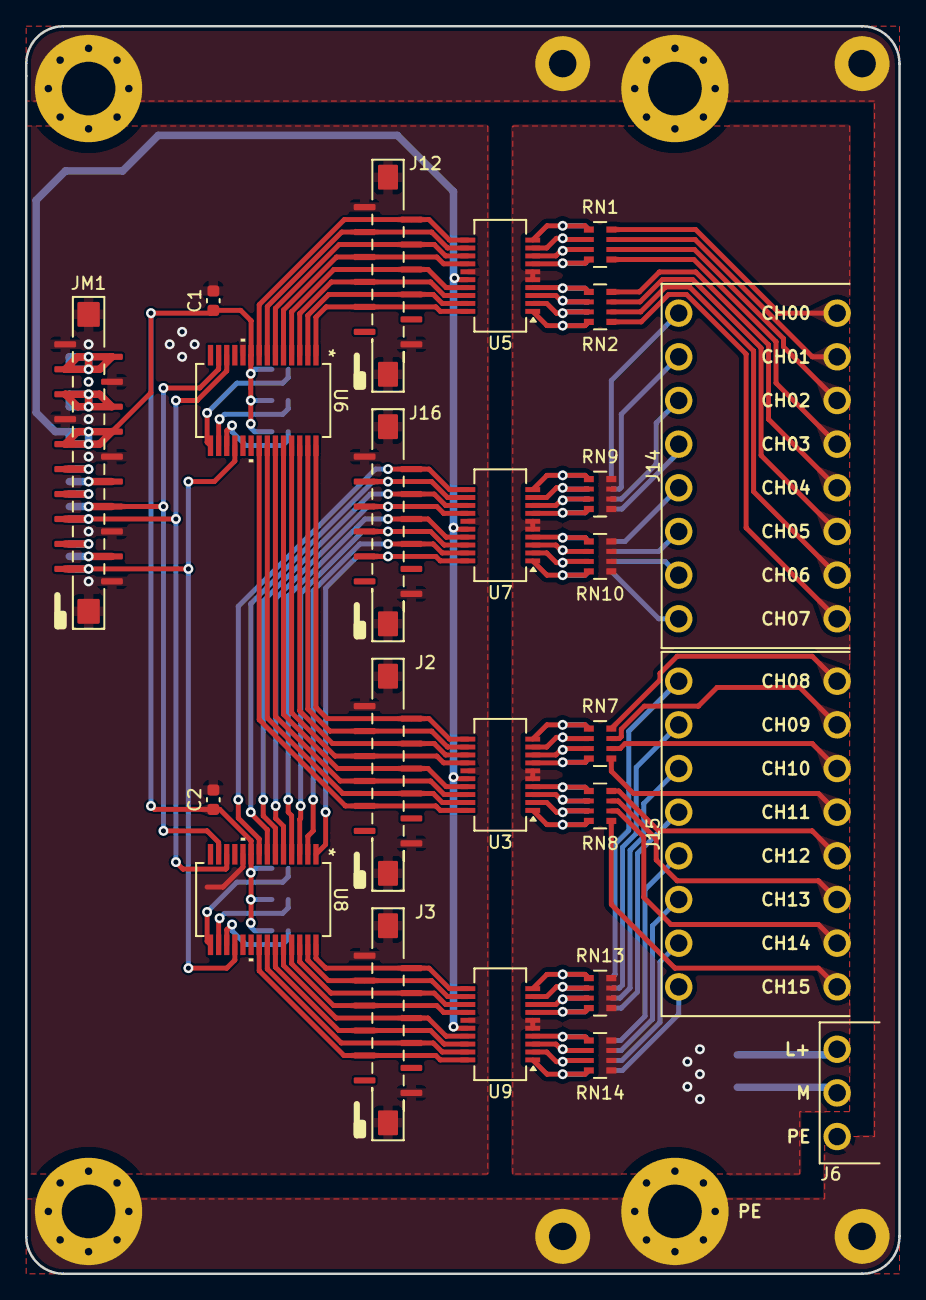
[picture p302: board PMCNV-DIx32.kicad_pcb from above]

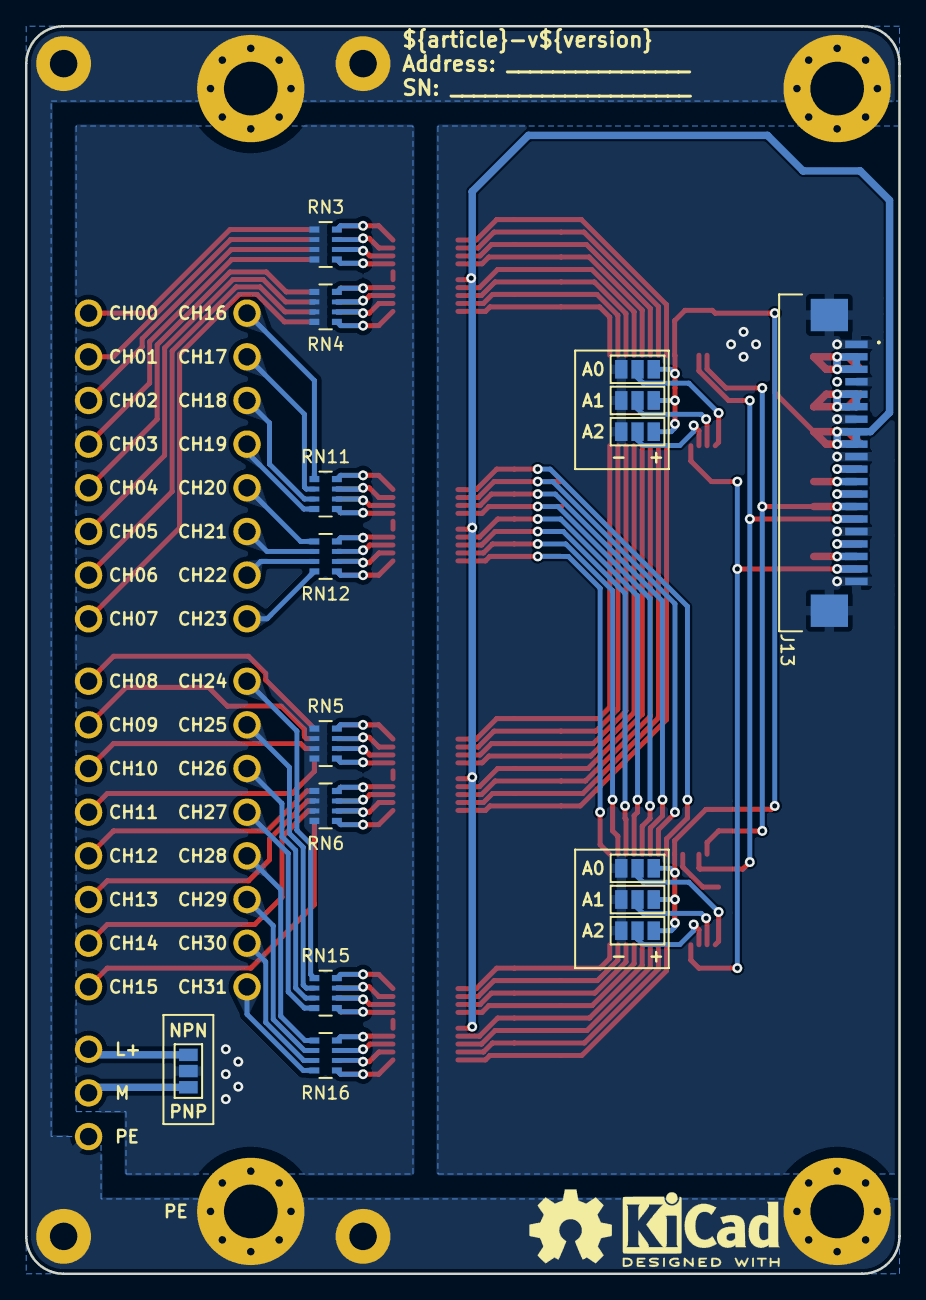
[picture p303: board PMCNV-DIx32.kicad_pcb from below]

Board: 2 copper layers, 70.0 x 100.0 mm, 47 parts (18 on the bottom side), 118 nets.

Parts:
C1, C2: 100nF; C_0603_1608Metric
H1, H2, H3, H4: M4; MountingHole_4.3mm_M4_Pad_Via
J2, J3, J12, J16: AFA07-S12FCC-00; AFA11-S12GLA-00
J6: 15EDGRC-3.5-05P; 15EDGRC-3.5-03P
J13: AFA07-S20FCC-00; AFA07S20FCA00
J14, J15: 15EDGRH-3.5-16P
JM1: AFA07-S20FCC-00; AFA11-S20GLA-00
JP5, JP6, JP7, JP8, JP9, JP10, JP11: SolderJumper_3_Open; SolderJumper-3_P1.3mm_Open_Pad1.0x1.5mm
RN1, RN2, RN7, RN8, RN11, RN12, RN15, RN16: 2k7; R_Array_Convex_4x0603
RN3, RN4, RN5, RN6, RN9, RN10, RN13, RN14: 750R; R_Array_Convex_4x0603
SP1: PMLED-xx-v0.0.3
U3, U5, U7, U9: CA-IS3980P; SSOP-20_3.9x8.7mm_P0.635mm
U6, U8: MCP23017_SS; SSOP28_MC_MCH
kicad_logo: KiCad-Logo2_5mm_SilkScreen
oshw_logo: OSHW-Symbol_6.7x6mm_SilkScreen

Connections:
/A0_0: JP5.2 (C), U6.15 (A0)
/A0_1: JP8.2 (C), U8.15 (A0)
/A1_0: JP6.2 (C), U6.16 (A1)
/A1_1: JP9.2 (C), U8.16 (A1)
/A2_0: JP7.2 (C), U6.17 (A2)
/A2_1: JP11.2 (C), U8.17 (A2)
/CH00: J12.2, U5.11 (B8), U6.8 (GPB7)
/CH00_div: RN1.1 (R1.1), RN3.4 (R4.1), U5.10 (A8)
/CH00_in: J14.8, RN1.8 (R1.2)
/CH01: J12.3, U5.12 (B7), U6.7 (GPB6)
/CH01_div: RN1.2 (R2.1), RN3.3 (R3.1), U5.9 (A7)
/CH01_in: J14.7, RN1.7 (R2.2)
/CH02: J12.4, U5.13 (B6), U6.6 (GPB5)
/CH02_div: RN1.3 (R3.1), RN3.2 (R2.1), U5.8 (A6)
/CH02_in: J14.6, RN1.6 (R3.2)
/CH03: J12.5, U5.14 (B5), U6.5 (GPB4)
/CH03_div: RN1.4 (R4.1), RN3.1 (R1.1), U5.7 (A5)
/CH03_in: J14.5, RN1.5 (R4.2)
/CH04: J12.6, U5.17 (B4), U6.4 (GPB3)
/CH04_div: RN2.1 (R1.1), RN4.4 (R4.1), U5.4 (A4)
/CH04_in: J14.4, RN2.8 (R1.2)
/CH05: J12.7, U5.18 (B3), U6.3 (GPB2)
/CH05_div: RN2.2 (R2.1), RN4.3 (R3.1), U5.3 (A3)
/CH05_in: J14.3, RN2.7 (R2.2)
/CH06: J12.8, U5.19 (B2), U6.2 (GPB1)
/CH06_div: RN2.3 (R3.1), RN4.2 (R2.1), U5.2 (A2)
/CH06_in: J14.2, RN2.6 (R3.2)
/CH07: J12.9, U5.20 (B1), U6.1 (GPB0)
/CH07_div: RN2.4 (R4.1), RN4.1 (R1.1), U5.1 (A1)
/CH07_in: J14.1, RN2.5 (R4.2)
/CH08: J2.2, U3.11 (B8), U6.28 (GPA7)
/CH08_div: RN5.4 (R4.1), RN7.1 (R1.1), U3.10 (A8)
/CH08_in: J15.8, RN7.8 (R1.2)
/CH09: J2.3, U3.12 (B7), U6.27 (GPA6)
/CH09_div: RN5.3 (R3.1), RN7.2 (R2.1), U3.9 (A7)
/CH09_in: J15.7, RN7.7 (R2.2)
/CH10: J2.4, U3.13 (B6), U6.26 (GPA5)
/CH10_div: RN5.2 (R2.1), RN7.3 (R3.1), U3.8 (A6)
/CH10_in: J15.6, RN7.6 (R3.2)
/CH11: J2.5, U3.14 (B5), U6.25 (GPA4)
/CH11_div: RN5.1 (R1.1), RN7.4 (R4.1), U3.7 (A5)
/CH11_in: J15.5, RN7.5 (R4.2)
/CH12: J2.6, U3.17 (B4), U6.24 (GPA3)
/CH12_div: RN6.4 (R4.1), RN8.1 (R1.1), U3.4 (A4)
/CH12_in: J15.4, RN8.8 (R1.2)
/CH13: J2.7, U3.18 (B3), U6.23 (GPA2)
/CH13_div: RN6.3 (R3.1), RN8.2 (R2.1), U3.3 (A3)
/CH13_in: J15.3, RN8.7 (R2.2)
/CH14: J2.8, U3.19 (B2), U6.22 (GPA1)
/CH14_div: RN6.2 (R2.1), RN8.3 (R3.1), U3.2 (A2)
/CH14_in: J15.2, RN8.6 (R3.2)
/CH15: J2.9, U3.20 (B1), U6.21 (GPA0)
/CH15_div: RN6.1 (R1.1), RN8.4 (R4.1), U3.1 (A1)
/CH15_in: J15.1, RN8.5 (R4.2)
/CH16: J16.2, U7.11 (B8), U8.8 (GPB7)
/CH16_div: RN9.1 (R1.1), RN11.4 (R4.1), U7.10 (A8)
/CH16_in: J14.16, RN11.5 (R4.2)
/CH17: J16.3, U7.12 (B7), U8.7 (GPB6)
/CH17_div: RN9.2 (R2.1), RN11.3 (R3.1), U7.9 (A7)
/CH17_in: J14.15, RN11.6 (R3.2)
/CH18: J16.4, U7.13 (B6), U8.6 (GPB5)
/CH18_div: RN9.3 (R3.1), RN11.2 (R2.1), U7.8 (A6)
/CH18_in: J14.14, RN11.7 (R2.2)
/CH19: J16.5, U7.14 (B5), U8.5 (GPB4)
/CH19_div: RN9.4 (R4.1), RN11.1 (R1.1), U7.7 (A5)
/CH19_in: J14.13, RN11.8 (R1.2)
/CH20: J16.6, U7.17 (B4), U8.4 (GPB3)
/CH20_div: RN10.1 (R1.1), RN12.4 (R4.1), U7.4 (A4)
/CH20_in: J14.12, RN12.5 (R4.2)
/CH21: J16.7, U7.18 (B3), U8.3 (GPB2)
/CH21_div: RN10.2 (R2.1), RN12.3 (R3.1), U7.3 (A3)
/CH21_in: J14.11, RN12.6 (R3.2)
/CH22: J16.8, U7.19 (B2), U8.2 (GPB1)
/CH22_div: RN10.3 (R3.1), RN12.2 (R2.1), U7.2 (A2)
/CH22_in: J14.10, RN12.7 (R2.2)
/CH23: J16.9, U7.20 (B1), U8.1 (GPB0)
/CH23_div: RN10.4 (R4.1), RN12.1 (R1.1), U7.1 (A1)
/CH23_in: J14.9, RN12.8 (R1.2)
/CH24: J3.2, U8.28 (GPA7), U9.11 (B8)
/CH24_div: RN13.1 (R1.1), RN15.4 (R4.1), U9.10 (A8)
/CH24_in: J15.16, RN15.5 (R4.2)
/CH25: J3.3, U8.27 (GPA6), U9.12 (B7)
/CH25_div: RN13.2 (R2.1), RN15.3 (R3.1), U9.9 (A7)
/CH25_in: J15.15, RN15.6 (R3.2)
/CH26: J3.4, U8.26 (GPA5), U9.13 (B6)
/CH26_div: RN13.3 (R3.1), RN15.2 (R2.1), U9.8 (A6)
/CH26_in: J15.14, RN15.7 (R2.2)
/CH27: J3.5, U8.25 (GPA4), U9.14 (B5)
/CH27_div: RN13.4 (R4.1), RN15.1 (R1.1), U9.7 (A5)
/CH27_in: J15.13, RN15.8 (R1.2)
/CH28: J3.6, U8.24 (GPA3), U9.17 (B4)
/CH28_div: RN14.1 (R1.1), RN16.4 (R4.1), U9.4 (A4)
/CH28_in: J15.12, RN16.5 (R4.2)
/CH29: J3.7, U8.23 (GPA2), U9.18 (B3)
/CH29_div: RN14.2 (R2.1), RN16.3 (R3.1), U9.3 (A3)
/CH29_in: J15.11, RN16.6 (R3.2)
/CH30: J3.8, U8.22 (GPA1), U9.19 (B2)
/CH30_div: RN14.3 (R3.1), RN16.2 (R2.1), U9.2 (A2)
/CH30_in: J15.10, RN16.7 (R2.2)
/CH31: J3.9, U8.21 (GPA0), U9.20 (B1)
/CH31_div: RN14.4 (R4.1), RN16.1 (R1.1), U9.1 (A1)
/CH31_in: J15.9, RN16.8 (R1.2)
/COM_CNV: JP10.2 (C), RN3.5 (R4.2), RN3.6 (R3.2), RN3.7 (R2.2), RN3.8 (R1.2), RN4.5 (R4.2), RN4.6 (R3.2), RN4.7 (R2.2), RN4.8 (R1.2), RN5.5 (R4.2), RN5.6 (R3.2), RN5.7 (R2.2), RN5.8 (R1.2), RN6.5 (R4.2), RN6.6 (R3.2), RN6.7 (R2.2), RN6.8 (R1.2), RN9.5 (R4.2), RN9.6 (R3.2), RN9.7 (R2.2), RN9.8 (R1.2), RN10.5 (R4.2), RN10.6 (R3.2), RN10.7 (R2.2), RN10.8 (R1.2), RN13.5 (R4.2), RN13.6 (R3.2), RN13.7 (R2.2), RN13.8 (R1.2), RN14.5 (R4.2), RN14.6 (R3.2), RN14.7 (R2.2), RN14.8 (R1.2), U3.5 (COM), U3.6 (COM), U5.5 (COM), U5.6 (COM), U7.5 (COM), U7.6 (COM), U9.5 (COM), U9.6 (COM)
/IBUS_5V: J13.5, J13.6, JM1.5, JM1.6
/IBUS_24V: J13.2, J13.3, JM1.2, JM1.3
/IBUS_CAN_GND: J13.13 (Pin_11), JM1.13 (Pin_11)
/IBUS_CAN_H: J13.11, JM1.11
/IBUS_CAN_L: J13.12 (Pin_11), JM1.12 (Pin_11)
/IBUS_I2C_SCL: J13.15 (Pin_11), JM1.15 (Pin_11), U6.12 (SCL), U8.12 (SCL)
/IBUS_I2C_SDA: J13.14 (Pin_11), JM1.14 (Pin_11), U6.13 (SDA), U8.13 (SDA)
/IBUS_RST: J13.19 (Pin_11), JM1.19 (Pin_11), U6.18 (~RESET), U8.18 (~RESET)
GND_CNV: J6.2, JP10.1 (A)
IBUS_3V3: C1.1, C2.1, J13.8, J13.9, JM1.8, JM1.9, JP5.3 (B), JP6.3 (B), JP7.3 (B), JP8.3 (B), JP9.3 (B), JP11.3 (B), U3.16 (VDD), U5.16 (VDD), U6.9 (VDD), U7.16 (VDD), U8.9 (VDD), U9.16 (VDD)
IBUS_GND: C1.2, C2.2, J2.1, J2.12 (Pin_11), J2.MP1 (Pin_11), J2.MP2 (Pin_11), J3.1, J3.12 (Pin_11), J3.MP1 (Pin_11), J3.MP2 (Pin_11), J12.1, J12.12 (Pin_11), J12.MP1 (Pin_11), J12.MP2 (Pin_11), J13.1, J13.4, J13.7, J13.10, J13.16 (Pin_11), J13.20 (Pin_11), J13.MP1 (Pin_11), J13.MP2 (Pin_11), J16.1, J16.12 (Pin_11), J16.MP1 (Pin_11), J16.MP2 (Pin_11), JM1.1, JM1.4, JM1.7, JM1.10, JM1.16 (Pin_11), JM1.20 (Pin_11), JM1.MP1 (Pin_11), JM1.MP2 (Pin_11), JP5.1 (A), JP6.1 (A), JP7.1 (A), JP8.1 (A), JP9.1 (A), JP11.1 (A), U3.15 (GND), U5.15 (GND), U6.10 (VSS), U7.15 (GND), U8.10 (VSS), U9.15 (GND)
L+_CNV: J6.3, JP10.3 (B)
unnamed: J13.17 (Pin_11), JM1.17 (Pin_11)
unnamed: J13.18 (Pin_11), JM1.18 (Pin_11)
PE: H1.1 (1_1), H2.1 (1_1), H3.1 (1_1), H4.1 (1_1), J6.1, SP1.PE (PE_PE)
