Konstantin-Dudersky/plc-modules/pcb/PMCNV-AI8T-v0.1.0/PMCNV-AI8T.kicad_pcb

## KiCad design pcb/PMCNV-AI8T-v0.1.0/PMCNV-AI8T.kicad_pcb (2026-06-10)

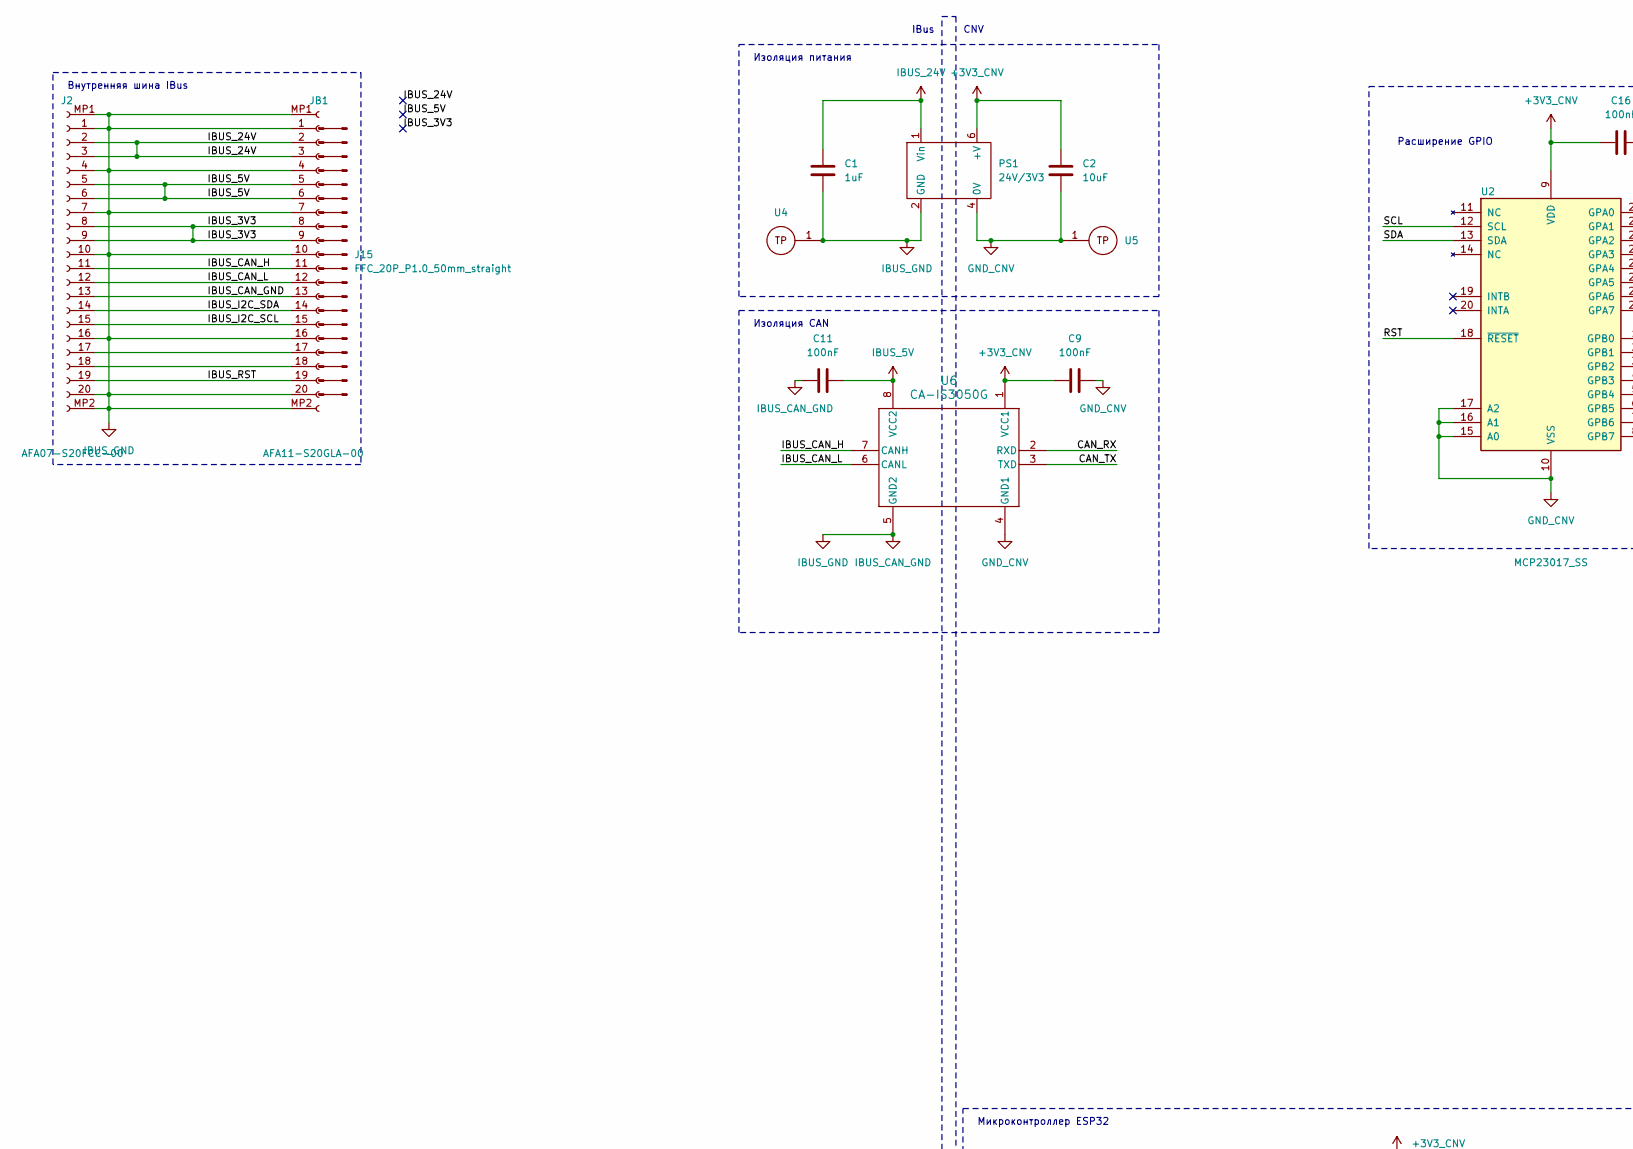
[picture p304: schematic PMCNV-AI8T.kicad_sch, ${article} v${version}, part in row 1, column 1]

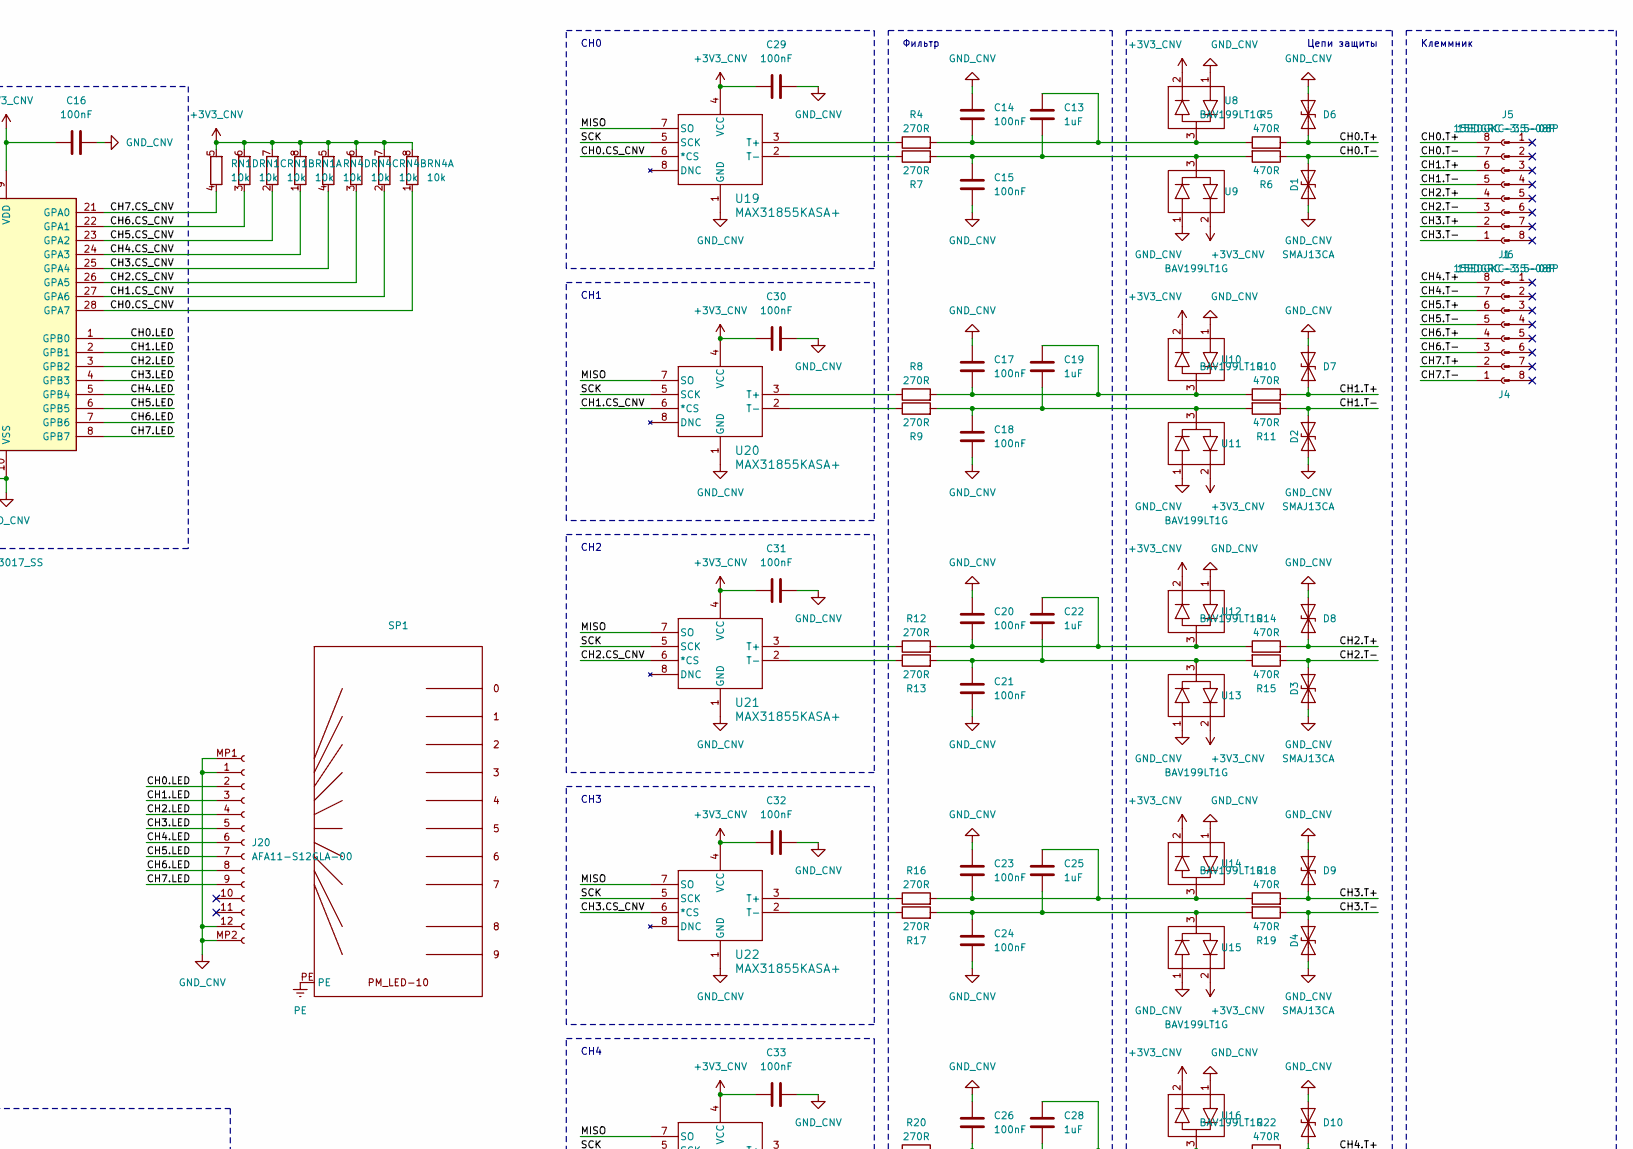
[picture p305: schematic PMCNV-AI8T.kicad_sch, ${article} v${version}, part in row 1, column 2]

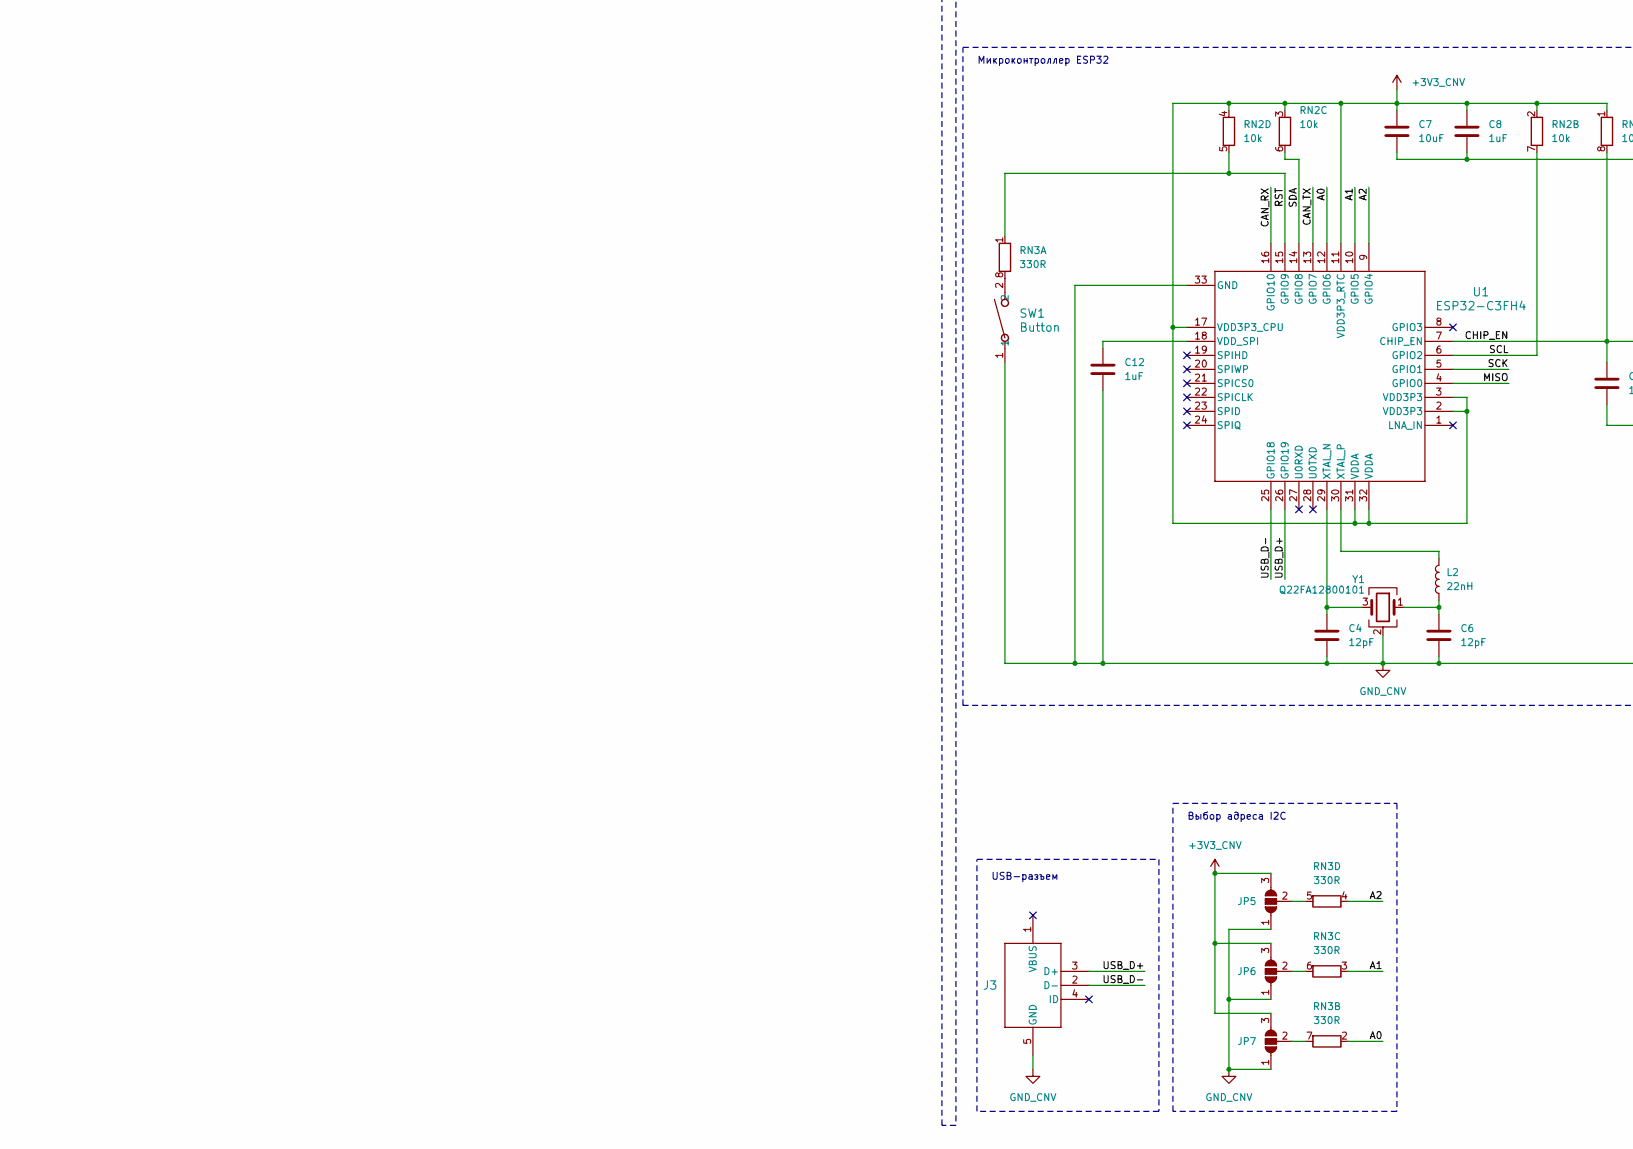
[picture p306: schematic PMCNV-AI8T.kicad_sch, ${article} v${version}, part in row 2, column 1]

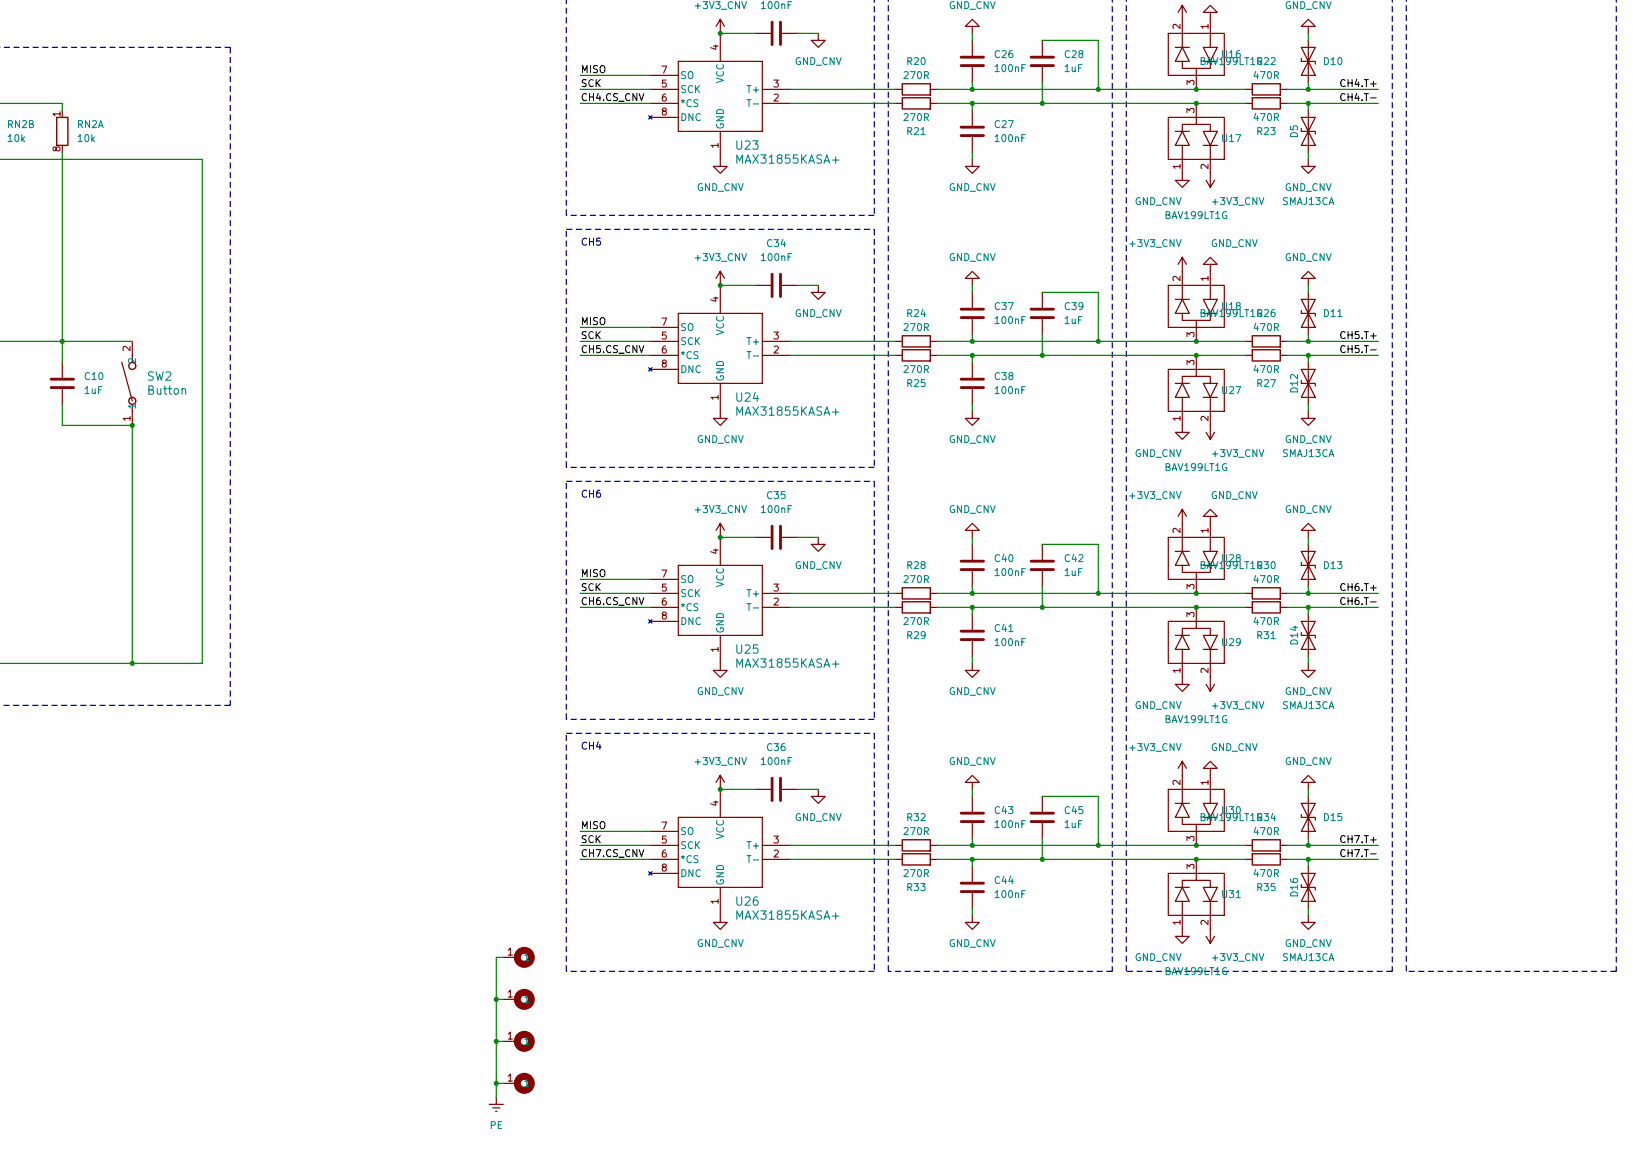
[picture p307: schematic PMCNV-AI8T.kicad_sch, ${article} v${version}, part in row 2, column 2]

Parts:
C1, C8, C10, C12, C13, C19, C22, C25, C28, C39, C42, C45: 1uF; C_0603_1608Metric; part_ipn C_1uF_50V_0603_MLCC-X7R
C2, C7: 10uF; C_1206_3216Metric; part_ipn C_10uF_50V_1206_MLCC-X7R
C4, C6: 12pF; C_0603_1608Metric; part_ipn C_12pF_100V_0603_MLCC-NP0
C9, C11, C14, C15, C16, C17, C18, C20, C21, C23, C24, C26, C27, C29, C30, C31, C32, C33, C34, C35, C36, C37, C38, C40, C41, C43, C44: 100nF; C_0603_1608Metric; part_ipn C_100nF_100V_0603_MLCC-X7R
D1, D2, D3, D4, D5, D6, D7, D8, D9, D10, D11, D12, D13, D14, D15, D16: SMAJ13CA; SMASeries_LTF; part_ipn SMAJ13CA
H4, H5, H6, H7: M4; MountingHole_4.3mm_M4_Pad_Via
J1, J4: 15EDGRC-3.5-08P; part_ipn 15EDGRC-3.5-08P
J2: AFA07-S20FCC-00; AFA07S20FCA00; part_ipn AFA07-S20FCC-00
J3: U254-051T-4BH83-S1S; CONN5_H83-S1S_XKB; part_ipn U254-051T-4BH83-S1S
J5, J6: 15EDGKC-3.5-08P; part_ipn 15EDGKC-3.5-08P
J15: FFC_20P_P1.0_50mm_straight; part_ipn FFC_20P_P1.0_50mm_straight
J20: AFA11-S12GLA-00; part_ipn AFA11-S12GLA-00
JB1: AFA11-S20GLA-00; part_ipn AFA11-S20GLA-00
JP5, JP6, JP7: SolderJumper_3_Open; SolderJumper-3_P1.3mm_Open_Pad1.0x1.5mm
L2: 22nH; L_0603_1608Metric; part_ipn L_22nH_0603
PS1: 24V/3V3; B2405LS-1WR3; part_ipn B2403LS-1W
R4, R7, R8, R9, R12, R13, R16, R17, R20, R21, R24, R25, R28, R29, R32, R33: 270R; R_0603_1608Metric; part_ipn R_270R_0603_1%
R5, R6, R10, R11, R14, R15, R18, R19, R22, R23, R26, R27, R30, R31, R34, R35: 470R; R_0603_1608Metric; part_ipn R_470R_0603_1%
RN1, RN2, RN4: 10k; R_Array_Convex_4x0603; part_ipn R_10k_0603x4_1%
RN3: 330R; R_Array_Convex_4x0603; part_ipn R_330R_0603x4_1%
SP1: PMLED-xx-v0.0.3; part_ipn PMLED-10-v0.0.2
SW1, SW2: Button; SW_TS-1088_XNP-M; part_ipn TS-1088-AR02016
U1: ESP32-C3FH4; QFN32_5X5_EXP; part_ipn ESP32-C3FH4
U2: MCP23017_SS; SSOP28_MC_MCH; part_ipn MCP23017-E/SS
U4, U5: 5117; part_ipn Keystone_5117
U6: CA-IS3050G; SOIC8_CA-IS305_CLG; part_ipn CA-IS3050G
U8, U9, U10, U11, U12, U13, U14, U15, U16, U17, U18, U27, U28, U29, U30, U31: BAV199LT1G; SOT-23_ONS; part_ipn BAV199LT1G
U19, U20, U21, U22, U23, U24, U25, U26: MAX31855KASA+; 21-0041B_8_MXM; part_ipn MAX31855KASA+
Y1: Q22FA12800101; Crystal_SMD_2016-4Pin_2.0x1.6mm; part_ipn Q22FA12800101

Connections:
+3V3_CNV: C2.1, C7.1, C8.1, C9.1, C16.1, C29.1, C30.1, C31.1, C32.1, C33.1, C34.1, C35.1, C36.1, JP5.3 (B), JP6.3 (B), JP7.3 (B), PS1.6 (+V), RN1.5 (R4.2), RN1.6 (R3.2), RN1.7 (R2.2), RN1.8 (R1.2), RN2.1 (R1.1), RN2.2 (R2.1), RN2.3 (R3.1), RN2.4 (R4.1), RN4.5 (R4.2), RN4.6 (R3.2), RN4.7 (R2.2), RN4.8 (R1.2), U1.2 (VDD3P3), U1.3 (VDD3P3), U1.11 (VDD3P3_RTC), U1.17 (VDD3P3_CPU), U1.31 (VDDA), U1.32 (VDDA), U2.9 (VDD), U6.1 (VCC1), U8.2, U9.2, U10.2, U11.2, U12.2, U13.2, U14.2, U15.2, U16.2, U17.2, U18.2, U19.4 (VCC), U20.4 (VCC), U21.4 (VCC), U22.4 (VCC), U23.4 (VCC), U24.4 (VCC), U25.4 (VCC), U26.4 (VCC), U27.2, U28.2, U29.2, U30.2, U31.2
/A0: RN3.2 (R2.1), U1.12 (GPIO6)
/A1: RN3.3 (R3.1), U1.10 (GPIO5)
/A2: RN3.4 (R4.1), U1.9 (GPIO4)
/CAN_RX: U1.16 (GPIO10), U6.2 (RXD)
/CAN_TX: U1.13 (GPIO7), U6.3 (TXD)
/CH0.CS_CNV: RN4.1 (R1.1), U2.28 (GPA7), U19.6 (*CS)
/CH0.LED: J20.2, U2.1 (GPB0)
/CH0.T+: D6.2 (A2), J1.8, R5.2
/CH0.T-: D1.2 (A2), J1.7, R6.1
/CH1.CS_CNV: RN4.2 (R2.1), U2.27 (GPA6), U20.6 (*CS)
/CH1.LED: J20.3, U2.2 (GPB1)
/CH1.T+: D7.2 (A2), J1.6, R10.2
/CH1.T-: D2.2 (A2), J1.5, R11.1
/CH2.CS_CNV: RN4.3 (R3.1), U2.26 (GPA5), U21.6 (*CS)
/CH2.LED: J20.4, U2.3 (GPB2)
/CH2.T+: D8.2 (A2), J1.4, R14.2
/CH2.T-: D3.2 (A2), J1.3, R15.1
/CH3.CS_CNV: RN4.4 (R4.1), U2.25 (GPA4), U22.6 (*CS)
/CH3.LED: J20.5, U2.4 (GPB3)
/CH3.T+: D9.2 (A2), J1.2, R18.2
/CH3.T-: D4.2 (A2), J1.1, R19.1
/CH4.CS_CNV: RN1.1 (R1.1), U2.24 (GPA3), U23.6 (*CS)
/CH4.LED: J20.6, U2.5 (GPB4)
/CH4.T+: D10.2 (A2), J4.8, R22.2
/CH4.T-: D5.2 (A2), J4.7, R23.1
/CH5.CS_CNV: RN1.2 (R2.1), U2.23 (GPA2), U24.6 (*CS)
/CH5.LED: J20.7, U2.6 (GPB5)
/CH5.T+: D11.2 (A2), J4.6, R26.2
/CH5.T-: D12.2 (A2), J4.5, R27.1
/CH6.CS_CNV: RN1.3 (R3.1), U2.22 (GPA1), U25.6 (*CS)
/CH6.LED: J20.8, U2.7 (GPB6)
/CH6.T+: D13.2 (A2), J4.4, R30.2
/CH6.T-: D14.2 (A2), J4.3, R31.1
/CH7.CS_CNV: RN1.4 (R4.1), U2.21 (GPA0), U26.6 (*CS)
/CH7.LED: J20.9, U2.8 (GPB7)
/CH7.T+: D15.2 (A2), J4.2, R34.2
/CH7.T-: D16.2 (A2), J4.1, R35.1
/CHIP_EN: C10.1, RN2.8 (R1.2), SW2.2, U1.7 (CHIP_EN)
/IBUS_3V3: J2.8, J2.9, JB1.8, JB1.9
/IBUS_CAN_H: J2.11, JB1.11, U6.7 (CANH)
/IBUS_CAN_L: J2.12 (Pin_11), JB1.12 (Pin_11), U6.6 (CANL)
/IBUS_I2C_SCL: J2.15 (Pin_11), JB1.15 (Pin_11)
/IBUS_I2C_SDA: J2.14 (Pin_11), JB1.14 (Pin_11)
/IBUS_RST: J2.19 (Pin_11), JB1.19 (Pin_11)
/MISO: U1.4 (GPIO0), U19.7 (SO), U20.7 (SO), U21.7 (SO), U22.7 (SO), U23.7 (SO), U24.7 (SO), U25.7 (SO), U26.7 (SO)
/RST: RN2.5 (R4.2), RN3.1 (R1.1), U1.15 (GPIO9), U2.18 (~RESET)
/SCK: U1.5 (GPIO1), U19.5 (SCK), U20.5 (SCK), U21.5 (SCK), U22.5 (SCK), U23.5 (SCK), U24.5 (SCK), U25.5 (SCK), U26.5 (SCK)
/SCL: RN2.7 (R2.2), U1.6 (GPIO2), U2.12 (SCL)
/SDA: RN2.6 (R3.2), U1.14 (GPIO8), U2.13 (SDA)
/USB_D+: J3.3 (D+), U1.26 (GPIO19)
/USB_D-: J3.2 (D-), U1.25 (GPIO18)
GND_CNV: C2.2, C4.2, C6.2, C7.2, C8.2, C9.2, C10.2, C12.2, C14.1, C15.2, C16.2, C17.1, C18.2, C20.1, C21.2, C23.1, C24.2, C26.1, C27.2, C29.2, C30.2, C31.2, C32.2, C33.2, C34.2, C35.2, C36.2, C37.1, C38.2, C40.1, C41.2, C43.1, C44.2, D1.1 (A1), D2.1 (A1), D3.1 (A1), D4.1 (A1), D5.1 (A1), D6.1 (A1), D7.1 (A1), D8.1 (A1), D9.1 (A1), D10.1 (A1), D11.1 (A1), D12.1 (A1), D13.1 (A1), D14.1 (A1), D15.1 (A1), D16.1 (A1), J3.5 (GND), J20.1, J20.12 (Pin_11), J20.MP1 (Pin_11), J20.MP2 (Pin_11), JP5.1 (A), JP6.1 (A), JP7.1 (A), PS1.4 (0V), SW1.1, SW2.1, U1.33 (GND), U2.10 (VSS), U2.15 (A0), U2.16 (A1), U2.17 (A2), U5.1, U6.4 (GND1), U8.1, U9.1, U10.1, U11.1, U12.1, U13.1, U14.1, U15.1, U16.1, U17.1, U18.1, U19.1 (GND), U20.1 (GND), U21.1 (GND), U22.1 (GND), U23.1 (GND), U24.1 (GND), U25.1 (GND), U26.1 (GND), U27.1, U28.1, U29.1, U30.1, U31.1, Y1.2 (G), Y1.4 (G)
IBUS_5V: C11.2, J2.5, J2.6, JB1.5, JB1.6, U6.8 (VCC2)
IBUS_24V: C1.1, J2.2, J2.3, JB1.2, JB1.3, PS1.1 (Vin)
IBUS_CAN_GND: C1.2, C11.1, J2.1, J2.4, J2.7, J2.10, J2.13 (Pin_11), J2.16 (Pin_11), J2.20 (Pin_11), J2.MP1 (Pin_11), J2.MP2 (Pin_11), JB1.1, JB1.4, JB1.7, JB1.10, JB1.13 (Pin_11), JB1.16 (Pin_11), JB1.20 (Pin_11), JB1.MP1 (Pin_11), JB1.MP2 (Pin_11), PS1.2 (GND), U4.1, U6.5 (GND2)
unnamed: C6.1, L2.1, Y1.1
unnamed: C13.1, C14.2, R4.2, R5.1, U8.3
unnamed: C13.2, C15.1, R6.2, R7.2, U9.3
unnamed: C17.2, C19.1, R8.2, R10.1, U10.3
unnamed: C18.1, C19.2, R9.2, R11.2, U11.3
unnamed: C20.2, C22.1, R12.2, R14.1, U12.3
unnamed: C21.1, C22.2, R13.2, R15.2, U13.3
unnamed: C23.2, C25.1, R16.2, R18.1, U14.3
unnamed: C24.1, C25.2, R17.2, R19.2, U15.3
unnamed: C26.2, C28.1, R20.2, R22.1, U16.3
unnamed: C27.1, C28.2, R21.2, R23.2, U17.3
unnamed: C37.2, C39.1, R24.2, R26.1, U18.3
unnamed: C38.1, C39.2, R25.2, R27.2, U27.3
unnamed: C40.2, C42.1, R28.2, R30.1, U28.3
unnamed: C41.1, C42.2, R29.2, R31.2, U29.3
unnamed: C43.2, C45.1, R32.2, R34.1, U30.3
unnamed: C44.1, C45.2, R33.2, R35.2, U31.3
unnamed: J2.17 (Pin_11), JB1.17 (Pin_11)
unnamed: J2.18 (Pin_11), JB1.18 (Pin_11)
unnamed: JP5.2 (C), RN3.5 (R4.2)
unnamed: JP6.2 (C), RN3.6 (R3.2)
unnamed: JP7.2 (C), RN3.7 (R2.2)
unnamed: RN3.8 (R1.2), SW1.2
unnamed: C12.1, U1.18 (VDD_SPI)
unnamed: C4.1, U1.29 (XTAL_N), Y1.3
unnamed: L2.2, U1.30 (XTAL_P)
unnamed: R4.1, U19.3 (T+)
unnamed: R7.1, U19.2 (T-)
unnamed: R8.1, U20.3 (T+)
unnamed: R9.1, U20.2 (T-)
unnamed: R12.1, U21.3 (T+)
unnamed: R13.1, U21.2 (T-)
unnamed: R16.1, U22.3 (T+)
unnamed: R17.1, U22.2 (T-)
unnamed: R20.1, U23.3 (T+)
unnamed: R21.1, U23.2 (T-)
unnamed: R24.1, U24.3 (T+)
unnamed: R25.1, U24.2 (T-)
unnamed: R28.1, U25.3 (T+)
unnamed: R29.1, U25.2 (T-)
unnamed: R32.1, U26.3 (T+)
unnamed: R33.1, U26.2 (T-)
PE: H4.1 (1_1), H5.1 (1_1), H6.1 (1_1), H7.1 (1_1), SP1.PE (PE_PE)

Notes on the sheet:
CH4
IBus
Изоляция питания
Выбор адреса I2C
CH3
CH1
Внутренняя шина IBus
CH2
CH6
CH0
CH5
USB-разъем
Расширение GPIO
CNV
Микроконтроллер ESP32
Изоляция CAN
Фильтр
Цепи защиты
Клеммник

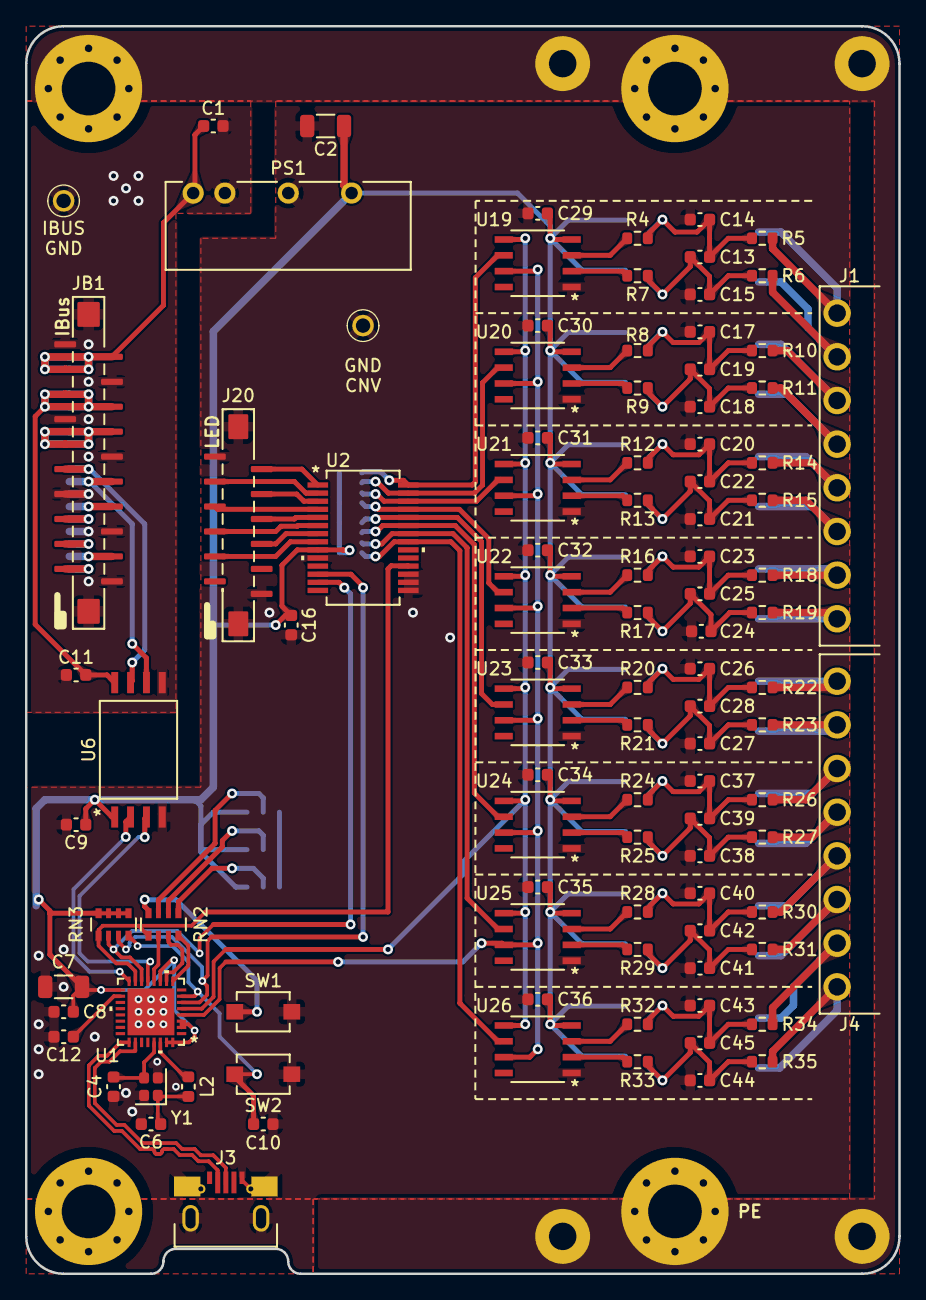
[picture p308: board PMCNV-AI8T.kicad_pcb from above]

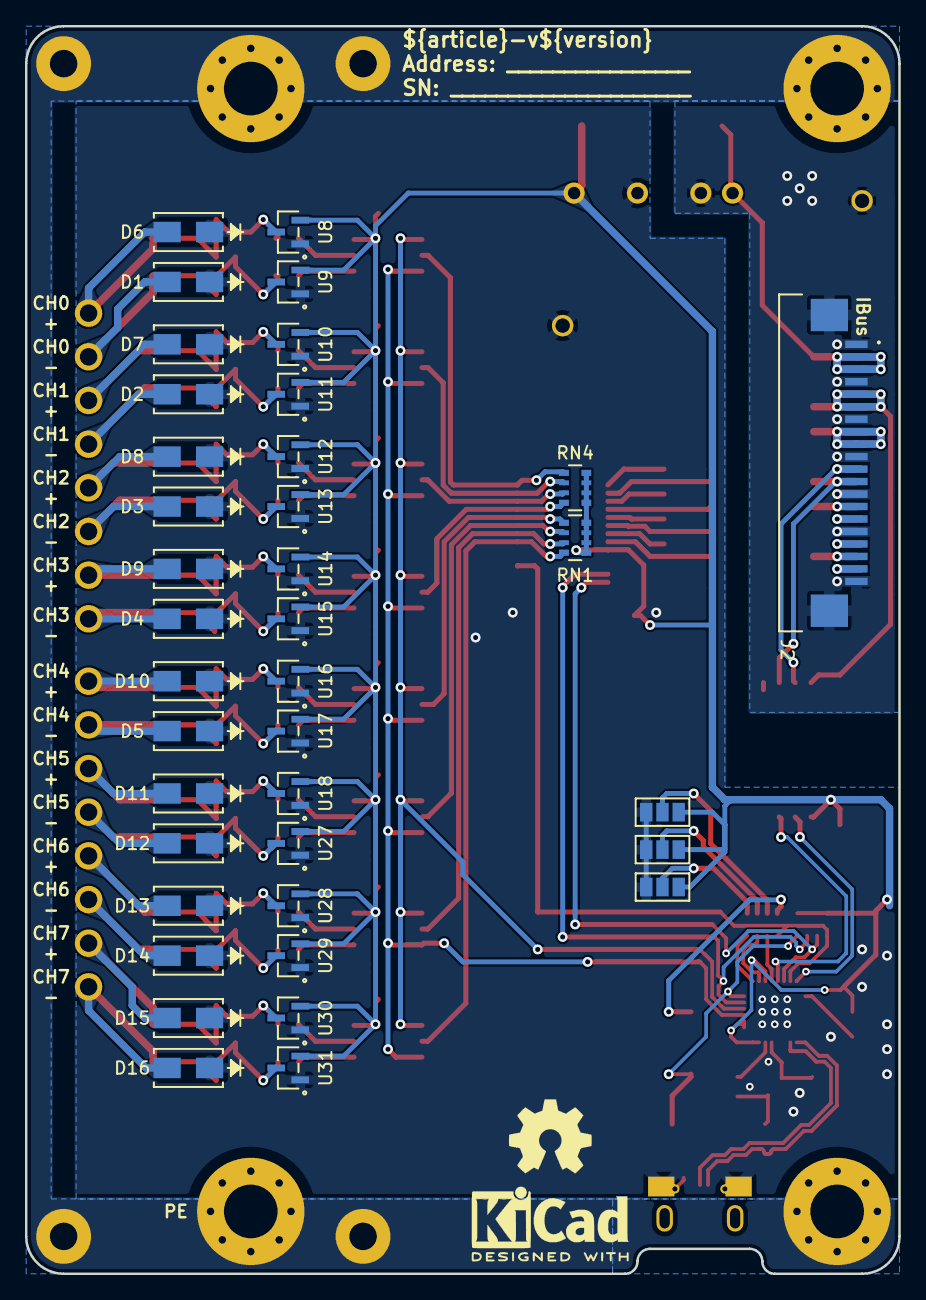
[picture p309: board PMCNV-AI8T.kicad_pcb from below]

Board: 2 copper layers, 70.0 x 100.0 mm, 145 parts (40 on the bottom side), 99 nets.

Other parts of the board:
kicad_logo: KiCad-Logo2_5mm_SilkScreen
oshw_logo: OSHW-Symbol_6.7x6mm_SilkScreen
