Konstantin-Dudersky/plc-modules/pcb/PMDRV-STEPx4-v0.0.1/PMDRV-STEPx4.kicad_pcb

## KiCad design pcb/PMDRV-STEPx4-v0.0.1/PMDRV-STEPx4.kicad_pcb (2026-06-10)

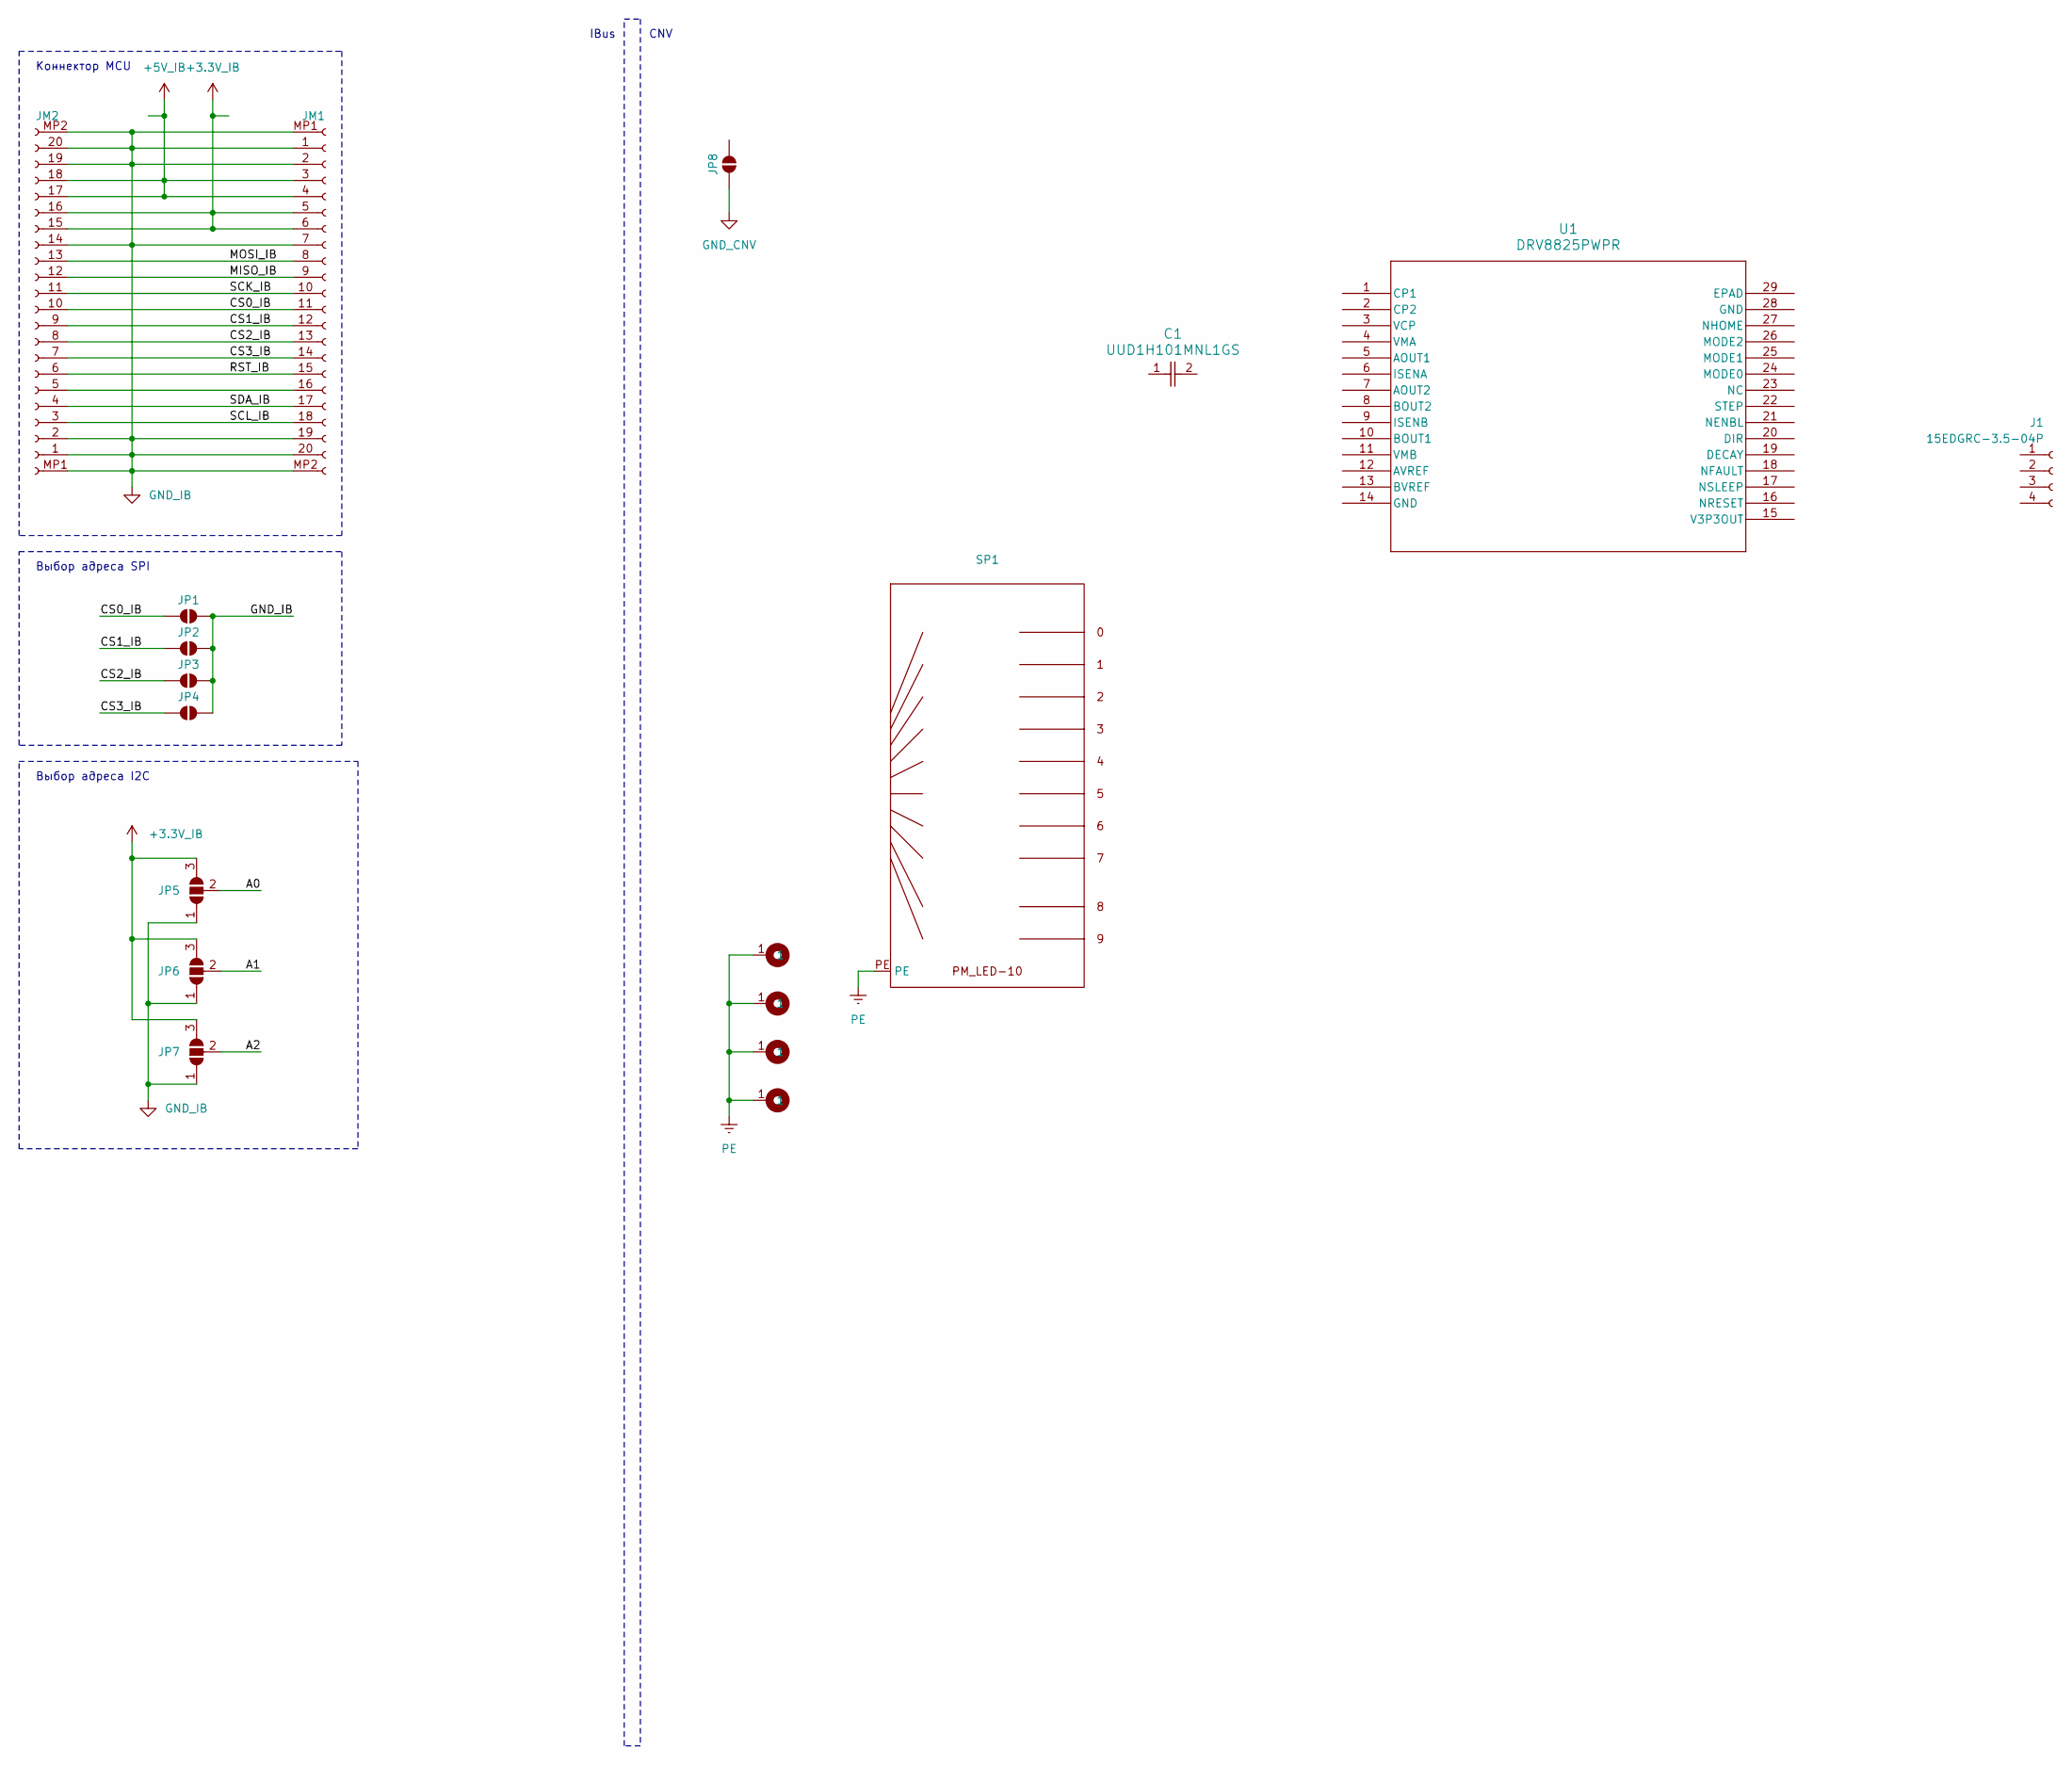
[picture p310: schematic PMDRV-STEPx4.kicad_sch, ${article} v${version}]

Parts:
C1: UUD1H101MNL1GS; U2-P_NCH
H1, H2, H3, H4: M4; MountingHole_4.3mm_M4_Pad_Via
J1: 15EDGRC-3.5-04P; part_ipn 15EDGRC-3.5-04P
JM1, JM2: AFA07-S20FCC-00; AFA11-S20GLA-00; part_ipn AFA11-S20GLA-00
JP1, JP2, JP3, JP4, JP8: SolderJumper_2_Open; SolderJumper-2_P1.3mm_Open_Pad1.0x1.5mm
JP5, JP6, JP7: SolderJumper_3_Open; SolderJumper-3_P1.3mm_Open_Pad1.0x1.5mm
SP1: PMLED-xx-v0.0.3; part_ipn PMLED-10-v0.0.2
U1: DRV8825PWPR; PWP28_5P18X3P1

Connections:
+3.3V_IB: JM1.5, JM1.6, JM2.15 (Pin_11), JM2.16 (Pin_11), JP5.3 (B), JP6.3 (B), JP7.3 (B)
+5V_IB: JM1.3, JM1.4, JM2.17 (Pin_11), JM2.18 (Pin_11)
/A0: JP5.2 (C)
/A1: JP6.2 (C)
/A2: JP7.2 (C)
/CS0_IB: JM1.11, JM2.10, JP1.1 (A)
/CS1_IB: JM1.12 (Pin_11), JM2.9, JP2.1 (A)
/CS2_IB: JM1.13 (Pin_11), JM2.8, JP3.1 (A)
/CS3_IB: JM1.14 (Pin_11), JM2.7, JP4.1 (A)
/MISO_IB: JM1.9, JM2.12 (Pin_11)
/MOSI_IB: JM1.8, JM2.13 (Pin_11)
/RST_IB: JM1.15 (Pin_11), JM2.6
/SCK_IB: JM1.10, JM2.11
/SCL_IB: JM1.18 (Pin_11), JM2.3
/SDA_IB: JM1.17 (Pin_11), JM2.4
GND_CNV: JP8.1 (A_1)
GND_IB: JM1.1, JM1.2, JM1.7, JM1.19 (Pin_11), JM1.20 (Pin_11), JM1.MP1 (Pin_11), JM1.MP2 (Pin_11), JM2.1, JM2.2, JM2.14 (Pin_11), JM2.19 (Pin_11), JM2.20 (Pin_11), JM2.MP1 (Pin_11), JM2.MP2 (Pin_11), JP1.2 (B), JP2.2 (B), JP3.2 (B), JP4.2 (B), JP5.1 (A), JP6.1 (A), JP7.1 (A)
unnamed: JM1.16 (Pin_11), JM2.5
PE: H1.1 (1_1), H2.1 (1_1), H3.1 (1_1), H4.1 (1_1), SP1.PE (PE_PE)

Notes on the sheet:
IBus
Выбор адреса I2C
CNV
Выбор адреса SPI
Коннектор MCU
