Konstantin-Dudersky/plc-modules/pcb/PMDRV-STEPx4-v0.0.1/PMDRV-STEPx4.kicad_pcb

## KiCad design pcb/PMDRV-STEPx4-v0.0.1/PMDRV-STEPx4.kicad_pcb (continued)

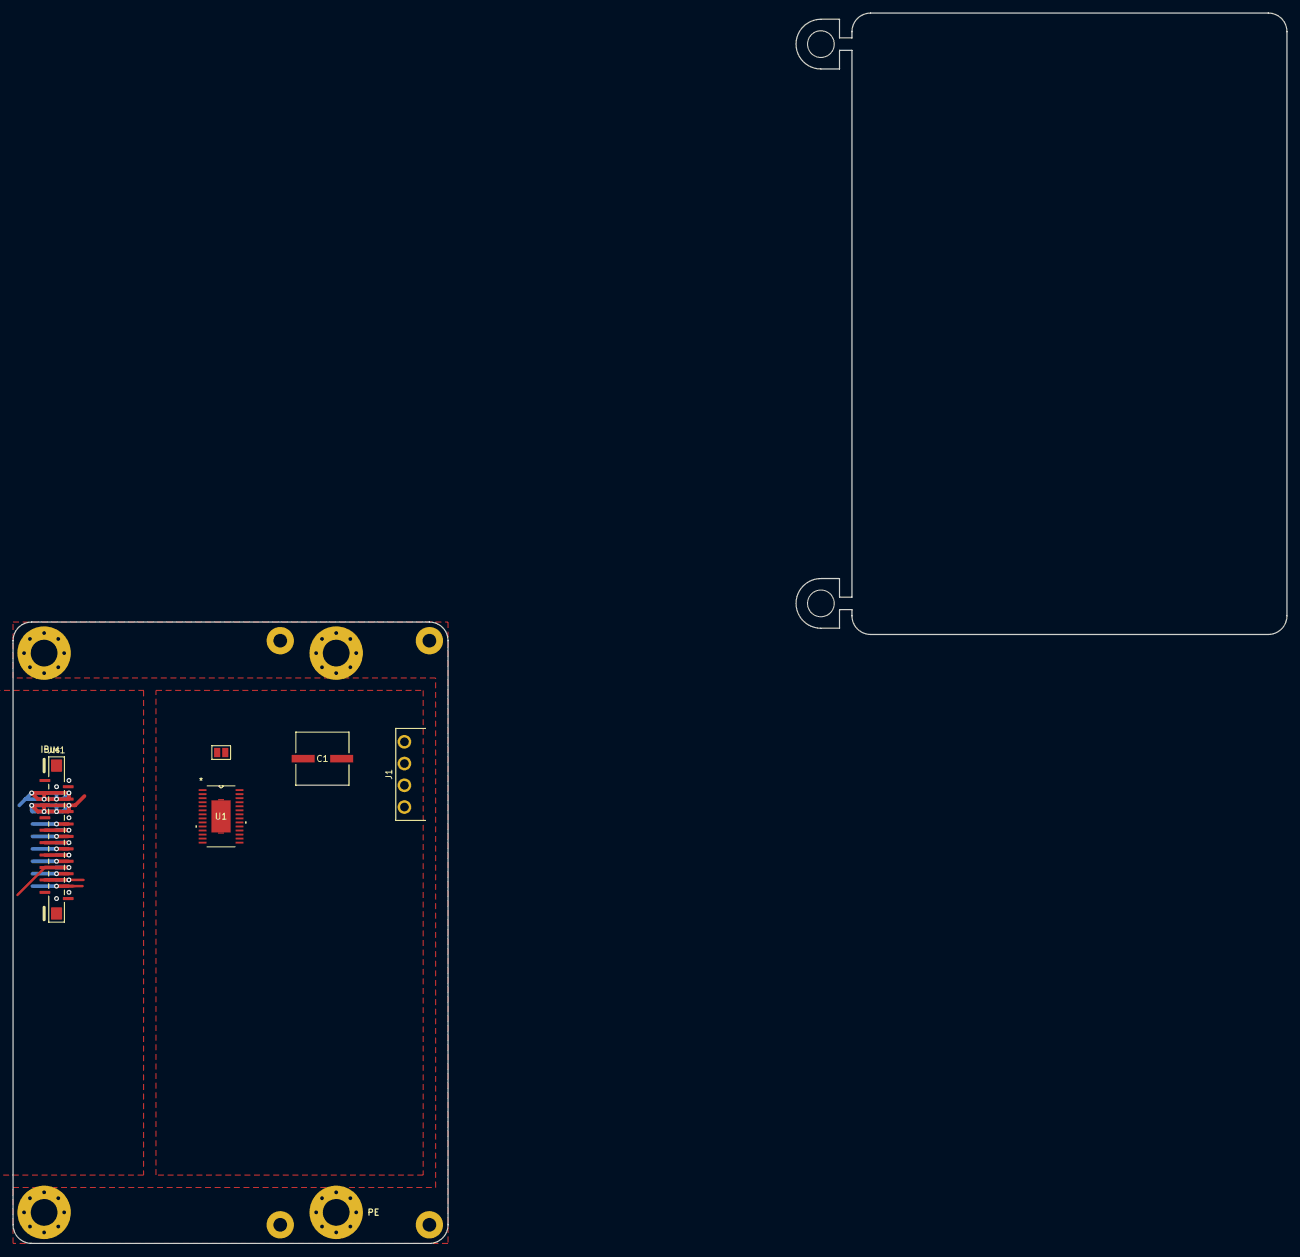
[picture p311: board PMDRV-STEPx4.kicad_pcb from above]

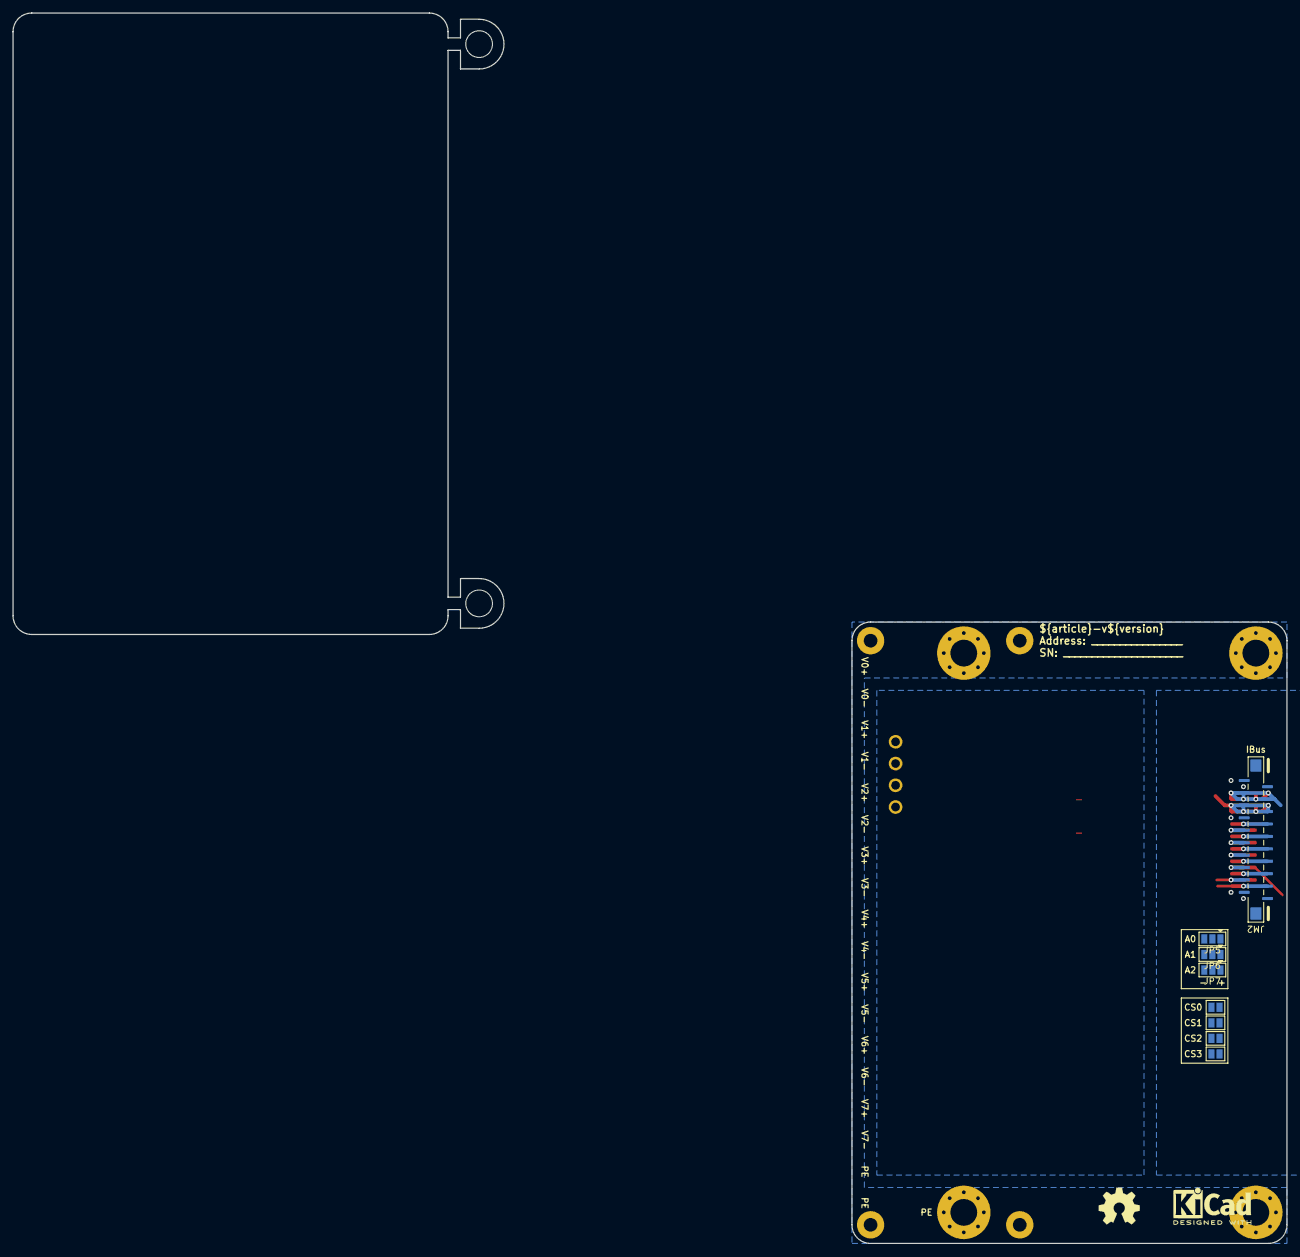
[picture p312: board PMDRV-STEPx4.kicad_pcb from below]

Board: 2 copper layers, 70.0 x 100.0 mm, 20 parts (10 on the bottom side), 15 nets.

Other parts of the board:
kicad_logo: KiCad-Logo2_5mm_SilkScreen
oshw_logo: OSHW-Symbol_6.7x6mm_SilkScreen
