Konstantin-Dudersky/plc-modules/pcb/PMCPU-ESP32C3-v0.1.0/PMCPU-ESP32C3.kicad_pcb

## KiCad design pcb/PMCPU-ESP32C3-v0.1.0/PMCPU-ESP32C3.kicad_pcb (2026-06-10)

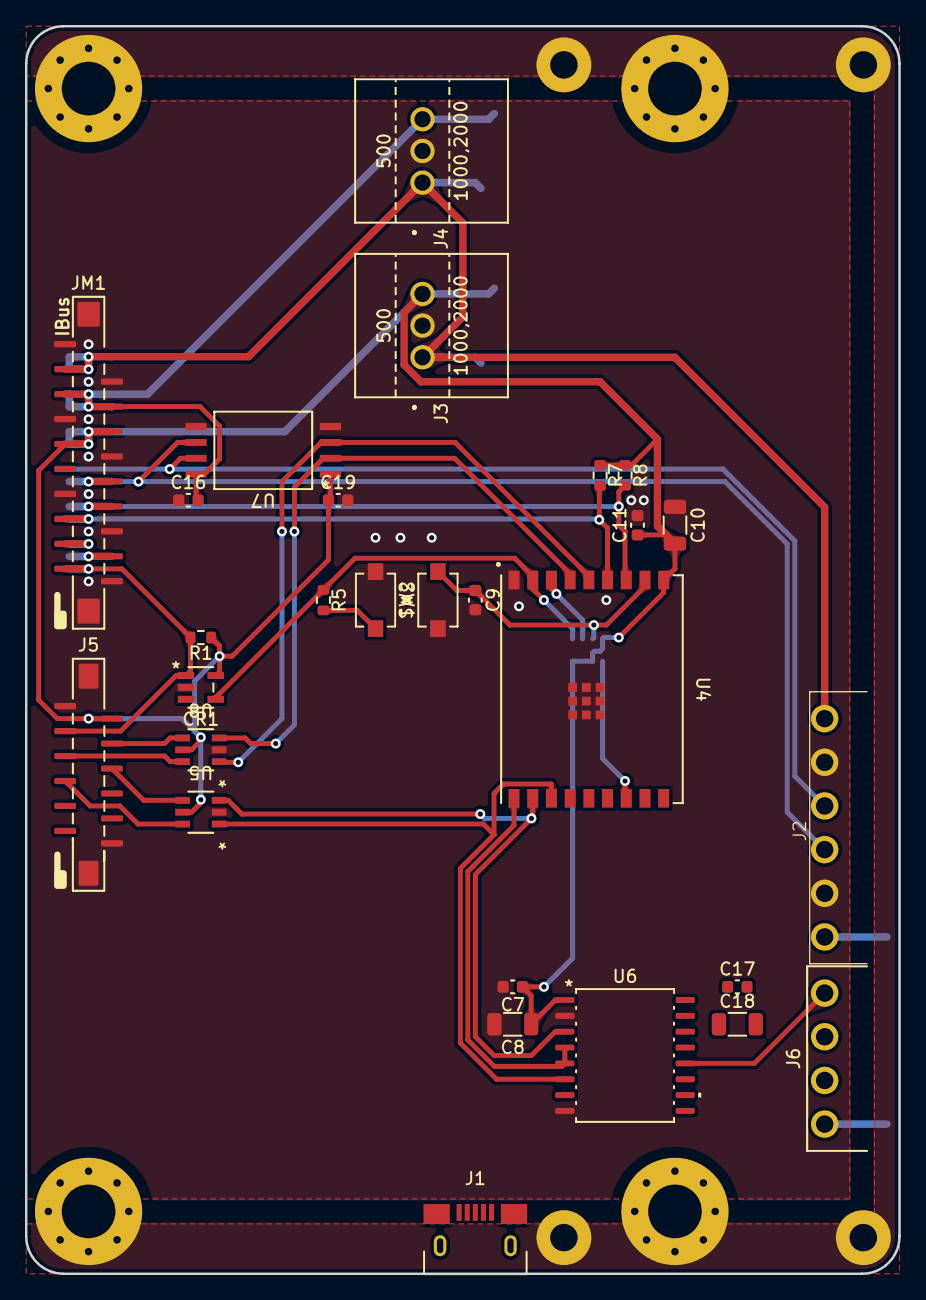
[picture p313: board PMCPU-ESP32C3.kicad_pcb from above]

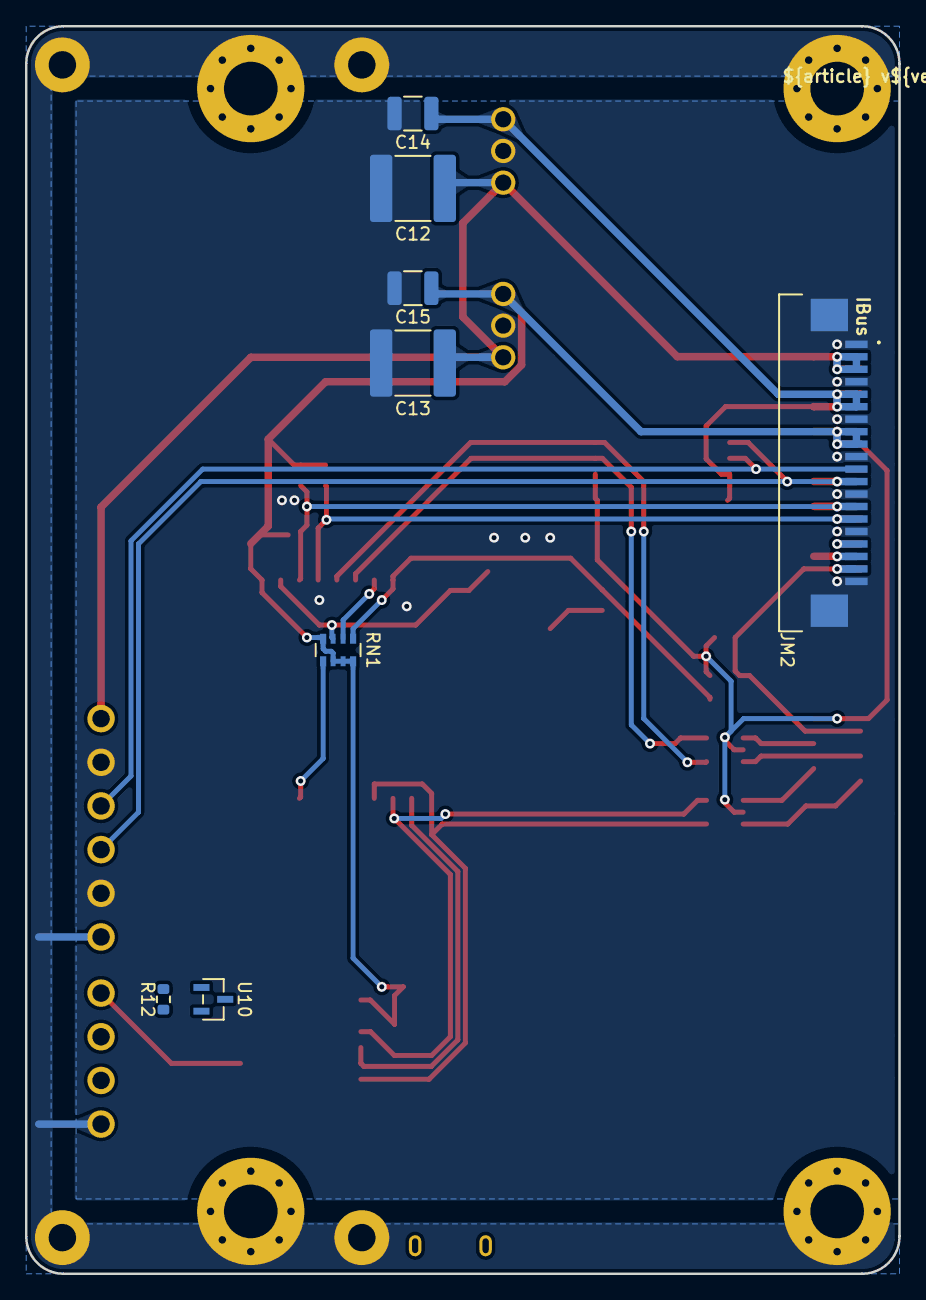
[picture p314: board PMCPU-ESP32C3.kicad_pcb from below]

Board: 2 copper layers, 70.0 x 100.0 mm, 43 parts (10 on the bottom side), 32 nets.

Parts:
C7, C16, C17, C19: 100nF; C_0603_1608Metric
C8, C10, C18: 10uF; C_1206_3216Metric
C9, C11: 1uF; C_0603_1608Metric
C12, C13: 22uF; C_2220_5750Metric
C14, C15: 22uF; C_1210_3225Metric
CR1: STWD100NYWY3F; SOT23-5L_STM
H1, H2, H3, H4: M4; MountingHole_4.3mm_M4_Pad_Via
J1: U254-051T-4BH83-S1S; CONN5_H83-S1S_XKB
J2: 15EDGRC-3.5-06P
J3: K7803-2000R3; K7805-2000R3
J4: K7805-2000R3
J5: AFA11-S12GLA-00
J6: 15EDGRC-3.5-04P
JM1: AFA07-S20FCC-00; AFA11-S20GLA-00
JM2: AFA07-S20FCC-00; AFA07S20FCA00
R1: 10k; R_0603_1608Metric
R5: 330R; R_0603_1608Metric
R7, R8: 3k3; R_0603_1608Metric
R12: 120R; R_0603_1608Metric
RN1: 10k; R_Array_Convex_4x0603
SP1: PMLED-xx-v0.0.3
SW1, SW2: Button; SW_TS-1088_XNP-M
U4: ESP32-C3-WROOM-02U-N4; ESP32-C3-WROOM-02U_EXP
U5, U8: SN74LVC2G14DBVR; DBV6-M
U6: CA-IS3098W; SOIC16-WBW_CLG
U7: CA-IS3050G; SOIC8_CA-IS305_CLG
U10: CDSOT23-SM712; SOT_SM712
kicad_logo: KiCad-Logo2_5mm_SilkScreen
oshw_logo: OSHW-Symbol_6.7x6mm_SilkScreen

Connections:
+3.3V_EXT_RS485: C17.1, C18.1, U6.16 (VISO)
/CAN_RX: U4.6 (IO7), U7.2 (RXD), U8.3 (2A)
/CAN_RX_LED: J5.4, U8.4 (2Y)
/CAN_TX: U4.5 (IO6), U7.3 (TXD), U8.1 (1A)
/CAN_TX_LED: J5.5, U8.6 (1Y)
/EN: C9.1, RN1.3 (R3.1), SW2.2, U4.2 (EN)
/IBUS_CAN_H: J2.4, JM1.11, JM2.11, U7.7 (CANH)
/IBUS_CAN_L: J2.3, JM1.12 (Pin_11), JM2.12 (Pin_11), U7.6 (CANL)
/IBUS_I2C_SCL: JM1.15 (Pin_11), JM2.15 (Pin_11), R7.2, U4.4 (IO5)
/IBUS_I2C_SDA: JM1.14 (Pin_11), JM2.14 (Pin_11), R8.2, U4.3 (IO4)
/IBUS_RST: CR1.1 (*WDO), J5.3, JM1.19 (Pin_11), JM2.19 (Pin_11), R1.2
/RS485-A: J6.4, R12.2, U6.12 (A), U10.1
/RS485-B: J6.3, R12.1, U6.13 (B), U10.2
/UART_RTS: U4.10 (IO10), U6.4 (RE), U6.5 (DE)
/UART_RX: U4.11 (RXD_(IO20)), U5.3 (2A), U6.3 (RO)
/UART_RX_LED: J5.6, U5.4 (2Y)
/UART_TX: U4.12 (TXD_(IO21)), U5.1 (1A), U6.6 (DI)
/UART_TX_LED: J5.7, U5.6 (1Y)
/USB_D+: J1.3 (D+), U4.14 (IO19_(USB_D+))
/USB_D-: J1.2 (D-), U4.13 (IO18_(USB_D-))
/WDT: CR1.4 (WDI), R5.1, RN1.1 (R1.1), U4.8 (IO9)
GND_EXT_RS485: C17.2, C18.2, J6.2, U6.9 (GNDB), U6.10 (SEL), U6.15 (GNDB), U10.3
IBUS_3V3: C7.1, C8.1, C10.2, C11.1, C15.1, C19.1, CR1.5 (VCC), J3.3 (+VO), J5.2, JM1.8, JM1.9, JM2.8, JM2.9, R1.1, R7.1, R8.1, RN1.4 (R4.1), RN1.6 (R3.2), RN1.7 (R2.2), RN1.8 (R1.2), U4.1 (3V3), U5.5 (VCC), U6.1 (VDD), U7.1 (VCC1), U8.5 (VCC)
IBUS_5V: C14.1, C16.2, J4.3 (+VO), JM1.5, JM1.6, JM2.5, JM2.6, U7.8 (VCC2)
IBUS_24V: C12.1, C13.1, J2.6, J3.1 (VIN), J4.1 (VIN), JM1.2, JM1.3, JM2.2, JM2.3
IBUS_CAN_GND: C7.2, C8.2, C9.2, C10.1, C11.2, C12.2, C13.2, C14.2, C15.2, C16.1, C19.2, CR1.2 (GND), J1.5 (GND), J2.2, J2.5, J3.2 (GND), J4.2 (GND), J5.1, J5.12 (Pin_11), J5.MP1 (Pin_11), J5.MP2 (Pin_11), JM1.1, JM1.4, JM1.7, JM1.10, JM1.13 (Pin_11), JM1.16 (Pin_11), JM1.20 (Pin_11), JM1.MP1 (Pin_11), JM1.MP2 (Pin_11), JM2.1, JM2.4, JM2.7, JM2.10, JM2.13 (Pin_11), JM2.16 (Pin_11), JM2.20 (Pin_11), JM2.MP1 (Pin_11), JM2.MP2 (Pin_11), SW1.1, SW2.1, U4.9 (GND), U4.EPAD, U5.2 (GND), U6.2 (GNDA), U6.8 (GNDA), U7.4 (GND1), U7.5 (GND2), U8.2 (GND)
unnamed: JM1.17 (Pin_11), JM2.17 (Pin_11)
unnamed: JM1.18 (Pin_11), JM2.18 (Pin_11)
unnamed: R5.2, SW1.2
unnamed: RN1.2 (R2.1), U4.7 (IO8)
unnamed: RN1.5 (R4.2), U4.16 (IO2)
PE: H1.1 (1_1), H2.1 (1_1), H3.1 (1_1), H4.1 (1_1), J2.1, J6.1, SP1.PE (PE_PE)
