Konstantin-Dudersky/plc-modules/pcb/PMCPU-LLP-v0.1.0/PMCPU-LLP.kicad_pcb

## KiCad design pcb/PMCPU-LLP-v0.1.0/PMCPU-LLP.kicad_pcb (2026-06-10)

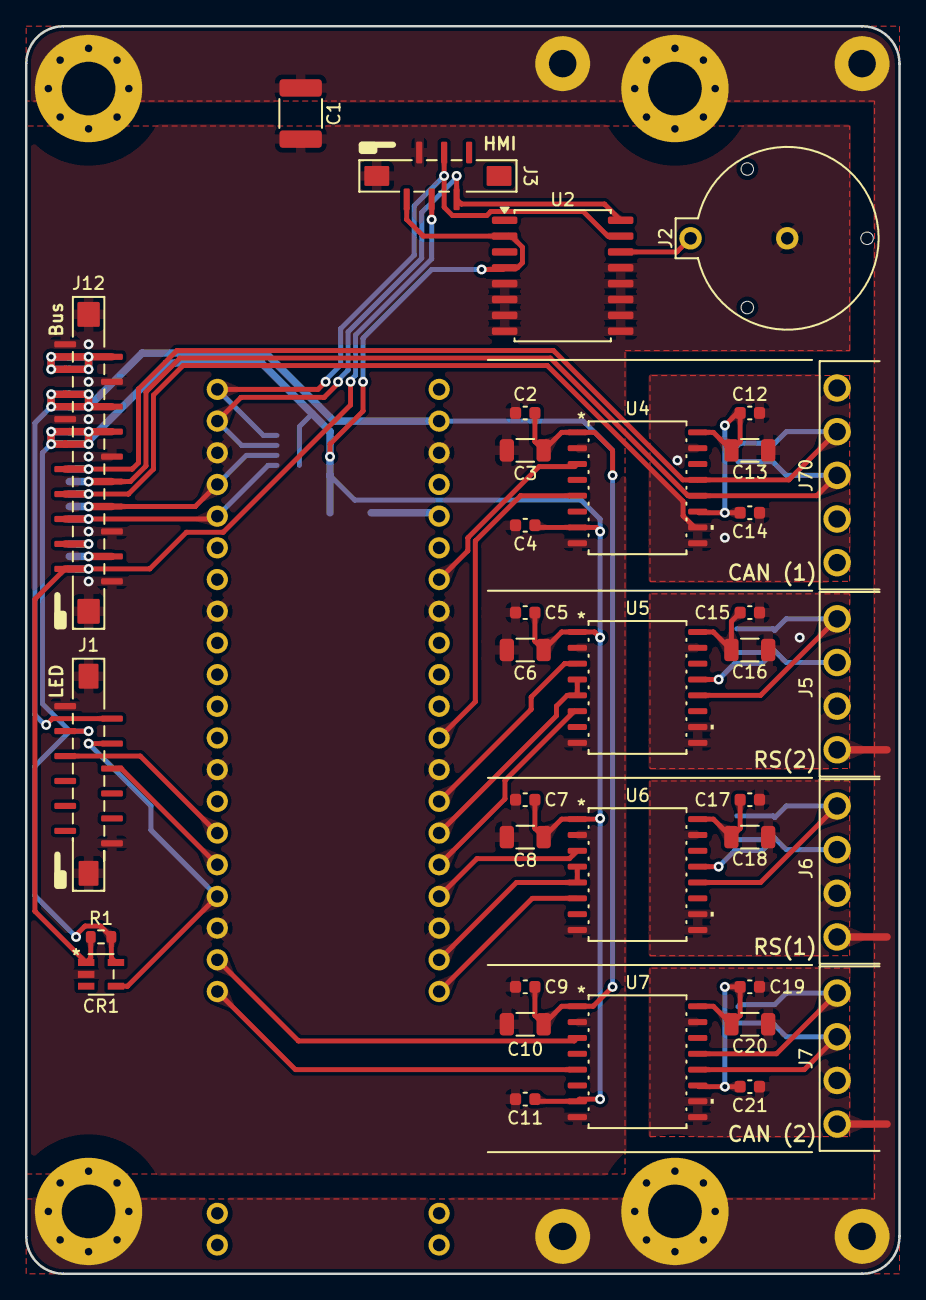
[picture p315: board PMCPU-LLP.kicad_pcb from above]

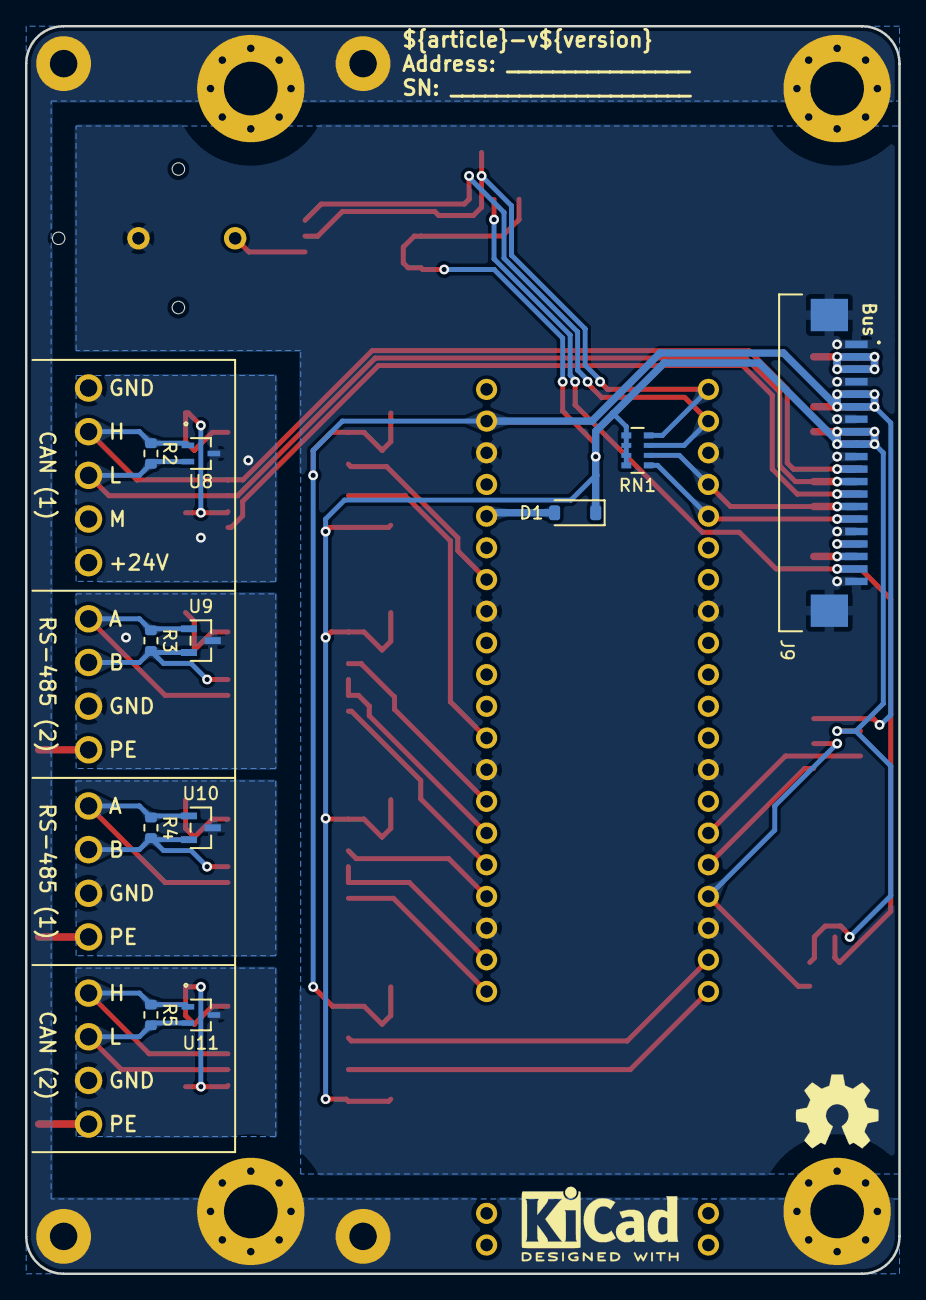
[picture p316: board PMCPU-LLP.kicad_pcb from below]

Board: 2 copper layers, 70.0 x 100.0 mm, 55 parts (13 on the bottom side), 43 nets.

Parts:
C1: 4.7nF 2kV; C_1812_4532Metric
C2, C5, C7, C9, C12, C15, C17, C19: 100nF; C_0603_1608Metric
C3, C6, C8, C10, C13, C16, C18, C20: 10uF; C_1206_3216Metric
C4, C11, C14, C21: 1uF; C_0603_1608Metric
CR1: STWD100NYWY3F; SOT23-5L_STM
D1: B5819W; D_SOD-123
H1, H2, H3, H4: M4; MountingHole_4.3mm_M4_Pad_Via
J1: AFA07-S10FCC-00; AFA11-S12GLA-00
J2: BS-12-A1AJ002-F
J3: AFA11-S06GLA-00
J5, J6, J7: 15EDGRC-3.5-04P
J9: AFA07-S20FCC-00; AFA07S20FCA00
J12: AFA11-S20GLA-00
J70: 15EDGRC-3.5-05P
R1: 10k; R_0603_1608Metric
R2, R3, R4, R5: 120R; R_0603_1608Metric
RN1: 3k3; R_Array_Convex_4x0603
SP1: PMLED-xx-v0.0.3
U2: DS3231; SOIC-16W_7.5x10.3mm_P1.27mm
U3: LuckfoxLyraPlus
U4, U7: CA-IS3062VW; SOIC16-WBW_CLG
U5, U6: CA-IS3098W; SOIC16-WBW_CLG
U8, U11: ESDCAN05-2BWY; SOT323-3L_STM
U9, U10: CDSOT23-SM712; SOT_SM712
kicad_logo0: KiCad-Logo2_5mm_SilkScreen
oshw_logo: OSHW-Symbol_6.7x6mm_SilkScreen

Connections:
+3.3V_CPU: C4.1, C5.1, C6.1, C7.1, C8.1, C11.1, CR1.5 (VCC), D1.1 (K), J1.3, J3.6, J9.8, J9.9, J12.8, J12.9, R1.1, RN1.5 (R4.2), RN1.6 (R3.2), RN1.7 (R2.2), RN1.8 (R1.2), U2.2 (VCC), U2.4 (~RST), U4.7 (Vccl), U5.1 (VDD), U6.1 (VDD), U7.7 (Vccl)
+3.3V_EXT_RS485_1: C17.1, C18.1, U6.16 (VISO)
+3.3V_EXT_RS485_2: C15.1, C16.1, U5.16 (VISO)
+5V_CPU: C2.1, C3.1, C9.1, C10.1, J1.2, J9.5, J9.6, J12.5, J12.6, U3.39 (VSYS), U4.1 (Vcc), U7.1 (Vcc)
+5V_EB: C19.1, C20.1, C21.1, U7.11 (Visoin), U7.16 (Viso)
+24V_CPU: J9.2, J9.3, J12.2, J12.3
/CAN0_RXD: U3.20 (RM_IO2), U7.5 (RXD)
/CAN0_TXD: U3.19 (RM_IO3), U7.3 (TXD)
/CAN1_RXD: U3.29 (RM_IO25), U4.5 (RXD)
/CAN1_TXD: U3.34 (RM_IO24), U4.3 (TXD)
/CANH_EB: J7.4, R5.1, U7.13 (CANH), U11.1
/CANL_EB: J7.3, R5.2, U7.12 (CANL), U11.2
/I2C1_SCL: J3.2, RN1.3 (R3.1), U2.16 (SCL), U3.2 (RM_IO23)
/I2C1_SDA: J3.3, RN1.4 (R4.1), U2.15 (SDA), U3.1 (RM_IO22)
/IBUS_CAN_GND: C12.2, C13.2, C14.2, J9.13 (Pin_11), J12.13 (Pin_11), J70.5, U4.9 (GND2), U4.10 (GND2), U4.15 (GND2), U8.3
/IBUS_CAN_H: J9.11, J12.11, J70.4, R2.1, U4.13 (CANH), U8.1
/IBUS_CAN_L: J9.12 (Pin_11), J12.12 (Pin_11), J70.3, R2.2, U4.12 (CANL), U8.2
/IBUS_I2C_SCL: J9.15 (Pin_11), J12.15 (Pin_11), RN1.1 (R1.1), U3.5 (RM_IO13)
/IBUS_I2C_SDA: J9.14 (Pin_11), J12.14 (Pin_11), RN1.2 (R2.1), U3.4 (RM_IO12)
/IBUS_RST: CR1.1 (*WDO), J3.4, J9.19 (Pin_11), J12.19 (Pin_11), R1.2
/LED_0: J1.5, U3.15 (RM_IO6)
/LED_1: J1.6, U3.16 (RM_IO5)
/RS485_1-A: J6.4, R4.2, U6.12 (A), U10.1
/RS485_1-B: J6.3, R4.1, U6.13 (B), U10.2
/RS485_2-A: J5.4, R3.2, U5.12 (A), U9.1
/RS485_2-B: J5.3, R3.1, U5.13 (B), U9.2
/UART1_RTS: U3.22 (RM_IO30), U6.4 (RE), U6.5 (DE)
/UART1_RX: U3.24 (RM_IO29), U6.3 (RO)
/UART1_TX: U3.21 (RM_IO31), U6.6 (DI)
/UART2_RTS: U3.26 (RM_IO27), U5.4 (RE), U5.5 (DE)
/UART2_RX: U3.27 (RM_IO26), U5.3 (RO)
/UART2_TX: U3.25 (RM_IO28), U5.6 (DI)
/Vbat: J2.1, U2.14 (VBAT)
/WDT: CR1.4 (WDI), J1.4, U3.17 (RM_IO4)
GND_CPU: C1.2, C2.2, C3.2, C4.2, C5.2, C6.2, C7.2, C8.2, C9.2, C10.2, C11.2, CR1.2 (GND), J1.1, J1.12 (Pin_11), J1.MP1 (Pin_11), J1.MP2 (Pin_11), J2.2, J3.5, J3.MP2 (Pin_11), J9.1, J9.4, J9.7, J9.10, J9.16 (Pin_11), J9.20 (Pin_11), J9.MP1 (Pin_11), J9.MP2 (Pin_11), J12.1, J12.4, J12.7, J12.10, J12.16 (Pin_11), J12.20 (Pin_11), J12.MP1 (Pin_11), J12.MP2 (Pin_11), U2.5 (GND), U2.6 (GND), U2.7 (GND), U2.8 (GND), U2.9 (GND), U2.10 (GND), U2.11 (GND), U2.12 (GND), U2.13 (GND), U3.3 (GND), U3.8 (GND), U3.13 (GND), U3.18 (GND), U3.23 (GND), U3.28 (GND), U3.33 (GND), U3.38 (GND), U4.2 (GND1), U4.8 (GND1), U5.2 (GNDA), U5.8 (GNDA), U6.2 (GNDA), U6.8 (GNDA), U7.2 (GND1), U7.8 (GND1)
GND_EB: C19.2, C20.2, C21.2, J7.2, U7.9 (GND2), U7.10 (GND2), U7.15 (GND2), U11.3
GND_EXT_RS485_1: C17.2, C18.2, J6.2, U6.9 (GNDB), U6.10 (SEL), U6.15 (GNDB), U10.3
GND_EXT_RS485_2: C15.2, C16.2, J5.2, U5.9 (GNDB), U5.10 (SEL), U5.15 (GNDB), U9.3
unnamed: D1.2 (A), U3.36 (3V3_OUT)
unnamed: J9.17 (Pin_11), J12.17 (Pin_11)
unnamed: J9.18 (Pin_11), J12.18 (Pin_11)
unnamed: C12.1, C13.1, C14.1, U4.11 (Visoin), U4.16 (Viso)
PE: C1.1, H1.1 (1_1), H2.1 (1_1), H3.1 (1_1), H4.1 (1_1), J5.1, J6.1, J7.1, SP1.PE (PE_PE)
