Konstantin-Dudersky/plc-modules/pcb/PMCPU-RP-v0.0.6/PMCPU-RP.kicad_pcb

## KiCad design pcb/PMCPU-RP-v0.0.6/PMCPU-RP.kicad_pcb (2025-05-14)

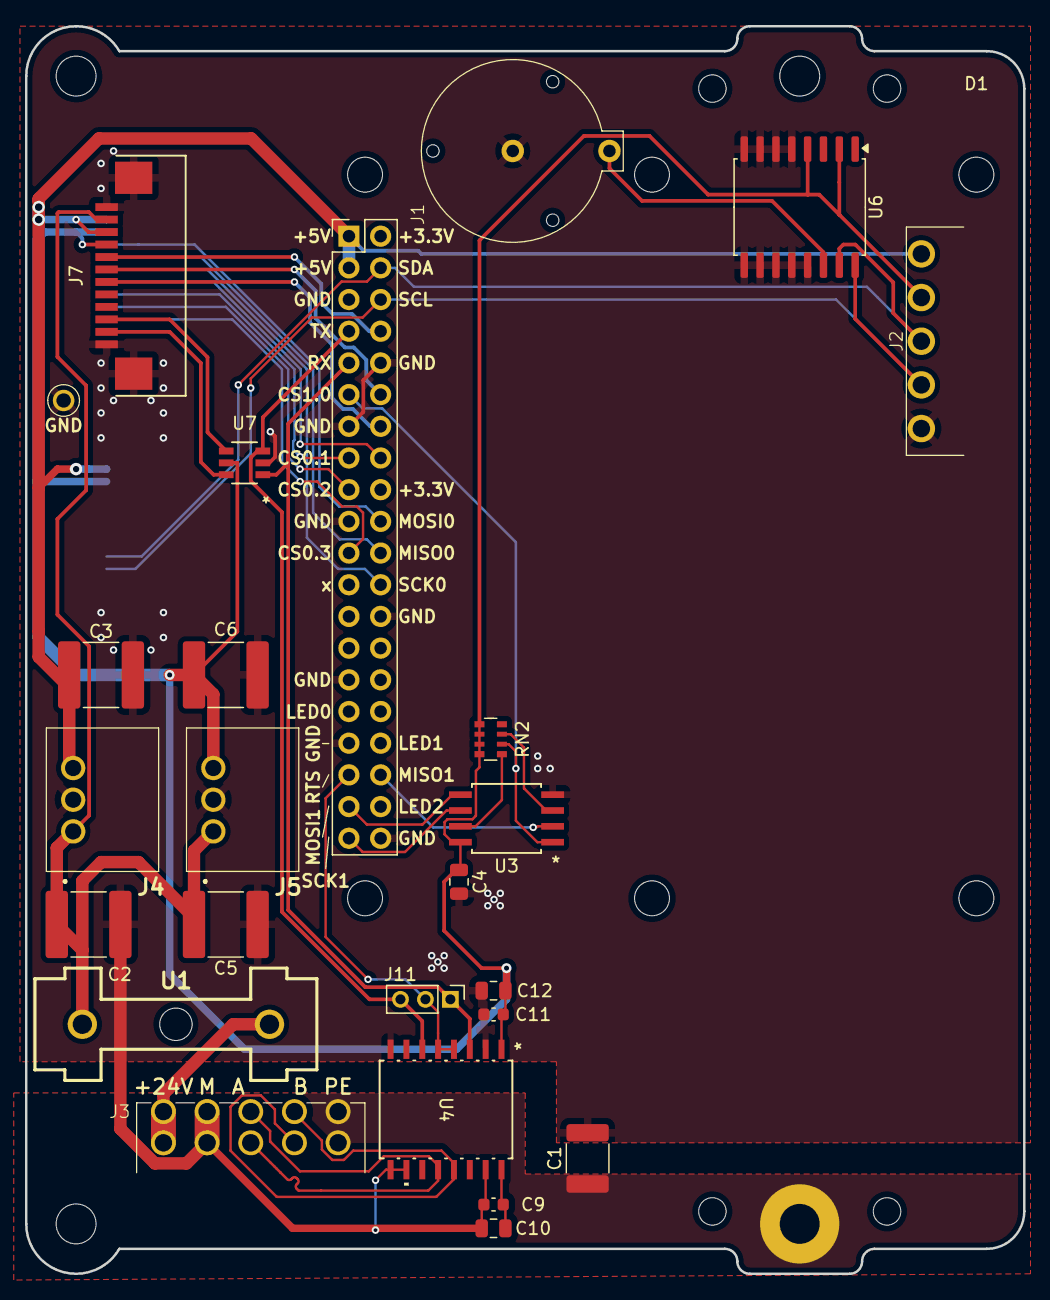
[picture p317: board PMCPU-RP.kicad_pcb from above]

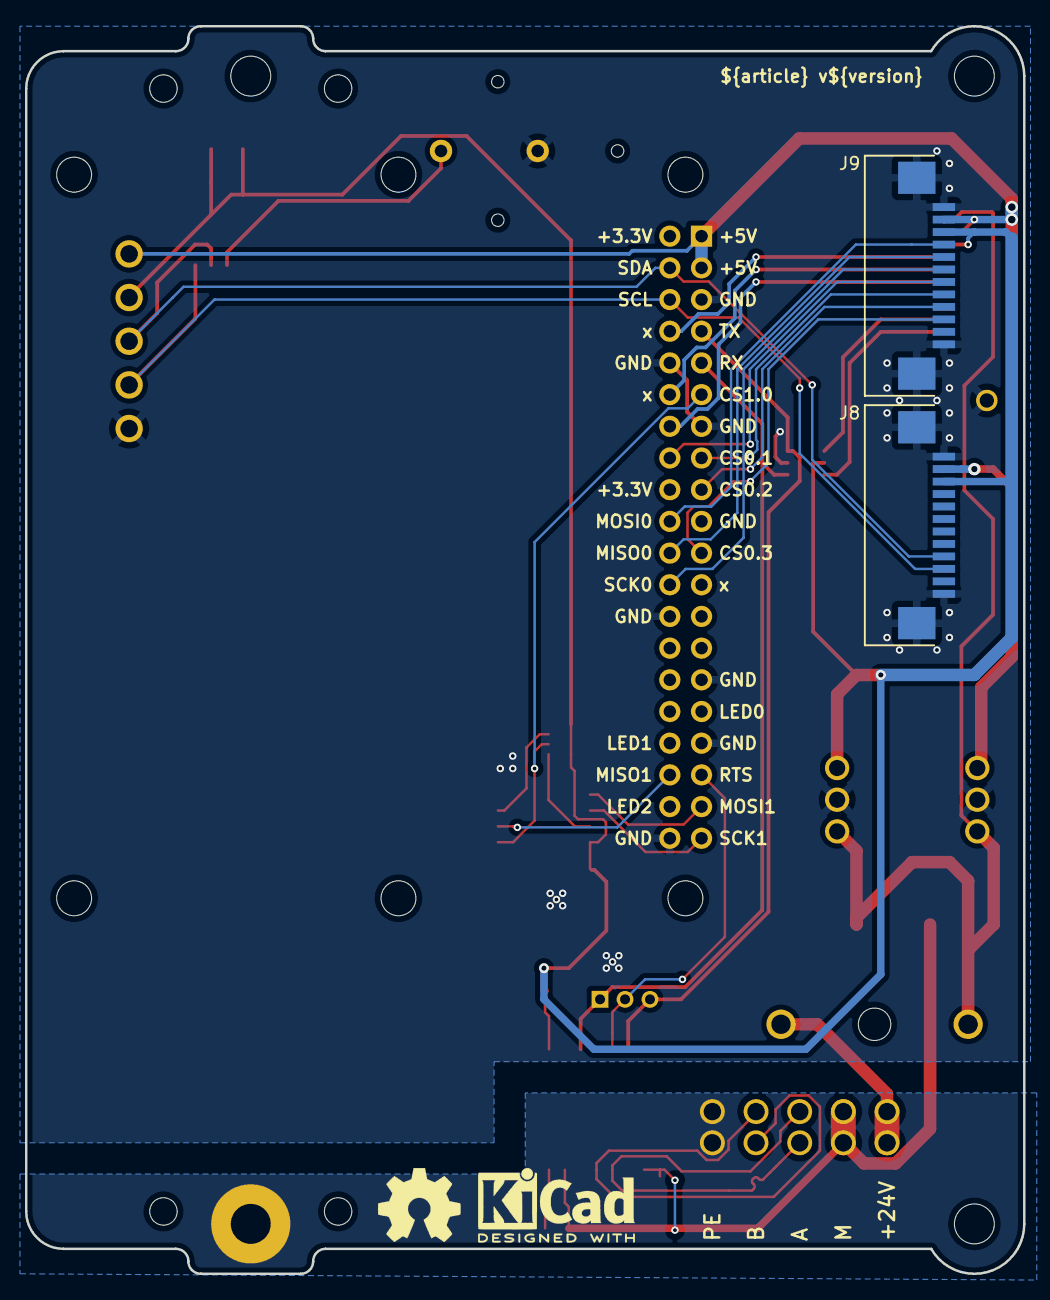
[picture p318: board PMCPU-RP.kicad_pcb from below]

Board: 2 copper layers, 80.0 x 100.0 mm, 34 parts (4 on the bottom side), 33 nets.

Parts:
C1: 4.7nF 2kV; C_1812_4532Metric
C2, C3, C5, C6: 22uF; C_2220_5750Metric
C4, C10, C12: 10uF; C_0805_2012Metric
C9, C11: 100nF; C_0603_1608Metric
D1: RaspberryPi
H1, H2, H3: MountingHole_M3
J1: BS-12-A1AJ002-F
J2: 15EDGRC-3.5-05P
J3: 15EDGRHC-THR-3.5-10P
J4: K7805-2000R3
J5: K7803-2000R3; K7805-2000R3
J7, J8, J9: AFA07-S10FCC-00; CONN10_AFA07-S12_JUS
J11: PinHeader_01x03_P2.00_THT_straight; PinHeader_1x03_P2.00mm_Vertical
PE1: PE
RN2: 10k; R_Array_Convex_4x0603
SP1: PM_LED-xx-v0.0.1
U1: 64900001039; 649-Series-Holder
U2: 5117
U3: W25Q32JVSSIQ; SOIC-8_5P28X5P28_WIN-M
U4: CA-IS3098W; SOIC16-WBW_CLG
U6: DS3231; SOIC-16W_7.5x10.3mm_P1.27mm
U7: SN74LVC2G14DBVR; DBV6-M
kicad_logo: KiCad-Logo2_5mm_SilkScreen
oshw_logo: OSHW-Symbol_6.7x6mm_SilkScreen

Connections:
+3.3V_BUS: C9.1, C10.1, U4.16 (VISO)
+3.3V_CPU: C4.1, C6.1, C11.1, C12.1, J2.4, J5.3 (+VO), J7.9, J8.3, J9.3, RN2.5 (R4.2), RN2.6 (R3.2), RN2.7 (R2.2), RN2.8 (R1.2), U3.8 (VCC), U4.1 (VDD), U6.2 (VCC), U6.4 (~RST), U7.5 (VCC)
+5V_CPU: C3.1, D1.2 (5V), D1.4 (5V), J2.5, J4.3 (+VO), J7.10, J8.2, J9.2
+24V_BUS: J3.1, J3.6 (Pin_2), U1.1
+24V_fuse: C2.1, C5.1, J4.1 (VIN), J5.1 (VIN), J7.11, U1.2
/A: J3.3, J3.8 (Pin_6), U4.12 (A)
/B: J3.4, J3.9 (Pin_8), U4.13 (B)
/LED_0: D1.7 (GPIO4/GPCLK0), J7.8
/LED_1: D1.11 (GPIO17), J7.7
/LED_2: D1.13 (GPIO27), J7.6
/SCL: D1.5 (GPIO3/I2C_SCL), J2.2, J8.10, U6.16 (SCL)
/SDA: D1.3 (GPIO2/I2C_SDA), J2.3, J8.9, U6.15 (SDA)
/SPI0_CS0: D1.15 (GPIO22), J9.7
/SPI0_CS1: D1.16 (GPIO23), J9.8
/SPI0_CS2: D1.18 (GPIO24), J9.9
/SPI0_CS3: D1.22 (GPIO25), J9.10
/SPI0_MISO: D1.21 (GPIO9/SPI_MISO), J9.5
/SPI0_MOSI: D1.19 (GPIO10/SPI_MOSI), J9.4
/SPI0_SCK: D1.23 (GPIO11/SPI_SCLK), J9.6
/SPI1_CS0: D1.12 (GPIO18/PCM_CLK), RN2.2 (R2.1), U3.1 (/CS)
/SPI1_MISO: D1.35 (GPIO19/PCM_FS), U3.2 (DO(IO1))
/SPI1_MOSI: D1.38 (GPIO20/PCM_DIN), U3.5 (DI(IO0))
/SPI1_SCK: D1.40 (GPIO20/PCM_DOUT), U3.6 (CLK)
/UART_RTS: D1.36 (GPIO16), J11.2, U4.4 (RE), U4.5 (DE)
/UART_RX: D1.10 (GPIO15/UART_RX), J11.1, U4.3 (RO), U7.1 (1A)
/UART_RX_LED: J7.2, U7.6 (1Y)
/UART_TX: D1.8 (GPIO14/UART_TX), J11.3, U4.6 (DI), U7.3 (2A)
/UART_TX_LED: J7.3, U7.4 (2Y)
/Vbat: J1.1, U6.14 (VBAT)
GND_BUS: C1.2, C2.2, C3.2, C4.2, C5.2, C6.2, C9.2, C10.2, C11.2, C12.2, D1.6 (GND), D1.9 (GND), D1.14 (GND), D1.20 (GND), D1.25 (GND), D1.30 (GND), D1.34 (GND), D1.39 (GND), J1.2, J2.1, J3.2 (Pin_3), J3.7 (Pin_4), J4.2 (GND), J5.2 (GND), J7.1, J7.12 (Pin_11), J7.13 (Pin_11), J8.1, J8.12 (Pin_11), J8.13 (Pin_11), J9.1, J9.12 (Pin_11), J9.13 (Pin_11), U2.1, U3.4 (GND), U4.2 (GNDA), U4.8 (GNDA), U4.9 (GNDB), U4.10 (SEL), U4.15 (GNDB), U6.5 (GND), U6.6 (GND), U6.7 (GND), U6.8 (GND), U6.9 (GND), U6.10 (GND), U6.11 (GND), U6.12 (GND), U6.13 (GND), U7.2 (GND)
unnamed: RN2.1 (R1.1), U3.7 (/HOLD_(IO3))
unnamed: RN2.3 (R3.1), U3.3 (/WP(IO2))
PE: C1.1, J3.5 (Pin_9), J3.10, PE1.1
