Konstantin-Dudersky/plc-modules/PM-PS_v0.0.2/PM-PS.kicad_pcb

## KiCad design PM-PS_v0.0.2/PM-PS.kicad_pcb (2024-10-31)

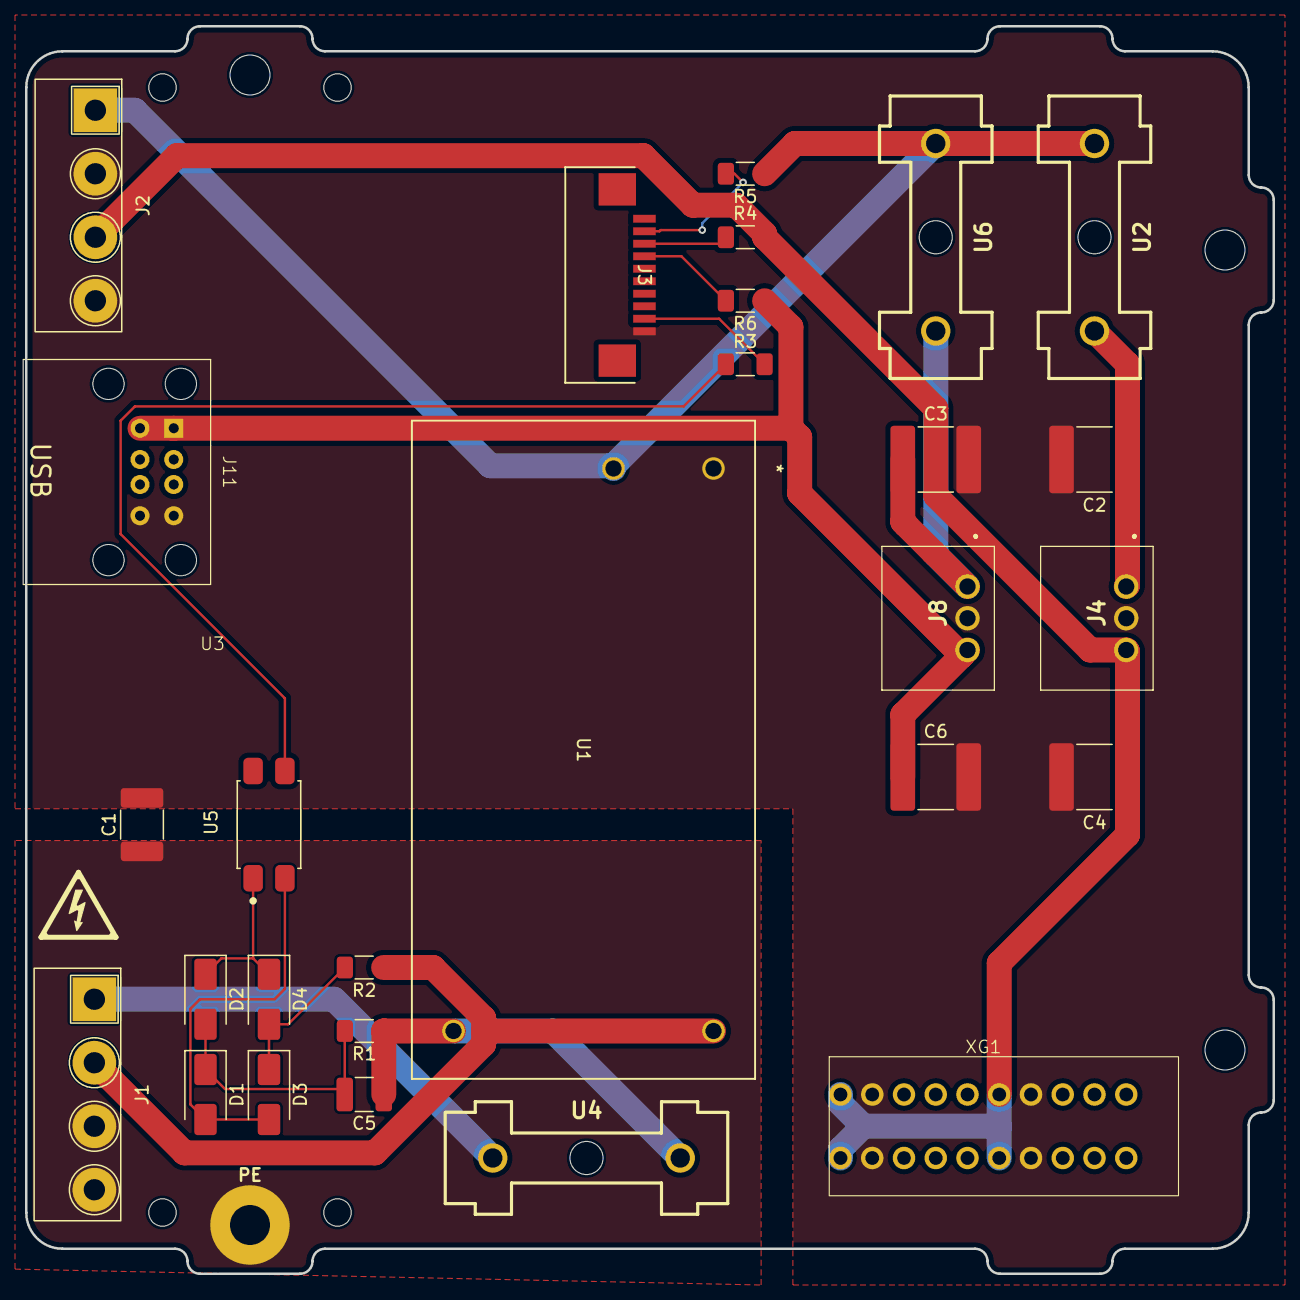
[picture p319: board PM-PS.kicad_pcb from above]

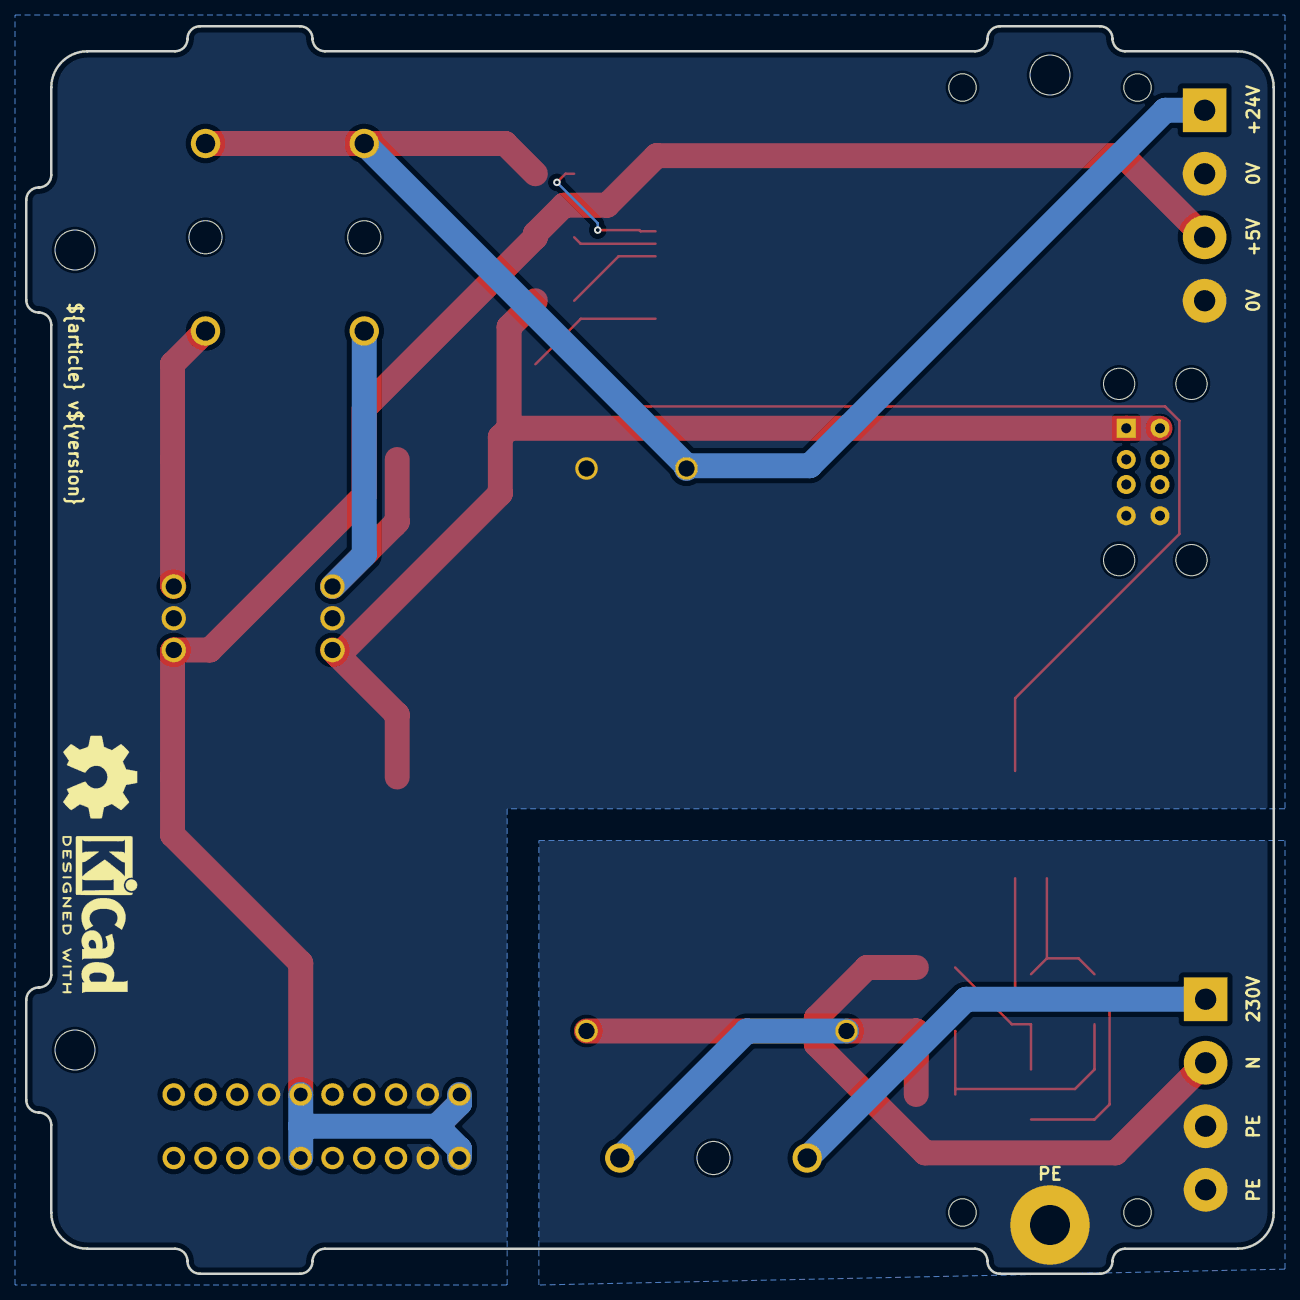
[picture p320: board PM-PS.kicad_pcb from below]

Board: 2 copper layers, 99.8 x 99.8 mm, 35 parts (2 on the bottom side), 19 nets.

Parts:
C1: 4.7nF 2kV; C_1812_4532Metric_Pad1.57x3.40mm_HandSolder
C2, C3, C4, C6: 22uF; C_2220_5750Metric_Pad1.97x5.40mm_HandSolder
C5: 150nF 630V; C_1210_3225Metric_Pad1.33x2.70mm_HandSolder
D1, D2, D3, D4: 1N4007; D_SMA
H1, H2, H3: MountingHole; MountingHole_3.2mm_M3
J1, J2: 2EDGR-5.08-04P; Degson_2EDGR-5.08-04P
J3: AFA07-S10FCC-00; CONN10_AFA07-S10_JUS
J4, J8: K7805-2000R3
J11: XKB_U224-08XN-1WR61
PE1: PE
R1: 680k; R_1206_3216Metric_Pad1.30x1.75mm_HandSolder
R2: 100; R_1206_3216Metric_Pad1.30x1.75mm_HandSolder
R3, R4, R6: 330R; R_1206_3216Metric_Pad1.30x1.75mm_HandSolder
R5: 4k7; R_1206_3216Metric_Pad1.30x1.75mm_HandSolder
U1: IRM-20-24; IRM-20-24_MWU
U2, U4, U6: 64900001039; Fuseholder
U3: PM-LED8_v0.0.1; PM-LED_v0.0.1
U5: PC817; PC817XI_SOIC254P975X460-4N
XG1: DG141R-2.54-10P
kicad_logo: KiCad-Logo2_5mm_SilkScreen
oshw_logo: OSHW-Symbol_6.7x6mm_SilkScreen

Connections:
230V: C5.1, R1.1, U1.3 (AC/L), U4.2
+5V: C4.1, J2.3, J4.3 (+VO), R4.1, XG1.1, XG1.6
+5V_USB: C6.1, J8.3 (+VO), J11.1 (5V), J11.5 (5V), R6.1
+24V: J2.1, R5.1, U1.2 (V+), U2.1, U6.1
/230V_LED: R3.1, U5.3
/subplates/230V_LED: J3.9, R3.2
/subplates/+5V_BUS: J3.3, R4.2
/subplates/+5V_USB: J3.4, R6.2
/subplates/+24V_LED: J3.2, R5.2
GND: C1.2, C2.2, C3.2, C4.2, C6.2, J2.2, J2.4, J3.10, J4.2 (GND), J8.2 (GND), J11.4 (GND), J11.8 (GND), U1.1 (V-), XG1.2, XG1.7
N: J1.2, R2.1, U1.4 (AC/N)
unnamed: D1.2 (A), D3.2 (A), U5.2
unnamed: C5.2, D1.1 (K), D2.2 (A), R1.2
unnamed: D2.1 (K), D4.1 (K), U5.1
unnamed: D3.1 (K), D4.2 (A), R2.2
unnamed: J1.1, U4.1
unnamed: C2.1, J4.1 (VIN), U2.2
unnamed: C3.1, J8.1 (VIN), U6.2
PE: C1.1, J1.3, J1.4, PE1.1
