Konstantin-Dudersky/plc-modules/PM-RQ8_v0.0.4/PM-RQ8.kicad_pcb

## KiCad design PM-RQ8_v0.0.4/PM-RQ8.kicad_pcb (2024-10-28)

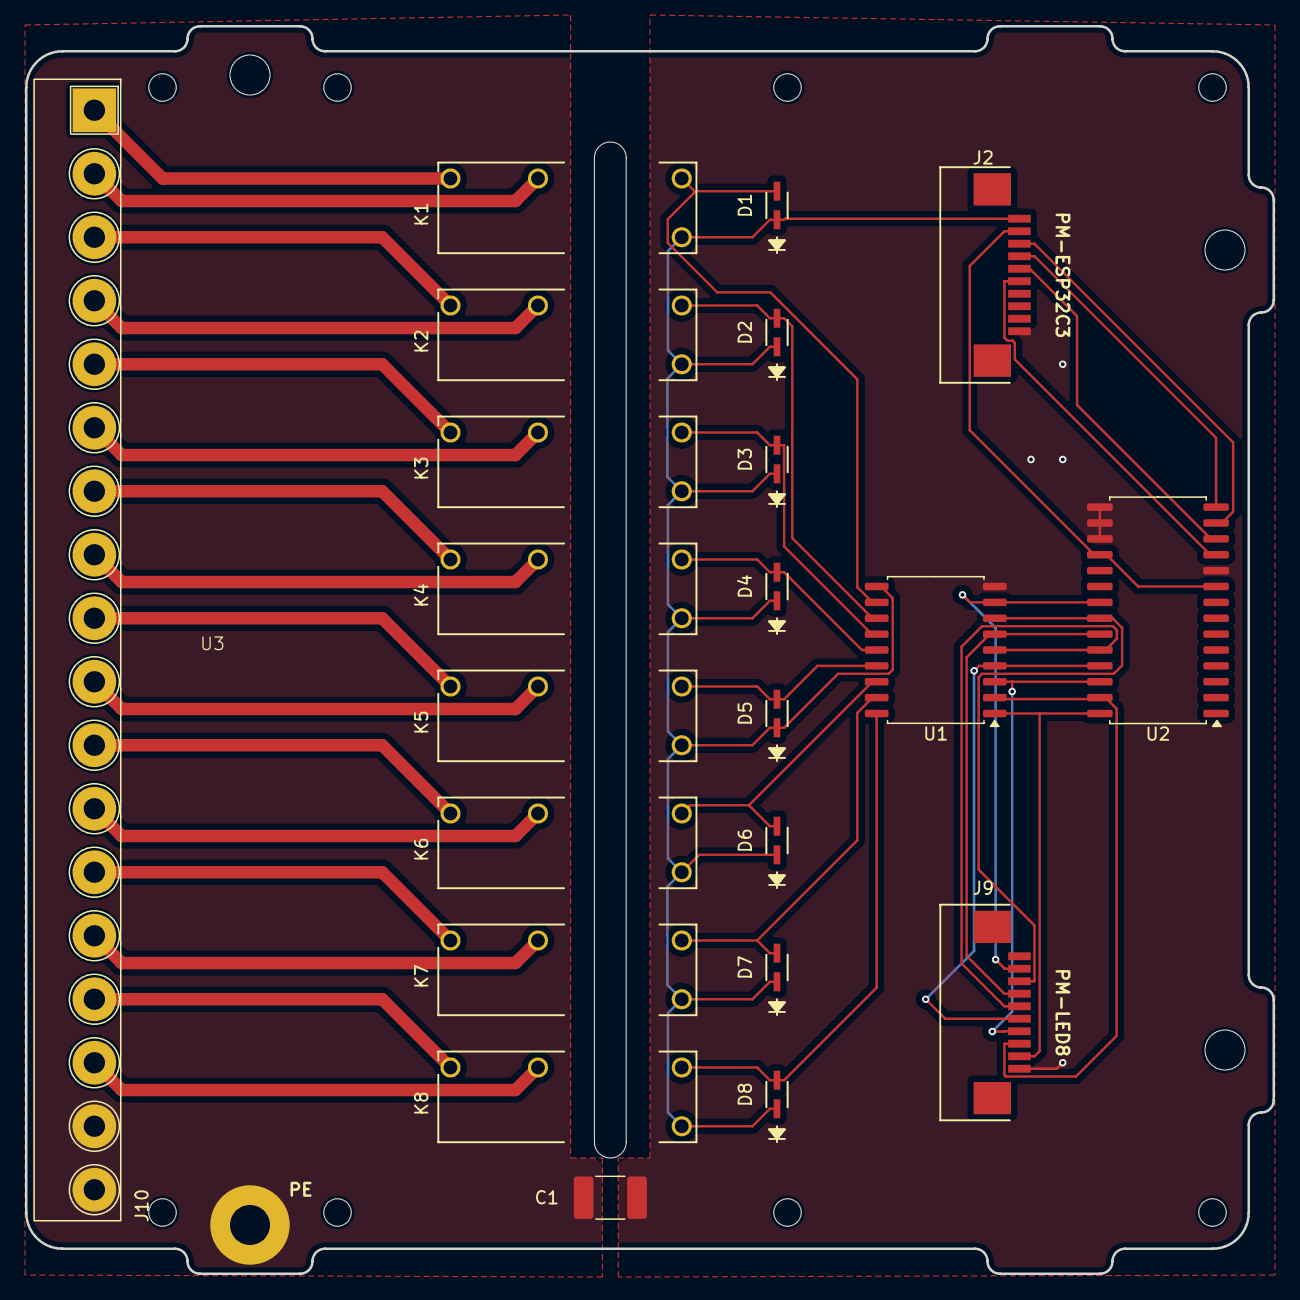
[picture p321: board PM-RQ8.kicad_pcb from above]

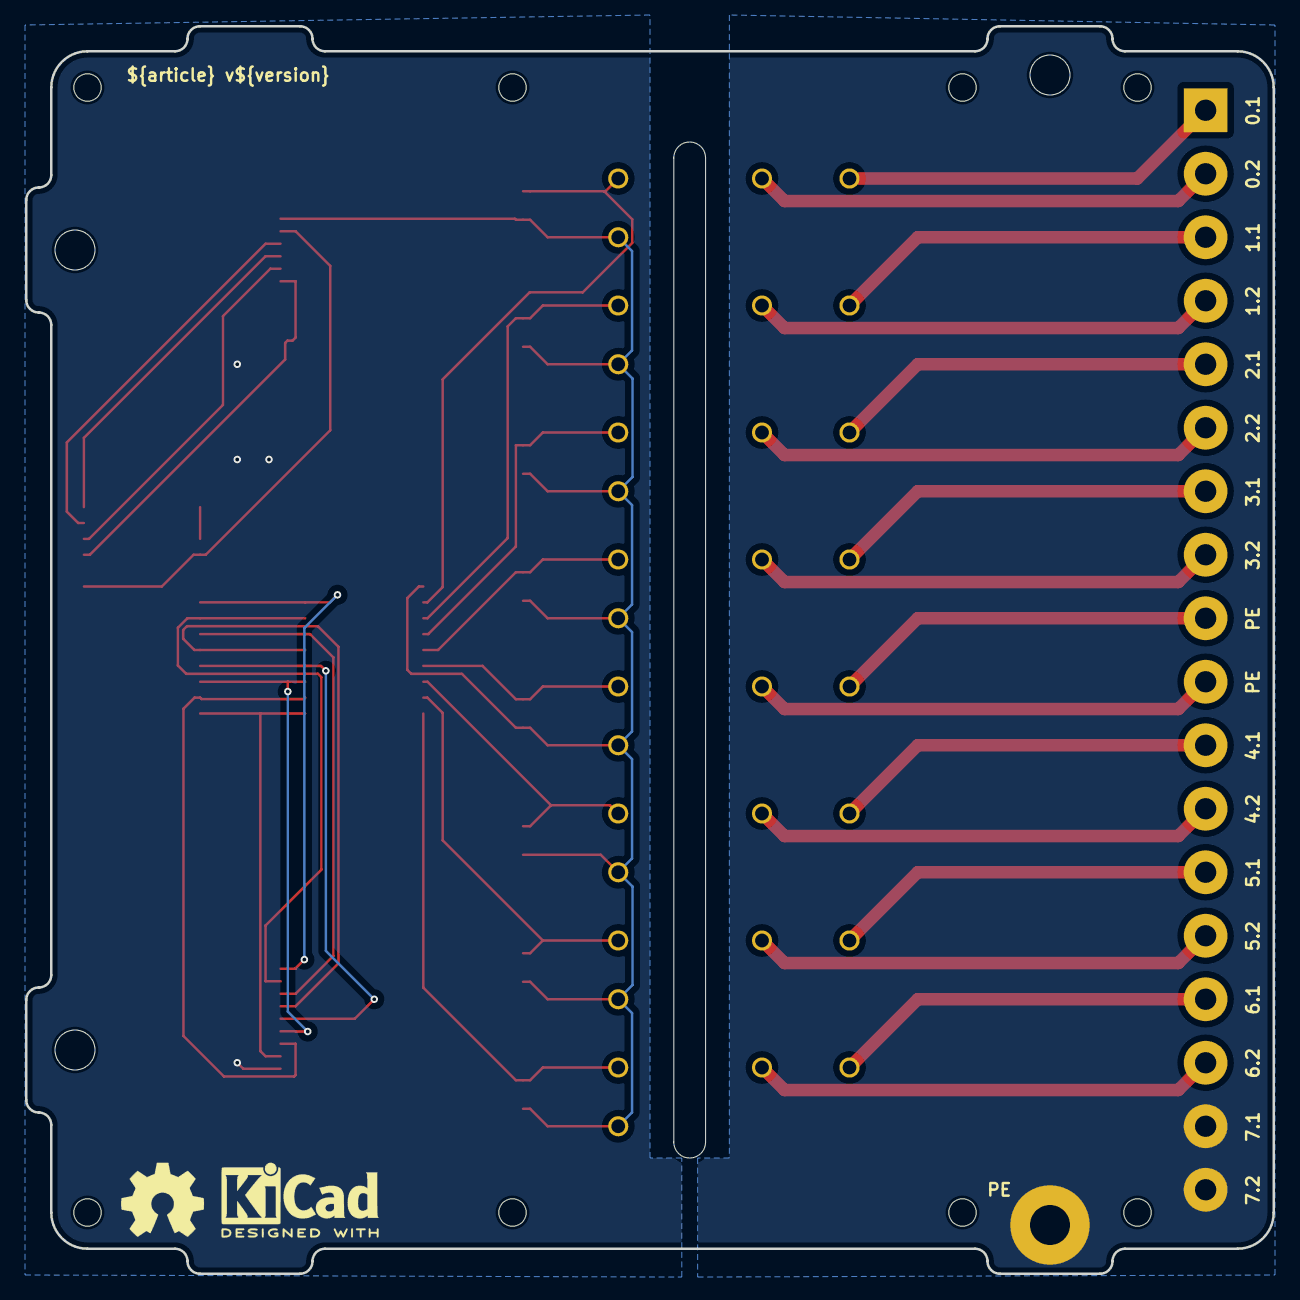
[picture p322: board PM-RQ8.kicad_pcb from below]

Board: 2 copper layers, 99.8 x 99.8 mm, 30 parts (2 on the bottom side), 40 nets.

Parts:
C1: 4.7nF 2kV; C_1812_4532Metric_Pad1.57x3.40mm_HandSolder
D1, D2, D3, D4, D5, D6, D7, D8: BAT20J; SOD-323_STM-M
H1, H2, H3: MountingHole; MountingHole_3.2mm_M3
J2, J9: AFA07-S10FCC-00; CONN10_AFA07-S10_JUS
J10: 2EDGR-5.08-18P; Degson_2EDGR-5.08-18P
K1, K2, K3, K4, K5, K6, K7, K8: G5NB-1A-E-DC5; G5NB-1A-E_DC12_RELAY_G5NB-1A_DC5_OMR
PE1: PE
U1: ULN2803A
U2: MCP23S17_SO; SOIC-28W_7.5x17.9mm_P1.27mm
U3: PM-LED8_v0.0.1; PM-LED_v0.0.1
U5: PM-ESP32C3_v0.0.2
kicad_logo: KiCad-Logo2_5mm_SilkScreen
oshw_logo: OSHW-Symbol_6.7x6mm_SilkScreen

Connections:
+3.3V: J2.2, U2.9 (VDD), U2.18 (~RESET)
+5V: D1.1, D2.1, D3.1, D4.1, D5.1, D6.1, D7.1, D8.1, J2.1, K1.4, K2.4, K3.4, K4.4, K5.4, K6.4, K7.4, K8.4, U1.10 (COM)
/CS: J2.6, U2.11 (~CS)
/K1: D1.2, K1.1, U1.11 (O8)
/K1_exp: J9.2, U1.8 (I8), U2.21 (GPA0)
/K2: D2.2, K2.1, U1.12 (O7)
/K2_exp: J9.3, U1.7 (I7), U2.22 (GPA1)
/K3: D3.2, K3.1, U1.13 (O6)
/K3_exp: J9.4, U1.6 (I6), U2.23 (GPA2)
/K4: D4.2, K4.1, U1.14 (O5)
/K4_exp: J9.5, U1.5 (I5), U2.24 (GPA3)
/K5: D5.2, K5.1, U1.15 (O4)
/K5_exp: J9.6, U1.4 (I4), U2.25 (GPA4)
/K6: D6.2, K6.1, U1.16 (O3)
/K6_exp: J9.7, U1.3 (I3), U2.26 (GPA5)
/K7: D7.2, K7.1, U1.17 (O2)
/K7_exp: J9.8, U1.2 (I2), U2.27 (GPA6)
/K8: D8.2, K8.1, U1.18 (O1)
/K8_exp: J9.9, U1.1 (I1), U2.28 (GPA7)
/MISO: J2.4, U2.14 (SO)
/MOSI: J2.3, U2.13 (SI)
/SCK: J2.5, U2.12 (SCK)
GND: C1.2, J2.10, J9.10, U1.9 (GND), U2.10 (VSS), U2.15 (A0), U2.16 (A1), U2.17 (A2)
unnamed: J10.1, K1.3
unnamed: J10.2, K1.2
unnamed: J10.3, K2.3
unnamed: J10.4, K2.2
unnamed: J10.5, K3.3
unnamed: J10.6, K3.2
unnamed: J10.7, K4.3
unnamed: J10.8, K4.2
unnamed: J10.9, K5.3
unnamed: J10.10, K5.2
unnamed: J10.11, K6.3
unnamed: J10.12, K6.2
unnamed: J10.13, K7.3
unnamed: J10.14, K7.2
unnamed: J10.15, K8.3
unnamed: J10.16, K8.2
PE: C1.1, J10.17, J10.18, PE1.1
