Konstantin-Dudersky/plc-modules/PM-DI16-DC24sink_v0.0.3/PM-DI16-DC24sink.kicad_pcb

## KiCad design PM-DI16-DC24sink_v0.0.3/PM-DI16-DC24sink.kicad_pcb (2024-10-28)

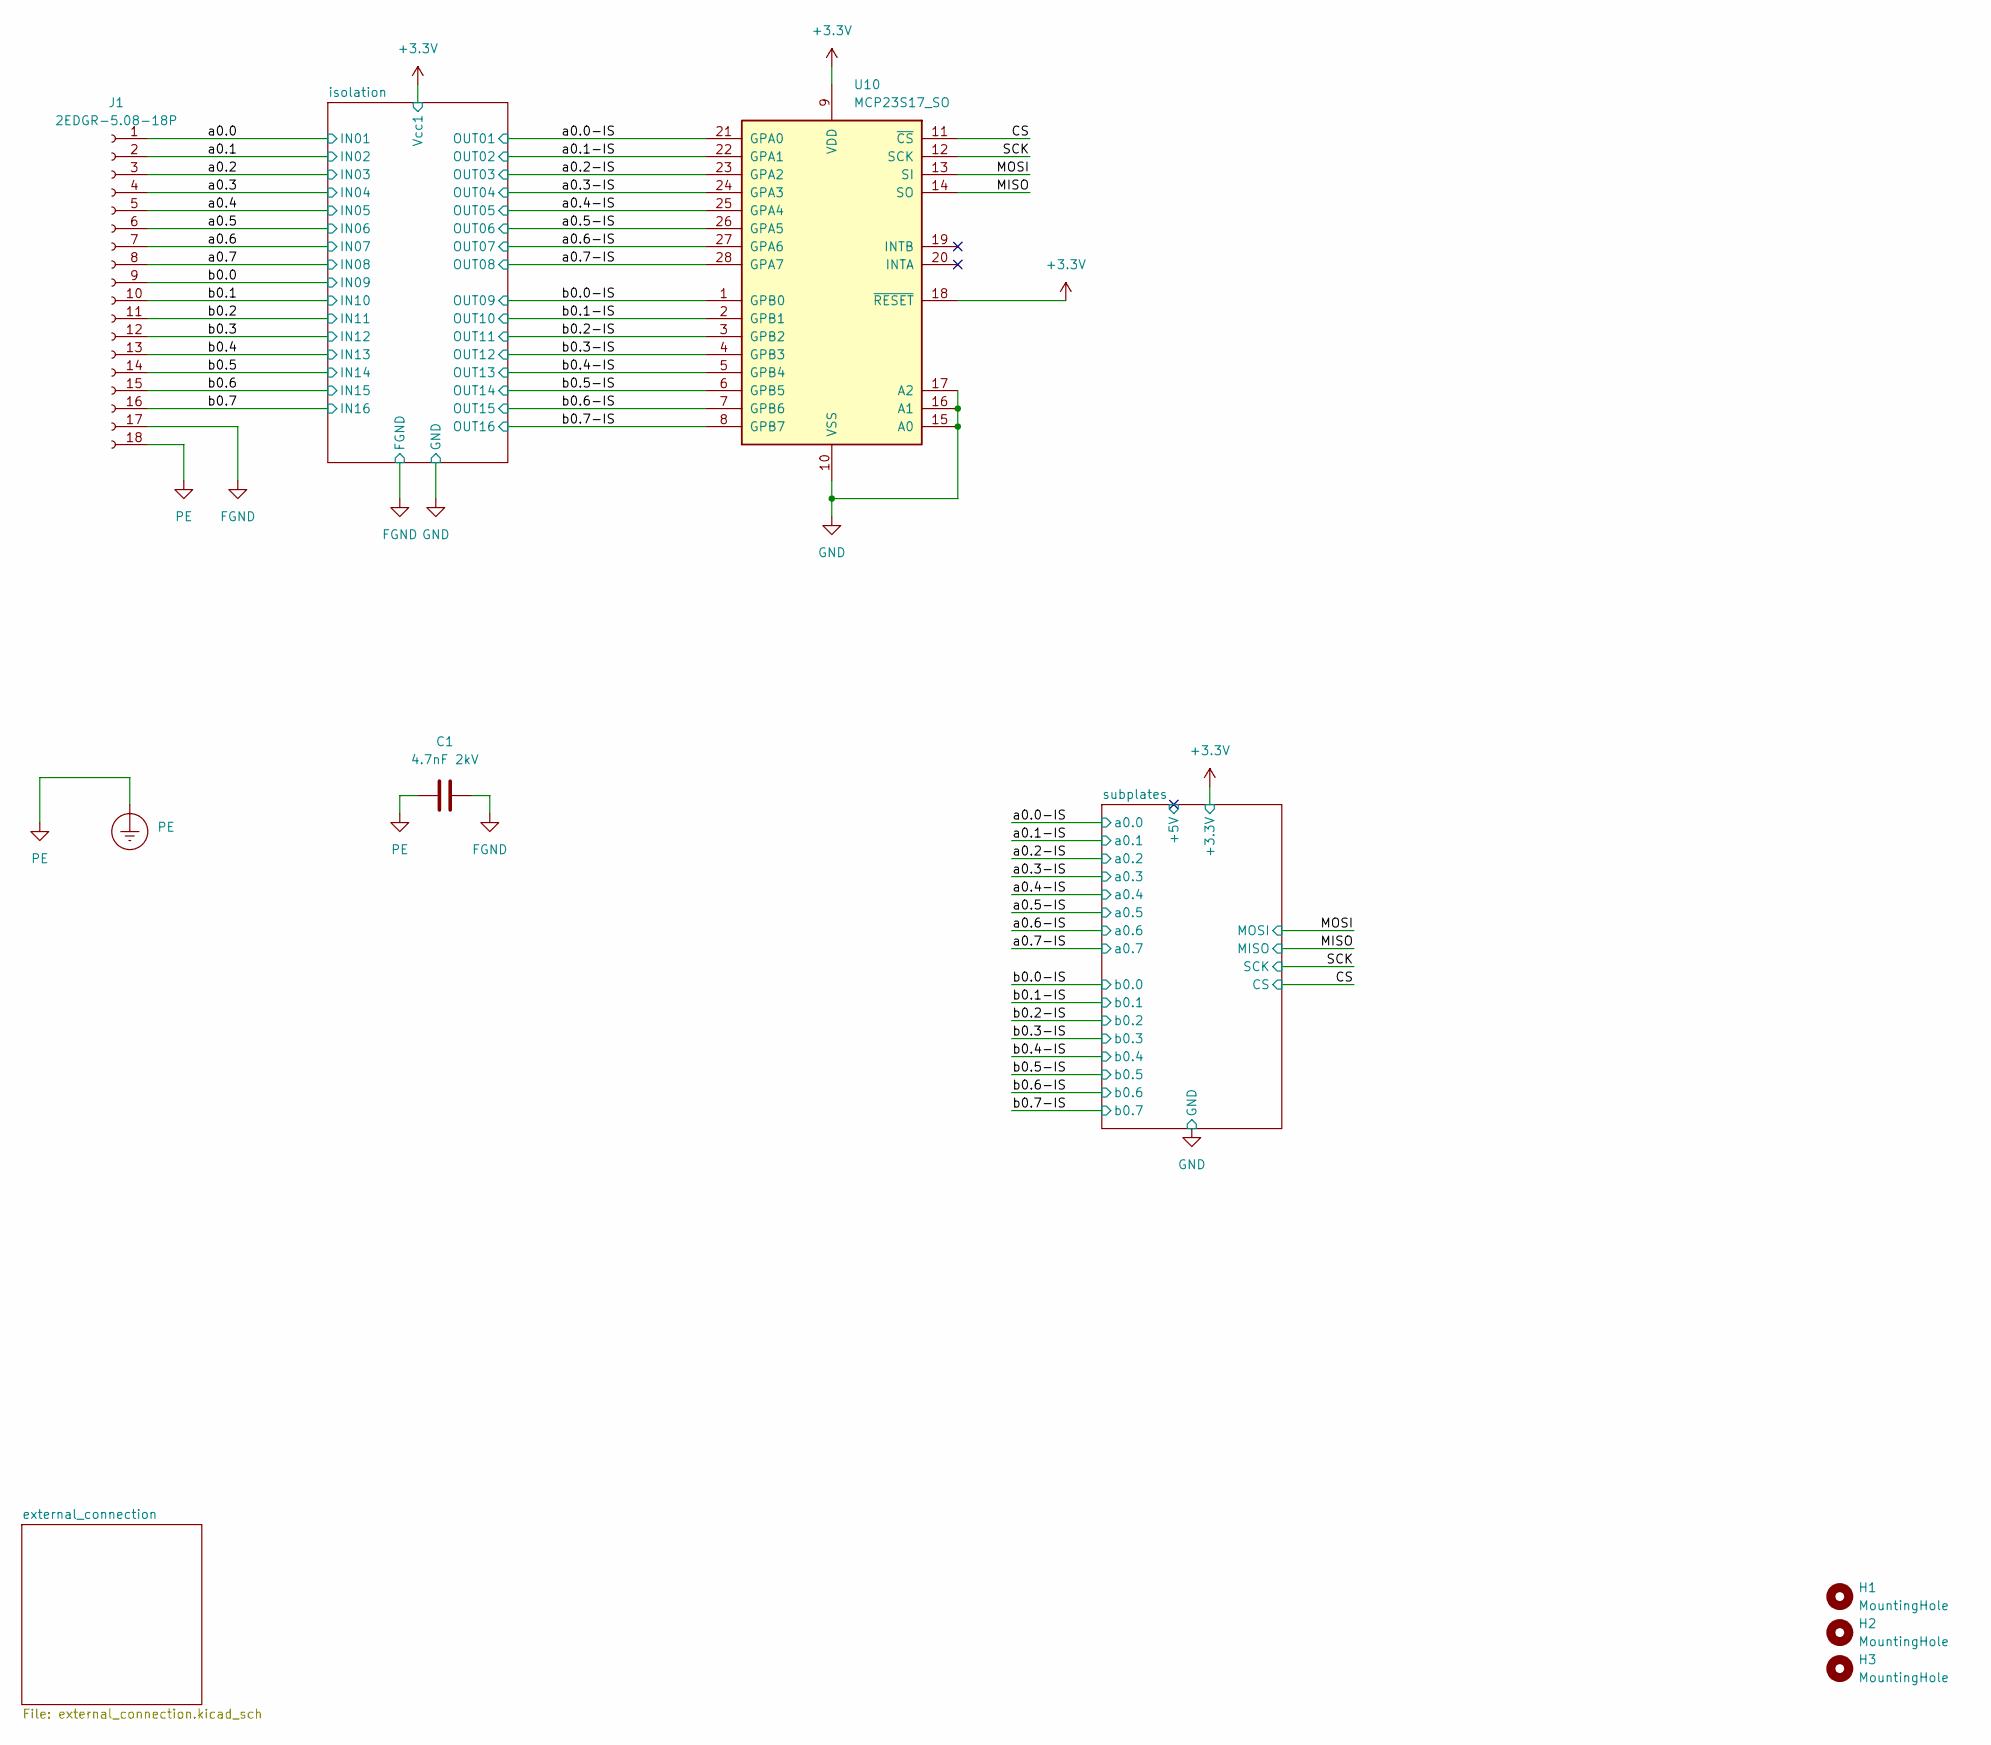
[picture p323: schematic PM-DI16-DC24sink.kicad_sch, ${article} v${version}]

Parts:
C1: 4.7nF 2kV; C_1812_4532Metric_Pad1.57x3.40mm_HandSolder; part_ipn C_4.7nF_2kV_1812
H1, H2, H3: MountingHole; MountingHole_3.2mm_M3
J1: 2EDGR-5.08-18P; Degson_2EDGR-5.08-18P; part_ipn 2EDGR-5.08-18P
PE1: PE
U10: MCP23S17_SO; SOIC-28W_7.5x17.9mm_P1.27mm; part_ipn MCP23S17-E/SO

Connections:
+3.3V: U10.9 (VDD), U10.18 (~RESET); also elsewhere on the board
/CS: U10.11 (~CS); also elsewhere on the board
/MISO: U10.14 (SO); also elsewhere on the board
/MOSI: U10.13 (SI); also elsewhere on the board
/SCK: U10.12 (SCK); also elsewhere on the board
/a0.0: J1.1; also elsewhere on the board
/a0.0-IS: U10.21 (GPA0); also elsewhere on the board
/a0.1: J1.2; also elsewhere on the board
/a0.1-IS: U10.22 (GPA1); also elsewhere on the board
/a0.2: J1.3; also elsewhere on the board
/a0.2-IS: U10.23 (GPA2); also elsewhere on the board
/a0.3: J1.4; also elsewhere on the board
/a0.3-IS: U10.24 (GPA3); also elsewhere on the board
/a0.4: J1.5; also elsewhere on the board
/a0.4-IS: U10.25 (GPA4); also elsewhere on the board
/a0.5: J1.6; also elsewhere on the board
/a0.5-IS: U10.26 (GPA5); also elsewhere on the board
/a0.6: J1.7; also elsewhere on the board
/a0.6-IS: U10.27 (GPA6); also elsewhere on the board
/a0.7: J1.8; also elsewhere on the board
/a0.7-IS: U10.28 (GPA7); also elsewhere on the board
/b0.0: J1.9; also elsewhere on the board
/b0.0-IS: U10.1 (GPB0); also elsewhere on the board
/b0.1: J1.10; also elsewhere on the board
/b0.1-IS: U10.2 (GPB1); also elsewhere on the board
/b0.2: J1.11; also elsewhere on the board
/b0.2-IS: U10.3 (GPB2); also elsewhere on the board
/b0.3: J1.12; also elsewhere on the board
/b0.3-IS: U10.4 (GPB3); also elsewhere on the board
/b0.4: J1.13; also elsewhere on the board
/b0.4-IS: U10.5 (GPB4); also elsewhere on the board
/b0.5: J1.14; also elsewhere on the board
/b0.5-IS: U10.6 (GPB5); also elsewhere on the board
/b0.6: J1.15; also elsewhere on the board
/b0.6-IS: U10.7 (GPB6); also elsewhere on the board
/b0.7: J1.16; also elsewhere on the board
/b0.7-IS: U10.8 (GPB7); also elsewhere on the board
FGND: C1.2, J1.17; also elsewhere on the board
GND: U10.10 (VSS), U10.15 (A0), U10.16 (A1), U10.17 (A2); also elsewhere on the board
PE: C1.1, J1.18, PE1.1

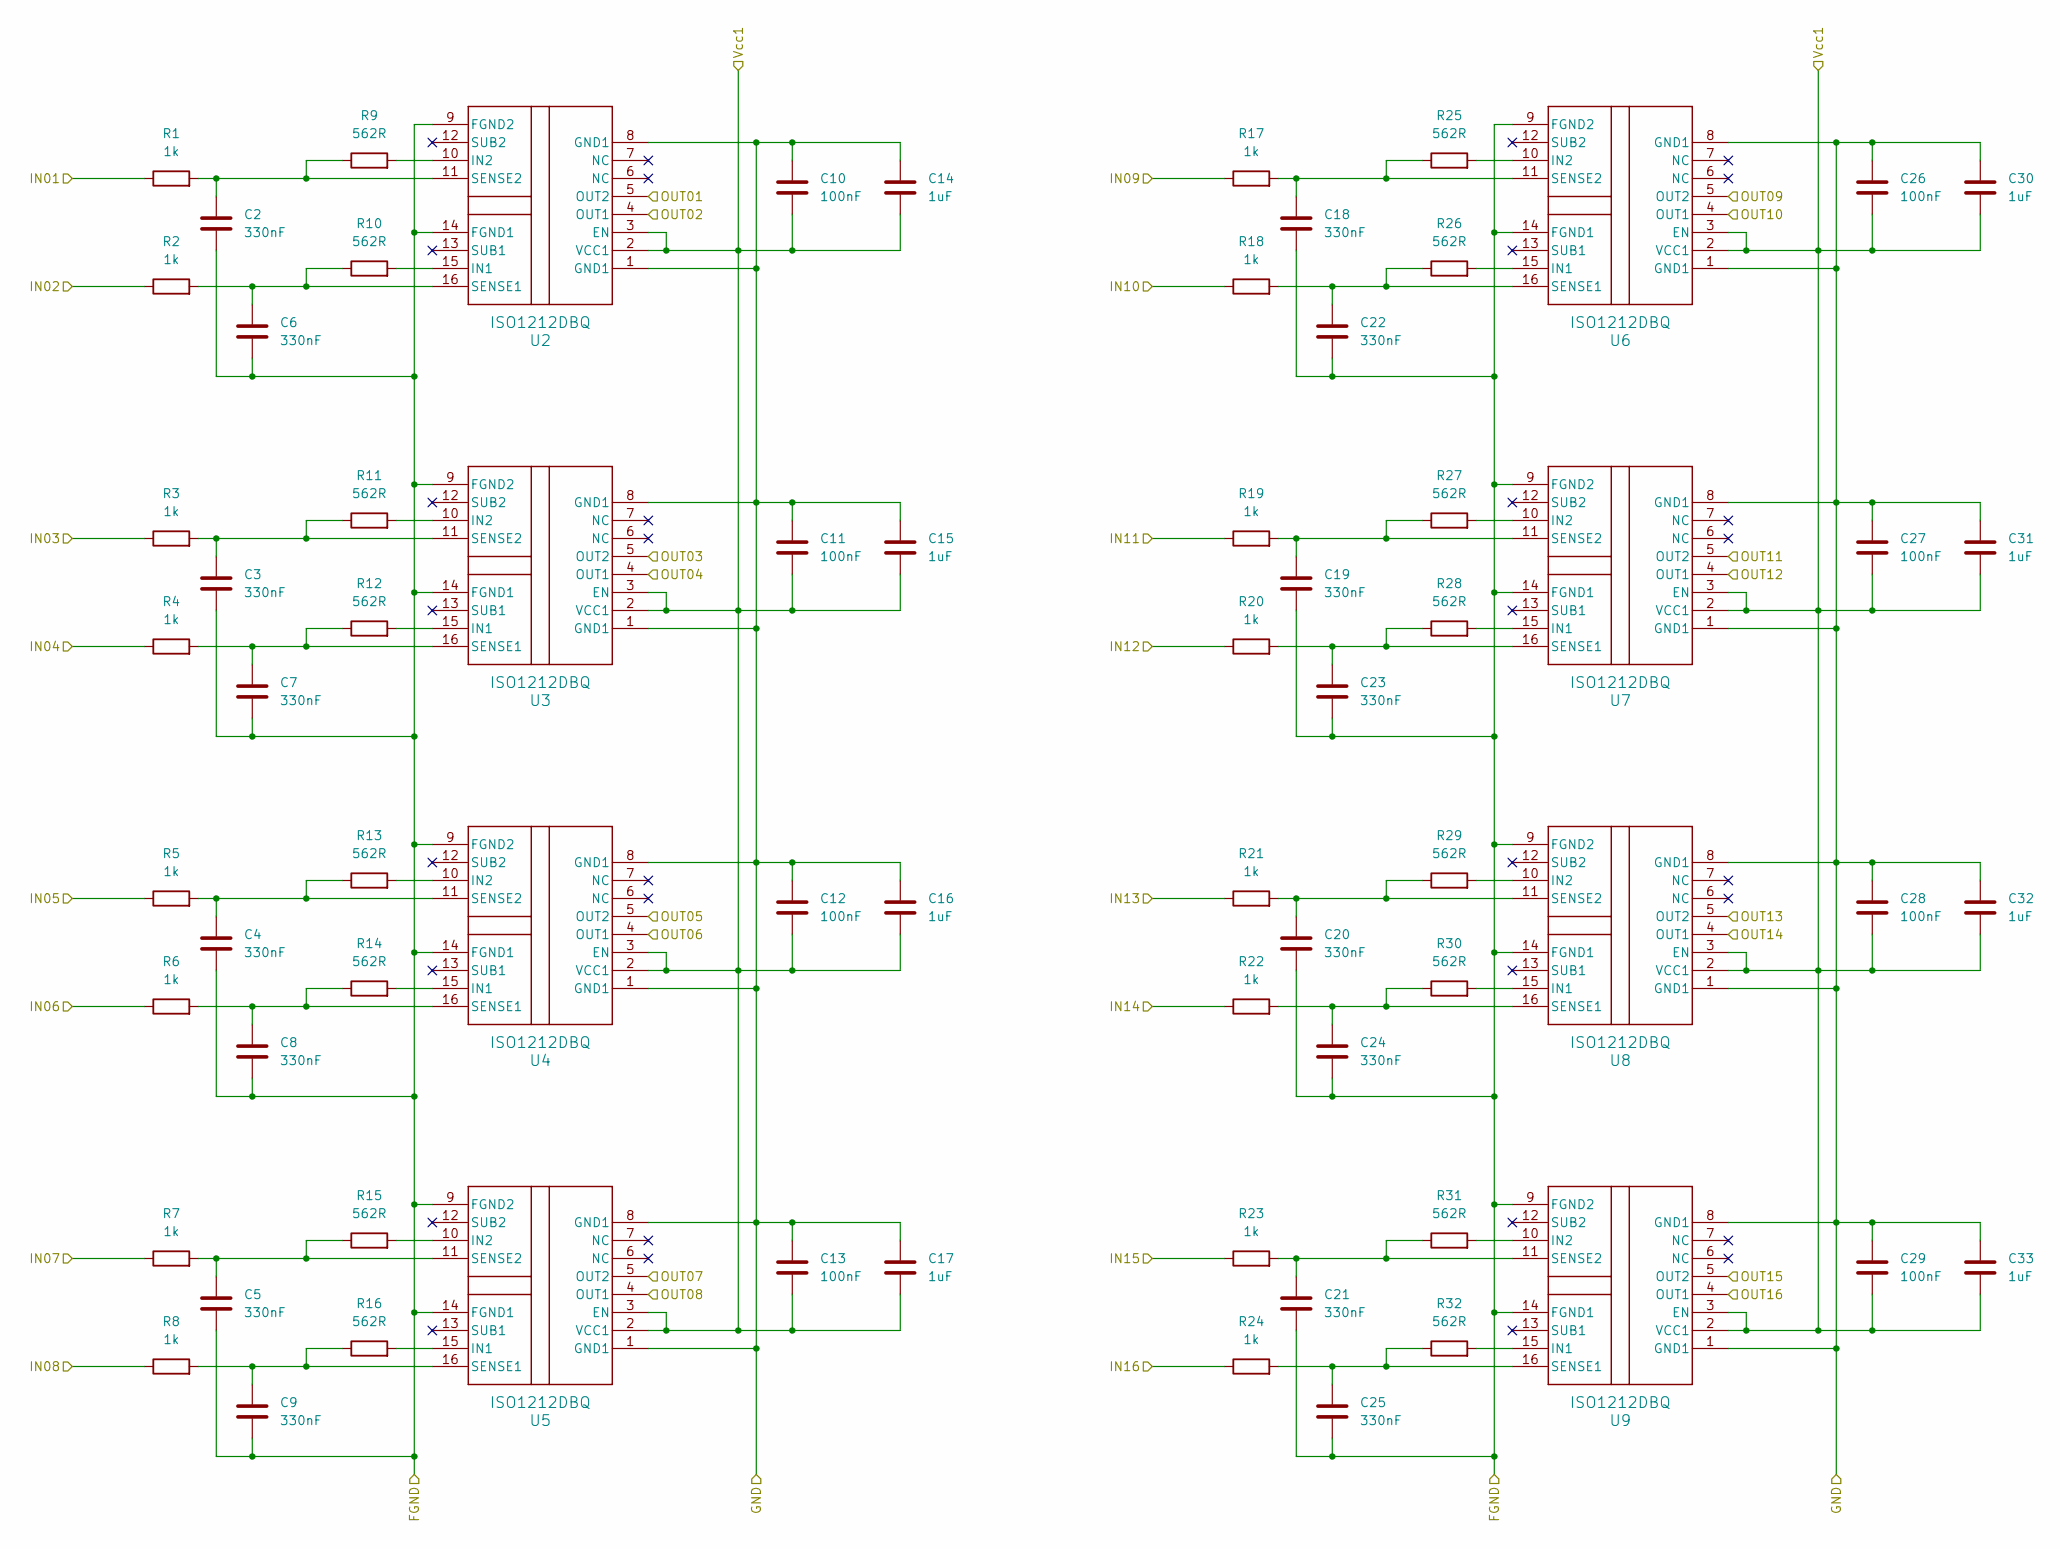
[picture p324: schematic isolation.kicad_sch]

Parts:
C2, C3, C4, C5, C6, C7, C8, C9, C18, C19, C20, C21, C22, C23, C24, C25: 330nF; C_1206_3216Metric_Pad1.33x1.80mm_HandSolder; part_ipn C_330nF_50V_1206
C10, C11, C12, C13, C26, C27, C28, C29: 100nF; C_1206_3216Metric_Pad1.33x1.80mm_HandSolder; part_ipn C_100nF_50V_1206
C14, C15, C16, C17, C30, C31, C32, C33: 1uF; C_1206_3216Metric_Pad1.33x1.80mm_HandSolder; part_ipn C_1uF_50V_1206
R1, R2, R3, R4, R5, R6, R7, R8, R17, R18, R19, R20, R21, R22, R23, R24: 1k; R_1206_3216Metric_Pad1.30x1.75mm_HandSolder; part_ipn R_1k_1206_1%
R9, R10, R11, R12, R13, R14, R15, R16, R25, R26, R27, R28, R29, R30, R31, R32: 562R; R_1206_3216Metric_Pad1.30x1.75mm_HandSolder; part_ipn R_562R_1206_1%
U2, U3, U4, U5, U6, U7, U8, U9: ISO1212DBQ; DBQ0016A_M; part_ipn ISO1212

Connections:
+3.3V: C10.2, C11.2, C12.2, C13.2, C14.2, C15.2, C16.2, C17.2, C26.2, C27.2, C28.2, C29.2, C30.2, C31.2, C32.2, C33.2, U2.2 (VCC1), U2.3 (EN), U3.2 (VCC1), U3.3 (EN), U4.2 (VCC1), U4.3 (EN), U5.2 (VCC1), U5.3 (EN), U6.2 (VCC1), U6.3 (EN), U7.2 (VCC1), U7.3 (EN), U8.2 (VCC1), U8.3 (EN), U9.2 (VCC1), U9.3 (EN); also elsewhere on the board
/a0.0: R1.1; also elsewhere on the board
/a0.0-IS: U2.5 (OUT2); also elsewhere on the board
/a0.1: R2.1; also elsewhere on the board
/a0.1-IS: U2.4 (OUT1); also elsewhere on the board
/a0.2: R3.1; also elsewhere on the board
/a0.2-IS: U3.5 (OUT2); also elsewhere on the board
/a0.3: R4.1; also elsewhere on the board
/a0.3-IS: U3.4 (OUT1); also elsewhere on the board
/a0.4: R5.1; also elsewhere on the board
/a0.4-IS: U4.5 (OUT2); also elsewhere on the board
/a0.5: R6.1; also elsewhere on the board
/a0.5-IS: U4.4 (OUT1); also elsewhere on the board
/a0.6: R7.1; also elsewhere on the board
/a0.6-IS: U5.5 (OUT2); also elsewhere on the board
/a0.7: R8.1; also elsewhere on the board
/a0.7-IS: U5.4 (OUT1); also elsewhere on the board
/b0.0: R17.1; also elsewhere on the board
/b0.0-IS: U6.5 (OUT2); also elsewhere on the board
/b0.1: R18.1; also elsewhere on the board
/b0.1-IS: U6.4 (OUT1); also elsewhere on the board
/b0.2: R19.1; also elsewhere on the board
/b0.2-IS: U7.5 (OUT2); also elsewhere on the board
/b0.3: R20.1; also elsewhere on the board
/b0.3-IS: U7.4 (OUT1); also elsewhere on the board
/b0.4: R21.1; also elsewhere on the board
/b0.4-IS: U8.5 (OUT2); also elsewhere on the board
/b0.5: R22.1; also elsewhere on the board
/b0.5-IS: U8.4 (OUT1); also elsewhere on the board
/b0.6: R23.1; also elsewhere on the board
/b0.6-IS: U9.5 (OUT2); also elsewhere on the board
/b0.7: R24.1; also elsewhere on the board
/b0.7-IS: U9.4 (OUT1); also elsewhere on the board
FGND: C2.2, C3.2, C4.2, C5.2, C6.2, C7.2, C8.2, C9.2, C18.2, C19.2, C20.2, C21.2, C22.2, C23.2, C24.2, C25.2, U2.9 (FGND2), U2.14 (FGND1), U3.9 (FGND2), U3.14 (FGND1), U4.9 (FGND2), U4.14 (FGND1), U5.9 (FGND2), U5.14 (FGND1), U6.9 (FGND2), U6.14 (FGND1), U7.9 (FGND2), U7.14 (FGND1), U8.9 (FGND2), U8.14 (FGND1), U9.9 (FGND2), U9.14 (FGND1); also elsewhere on the board
GND: C10.1, C11.1, C12.1, C13.1, C14.1, C15.1, C16.1, C17.1, C26.1, C27.1, C28.1, C29.1, C30.1, C31.1, C32.1, C33.1, U2.1 (GND1), U2.8 (GND1), U3.1 (GND1), U3.8 (GND1), U4.1 (GND1), U4.8 (GND1), U5.1 (GND1), U5.8 (GND1), U6.1 (GND1), U6.8 (GND1), U7.1 (GND1), U7.8 (GND1), U8.1 (GND1), U8.8 (GND1), U9.1 (GND1), U9.8 (GND1); also elsewhere on the board
unnamed: R10.2, U2.15 (IN1)
unnamed: R9.2, U2.10 (IN2)
unnamed: C6.1, R2.2, R10.1, U2.16 (SENSE1)
unnamed: C2.1, R1.2, R9.1, U2.11 (SENSE2)
unnamed: R12.2, U3.15 (IN1)
unnamed: R11.2, U3.10 (IN2)
unnamed: C7.1, R4.2, R12.1, U3.16 (SENSE1)
unnamed: C3.1, R3.2, R11.1, U3.11 (SENSE2)
unnamed: R14.2, U4.15 (IN1)
unnamed: R13.2, U4.10 (IN2)
unnamed: C8.1, R6.2, R14.1, U4.16 (SENSE1)
unnamed: C4.1, R5.2, R13.1, U4.11 (SENSE2)
unnamed: R16.2, U5.15 (IN1)
unnamed: R15.2, U5.10 (IN2)
unnamed: C9.1, R8.2, R16.1, U5.16 (SENSE1)
unnamed: C5.1, R7.2, R15.1, U5.11 (SENSE2)
unnamed: R26.2, U6.15 (IN1)
unnamed: R25.2, U6.10 (IN2)
unnamed: C22.1, R18.2, R26.1, U6.16 (SENSE1)
unnamed: C18.1, R17.2, R25.1, U6.11 (SENSE2)
unnamed: R28.2, U7.15 (IN1)
unnamed: R27.2, U7.10 (IN2)
unnamed: C23.1, R20.2, R28.1, U7.16 (SENSE1)
unnamed: C19.1, R19.2, R27.1, U7.11 (SENSE2)
unnamed: R30.2, U8.15 (IN1)
unnamed: R29.2, U8.10 (IN2)
unnamed: C24.1, R22.2, R30.1, U8.16 (SENSE1)
unnamed: C20.1, R21.2, R29.1, U8.11 (SENSE2)
unnamed: R32.2, U9.15 (IN1)
unnamed: R31.2, U9.10 (IN2)
unnamed: C25.1, R24.2, R32.1, U9.16 (SENSE1)
unnamed: C21.1, R23.2, R31.1, U9.11 (SENSE2)

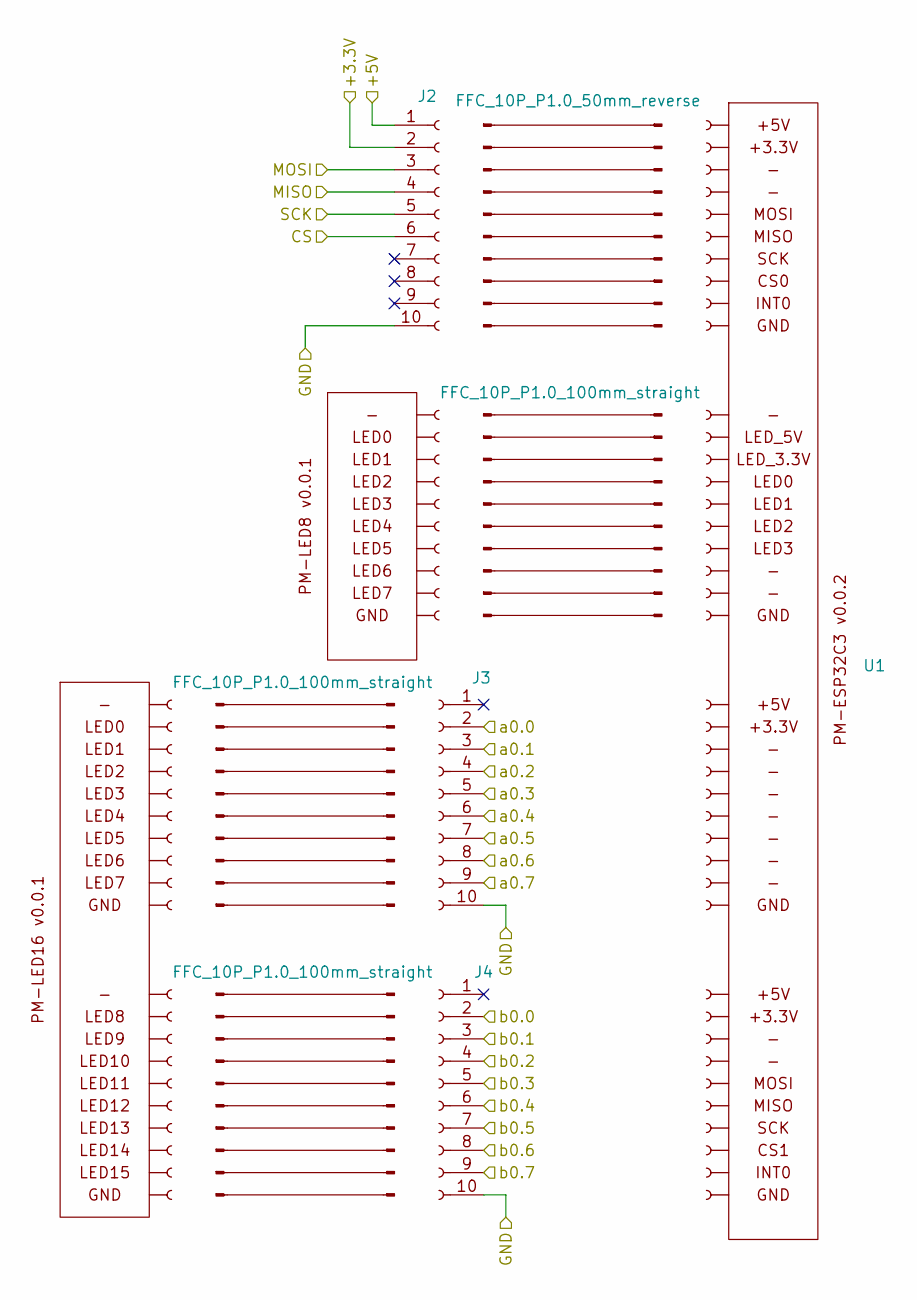
[picture p325: schematic subplates.kicad_sch]

Parts:
J2, J3, J4: AFA07-S10FCC-00; CONN10_AFA07-S10_JUS
J5: FFC_10P_P1.0_50mm_reverse; part_ipn FFC_10P_P1.0_50mm_reverse
J6, J7, J8: FFC_10P_P1.0_100mm_straight; part_ipn FFC_10P_P1.0_100mm_straight
U1: PM-ESP32C3_v0.0.2
U11: PM-LED8_v0.0.1; PM-LED_v0.0.1
U12: PM-LED16_v0.0.1; PM-LED_v0.0.1

Connections:
+3.3V: J2.2; also elsewhere on the board
/CS: J2.6; also elsewhere on the board
/MISO: J2.4; also elsewhere on the board
/MOSI: J2.3; also elsewhere on the board
/SCK: J2.5; also elsewhere on the board
/a0.0-IS: J3.2; also elsewhere on the board
/a0.1-IS: J3.3; also elsewhere on the board
/a0.2-IS: J3.4; also elsewhere on the board
/a0.3-IS: J3.5; also elsewhere on the board
/a0.4-IS: J3.6; also elsewhere on the board
/a0.5-IS: J3.7; also elsewhere on the board
/a0.6-IS: J3.8; also elsewhere on the board
/a0.7-IS: J3.9; also elsewhere on the board
/b0.0-IS: J4.2; also elsewhere on the board
/b0.1-IS: J4.3; also elsewhere on the board
/b0.2-IS: J4.4; also elsewhere on the board
/b0.3-IS: J4.5; also elsewhere on the board
/b0.4-IS: J4.6; also elsewhere on the board
/b0.5-IS: J4.7; also elsewhere on the board
/b0.6-IS: J4.8; also elsewhere on the board
/b0.7-IS: J4.9; also elsewhere on the board
/subplates/+5V: J2.1
GND: J2.10, J3.10, J4.10; also elsewhere on the board

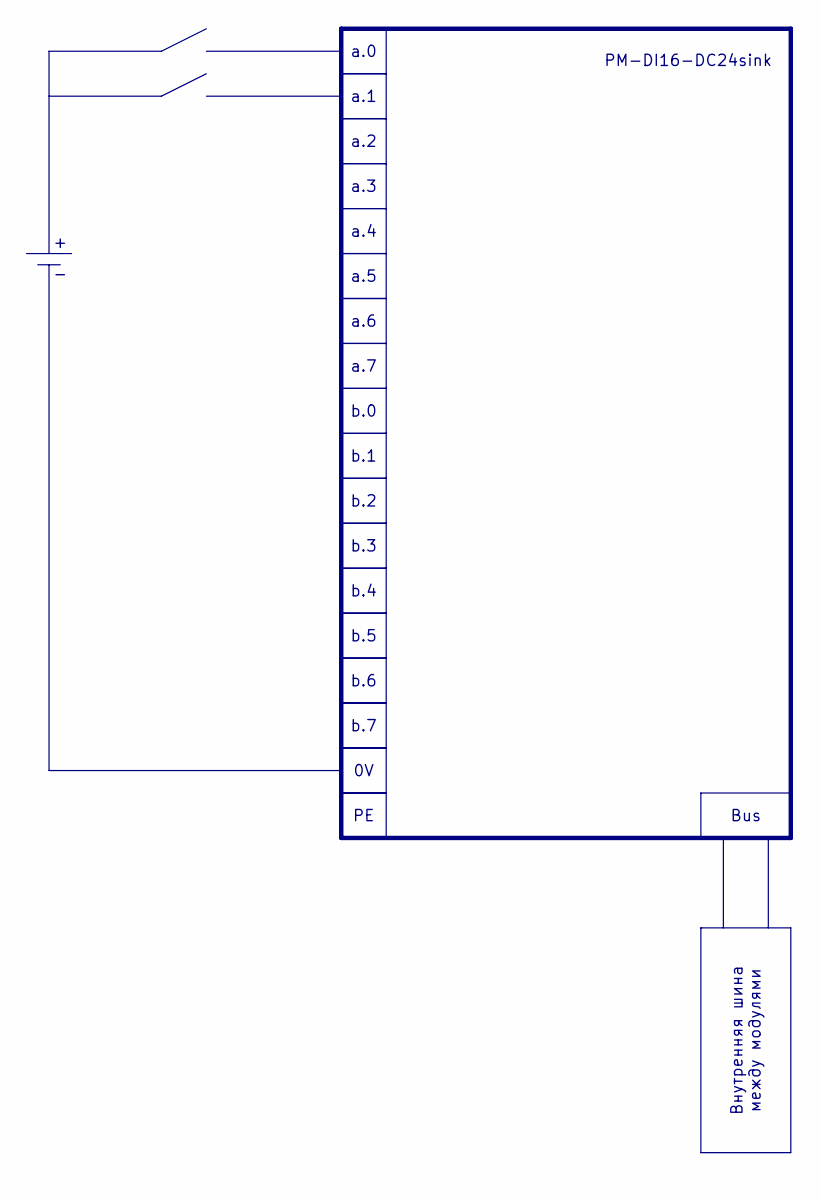
[picture p326: schematic external_connection.kicad_sch]

Notes on the sheet:
Внутренняя шина между модулями
b.0
b.1
b.4
b.6
a.1
a.2
Bus
b.7
b.3
a.6
a.3
a.5
b.5
b.2
a.0
a.4
a.7
PM-DI16-DC24sink

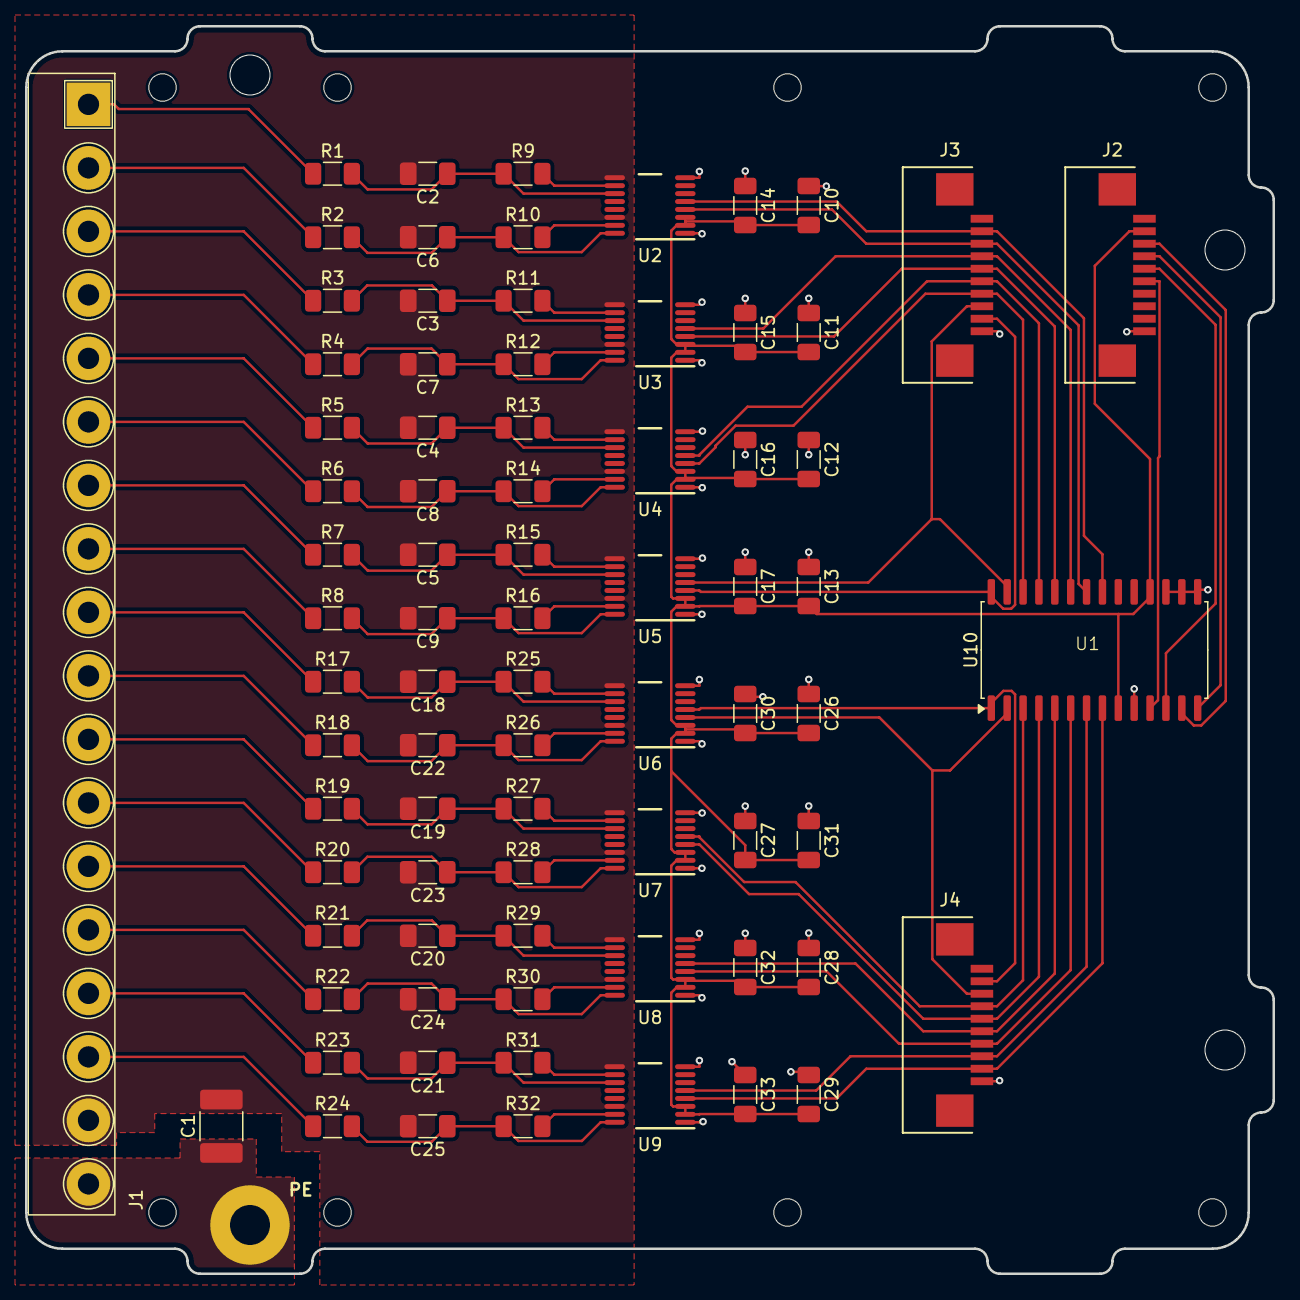
[picture p327: board PM-DI16-DC24sink.kicad_pcb from above]

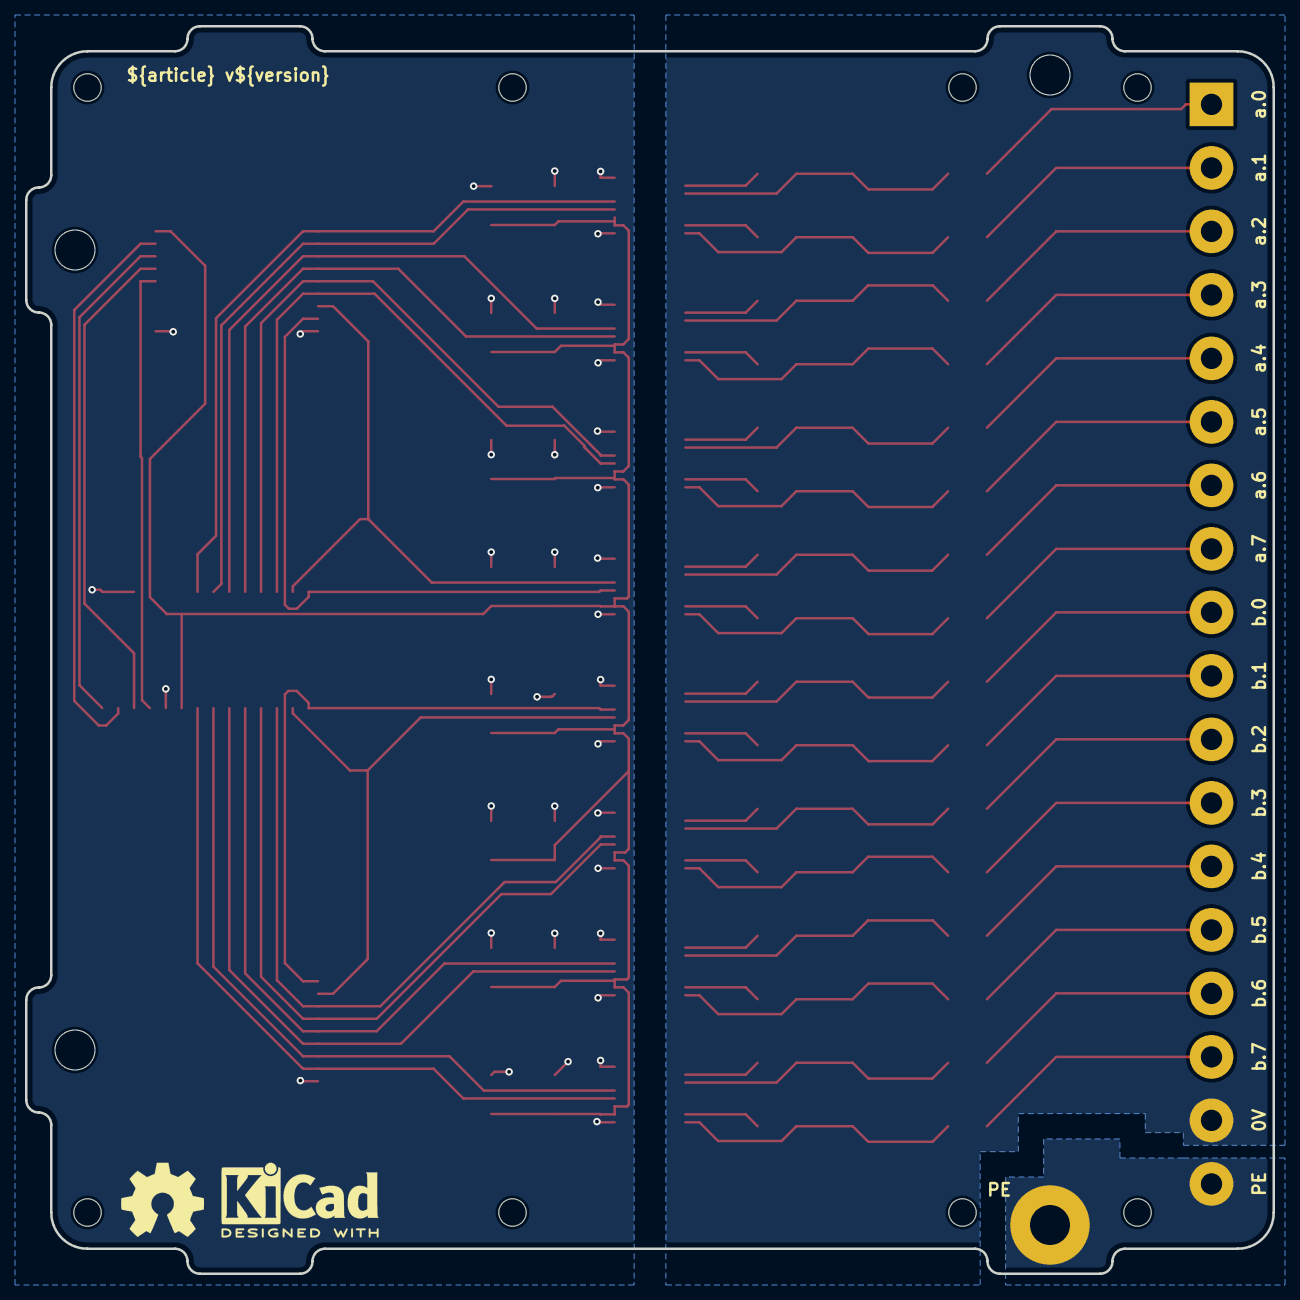
[picture p328: board PM-DI16-DC24sink.kicad_pcb from below]

Board: 2 copper layers, 99.8 x 99.8 mm, 86 parts (2 on the bottom side), 72 nets.

Other parts of the board:
kicad_logo: KiCad-Logo2_5mm_SilkScreen
oshw_logo: OSHW-Symbol_6.7x6mm_SilkScreen
