Konstantin-Dudersky/plc-modules/PM-DI16-DC24sink-front_v0.0.3/PM-DI16-DC24sink-front.kicad_pcb

## KiCad design PM-DI16-DC24sink-front_v0.0.3/PM-DI16-DC24sink-front.kicad_pcb (2024-09-17)

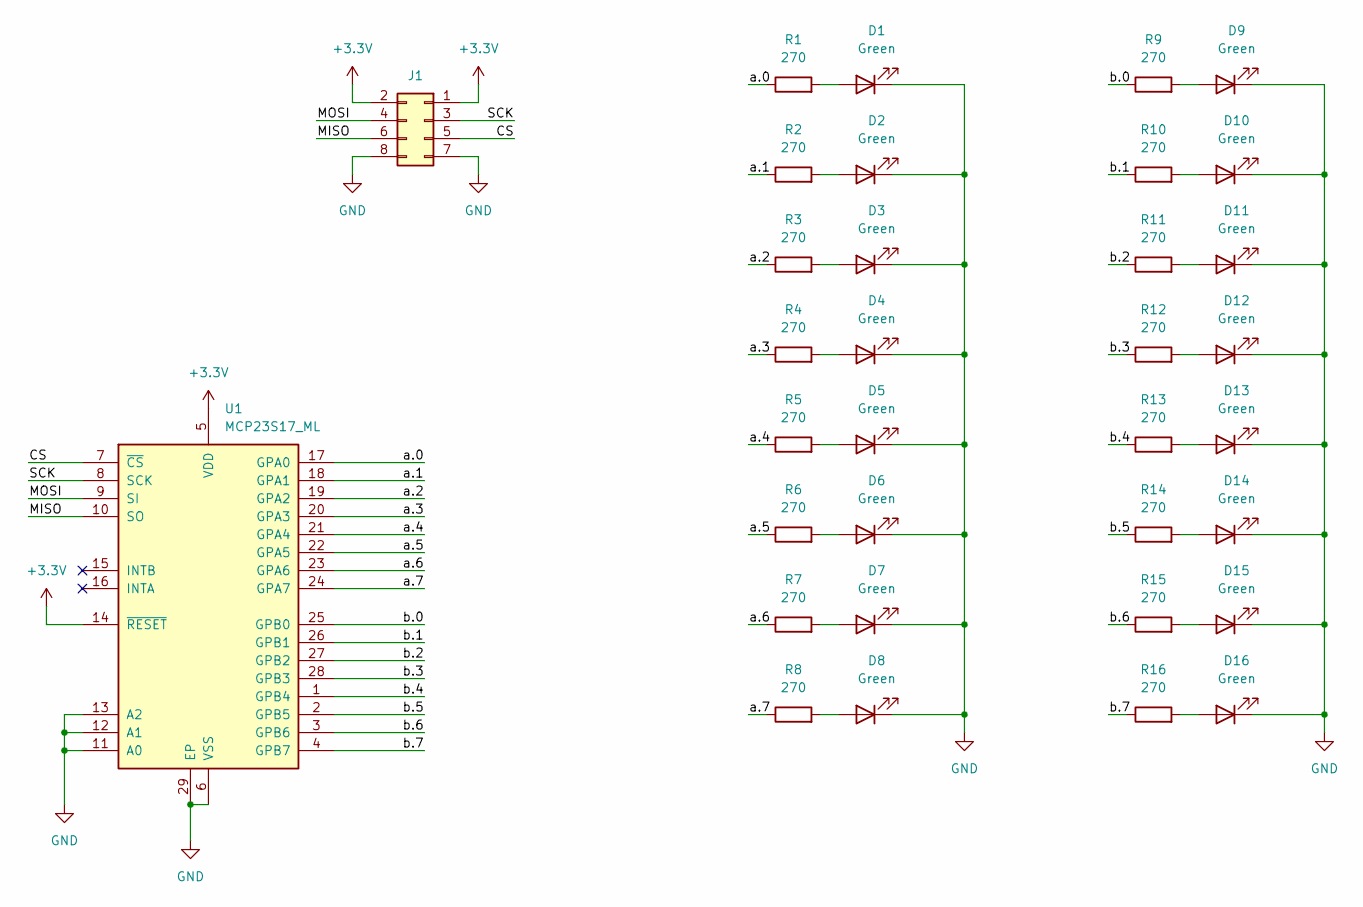
[picture p329: schematic PM-DI16-DC24sink-front.kicad_sch, ${article} v${version}]

Parts:
D1, D2, D3, D4, D5, D6, D7, D8, D9, D10, D11, D12, D13, D14, D15, D16: Green; LED_1206_3216Metric_ReverseMount_Hole1.8x2.4mm; part_ipn LED_green_1206_reverse
J1: PinHeader_02x04_P2.54_THT_angle; PinHeader_2x04_P2.54mm_Horizontal; part_ipn PinHeader_02x04_P2.54_THT_angle
R1, R2, R3, R4, R5, R6, R7, R8, R9, R10, R11, R12, R13, R14, R15, R16: 270; R_1206_3216Metric_Pad1.30x1.75mm_HandSolder; part_ipn R_270_1206_1%
U1: MCP23S17_ML; QFN-28-1EP_6x6mm_P0.65mm_EP4.25x4.25mm; part_ipn MCP23S17-E/ML

Connections:
+3.3V: J1.1, J1.2, U1.5 (VDD), U1.14 (~RESET)
/CS: J1.5, U1.7 (~CS)
/MISO: J1.6, U1.10 (SO)
/MOSI: J1.4, U1.9 (SI)
/SCK: J1.3, U1.8 (SCK)
/a.0: R1.1, U1.17 (GPA0)
/a.1: R2.1, U1.18 (GPA1)
/a.2: R3.1, U1.19 (GPA2)
/a.3: R4.1, U1.20 (GPA3)
/a.4: R5.1, U1.21 (GPA4)
/a.5: R6.1, U1.22 (GPA5)
/a.6: R7.1, U1.23 (GPA6)
/a.7: R8.1, U1.24 (GPA7)
/b.0: R9.1, U1.25 (GPB0)
/b.1: R10.1, U1.26 (GPB1)
/b.2: R11.1, U1.27 (GPB2)
/b.3: R12.1, U1.28 (GPB3)
/b.4: R13.1, U1.1 (GPB4)
/b.5: R14.1, U1.2 (GPB5)
/b.6: R15.1, U1.3 (GPB6)
/b.7: R16.1, U1.4 (GPB7)
GND: D1.1 (K), D2.1 (K), D3.1 (K), D4.1 (K), D5.1 (K), D6.1 (K), D7.1 (K), D8.1 (K), D9.1 (K), D10.1 (K), D11.1 (K), D12.1 (K), D13.1 (K), D14.1 (K), D15.1 (K), D16.1 (K), J1.7, J1.8, U1.6 (VSS), U1.11 (A0), U1.12 (A1), U1.13 (A2), U1.29 (EP)
unnamed: D1.2 (A), R1.2
unnamed: D2.2 (A), R2.2
unnamed: D3.2 (A), R3.2
unnamed: D4.2 (A), R4.2
unnamed: D5.2 (A), R5.2
unnamed: D6.2 (A), R6.2
unnamed: D7.2 (A), R7.2
unnamed: D8.2 (A), R8.2
unnamed: D9.2 (A), R9.2
unnamed: D10.2 (A), R10.2
unnamed: D11.2 (A), R11.2
unnamed: D12.2 (A), R12.2
unnamed: D13.2 (A), R13.2
unnamed: D14.2 (A), R14.2
unnamed: D15.2 (A), R15.2
unnamed: D16.2 (A), R16.2

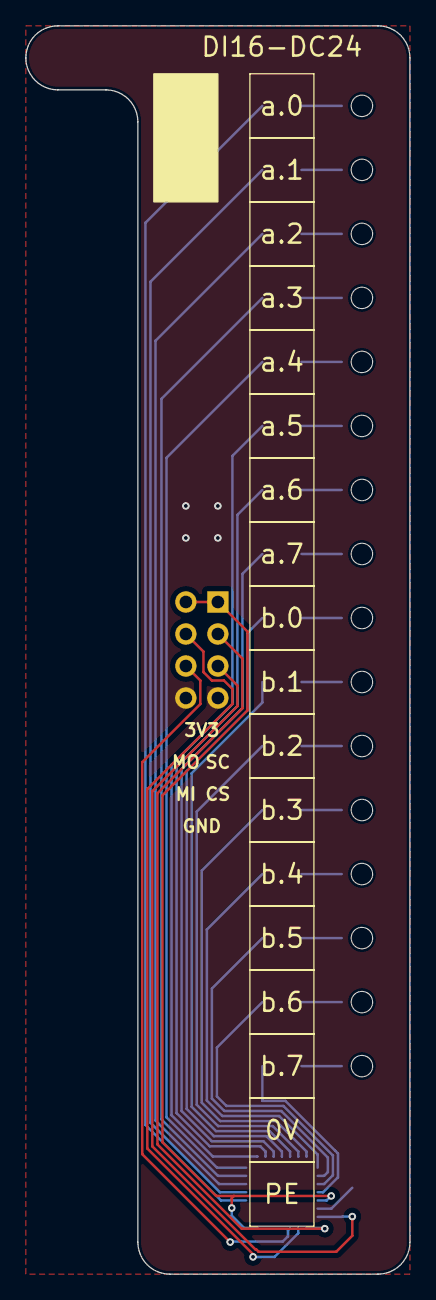
[picture p330: board PM-DI16-DC24sink-front.kicad_pcb from above]

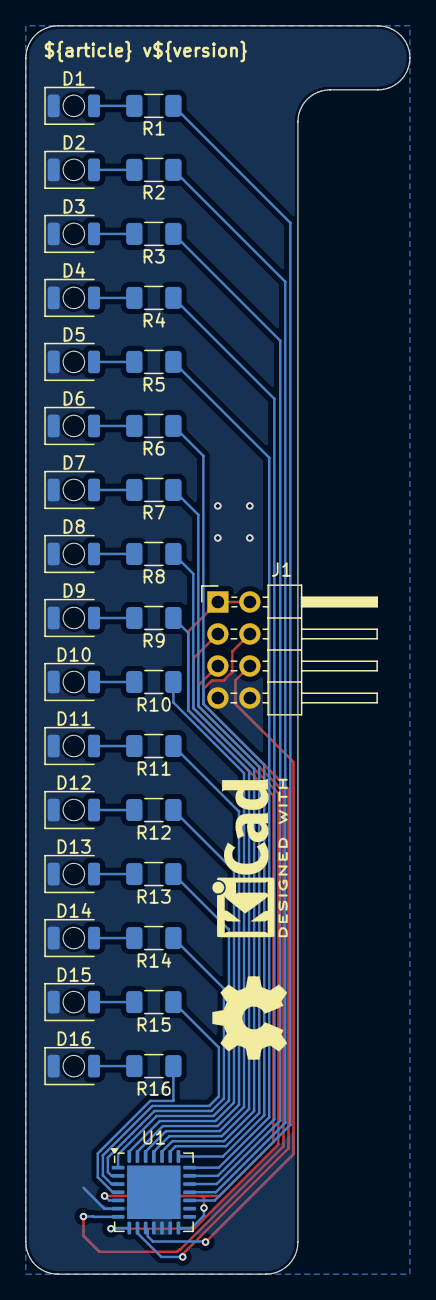
[picture p331: board PM-DI16-DC24sink-front.kicad_pcb from below]

Board: 2 copper layers, 30.5 x 99.1 mm, 35 parts (35 on the bottom side), 38 nets.

Other parts of the board:
Logo_kicad: KiCad-Logo2_5mm_SilkScreen
