Konstantin-Dudersky/plc-modules/PM-PS-AC230-front_v0.0.2/PM-PS-AC230-front.kicad_pcb

## KiCad design PM-PS-AC230-front_v0.0.2/PM-PS-AC230-front.kicad_pcb (2024-09-17)

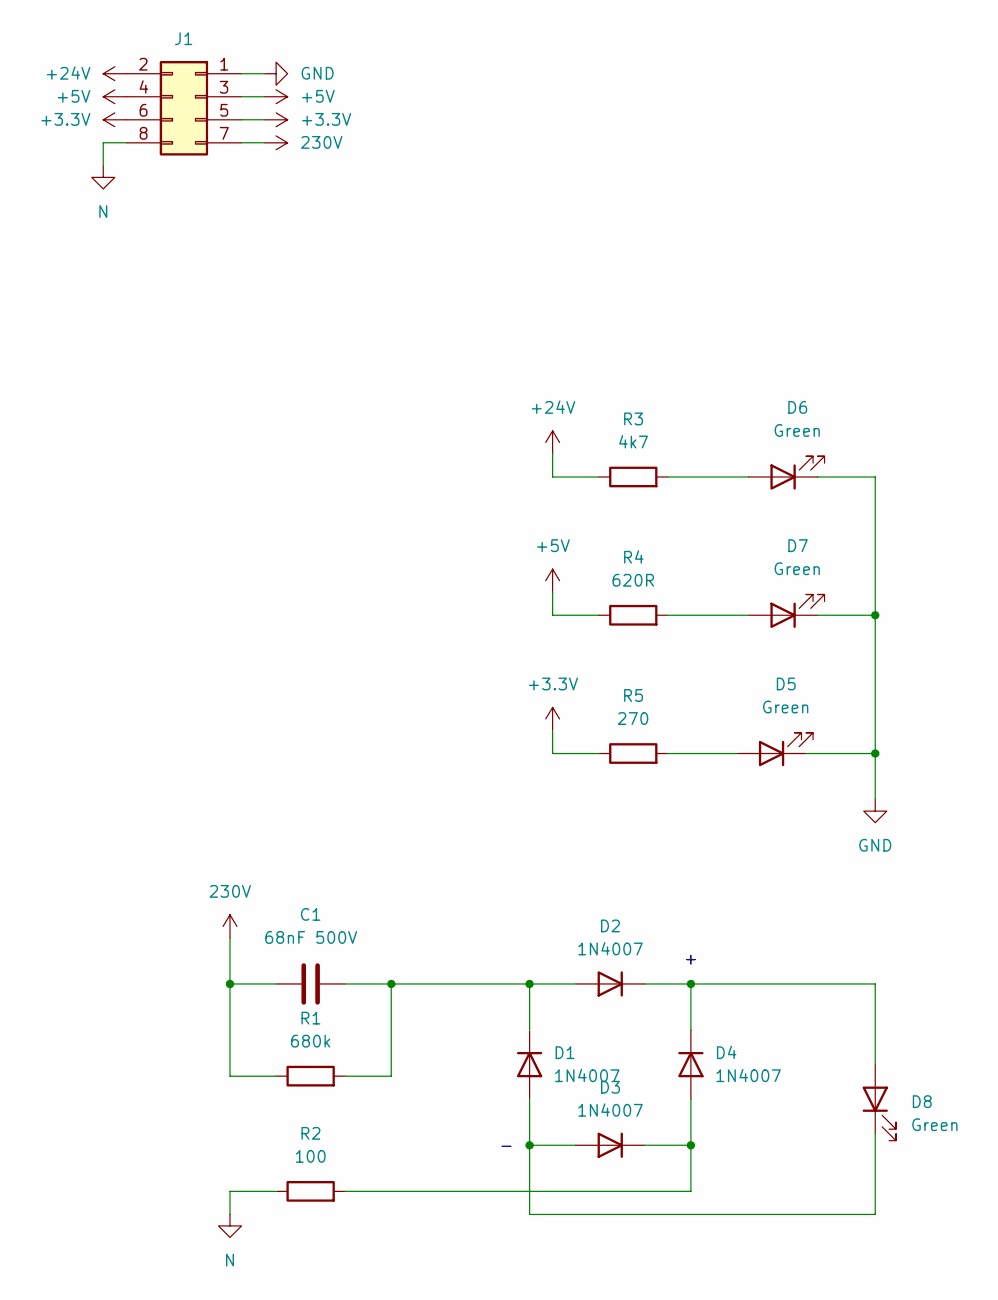
[picture p332: schematic PM-PS-AC230-front.kicad_sch, ${article} v${version}]

Parts:
C1: 68nF 500V; C_1210_3225Metric_Pad1.33x2.70mm_HandSolder; part_ipn C_68nF_500V_1210
D1, D2, D3, D4: 1N4007; D_SMA; part_ipn 1N4007
D5, D6, D7, D8: Green; LED_1206_3216Metric_ReverseMount_Hole1.8x2.4mm; part_ipn LED_green_1206_reverse
J1: PinHeader_02x04_P2.54_THT_angle; PinHeader_2x04_P2.54mm_Horizontal; part_ipn PinHeader_02x04_P2.54_THT_angle
R1: 680k; R_1206_3216Metric_Pad1.30x1.75mm_HandSolder; part_ipn R_680k_1206_1%
R2: 100; R_1206_3216Metric_Pad1.30x1.75mm_HandSolder; part_ipn R_100_1206_1%
R3: 4k7; R_1206_3216Metric_Pad1.30x1.75mm_HandSolder; part_ipn R_4k7_1206_1%
R4: 620R; R_1206_3216Metric_Pad1.30x1.75mm_HandSolder; part_ipn R_620R_1206_1%
R5: 270; R_1206_3216Metric_Pad1.30x1.75mm_HandSolder; part_ipn R_270_1206_1%

Connections:
230V: C1.1, J1.7, R1.1
+3.3V: J1.5, J1.6, R5.1
+5V: J1.3, J1.4, R4.1
+24V: J1.2, R3.1
GND: D5.1 (K), D6.1 (K), D7.1 (K), J1.1
N: J1.8, R2.1
unnamed: D1.2 (A), D3.2 (A), D8.1 (K)
unnamed: C1.2, D1.1 (K), D2.2 (A), R1.2
unnamed: D2.1 (K), D4.1 (K), D8.2 (A)
unnamed: D3.1 (K), D4.2 (A), R2.2
unnamed: D5.2 (A), R5.2
unnamed: D6.2 (A), R3.2
unnamed: D7.2 (A), R4.2

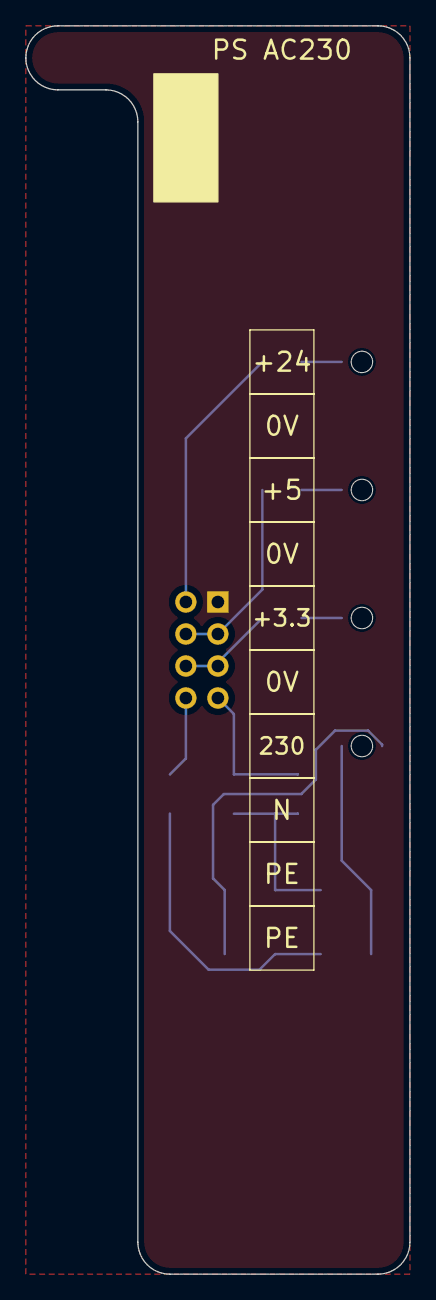
[picture p333: board PM-PS-AC230-front.kicad_pcb from above]

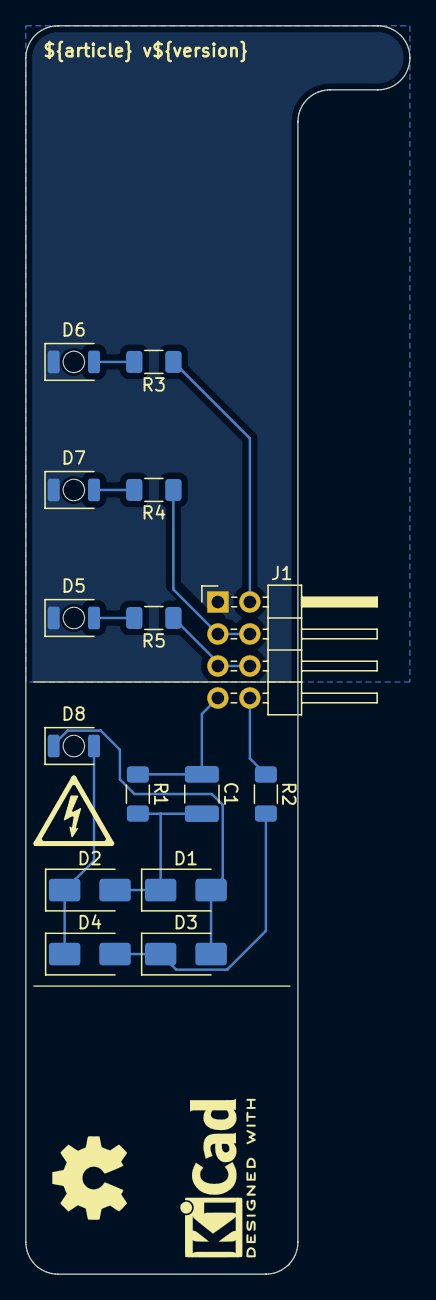
[picture p334: board PM-PS-AC230-front.kicad_pcb from below]

Board: 2 copper layers, 30.5 x 99.1 mm, 17 parts (17 on the bottom side), 13 nets.

Other parts of the board:
Logo_kicad: KiCad-Logo2_5mm_SilkScreen
logo_high_voltage: symbol_high_voltage
