Konstantin-Dudersky/plc-modules/PM-AI8-IU-front-10V/PM-AI8-IU-front-10V.kicad_pcb

## KiCad design PM-AI8-IU-front-10V/PM-AI8-IU-front-10V.kicad_pcb (2024-07-22)

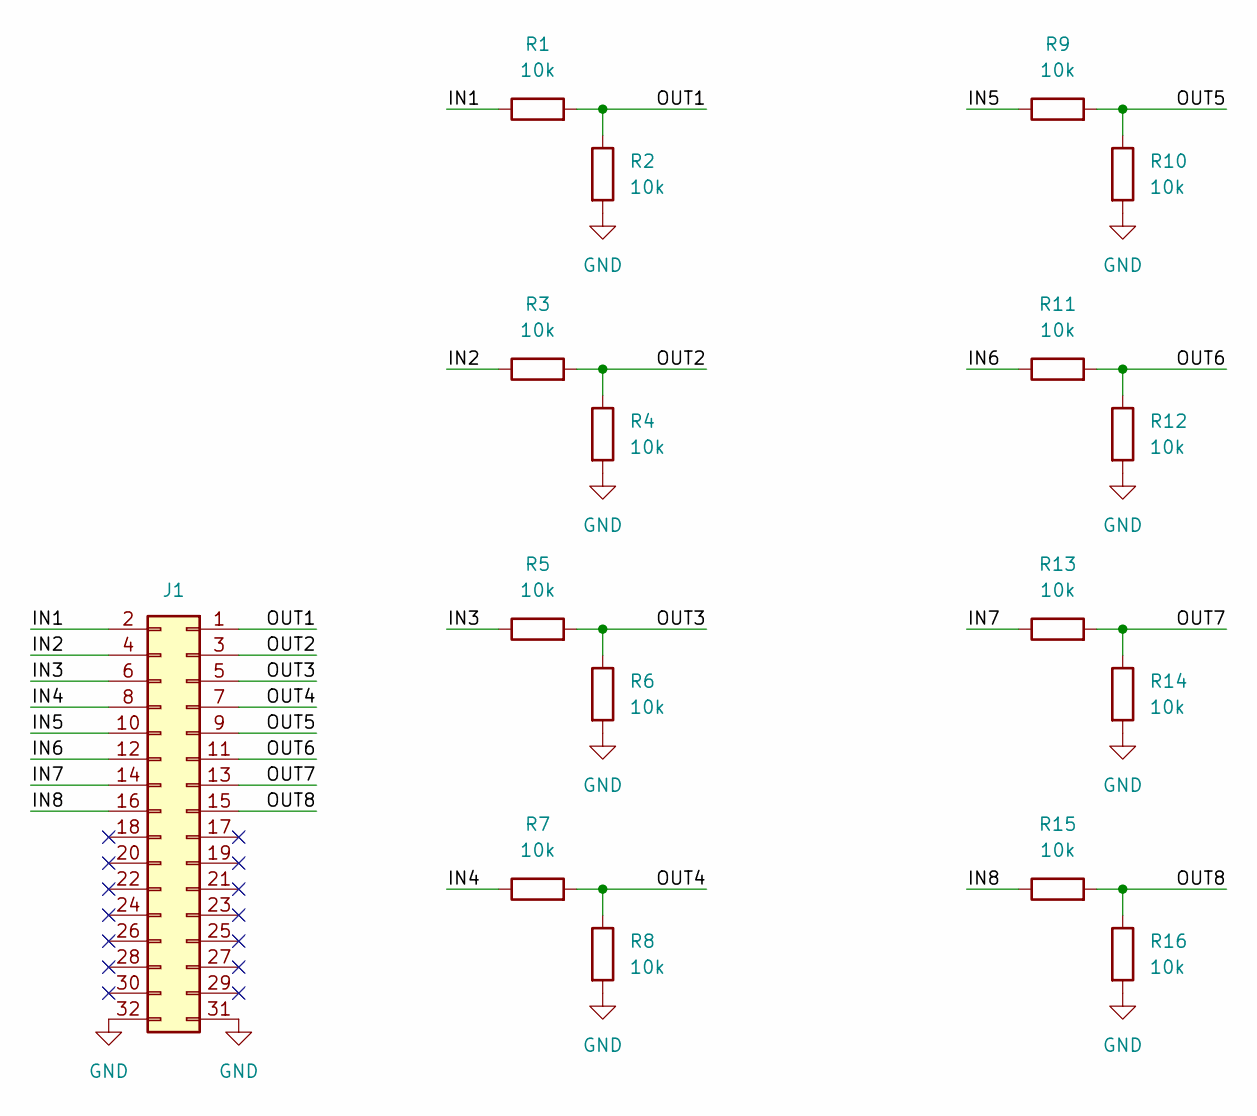
[picture p335: schematic PM-AI8-IU-front-10V.kicad_sch]

Parts:
J1: PinHeader P2.54 02x16 SMD Straight; PinHeader_2x16_P2.54mm_Vertical_SMD; part_ipn PinHeader P2.54 02x16 SMD Straight
R1, R2, R3, R4, R5, R6, R7, R8, R9, R10, R11, R12, R13, R14, R15, R16: 10k; R_1206_3216Metric_Pad1.30x1.75mm_HandSolder; part_ipn R_10k_1206_1%

Connections:
/IN1: J1.2, R1.1
/IN2: J1.4, R3.1
/IN3: J1.6, R5.1
/IN4: J1.8, R7.1
/IN5: J1.10, R9.1
/IN6: J1.12, R11.1
/IN7: J1.14, R13.1
/IN8: J1.16, R15.1
/OUT1: J1.1, R1.2, R2.1
/OUT2: J1.3, R3.2, R4.1
/OUT3: J1.5, R5.2, R6.1
/OUT4: J1.7, R7.2, R8.1
/OUT5: J1.9, R9.2, R10.1
/OUT6: J1.11, R11.2, R12.1
/OUT7: J1.13, R13.2, R14.1
/OUT8: J1.15, R15.2, R16.1
GND: J1.31, J1.32, R2.2, R4.2, R6.2, R8.2, R10.2, R12.2, R14.2, R16.2

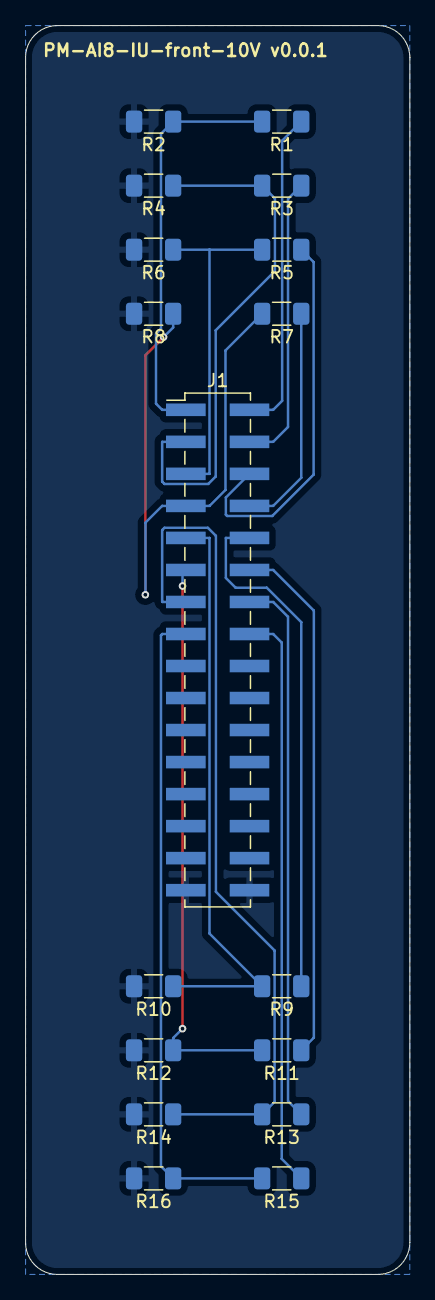
[picture p336: board PM-AI8-IU-front-10V.kicad_pcb from below]

Board: 2 copper layers, 30.5 x 99.1 mm, 17 parts (17 on the bottom side), 17 nets.
