Konstantin-Dudersky/plc-modules/PM-AI8-IU/PM-AI8-IU.kicad_pcb

## KiCad design PM-AI8-IU/PM-AI8-IU.kicad_pcb (2024-07-22)

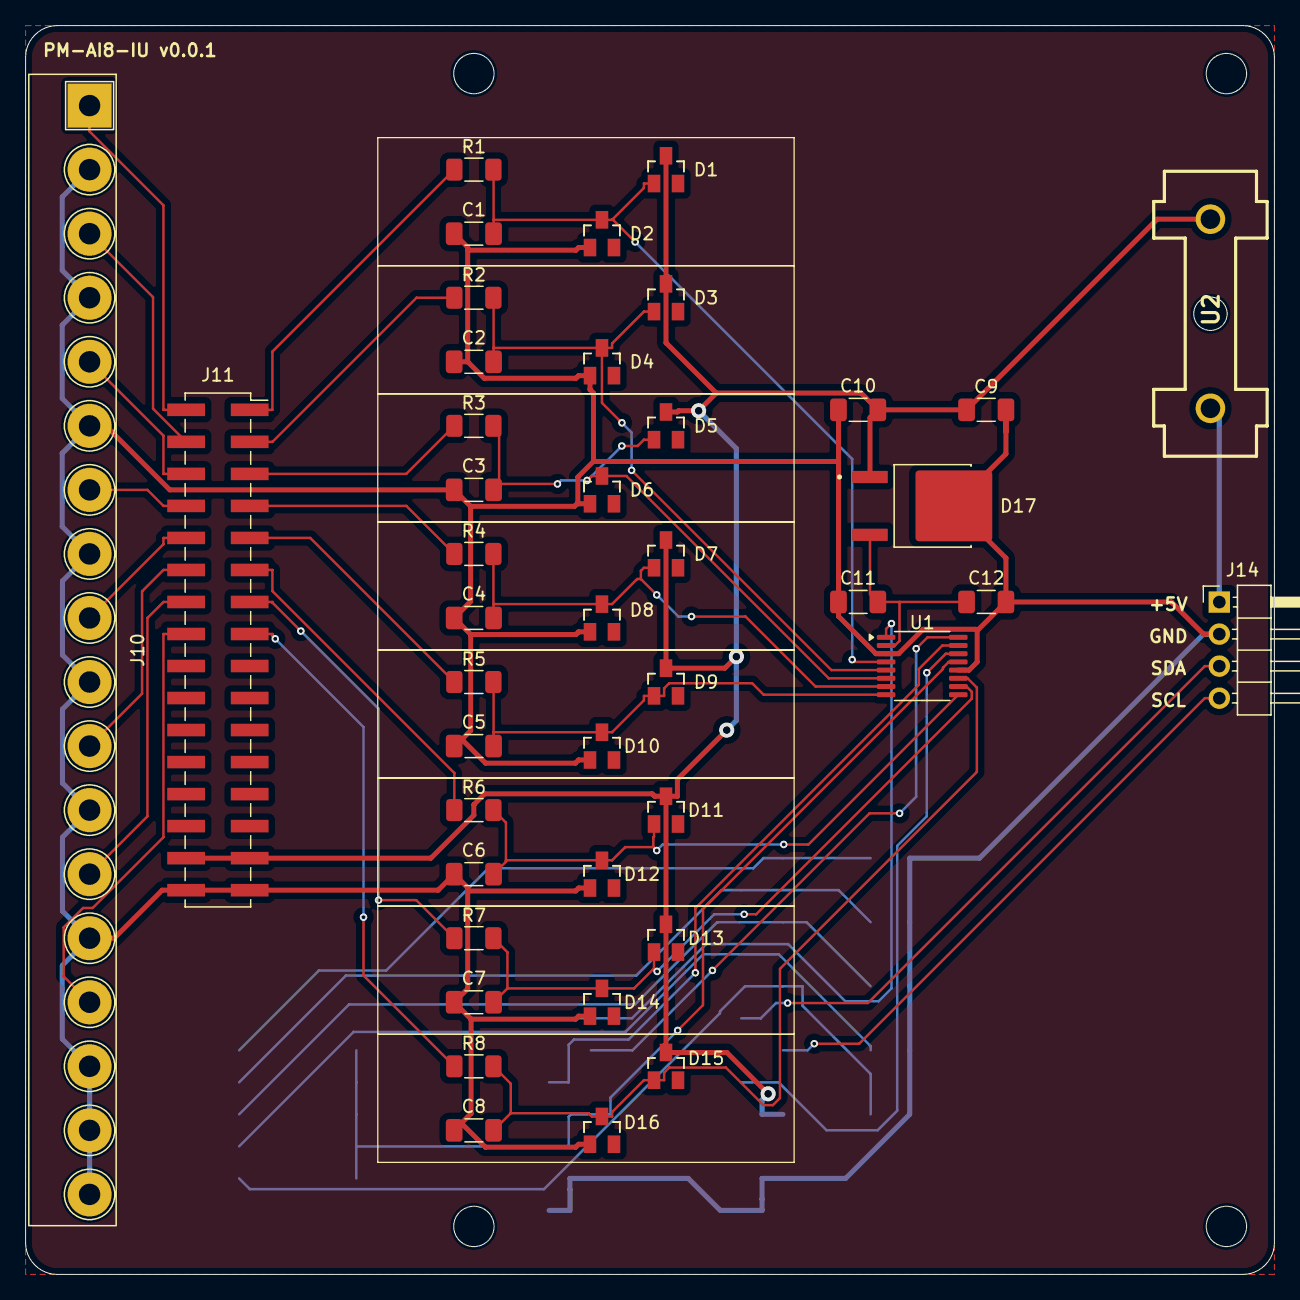
[picture p337: board PM-AI8-IU.kicad_pcb from above]

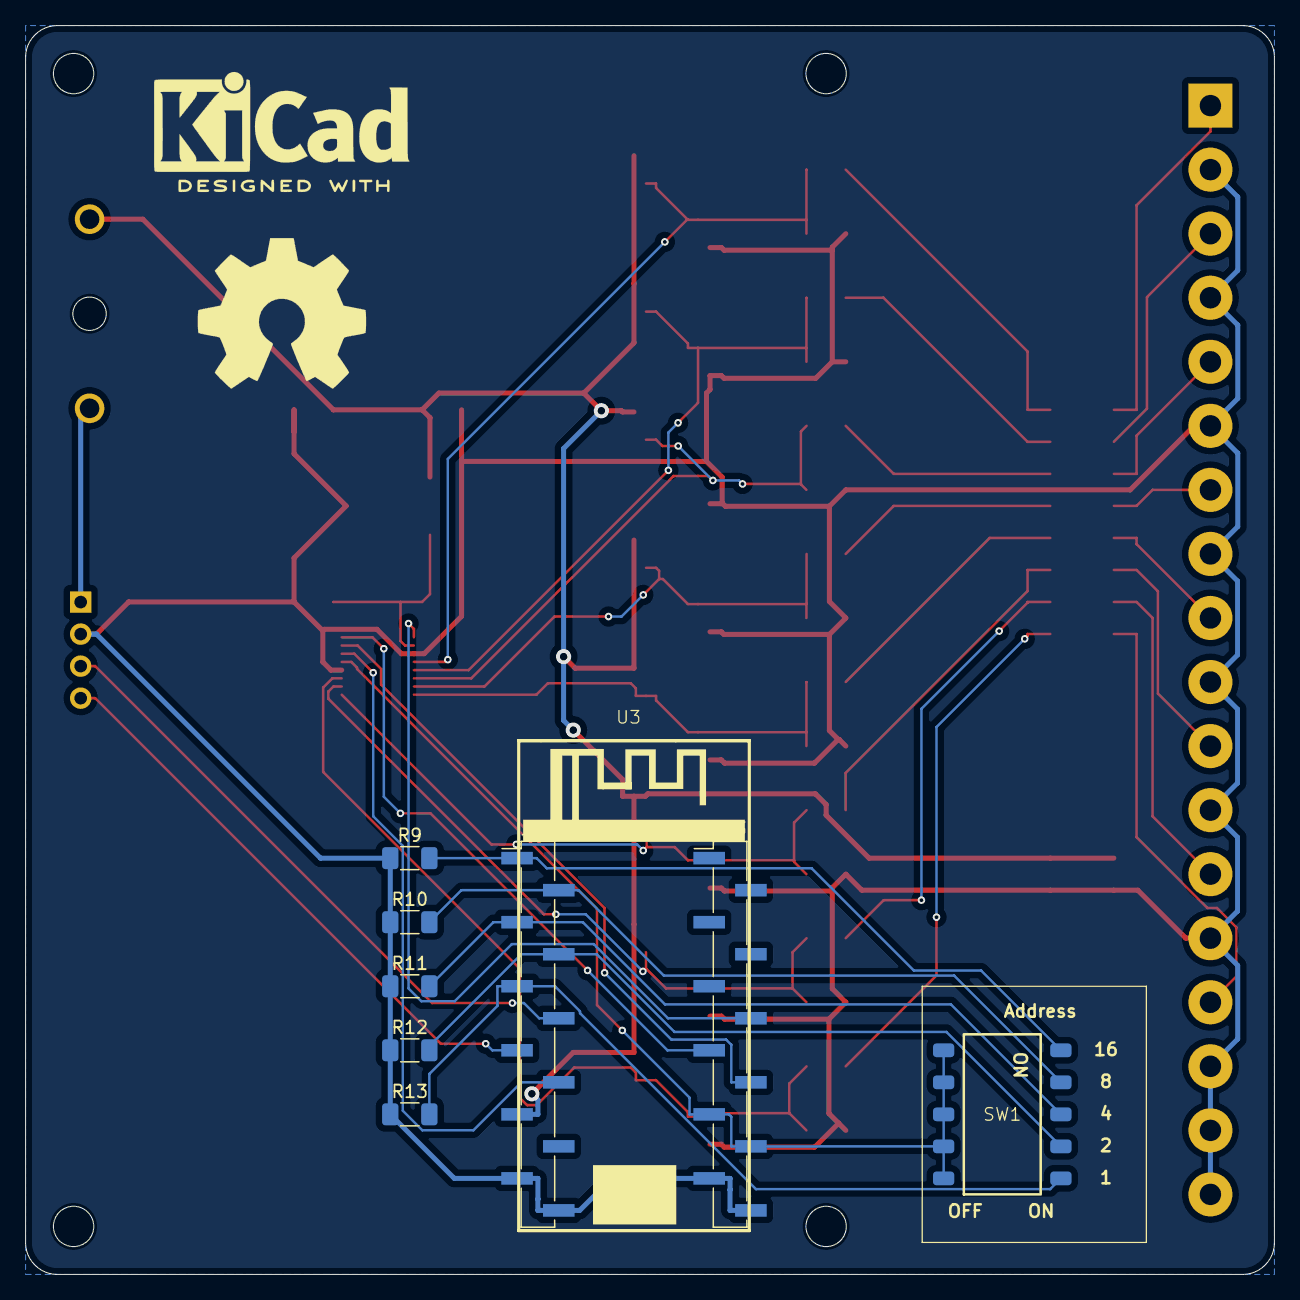
[picture p338: board PM-AI8-IU.kicad_pcb from below]

Board: 2 copper layers, 99.1 x 99.1 mm, 57 parts (11 on the bottom side), 40 nets.

Parts:
C1, C2, C3, C4, C5, C6, C7, C8: 33nF; C_1206_3216Metric_Pad1.33x1.80mm_HandSolder
C9, C11: 100nF 1206; C_1206_3216Metric_Pad1.33x1.80mm_HandSolder
C10, C12: 1uF 1206; C_1206_3216Metric_Pad1.33x1.80mm_HandSolder
D1, D2, D3, D4, D5, D6, D7, D8, D9, D10, D11, D12, D13, D14, D15, D16: BAT54; BAT54_SOT23
D17: LP2950CDT-5.0RKG
H1, H2, H3, H4: MountingHole; MountingHole_3.2mm_M3
J10: 2EDGR-5.08-18P; Degson_2EDGR-5.08-18P
J11: FemaleHeader P2.54 02x16 SMD Straight; PinSocket_2x16_P2.54mm_Vertical_SMD
J12, J13: PinHeader P2.54 01x12 SMD Straight; PinHeader_1x12_P2.54mm_Vertical_SMD_Pin1Left
J14: Conn_01x04_Pin; PinHeader_1x04_P2.54mm_Horizontal
R1, R2, R3, R4, R5, R6, R7, R8: 100; R_1206_3216Metric_Pad1.30x1.75mm_HandSolder
R9, R10, R11, R12, R13: 10k; R_1206_3216Metric_Pad1.30x1.75mm_HandSolder
SW1: DSIC05LS-P
U1: ADC128S102CIMT; TSSOP-16_4.4x5mm_P0.65mm
U2: 64900001039; Fuseholder
U3: Weact ESP32-C3FH4
logo_kicad: KiCad-Logo2_8mm_SilkScreen
logo_oshw: OSHW-Symbol_13.4x12mm_SilkScreen

Connections:
+3.3V: J13.9, J13.10, SW1.6, SW1.7, SW1.8, SW1.9, SW1.10, U1.13 (DVCC)
+5V: C9.1, C10.1, D1.3, D3.3, D5.3, D7.3, D9.3, D11.3, D13.3, D15.3, D17.1 (In), J11.29, J11.30, J12.9, U2.1
/AIN0: C1.1, D1.1, D2.3, R1.2, U1.4 (IN0)
/AIN1: C2.1, D3.1, D4.3, R2.2, U1.5 (IN1)
/AIN2: C3.1, D5.1, D6.3, R3.2, U1.6 (IN2)
/AIN3: C4.1, D7.1, D8.3, R4.2, U1.7 (IN3)
/AIN4: C5.1, D9.1, D10.3, R5.2, U1.8 (IN4)
/AIN5: C6.1, D11.1, D12.3, R6.2, U1.9 (IN5)
/AIN6: C7.1, D13.1, D14.3, R7.2, U1.10 (IN6)
/AIN7: C8.1, D15.1, D16.3, R8.2, U1.11 (IN7)
/AVCC: C11.1, C12.1, D17.3 (Out), U1.2 (AVCC)
/CLK: J13.7, U1.16 (SCLK)
/CS: J13.6, U1.1 (~CS)
/MISO: J13.8, U1.15 (DOUT)
/MOSI: J12.8, U1.14 (DIN)
/SCL: J12.7, J14.4
/SDA: J12.6, J14.3
GND: C1.2, C2.2, C3.2, C4.2, C5.2, C6.2, C7.2, C8.2, C9.2, C10.2, C11.2, C12.2, D2.1, D4.1, D6.1, D8.1, D10.1, D12.1, D14.1, D16.1, D17.4 (Gnd), J10.2, J10.4, J10.6, J10.8, J10.10, J10.12, J10.14, J10.16, J10.17, J10.18, J11.31, J11.32, J12.11, J12.12, J13.11, J13.12, J14.2, R9.1, R10.1, R11.1, R12.1, R13.1, U1.3 (AGND), U1.12 (DGND)
unnamed: J10.1, J11.2
unnamed: J10.3, J11.4
unnamed: J10.5, J11.6
unnamed: J10.7, J11.8
unnamed: J10.9, J11.10
unnamed: J10.11, J11.12
unnamed: J10.13, J11.14
unnamed: J10.15, J11.16
unnamed: J11.1, R1.1
unnamed: J11.3, R2.1
unnamed: J11.5, R3.1
unnamed: J11.7, R4.1
unnamed: J11.9, R5.1
unnamed: J11.11, R6.1
unnamed: J11.13, R7.1
unnamed: J11.15, R8.1
unnamed: J12.1, R9.2, SW1.5
unnamed: J12.2, R10.2, SW1.4
unnamed: J12.3, R11.2, SW1.3
unnamed: J12.4, R12.2, SW1.2
unnamed: J12.5, R13.2, SW1.1
unnamed: J14.1, U2.2
