Konstantin-Dudersky/plc-modules/PM-DI16/PM-DI16.kicad_pcb

## KiCad design PM-DI16/PM-DI16.kicad_pcb (2024-07-22)

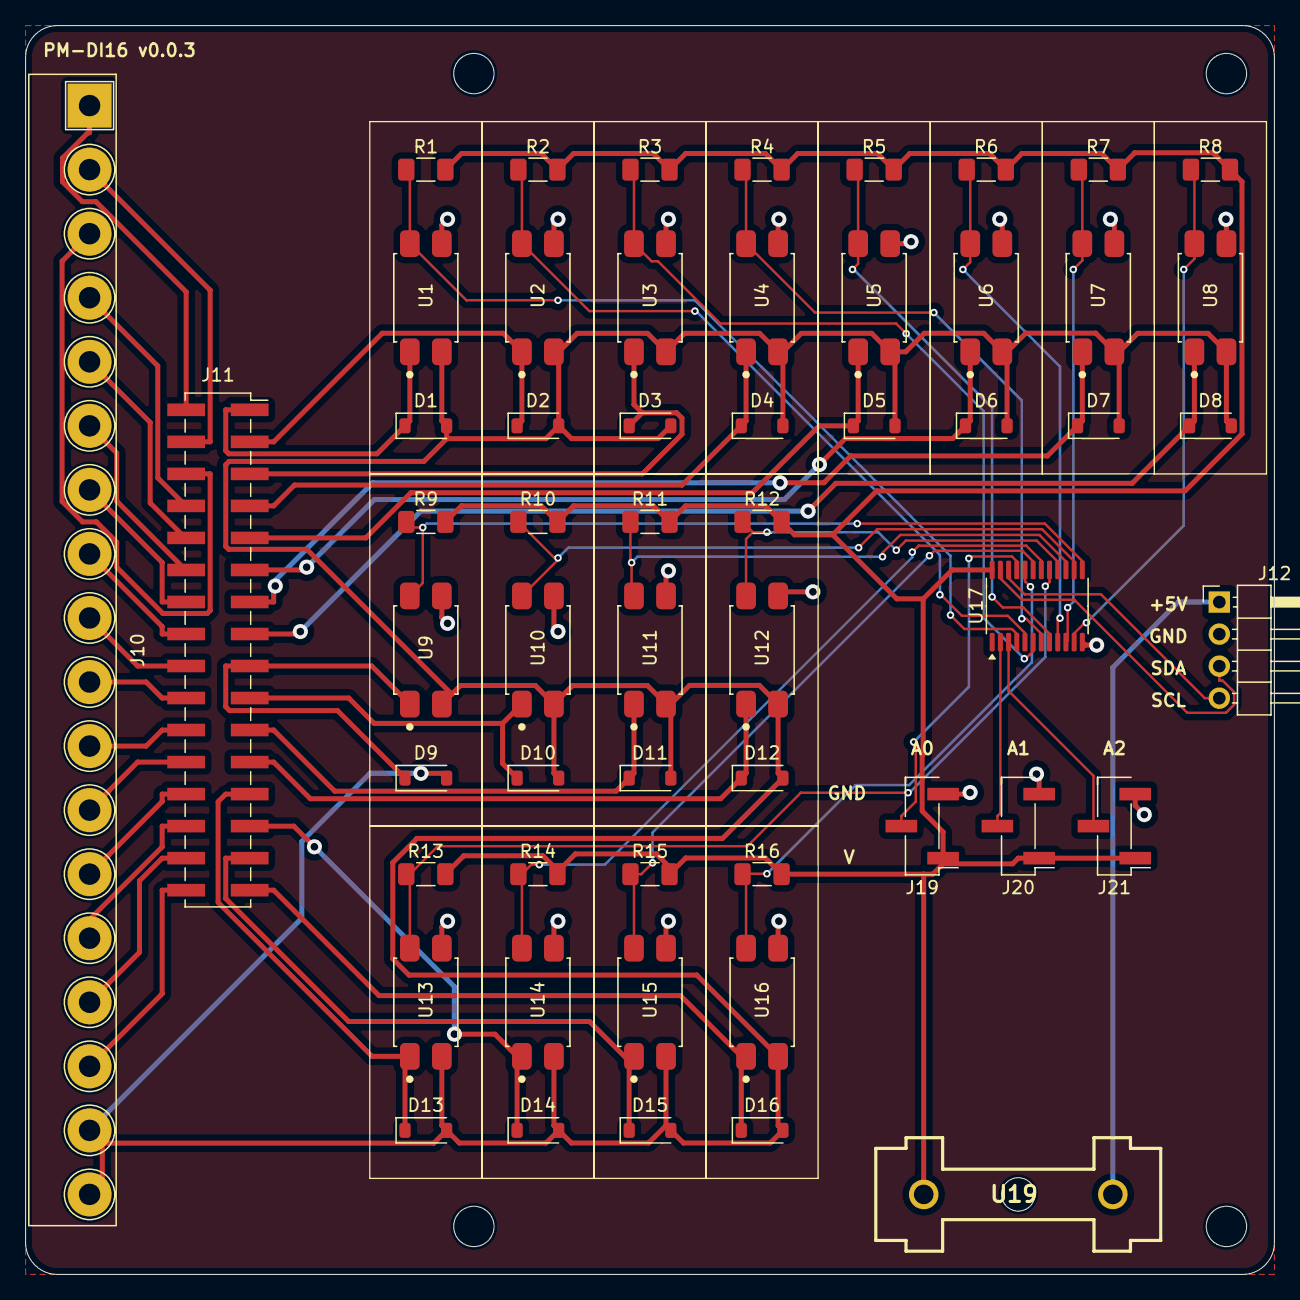
[picture p339: board PM-DI16.kicad_pcb from above]

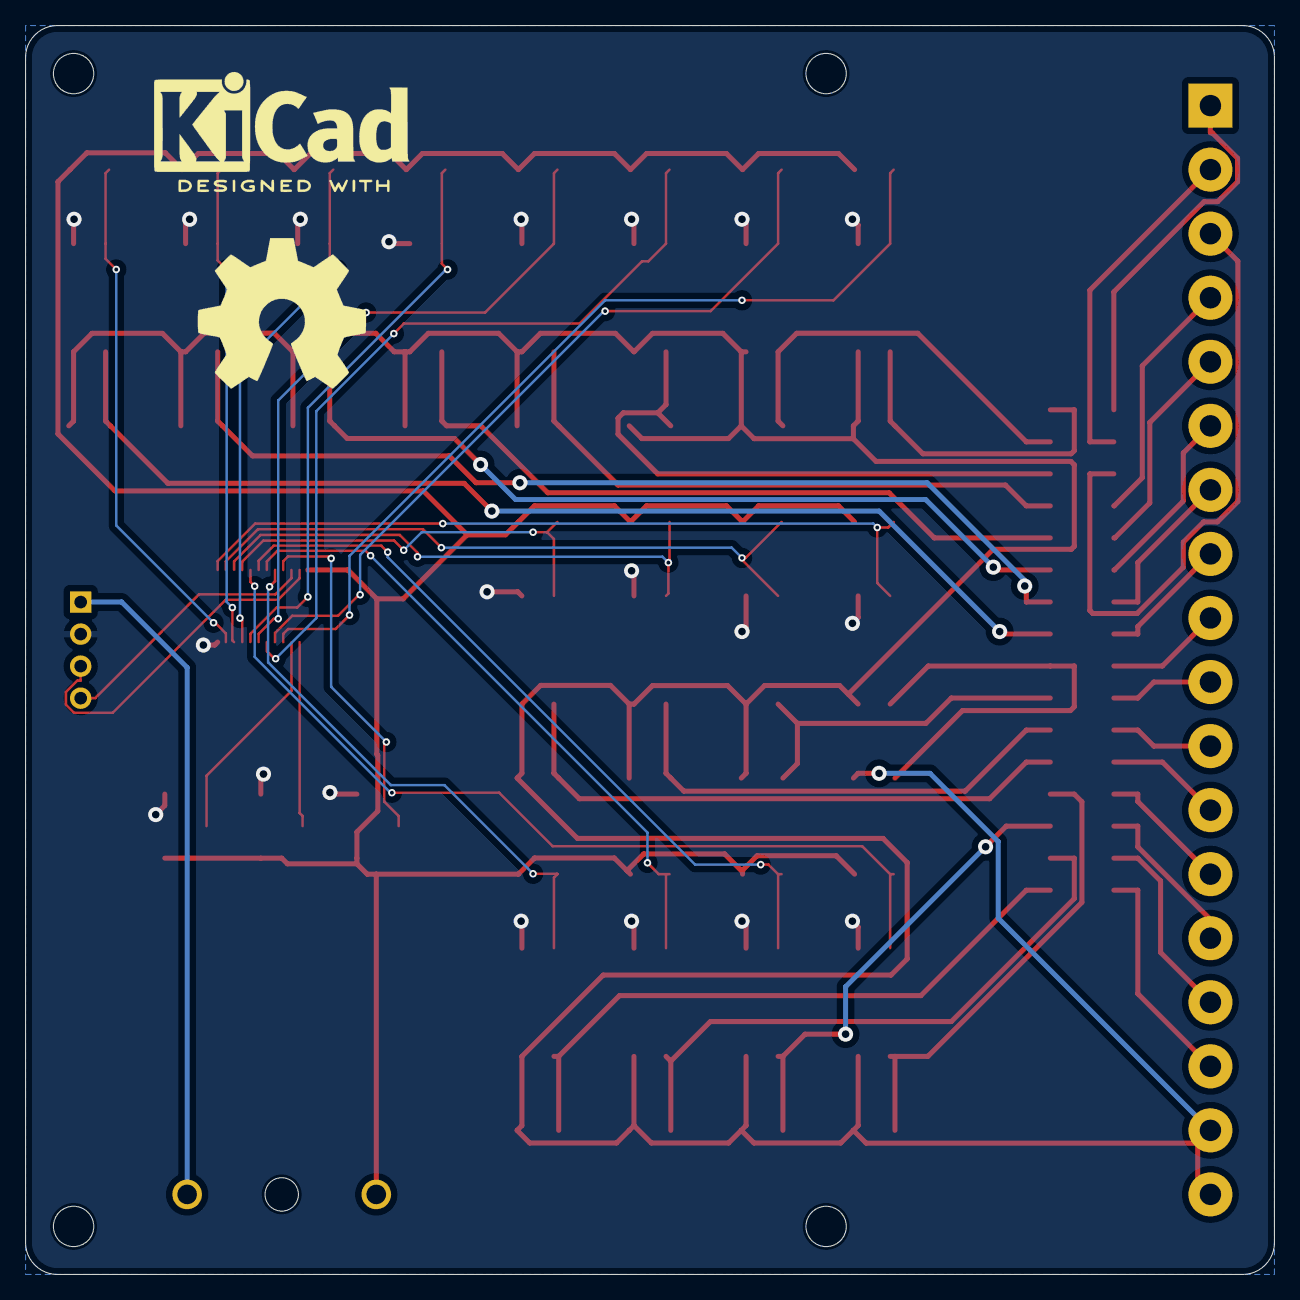
[picture p340: board PM-DI16.kicad_pcb from below]

Board: 2 copper layers, 99.1 x 99.1 mm, 62 parts (2 on the bottom side), 57 nets.

Parts:
D1, D2, D3, D4, D5, D6, D7, D8, D9, D10, D11, D12, D13, D14, D15, D16: 1N4148W; D_SOD-123
H1, H2, H3, H4: MountingHole; MountingHole_3.2mm_M3
J10: 2EDGR-5.08-18P; Degson_2EDGR-5.08-18P
J11: FemaleHeader P2.54 02x16 SMD Straight; Conn_02x16_socket
J12: Conn_01x04_Pin; PinHeader_1x04_P2.54mm_Horizontal
J19, J20, J21: PinHeader_P2.54_01x03_SMD_Straight; PinHeader_1x03_P2.54mm_Vertical_SMD_Pin1Left
R1, R2, R3, R4, R5, R6, R7, R8, R9, R10, R11, R12, R13, R14, R15, R16: 10k; R_1206_3216Metric_Pad1.30x1.75mm_HandSolder
U1, U2, U3, U4, U5, U6, U7, U8, U9, U10, U11, U12, U13, U14, U15, U16: PC817C; PC817XI_SOIC254P975X460-4N
U17: PCA9555PW; TSSOP-24_4.4x7.8mm_P0.65mm
U19: 64900001039; Fuseholder
logo_kicad: KiCad-Logo2_8mm_SilkScreen
logo_oshw: OSHW-Symbol_13.4x12mm_SilkScreen

Connections:
/A0: J19.2, U17.21 (A0)
/A1: J20.2, U17.2 (A1)
/A2: J21.2, U17.3 (A2)
/M: D1.2 (A), D2.2 (A), D3.2 (A), D4.2 (A), D5.2 (A), D6.2 (A), D7.2 (A), D8.2 (A), D9.2 (A), D10.2 (A), D11.2 (A), D12.2 (A), D13.2 (A), D14.2 (A), D15.2 (A), D16.2 (A), J10.17, J10.18, U1.2, U2.2, U3.2, U4.2, U5.2, U6.2, U7.2, U8.2, U9.2, U10.2, U11.2, U12.2, U13.2, U14.2, U15.2, U16.2
/SCL: J12.4, U17.22 (SCL)
/SDA: J12.3, U17.23 (SDA)
GND: J12.2, J19.3, J20.3, J21.3, U1.3, U2.3, U3.3, U4.3, U5.3, U6.3, U7.3, U8.3, U9.3, U10.3, U11.3, U12.3, U13.3, U14.3, U15.3, U16.3, U17.12 (VSS)
unnamed: D1.1 (K), J11.1, U1.1
unnamed: D2.1 (K), J11.3, U2.1
unnamed: D3.1 (K), J11.5, U3.1
unnamed: D4.1 (K), J11.7, U4.1
unnamed: D5.1 (K), J11.9, U5.1
unnamed: D6.1 (K), J11.11, U6.1
unnamed: D7.1 (K), J11.13, U7.1
unnamed: D8.1 (K), J11.15, U8.1
unnamed: D9.1 (K), J11.17, U9.1
unnamed: D10.1 (K), J11.19, U10.1
unnamed: D11.1 (K), J11.21, U11.1
unnamed: D12.1 (K), J11.23, U12.1
unnamed: D13.1 (K), J11.25, U13.1
unnamed: D14.1 (K), J11.27, U14.1
unnamed: D15.1 (K), J11.29, U15.1
unnamed: D16.1 (K), J11.31, U16.1
unnamed: J10.1, J11.2
unnamed: J10.2, J11.4
unnamed: J10.3, J11.6
unnamed: J10.4, J11.8
unnamed: J10.5, J11.10
unnamed: J10.6, J11.12
unnamed: J10.7, J11.14
unnamed: J10.8, J11.16
unnamed: J10.9, J11.18
unnamed: J10.10, J11.20
unnamed: J10.11, J11.22
unnamed: J10.12, J11.24
unnamed: J10.13, J11.26
unnamed: J10.14, J11.28
unnamed: J10.15, J11.30
unnamed: J10.16, J11.32
unnamed: J12.1, U19.2
unnamed: R1.1, U1.4, U17.4 (IO0_0)
unnamed: R2.1, U2.4, U17.5 (IO0_1)
unnamed: R3.1, U3.4, U17.6 (IO0_2)
unnamed: R4.1, U4.4, U17.7 (IO0_3)
unnamed: R5.1, U5.4, U17.8 (IO0_4)
unnamed: R6.1, U6.4, U17.9 (IO0_5)
unnamed: R7.1, U7.4, U17.10 (IO0_6)
unnamed: R8.1, U8.4, U17.11 (IO0_7)
unnamed: R9.1, U9.4, U17.13 (IO1_0)
unnamed: R10.1, U10.4, U17.14 (IO1_1)
unnamed: R11.1, U11.4, U17.15 (IO1_2)
unnamed: R12.1, U12.4, U17.16 (IO1_3)
unnamed: R13.1, U13.4, U17.17 (IO1_4)
unnamed: R14.1, U14.4, U17.18 (IO1_5)
unnamed: R15.1, U15.4, U17.19 (IO1_6)
unnamed: R16.1, U16.4, U17.20 (IO1_7)
VDD: J19.1, J20.1, J21.1, R1.2, R2.2, R3.2, R4.2, R5.2, R6.2, R7.2, R8.2, R9.2, R10.2, R11.2, R12.2, R13.2, R14.2, R15.2, R16.2, U17.24 (VDD), U19.1
