Konstantin-Dudersky/plc-modules/PM-AI8-IU-front-20mA/PM-AI8-IU-front-20mA.kicad_pcb

## KiCad design PM-AI8-IU-front-20mA/PM-AI8-IU-front-20mA.kicad_pcb (2024-07-22)

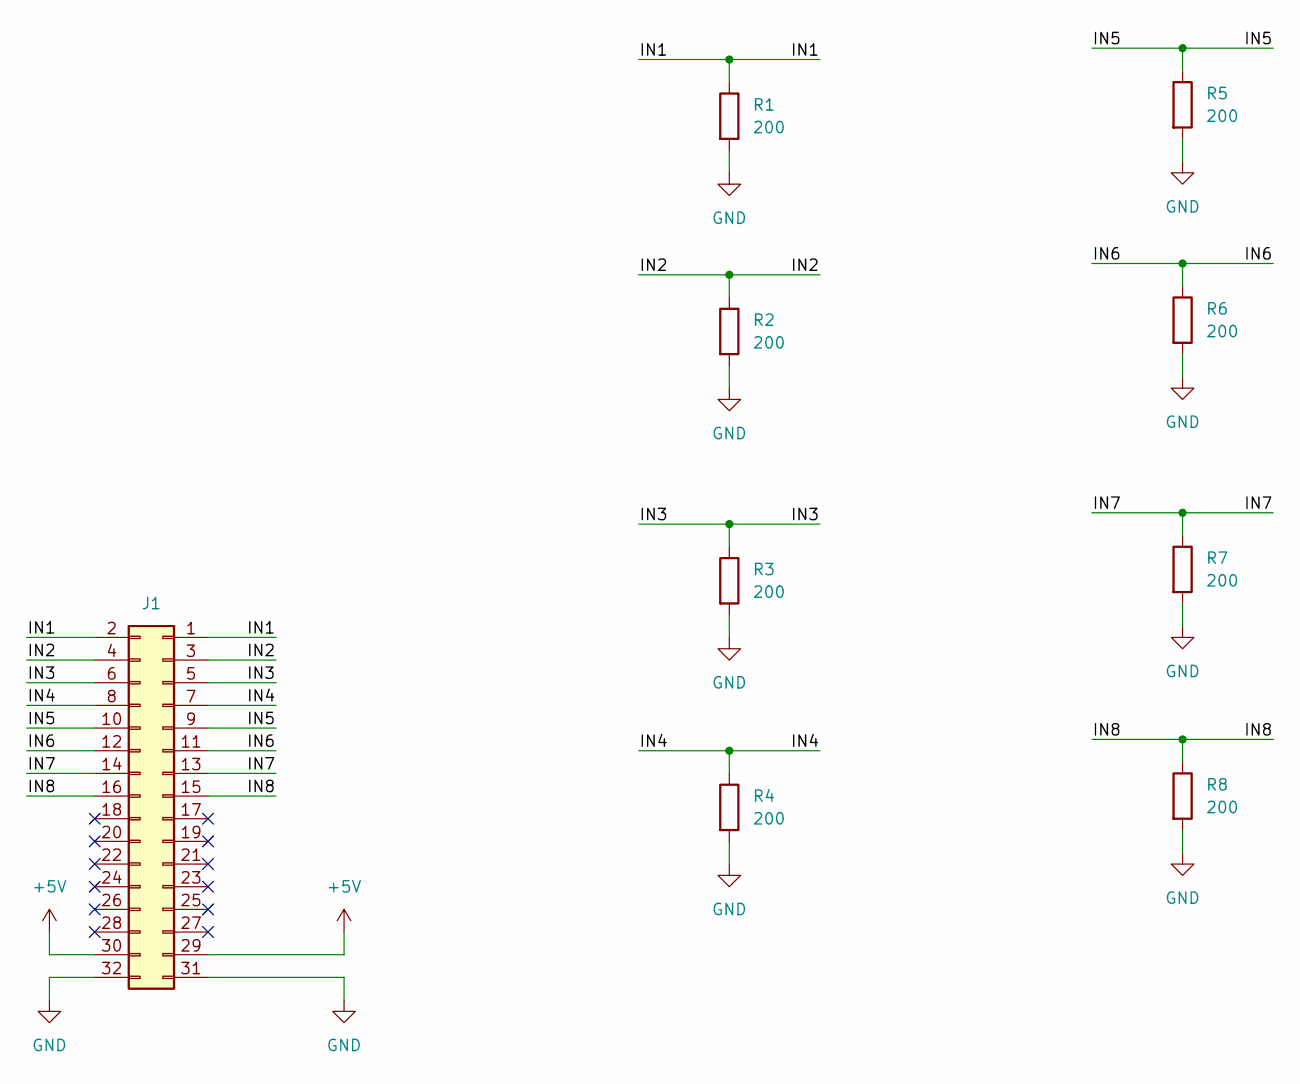
[picture p341: schematic PM-AI8-IU-front-20mA.kicad_sch]

Parts:
J1: PinHeader P2.54 02x16 SMD Straight; PinHeader_2x16_P2.54mm_Vertical_SMD; part_ipn PinHeader P2.54 02x16 SMD Straight
R1, R2, R3, R4, R5, R6, R7, R8: 200; R_1206_3216Metric_Pad1.30x1.75mm_HandSolder; part_ipn R_200_1206_0.1%

Connections:
+5V: J1.29, J1.30
/IN1: J1.1, J1.2, R1.1
/IN2: J1.3, J1.4, R2.1
/IN3: J1.5, J1.6, R3.1
/IN4: J1.7, J1.8, R4.1
/IN5: J1.9, J1.10, R5.1
/IN6: J1.11, J1.12, R6.1
/IN7: J1.13, J1.14, R7.1
/IN8: J1.15, J1.16, R8.1
GND: J1.31, J1.32, R1.2, R2.2, R3.2, R4.2, R5.2, R6.2, R7.2, R8.2

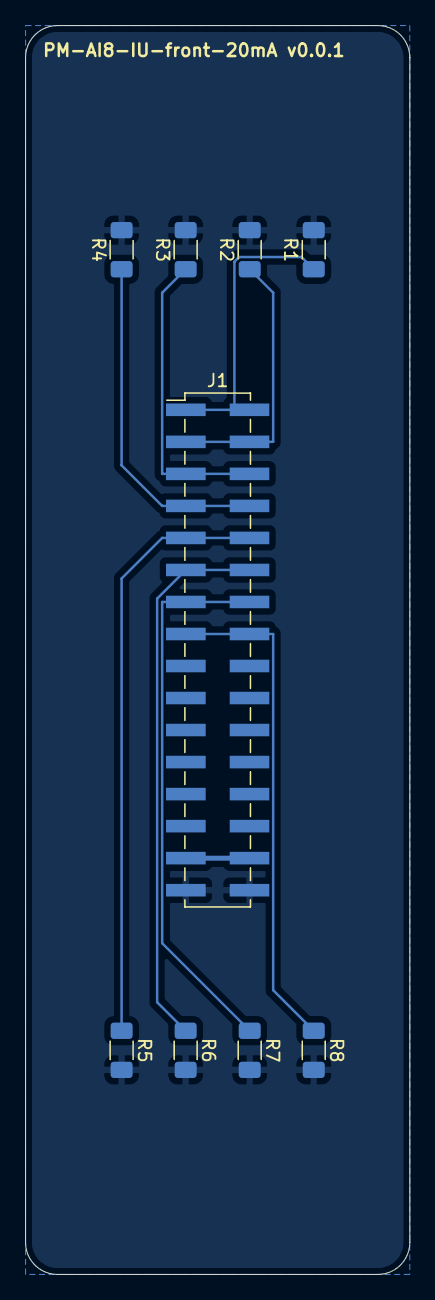
[picture p342: board PM-AI8-IU-front-20mA.kicad_pcb from below]

Board: 2 copper layers, 30.5 x 99.1 mm, 9 parts (9 on the bottom side), 10 nets.
