Konstantin-Dudersky/plc-modules/PM-DI16-front-DC24/PM-DI16-front-DC24.kicad_pcb

## KiCad design PM-DI16-front-DC24/PM-DI16-front-DC24.kicad_pcb (2024-07-15)

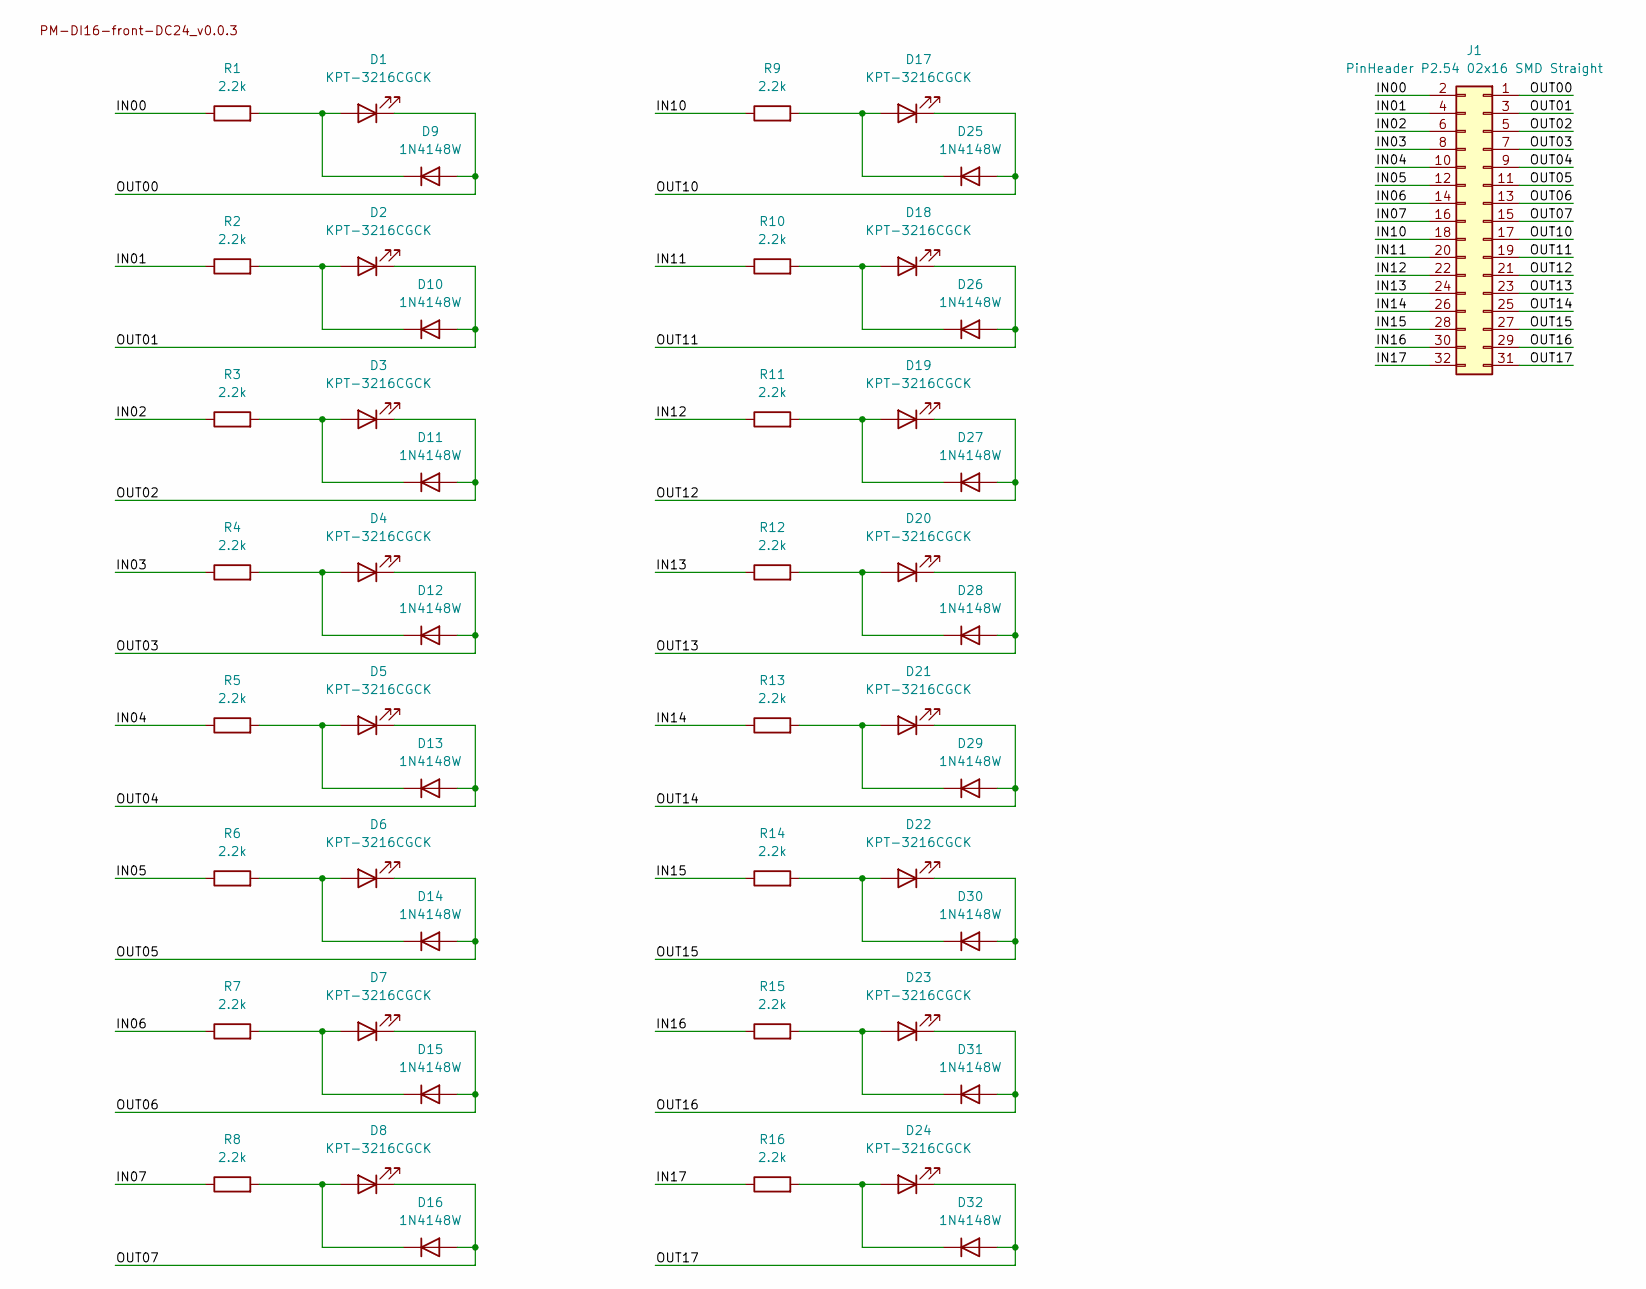
[picture p343: schematic PM-DI16-front-DC24.kicad_sch, Модуль PM-DI16-front-DC24]

Parts:
D1, D2, D3, D4, D5, D6, D7, D8, D17, D18, D19, D20, D21, D22, D23, D24: KPT-3216CGCK; Kingbright_KPT-3216CGCK; part_ipn KPT-3216CGCK
D9, D10, D11, D12, D13, D14, D15, D16, D25, D26, D27, D28, D29, D30, D31, D32: 1N4148W; D_SOD-123; MfrPart 1N4148W
J1: PinHeader P2.54 02x16 SMD Straight; Conn_02x16_pin; part_ipn PinHeader P2.54 02x16 SMD Straight
PCB1: part_ipn PM-DI16-front-DC24_v0.0.3
R1, R2, R3, R4, R5, R6, R7, R8, R9, R10, R11, R12, R13, R14, R15, R16: 2.2k; R_2512_6332Metric_Pad1.40x3.35mm_HandSolder; part_ipn R_2k2_2512_1%

Connections:
/IN00: J1.2, R1.1
/IN01: J1.4, R2.1
/IN02: J1.6, R3.1
/IN03: J1.8, R4.1
/IN04: J1.10, R5.1
/IN05: J1.12, R6.1
/IN06: J1.14, R7.1
/IN07: J1.16, R8.1
/IN10: J1.18, R9.1
/IN11: J1.20, R10.1
/IN12: J1.22, R11.1
/IN13: J1.24, R12.1
/IN14: J1.26, R13.1
/IN15: J1.28, R14.1
/IN16: J1.30, R15.1
/IN17: J1.32, R16.1
/OUT00: D1.1 (K), D9.2 (A), J1.1
/OUT01: D2.1 (K), D10.2 (A), J1.3
/OUT02: D3.1 (K), D11.2 (A), J1.5
/OUT03: D4.1 (K), D12.2 (A), J1.7
/OUT04: D5.1 (K), D13.2 (A), J1.9
/OUT05: D6.1 (K), D14.2 (A), J1.11
/OUT06: D7.1 (K), D15.2 (A), J1.13
/OUT07: D8.1 (K), D16.2 (A), J1.15
/OUT10: D17.1 (K), D25.2 (A), J1.17
/OUT11: D18.1 (K), D26.2 (A), J1.19
/OUT12: D19.1 (K), D27.2 (A), J1.21
/OUT13: D20.1 (K), D28.2 (A), J1.23
/OUT14: D21.1 (K), D29.2 (A), J1.25
/OUT15: D22.1 (K), D30.2 (A), J1.27
/OUT16: D23.1 (K), D31.2 (A), J1.29
/OUT17: D24.1 (K), D32.2 (A), J1.31
unnamed: D1.2 (A), D9.1 (K), R1.2
unnamed: D2.2 (A), D10.1 (K), R2.2
unnamed: D3.2 (A), D11.1 (K), R3.2
unnamed: D4.2 (A), D12.1 (K), R4.2
unnamed: D5.2 (A), D13.1 (K), R5.2
unnamed: D6.2 (A), D14.1 (K), R6.2
unnamed: D7.2 (A), D15.1 (K), R7.2
unnamed: D8.2 (A), D16.1 (K), R8.2
unnamed: D17.2 (A), D25.1 (K), R9.2
unnamed: D18.2 (A), D26.1 (K), R10.2
unnamed: D19.2 (A), D27.1 (K), R11.2
unnamed: D20.2 (A), D28.1 (K), R12.2
unnamed: D21.2 (A), D29.1 (K), R13.2
unnamed: D22.2 (A), D30.1 (K), R14.2
unnamed: D23.2 (A), D31.1 (K), R15.2
unnamed: D24.2 (A), D32.1 (K), R16.2

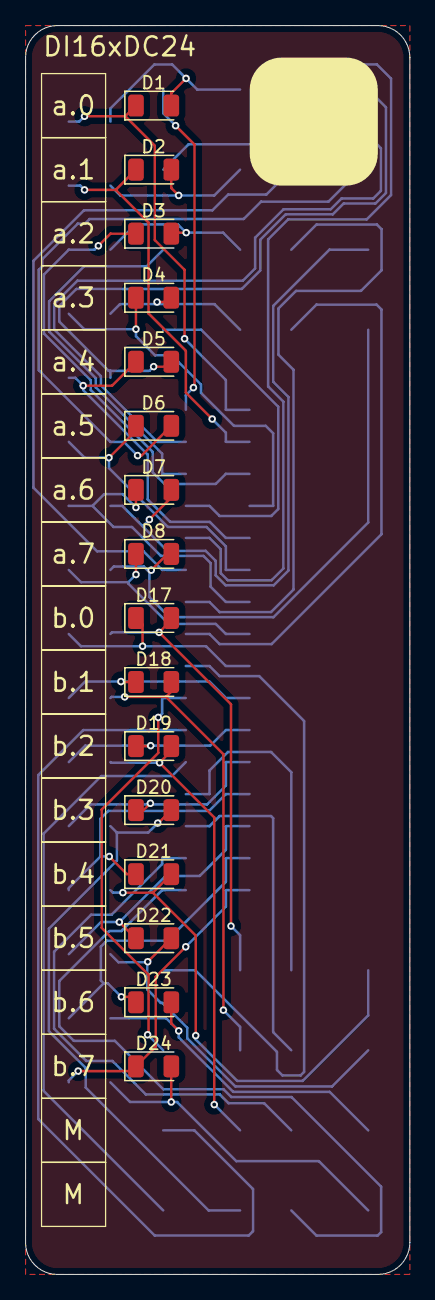
[picture p344: board PM-DI16-front-DC24.kicad_pcb from above]

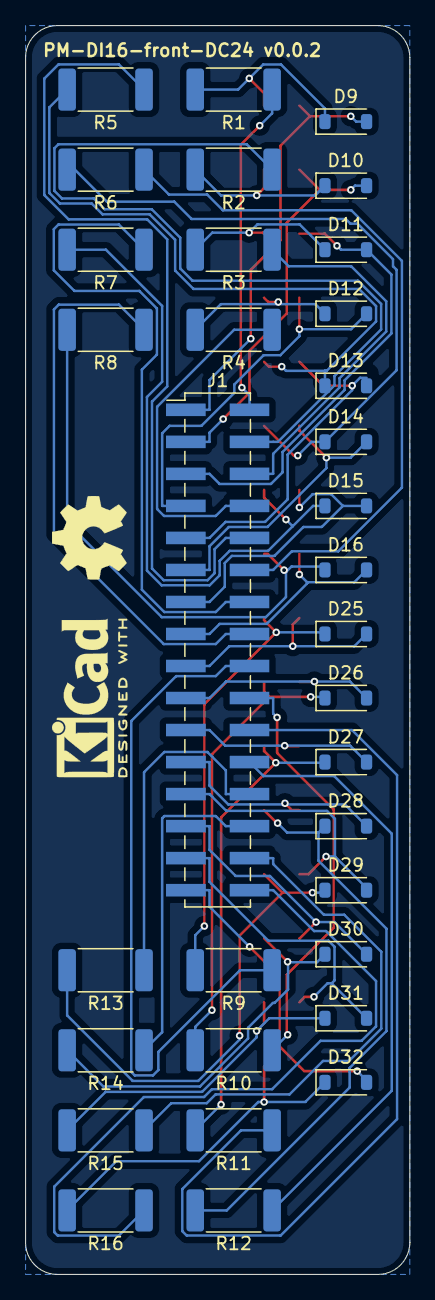
[picture p345: board PM-DI16-front-DC24.kicad_pcb from below]

Board: 2 copper layers, 30.5 x 99.1 mm, 50 parts (34 on the bottom side), 48 nets.

Other parts of the board:
Logo_kicad: KiCad-Logo2_5mm_SilkScreen
