Konstantin-Dudersky/plc-modules/DI8/DI8.kicad_pcb

## KiCad design DI8/DI8.kicad_pcb (2024-04-23)

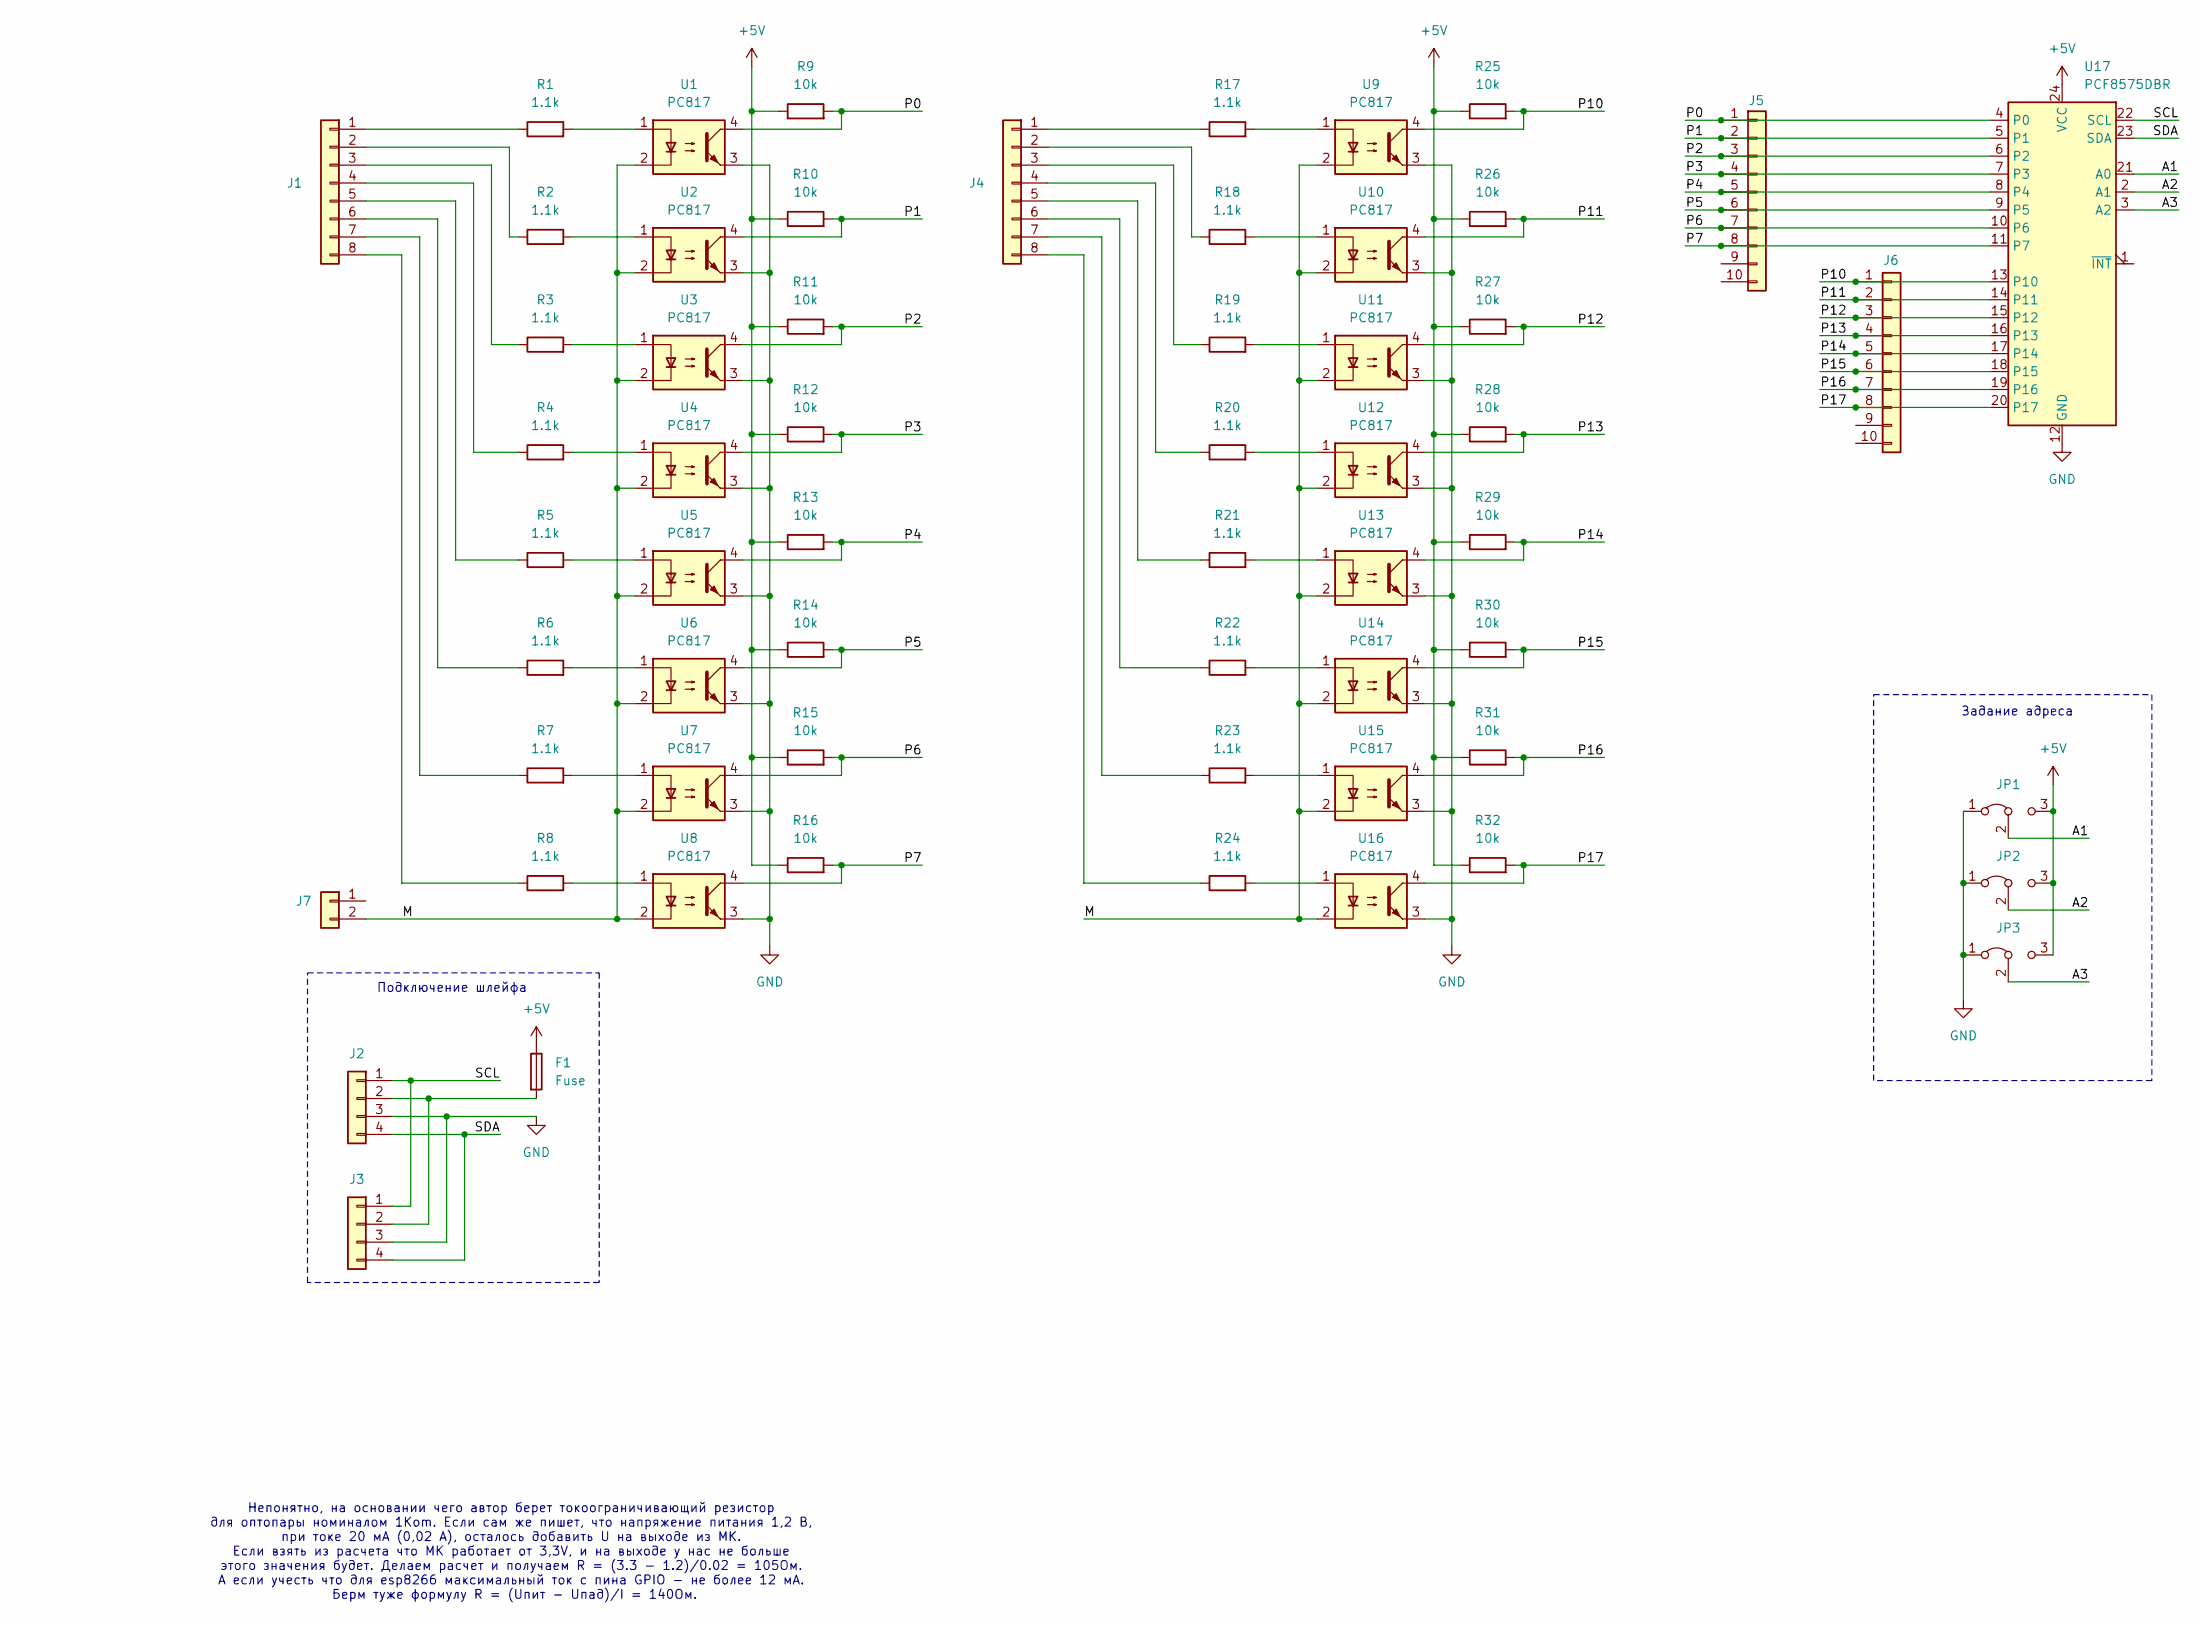
[picture p346: schematic DI8.kicad_sch]

Parts:
F1: Fuse; Fuseholder_Cylinder-5x20mm_Schurter_0031_8201_Horizontal_Op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
J1, J4: Conn_01x08; TerminalBlock_Phoenix_MKDS-1,5-8-5.08_1x08_P5.08mm_Horizont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
J2, J3: Conn_01x04; PinHeader_1x04_P2.54mm_Horizontal
J5, J6: Conn_01x10; PinHeader_1x10_P2.54mm_Vertical
J7: Conn_01x02; TerminalBlock_Phoenix_MKDS-1,5-2-5.08_1x02_P5.08mm_Horizont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
JP1, JP2, JP3: Jumper_3_Bridged12; PinHeader_1x03_P2.54mm_Vertical
R1, R2, R3, R4, R5, R6, R7, R8, R17, R18, R19, R20, R21, R22, R23, R24: 1.1k; R_Axial_DIN0207_L6.3mm_D2.5mm_P10.16mm_Horizontal
R9, R10, R11, R12, R13, R14, R15, R16, R25, R26, R27, R28, R29, R30, R31, R32: 10k; R_Axial_DIN0207_L6.3mm_D2.5mm_P10.16mm_Horizontal
U1, U2, U3, U4, U5, U6, U7, U8, U9, U10, U11, U12, U13, U14, U15, U16: PC817; DIP-4_W7.62mm
U17: PCF8575DBR; SSOP-24_5.3x8.2mm_P0.65mm

Connections:
+5V: F1.1, JP1.3 (B), JP2.3 (B), JP3.3 (B), R9.1, R10.1, R11.1, R12.1, R13.1, R14.1, R15.1, R16.1, R25.1, R26.1, R27.1, R28.1, R29.1, R30.1, R31.1, R32.1, U17.24 (VCC)
/A1: JP1.2 (C), U17.21 (A0)
/A2: JP2.2 (C), U17.2 (A1)
/A3: JP3.2 (C), U17.3 (A2)
/M: J7.2, U1.2, U2.2, U3.2, U4.2, U5.2, U6.2, U7.2, U8.2, U9.2, U10.2, U11.2, U12.2, U13.2, U14.2, U15.2, U16.2
/P0: J5.1, R9.2, U1.4, U17.4 (P0)
/P1: J5.2, R10.2, U2.4, U17.5 (P1)
/P2: J5.3, R11.2, U3.4, U17.6 (P2)
/P3: J5.4, R12.2, U4.4, U17.7 (P3)
/P4: J5.5, R13.2, U5.4, U17.8 (P4)
/P5: J5.6, R14.2, U6.4, U17.9 (P5)
/P6: J5.7, R15.2, U7.4, U17.10 (P6)
/P7: J5.8, R16.2, U8.4, U17.11 (P7)
/P10: J6.1, R25.2, U9.4, U17.13 (P10)
/P11: J6.2, R26.2, U10.4, U17.14 (P11)
/P12: J6.3, R27.2, U11.4, U17.15 (P12)
/P13: J6.4, R28.2, U12.4, U17.16 (P13)
/P14: J6.5, R29.2, U13.4, U17.17 (P14)
/P15: J6.6, R30.2, U14.4, U17.18 (P15)
/P16: J6.7, R31.2, U15.4, U17.19 (P16)
/P17: J6.8, R32.2, U16.4, U17.20 (P17)
/SCL: J2.1, J3.1, U17.22 (SCL)
/SDA: J2.4, J3.4, U17.23 (SDA)
GND: J2.3, J3.3, JP1.1 (A), JP2.1 (A), JP3.1 (A), U1.3, U2.3, U3.3, U4.3, U5.3, U6.3, U7.3, U8.3, U9.3, U10.3, U11.3, U12.3, U13.3, U14.3, U15.3, U16.3, U17.12 (GND)
unnamed: J1.1, R1.1
unnamed: J1.2, R2.1
unnamed: J1.3, R3.1
unnamed: J1.4, R4.1
unnamed: J1.5, R5.1
unnamed: J1.6, R6.1
unnamed: J1.7, R7.1
unnamed: J1.8, R8.1
unnamed: F1.2, J2.2, J3.2
unnamed: J4.1, R17.1
unnamed: J4.2, R18.1
unnamed: J4.3, R19.1
unnamed: J4.4, R20.1
unnamed: J4.5, R21.1
unnamed: J4.6, R22.1
unnamed: J4.7, R23.1
unnamed: J4.8, R24.1
unnamed: R1.2, U1.1
unnamed: R2.2, U2.1
unnamed: R3.2, U3.1
unnamed: R4.2, U4.1
unnamed: R5.2, U5.1
unnamed: R6.2, U6.1
unnamed: R7.2, U7.1
unnamed: R8.2, U8.1
unnamed: R17.2, U9.1
unnamed: R18.2, U10.1
unnamed: R19.2, U11.1
unnamed: R20.2, U12.1
unnamed: R21.2, U13.1
unnamed: R22.2, U14.1
unnamed: R23.2, U15.1
unnamed: R24.2, U16.1

Notes on the sheet:
Непонятно, на основании чего автор берет токоограничивающий резистор для оптопары номиналом 1Kom. Если сам же пишет, что напряжение питания 1,2 В, при токе 20 мА (0,02 А), осталось добавить U на выходе из МК. Если взять из расчета что МК работает от 3,3V, и на выходе у нас не больше этого значения 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
Задание адреса
Подключение шлейфа

Board: 2 copper layers, 60 parts (0 on the bottom side), 57 nets, no tracks yet.
