Konstantin-Dudersky/plc-modules/current/PM_DBG-FFC-v0.0.2/PM-Debug_v0.0.1.kicad_sch

## KiCad design current/PM_DBG-FFC-v0.0.2/PM-Debug_v0.0.1.kicad_sch (2025-02-23)

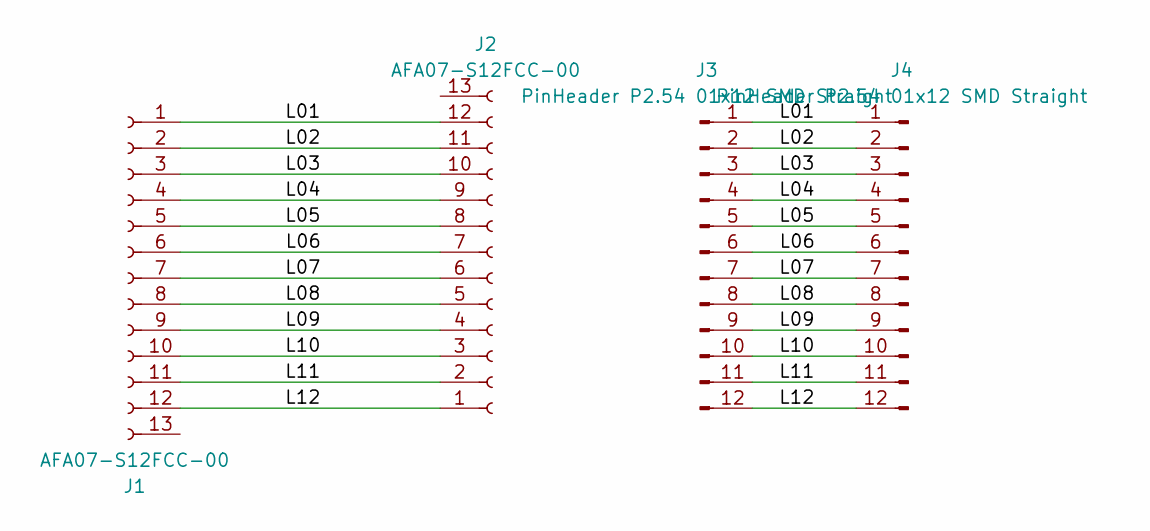
[picture p347: schematic PM-Debug_v0.0.1.kicad_sch]

Parts:
J1, J2: AFA07-S12FCC-00; CONN10_AFA07-S12_JUS; part_ipn AFA07-S12FCC-00
J3, J4: PinHeader P2.54 01x12 SMD Straight; PinHeader_1x12_P2.54mm_Vertical_SMD_Pin1Left; part_ipn PinHeader P2.54 01x12 SMD Straight

Connections:
L01: J1.1, J2.12 (Pin_11), J3.1, J4.1
L02: J1.2, J2.11, J3.2, J4.2
L03: J1.3, J2.10, J3.3, J4.3
L04: J1.4, J2.9, J3.4, J4.4
L05: J1.5, J2.8, J3.5, J4.5
L06: J1.6, J2.7, J3.6, J4.6
L07: J1.7, J2.6, J3.7, J4.7
L08: J1.8, J2.5, J3.8, J4.8
L09: J1.9, J2.4, J3.9, J4.9
L10: J1.10, J2.3, J3.10, J4.10
L11: J1.11, J2.2, J3.11, J4.11
L12: J1.12 (Pin_11), J2.1, J3.12, J4.12
