Konstantin-Dudersky/plc-modules/firmware/pm_cnv/src/PMCMV_INA226x4_v000001/mod.rs

mod buffer;
mod device;
mod output_data;
mod request_kind;

pub use {
    crate::chips::ina226::{AveragingMode, ConversionTime},
    buffer::Buffer,
    device::Device,
    output_data::OutputData,
};

const DEVICE_NAME: &str = "PMCMV_PWMx16";
