Konstantin-Dudersky/plc-modules/firmware/pm_mod_firmware/src/plc_modules/pm_mod__di16_sink__v0_0_4/message.rs

use rsiot::message::{Deserialize, MsgDataBound, MsgKey, Serialize};

#[derive(Clone, Copy, Debug, Deserialize, MsgKey, PartialEq, Serialize)]
pub enum Custom {
    AllInputs([bool; 16]),
}

impl MsgDataBound for Custom {}
