Konstantin-Dudersky/plc-modules/firmware/pm_mod_firmware/src/bin/PM_MOD__RQ8__v0_0_5/config_logger.rs

use rsiot::components::cmp_logger;

use super::message::Custom;

pub fn config() -> cmp_logger::Config<Custom> {
    cmp_logger::Config {
        level: cmp_logger::Level::INFO,
        fn_input: |msg| {
            let text = msg.data;
            let text = format!("Logger: {text:?}");
            Ok(Some(text))
        },
    }
}
