Konstantin-Dudersky/plc-modules/firmware/pm_mod_firmware/src/plc_modules/pm_rq8_v0_0_4/mod.rs

mod config_esp_spi_master;
mod config_esp_uart_slave;
mod config_logger;
mod main;
mod message;

pub use main::main;

use message::Custom;
use pm_firmware_uart_shared::pm_rq8_v0_0_4::{UartRequest, UartResponse};
