Konstantin-Dudersky/plc-modules/firmware/pm_mod_firmware/src/plc_modules/pm_di16_dc24sink_v0_0_2/config_esp_gpio.rs

use esp_idf_svc::hal::gpio::AnyIOPin;
use rsiot::{components::cmp_esp_gpio, message::Message};

use super::Custom;

pub fn config(pin_int_gpio_expander: AnyIOPin) -> cmp_esp_gpio::Config<Custom> {
    cmp_esp_gpio::Config {
        inputs: vec![cmp_esp_gpio::ConfigGpioInput {
            peripherals: pin_int_gpio_expander,
            fn_output: |value| {
                let msg = Message::new_custom(Custom::GpioExpanderInt(value));
                msg
            },
            pull: cmp_esp_gpio::Pull::Down,
        }],
        outputs: vec![],
    }
}
