Konstantin-Dudersky/plc-modules/firmware/pm_cnv/examples/PMCMV_INA226x4_v000001/main.rs

mod cfg_i2c_master;
// mod config_inject_periodic;
mod cfg_logger;
mod msg;

use std::time::Duration;

use rsiot::{
    executor::{ComponentExecutor, ComponentExecutorConfig},
    logging::{LogConfig, LogConfigFilter},
};

use crate::msg::Msg;

#[tokio::main]
async fn main() -> anyhow::Result<()> {
    LogConfig {
        // filter: LogConfigFilter::String("info,rsiot::components::cmp_linux_i2c_master=trace"),
        filter: LogConfigFilter::String("info"),
    }
    .run()?;

    let executor_config = ComponentExecutorConfig {
        buffer_size: 100,
        delay_publish: Duration::from_millis(100),
        fn_auth: |msg, _| Some(msg),
        fn_tokio_metrics: |_| None,
    };

    ComponentExecutor::<Msg>::new(executor_config)
        .add_cmp(cfg_i2c_master::cmp())
        // .add_cmp(config_inject_periodic::cmp())
        .add_cmp(cfg_logger::cmp())
        .wait_result()
        .await?;

    Err(anyhow::Error::msg("Execution end"))
}
