Konstantin-Dudersky/plc-modules/firmware/pm_cnv/examples/PMCMV_INA226x4_v000001/cfg_logger.rs

use rsiot::components::cmp_logger::*;

use crate::msg::*;

pub fn cmp() -> Cmp<Msg> {
    let config = Config {
        level: Level::INFO,
        fn_input: |msg| {
            let Some(msg) = msg.get_custom_data() else {
                return Ok(None);
            };

            let text = match msg {
                Msg::Ch0MeasuredValues(data) => {
                    format!("CH0 measured data: {}", data)
                }
                Msg::Ch1MeasuredValues(data) => {
                    format!("CH1 measured data: {}", data)
                }
                _ => return Ok(None),
            };

            Ok(Some(text))
        },
    };

    Cmp::new(config)
}
