Konstantin-Dudersky/plc-modules/firmware/pm_cnv/examples/PMCMV_INA226x4_v000001/cfg_inject_periodic.rs

use std::time::Duration;

use rsiot::{components::cmp_inject_periodic::*, executor::Component};

use super::messages::*;

pub fn cmp() -> Component<Config<Msg, impl FnMut() -> Vec<Msg>>, Msg> {
    let mut counter = 0.0;

    let config = Config {
        period: Duration::from_millis(100),
        fn_periodic: move || {
            let msgs = vec![Msg::Ch15(counter)];

            counter += 1.0;
            if counter >= 100.0 {
                counter = 0.0;
            }

            msgs
        },
    };

    Cmp::new(config)
}
