Konstantin-Dudersky/plc-modules/(commit log)

2024-04-23 breadboard for DI8
    [DI8.kicad_pcb, RQ8.kicad_pcb, RQ8.kicad_sch, Расчет.ods]
2024-04-23 power source
    [DI16.csv, DI16.kicad_pcb, DI16.kicad_sch, PS.kicad_pcb, PS.kicad_sch]
2024-05-17 change .gitignore
    [BOM.csv]
2024-05-30 v0.0.1 send to nextpcb
    [BOM.csv, PM-DI16-base.BOM.csv, PM-DI16-base.kicad_pcb, PM-DI16-base.kicad_sch, PM-DI16-front-DC24.kicad_pcb, PM-DI16-front-DC24.kicad_sch, PM-RQ8-base.BOM.csv, PM-RQ8-base.kicad_pcb]
2024-06-11 update step files
    [PM-RQ8-front.step]
2024-06-24 fix PC817 footprint
    [PM-DI16-base.kicad_pcb, PM-DI16-base.kicad_sch]
2024-06-24 work on v0.0.2
    [PM-RQ8-base.kicad_pcb, PM-RQ8-base.kicad_sch, PM-RQ8-front.kicad_pcb, PM-RQ8-front.kicad_sch]
2024-06-26 send to nextpcb
    [PM-CPU-RP.kicad_pcb, PM-CPU-RP.kicad_sch, PM-DI16-base.kicad_pcb, PM-DI16-base.kicad_sch, PM-DI16-front-DC24.kicad_pcb, PM-RQ8-base.kicad_pcb, PM-RQ8-base.kicad_sch]
2024-07-11 add docs
    [PM-RQ8-base.kicad_pcb]
2024-07-12 docs updated
    [PM-DI16-base.kicad_sch, PM-RQ8-base.kicad_sch, PM-RQ8-front.kicad_pcb, external_connection.kicad_sch]
2024-07-15 PM-RQ-front - InvenTree
    [BOM.csv, PM-RQ8-front.kicad_pcb, PM-RQ8-front.kicad_sch]
2024-07-15 Start PM-AI-IU4
    [PM-ADC4.kicad_pcb, PM-ADC4.kicad_sch, PM-AI-IU4.kicad_pcb, PM-AI-IU4.kicad_sch, PM-Base-AI4.kicad_pcb, PM-Base-AI4.kicad_sch, PM-DI16.kicad_pcb, PM-DI16.kicad_sch]
2024-07-17 Work on PM-AI8-IU
    [PM-AI8-IU.kicad_pcb, PM-AI8-IU.kicad_sch, PM-CPU-ESP.kicad_pcb]
2024-07-22 PM-AI-xxx docs
    [PM-AI8-IU-front-10V.kicad_pcb, PM-AI8-IU-front-20mA.kicad_pcb, PM-AI8-IU-front-20mA.kicad_sch, PM-AI8-IU-front-5V.kicad_pcb, PM-AI8-IU-front-5V.kicad_sch, PM-AI8-IU.kicad_pcb, PM-AI8-IU.kicad_sch, PM-Bus.kicad_pcb]
2024-07-24 PM-AI8-I start
    [PM-AI8-I.kicad_pcb, PM-AI8-I.kicad_sch]
2024-08-12 add version numbers
    [BOM.csv, ESP32.kicad_sch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]
2024-08-29 update ESPC3
    [BOM.csv, PM-ESPC3.kicad_pcb, PM-ESPC3.kicad_sch]
2024-09-09 create firmware project
    [BOM.csv, PM-PS.kicad_pcb, PM-PS.kicad_sch]
2024-09-11 fix errors
    [BOM.csv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]
2024-09-16 update to rsiot
    [PM-DI16-DC24sink-front.kicad_sch]
2024-09-23 new PM-RQ8
    [BOM.csv, ESP32.kicad_sch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]
2024-09-24 add i2c delay
2024-10-25 update new size
    [PM-DI16-DC24sink.kicad_pcb, PM-ESPC3.kicad_pcb, PM-ESPC3.kicad_sch, PM-LED16.kicad_pcb, PM-LED8.kicad_pcb, PM-RQ8.kicad_pcb, front.kicad_pcb, front.kicad_sch]
2024-11-23 update PM-RP
    [BOM.csv, PM-CPU-RP.kicad_pcb, PM-CPU-RP.kicad_sch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]
2024-12-15 new version
    [BOM.csv, ESP32.kicad_sch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]
2025-01-15 zip old plates
    [BOM.csv, ESP32.kicad_sch, EVAL-AD7190EBZ-BOM-RevC1.xls, EVAL-AD7190EBZ-PADS-RevC1.pcb, EVAL-AD7190EBZ-SCH-RevC1.sch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]
2025-02-22 before v9
    [BOM.csv, EVAL-AD7190EBZ-BOM-RevC1.xls, EVAL-AD7190EBZ-PADS-RevC1.pcb, EVAL-AD7190EBZ-SCH-RevC1.sch, PM-AI1-W.step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]
2025-03-05 nextpcb order
    [3D PM_HMI-Touch-v0.0.1.step, BOM PM_CNV-AI4_W-v0.0.2.csv, BOM PM_CNV-DQ16_src-v0.0.2.csv, BOM PM_HMI-Touch-v0.0.1.csv, BOM.csv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]
2025-03-05 deelte embuild
    [pyvenv.cfg]
2025-03-08 update docs
    [BOM PM_CNV-AI4_W-v0.0.2.csv, BOM.csv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]
2025-03-09 setup new files
    [BOM.csv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]
2025-03-12 remove pagebreak level 2
    [BOM.csv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]
2025-06-14 add i2c
    [BOM.csv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]
2025-07-10 order nextpcb
    [BOM.csv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]
2026-05-13 INA226 firmware
    [BOM.csv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]
2026-05-19 new order
    [BOM.csv, PMCNV-DIx32.BOM.csv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]
2026-06-10 new structure
    [BOM.csv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]
